opendap-project/t1/product/README.md

# T1

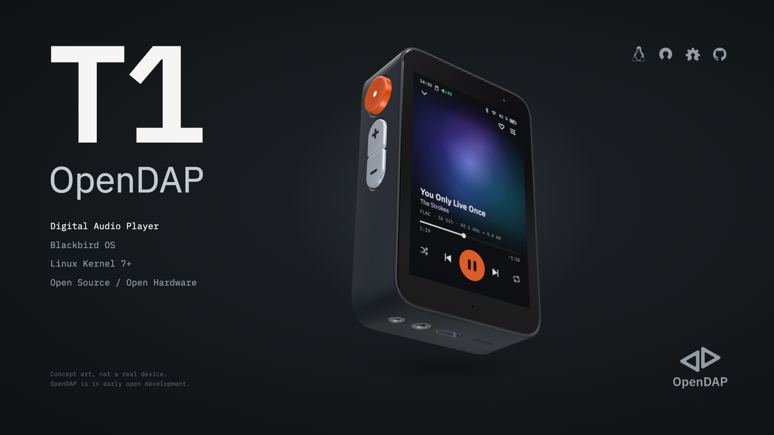
[picture p1: product/docs/concept-art/concept.png]
OpenDAP T1 concept art: the T1 in graphite with its orange Action button and silver keys, playing "You Only Live Once" by The Strokes on Blackbird OS. Concept art, not a real device.


Product integration of the OpenDAP T1: product requirements, the complete assembly and system simulations, built from the exports of every component.

## Layout

- `components.yaml` — the component versions that make up a T1 configuration
- `assembly/`
- `renders/`
- `sim/`
- `docs/`

## License

This repository follows the [REUSE](https://reuse.software) layout: license texts live in `LICENSES/` and `REUSE.toml` maps each path to its license.

- Default (docs, renders): **Creative Commons Attribution-ShareAlike 4.0** (`CC-BY-SA-4.0`)
- `assembly/`, `components.yaml`: **CERN Open Hardware Licence v2 – Strongly Reciprocal** (`CERN-OHL-S-2.0`)
- `sim/`: **GNU GPL v3.0 or later** (`GPL-3.0-or-later`)

Copyright © 2026 The OpenDAP Project.
