opendap-project/t1/faceplates/touch/README.md

# Faceplate Touch

Touch faceplate, the default faceplate: touch display, status LED, microphone.

## Layout

- `hardware/`
- `firmware/`
- `sim/`
- `case/` — this faceplate's mechanics
- `export/`
- `renders/`
- `docs/`

## License

This repository follows the [REUSE](https://reuse.software) layout: license texts live in `LICENSES/` and `REUSE.toml` maps each path to its license.

- Default: **Creative Commons Attribution-ShareAlike 4.0** (`CC-BY-SA-4.0`)
- `hardware/`: **CERN Open Hardware Licence v2 – Strongly Reciprocal** (`CERN-OHL-S-2.0`)
- `case/`: **CERN Open Hardware Licence v2 – Strongly Reciprocal** (`CERN-OHL-S-2.0`)
- `firmware/`: **MIT** (`MIT`)
- `sim/`: **GNU GPL v3.0 or later** (`GPL-3.0-or-later`)
- `export/`: **CERN Open Hardware Licence v2 – Weakly Reciprocal** (`CERN-OHL-W-2.0`)
- `renders/`: **Creative Commons Attribution-ShareAlike 4.0** (`CC-BY-SA-4.0`)
- `docs/`: **Creative Commons Attribution-ShareAlike 4.0** (`CC-BY-SA-4.0`)

Copyright © 2026 The OpenDAP Project.
