opendap-project/t1/board/docs/README.md

# Documentation

| Folder | Contents |
|---|---|
| [`requirements/`](requirements/) | What this project must achieve. Each requirement has an ID, a priority (**must** / **should**) and a status. |
| [`adr/`](adr/) | Architecture Decision Records: decisions already taken, with their context. A decision can be superseded by a later ADR. |
| [`specs/`](specs/) | Specifications, such as the [BOM](specs/bom-v1.md) the [power tree](specs/power-tree-v0.md) and the [PCB design constraints](specs/pcb-design-constraints.md). |

Only information confirmed by the maintainers is recorded here. Earlier experiments are not a source.

**Requirement status:** *Confirmed* (agreed, build on it) · *Draft* (agreed intent, wording or detail still open).
**ADR status:** *Accepted* · *Proposed* (direction agreed, not final) · *Superseded*.
