opendap-project/t1/case/docs/concept-art/README.md

# Concept art

These images are screenshots of interactive 3D concept models from earlier experiments (artifacts dated 2026-10-22). They are kept here as visual inspiration only.

**They are not designs, specifications or decisions.** The captures give the general visual idea, but their parts and exploded views often have glitches and bad design decisions, because they were not based on real data or simulations. Dimensions, part choices, component placement and layouts shown in them may be wrong and must not be taken from them. This also applies to any text visible in the captures (title panels, labels, numbers): it comes from the old experiment and is not confirmed information.

The real design is built in this repository, with simulation and real structure.

## Images

- `case-three-quarter.png`: Three-quarter front view of the assembled enclosure with a screen mock-up, rounded dark body and ribbed side key.
- `case-exploded.png`: Exploded view of the enclosure: front screen part, side key strip with a flexible cable, hollow body frame with internal walls and the back cover.
