opendap-project/t1/product/docs/concept-art/README.md

# Concept art

## Current concept

- `concept.png`: the 1920 × 1080 cover used in the READMEs, captured from [`renders/web/concept.html`](../../renders/web/concept.html).
- `renders/web/concept.html`: the interactive source of the cover. It is a visual reference built by eye from the requirements and the design system, not a mechanical design: dimensions, radii and port positions are not set yet. It loads three.js from a CDN; the marks at top right come from Simple Icons (CC0) and remain their owners' trademarks.

## Earlier experiments

These images are screenshots of interactive 3D concept models from earlier experiments (artifacts dated 2026-10-22). They are kept here as visual inspiration only.

**They are not designs, specifications or decisions.** The captures give the general visual idea, but their parts and exploded views often have glitches and bad design decisions, because they were not based on real data or simulations. Dimensions, part choices, component placement and layouts shown in them may be wrong and must not be taken from them. This also applies to any text visible in the captures (title panels, labels, numbers): it comes from the old experiment and is not confirmed information.

The real design is built in this repository, with simulation and real structure.

### Images

- `t1-three-quarter.png`: Three-quarter front view of the assembled handheld: dark graphite rounded body, large screen showing a music player mock-up, ribbed side key.
- `t1-back.png`: Straight-on back view: plain dark back cover with an embossed logo; the orange key seen on the right of the image is on the device's left edge (the view is from the back), as in T1-059.
- `t1-exploded.png`: Exploded view: screen front, circuit board, body frame, a pale battery-like block and back cover separated along the depth axis.
