opendap-project/t1/faceplates/touch/docs/concept-art/README.md

# Concept art

These images are screenshots of interactive 3D concept models from earlier experiments (artifacts dated 2026-10-22). They are kept here as visual inspiration only.

**They are not designs, specifications or decisions.** The captures give the general visual idea, but their parts and exploded views often have glitches and bad design decisions, because they were not based on real data or simulations. Dimensions, part choices, component placement and layouts shown in them may be wrong and must not be taken from them. This also applies to any text visible in the captures (title panels, labels, numbers): it comes from the old experiment and is not confirmed information.

The real design is built in this repository, with simulation and real structure.

## Images

- `touch-faceplate-three-quarter.png`: Three-quarter view of a thin front panel with a black border, a screen showing a music player mock-up and a small dot near the top.
- `touch-faceplate-exploded.png`: Exploded view of the panel layers: black front frame, translucent sheets, the screen, a white backing sheet, a grey plate and an outline frame, with orange flexible strips.
