opendap-project/t1/board/docs/specs/placement-v1.md

# Placement v1 of the T1 main board

- **Status:** Draft v1.11 (2026-10-29: libs v0.3.6's courtyards cover each part's pin-1 mark, which takes the side that grows the courtyard least, and a part with one land (the battery spring contacts, the pogo pins) carries none; the placement search runs again on the grown courtyards; the 5.1 V converter U4401 is fixed at its v1.10 position, where its input capacitor C4402 stays within its 3 mm bound (the search had turned it and left C4402 at 5.0 mm); 996 parts, 722 front, 274 back; board need 102.0 %, factor 1.61). Was Draft v1.10 (2026-10-29: the SoC crystal Y1301 on libs v0.3.5's NDK NX3225GA land, with silk outline and pin-1 mark, in place of KiCad's stock 3225 land; every fabrication reference centred in its part's courtyard and sized to fit it (`pcb/fabref.py`), so none overlaps another, and the build stops if one does; the two-terminal RTC crystal Y1101 carries a CRAFT-13 exemption (`plan.CRAFT_EXEMPT`); 996 parts, 718 front, 278 back; board need 100.2 %, factor 1.64). Was Draft v1.9 (2026-10-28: every part with a body carries a 3D model (libs v0.3.3 envelopes for the project lands and for the KiCad stock lands without a KiCad 10 model, by MPN on the XxL4020 land; `pcb/plan.py` `model_for`), so the STEP export misses none; the pre-PCB items of [BOM v1.22](bom-v1.md#changes-in-v122): the Vishay WSL lands on the 18 metal-strip shunts and links, the XFL3012 land for L5401 (no placeholder left), the Action button on the PTS815 land with the left-edge buttons 0.1 mm down; 996 parts, 720 front, 276 back; board need 100.2 %, factor 1.64). Was Draft v1.8 (2026-10-28: test pads on either side, decision 9 revised for flying-probe test, [ADR 0027](../adr/0027-flying-probe-test-for-prototypes-and-first-runs.md); the faceplate DSI ESD and the single FP_GPIO1 TPD1E10B06 of [BOM v1.21](bom-v1.md#changes-in-v121) placed in the faceplate area; 996 parts, 725 front, 271 back; board need 99.2 %, factor 1.66). Was Draft v1.7 (2026-10-28: the audio shield-can frame dropped for board area, decision 16, [BOM v1.20](bom-v1.md#changes-in-v120); board need 99.7 % to 98.9 %, factor 1.64 to 1.66; references unchanged; v1.6 the same day: the three shield-can frames of [BOM v1.19](bom-v1.md#changes-in-v119) on the back, decision 15; the frames' sheet takes page 59, so the references of the sheets after it carry the next page, for example the microSD socket J6101 is now J6201 and the side buttons SW6801–SW6804 are SW6901–SW6904; v1.5 the same day: vdd_cpu on the TPS62870Z4 of [ADR 0026](../adr/0026-vdd-cpu-buck-ti-tps62870z4.md), BOM v1.18 item 8: two input capacitors and three compensation parts more, one output capacitor moved to the SoC; v1.4 the same day: the NFC reader withdrawn from the board in every model, maintainer decision 2026-10-27 for board area ([feature blocks](feature-blocks.md) #42, BOM v1.18 item 7), the reserve of §6 item 1 applied; the sheets after it moved up one page, so their references carry the page before, for example the microSD socket J6201 is now J6101; v1.3 2026-10-27: every converter's and IC's capacitors within a bound of the pins they serve, checked by the tool, §4 decision 14, with the capacitor changes of [BOM v1.18](bom-v1.md#changes-in-v118); v1.2 the same day: the swaps of [BOM v1.17](bom-v1.md#changes-in-v117) whose gates closed without hardware; v1.1 the same day: the 62.5 × 95.0 mm body of [ADR 0025](../adr/0025-height-zones-in-the-wider-body.md), §4 decision 13; compaction of §4 decision 12 applied the same day). The board setup and the placement stage of the T1 main board: every part of the schematic placed, nothing routed. It applies [floorplan v1](floorplan-v1.md) with the changes of §4, each recorded as a decision.
- **Board:** [`hardware/t1-main-board/t1-main-board.kicad_pcb`](../../hardware/t1-main-board/t1-main-board.kicad_pcb), written by the placement tool [`hardware/t1-main-board/pcb/`](../../hardware/t1-main-board/pcb/) (`build.py`) from the schematic; the tool's report is [`pcb/placement-result.json`](../../hardware/t1-main-board/pcb/placement-result.json). The same inputs give a byte-identical board.
- **Inputs:** the schematic (hardware/t1-main-board, 996 parts, 1,055 nets), `hardware/t1-main-board/shields.toml`, [floorplan v1](floorplan-v1.md), [stackup v3](stackup-v3.md) and `hardware/stackup/stackup-v3.toml`, the [PCB design constraints](pcb-design-constraints.md) v0.20, [ADR 0025](../adr/0025-height-zones-in-the-wider-body.md), [ADR 0018](../adr/0018-antennas-and-certification-route.md), [ADR 0020](../adr/0020-battery-connected-through-contacts.md), the composed design rules (`t1-main-board.kicad_dru`), the [BGA escape study](../../hardware/studies/bga-escape/README.md). Footprints: libs `kicad/` as pinned in `hardware/lib/opendap` and KiCad 10.0.7's stock libraries.

## 1. Board setup

| Item | Value | Source |
|---|---|---|
| Outline | 59.1 × 91.6 mm, square corners, origin at the board centre (KiCad (100, 100) mm); `pcb/geometry.py` derives it from the body (62.5 × 95.0 mm), the walls (1.2 mm) and the clearance (0.5 mm per side) | PCB-M-01, M-02 (clearance **UNVERIFIED**), PCB-M-04, ADR 0025; corner radii wait for the case (CRAFT-35) |
| Mounting holes | H1–H4, 2.2 mm non-plated at (±26.05, 42.3) and (±26.8, −27.0) mm, the same distance from the edges as in the 55.3 × 90.1 mm outline | PCB-M-08, floorplan v1 §1 (positions **UNVERIFIED** until the case) |
| Stackup | Six layers, 1.046 mm: mask 20 µm / L1 35 µm / 2116 120 µm / L2 25 µm / 3313 90 µm / L3 18 µm / core 430 µm / L4 18 µm / 3313 90 µm / L5 25 µm / 2116 120 µm / L6 35 µm / mask 20 µm, ENIG; Dk as the TOML | stackup v3, `stackup-v3.toml` |
| Net classes | The project's classes and patterns, generated from `hardware/rules/netclasses.toml` | netclasses.toml |
| Design rules | `t1-main-board.kicad_dru`, the composition of the PCBWay HDI, OpenDAP craft and T1 product rules | `t1-main-board.dru.toml` |
| Rule areas | `ZONE_CORE`, `ZONE_AUDIO`, `ZONE_POWER`, `ZONE_IO`, `ZONE_RADIO`, `ZONE_FACEPLATE` per copper layer, five `ZONE_CORRIDOR`, `BATTERY_POCKET`, `BATTERY_CONNECTOR`, `BATTERY_CONTACT_EMPTY`, `BATTERY_ESD`, `AUDIO_ANALOG`, `BGA_ESCAPE` | floorplan v1 §2, §4; PCB-L-01, L-02, L-04, L-08; PCB-A-07; hardware/rules/README.md |
| Height areas | Drawn on User.1 (front: display footprint, faceplate connection area) and User.2 (back: pocket, bands, speaker shelf) | PCB-Z-01 to Z-04, Z-09, ADR 0025 |
| Fiducials | FID1–FID3 front, FID4–FID6 back (global, not symmetric), FID7–FID8 back at the RK3566 (local); 1 mm dot, 2 mm mask, 3.2 mm kept free | PCB-M-09, PCB-D-02, D-03 |
| Identity | `${TITLE}` and revision with the issue date on the back silk, in an area kept free of parts | CRAFT-20 |

## 2. What is placed

All 996 parts: 725 on the front, 271 on the back (the two shield frames among them; v1.8), plus the eight fiducials and four holes. The schematic parity check finds no difference. Every part stands on a drawn land (v1.9: L5401 is the Coilcraft XFL3012 of BOM v1.22, its land from Document 747-1). The C&K PTS815 land of SW6901–SW6904 is drawn from its data sheet (v1.6; the Action button SW6904 on it from v1.9).

| Part | Where (device frame, mm) | Side | Basis |
|---|---|---|---|
| RK3566 U1301 | (0, 10) | back | floorplan v1, BGA escape study, ADR 0016 item 3 |
| LPDDR4X U2101 | (16.9, 11) | back | floorplan v1 (16.75); 2.05 mm courtyard gap to the SoC (PCB-D-01) |
| eMMC U3801 | (−17.75, 12) | back | floorplan v1 |
| SoC, LPDDR4X and eMMC decoupling | front, each capacitor at a ball of its rail under the package | front | ADR 0016 item 3, PCB-P-10; the escape study's one ground stack per capacitor next to a rail via |
| RK809-5 U1101 | (−4.8, 25.0), its five inductors around it | back | §4 decisions 5, 15 |
| vdd_cpu buck U1201, inductor L1201 | inductor (11.95, 23.9) under the pocket, above the LPDDR4X and 4 mm right of the SoC's courtyard; converter beside it at (16.15, 23.9): the TPS62870Z4 is 1.05 mm, over the front's 1.0 mm (PCB-Z-03), so it stands on the back over the pocket like the SoC and the PMIC (a PCB-L-01 warning, ADR 0026) | back / back | §4 decision 12 (was the top band, decision 3); ADR 0026 |
| RP2354A U3501 | (−16.0, 24.5) | front | §4 decision 6 |
| CS43198 U2501, U2601 | (−20, −18), (−11.5, −18), mirrored about x = −15.75 | back | floorplan v1 |
| NZ2520 oscillators Y2401, Y2402 | (−17.3, −11), (−14.2, −11), mirrored about x = −15.75 | back | floorplan v1 (moved to clear each other) |
| 3.5 mm jack J3401, 4.4 mm jack J4001, USB-C J4601 | bottom edge at x −22.3, −11.55, 0 | back | PCB-M-05, floorplan v1 |
| microSD J6201 | top edge, x 13.5 | back | floorplan v1 (13.0); §4 decision 3 |
| U.FL J5201 (ANT0), J5202 (ANT1) | (−14.0, 41.5), (−8.3, 41.5), top band | back | ADR 0018 item 4, PCB-R-02 |
| Type 2EL U5001 | (−17, 32.5) | back | floorplan v1 |
| FH35C J5301 | (2.5, −32.9), faceplate connection area | front | floorplan v1 §5 |
| DF40C-50DS J4701 | (13.1, −31.0), bottom band | back | floorplan v1 §5 |
| Battery contacts J701–J706 | row at y −23.5, x −2.0 to 19.0, 3.5 mm pitch, third position empty | back | ADR 0020 item 2, PCB-L-04 |
| Battery-contact ESD D702, D703 | at the mid-cell and NTC contacts, inside `BATTERY_ESD` | back | PCB-L-08 |
| Side buttons | Action SW6904, Vol+ SW6902, Vol− SW6903 on the left edge at y 36.72, 30.6 and 24.5 (v1.9: all on the 6.0 mm PTS815 land, courtyards end to end, Action 1.43 mm from the top-left hole edge, PCB-H-01; Vol− 0.1 mm down from v1.6 with no PCB-D-01 change); Main SW6901 on the right edge at y 29.5; 1.9 mm from the edge, courtyards 0.15 mm outside the pocket footprint | back | controls spec §1.4 (positions **UNVERIFIED**), PCB-Z-08 |
| Speaker pads TP5503, TP5504 | under the speaker shelf, (10.5, −39.5) and (16.5, −39.5) | back | BOM v1 line 33 (pad spacing **UNVERIFIED**), PCB-Z-09 |
| Cover-detect pads TP5801, TP5802 | 1.25 mm from the right edge, y −14.0 and −17.5 | back | ADR 0020 item 7, PCB-L-10 |
| Shield frames A5901 (SoC and LPDDR4X), A5902 (radio module) | lands outside x −10.0 to 24.15, y 0.55 to 20.3; x −23.6 to −10.3, y 27.2 to 38.3 | back | §4 decisions 15, 16, `shields.toml` |

Every other part is placed by the tool: tall parts in the bands, then parts with through holes (their thermal vias need the other side free), then the converters' inductors, then the parts over 1.0 mm (back only), then the rest, each at the nearest free spot to the pads it connects to (pads of its own block first; a converter next to its inductor's switch-node pad), and test pads on the front.

## 3. Area budget and occupancy

### 3.1 The floorplan's method with the real footprints

Floorplan v1 §2.1 estimated the over-budget bands with a placement and routing factor of 1.7 (1.2 for edge parts) on courtyard estimates. The same method on the real courtyards of the schematic's parts, on the floorplan's zones (drawn from the 59.1 × 91.6 mm outline) and block assignment; the speaker stands on its case shelf (PCB-Z-09), so it takes no area and its shelf footprint counts as low back area, not band:

| Zone | Courtyard (mm²) | Need ×1.7 (mm²) | Band use | Back use | Front use | 55.3 × 90.1 mm outline (band / back / front) |
|---|---|---|---|---|---|---|
| CORE | 2,690 | 4,572 | **129 %** of 497 mm² | 100 % | 73 % | 203 % / 100 % / 94 % |
| AUDIO | 1,735 | 2,760 | 99 % of 458 mm² | 100 % | **231 %** | 123 % / 100 % / 254 % |
| POWER | 1,256 | 2,136 | **211 %** of 220 mm² | **116 %** | **149 %** | 233 % / 165 % / 164 % |
| IO | 365 | 571 | 80 % | 100 % | 23 % | 82 % / 100 % / 29 % |
| RADIO | 275 | 467 | 0 % | 96 % | 0 % | 0 % / 100 % / 11 % |
| FACEPLATE | 135 | 229 | — | — | **121 %** of 190 mm² (v1.8: the DSI ESD; placed courtyard 58 %) | — / — / 121 % |
| **Board** | **6,639** | **11,047** | | | **102.0 % of 10,827 mm²** (v1.11: courtyards that cover the pin-1 marks, libs v0.3.6, +2 %; 100.2 % at v1.10; v1.9: the WSL and XFL3012 lands and the Action PTS815, +114 mm² of need; 99.2 % at v1.8, 98.9 % at v1.7) | 111 % of 9,965 mm² |

The wider body (ADR 0025) and the 0201 swaps of [BOM v1.16](bom-v1.md#changes-in-v116) take the board from 111 % to 98.8 % of both sides; the swaps of [BOM v1.17](bom-v1.md#changes-in-v117) (seven 10 µF in 0603, two 1 µF in 0201, six load switches in WCSP) to 97.8 %; the capacitors [BOM v1.18](bom-v1.md#changes-in-v118) adds so that every position meets its data sheet (the amplifier-rail LDOs take 18 capacitors of 22 µF where 6 of 10 µF missed their minimum) to 99.1 %; withdrawing the NFC reader (§6 item 1, 35 parts) to 96.9 %; the TPS62870Z4 of ADR 0026 to 97.0 %; the three shield frames (decision 15; their land and keep-out rings once, without the factor, counted in the core as the method has no zone for them) to 99.5 %; the drawn PTS815 land (6.0 × 3.7 mm against the 4.8 × 3.8 mm placeholder) to 99.7 %; dropping the audio frame (decision 16) to **98.9 %**; the courtyards alone cover 60.2 % (61.0 % at v1.6, 58.4 % at v1.5, 58.3 % at v1.4, 59.6 % at v1.3, 58.8 % at v1.2, 59.4 % at v1.1, 67.3 % before ADR 0025). The study's target of 95 % with routing room is not reached (3.9 points short; 2.0 before the frames): the X2SON LDOs and most of the 1 µF and 10 µF positions failed their gates (BOM v1.17), and what remains gated needs hardware (the audio output stage in 0402 after V2-A08, 0.8 mm power test pads after a probe check), or the reserve of §6 item 1.

### 3.2 The placed board

Courtyard area over zone area, per side, without a factor (zones with the changes of §4; the back's band is the back outside the pocket and the speaker shelf; a shield frame counts its land and keep-out ring, which the core and radio rows carry):

| Zone | Front | Back | Band (back) |
|---|---|---|---|
| CORE | 1,050 of 2,009 mm² (52 %) | 1,591 of 2,280 mm² (70 %) | 237 of 512 mm² (46 %) |
| AUDIO | 811 of 1,363 mm² (59 %) | 880 of 1,126 mm² (78 %) | 411 of 524 mm² (78 %) |
| POWER | 539 of 1,087 mm² (50 %) | 786 of 1,311 mm² (60 %) | 169 of 368 mm² (46 %) |
| IO | 173 of 312 mm² (55 %) | 206 of 265 mm² (78 %) | 167 of 195 mm² (86 %) |
| RADIO | 117 of 453 mm² (26 %) | 146 of 453 mm² (32 %) | 105 of 208 mm² (51 %) |
| FACEPLATE | 97 of 190 mm² (51 %) | — | — |

Every part found a place with its courtyard inside its zone, its height inside its height area (the two pocket reliefs of §5 aside) and no courtyard overlap. The placement and routing factor left is **1.66** over the board (10,827 / 6,518 mm² of placed courtyard, the frames' rings included; 1.64 at v1.6, 1.71 at v1.5, 1.72 at v1.4, 1.68 at v1.3, 1.70 at v1.2, 1.68 at v1.1, 1.49 before ADR 0025), about 1.5–1.6 in the core's and the audio zone's front; the floorplan assumed 1.7 (1.5–1.9). The tool reports these figures in `placement-result.json` (`routing_room`). Whether the board routes at this density is the next stage's question; a shortfall goes back to the maintainers as a stackup question (PCB-S-22) or as the reserve of §6 item 1.

## 4. Decisions

Each changes floorplan v1 where the real footprints did not fit it; the tool's `plan.py` carries the same rows.

1. **Accepted (2026-10-27): the audio zone grows to y 2.4 on every layer and to y 14 on the front (x < −6.2).** Basis: its parts need 1,665 mm² of courtyard against 1,557 mm² of floorplan zone on both sides (§3.1); the core zone has room (§3.2); above y 2.4 the eMMC and its rework clearance (PCB-D-01) keep the back and inner layers; a zone may cover only some layers where two zones share a spot (floorplan v1 §2). The core–audio corridor moves to x −11 to −5, y −1 to 5, across the new boundary.
2. **Accepted (2026-10-27): the power zone grows to y 0 (x > 6.2), its left edge moves to x 4.0 between the battery-contact window and y 0, it takes the front of the HAT strip right of the faceplate area, and the back of x −2 to 4, y −18.8 to −8.** Basis: the power zone's parts over 1.0 mm stand on the back only (twelve 0805 capacitors of the charger, five INA236, the ship FET, diodes), and its back outside the contact window is full of them; the I/O zone uses 30 % of its front (§3.1); the I/O pairs pass the moved back area on L4 and L1. The core–power corridor moves to x 8 to 14, y −3 to 3.
3. **Accepted (2026-10-27): parts over 1.5 mm stand in the bands at fixed places.** The power band above the USB-C (taken from the I/O zone's back) holds the battery fuse under the P+ contacts; the right band the VSYS_LV and pre-rail inductors (XGL4020, 2.1 mm) and, since v1.3, the pre-rail's three 1206 output capacitors around its inductor's output pad (decision 14). Until v1.2 the band above the USB-C also held the 5.1 V output 1210 (two 0805 since BOM v1.18 item 5, placed with their converter) and one pre-rail 1206. Decision 12 took the vdd_cpu, vcc3v3_sys, radio AVDD18, charger and 5.1 V inductors out of the bands; the core top band (x −5.5 to 5.6, taken from the radio zone left of the microSD) stays with the core. Basis: PCB-Z-01, Z-02; the converters stand opposite their inductors on the front. Cost (until decision 12): the vdd_cpu converter sat about 24 mm from the SoC's package edge.
4. **Withdrawn (2026-10-27, decision 13): no part over 1.0 mm stands on the front's bottom strip.** In the 55.3 × 90.1 mm outline the VSYS_LV converter's 22 µF 0805 C904 (1.25 mm) found no back room and stood there on PCB-Z-04's 6.8 mm (**UNVERIFIED**); in the wider power zone the tool places it on the back next to C903, 3.6 mm from its converter.
5. **Accepted (2026-10-27): the RK809-5 stands above the SoC, at (−4.8, 24.6) on the back** (v1.3; was (−6.0, 25.7), where its top row of pins stood 0.2 mm from the radio zone and the last of its 27 capacitors found no room within its bound, decision 14). Basis: below the SoC the grown audio and power zones leave about 10 × 8 mm, and the PMIC with its five 1.2 mm inductors (back only) needs about 150 mm²; above, it sits next to the vdd_cpu buck, 2 mm from the SoC's and the eMMC's courtyards (PCB-D-01). Floorplan v1 had it below the SoC.
6. **Accepted (2026-10-27): the RP2354A stands at (−16.0, 24.5) on the front**, clear of the eMMC. Basis: its exposed pad's thermal vias go through the board, so the other side under them must be free of pads (PCB-V-01, shorts); the audio zone took its floorplan place.
7. **Accepted (2026-10-27): `blk.audio-supply` (TPS62840 buck, its inductor and switches) belongs to the power zone.** Basis: switch nodes stay in the power zone except the PMIC's and the vdd_cpu buck's (floorplan v1 §4 item 6, PCB-A-06); floorplan v1 §2 listed the block under `blk.audio`.
8. **Accepted (2026-10-27): heat sources other than the SoC and the PMIC stand on the front** where their height allows it. Basis: PCB-L-01 (no heat source on the back over the pocket); the SoC and the PMIC are there by ADR 0016 (floorplan v1 §6 item 3).
9. **Accepted (2026-10-27; revised 2026-10-28): flat test pads stand in the zones of their nets, on either side.** Basis: [ADR 0027](../adr/0027-flying-probe-test-for-prototypes-and-first-runs.md) (flying probe for prototypes and first runs, reaching both sides; until 2026-10-28 the front only, for ADR 0016's single-sided fixture); PCB-S-17 (a test pad's track stays in its net's zone). The nearest free spot wins, the front on a tie (`plan.TEST_PAD_SIDES`): 18 of 156 pads take the back, and the front cells they leave go to passives, so the front courtyard (≈ 2,800 mm²) and the board need (99.2 %) do not change. Contact pads of parts mounted in the case (speaker, LRA, NFC antennas, cover detect) stand on the back.
10. **Accepted (2026-10-27): the faceplate connection area's front belongs to the faceplate zone alone.** Basis: ADR 0016 item 1 (FH35C and its ESD only); floorplan v1's I/O rectangle overlapped it.
11. **Accepted (2026-10-27): DRC reports unconnected items as warnings at this stage** (project setting, generated). Basis: nothing is routed; the routing stage sets them back to errors, so the stage's own DRC errors stay visible.
12. **Accepted (2026-10-27): lower and smaller parts where the design's stresses allow them** ([compaction study](../../hardware/studies/compaction/README.md), [BOM v1.15](bom-v1.md#changes-in-v115)). Basis: the study's matrices: same inductance, design peak ≤ 70 % and maximum current limit ≤ 100 % of Isat at 30 % drop (BRD-049 as power tree v0 §4.10 applies it), heights PCB-Z-01 and Z-03, ratings at least twice the rail, PCB-D-06; sourcing check (T1-029), 2026-10-27: open for XGL4015-102MEC and conditional for XGL4015-471MEC (BOM v1.15), with the 2.1 mm parts on the same land as the fallback. The charger and 5.1 V inductors (XGL4015-102MEC) and the vcc3v3_sys and radio AVDD18 inductors (XGL4015-471MEC) are 1.5 mm and stand under the pocket; the vdd_cpu inductor is 1.2 mm (XGL4012-221MEC, Document 1718), so it moves next to the SoC (block target (6.0, 22.5); it lands 2.4 mm from its converter, as before) with its converter on the front opposite, as every other converter of this placement (decision 3; PCB-P-07 asks for one side, a review item); 58 decoupling capacitors of 100 nF on rails of 3.3 V or less in the core, I/O and radio zones are 0201; the 51 test pads on signal nets are 0.8 mm. The TPS62136 and LMR33630C inductors stay 2.1 mm in the band (their XGL4015 is at 103 % at the converter's limit), and no thinner 0805 or 1206 capacitor passes (obsolete, not for new designs or not listed).

13. **Accepted (2026-10-27): the board takes the 62.5 × 95.0 mm body** ([ADR 0025](../adr/0025-height-zones-in-the-wider-body.md), [t1 ADR 0006](../../../product/docs/adr/0006-body-at-the-maximum-width.md)). `pcb/geometry.py` derives the outline from the body, the 1.2 mm walls and the 0.5 mm clearance (59.1 × 91.6 mm), keeps the pocket, the display and every fixed part at their device-frame positions (the bands become 17.25 and 7.25 mm from the board edges), keeps the holes' distance to the edges, and turns the speaker's band shadow into a case shelf over parts up to 1.5 mm (PCB-Z-09). Parts placed against an edge follow it (jacks, USB-C, microSD, side buttons, cover-detect pads). The 0201 swaps of BOM v1.16 apply. Basis: the area result of ADR 0025 (111 % → 98.8 % by §3.1's method; factor left 1.49 → 1.68).
14. **Accepted (2026-10-27): every converter's input and output capacitors and every IC's decoupling stand within a bound of the pins they serve, and the build fails otherwise** (`pcb/proximity.py`). Which capacitor serves which pins comes from the netlist's pin functions and types and from the generator: a converter (a part with a pin on a switch node) has input capacitors (between a supply-input net of it and its ground; an inverting converter's ground is its negative rail) and output capacitors (between the far net of its inductor and its ground, served at the inductor's output pad); any other capacitor to ground on a supply pin or regulator output of an IC of its block decouples it; a capacitor the generator marks in its `Decoupling` field (the decoupling banks, such as the SoC's) serves its rail's supply pins on the board. Distance: the capacitor's pad on the served net to the nearest served pad, centre to centre, either side. Bounds: input 3.0 mm (the hot loop, PCB-P-07), output 5.0 mm, decoupling 4.0 mm, 10 µF and more 6.0 mm (PCB-P-10). Basis: the data sheets ask for these capacitors as close as possible and show them adjacent in their layout examples without a number (SLVSDV2 §12.1–12.2, SLVSES3A §10.1–10.2, SNVSAN3F §10.1–10.2, SBVS338H §7.4); PCB-P-07 and PCB-P-10; at v1.2 C901 stood 29 mm from the TPS62136 it serves and 136 of the 237 capacitors then checked were beyond these bounds. The placer places each IC's or converter's capacitors right after it (input, output, decoupling, bulk), keeps free room around it for them when the first try leaves one beyond its bound (without moving a converter more than 1 mm further from its inductor), orders parts by the area of the part and its capacitors, and then reorders, swaps and moves capacitors still beyond their bound. Plan targets (`PART_TARGET`) place first what the search alone could not hold: the two LT3094 with their capacitors, the VSYS_LV output capacitor C904, the pre-rail's three output capacitors around L2802 and the vdd_gpu output capacitor C1104. Result: 248 capacitors checked, none beyond its bound (worst: input 2.77 mm, output 4.55 mm, decoupling 3.54 mm, bulk 4.60 mm); `placement-result.json` lists every row (`capacitor_proximity`).
15. **Accepted (2026-10-28): three shield-can frames on the back, under the battery pocket** ([BOM v1.19](bom-v1.md#changes-in-v119) line 90; `blk.shields`). `hardware/t1-main-board/shields.toml` gives each frame the area its parts may use inside; `pcb/shields.py` derives the land (0.4 mm), the keep-outs (0.5 mm outside, PCB-T-06; 0.3 mm inside) and the courtyard ring, the generator draws the land as a closed ground ring (`T1_Main_Board:Shield_Frame_*`) and the placer reserves the ring before any part and lets inside only parts up to 1.3 mm (1.5 mm with the 0.1 mm lid and 0.1 mm clearance, PCB-Z-01). SoC and LPDDR4X (A5901, PCB-T-06): inside x −9.3 to 23.45, y 1.25 to 19.6, the two packages alone; the eMMC and the RK809 stay outside, and the RK809 moves 0.4 mm up to (−4.8, 25.0) to clear the ring. Radio module (A5902, PCB-T-06, PCB-EMC-03): inside x −22.9 to −11.0, y 27.9 to 37.6, the Type 2EL (1.3 mm) and its series and matching positions; the U.FL receptacles and the top wall stay outside (PCB-R-13). DACs and headphone stage (A5903, PCB-EMC-03): inside x −23.5 to −7.7, y −21.6 to −3.6, the two CS43198, both crystals and the three OPA1622 on the back; the strip to its left and the band below take the four 1.45 mm SOT-23-5 regulators and oscillators (plan targets). The audio zone's back loses the ring's area, so the ambient microphone's block moves to the core zone (it is not on the playback path) and the six OPA1622 take plan targets before the passives, at their v1.5 positions or, for U3201 and U3202, just inside the frame. Fiducials FID4, FID7 and FID8 move clear of the rings (the two local ones stay at opposite corners of the RK3566), and the board identity text moves right of the radio frame. Basis: PCB-T-06, PCB-EMC-03, PCB-Z-01, PCB-Z-03 (no can under the display, so nothing on the front is shielded), PCB-R-13, PCB-D-03, T1-038 (amended 2026-10-25); the frames are not fitted in either variant (feature blocks, `blk.shields`). Result: every part placed, every capacitor within its bound; the rings take 2.5 % of the board's area by §3.1's method (97.0 % → 99.5 %).
16. **Accepted (2026-10-28): the audio shield-can frame dropped; the SoC and radio frames stay** (maintainer decision for board area; [BOM v1.20](bom-v1.md#changes-in-v120) line 90). Most of the headphone stage stands on the front, where PCB-Z-03 allows no can, so the back frame A5903 covered the DACs, the clocks and three of the six OPA1622 only. Of the constraint rows that ask for frames, PCB-T-06 asks for the SoC and DDR and the radio, so A5901 and A5902 stay; A5901 already encloses only the RK3566 and the LPDDR4X with 0.5 mm (decision 15), so it is not shrunk; PCB-EMC-03 withdraws its headphone-stage frame with this decision (constraints v0.19); no signal-integrity row asks for a can. The v1.6 positions decision 15 gave the audio parts (the 1.45 mm regulators and oscillators beside the DACs, U3201 and U3202, the ambient microphone in the core zone) stay: they hold without the frame. Basis: PCB-T-06, PCB-EMC-03, PCB-Z-03; decision 15. Result: every part placed, every capacitor within its bound; board need 99.7 % to 98.9 %, placed courtyard 61.0 % to 60.2 %, factor 1.64 to 1.66; front 716, back 277 parts (the placer used the freed back area); references unchanged (A5901, A5902).

## 5. Checks

**DRC** with the composed rules (KiCad 10.0.7, `pcb/build.py --drc`): **0 errors**, 499 unconnected items (expected: not routed), schematic parity 0. Warnings (603 at v1.11, 1 of them a silk overlap: KiCad's stock WSON-6 land of U2102 draws its pin-1 mark outside its courtyard, where C2116's silk meets it; at v1.10, 10 silk overlaps, 9 of them libs pin-1 triangles drawn outside the courtyard (Y1301 twice, U901, U501, U2901, U3503, U4401, U4601, U5306), gone with libs v0.3.6; 603 at v1.9; 605 at v1.8, with the LQH3NP placeholder's library issue): 590 silk items of the library footprints against the craft rules (CRAFT-05, CRAFT-07, Q2) and 7 silk overlaps, 3 PCB-L-01 (the SoC, the PMIC and, from v1.5, the vdd_cpu converter over the pocket, floorplan v1 §6 item 3, ADR 0026), 3 PCB-D-01 (the SoC frame's ring within 2 mm of the RK3566, LPDDR4X and eMMC courtyards, decision 15: the lid comes off for rework, the frame stays; §6 item 9), 1 PCB-D-05 (a side button's silk at the edge, Q2). ERC 0 errors. Craft check: the schematic meets Q1; the board reaches no level, as before this decision, because a placement-stage board fails three items at Q0 and Q1: the unconnected items and PCB-L-01 (the SoC and the PMIC over the pocket by ADR 0016 item 3, a warning) at Q0, and PCB-D-01 (decision 15) at Q1. CRAFT-13 passes from v1.10: U901's library footprint carries its pin-1 mark, and the check had measured to pad centres, so the mark past the end of its long pin-1 pad read as pin 11's (tools' craft check now measures to land edges, as the craft standard states); Y1301 had KiCad's stock land without outline or mark. PCB-I-09 leaves a footprint's own pads out since 2026-10-27, as PCB-V-01 does (it fired six times between the DAC's MCLK pin and its neighbours and between the dividers' pins).

**Capacitor proximity** (`pcb/proximity.py`, decision 14): 244 capacitors (30 converter inputs, 21 outputs, 157 decoupling, 36 bulk; the same at v1.6; 243 at v1.4, 248 before the NFC reader was withdrawn), none beyond its bound; the build exits non-zero when one is.

**Placement checks** (`pcb/checks.py`): no courtyard overlap, no part outside its zone, no part in a hole ring or within 0.3 mm of the edge (J*, SW* exempt), no through hole under another part, no height finding. Two parts stand over PCB-Z-01 inside the pocket reliefs the case provides (ADR 0025 item 4); the tool reports them in `placement-result.json` (`pocket_reliefs`), not as findings:

| Part | Height | In the pocket footprint | Relief |
|---|---|---|---|
| J4001 (4.4 mm jack) | 6.5 mm | x −16.64 to −6.46, y −28.55 to −23.75 (4.79 mm deep) | PCB-Z-06; no catalog jack fits |
| J6201 (microSD, DM3AT push-push) | 1.68 mm | x 5.62 to 21.38, y 27.53 to 38.55 (11.02 mm deep) | PCB-Z-07 |

The side buttons (SW6901–SW6904) no longer reach the pocket footprint (0.05 mm outside it); their strip (PCB-Z-08) stays as the case's tolerance margin. C904 left the front strip (decision 4).

**Checks of v1.7** (2026-10-28, decision 16): DRC 0 errors, 605 warnings and 499 unconnected items as v1.6; ERC 0 errors (nine warnings, as v1.6); craft Q1 met; `generator/overlaps.py` 0 collisions; pcb tests pass (34, with the PCB-T-06 frame set); variant data on 33 footprints (A5903 gone); capacitor proximity 244, none beyond its bound. Back copper, courtyard and fabrication plot of the audio zone at 300 dpi against v1.6: the ring gone, the parts it enclosed and their neighbours spread into its area, no courtyard overlap, everything inside the edge.

**Variant data and the PTS815 land (v1.6, 2026-10-28):** `pcb/variants.py` writes the schematic's `production` data onto 34 footprints and the board's variant list; `odapkit variant check`: full and production pass, reproducible (warnings: `blk.shields` not fitted in the full variant, by design; `blk.audio` has no part of its own; the seven `isolated_pin_label` the unfitted RX-clock options leave). Back plot at 300 dpi of the left edge: SW6902 and SW6903 on their four-pad PTS815 lands, SW6904 above, no courtyard overlap, all inside the edge. DRC 0 errors, ERC 0 errors (one `footprint_link_issues` left: L5401), craft Q1 met, `generator/overlaps.py` 0 collisions, pcb tests pass (33), STEP exported (27 parts without a model, as before).

**Visual review of v1.6** (2026-10-28): back copper, courtyard and fabrication plots at 300 dpi of each frame: every land a closed ring, every part inside within the inner keep-out, no courtyard crossing a ring; the four 1.45 mm parts outside the audio frame; the 1200 dpi view of the RXS0016A land of v1.5 unchanged. ERC 0 errors (warnings as v1.5); craft check: the schematic meets Q1 (Q2 reached); `generator/overlaps.py` 0 collisions; the shields sheet and the root's bottom row read on their plots; pcb tests pass (31, with `tests/test_shields.py`). STEP export: 4.7 MB, the same 27 parts without a model (the frames carry none yet).

**Visual review of v1.5** (2026-10-28): courtyard and fabrication plots at 600 dpi around the vdd_cpu converter: U1201 and L1201 side by side on the back, the two input capacitors and the output capacitor on the front opposite the converter, within their bounds; no courtyard overlap. ERC 0 errors; craft check: the schematic meets Q1 (Q2 reached, Q3 debt CRAFT-114, -127 as before); `generator/overlaps.py` 0 collisions; pcb tests pass. STEP export: 4.7 MB, the same 27 parts without a model (the RXS0016A resolves from libs).

**Visual review of v1.4** (2026-10-28): front and back courtyard and fabrication plots, the whole board at 300 dpi and the top of the back (microSD J6201 in its pocket relief, the NFC tag contacts TP6403 and TP6404, the vdd_cpu inductor L1201; references as on the current board) at 600 dpi, where the reader stood: no courtyard overlap or part outside its zone; the reference texts of TP6403 and TP6404 overlapped on the fabrication layer only (fixed in v1.10: fabrication references placed clear of each other). ERC 0 errors (12 warnings, as listed in the project README); craft check: the schematic meets Q1 (Q2 reached); `generator/overlaps.py` 0 collisions; pcb tests pass (26) and the KiCad transform check passes. STEP export: 4.7 MB, the same 27 parts without a model.

**Visual review of v1.3** (2026-10-27): fabrication and courtyard plots at 600 dpi of the right power band (L901, L2802 and their seven band and pocket capacitors), the RK809 on the back and its capacitors on the front, and the four amplifier-rail LDOs with their eighteen 22 µF capacitors: no courtyard overlap, every capacitor beside the pin or pad it serves. ERC 0 errors; craft check: the schematic meets Q1 (Q2 reached); the board's craft items are those of v1.2 (unrouted items and PCB-L-01 at Q0, U901's pin-1 mark at Q1); CRAFT-34 (Q2) reports the DAC pair's references of `t1-main-board.craft.toml` (21xx/22xx), which no longer match the DAC sheets (25xx/26xx), a configuration item of §6 item 7. STEP export: 5.1 MB, the same 27 parts without a model in KiCad 10's library.

**Visual review** (2026-10-27, v1.1): front and back exported with `kicad-cli pcb export pdf` (courtyards, fabrication, User.1, User.2, edge) and inspected in 450 dpi crops of the changed regions: the bottom band with the speaker shelf, the jacks and the USB-C; the top band with the microSD and the U.FL feeds; both side strips with the buttons; the right edge with the cover-detect pads and the band inductors. No courtyard crosses the outline or another courtyard; the shelf holds only parts up to 1.5 mm (C903, C904, C618, C2815, D5401, Q701 and the speaker pads).

**STEP export** (`kicad-cli pcb export step --subst-models`, with `KICAD10_3DMODEL_DIR` set to KiCad 10.0.7's model library): written; 27 parts have no STEP model in that library (15 × Texas DPY0002A, 7 × Coilcraft XxL4020, 4 × SOT-523, 1 × NANO2 fuse), the same footprints as before this decision; every swapped 0201 resolves.

**3D envelope:** the case publishes no export yet (`case/export/` is empty), so no STEP check against ADR 0016 was made; part heights come from the footprints' 3D models (`pcb/heights.py`) and are checked against PCB-Z-01 to Z-04 above.

## 6. Open items

1. **Routing density and the reserve.** The real parts and the shield frames need **100.2 %** of the board with the floorplan's factor 1.7 (§3.1; v1.9: the datasheet lands of BOM v1.22 add 114 mm²; 99.2 % at v1.8, 98.9 % at v1.7, 99.7 % at v1.6 with three frames, 97.0 % at v1.5, 96.9 % at v1.4, 99.1 % at v1.3, 97.8 % at v1.2, 98.8 % before BOM v1.17, 111 % before decision 13); the placement leaves a factor of 1.64 (1.66 at v1.8, 1.64 at v1.6, 1.71 at v1.5); every part is placed, but the need is over the board by the floorplan's method, so the gated swaps below and the reserve are the room routing will draw on. BOM v1.17 closed the gates that needed no hardware: the TPS22916C load switches, seven 10 µF in 0603 and two 1 µF in 0201 are applied; the X2SON LDOs, 15 of the 10 µF and 16 of the 1 µF positions failed and keep their parts. Still gated, in the order they free area (area study, by the factor): the audio output stage's 0603 parts in 0402 of the same series (3.9 points; ADR 0025 item 6, t1 V2-A08); 0.8 mm test pads on power and ground (1.5 points; a probe check against PCB-D-06's 1.0 mm); the 1 nF positions in 0201 (no part sourced). **Reserve** (ADR 0025 item 7): the NFC reader is removed for every model (maintainer decision 2026-10-27; 2.2 points: 99.1 % to 96.9 %); the TPM (BRD-059, about 1 point) stays, and its removal remains a maintainers' decision.
2. **Zone net classes:** closed (2026-10-27). Every net but GND carries the `ZONE_<NAME>` class of each zone whose blocks it touches (the zones of `pcb/plan.py`; the faceplate connector's sheet also the faceplate zone), a rail used in more than one zone `ZONE_SHARED`; the generator writes them as net-class patterns (`zone_patterns` in `generator/generate.py`). Of 1,080 nets: 911 in one zone, 104 in two, 36 in three, 28 shared rails, GND none.
3. **Switch-node class:** closed (2026-10-27). The generator names every switch node `*_SW` (`VSYS_LV_SW`, `VCC3V3_SYS_SW`, `VDD_CPU_SW`, `RP_VREG_SW`, was `RP_VREG_LX`), and the faceplate display switch's output is `FP_VCI_OUT` (was `FP_VCI_SW`), so `SW_NODE` holds the 18 switch nodes and nothing else.
4. **Lands not drawn:** none (v1.9: L5401 on the Coilcraft XFL3012 land, BOM v1.22 item 4; PTS815 drawn since v1.6); the WE-LHMI 4020 is no longer fitted (decision 12).
5. **Case inputs:** mounting holes, corner radii, the speaker shelf's clearance and the speaker's contacts, antenna and NFC tag contact positions; the walls and the pocket reliefs are decided (ADR 0025; [t1 case and main board interface](../../../product/docs/specs/case-board-interface.md)).
6. **Legend:** reference designators are on the fabrication layers only; the silk legend (CRAFT-10, CRAFT-12) is placed at a later stage.
7. **Mirrored channels** (CRAFT-34, Q2): only the DACs and oscillators are mirrored; the output stages are not yet.
8. **Assembly variants:** the base design's DNP state is on the board; KiCad 10's design variants come with the next update from the schematic.
9. **Shield frames (decisions 15, 16):** the lid, clearance, land and inner keep-out wait for a maker's drawing; the frames have envelope models (libs v0.3.3, from `shields.toml`: wall on the land, 1.5 mm with the lid); the SoC frame's ring stands within PCB-D-01's 2 mm of the three BGAs (three warnings): rework takes the lid off and works inside the frame, whose nozzle room is **UNVERIFIED**. What the constraints ask and a back-pocket can cannot hold: the radio buck's 1.5 mm inductor L5101 and the 3.3 V buck stand outside the radio frame (PCB-EMC-03), and the front's audio parts (most of the headphone stage) stand under the display, where PCB-Z-03 allows no can, which is why the audio frame was dropped (decision 16).
