opendap-project/t1/board/docs/specs/pcb-design-constraints.md

# Main board PCB design constraints

- **Status:** Draft v0.20 (2026-10-28: obsolete-item fixes; see Changes in v0.20 below). Was Draft v0.19 (2026-10-28: PCB-EMC-03 without the headphone-stage frame). Was Draft v0.18 (2026-10-27: PCB-P-07 and P-10 checked by the placement tool). Was Draft v0.17 (2026-10-27: [ADR 0025](../adr/0025-height-zones-in-the-wider-body.md), the body at the T1-031 maximum; see Changes in v0.17 below). Was Draft v0.16 (2026-10-27). Was Draft v0.15 (2026-10-25: [stackup v3](stackup-v3.md) applied, approved by the maintainers with its nine trades: six layers, HDI 2+2+2, 1.046 mm; PCB-S-03 states the maintainers' layer-count rule; new rows PCB-S-20 to S-25, PCB-P-22, P-23; PCB-A-20 rewritten; see Changes in v0.15 below). Was Draft v0.14 (2026-10-25: [stackup v2](stackup-v2.md) and [floorplan v1](floorplan-v1.md) applied: eight layers, zoned layer roles, PCB-S-01 to S-04, S-11, S-12, S-14, S-15 and the impedance widths on L6; new zone rows PCB-S-16 to S-19 and PCB-A-20; see Changes in v0.14 below). Was Draft v0.13 (2026-10-25: [RFC 0015](https://github.com/opendap-project/rfcs/blob/main/text/0015-hat-connector-pogo-field-and-usb-c-port-hat.md): PCB-P-04 at the 2.52 A maximum trip of the shared 5.1 V limiter, eFuse #D; PCB-Z-05 names the DF40C-50DS). Was Draft v0.12 (2026-10-25: [RFC 0014](https://github.com/opendap-project/rfcs/blob/main/text/0014-hat-interface-v2-usb-only.md), HATs are USB only, hats `standard/` [interface v2](https://github.com/opendap-project/hats/blob/main/standard/docs/specs/interface-v2.md): the HAT extension, the HAT 3.3 V rail and the PCIe and CSI-2 rows withdrawn; HAT `VBUS` in both directions at the interface fault ceiling; HAT `CC` and ground return added: see Changes in v0.12 below). Was Draft v0.11 (2026-10-24: [stackup v1](stackup-v1.md) applied, its §7: board thickness, build and layer count (PCB-S-01 to S-03), the stack meets S-04 and S-12, dielectrics (S-05), new PCB-S-14 (impedance classes on L1, L3, L8, L10 only) and S-15 (delay matching across layers), the impedance-class exception to PCB-G-01, the width and gap of every impedance class (PCB-I-01 to I-09, I-12), PCB-I-07 reworded as a microstrip over a cut-out, the RF stack values and the `RF_CUTOUT` rule area (PCB-R-03); DRC rules for widths, pair gaps, layers and the RF cut-out). Was Draft v0.10 (2026-10-24: hats `standard/` [interface v1.1](https://github.com/opendap-project/hats/blob/main/standard/docs/specs/interface-v1.md) and its [ADR 0005](https://github.com/opendap-project/hats/blob/main/standard/docs/adr/0005-interface-v1-1-shared-extension-and-contact-reduction.md): the shared extension class `HAT_EXT_100D` (PCB-I-12), the extension switch placement (PCB-I-13), PCIe and CSI-2 rows ending at the switch, one DF40 connector; HAT power rows at the tolerance-included trips of [BOM v1.11](bom-v1.md#changes-in-v111) with a new `PWR_HAT5V` class (PCB-P-04, P-05, P-20); DRC rules for P-20 and the extension via count). Was Draft v0.9 (2026-10-24: battery interface rows PCB-L-04 to L-10 from [ADR 0020](../adr/0020-battery-connected-through-contacts.md), with DRC rules for L-04, L-05 and L-08; wording of PCB-M-07, Z-01, P-01, P-17 and L-02 for the battery contacts). Was Draft v0.8 (2026-10-24: metal-case antenna rows PCB-R-08 to R-13, BRD-061), Draft v0.7 (2026-10-24: radio rows from ADR 0018) and Draft v0.6 (2026-10-24; v0.2 applies ADR 0016, v0.3 Rockchip's layout rules, v0.4 Murata's 2EL notes and the interface standards, v0.5 the compliance constraints (T1-071 to T1-086) and RFC 0010 levels, v0.6 the DFM rule families, further layout rules and the craft net-class names). Nothing here is laid out or measured yet.
- **Structure:** sections by category; each row has an ID, a quality level ([RFC 0010](https://github.com/opendap-project/rfcs/blob/main/text/0010-quality-levels.md)), limits, the design value, its source and how it is enforced.
- **Purpose:** every limit the main-board layout must respect, derived from the product requirements, the parts and the fab, in one place. Each constraint has an ID, a minimum, a target and a maximum where they apply, its source, and the mechanism that enforces it.
- **Changes in v0.6:** DFM families H, B, D, V, W and L added as constraints; industry-wisdom gaps added under new IDs; PCB-I-09 reworded (no guard traces) with the MCLK branch limit; impedance-controlled net classes renamed `<name>_<ohms>SE` / `<name>_<ohms>D`; project rules composed in `hardware/t1-main-board/`.
- **Changes in v0.20** (2026-10-28): new PCB-D-11, test pads on either side (ADR 0027, flying probe); new PCB-G-11, mechanical hole to inner copper at the fab's six-layer value (8 mil; the composed fab rules carried the eight-layer 9 mil); every drill, via and hole rule checked against the fab's six-layer rows. PCB-P-07 lists the converters whose switch nodes are on the board (the TPS62870Z4 for vdd_cpu, no RK860; the TPS65131 by its boost half; the TPS62827, TPS62826, TPS61160 and the RP2354A core regulator added).
- **Changes in v0.19** (2026-10-28, [placement v1](placement-v1.md) decision 16): PCB-EMC-03 withdraws the shield-can frame around the headphone stage (maintainer decision for board area): most of the stage stands on the front, where PCB-Z-03 allows no can. PCB-T-06's frames around the SoC and DDR and around the radio stay.
- **Changes in v0.18** (2026-10-27, [placement v1](placement-v1.md) decision 14): PCB-P-07 and PCB-P-10 gain a tool check: every converter's input (3.0 mm) and output (5.0 mm) capacitors and every IC's decoupling (4.0 mm; 6.0 mm from 10 µF) within a bound of the pins they serve, centre to centre; the placement build fails otherwise.
- **Changes in v0.17** (2026-10-27, [ADR 0025](../adr/0025-height-zones-in-the-wider-body.md), [t1 ADR 0006](../../../product/docs/adr/0006-body-at-the-maximum-width.md)): PCB-M-01 body 62.5 × 95.0 × 25.0 mm; PCB-M-02 walls 1.2 mm (was a 1.6 mm assumption), outline 59.1 × 91.6 mm; PCB-M-08 hole positions follow the edges; PCB-Z-02 bands 17.75 and 7.75 mm from the inner wall; PCB-Z-06 to Z-08 restated for the new outline and decided as case interface (the DM3AT push-push socket is kept); new PCB-Z-09, the speaker on a case shelf; PCB-R-07's top-wall area 60.1 mm long. The case side is mirrored in the [t1 case and main board interface](../../../product/docs/specs/case-board-interface.md).
- **Changes in v0.15** (2026-10-25, [stackup v3](stackup-v3.md), approved by the maintainers with the trades of its §0.1): the board is six layers, HDI 2+2+2, 1.046 mm (PCB-S-01 to S-03, S-05); PCB-S-03 records the maintainers' rule, the minimum layer count that meets every must constraint (Q0); one full-layer ground (L5), zone-local grounds on L2 and L3 (PCB-S-04, S-19); PCB-S-12 pairs the core and system rails' plane L2 with the L3 ground across 90 µm on the front side; impedance classes route on L1, L4 and L6 by zone (PCB-S-14, S-18), with the outer widths of stackup v3 (SE50 188 µm, D90 126 µm, D100 135.5 µm) and the inner widths on L4 (102.5, 97, 89 µm) (PCB-I-01 to I-09, PCB-G-01 exception); RF line on L6 over the radio zone's L4 ground, L5 cut out (PCB-I-07, R-03); PCB-I-10 pad voids per stackup v3 §4.1; PCB-P-01 met with two inner pour layers; new rows for the trades: PCB-S-20 (core and system rails share L2, core-rail pours on L1), S-21 (analog rail joins), S-22 (no spare core layer), S-23 (heat spreading, Q2), S-24 (LPDDR4X 3 × W on L4), S-25 (ground layers per zone), PCB-P-22 (I/O zone `VBUS` as outer pours), P-23 (power zone pour layers); PCB-A-20 rewritten (audio rails as tracks, no audio power layer). DRC: layer names for six layers, PCB-S-14 by zone on L4, S-18 on L2/L3/L5, new S-24, S-25 (three rules), P-22, A-20 rewritten, PCB-I-09 at 0.31 mm. Net classes: widths and layers of stackup v3, `spacing_inner_um` on the LPDDR4X classes.
- **Changes in v0.14** (2026-10-25, [stackup v2](stackup-v2.md), [floorplan v1](floorplan-v1.md)): the board is eight layers, HDI 2+4+2, 1.002 mm (PCB-S-01 to S-03); one full-layer ground (L7) and zone-local grounds, each zone with its own layer roles (PCB-S-04, new PCB-S-16 to S-19); PCB-S-12 pairs the core-rail plane with ground across a laser-class prepreg of at most 90 µm (was the 65 µm of stackup v1); impedance classes route on L1, L6 and L8 by zone (PCB-S-14, DRC by zone), with the inner widths of stackup v2 on L6 (PCB-I-01 to I-09: SE50 90.5 µm, D90 95.5 µm, D100 85.5 µm); the RF line on L8 references the radio zone's L6 ground with L7 cut out (PCB-I-07, R-03); PCB-I-10 pad voids per stackup v2 §4.1; new PCB-A-20 (audio power layer L4). DRC: zone rules PCB-S-17, S-18, zone-aware S-14, A-20; layer names for eight layers; PCB-L-04 leaves rule areas out; the impedance wildcard leaves `BAT_SENSE` out. Net classes: `PWR_AUDIO` and the zone classes added.
- **Changes in v0.13** (2026-10-25, [RFC 0015](https://github.com/opendap-project/rfcs/blob/main/text/0015-hat-connector-pogo-field-and-usb-c-port-hat.md), BOM v1.14): PCB-P-04 covers the TPS62903 output through eFuse #D to #A and #C, at #D's 2.520 A maximum trip: 0.65 → 1.1 mm outer, 3.2 → 5.5 mm inner (was the 1.68 A trip of v0.10, below the 1.981 A of v1.13); PCB-Z-05 takes the DF40C-50DS receptacle height (1.45 ± 0.15 mm).
- **Changes in v0.12** (2026-10-25, [RFC 0014](https://github.com/opendap-project/rfcs/blob/main/text/0014-hat-interface-v2-usb-only.md)): PCB-I-03 (PCIe), PCB-I-12 and PCB-I-13 (HAT extension) and PCB-P-05 (`HAT_3V3`) withdrawn, their IDs kept and not reused; summary item 7 and open item 11 withdrawn; PCB-I-04 is DSI only; PCB-I-10, PCB-W-03 and PCB-R-06 without the PCIe and extension classes; PCB-P-20 is HAT `VBUS` in both directions under USB PD at the interface fault ceiling, 4.5 A (was 3.0 A), so 2.4 / 12.1 mm (was 1.4 / 6.9 mm); new PCB-P-21 (HAT ground return) and PCB-I-14 (HAT `CC`); `HAT_3V3` and `HAT3V3_EN` removed from PCB-EMC-02, PCB-P-11 and PCB-P-18; PCB-P-07 and P-12 list one TPS62903 (the HAT 3.3 V buck is removed); rows that named the DF40C-100 or the pogo field name "the HAT connector", whose part follows the connector decision. DRC and net classes: `PWR_HAT3V3`, `PCIE_85D`, `PCIE_REFCLK_100D` and `HAT_EXT_100D` and their rules removed.
- **Enforced by:** `DRC` = the T1 product rules ([`hardware/rules/`](../../hardware/rules/)), composed after the PCBWay HDI fab rule set and the OpenDAP craft rule set into [`hardware/t1-main-board/t1-main-board.kicad_dru`](../../hardware/t1-main-board/); a rule whose value is still **UNVERIFIED** is a DRC warning, the others are errors; `NC` = net class in [`hardware/rules/netclasses.toml`](../../hardware/rules/netclasses.toml); `CHK` = a script check on the layout; `SIM` = a simulation in `sim/`; `REV` = a review item with its checklist line, because no tool can check it.
- **Levels:** `[Qn]` after an ID is the RFC 0010 quality level at which the constraint becomes mandatory; an ID without it is Q1 until it is next reviewed.
- **Values:** a value with no source is not used. **UNVERIFIED** marks values taken from a sibling part, an assumption, or a source not yet retrieved; each one names what closes it. Arithmetic is shown as such. Rows of families H, B, D, V, W and L cite the source keys of [`hardware/rules/README.md`](../../hardware/rules/README.md#sources-of-the-rule-values); rows from industry practice cite their gap (`G-nn`) and practice (`IW-…`) identifiers. Source keys [P1]–[P20] are the prototype fab's published capability pages, as keyed in libs' `kicad/` `pcbway-*` rule sets.

## 0. Summary

1. **Front side under the display: parts up to 1.0 mm; the body grows to 25 mm** ([ADR 0016](../adr/0016-front-side-height-under-the-display.md), restated in [ADR 0025](../adr/0025-height-zones-in-the-wider-body.md), where the body also grows to 62.5 × 95.0 mm and the board outline to 59.1 × 91.6 mm). The thickness stack gave 0.3 mm between the display and the board, while about 2,100–3,700 mm² of parts must sit under the display. The extra 1.0 mm comes from body thickness (T1-031 maximum), not from the battery, whose energy is the limit of T1-039. No thickness margin is left within 25 mm.
2. **High-speed values come from Rockchip's documents** (Rockchip HDG 1.1 and HSPCB 1.0: RK3566 Hardware Design Guide V1.1.0 and the RK3568 High Speed PCB Design Guide V1.0.0, which covers the same interface blocks). LPDDR4X is 50 Ω single-ended and 100 Ω differential. Where Rockchip is looser than a standard or than the T1's need, the T1 keeps the tighter value and says why.
3. **The main board is an HDI build, without via-in-pad as a requirement.** The RK3566 has 343 core balls at 0.65 mm and a two-row ring of 222 balls at 0.4 mm. Laser microvias as dog-bones in the 0.825–0.875 mm channel between the ring and the core escape every inner-ring ball (arithmetic on the package drawing, Rockchip HDG 1.1 and HSPCB 1.0); through vias do not fit there. Rockchip itself uses 4–6 layers; the T1's six ([stackup v3](stackup-v3.md)) are the minimum that meets every must constraint (PCB-S-03), and the escape study closes the escape, the decoupling and the core planes on them. It is a single board: no stacked boards through a perimeter interposer, because the interposer is a custom part (T1-038), prototype assembly does not cover it, and rework becomes impractical.
4. **Copper for power is sized for the protection rating, not the typical draw** (BRD-049): the battery path carries the 5 A fuse rating continuously with ≤ 10 °C rise.
5. **Audio rules come from the CS43198 and OPA1622 datasheets** and from the decided topology (ADR 0010, 0012, 0015): split nothing, partition everything.
6. **The battery connects through six spring contacts in a window of the pocket floor** ([ADR 0020](../adr/0020-battery-connected-through-contacts.md); v0.9): two contacts per power pole, an empty position between P+ and the signals, only battery nets and GND in the contact area, and the ESD diodes at the contacts (PCB-L-04 to L-10). DRC checks the partition, the empty position and the ESD placement; heights, tolerances and pour symmetry are CHK and REV items.
7. **Withdrawn ([RFC 0014](https://github.com/opendap-project/rfcs/blob/main/text/0014-hat-interface-v2-usb-only.md), v0.12).** HATs are USB only (hats `standard/` [interface v2](https://github.com/opendap-project/hats/blob/main/standard/docs/specs/interface-v2.md)): the HAT extension, its switches and its PCIe and CSI-2 rows are gone. The HAT port is USB 3 (`USB3_90D`), its USB 2.0 pair (`USB2_90D`), `CC` (PCB-I-14) and `VBUS` with its ground return at the interface's 4.5 A fault ceiling (PCB-P-20, P-21).
8. **The board is six layers, HDI 2+2+2, 1.046 mm nominal, zoned** ([stackup v3](stackup-v3.md), [floorplan v1](floorplan-v1.md); v0.15; was eight layers in stackup v2 and ten in stackup v1). Six zones share the layers, each with its own roles; one full-layer ground (L5) and zone-local grounds on L2 and L3 stitched to it, one ground net (PCB-A-01). Impedance classes route on L1, L4 and L6 where the zone's references are ground (PCB-S-14), and each class has a width per layer (PCB-I). The maintainers accepted nine trades with the stack (stackup v3 §0.1), each a row here (PCB-S-20 to S-25, PCB-P-22, P-23, PCB-A-20). The stack rests on the fab's published data and stated assumptions until the fab's DFM review, so its width rules are warnings until then.

## 1. Outline and mechanics (inputs from the product)

The case owns its walls, bosses and keep-outs; these values are the board's inputs until the case and the t1 interface files publish them.

| ID | Constraint | Min | Target | Max | Source | Enforced by |
|---|---|---|---|---|---|---|
| PCB-M-01 | Body the board lives in | — | 62.5 × 95.0 × 25.0 mm | 62.5 × 95 × 25 mm (T1-031) | [t1 ADR 0006](../../../product/docs/adr/0006-body-at-the-maximum-width.md), [ADR 0025](../adr/0025-height-zones-in-the-wider-body.md), T1-031 | REV |
| PCB-M-02 | Board outline inside the cavity | — | cavity minus 0.5 mm per side: 59.1 × 91.6 mm, centred | cavity = body − 2 × wall: 60.1 × 92.6 mm with 1.2 mm walls (arithmetic) | Walls 1.2 mm per side: case interface, [ADR 0025](../adr/0025-height-zones-in-the-wider-body.md) (t1 case and main board interface CB-02); clearance 0.5 mm per side **UNVERIFIED** (ISO 2768-m ±0.3 mm on the case plus the fab outline ±0.1 mm advanced [P2]) | DRC (board edge), REV |
| PCB-M-03 | Board outline tolerance | — | ±0.1 mm | ±0.2 mm | The fab advanced / standard [P1, P2] | fab notes |
| PCB-M-04 | Coordinate system | — | origin at the device centre, x across, y along, +z towards the faceplate | — | T1-021 (Draft) | KiCad grid origin, export |
| PCB-M-05 | Edge connectors on the bottom edge, left to right | — | 3.5 mm jack, 4.4 mm jack, USB-C centred, speaker on the right | — | T1-016 | REV |
| PCB-M-06 | Side buttons | — | Action, Vol+, Vol− on the left edge; Main on the right | — | T1-014, T1-015 | REV |
| PCB-M-07 | Battery contacts in a window of the pocket floor at the pocket's bottom end (v0.9; was: Micro-Fit 3.0 connector in a notch outside the pocket) | — | Six KYOCERA AVX 70-9258-001-120-006, face compression (PCB-L-04 to L-06) | — | [ADR 0020](../adr/0020-battery-connected-through-contacts.md), BOM line 47 | REV |
| PCB-M-08 | Mounting holes | 4 | 4 (two top, two bottom bosses): 2.2 mm at (±26.05, 42.3) and (±26.8, −27.0) mm, at the same distance from the edges as in the 55.3 × 90.1 mm outline | — | T1 body layout (Ø 4 bosses), **UNVERIFIED** until the case (CB-09) | DRC (PCB-H-01 to H-06), REV |
| PCB-M-09 | Fiducials | 3 global per populated side | 3 + 2 local at the RK3566 | — | The fab's assembly practice, **UNVERIFIED** (ask in DFM review) | DRC (PCB-D-02 to D-04), CHK (count per side), REV |

### 1.1 Mounting holes (PCB-H)

The screw is not chosen (M2 or M1.6 class). The rings are sized for the larger case, an M2 screw with an ISO 7089 washer (outer Ø 5.0 mm) in a 2.2 mm hole: (5.0 − 2.2) / 2 = 1.4 mm from the hole edge (arithmetic; washer [F1]). Every H rule is a DRC warning until the case fixes the screw (CHK-H-01).

| ID | Constraint | Min | Target | Source | Enforced by |
|---|---|---|---|---|---|
| PCB-H-01 [Q1] | No part under the screw head or washer: courtyards from the hole edge | 1.4 mm | 1.4 mm | ISO 7089 [F1], arithmetic; screw **UNVERIFIED** | DRC |
| PCB-H-02 [Q1] | No copper of another net under the head, outer layers | 1.4 mm | 1.4 mm | [F1]; Rockchip HSPCB p. 12 (no traces near mounting holes); screw **UNVERIFIED** | DRC |
| PCB-H-03 [Q2] | A plated mounting hole is on GND | — | — | Proposal (chassis and ESD path); plated or not is undecided (CHK-H-02) | DRC |
| PCB-H-04 [Q1] | Mounting hole to board edge | 1.5 mm | 1.5–2 mm | ALLPCB [AP] (secondary), **UNVERIFIED**: no primary source | DRC |
| PCB-H-05 [Q1] | MLCC (`C*`) courtyard to the hole edge | 3 mm | 3 mm | Murata "as far away from the screw holes as possible" [MU]; number **UNVERIFIED** | DRC, REV (CHK-H-03, orientation) |
| PCB-H-06 [Q2] | BGA balls to the hole edge | 5 mm | 5 mm | **UNVERIFIED** (IPC-7095 not retrieved) | DRC |

### 1.2 Board edges and panel (PCB-B)

The board is routed and held in the fab's panel by tabs with rails [P20]; rule areas `BREAK_TAB` mark the tabs.

| ID | Constraint | Min | Target | Source | Enforced by |
|---|---|---|---|---|---|
| PCB-B-01 [Q1] | Courtyard to board edge, except edge parts `J*` and `SW*` | 0.3 mm | 0.3 mm | PCB-G-05 applied to the body, **UNVERIFIED** | DRC, REV (CHK-B-03, overhangs) |
| PCB-B-02 [Q1] | Copper to the edge at a break tab | 0.4 mm | 0.4 mm | JLCPCB copper to a V-cut [JL]; **UNVERIFIED** for tabs (the fab publishes none) | DRC |
| PCB-B-03 [Q1] | MLCC courtyard to a broken edge | 5.08 mm | 5.08 mm | KYOCERA AVX quoted by DigiKey [DK] (secondary) | DRC, REV (CHK-B-01, CHK-B-02) |

## 2. Height zones (z)

Heights are above the board surface. "Front" is +z (towards the display), "back" is −z (towards the battery).

| ID | Zone | Max part height | Source | Enforced by |
|---|---|---|---|---|
| PCB-Z-01 | Back, under the battery pocket footprint (RK3566, LPDDR4X, eMMC here) | 1.5 mm, shield can and thermal pad included; exception: the battery contacts in the pocket-floor window (free height 3.3 mm, PCB-L-05) | T1 thickness stack; ADR 0016 | CHK (3D height per zone) |
| PCB-Z-02 | Back, bottom band (jacks, USB-C, speaker shelf) 17.75 mm and top band (microSD, antenna feed) 7.75 mm from the inner wall | 14.2 mm (arithmetic: battery layer 12.3 + 1.5 + 0.4) | T1 thickness stack; ADR 0025 (fixed stack 12.7 mm at 25 mm) | CHK |
| PCB-Z-03 | Front, under the display module | 1.0 mm (FH35C 0.9 ± 0.1 mm included); no shield cans; display-to-board gap 1.3 mm | ADR 0016 | CHK |
| PCB-Z-04 | Front, outside the display footprint | 6.8 mm where the faceplate frame leaves room, **UNVERIFIED** until the faceplate mechanics exist | ADR 0016 | CHK |
| PCB-Z-05 | Tallest known parts and their zone | G-Switch 4.4 mm jack 6.5 mm (bottom band), USB4105 3.31 mm (bottom band), DM3AT microSD 1.68 mm (top band), XAL4020 inductor 2.1 mm (bands only), the HAT flat-cable receptacle DF40C-50DS 1.45 ± 0.15 mm (RFC 0015), FH35C 0.9 mm | the parts' datasheets (libs generator data) | CHK |
| PCB-Z-06 | Case interface (decided, ADR 0025): pocket relief at the 4.4 mm jack J4001 | The jack's courtyard reaches 4.79 mm into the pocket footprint: x −16.64 to −6.45 mm, y −28.55 to −23.75 mm (device frame, placement v1), part height 6.5 mm; the pocket floor and the pack keep out of that volume. No catalog 4.4 mm jack fits PCB-Z-01 (its plug bore alone exceeds 1.5 mm) | Placement v1 §5; ADR 0025; t1 CB-06 | CHK (case STEP against the board export), input to the case |
| PCB-Z-07 | Case interface (decided, ADR 0025): pocket relief at the microSD socket J6201 (DM3AT-SF-PEJM5, push-push, kept) | x 5.62 to 21.38 mm, y 27.53 to 38.55 mm (11.02 mm into the pocket), part height 1.68 mm, 0.18 mm over PCB-Z-01; card insertion path along +y to the top edge | Placement v1 §5; ADR 0025; BOM v1 line 11; t1 CB-07 | CHK, input to the case |
| PCB-Z-08 | Case interface (decided, ADR 0025): side strips at the side buttons SW6901–SW6904 | Left edge x −29.59 to −25.70 mm over y 21.50 to 39.72 mm (placement v1.9: four PTS815 lands, 6.0 mm long with their courtyards, the Action one included, BOM v1.22 line 76; above y 38.55 the strip runs in the top band), right edge x 25.70 to 29.59 mm over y 26.50 to 32.50 mm; the courtyards end 0.15 mm outside the pocket footprint, so the strip carries the case tolerance (ISO 2768-m ±0.3 mm); part height 2.7 mm (PTS815, 2.5 ± 0.2 mm, C&K data sheet p. B-44); the actuators face the side walls | Placement v1 §5; ADR 0025; controls spec §1.4 (positions **UNVERIFIED**); t1 CB-08 | CHK, input to the case |
| PCB-Z-09 | Case interface (decided, ADR 0025): the speaker on a case shelf above the bottom band | Shelf footprint x 6.0 to 21.0 mm, y −45.0 to −34.0 mm (the speaker's 15 × 11 mm outline at its floorplan position, **UNVERIFIED**); the speaker takes no board area; back parts under the shelf ≤ 1.5 mm until the case sets the shelf clearance (**UNVERIFIED**); spring-contact pads TP5503, TP5504 on the board | ADR 0025; BOM v1 line 33; t1 CB-05 | CHK (3D height), input to the case |

## 3. Stackup and build

No general power-plane pull-back (20-H) rule: Hubing's measurements show it increases power-bus radiation (IW-SR-05); each plane is decided in the stackup review.

| ID | Constraint | Min | Target | Max | Source | Enforced by |
|---|---|---|---|---|---|---|
| PCB-S-01 | Board thickness | 1.0 mm | 1.046 mm nominal (stackup v3; v0.15, was 1.002 mm), ±0.10 mm, ≤ 1.2 mm | 1.2 mm (z stack) | T1 thickness stack (1.2 mm); the fab HDI example 8 layers 1.0 ± 0.1 mm [P3]; [stackup v3](stackup-v3.md) §1 | fab notes, export |
| PCB-S-02 | Build | 1+N+1 | 2+N+2 (2+2+2: one 0.43 mm core, two sequential laminations), stacked copper-filled microvias L1–L2–L3 and L6–L5–L4 (first level 0.10 mm laser in 120 µm, aspect 1.2, **UNVERIFIED**), through vias, no buried vias; no via-in-pad needed by the escape (BGA escape study) | any-layer only if the escape study needs it | Rockchip HDG 1.1 and HSPCB 1.0: microvias needed for the 0.4 mm ring, not necessarily in the pad; [stackup v3](stackup-v3.md) §1 | stackup, DRC (via types) |
| PCB-S-03 [Q0] | Layer count: the minimum that meets every must constraint. Maintainers' rule (2026-10-25): fewer layers is better; the layers that are needed in the end are fine. A layer is added only when a must constraint fails without it, and the failing constraint is named | — | 6 (stackup v3; v0.15, was 8 in stackup v2 and 10 in stackup v1) | the minimum that meets every must constraint | Maintainers' rule and approval of stackup v3, 2026-10-25; six layers meet every zone's needs, the thickness window, the RF ground depth (PCB-R-03), the core-rail pairing (PCB-S-12) and the SoC escape, decoupling and plane check ([stackup v3](stackup-v3.md) §0); Rockchip's templates use 4–6 (Rockchip HDG 1.1 and HSPCB 1.0) | stackup, REV |
| PCB-S-04 | Reference planes | — | Every high-speed and every analog-audio routing layer adjacent to ground in its zone. Satisfied by stackup v3: L1 over L2 outside the core zone, L4 between L3 and L5 outside the power and radio zones, L6 over L5 everywhere | — | Standard practice; CS43198 §8 (DS1156F2 p. 121); [stackup v3](stackup-v3.md) §3, §4.1 | stackup v3, DRC (PCB-S-14 by zone, S-25), REV |
| PCB-S-05 | Dielectric | 50 µm (impedance) | per stackup v3: 90 and 120 µm prepregs, 430 µm core | — | [P2, P12]; [stackup v3](stackup-v3.md) §2 | stackup (`odapkit stackup check`; the fab's DFM review confirms) |
| PCB-S-06 | Material | Tg 170 FR-4 | Tg 170, high-speed class 1–5 G if the USB 3 loss budget needs it | — | The fab materials [P2, P16]; loss budget at layout. The Dk stackup v3 uses is the fab's published table value (S1000-2M datasheet not retrieved, **UNVERIFIED**) | stackup |
| PCB-S-07 | Finish | — | ENIG (or ENEPIG) | — | Fine-pitch BGA and QFN flatness; the fab [P1] | fab notes |
| PCB-S-08 | Acceptance class | IPC Class 2 | Class 2 for prototypes | Class 3 on request | [P1, P16] | fab notes |
| PCB-S-10 [Q1] | Ground stitching via at every signal via that changes reference between ground planes, symmetric for pairs | — | ≤ 0.76 mm centre to centre; ≤ 0.64 mm for `DDR_*` | 5.08 mm | G-01; IW-SR-03: Rockchip HSPCB pp. 8, 23; TI SPRACP4A §2.4 | CHK |
| PCB-S-11 [Q1] | Layer change that swaps the reference between ground and a power plane gets a stitching capacitor; classes PCB-I-01 to I-06 and I-09 never reference a power plane. With stackup v3 no impedance class routes next to a power area (PCB-S-14 by zone); the stitching capacitor applies to low-speed routes on L1 over the core zone's L2 rail plane | — | 100 nF per 3–4 signal vias | — | G-02; IW-SR-04: Rockchip HSPCB p. 26; TI SPRACP4A §2.4; [stackup v3](stackup-v3.md) §4.1 | CHK, REV |
| PCB-S-12 [Q1] | Every signal layer adjacent to ground in its zone (PCB-S-04 extended); SoC core and LPDDR4X supply plane paired with an adjacent ground across a laser-class prepreg, on the side nearer the front decoupling (ADR 0016) | — | ≤ 90 µm (1080 or 3313; v0.14, was 65 µm). Satisfied by stackup v3: the core and system rails' plane L2 with the L3 ground across 90 µm of 3313, on the front side next to the decoupling, 43.8 pF/cm² (arithmetic) (v0.15; was L4/L5 in stackup v2) | 90 µm | G-03; IW-SR-01 (Hartley, Ott), IW-SR-06 (Archambeault), IW-PI-01; [stackup v3](stackup-v3.md) §4.3; PDN impedance **UNVERIFIED** until the layout's PDN simulation | stackup v3, REV (DRV-302), SIM |
| PCB-S-13 [Q2] | Ground planes stitched by a via grid, with an edge fence | — | edge pitch ≤ 2.5 mm **UNVERIFIED** (arithmetic: λ/10 at 6 GHz in FR-4, εr ≈ 4); interior grid **UNVERIFIED** | — | G-04; IW-SR-07 (Ott, Ritchey; chapters **UNVERIFIED**) | CHK |
| PCB-S-14 [Q1] | Impedance-controlled classes (`*_<ohms>D`, `*_<ohms>SE`) route only on L1, L4 and L6, and only where the layer's references are ground in its zone: not on L1 in the core zone, not on L4 in the power and radio zones; `MCLK_50SE` on L4 only (PCB-I-09), `RF_50SE` on L1/L6 only (PCB-I-07). KiCad layers: L1 `F.Cu`, L4 `In3.Cu`, L6 `B.Cu` | — | as stated | — | [stackup v3](stackup-v3.md) §3, §4.1 (v0.15) | DRC (layer and zone conditions) |
| PCB-S-15 [Q1] | A matched group that changes layers is matched in delay, not in length | — | 7.07–7.08 ps/mm inner (L4), 5.84–6.18 ps/mm outer (L1, L6) | — | [stackup v3](stackup-v3.md) §4.2, §5 (v0.15) | CHK |
| PCB-S-16 [Q1] | Zones: every block of the feature-blocks catalog in exactly one zone of the floorplan; zones and corridors drawn as rule areas `ZONE_<NAME>` and `ZONE_CORRIDOR`; every net carries its zone class (`ZONE_<NAME>` or `ZONE_SHARED`) besides its signal class | — | six zones and five corridors ([floorplan v1](floorplan-v1.md) §2, §4) | — | Maintainers' direction 2026-10-25 (zoned layer sharing); [floorplan v1](floorplan-v1.md) | REV, schematic (net classes) |
| PCB-S-17 [Q1] | A track of another zone's net is allowed in a zone only wholly inside a corridor; `GND` and `ZONE_SHARED` nets everywhere | — | — | — | [floorplan v1](floorplan-v1.md) §4 | DRC (six rules) |
| PCB-S-18 [Q1] | Under a corridor the references of the routing layers (L2, L3, L5) carry only ground, so a crossing changes no reference | — | — | — | [floorplan v1](floorplan-v1.md) §4; [stackup v3](stackup-v3.md) §4.1 | DRC |
| PCB-S-19 [Q2] | Every zone-local ground (L2, L3, and L4 under an L6 RF line, where they are ground) stitched to the full-layer L5 ground on the PCB-S-13 grid and along every edge of its area; no slot along a zone boundary (PCB-A-01) | — | edge pitch ≤ 2.5 mm, as PCB-S-13 (**UNVERIFIED**) | — | [stackup v3](stackup-v3.md) §4.2; G-04 | CHK |
| PCB-S-20 [Q1] | Core zone: the SoC core and LPDDR4X rails and the system rails share one plane layer, L2, paired with the L3 ground (PCB-S-12); the core rails also pour on L1 between the decoupling capacitors, from their regulators to the package edge, so every core rail has at least its IPC-2221 inner width (ΔT 10 °C) of copper at the package edge (trade 1) | — | escape study: vdd_cpu 15.28 mm (6.91 needed), vdd_gpu 15.08 (5.38), vdd_logic 5.52 (5.38), vdd_npu 15.85 (2.66), vcc_ddr 21.83 (2.66) | — | Maintainers' approval of stackup v3, 2026-10-25; [stackup v3](stackup-v3.md) §4.3; [BGA escape study](../../hardware/studies/bga-escape/README.md); PDN impedance **UNVERIFIED** (PCB-S-12) | REV, SIM (PDN) |
| PCB-S-21 [Q1] | The interleaved analog rails vcca_1v8 and vdda_0v9 (and any rail left in pieces on L2) are joined by short tracks on L4, on L2 through the other rails' pours (never through a core rail's feed), or on L1; each join is drawn as one track, with no neck where two joins meet (PCB-W-01); rails that do not reach the package edge on L2 (vcc0v6_ddr, vccio6_1v8, vccio_sd, vdda_0v9) are fed by a track (trade 2) | — | — | — | Maintainers' approval of stackup v3, 2026-10-25; [stackup v3](stackup-v3.md) §4.3; [BGA escape study](../../hardware/studies/bga-escape/README.md) | DRC (PCB-W-01, unconnected items), REV |
| PCB-S-22 [Q1] | The core zone routes on L4 and L6, with low-speed nets on L1 between the decoupling; there is no spare routing layer and no fallback layer. A routing shortfall found at placement goes back to the maintainers as a stackup question, under PCB-S-03 (trade 8) | — | — | — | Maintainers' approval of stackup v3, 2026-10-25; [stackup v3](stackup-v3.md) §4.7 | REV (placement) |
| PCB-S-23 [Q2] | Heat spreading under the SoC with six copper layers (fewer planes than stackups v1 and v2) checked against the SoC's and the board's thermal limits (trade 9) | — | — | — | Maintainers' approval of stackup v3, 2026-10-25; spreading **UNVERIFIED** | SIM (thermal), V4-03 |
| PCB-S-24 [Q1] | LPDDR4X (`DDR_50SE`, `DDR_100D`) on L4 keeps 3 × W from every other net, the two halves of a DQS or CK pair excepted: L4 lies 430 µm under L3 and 90 µm over L5, so its edge coupling is higher (trade 7) | 307.5 µm (3 × 102.5 µm, arithmetic) | 307.5 µm | — | [stackup v3](stackup-v3.md) §4.4: near-end Kb of two SE50 traces on L4 at 2 × W 3.81 %, at 3 × W 1.85 % (`odapkit stackup coupling`); stack **UNVERIFIED** until the DFM review | DRC (warning until the DFM review), NC (`spacing_inner_um`) |
| PCB-S-25 [Q1] | The ground layers of each zone carry only ground (tracks and fills; vias pass): L5 under every zone; L2 in every zone but the core; L3 in every zone but the power zone | — | — | — | [stackup v3](stackup-v3.md) §3 | DRC (three rules) |

## 4. Geometry beyond the fab rules

The fab rule set (`pcbway-hdi`) carries the fab's limits. These are the T1's own, tighter values.

| ID | Constraint | Min | Target | Source | Enforced by |
|---|---|---|---|---|---|
| PCB-G-01 | Track and space, general | 0.1 / 0.1 mm | 0.1 / 0.1 mm or more | Margin over the fab HDI 0.065 mm [P3] and normal outer 4/5 mil [P1]; finer only in the BGA escape. **Exception** (v0.11): impedance classes use their stackup widths (PCB-I), never below 0.075 mm (stackup v3: 89.0 µm and wider on L4; the fab HDI 3/3 mil standard order option, libs `kicad/` [fab rule sets](https://github.com/opendap-project/libs/tree/main/kicad/design-rules)); the general 0.1 mm stays for every other net | DRC |
| PCB-G-02 | Track and space inside the RK3566 courtyard | 0.065 / 0.065 mm | 0.075 / 0.075 mm | The fab HDI [P3] | DRC (area rule) |
| PCB-G-03 | Laser microvia | 0.10 mm drill | 0.10 mm drill, 0.25 mm land | The fab 4 mil laser [P3]; land from the 0.25 mm BGA pad | DRC |
| PCB-G-04 | Mechanical via (outside the BGA) | 0.20 mm drill, 0.45 mm pad | 0.25 / 0.50 mm | The fab advanced normal 0.20 mm [P1, P3] | DRC |
| PCB-G-05 | Copper to board edge | 0.30 mm | 0.50 mm | The fab 0.20 mm milled [P1]; margin for the ±0.1 mm outline | DRC |
| PCB-G-06 | Courtyard clearance | 0 (no overlap) | 0.1 mm | IPC-7351 courtyard practice | DRC |
| PCB-G-07 | Thermal relief on plane connections of hand-reworkable parts | — | Relief on connectors and test pads; solid on power parts and exposed pads | Assembly and thermal pads (CS43198 §8.4, OPA1622 pad to V−) | DRC (zone rules) |
| PCB-G-08 | Silkscreen | 0.15 mm line, 0.8 mm text | 0.15 / 0.8 mm | The fab [P1] | DRC |
| PCB-G-09 [Q1] | Balanced copper on both pads of every 0201 and 0402 part; where a decoupling capacitor needs a solid connection for inductance, both pads get it the same way | — | — | G-31; IW-DF-02 (IPC-7351B, EMS guides, secondary), IW-PI-01 | REV (DRV-318) |
| PCB-G-10 [Q1] | Via treatment: a via in a pad is filled and capped (IPC-4761 type VII); exposed-pad thermal vias filled, plugged or tented per the fab's process | — | — | G-32; IW-DF-03, IW-TH-03; the fab [P11, P16] | fab notes, DRC (PCB-D-10), REV (DRV-319) |
| PCB-G-11 [Q1] | Mechanical hole to inner-layer copper | 8 mil (0.203 mm) | 9 mil | The fab's six-layer row, "minimum isolation ring (inner layer)": ≥ 8 mil normal, 6.5 mil medium, 6 mil high [P1, re-read 2026-10-28]. The fab rule set carries its 8-layer row (9 mil); stackup v3 has six layers, so the product rule takes the six-layer value. The other drill and via figures do not depend on the layer count: mechanical drill 0.20 mm and its 1.6 mm aspect limit [P1], via hole to hole 11 mil [P1], outer via ring 5 mil at 35 µm [P1], laser drill 4 mil standard [P3] (the 0.10 mm hole is the laser hole of the fab's published 8- and 10-layer HDI examples [P3]), minimum thickness 0.9 mm for six layers [P1] against 1.046 mm | DRC |

### 4.1 Voltage spacing (PCB-V)

IPC-2221B Table 6-1 [IPC]: bare-board conductors (B1 0.05 mm internal, B2 0.1 mm external, B4 0.05 mm coated, 0–30 V) are met by PCB-G-01 and PCB-G-02; uncoated component terminations (A6) are not. Every net is in the 0–15 V row in steady state (battery and VSYS ≤ 8.8 V, USB-C PD up to 12 V); VBUS reaches the 16–30 V row in a surge (TVS2200 clamp 28.4 V). Creepage: none set until the compliance work establishes whether IEC 62368-1 asks for it in ES1 circuits (CHK-V-01).

| ID | Constraint | Min | Target | Source | Enforced by |
|---|---|---|---|---|---|
| PCB-V-01 [Q1] | Pad on an outer layer to copper of another net, pads of one footprint excepted, outside `BGA_ESCAPE` | 0.13 mm | 0.13 mm | IPC-2221B Table 6-1, A6, 0–15 V [IPC] (quoted by Altair, secondary) | DRC |
| PCB-V-02 [Q1] | VBUS pad to copper of another net | 0.25 mm | 0.25 mm | A6, 16–30 V [IPC]; voltages from the BOM (TVS2200) | DRC |

### 4.2 Routing hygiene (PCB-W)

Acute angles, 45° routing and short segments are craft rules (CRAFT-40, -41, -47 in libs `kicad/` `opendap-craft`), not repeated here.

| ID | Constraint | Min | Target | Source | Enforced by |
|---|---|---|---|---|---|
| PCB-W-01 [Q1] | No copper neck or sliver narrower than the narrowest track | 0.1 mm; 0.065 mm in `BGA_ESCAPE` | — | PCB-G-01; the fab HDI [P3] | DRC |
| PCB-W-02 [Q2] | Teardrops enabled on every via | — | — | Margin for the 0.075 mm microvia ring [P2, P3]; as a requirement **UNVERIFIED** | DRC |
| PCB-W-03 [Q2] | Vias per line: USB 3 ≤ 2, MIPI ≤ 4, USB 2 ≤ 6 (v0.12: the PCIe and HAT extension counts withdrawn, RFC 0014) | — | as listed | Rockchip HSPCB Tables 1, 2, 5, 10 (Rockchip HDG 1.1 and HSPCB 1.0; RK3568 edition) | DRC |

## 5. Signal classes

Impedance-controlled classes are named `<name>_<ohms>SE` (single-ended) or `<name>_<ohms>D` (differential), the form the craft rules exempt from their general width rules. Impedance tolerance on the board is the fab's ±10 % [P1]. A class whose standard allows less has to say so; those windows are **UNVERIFIED** until the standards' texts are cited in the docs.

| ID | Net class | Signals | Impedance | Length and skew | Source | Enforced by |
|---|---|---|---|---|---|---|
| PCB-I-01 | `USB2_90D` | Main USB-C D± (OTG0), HAT `D±` (USB3 HOST1 USB 2.0 pair; interface v2) | 90 Ω ±10 % differential. Stackup v3 (W / gap): L1/L6 126.0 / 100 µm, L4 97.0 / 150 µm | Intra-pair skew ≤ 0.15 mm (T1; Rockchip allows 0.51 mm); ≤ 152 mm; ≤ 4 vias; 2.2 Ω series at the SoC | HSPCB p. 13; HDG p. 59 (Rockchip HDG 1.1 and HSPCB 1.0) | NC, DRC (width, pair gap minimum, layers), CHK |
| PCB-I-02 | `USB3_90D` | HAT `SSTX±`, `SSRX±` (USB3 HOST1; interface v2) | 90 Ω ±10 % differential. Stackup v3 (W / gap): L1/L6 126.0 / 100 µm, L4 97.0 / 150 µm | Intra-pair ≤ 0.30 mm; ≤ 152 mm; ≤ 2 vias; spacing ≥ 4 × W; 100 nF 0201 AC caps on SSTX | HSPCB p. 13; HDG p. 59 | NC, DRC (width, pair gap minimum, layers), CHK |
| PCB-I-03 | — | Withdrawn ([RFC 0014](https://github.com/opendap-project/rfcs/blob/main/text/0014-hat-interface-v2-usb-only.md)): PCIe has no consumer on the T1; the PCIe PHY balls are unused | — | — | — | — |
| PCB-I-04 | `MIPI_100D` | Faceplate DSI (v0.12: the HAT CSI-2 lanes withdrawn, RFC 0014; the CSI-2 RX PHY is unused) | 100 Ω ±10 % differential. Stackup v3 (W / gap): L1/L6 135.5 / 175 µm, L4 89.0 / 250 µm | Intra-pair ≤ 0.1 mm (T1; Rockchip 0.30 mm); data to clock ≤ 0.91 mm; ≤ 152 mm; ≤ 4 vias; spacing ≥ 3 × W | HSPCB pp. 18–19 | NC, DRC (width, pair gap minimum, layers), CHK |
| PCB-I-05 | `DDR_50SE`, `DDR_100D` | LPDDR4X: DQ, DM, CA single-ended; DQS, CK differential | 50 Ω ±10 % single-ended, 100 Ω ±10 % differential. Stackup v3: single-ended L1/L6 188.0 µm, L4 102.5 µm; pairs (W / gap) L1/L6 135.5 / 175 µm, L4 89.0 / 250 µm | DQ/DM to DQS within a byte ≤ 15.2 mm; CA to CK ≤ 12.7 mm; DQS and CK pair halves ≤ 0.30 mm; DQS to CK ≤ 30.5 mm; spacing on L1/L6 ≥ 2 × W (≥ 3 × W around DQS and CK), on L4 ≥ 3 × W everywhere (PCB-S-24, v0.15); no DQ or CA swapping; a layout that departs from Rockchip's template is simulated | HSPCB pp. 44–45, Table 34; [stackup v3](stackup-v3.md) §4.4 | NC, DRC (width, pair gap minimum, layers, L4 spacing), CHK, SIM |
| PCB-I-06 | `EMMC_SD_50SE` | eMMC (HS200), microSD (SDR104, BRD-051), SDIO to the radio | 50 Ω ±10 % single-ended. Stackup v3: L1/L6 188.0 µm, L4 102.5 µm | Data and CMD to CLK ≤ 2 mm (T1; Rockchip 3.05 mm); ≤ 102 mm; ≤ 4 vias; 22 Ω series on CLK; SD ESD < 1 pF | HSPCB pp. 19–20; HDG pp. 26, 52, 54 | NC, DRC (width, layers), CHK |
| PCB-I-07 | `RF_50SE` | Module RF pins to U.FL | 50 Ω microstrip over the L3 ground (L1 line, L2 cut out 1.6 mm) or the radio zone's L4 ground (L6 line, L5 cut out), same-layer ground ≥ 0.6 mm ([stackup v3](stackup-v3.md) §4.5; v0.11, was "coplanar with ground", which conflicted with PCB-R-03). Width 391 µm on L1/L6 | Shortest; π network at the pin | U.FL-R-SMT-1 50 Ω; Murata layout guide **UNVERIFIED** | NC, DRC (width, layers, same-layer ground, `RF_CUTOUT`), REV |
| PCB-I-08 | `I2S_50SE` | SoC → CS43198 ASP (SCLK, LRCK, SDIN) | 50 Ω single-ended, series-terminated at the source. Stackup v3: L1/L6 188.0 µm, L4 102.5 µm | Matched within the bus ≤ 5 mm **UNVERIFIED**; slave SCLK ≤ 24.58 MHz | CS43198 Table 3-18; test pads BRD-040 | NC, DRC (width, layers), CHK |
| PCB-I-09 [Q1] | `MCLK_50SE` | 22.5792 / 24.576 MHz oscillators → attenuator → CS43198 XTI (two DACs) | 50 Ω stripline: an inner layer between two ground planes (L4 only, PCB-S-14), no change of reference; stackup v3 width 102.5 µm. No guard traces: a guard trace only if via-stitched along its length, and never counted as the protection | Oscillator to the split and the split to each XTI ≤ 20 mm per branch (the simulated limit case; a 30 mm branch gives 44.8 % duty, outside 45–55 %); ≥ 3 × trace width from any other signal; away from FILT± | ADR 0010; CS43198 §8 (keep clocks away from FILT±); G-06, IW-SR-05 (Hubing, LearnEMC); [`sim/mclk-attenuator`](../../sim/mclk-attenuator/README.md) results 2026-10-24 (typical oscillator drive; NDK drive **UNVERIFIED**) | NC, DRC (spacing, width, layers), CHK (branch length), SIM, REV (DRV-308) |
| PCB-I-10 [Q1] | `USB2_90D`, `USB3_90D`, `MIPI_100D` | SMD pads on those classes (AC capacitors, ESD parts, connector pads) | Reference plane voided under the pad, 100 % of the pad (stackup v3 §4.1: under an L1 pad the void is L2 only, so the pad references L3, 235 µm below; under an L6 pad the void is L5 only and L4 under the pad is a ground fill with no route, so the pad references L4, 235 µm above); equal via count on both members of a pair and across matched lanes | — | G-05; IW-HS-02, IW-HS-04: TI SPRACP4A §2.12–2.13; Rockchip HSPCB pp. 8–11 | DRC (keep-out on pads), CHK |
| PCB-I-11 [Q1] | Connector pin maps | Every connector carrying fast pairs (the HAT connector at both ends of the HAT link, FH35C) | Each pair has adjacent ground contacts (G-S-S-G or better); input to the HAT and faceplate interfaces | — | G-07; IW-HS-01 (Johnson, chapter **UNVERIFIED**); module rule M3 | interface files, REV (DRV-320) |
| PCB-I-12 [Q1] | — | Withdrawn ([RFC 0014](https://github.com/opendap-project/rfcs/blob/main/text/0014-hat-interface-v2-usb-only.md)): the HAT extension (`HAT_EXT_100D`) is removed | — | — | — | — |
| PCB-I-13 [Q1] | — | Withdrawn ([RFC 0014](https://github.com/opendap-project/rfcs/blob/main/text/0014-hat-interface-v2-usb-only.md)): the extension switches (TMUXHS4412) are removed | — | — | — | — |
| PCB-I-14 [Q1] | — (no impedance class) | HAT `CC`: from the HAT Type-C port controller (BOM line 41) through its ESD part (BOM line 69) to the HAT connector | Not controlled: a slow control line (attach, Type-C current, USB PD messages) | A guarded line: ground on both sides along its route, as the contact field places it (`CC` between two grounds, interface v2 §9.1), and spaced from the USB 3 pairs; its ESD part next to the HAT connector and rated for the highest `VBUS` on the port (interface v2 §5.3; RFC 0014, BOM line 69). Distances **UNVERIFIED** (no source retrieved; set at layout) | Hat-standard [interface v2](https://github.com/opendap-project/hats/blob/main/standard/docs/specs/interface-v2.md) §§5.3, 6.2, 9.1; [RFC 0014](https://github.com/opendap-project/rfcs/blob/main/text/0014-hat-interface-v2-usb-only.md) | REV, CHK |

## 6. Power and current

Widths are the IPC-2221 external/internal formula at ΔT = 10 °C (conservative, arithmetic: I = k·ΔT^0.44·A^0.725), as provisional minimums for the net classes; sign-off uses IPC-2152 at layout. Currents are the protection rating or the worst continuous case, whichever is higher (BRD-049).

Outer layers are taken at 35 µm finished (18 µm base plus plating, **UNVERIFIED** until the fab stackup) and inner layers at 18 µm, the HDI base copper [P3].

| ID | Path | Design current | Min width, outer (35 µm) | Min width, inner (18 µm) | Source | Enforced by |
|---|---|---|---|---|---|---|
| PCB-P-01 | Battery: battery contacts → fuse → BQ25798 BAT; P− contacts → sense resistor → GND | 5.0 A (fuse) | 2.8 mm or a pour | 14.0 mm, so a pour on two or more layers: stackup v3 gives the power zone two, L3 and L4 (PCB-P-23; v0.15) | BOM lines 43, 47, 104; ADR 0014, ADR 0020 | DRC (`PWR_BAT`), CHK (copper area per net) |
| PCB-P-02 | VSYS (6.0–8.8 V) trunk | 3.2 A worst continuous | 1.5 mm or a pour | 7.6 mm or a pour | Power tree §4.7, BOM §7 item 17 | DRC (`PWR_VSYS`), CHK |
| PCB-P-03 | VBUS → TPS2121 → BQ25798 | 3.0 A (TPS2121 ILM max) | 1.4 mm | 6.9 mm or a pour; none in the I/O zone (PCB-P-22) | Power tree line VBUS_CHG | DRC (`PWR_VBUS`) |
| PCB-P-04 | 5.1 V source: TPS62903 output to eFuse #D, #D to the eFuse #A and #C inputs, eFuse #C output (USB-C source) | 2.52 A (eFuse #D maximum trip with the RILM tolerance, BOM v1.14; v0.13, was 1.68 A) | 1.1 mm | 5.5 mm, or a pour | Power tree §4.6 and Changes in v0.8; IPC-2221 formula of this section at 2.52 A, ΔT = 10 °C: outer 1.08 mm (35 µm), inner 5.44 mm (18 µm) | DRC (`PWR_5V1`) |
| PCB-P-05 | Withdrawn ([RFC 0014](https://github.com/opendap-project/rfcs/blob/main/text/0014-hat-interface-v2-usb-only.md)): `HAT_3V3` and eFuse #B are removed; the HAT interface has no 3.3 V rail | — | — | — | — | — |
| PCB-P-20 [Q0] | HAT `VBUS` (board net `HAT_5V`) in both directions under USB PD: eFuse #A output (source path), the TPS2121 IN2 branch (sink path, from a source or dual-role HAT) and the HAT connector's `VBUS` contacts | 4.5 A (hats `standard/` interface v2 fault ceiling on `VBUS`; 3.0 A continuous). The T1's own trips stay inside it: eFuse #A maximum trip 1.981 A at RILM 1.87 kΩ (RFC 0014, BOM line 44); TPS2121 IN2 2.95 A maximum (BOM line 45) | 2.4 mm or a pour; in the I/O zone an outer pour on L1 (and L6 where free), no inner layer (PCB-P-22, v0.15) | 12.1 mm, so a pour on two or more layers, outside the I/O zone | IPC-2221 formula of this section at 4.5 A, ΔT = 10 °C, arithmetic: A = (I / (k·10^0.44))^(1/0.725); outer k = 0.048: A = 129.7 mil², ÷ 1.378 mil (35 µm) = 94.2 mil = 2.39 mm → 2.4 mm; inner k = 0.024: A = 337.5 mil², ÷ 0.709 mil (18 µm) = 476.3 mil = 12.10 mm → 12.1 mm. Hat-standard [interface v2](https://github.com/opendap-project/hats/blob/main/standard/docs/specs/interface-v2.md) §5.1, §5.3; [RFC 0014](https://github.com/opendap-project/rfcs/blob/main/text/0014-hat-interface-v2-usb-only.md); v0.12 (was 3.0 A, interface v1.1, 1.4 / 6.9 mm) | DRC (`PWR_HAT5V`) |
| PCB-P-21 [Q0] | HAT ground return: the HAT connector's `GND` contacts to the ground planes | 4.5 A (interface v2 `GND` power return, fault ceiling; 3.0 A continuous) | 2.4 mm or a pour (as PCB-P-20) | 12.1 mm or a pour (as PCB-P-20) | Hat-standard [interface v2](https://github.com/opendap-project/hats/blob/main/standard/docs/specs/interface-v2.md) §5.1; arithmetic as PCB-P-20 | REV, CHK (copper area and vias per contact; `GND` has no net class) |
| PCB-P-06 | Amplifier rails ±7 V / ±6 V | 0.3 A per rail (275 mA design case) | 0.3 mm (the current needs 0.06 mm; the width keeps the rail impedance low); tracks, not pours, under `AUDIO_ANALOG` (PCB-A-20, v0.15) | 0.3 mm | Power tree §4.10.1, ADR 0015 | DRC (`PWR_AMP`) |
| PCB-P-07 | Switching loops (BQ25798, TPS62136, TPS62827, TPS62903, TPS62870Z4, LMR33630C, TPS65131 boost half, RK809, TPS62840, TPS62826, TPS61160, RP2354A core regulator; v0.20: the list follows the board's switch nodes) | — | Input capacitor, switch node and inductor on one side, loop area per each datasheet layout example | — | Each part's datasheet layout section | REV; CHK: each converter's input and output capacitors and each IC's decoupling within a bound of the pins they serve, the placement build fails otherwise (`pcb/proximity.py`, placement v1 decision 14) |
| PCB-P-08 | Switch-node copper | — | Smallest area that carries the current; no other net under it on the adjacent layer except ground | — | Standard practice, datasheets | REV |
| PCB-P-09 | Vias per amp of plane change | — | ≥ 1 via (0.25 mm) per 0.5 A **UNVERIFIED**; for laser microvias per the fab's copper fill | — | Rule of thumb, to replace with an IPC-2152 via calculation | CHK |
| PCB-P-22 [Q0] | I/O zone: no inner layer carries power (L2, L3, L5 ground, L4 the fast layer), so HAT `VBUS` (`PWR_HAT5V`), USB-C `VBUS` (`PWR_VBUS`) and the 5.1 V source (`PWR_5V1`) run as outer pours there (trade 3) | as PCB-P-20, P-03, P-04 | ≥ 2.4 mm (`HAT_5V`), ≥ 1.4 mm (USB-C `VBUS`), ≥ 1.1 mm (5.1 V), on L1 (the I/O front is 20 % used in floorplan v1) and on L6 where the battery-contact window leaves room | — (no inner copper of these nets in the I/O zone; vias pass) | Maintainers' approval of stackup v3, 2026-10-25; [stackup v3](stackup-v3.md) §4.3; widths as PCB-P-20, P-03, P-04 | DRC (inner layers in `ZONE_IO`), CHK (copper area per net) |
| PCB-P-23 [Q0] | Power zone: the battery path and VSYS pour on the two inner pour layers L3 and L4, with L1 and L6 copper where the width asks for it; L2 and L5 stay ground under the switch nodes (PCB-P-08) (trade 4) | 5.0 A, 3.2 A (PCB-P-01, P-02) | as PCB-P-01, P-02 | pours on L3 and L4 (PCB-P-01's two or more inner layers) | Maintainers' approval of stackup v3, 2026-10-25; [stackup v3](stackup-v3.md) §4.3 | CHK (copper area per net), DRC (PCB-S-25 keeps L2 and L5 ground) |
| PCB-P-10 | Decoupling | — | Smallest capacitor closest to its pin with the shortest via path; for the RK3566 and LPDDR4X, Rockchip's placement under the package on the opposite side (with ADR 0016 the SoC is on the back, so its decoupling goes on the front, under the ball field, within PCB-Z-03); values per supply from the HDG | — | CS43198 §8; HDG (Rockchip HDG 1.1 and HSPCB 1.0) | REV; CHK: each converter's input and output capacitors and each IC's decoupling within a bound of the pins they serve, the placement build fails otherwise (`pcb/proximity.py`, placement v1 decision 14) |

Rules without a width:

| ID | Constraint | Source | Enforced by |
|---|---|---|---|
| PCB-P-12 [Q1] | A board frequency plan: every converter's frequency range and light-load mode (BQ25798, TPS62136, TPS62903 (v0.12: one, the HAT 3.3 V buck removed, RFC 0014), LMR33630C, TPS65131, RK809-5, RK860-0, TPS62840, TPS61160 (v0.10, BOM v1.11; was TPS61169)), the beats between any two, and the harmonics in 2.4 and 5 GHz; no beat in the audio band during playback | G-14; IW-SW-03; BOM line 116 | REV (DRV-112) |
| PCB-P-13 [Q1] | Light-load mode of every converter feeding audio. TPS65131: power-save disabled during playback if its pin allows (pin behaviour **UNVERIFIED**, SLVS493E). LMR33630C: no forced PWM, so its idle bursts are measured at the amplifier output (ADR 0015); if one falls in the audio band above the T1-048 warning, a minimum load on AUDIO_N7V0 (footprint reserved, DNP, value **UNVERIFIED**) or another part follows | G-15; IW-SW-04, IW-SW-05 | REV (DRV-113), V2 bench |
| PCB-P-14 [Q1] | The LMR33630C follows SNVA856B's inverting buck-boost layout, not the buck layout of its datasheet: the input capacitors from VIN to the −7 V IC ground form the hot loop and sit closest | G-16; IW-SW-01; TI SNVA856B (BOM line 116) | REV (DRV-207) |
| PCB-P-15 [Q0] | Insertion transients checked against the absolute maximum of every part on BAT, VSYS, VBUS and the HAT `VBUS` (`HAT_5V`, both directions), with ceramic input capacitors ringing up to twice the source voltage: battery 2 × 8.8 V = 17.6 V worst case (arithmetic), unless damped | G-17; IW-PI-04: LT AN-88 (**UNVERIFIED**, text not retrieved) | SIM, REV (DRV-109) |
| PCB-P-16 [Q0] | The 5 A board fuse's voltage rating and breaking capacity cover the 2S pack's short-circuit current, and the pack PCM's short-circuit trip acts first; pack current from the pack makers | G-18; IW-BA-04 (fuse makers' guides, **UNVERIFIED**); ADR 0014 | REV (DRV-110) |
| PCB-P-17 [Q0] | The six battery contacts (P+ ×2, P− ×2, mid-cell tap, NTC; ADR 0020) are safe in any mating order, a tilted pack included: series resistance or clamping on the mid-tap and NTC lines per the BQ28Z610-R1 and BQ25798 TS datasheets (**UNVERIFIED** until read) | G-19; IW-BA-03 | schematic, REV (DRV-108) |
| PCB-P-18 [Q0] | Every rail enable, amplifier enable, external-source enable and boot strap has a resistor default that keeps it off (or safe) while its driver is unpowered or in reset: `HPA_RAIL_EN`, `HPA_LDO_EN`, OPA1622 EN, `HAT5V_EN`, `USB_SRC_ON`, FP_3V3, the oscillator ST pins (extends PCB-A-13) | G-20; IW-SC-02; BOM line 35 | schematic, REV (DRV-104) |
| PCB-P-19 [Q0] | No back-powering: a table of every net crossing between separately powered domains (faceplate, HAT, DAC VL, coprocessor, radio) with the sequencing or isolation that keeps it inside the receiver's absolute maximum | G-21; IW-SC-03 | schematic, REV (DRV-105) |

### 6.1 Battery interface and heat placement (PCB-L)

Family L keeps the method's meaning, placement for safety around the battery and heat; from v0.9 it also holds the battery contact interface of [ADR 0020](../adr/0020-battery-connected-through-contacts.md) (rows L-04 to L-10). Contact order along the row, at 3.5 mm pitch: P+, P+, empty position, mid-cell tap, NTC, P−, P−.

| ID | Constraint | Source | Enforced by |
|---|---|---|---|
| PCB-L-01 [Q0] | No heat source (footprint field `Thermal` = `hot`) over the battery pocket: rule area `BATTERY_POCKET` = pocket footprint + 3 mm margin (**UNVERIFIED**, no cell-maker distance retrieved) | BRD-049; DFM §7 | DRC, REV (CHK-L-01) |
| PCB-L-02 [Q0] | Only battery nets (`PWR_BAT`: P+, P−; `BAT_SENSE`: mid-cell tap, NTC) and GND tracks and vias in the battery contact area (unfused copper), rule area `BATTERY_CONNECTOR` (geometry: PCB-L-05) | BRD-049; DFM §7 (partition rule, no external source); ADR 0020 | DRC |
| PCB-L-03 [Q2] | A device-level sustained power budget: the dissipation the body can shed at a surface-temperature target, against which the per-part thermal data and V4-03 are checked. ≈ 0.19 W/K (est.; arithmetic: h ≈ 10 W/m²·K × 0.0189 m² body surface), so 3 W → ≈ 16 K mean rise; surface target from the IEC 62368-1 touch-temperature table (**UNVERIFIED** value) | G-33; IW-TH-01: Incropera (coefficient range **UNVERIFIED**) | REV, V4-03 |
| PCB-L-04 [Q0] | Battery contact row in the pocket-floor window at the pocket's bottom end: seven positions at 3.5 mm pitch, order P+, P+, empty, mid-cell tap, NTC, P−, P−; six KYOCERA AVX 70-9258-001-120-006 on 7.00 × 2.70 mm pads; the empty position carries no copper (rule area `BATTERY_CONTACT_EMPTY`) | ADR 0020 item 2; drawing 70-9258-001-1X0-00XS Rev F sheet 2 | DRC (no copper at the empty position), CHK (pad size, pitch, order), REV |
| PCB-L-05 [Q0] | Rule area `BATTERY_CONNECTOR` is the contact window plus 1 mm; inside it only pads, tracks and vias of the battery nets and GND (pads with no net allowed); zone exception to PCB-Z-01 for the contacts (free height 3.3 mm) | PCB-L-02; ADR 0020 item 2; drawing sheet 2 | DRC (pads here, tracks and vias with PCB-L-02), CHK (3D height) |
| PCB-L-06 [Q0] | Board top to pack pad 2.1 mm nominal (1.5 mm component zone + 0.4 mm floor + 0.2 mm pad recess), inside the contact's 1.6–2.8 mm working range over the tolerance stack (± 0.3 mm assumed, **UNVERIFIED** until the case tolerance stack; input to the case: floor standoff, floor thickness, pack recess); ≥ 1.0 mm from any contact and its travel to the metal floor's window edge, which carries an insulating liner (**UNVERIFIED** distance, estimate) | ADR 0020 item 3; ADR 0016; drawing sheet 2 | REV (3D), case |
| PCB-L-07 [Q1] | Each pole's two contacts joined in a symmetric pour: equal copper length from each contact to the fuse (P+) or to the sense resistor (P−), so the sharing factor stays near the assumed 1.25 or below; ≥ 4 vias per contact pad to the pour (count **UNVERIFIED**, to replace by the IPC-2152 via calculation of PCB-P-09) | Equal-path pour for current sharing; PCB-P-01; ADR 0020 item 3 | CHK (via count per pad, length symmetry), REV |
| PCB-L-08 [Q1] | One TPD1E10B06 on each of the mid-cell tap and NTC lines, within 3 mm of the contact (**UNVERIFIED**, as PCB-E-01), ground at the pad (PCB-E-04); a TVS position on P+ at the contacts (standoff ≥ 9 V, clamp < 20 V), DNP until CB-07 and CB-10. Footprint field `ESD` = `battery` on the two diodes; rule area `BATTERY_ESD` = the contact pads grown by 3 mm | ADR 0020 item 6; BOM line 142 | DRC (warning: diode outside `BATTERY_ESD`), schematic, REV |
| PCB-L-09 [Q0] | BATP: 100 Ω in series at the pin and 47 nF to GND (SLUSDV2C pin table, Figure 8-2 note 2); test points on the pack side of the fuse and on BAT for the insertion measurement (CB-07) | ADR 0020 item 6; SLUSDV2C; PCB-P-15; BOM line 115 | schematic, REV |
| PCB-L-10 [Q2] | Cover detect (should): one input with a pull-up and a TPD1E10B06, a contact pad at the board edge for the case's actuator; the GPIO is chosen in the pinout | ADR 0020 item 7; BOM line 143 | schematic, REV |

## 7. Audio partition and grounding

| ID | Constraint | Source | Enforced by |
|---|---|---|---|
| PCB-A-01 | One ground. No split planes; the analog section is partitioned by placement, and return currents of digital and switching circuits never cross it | CS43198: GNDA, GNDCP and GNDD meet in a common ground area under the chip (DS1156F2 Table 1-1, p. 7) | REV |
| PCB-A-02 | DAC exposed pad to ground through a via array to inner ground planes | CS43198 §8.4, p. 121 | REV |
| PCB-A-03 | REFA and REFB routed independently to each headphone connector's ground pin | CS43198 §8, p. 121 | NC (separate nets), REV |
| PCB-A-04 | FILT+ capacitor short to VA, FILT− to −VA; VCP_FILT± capacitors short to GNDCP | CS43198 §8, p. 121 | REV |
| PCB-A-05 | VA and VCP from independent clean supplies; VL and VD may share the logic supply | CS43198 §8, p. 121 | schematic, REV |
| PCB-A-06 | Distance from any switch node or inductor to the DAC analog pins, FILT±, the OPA1622 inputs and the headphone traces | ≥ 5 mm target, **UNVERIFIED** until the power and audio test board | DRC (courtyard area rule) |
| PCB-A-07 | No digital or switching trace on any layer under the analog section's area (DAC analog side, amplifiers, output network, jack traces) | Partition rule; ADR 0012 output stage | DRC (keep-out area) |
| PCB-A-08 | OPA1622 thermal pad to V−, per TI example layout DRC0010J | OPA1622 sheet (SBOS727B pp. 34–35) | REV |
| PCB-A-09 | Paralleled OPA1622 halves: symmetric layout of the two halves and their output resistors per leg | ADR 0012 (current sharing measured 53/47 % in `sim/output-stage`) | REV, SIM |
| PCB-A-10 | Left/right and leg symmetry of the headphone paths: equal length and topology | T1-050 (identical left/right), ADR 0012 | CHK |
| PCB-A-11 | Jack detect lines kept away from the audio paths and ESD-protected at the jack | BRD-052 | REV |
| PCB-A-12 | I2S/DSD test pads on the DAC side, stub ≤ 1 mm, passive (no series parts) | BRD-040, BRD-041 | REV |
| PCB-A-14 [Q1] | Each OPA1622's rail decoupling capacitors return to the output stage's power ground point, not to the difference-amplifier reference resistors' ground (BOM line 37) and not to the CS43198 REF nets | G-08; IW-GA-04 (Self); ADR 0015 (rail current a rectified sine, 433 mA peak) | REV (DRV-208) |
| PCB-A-15 [Q1] | Amplifier rail traces and headphone load-current paths do not run parallel to, or under, the difference-amplifier input and feedback traces; separation **UNVERIFIED** (set at the M-AUD layout, checked by V2 THD+N at full output) | G-09; IW-GA-05 (Self, induction distortion) | REV (DRV-208) |
| PCB-A-16 [Q1] | One reference point per single-ended output through the whole chain: the single-ended difference amplifiers' reference resistors return to the same 3.5 mm jack ground sense as REFA/REFB (PCB-A-03), or the schematic states why not | G-10; IW-GA-06; BOM lines 19, 37 | schematic, REV (DRV-114) |
| PCB-A-17 [Q2] | Copper resistance of any return shared by both channels between the reference point and the 3.5 mm sleeve pin ≤ 5 mΩ, **UNVERIFIED** target (arithmetic: 5 mΩ / 16 Ω → −70 dB crosstalk from the board alone), to align with a T1-048 crosstalk threshold | G-11; IW-GA-06 (Self, chapter **UNVERIFIED**) | CHK (copper resistance), REV (DRV-313) |
| PCB-A-18 [Q2] | The ground current between USB-C and the headphone jacks (USB DAC mode to a computer, T1-054) runs in a defined path along the bottom edge, outside the DAC and amplifier reference region; the USB-C shield termination is decided in the schematic | G-12; IW-GA-07 (Putzeys, Ott); V4-06 | REV (DRV-214) |
| PCB-A-19 [Q2] | RF filter footprints at each headphone output near the jack: a series element (ferrite or 0 Ω) and a shunt capacitor to the jack ground, DNP by default; the OPA1622 with its 1 Ω ballast checked stable with the shunt fitted. Values **UNVERIFIED** (simulation for stability, V4-01 with the radio transmitting) | G-13; IW-GA-08: TI SBOA128; IW-ES-04 | REV (DRV-116), SIM |
| PCB-A-20 [Q1] | Under `AUDIO_ANALOG` there is no audio power layer: the audio rails (`PWR_AMP`, `PWR_AUDIO`) run as tracks (PCB-P-06) on L1, L4 or L6; L2, L3 and L5 stay ground (PCB-S-25); L4 carries only the zone's analog, reference, MCLK and DAC serial-port nets and the audio rails; no inner layer carries a pour of any net but ground (v0.15, trade 5; was: L4 the audio power layer, stackup v2). The partition (PCB-A-01, A-07) is unchanged | [stackup v3](stackup-v3.md) §4.6; partition rule as PCB-A-07; maintainers' approval of stackup v3, 2026-10-25 | DRC (inner pours), PCB-A-07 (tracks) |

## 8. RF, protection, test and assembly

| ID | Constraint | Source | Enforced by |
|---|---|---|---|
| PCB-R-01 | Radio module land, ground and keep-out per Murata's Type 2EL hardware application note E2B-09-1413 Rev. 9.0 and footprint drawing; the datasheet (supply ranges, sequencing, keep-out under the module) is still **UNVERIFIED** (Murata's link refused) | BRD-025; LBES5PL2EL-923 sheet | DRC (keep-out from the footprint), REV |
| PCB-R-02 | Both antenna paths as Murata's copy: ANT0 (pin 15) and ANT1 (pin 23), each with a U.FL in the top band near the top wall and 0603 matching positions, the 10 pF link from pin 18 to pin 23 (shared configuration, fitted) and the dedicated-configuration positions (DNP), so either configuration needs no respin | E2B-09-1413 §3.5.1; [ADR 0018](../adr/0018-antennas-and-certification-route.md) items 2, 4 | REV |
| PCB-R-03 [Q1] | RF trace: a copy of Murata's U.FL layout. 50 Ω microstrip over a solid ground 230–240 µm below it (inner-plane cut-outs in the HDI stack, never over a change of dielectric or ground), width within ±0.25 mm of Murata's, 7–25 mm long; ≥ 0.8 mm copper keep-out under the U.FL. Stackup v3: 235 µm (L1→L3, L6→L4), width 391 µm (Murata's rule W = 1.8 × H gives 423 µm, within ±0.25 mm); rule area `RF_CUTOUT` marks the L2 (L5) void and the L3 (L4) pour | E2B-09-1413 §3.5.1 p. 15; CER-0248 §2.1.6.2 pp. 31–33 | DRC (rule area `RF_CUTOUT`: no copper in the L2/L5 cut-out, only GND on the L3/L4 pour; keep-out area), REV |
| PCB-R-04 [Q2] | Antenna: Molex 146153-0050 (on Murata's FCC, ISED and Japan lists), shared by Wi-Fi and Bluetooth; prototypes may use any available antenna that fits (RFC 0011 §4); each certified variant carries the TX-power table and the SAR report of its grant (T1-075, T1-077) | [ADR 0018](../adr/0018-antennas-and-certification-route.md); CER-0248 Tables 20, 36, 56 | REV |
| PCB-R-05 [Q2] | Antenna feeds and radiators at the board edges or in the top band, away from the body-facing surface and from HAT metal; the distance is fixed by the SAR pre-assessment | T1 compliance requirements (T1-071 to T1-086) | REV |
| PCB-R-06 [Q2] | Antennas, U.FL feeds and RF traces kept away from the USB 3 routes, the HAT connector and the HAT flat cable; the cable's fast pairs have ground on both sides of the flex. Distance **UNVERIFIED** (from the M-RF and M-HAT modules, V3-05, V3-07 with the radio on) | G-22; IW-RF-02: Intel USB 3 white paper | DRC (keep-out), REV (DRV-216) |
| PCB-R-07 [Q2] | Input to the case: the antenna on the inside of the top wall (≈ 60.1 × 14.2 mm area with 1.2 mm walls), its radiating element ≥ 5 mm from any metal (battery, metal pocket floor, microSD shell, screw inserts, display frame, HAT metal), the zone uncoated; 5 mm is **UNVERIFIED** until the prototype's measurement | [ADR 0018](../adr/0018-antennas-and-certification-route.md) items 4, 5; G-23 | case interface, V5-01 |
| PCB-R-08 [Q1] | Every radiator, antenna feed and tuning part lives in the main body (board and case core), never in the faceplate; the faceplate interface carries no RF. Antenna zones in order of preference: the core's top wall and upper side walls, the board's top edge; the back cover only as a flagged last resort (HAT cases replace it and HAT metal detunes it) | BRD-061; ADR 0018 (anodised-aluminium note) | REV |
| PCB-R-09 [Q1] | Case-antenna feed option on ANT0: after Murata's copied line (PCB-R-03, unchanged), one series position on a pad shared by the U.FL direction and the case-antenna branch, so the unfitted direction is an open at the pad, not a trace stub; whether Murata accepts the shared junction for the Class I documentation is **UNVERIFIED** | BRD-061, BRD-053; ADR 0018 (anodised-aluminium note) | REV |
| PCB-R-10 [Q1] | Case-antenna branch: 50 Ω line from the junction to an ENIG spring-contact feed pad at the board's top edge near the top wall, with a series DC-block position, a pi matching network of three 0603 positions, a shunt-inductor position to ground at the pad (ESD DC path and tuning) and a low-capacitance ESD diode position (≤ 0.2 pF at 2.5–6 GHz, IEC 61000-4-2 ±8 kV contact or better; for example Infineon ESD904-B1-W0201, 0.1 pF); values set on the metal-core prototype (**UNVERIFIED**) | BRD-061, BRD-007, PCB-E-01; ADR 0018 (anodised-aluminium note) | REV, CHK (ESD position at the pad) |
| PCB-R-11 [Q1] | Case-ground contact pads (ENIG, spring contacts) at both top corners and on the left and right board edges in the top band, plus the four mounting bosses on GND (PCB-H-03); each pad to the ground plane through its own vias at the pad (≥ 2, count **UNVERIFIED**), its ESD current returned locally and never through the audio reference region (PCB-E-04, PCB-E-05) | BRD-061, BRD-007; ADR 0018 (anodised-aluminium note) item 4 | REV (DRV-316) |
| PCB-R-12 [Q1] | Antenna-path assembly variants (BRD-053): every position of PCB-R-09 to R-11 carries its variant: *polymer* (U.FL and 146153 fitted, branch DNP), *metal with end cap* (as polymer, matching retuned), *metal frame* (branch fitted, U.FL DNP); the variant data names the fitted path so Blackbird OS loads its calibration and the variant's SAR-capped TX-power table | BRD-053, BRD-061; [ADR 0018](../adr/0018-antennas-and-certification-route.md) item 6; ADR 0018 (anodised-aluminium note) | CHK (BOM variant fields) |
| PCB-R-13 [Q2] | No metal part (microSD shell, shield frame, screw insert) between the feed and ground contact pads and the top wall, and the ≥ 5 mm provisional keep-out of PCB-R-07 applied to a case antenna's radiating part; 5 mm is **UNVERIFIED** until the metal-core prototype is measured | BRD-061; [ADR 0018](../adr/0018-antennas-and-certification-route.md) item 5; ADR 0018 (anodised-aluminium note) item 5 | REV, V5-01 |
| PCB-EMC-01 [Q1] | Common-mode filter positions (0 Ω fitted by default) on the USB-C USB 2 pair, the faceplate DSI and the HAT high-speed entry, placed per each class's signal-integrity rules | T1 compliance requirements (T1-071 to T1-086); BRD-053 | REV |
| PCB-EMC-02 [Q1] | Ferrite positions on the HAT `VBUS` (`HAT_5V`) and the faceplate supplies at their connectors | T1 compliance requirements (T1-071 to T1-086) | REV |
| PCB-EMC-03 [Q1] | Shield-can frame footprints (DNP first) around the switching converters near the radio, besides PCB-T-06; the headphone-stage frame was withdrawn on 2026-10-28 (maintainer decision for board area, placement v1 decision 16: most of the stage is on the front, where PCB-Z-03 allows no can) | T1 compliance requirements (T1-071 to T1-086) | REV |
| PCB-E-01 | ESD protection at every external connector (USB-C, jacks, the HAT connector, faceplate FH35C, microSD), placed between the connector and everything else, ≤ 3 mm from the connector pins **UNVERIFIED** | BRD-007; BOM ESD lines | CHK (distance), REV |
| PCB-E-02 | USB-C VBUS: TVS2200 at the connector, TPS2121 next | Power tree (VBUS surge note) | REV |
| PCB-E-03 | HAT `VBUS` behind a limiter in each direction: eFuse #A out, TPS2121 IN2 in (interface v2 §5.3; RFC 0014) | BRD-026 | schematic |
| PCB-E-04 [Q1] | Each connector shell and each ESD diode (TVS) ground pad reaches the ground plane through its own vias directly at the pad, at least two (count **UNVERIFIED** for the TVS); no stub on the protected line; no ESD return shares a path with an audio ground return. Merges gap G-25 | T1 compliance requirements (T1-071 to T1-086); G-25, IW-ES-01: TI SLVA680A | REV (DRV-316) |
| PCB-E-05 [Q2] | An ESD return region at the bottom edge: each TVS at USB-C and the jacks grounds into a locally stitched ground at the connector; no analog reference sense (REFA/REFB, gain-network references) and no clock in that region. Size **UNVERIFIED** (set at placement, checked by V4-05) | G-24; IW-ES-02 (Ott); IEC 61000-4-2 (about 30 A first peak at 8 kV contact, **UNVERIFIED** text) | DRC (keep-out area), REV (DRV-213) |
| PCB-P-11 [Q3] | The HAT `VBUS` source (`HAT_5V`) and the USB-C source output each have a second, independent limiter (fuse or PTC) so the available power after 3 s stays ≤ 15 W with the eFuse shorted (IEC 62368-1 PS1) | T1 compliance requirements (T1-071 to T1-086) | schematic, V4-12 |
| PCB-A-13 [Q1] | Amplifier enables and the DAC reset default to off at power-up and reset (hardware pull), so no output is driven before the OS sets a level (T1-049, T1-072) | T1 compliance requirements (T1-071 to T1-086) | schematic, REV |
| PCB-S-09 [Q3] | Laminate and solder mask flammability V-0, with recognition evidence from the fab | IEC 62368-1 clause 6; T1 compliance requirements (T1-071 to T1-086) | fab notes |
| PCB-T-07 [Q2] | Every BOM line carries its RoHS and REACH status and a supplier declaration reference (T1-082) | T1 compliance requirements (T1-071 to T1-086) | CHK (BOM fields) |
| PCB-T-01 | UART test pads for BootROM / TPL / SPL | BRD-047 | REV |
| PCB-T-02 | A test pad on every regulated rail and on VSYS, VSYS_LV, VBAT | Bring-up | CHK (one pad per power net) |
| PCB-T-03 | SWD pads for the RP2354A | BRD-015 | REV |
| PCB-T-04 | Assembly variants: every optional part has its variant field, DNP parts keep their footprint | BRD-053, ADR 0013 | CHK (BOM fields) |
| PCB-T-05 | Every part has Manufacturer and MPN fields | `fab-package` check | CHK |
| PCB-T-06 | Shielding-can frames (DNP first) around the SoC/DDR and the radio, with a 0.5 mm frame keep-out **UNVERIFIED** | BOM line 90, §7.7 | DRC (keep-out), REV |
| PCB-T-08 [Q1] | A rail isolation link at every converter and LDO output (0201 or 0402 0 Ω, or a solder jumper), fitted on prototypes, so each rail can be brought up alone; one per regulated rail in the power tree | G-26; IW-BU-01 (Ganssle) | CHK (one link per rail), REV (DRV-119) |
| PCB-T-09 [Q1] | Test points on SoC reset, PMIC power-on, sleep and interrupt, the MaskROM window (`WINDOW_N`), boot-mode nets, the coprocessor's RUN and BOOTSEL (QSPI_SS); one spare SoC GPIO and one spare RP2354A GPIO on pads | G-27; IW-BU-02, IW-BU-04 (Ganssle) | CHK, REV (DRV-119) |
| PCB-T-10 [Q1] | Scope ground points next to each converter cluster, the audio section and the clocks, sized for a probe ground spring (pad size **UNVERIFIED**) | G-28; IW-BU-03, IW-PI-05 (AN-47) | REV (DRV-220) |
| PCB-T-11 [Q1] | Board revision in copper on an inner or outer layer, besides the EEPROM (BOM line 17) | G-29; IW-PD-05 | REV (DRV-403) |
| PCB-T-12 [Q1] | Rework keep-out around the RK3566, LPDDR4X and eMMC (distance in PCB-D-01); the decoupling under them on the opposite side (ADR 0016) recorded as an accepted rework cost | G-30; IW-DF-06: IPC-7095 (**UNVERIFIED** value) | DRC (PCB-D-01), REV (DRV-218) |

### 8.1 Assembly (PCB-D)

Objects are found by naming conventions (fiducials `FID*`, test points `TP*`, field `Rework` = `BGA`), listed in the [rules README](../../hardware/rules/README.md); CHK-D-08 checks they are followed.

| ID | Constraint | Min | Target | Max | Source | Enforced by |
|---|---|---|---|---|---|---|
| PCB-D-01 [Q1] | Rework clearance around a BGA (`Rework` = `BGA`), courtyard to courtyard | 2 mm | 2 mm | — | **UNVERIFIED** (IPC-7095 and nozzle data not retrieved) | DRC, CHK (CHK-D-04, tall parts) |
| PCB-D-02 [Q1] | Fiducial size, round | 1.0 mm | 1.0 mm | 3.0 mm | LCSC fiducial guide [LC] (secondary) | DRC |
| PCB-D-03 [Q1] | Fiducial clear area: nothing within 1.0 mm of the dot | 1.0 mm | 1.0 mm (3 mm window) | — | [LC] | DRC |
| PCB-D-04 [Q2] | Fiducial to board edge | 3.85 mm | 3.85 mm | — | [LC]; not binding on panelised builds | DRC |
| PCB-D-05 [Q2] | Silkscreen to board edge | 0.3 mm | 0.3 mm | — | **UNVERIFIED** (no fab publishes one); the craft standard's 0.5 mm (CRAFT-08, Q2) is a CHK item | DRC |
| PCB-D-06 [Q2] | Test pad size, by net | 0.8 mm on signal nets, 1.0 mm on power and ground nets | 1.0–1.27 mm signal, 1.5–2.0 mm power | — | [JD] (secondary; absolute minimums 0.8 mm on signal nets and 1.0 mm on power or ground nets, read 2026-10-27) | DRC (0.8 mm), CHK (1.0 mm on power and ground) |
| PCB-D-07 [Q2] | Test pad spacing (2.54 mm pitch, 1.0 mm pads, edge to edge, arithmetic) | 1.54 mm | 1.54 mm | — | [JD] | DRC |
| PCB-D-08 [Q2] | Test pad to other parts' pads | 1.0 mm | 1.0 mm | — | [JD]; to bodies: CHK-D-05 | DRC |
| PCB-D-09 [Q2] | Test pad to board edge | 3.8 mm | 3.8 mm | — | [JD] | DRC |
| PCB-D-10 [Q1] | Open via hole to an SMD pad; a filled and capped via (IPC-4761 type VII) may sit in the pad | 0.2 mm | 0.2 mm | — | The fab [P11, P16] (process); distance **UNVERIFIED** | DRC |
| PCB-D-11 [Q1] | Test-pad side | Either side, within the zone of the pad's net | — | — | [ADR 0027](../adr/0027-flying-probe-test-for-prototypes-and-first-runs.md): flying probe for prototypes and first runs reaches both sides (2026-10-28; the front only until then, for a single-sided fixture) | Placement tool (`plan.TEST_PAD_SIDES`), REV |

## 9. Open items

1. **Front-side height (PCB-Z-03):** decided by [ADR 0016](../adr/0016-front-side-height-under-the-display.md). Still open from its study: package heights of the RK3566, LPDDR4X and eMMC; the back bands at 104–123 % of their area with today's tall parts (4020 inductors, haptic motor, microSD socket); the microSD socket fits neither the top band nor the zone under the battery. Both go to placement.
2. **Rockchip documents** retrieved (part 1). Still missing: the RK3566 edition of the high-speed guide, RK3566 DDR templates, package pin lengths, a land pattern (Rockchip publishes none: the footprint is drawn from the package drawing and checked by a second reading) and IBIS models. LPDDR4X needs 1.10 V (VDD2) besides 0.60 V (VDDQ) at the SoC: check against the power tree.
3. **Murata Type 2EL:** application note, footprint and certification note retrieved (the USB, PCIe and MIPI D-PHY specifications); the datasheet is still missing. Findings for the power tree and the product: the module needs a 1.8 V power rail (AVDD18, 323–390 mA typical in Bluetooth/802.15.4 transmit, peaks above 1 A on the carrier datasheet) besides 3.3 V; the US and Canada modular approvals cover mobile use at ≥ 20 cm only, so the handheld T1 needs SAR and a permissive change through Murata; the Molex 146187 antenna is on Japan's list only (with a ≥ 50 mm cable).
4. **Standards** (the USB, PCIe and MIPI D-PHY specifications): USB 2.0 and USB 3.2 texts retrieved (USB 2.0 allows ±15 %, the board keeps the fab's ±10 %; USB 3 AC caps 75–265 nF); PCIe and MIPI from vendor guides only (member-only specs); the eMMC 5.1 text and SD SDR104 timing are still missing.
5. **Case inputs**: walls (1.2 mm, decided), bosses, clearances, the speaker shelf's clearance and the pocket reliefs (PCB-M-02, PCB-M-08, PCB-Z-06 to Z-09) through the [t1 case and main board interface](../../../product/docs/specs/case-board-interface.md).
6. **The fab**: HDI stackup, microvia land, shielding frames, fiducial practice.
7. **DFM values** ([`hardware/rules/README.md`](../../hardware/rules/README.md#review-and-script-items-chk)): the screw, washer and hole (PCB-H-01 to H-06), copper and parts at break tabs and edges (PCB-B-01, B-02), BGA rework clearance (PCB-D-01, T-12), the open-via distance (PCB-D-10), silk to edge (PCB-D-05), the battery pocket margin (PCB-L-01). Its CHK and REV items carry what DRC cannot check (thermal spokes and uncoupled length wait for libs' `kicad/` `check_drc.py` to read KiCad's unnamed messages).
8. **Industry-wisdom values:** stitching fence pitch (PCB-S-13), rail-to-input separation (PCB-A-15), shared-return resistance (PCB-A-17), headphone RF filter values (PCB-A-19), TPS65131 power-save pin and the AUDIO_N7V0 minimum load (PCB-P-13), mating-order clamping (PCB-P-17), antenna distances (PCB-R-06, R-07, R-13) and the case-antenna matching values (PCB-R-10), the ESD region (PCB-E-05) and TVS via count (PCB-E-04), probe pad size (PCB-T-10), the touch-temperature target (PCB-L-03).
9. **MCLK** (PCB-I-09): the 20 mm branch limit holds with a typical CMOS oscillator drive; with the weakest drive NDK's catalogue allows, no passive values pass ([`sim/mclk-attenuator`](../../sim/mclk-attenuator/README.md)). The NSC5083D output drive and symmetry from NDK, or a measurement on the first boards, close it.
10. **Battery contacts (v0.9, ADR 0020):** KYOCERA AVX product specification 201-01-252 (contact force, resistance, current-rating basis) before the board freezes; the case tolerance stack that holds 2.1 ± 0.3 mm (PCB-L-06) and the liner distance; the via count per contact pad (PCB-L-07); the ESD distance (PCB-L-08, with PCB-E-01); whether the P+ TVS is fitted (CB-07, CB-10); the cover-detect GPIO (PCB-L-10, pinout).
11. **Withdrawn ([RFC 0014](https://github.com/opendap-project/rfcs/blob/main/text/0014-hat-interface-v2-usb-only.md), v0.12):** the HAT extension and its switch are removed. The HAT link's signal integrity (USB 3 Gen 1 and USB 2.0 through the HAT connector and the cable) is the hats `standard/` coupon's open question.
12. **Stackup v3 (v0.15), its debt by level** ([stackup v3](stackup-v3.md) §7; replaces the stackup v2 item of v0.14): the fab confirms the stack, the 0.43 mm core as dielectric thickness, Dk at frequency, the 25 µm on L2/L5, the 0.10 mm laser in 120 µm of 2116 (aspect 1.2) on the first level, the thickness tolerance at 1.046 mm and the removal of non-functional pads (Q0); the core-rail PDN impedance with the 90 µm pairing, the shared L2 plane and the L1 feeds (Q1, PCB-S-12, S-20: PDN simulation at layout; screened 2026-10-28: the placed decoupling holds every core rail under target from about 0.5 MHz to 11.8–21.4 MHz, the package above it, and the 0.2–0.5 MHz excursions of vdd_cpu at 4.8 A, vdd_gpu, vdd_npu and vcc_ddr fall in the converters' control range, [stackup v3](stackup-v3.md) §7); coupons for every impedance class, measured (Q1); the USB 3 loss budget at these widths (Q1; it decides PCB-S-06); the core zone's routing capacity on L4 and L6 at the v3 widths and the 3 × W LPDDR4X spacing (Q1, placement, PCB-S-22); zone-local stitching and fence pitch (Q2, PCB-S-13, S-19); heat spreading under the SoC (Q2, PCB-S-23); the U.FL keep-out depth and trace width from Murata's layout file (Q1, PCB-R-03). Until the DFM review every width, gap and spacing rule is a DRC warning. In DRC: the maximum pair gap and KiCad's `diff_pair_gap` wait for libs' `kicad/` `check_drc.py` to read KiCad's unnamed messages (the minimum is checked as a clearance). PCB-S-14 allows no `MCLK_50SE` track on L1/L6, so the oscillator and XTI pads reach L4 through stacked microvias (L6–L5–L4).
13. **Floorplan v1 (v0.14)** ([floorplan v1](floorplan-v1.md) §6): band capacity in the core and power zones, the 4.4 mm jack's pocket relief, PCB-L-01 against ADR 0016 (hot parts under the pocket), the faceplate connection area, the mounting holes, the zone net classes in the schematic, the DF40C-50DS footprint.
