opendap-project/t1/board/docs/specs/power-tree-v0.md

# Power tree v0

- **Version:** v0.12 (2026-10-28), with BOM v1.22: the display INA236 at 0x49 (§4.12) and the backlight inductor XFL3012-223MEC ([BOM v1.22](bom-v1.md#changes-in-v122) items 1, 4). v0.11 (2026-10-28), with BOM v1.21: [Changes in v0.11](#changes-in-v011). v0.10 (2026-10-28) is the state of BOM v1.18. v0.9 (2026-10-27) is the state of BOM v1.17. v0.8 is the state of BOM v1.14. v0.7 is the state of BOM v1.13, v0.6 is the state of BOM v1.12, v0.5 is the state of BOM v1.11, v0.4 of BOM v1.10, v0.3 of BOM v1.9, v0.2 the state of BOM v1.8, v0.1 of BOM v1.7.
- **Status:** Draft. Desk design only: nothing here has been built or measured. Simulated (updated 2026-10-24): the amplifier rails ([output-stage simulation](../../sim/output-stage/README.md)), the VSYS bucks and the MaskROM entry ([VSYS buck and MaskROM simulations](../../sim/README.md)); netlists in `sim/`. Every part is *Proposed* unless [BOM v1](bom-v1.md) says *Decided*. Updated 2026-10-22 by the BOM v1 cross-validation (battery, HAT/USB 5 V source, TPS2121 isolation, faceplate rails, IO voltages, vdd_cpu part), then by BOM v1.1 (RK809-5 feeds and ratings, TPS61089 boost, 3.1 V MCLK supply, RP2354A supplies, battery derating, TPS2121 OV1, HP-amp soft-start), then by BOM v1.2 (power margin check of every rail, converter, connector and cable, BRD-049, §4.10; vcc3v3_sys on a 3 A TPS62826; battery path sized for the full output budget, BRD-050 and proposed ADR 0011; battery fuse; 50-contact HAT power connector; RGB status LED driver; TPS61089 and TPS2121 current limits), then by BOM v1.3 ([ADR 0012](../adr/0012-headphone-output-stage.md): six OPA1622 with paralleled halves, ±6 V amplifier rails on LT3045/LT3094 from ±7 V TPS65131 pre-rails, gain 1.62 with the CS43198 at `+1dB_EN` = 0, §4.1, §4.2, §4.10.1; interim-pack output ceiling, §4.11; vcc3v3_sys inductor, §4.10), then by BOM v1.4 (HAT pogo power contacts fixed by the hats `standard/` HAT interface v1, §4.10; no power part changes), then updated by BOM v1.5 / [ADR 0014](../adr/0014-two-cell-battery.md) (two-cell battery: BQ25798 charger, VSYS 6.0–8.8 V, TPS62136 pre-regulator to a 3.8 V VSYS_LV rail feeding the former 1S tree, TPS62903 bucks for HAT_5V/USB-C and HAT_3V3, BQ28Z610-R1 gauge, 5 A fuse, Micro-Fit 3.0 connector; full output budget ≈ 2.4 A at VSYS 6.6 V, battery path sized for the ≈ 3.2 A worst case; interim ceiling removed; finding 14, §2, §3, §4.6, §4.7, §4.9–§4.11). Then updated by BOM v1.6 / [ADR 0015](../adr/0015-amplifier-rails-from-vsys.md) (−7 V pre-rail from an LMR33630C inverting buck-boost on VSYS, TPS65131 boost only, paired LT3045/LT3094; ship FET; MaskROM supervisor; TPS62136 inductor correction; §2, §3, §4.7, §4.10, §4.10.1, §5, §6).
- **Date:** 2026-10-22 (v0.2 to v0.5: 2026-10-24; v0.6 to v0.8: 2026-10-25)
- **Companion:** [BOM v1](bom-v1.md) (parts, datasheet links and hashes).
- **Inputs:** [BOM v0](bom-v0.md), ADR 0012, [board requirements](../requirements/README.md) (BRD-001 to BRD-050), board ADRs 0001–0015 (from v0.4 also [ADR 0020](../adr/0020-battery-connected-through-contacts.md); from v0.6 [ADR 0021](../adr/0021-vdd-cpu-buck-ti-tps62869.md) and [ADR 0022](../adr/0022-lpddr4x-micron-mt53e1g32d2fw-with-cxmt-second-source.md)), [output-stage simulation](../../sim/output-stage/README.md) and [VSYS buck and MaskROM simulations](../../sim/README.md) (v1.6), ADR 0014 (v1.5), touch-faceplate ADR 0001 (Focus E35GH), T1 and HAT Case Standard requirements, blackbird-os ADRs 0006–0008. Pin multiplexing v0 gave the balls until v0.2; from v0.3 [pinout v1](pinout-v1.md) does (§3.1). GPIO names below are net names.
- **Method:** datasheets were downloaded and read (revision and sha256 in the BOM's Datasheets table); the RK809 rail mapping follows the Radxa ROCK 3C v1.4 schematic (PMIC marked RK809-5) and the mainline device trees of RK3566 + RK809 boards (Orange Pi 3B, ROCK 3C, ODROID-M1S), with Anbernic RG353 (RK817) and the Radxa ZERO 3W schematic v1.12 for the rest. Calculations are shown inline.
- **Conventions:** **UNVERIFIED** = no primary source found in this session. "Est." = engineering estimate, to be replaced by measurement (T1-026).

## Changes in v0.11

1. **HAT contact rows on interface v2 (§4.10):** the DF40C-100 and interface v1 pogo rows give way to the DF40C-50 (`VBUS` ×15, `GND` ×15) and the interface v2 pogo field (`VBUS` ×4, return ×4), with the margins of hats `standard/` interface v2 §5.1. The HAT input stays at the TPS2121's 2.95 A, so the board keeps the DF40C-50: at that trip a DF40 rail still needs 15 contacts under BRD-049's 70 % rule (maintainer decision 2026-10-28; the 40-position part would need the HAT sink capped near 2 A in hardware, which would cut charging from a source HAT from about 15 W to about 10 W).
2. **Always-on group (§4.13):** the PN7160 VDD(PAD) term leaves the vcca1v8_pmu budget and the tree diagram with the reader (v0.10); the allowance it shared with the NFC tag is kept.

## Changes in v0.10

1. **NFC_VBAT withdrawn (maintainer decision 2026-10-27, reason: board area; BOM v1.18 item 7, [feature blocks](feature-blocks.md) #42):** the NFC reader (PN7160) leaves the board in every model, with its rail: the TPS22916C on VSYS_LV, measurement link #18 and the `NFC_PWR_EN` gate (expander P05, now a spare). Five TPS22916C remain (DAC_VP, DAC_DIG_1V8, RP_3V3, RP_IOVDD_1V8, vcc3v3_wl). VSYS_LV loses its 0.29 A maximum NFC load, so the coincident-peak risk of §8 item 16 keeps only the system and radio peaks; vcca1v8_pmu loses the PN7160 VDD(PAD) (≤ 2 mA, est.). The NFC tag stays on vcca1v8_pmu. The rows below that name the reader, NFC_VBAT or link #18 are kept as the record of v0.2 to v0.9 and marked withdrawn.
2. **vdd_cpu: TPS62870Z4WRXSR with XEL4012-920NEC ([ADR 0026](../adr/0026-vdd-cpu-buck-ti-tps62870z4.md), BOM v1.18 item 8):** ±1 % over TJ −40–125 °C, differential remote sense, 3 MHz, 0.875 V start-up, I2C0 0x42; range capped at 1.10 V in the device tree (BRD-049) until the bring-up check of ADR 0026 item 7. Output 45.7 µF effective at 1.1 V; a 4.8 A release (80 % of 6 A) peaks at 1.149 V. Limiter trip 16.6 A worst case = 69 % of the inductor's 24 A. Quiescent 1.75 mA typical while enabled (4 µA before): ≈ 6.7 mW from VSYS_LV in playback and in suspend (vdd_cpu stays on; the TPS62870 keeps its registers with EN low, so a later revision can gate it). The rows below follow.

## Changes in v0.9

1. **Load switches (BOM v1.17 item 3, line 50):** the six TPS22919 (DAC_VP, DAC_DIG_1V8, RP_3V3, RP_IOVDD_1V8, NFC_VBAT, vcc3v3_wl) become the TPS22916C (WCSP-4), the BOM's named second source. Rating 2 A (was 1.5 A); RON 70 mΩ typical at 3.6 V, 100 mΩ at 1.8 V (SLVSDO5F §6.5); turn-on 1700 µs at 3.6 V and 3000 µs at 1.8 V, rise 900 µs and 1400 µs (§6.6; the TPS22919 took 1750 µs and 1500 µs, SLVSEN5B §6.6); quick output discharge 150 Ω, fixed (the TPS22919's QOD pin tied to VOUT gave 24 Ω): fall time about 2.2 × 150 Ω × CL, 3150 µs at 10 µF (§6.6). Reverse-current blocking is always on; the TPS22919's output current limit is not in this part. Sequencing kept: CS43198 VP first on and last off (VP and the digital supply both discharge through 150 Ω; the driver orders them); RP2354A VREG_VIN and VREG_AVDD still ramp together on RP_3V3; the Type 2EL supply rise (900 µs at 3.6 V) is inside the carrier's 40 µs to 100 ms window. Driver delays (`startup-delay-us`, off time before a power cycle) follow these figures.

## Changes in v0.8

With [BOM v1.14](bom-v1.md#changes-in-v114) and [RFC 0015](https://github.com/opendap-project/rfcs/blob/main/text/0015-hat-connector-pogo-field-and-usb-c-port-hat.md): the HAT connector is the pogo field (hats `standard/` ADR 0001 confirmed; Mill-Max 0965 primary). Nothing here is built or measured.

1. **Shared 5.1 V limiter, eFuse #D (§2, §4.6; closes §8 item 29).** A third TPS259470A sits between the TPS62903 5.1 V buck and the inputs of eFuses #A (HAT `VBUS`) and #C (USB-C source), **RILM 1.47 kΩ 1 %**:

   | Corner | RILM | Equation 7 (SLVSFC9C) | ±10 % | Trip |
   |---|---|---|---|---|
   | Minimum | 1.4847 kΩ (+1 %) | 2.246 A | −10 % | **2.021 A** |
   | Typical | 1.470 kΩ | 2.268 A | — | **2.268 A** |
   | Maximum | 1.4553 kΩ (−1 %) | 2.291 A | +10 % | **2.520 A** |

   | Fault case (BRD-049) | Limited by | Buck current | Of the 3 A rating | Of the 4.0 A minimum high-side limit |
   |---|---|---|---|---|
   | Normal, full budget | software (1.6 A design) | 1.6 A | 53 % | 40 % |
   | One port shorted or overloaded, the other idle | its eFuse, #A or #C (≤ 1.981 A, below #D's 2.021 A minimum) | ≤ 1.981 A | 66 % | 50 % |
   | One port overloaded, the other loaded | #D, or the overloaded port's eFuse | ≤ 2.520 A | 84 % | 63 % |
   | Both ports at their maximum trip (software fault) | #D | ≤ 2.520 A | **84 %** (was 3.96 A, 132 %) | 63 % |
   | #D failed short, one port at its maximum | #A or #C | ≤ 1.981 A | 66 % | 50 % |
   | #D failed short and both ports at their maximum (two independent faults) | the buck's high-side limit | ≤ 3.96 A | 132 % | 99 % |

   Every single-fault case stays at or below 84 % of the buck's rating. Inductor peak in the worst single fault: 2.520 + 0.535 = 3.06 A, 35 % of the XGL4020-102MEC's 8.8 A Isat. #D: switch 2.520 A = 46 % of 5.5 A; conduction 28.3 mΩ × 1.6² = 72 mW at the design load, 180 mW at its maximum trip. The added drop at 1.5 A is 42 mV (RON 28.3 mΩ), so a port sees 5.1 − 2 × 0.042 = 5.02 V nominal at 1.5 A, inside vSafe5V (4.75–5.5 V). EN from the buck's output (UVLO divider); fault on expander P16 (`EFUSE_5V_FLT_N`); IMON to a test pad. The fast trips of #D (2 × ILIM) and of #A and #C coordinate on the bench (V2-P04).
2. **5 V only from a HAT (§4.7; closes §8 item 30).** The HAT `VBUS` input path is rated for 5 V: TVS0500 5 V stand-off and 7.5 V minimum breakdown (SLVSED2C §7.4, §7.6), FUSB302B `CC` 6.0 V absolute maximum (FUSB302B/D Rev. 5 p. 14), TPD4E05U06 5.5 V stand-off (SLVSBO7O). The HAT port controller's sink capabilities list vSafe5V only. **TPS2121 OV2 divider R1 464 kΩ / R2 100 kΩ (1 %):** VTRIP = VREF × (1 + R1/R2) = 1.06 × 5.64 = 5.98 V typ, **5.60–6.31 V** over VREF 1.01–1.1 V and the resistor tolerance (the OV1 method): above the 5.5 V vSafe5V maximum, 84 % of the TVS's minimum breakdown at its maximum. The `HAT_SRC_ON` force on OV2 stays (hardware OR, as on OV1). A `CC`-to-`VBUS` short at vSafe5V reaches at most 5.5 V, 92 % of the `CC` absolute maximum.
3. **HAT connector (§4.10):** the pogo field on the device-side piece through one DF40C-50 per cable end (BOM lines 66, 67, 102; HAT flat cable spec v1). `VBUS` on 4 pogo contacts (0.75 A each at 3.0 A, 38 %; 75 % at the 4.5 A ceiling with one open) and 15 DF40 contacts (0.20 A, 67 %; 100 % at 4.5 A); at the T1's own trips 44 % out and 66 % in on the DF40. The `VBUS` TVS sits on the device-side piece at the field.

## Changes in v0.7

With [BOM v1.13](bom-v1.md#changes-in-v113): HATs are USB only and HAT power follows USB Power Delivery (hats `standard/` [interface v2](https://github.com/opendap-project/hats/blob/main/standard/docs/specs/interface-v2.md) and [ADR 0006](https://github.com/opendap-project/hats/blob/main/standard/docs/adr/0006-hats-are-usb-only.md); [RFC 0014](https://github.com/opendap-project/rfcs/blob/main/text/0014-hat-interface-v2-usb-only.md)). The HAT port carries one power net, `VBUS` (the board net keeps the name `HAT_5V`): 3.0 A continuous, 4.5 A fault ceiling (interface v2). The physical HAT connector is still open, so the contact and flat-cable rows of §4.10 stay as they were and follow that decision. Nothing here is built or measured.

1. **HAT_3V3 removed (§2, §3, §4.6, §5, §6.4, §6.5):** the TPS62903 3.3 V buck (BOM line 38), its inductor (line 7) and eFuse #B go. Nothing on the board used HAT_3V3 besides the HAT branch (PCA9306 VREF2 and the AXC B side, both removed). The full output budget loses its 3.67 W HAT_3V3 term (§4.7): 8.77 + 3.26 = **12.0 W → 1.82 A at VSYS 6.6 V**, ≈ 16.9 W → 2.56 A with full-scale headphones (was 15.7 W / 2.38 A and 20.6 W / 3.1 A). The battery chain keeps its 3.2 A design point (ADR 0014); every element gains margin.
2. **HAT `VBUS` source (§4.6):** eFuse #A from the 5.1 V buck, enabled by `HAT5V_EN` (expander P02), which the port controller's TCPM source path drives as the `vbus-supply` regulator of the HAT `usb-c-connector`. The offer is 5 V at 1.5 A, shared with the USB-C source as before (one 5.1 V converter, 1.6 A design).
3. **eFuse trip setting (§4.6, BRD-049).** At RILM 2.21 kΩ 1 % the minimum trip was 3,334 / 2,232 Ω = 1.494 A − 10 % = **1.344 A** (SLVSFC9C Equation 7, ±10 % above 1 A), below the 1.5 A both 5 V ports offer: a compliant sink drawing its full 1.5 A could trip the eFuse. **RILM → 1.87 kΩ 1 % on #A and #C:**

   | Corner | RILM | Equation 7 | ±10 % | Trip |
   |---|---|---|---|---|
   | Minimum | 1.8887 kΩ (+1 %) | 1.765 A | −10 % | **1.589 A** |
   | Typical | 1.870 kΩ | 1.783 A | — | **1.783 A** |
   | Maximum | 1.8513 kΩ (−1 %) | 1.801 A | +10 % | **1.981 A** |

   | Check | Rating or limit (source) | Value | Use | Result |
   |---|---|---|---|---|
   | 1.5 A offer against the minimum trip, #A and #C | 1.589 A | 1.5 A | 94 % | OK (was 112 % of 1.344 A) |
   | #A maximum trip against the HAT `VBUS` fault ceiling | 4.5 A (interface v2) | 1.981 A | 44 % | OK |
   | #A maximum trip against the HAT `VBUS` continuous rating | 3.0 A (interface v2) | 1.981 A | 66 % | OK |
   | #C maximum trip against the USB-C receptacle | 5.00 A for the VBUS pins together (GCT USB4105 drawing) | 1.981 A | 40 % | OK |
   | eFuse switch | 5.5 A (SLVSFC9C, title) | 1.981 A | 36 % | OK |
   | 5.1 V buck with both eFuses at their maximum trip (a software fault: the budget is 1.6 A) | 3 A rating; high-side limit 4.0 / 4.6 / 5.5 A (SLVSES3A §6.5) | 3.96 A | 132 % of the rating, 99 % of the minimum limit | Bounded by the eFuses below the buck's minimum limit; a sustained double fault runs the buck above its rating (was 3.36 A, 112 %), a thermal check for the board model (§8 item 29) |
   | 5.1 V buck inductor XGL4020-102MEC | Isat 8.8 A (30 % drop) | 3.96 A + ΔIL / 2 = 4.5 A | 51 % | OK |

   Datasheet cross-check: the 1.65 kΩ row gives 1.800 / 2.028 / 2.200 A (SLVSFC9C §6.5), consistent with Equation 7 and ±10 %. Conduction loss at the typical trip: 28.3 mΩ × 1.783² = 90 mW.
4. **HAT `VBUS` sink (§4.6, §4.7):** a source or dual-role HAT (a powerbank) feeds the T1 through TPS2121 IN2, as before; ILM 1.94 / 2.45 / 2.95 A (RILM 45.3 kΩ 0.1 %, v0.5): the maximum is 66 % of the 4.5 A fault ceiling and 98 % of the 3.0 A continuous rating. The HAT port's PD sink offer stays 5 V until the maintainers decide which PD voltages the T1 accepts from a HAT (§8 item 30): above 5 V the OV2 threshold, the `VBUS` TVS and the `CC` protection follow, as on the main USB-C.
5. **Dual-role power through the existing mux.** IN1 (main USB-C) keeps priority over IN2 (HAT). The T1 never sources and sinks the HAT port at once: `HAT_SRC_ON` (= `HAT5V_EN`) forces OV2 high while eFuse #A is on, in hardware, as in v0.5. A power-role swap goes through TCPM: it first drops one direction (eFuse #A off, or the sink contract released so the HAT turns its `VBUS` off), then enables the other; the interlock holds at every step. With a USB-C adapter present and a powerbank HAT attached, the T1 may charge the HAT (source role, IN2 off) or leave it idle; it never feeds the adapter's power back through IN2. eFuse #A blocks reverse current while it is off (SLVSFC9C: true reverse current blocking), so a source HAT's `VBUS` never reaches the 5.1 V buck.
6. **Dead battery.** With the T1 unpowered, the HAT port controller presents its sink pull-down on `CC` (FUSB302B/D Rev. 5 p. 1, "dead battery support"; VUFPDB ≤ 2.18 V, p. 15), so a source HAT can turn on `VBUS`, which reaches the charger through TPS2121 IN2 (enabled by default, §5).
7. **`VBUS` discharge on detach.** SLVSFC9C describes no output discharge for the TPS25947, so the HAT `VBUS` gets a discharge path: an N-FET (the line 35 DMG1012T-7) with a series resistor to GND, gate on expander P01 `HAT_VBUS_DISCH` (freed by `HAT3V3_EN`) with a pull-down, driven by Blackbird OS through TCPM after the source turns off. The resistor value, sized for the USB PD discharge time with the port's capacitance, is **UNVERIFIED** until the schematic.
8. **Measurement:** eFuse #A IMON stays on SARADC_VIN2; SARADC_VIN3 (was #B) takes eFuse #C IMON (closes pinout v1 C10). The INA236 HAT channel at the 5.1 V buck input still sees #A and #C together.
9. **Camera PHY rails (§5):** RK809 LDO1 (`vdda0v9_image`) and LDO9 (`vcca1v8_image`) have no consumer: the CSI-2 receiver is unused (pinout v1 O2 decides the unused-PHY handling). They stay off. The PCIe PHY has no HAT consumer either; the USB 3 PHY (combphy1, HOST1) feeds the HAT port.

## Changes in v0.6

With [BOM v1.12](bom-v1.md#changes-in-v112): [ADR 0021](../adr/0021-vdd-cpu-buck-ti-tps62869.md) (vdd_cpu buck TI TPS62869 instead of the RK860-0) and [ADR 0022](../adr/0022-lpddr4x-micron-mt53e1g32d2fw-with-cxmt-second-source.md) (LPDDR4X Micron MT53E1G32D2FW-046 IT:C, CXMT second source), both Accepted. The HAT flat-cable and faceplate-flex changes of BOM v1.12 move no rail. Nothing here is built or measured; no requirement priority or status changes.

1. **vdd_cpu (§2, §3):** TPS6286910C on VSYS_LV, 0.85–1.15 V in 5 mV steps by I2C DVS at **0x42** (I2C0), 0.9 V at boot without software, 6 A rating against the 3 A design estimate. EN from vcc3v3_pmu through 51 kΩ + 100 nF.
2. **Margins (§4.10, BRD-049):** converter 50 % of 6 A; VIN 69 % of the 5.5 V recommended maximum (63 % of 6 V); inductor peak 3.76 A = 54 % of the 7 A minimum high-side limit (ΔIL 1.52 A at 1.15 V out, 3.8 V in, 0.22 µH, 2.4 MHz); XGL4012-221MEC saturation 86 % (20 % drop) and 59 % (30 % drop) at the 8.5 A maximum limiter trip, heating 28 % of Irms; output 0.833–1.173 V (± 2 %) inside the RK3566's 0.81 V minimum and 1.2 V absolute maximum (27 mV of headroom at the 1150 mV ceiling). The "Open: datasheet from Rockchip" row is closed.
3. **Measurement link 1 (§4.12):** the H5 link on vdd_cpu sits inside the VOS sense loop, so its 15 mV drop is regulated out; it returns only with the 0 Ω local-sense fallback (0.818 V at the 850 mV point, still ≥ 0.81 V).
4. **Sequencing (§6.1):** vdd_cpu follows vcc3v3_pmu through the EN RC, as HDG 1.1 p. 34 orders; that it is up before RESETn is a first-boards check.
5. **Suspend (§6.5):** vdd_cpu stays on (EN low resets the converter's registers; the driver has no suspend operations); the cost is to measure.
6. **LPDDR4X windows (§4.8):** from the Micron data sheet, VDD1 1.70–1.95 V, VDD2 1.06–1.17 V, VDDQ 0.57–0.65 V. vcc_ddr (1.083–1.143 V) keeps 23 mV and 27 mV to the VDD2 limits, vcc0v6_ddr (0.591–0.609 V) 21 mV and 41 mV to the VDDQ limits, vcc1v8_ddr (1.79 V nominal at 100 mA) 90 mV and 160 mV to the VDD1 limits. No rail changes; the currents stay placeholders until the IDD tables are transcribed (§8 item 28).
7. **Risks 10 and 12 (§9):** the vdd_cpu converter rating is published; the RK3566 vdd_cpu peak current stays **UNVERIFIED**.

## Changes in v0.5

With [BOM v1.11](bom-v1.md#changes-in-v111): hats `standard/` [HAT interface v1.1](https://github.com/opendap-project/hats/blob/main/standard/docs/specs/interface-v1.md) and its [ADR 0005](https://github.com/opendap-project/hats/blob/main/standard/docs/adr/0005-interface-v1-1-shared-extension-and-contact-reduction.md), and the board changes of the t1 [faceplate interface v1](../../../product/docs/specs/faceplate-interface.md) §10 (t1 ADRs 0004, 0005). Nothing here is built or measured; no requirement priority or status changes.

1. **HAT fault ceilings (§4.6):** the interface ceilings become `HAT_5V` 3.0 A, `HAT_3V3` 1.5 A, `GND` 4.5 A (were 3.6 / 1.8 / 5.4 A). The T1's limiters, tolerance and resistor included: eFuse #A (`HAT_5V` out) **1.68 A** (56 %), TPS2121 (`HAT_5V` in, class F) **2.95 A** (98 %) after RILM 44.2 → **45.3 kΩ 0.1 %** (at 44.2 kΩ 1 % it reached 3.02 A), eFuse #B (`HAT_3V3`) **1.16 A** (77 %), `GND` 2.95 + 1.16 = 4.11 A (91 %).
2. **Charger input (§4.7):** with the TPS2121 minimum at 1.94 A, the BQ25798 IINDPM becomes **1.9 A** at VBUS ≤ 5.5 V (≈ 1.86 A at most, est.), so the mux never current-limits in normal charging; 9 V PD stays at 1.67 A. 5 V charging input drops from 10 W to 9.5 W.
3. **HAT power connector (§4.6, §4.10):** the DF40C-50 power pair is removed; power runs on the single DF40C-100 (`HAT_5V` × 10, `HAT_3V3` × 5, `GND` × 15): 67 % continuous, 100 % at the interface ceilings, at most 98 % at the T1's own trips. Flat-cable power conductors are sized for the ceilings (BOM line 102).
4. **HAT extension switch (§2, §3, §5):** two TMUXHS4412 on vcc3v3_sys, 320 µA typical each while an L3 HAT is active (≈ 2.1 mW for both, 3.3 V × 0.64 mA), 0.1 µA in standby; standby (PD high) is the reset and suspend state through a pull-up, so nothing changes in the suspend budget.
5. **Faceplate rails (§2, §3, §5; t1 ADR 0005):** FP_3V3 from a **TPS22950** at 0.22–0.38 A (≤ 0.4 A ceiling); FP_1V8, MIC_1V8 and FP_VCI each from a **TPS22945** at 100–200 mA (≤ 0.2 A ceiling; limit at 1.8 V and 2.8 V **UNVERIFIED**). FP_VCI's switch sits between RK809 LDO4 and the connector, ON from `FP_IO_EN`, because the RK809 datasheet states no LDO4 trip value and the RK809-5's OTP start-up state of LDO4 is unknown. The TPS22945 has no output discharge and no reverse blocking (SLVS832D §9.1.3): 10 kΩ discharge resistors, and each switch opens before its source rail goes down (FP_VCI before LDO4; FP_1V8 and MIC_1V8 before vcc_1v8 in suspend).
6. **Backlight (§4.5):** **TPS61160** (open-LED threshold 25–27 V) instead of the TPS61169 (36–39 V), so BL_LEDA stays ≤ 27 V in every state against the FH35C's 30 V; RSET 3.32 Ω; inductor 22 µH.
7. **Naming:** "faceplate interface v0" is now "faceplate interface v1"; no rail or contact moves.

## Changes in v0.4

[ADR 0020](../adr/0020-battery-connected-through-contacts.md) (Accepted: battery connected through contacts), with [BOM v1.10](bom-v1.md#changes-in-v110). Nothing here is built or measured; no rail, regulator or requirement status changes.

1. **Battery connection (finding 20; §2, §4.7, §4.10):** the 4-pin Micro-Fit 3.0 and the pack lead are replaced by six KYOCERA AVX 70-9258-001-120-006 spring contacts in a window of the pocket floor, pressing on recessed hard-gold pads of the pack's terminal board. Order at 3.5 mm pitch: P+, P+, empty position, mid-cell tap, NTC, P−, P−.
2. **BRD-049 margins re-checked through the contacts (§4.7.1):** worst continuous 3.2 A puts 2.0 A on the hotter contact, **33 %** of its 6 A; the 5 A protective limit 3.1 A, **52 %**; the full budget (2.4 A) 1.5 A, 25 %. Heat at an end-of-life resistance of 20 mΩ per contact (**UNVERIFIED**): 0.08 W on the hotter contact and ≈ 0.26 W in the four power contacts at 3.2 A; 0.19 W and ≈ 0.63 W at 5 A, for the PCM's trip time only.
3. **Path resistance (§4.7):** ≈ 65 mΩ with the contacts at end of life (est., was ≈ 38–48 mΩ): ≈ 0.21 V and ≈ 0.66 W at 3.2 A. The cell pair must hold ≈ 6.8 V under load for VSYS = 6.6 V (was ≈ 6.7 V).
4. **Insertion (§4.7.1):** BATP gets 47 nF to GND behind its 100 Ω (SLUSDV2C Figure 8-2 note 2; BOM line 115); with no adapter the ship FET is off at insertion and is the soft start; with an adapter present the pulse into the BAT node (≈ 63 A peak for ≈ 2 µs, est.) is 0.07 % of the fuse's melting I²t.
5. **Cover detect (should, BOM line 143):** one GPIO input with a pull-up; no rail or regulator change. The pull-up value is set at schematic capture against the suspend budget (100 kΩ at 1.8 V draws 18 µA while a closed cover grounds the input, arithmetic). Captured (2026-10-26): GPIO0_A6 is on PMUIO1 at 3.3 V, so 100 kΩ to vcc3v3_pmu draws 33 µA with the cover closed (arithmetic), and keeps VIH (2.0 V, RK3566 DS 1.1 Table 3-3) with up to 13 µA of input leakage.

## Changes in v0.3

[ADR 0019](../adr/0019-master-clock-divided-from-twice-the-frequency.md), the power-tree items of [pinout v1](pinout-v1.md) §9.2 (B1–B5, B16) and three decisions taken on 2026-10-24, with [BOM v1.9](bom-v1.md#changes-in-v19). Nothing here is built or measured.

1. **New rail MCLK_1V8** (ADR 0019, finding 18): a third TPS7A2018 from AUDIO_2V2, EN = DAC_DIG_1V8, ≈ 8.9 mA for two SN74AUC1G74 dividers; MCLK_3V1 now feeds the 45.1584 / 49.152 MHz oscillators only, without the attenuator (§2, §3, §4.4, §4.9, §4.10, §4.12, §5, §6.2, §6.3).
2. **vcc3v3_sys on a TPS62827** (finding 19): the re-sum gives ≈ 2.45 A (est.) = 82 % of the TPS62826's 3 A, past 80 %; the pin-compatible 4 A part runs at 61 % (§2, §3, §4.10).
3. **Radio in suspend for item tracking** (decision 2026-10-24; BRD-030, T1-069): vcc3v3_wl moves from RK809 SWOUT1 to a TPS22919 from vcc3v3_sys, ON = expander P06 `WL_PWR_EN`; vcc1v8_wl follows it. Default off in suspend, on only while the listener enables tracking; then vcc_1v8 also stays on in suspend. Suspend draw **UNVERIFIED** until measured on M-RF (§2, §3, §4.10, §5, §6.5).
4. **Faceplate supply in suspend** (decision 2026-10-24; T1-060; pinout B5): FP_3V3 and FP_1V8 off by default; `FP_IO_EN` on expander P00 can keep FP_3V3 on (§3, §5, §6.5).
5. **802.15.4** (decision 2026-10-24; T1-077): the four SPI2 M0 balls stay unassigned spares reserved for a variant; no power change.
6. **Pinout v1:** `vccio6_1v8` row (B1); IO-domain table §3.1 (B2); `HAT3V3_EN` on expander P01 (B3); USB PHY 3.3 V supplies (B16, **UNVERIFIED**); HAT ID translator and AXC B side on HAT_3V3 (B14); every "to reconcile with pinout v1" note of v0.2 holds (pinout v1 §9.1) except `HAT3V3_EN`.
7. **Measurement:** link 36 at the MCLK_1V8 LDO input (§4.12).

## Changes in v0.2

[ADR 0017](../adr/0017-fuel-gauge-wiring-sense-resistor-and-configuration.md) (Accepted), with [BOM v1.8](bom-v1.md#changes-in-v18). nothing here is built or measured. IO-domain voltages assumed here are marked "to reconcile with pinout v1".

1. **New rail vcc1v8_wl** (Type 2EL AVDD18, finding 16): a TPS62826 from VSYS_LV, EN on vcc3v3_wl, 390 mA typical, 1.05 A peak (§2, §3, §4.10).
2. **New rail vcc1v8_ddr** (LPDDR4X VDD1 and the TPS7A1006 BIAS) on vcca1v8_pmu, which stays on in suspend (finding 15, §4.8); vcc_1v8 no longer feeds anything the memory needs in self-refresh.
3. **VDD2 checked:** vcc_ddr 1.113 V nominal (BUCK3, 47 kΩ / 120 kΩ), ≈ 1.08–1.14 V worst case (§4.8).
4. **New rail NFC_VBAT** (PN7160 VBAT and VDD(UP)) from VSYS_LV through a TPS22919, 290 mA maximum (finding 17).
5. **Always-on 1.8 V group on vcca1v8_pmu** (G1, G5, G6, G15, G16, G19): IMU, TPM, NFC tag, PN7160 VDD(PAD), board EEPROM, expander VCCI, I2C2 pull-ups; budget ≈ 160 mA (est., §4.13).
6. **Interlocks** (G2, G3, G14): the CS43198 control bus closes only while DAC_DIG_1V8 is up; MCLK_3V1 EN = `AUDIO_LN_EN` AND DAC_DIG_1V8; `PCIE_PERST#` = SoC PERST# AND HAT power-good (§5, §6.4).
7. **Measurement** (G10–G12): 35 block measurement links and five INA236 positions (§4.12).
8. **Margins re-checked** (§4.10): VSYS_LV 53 % continuous, the TPS62136 switch at 81 % of its minimum limit only when three estimated peaks coincide; vcc3v3_sys peak ≈ 2.35 A = 78 % (est.).
9. **Fuel gauge ([ADR 0017](../adr/0017-fuel-gauge-wiring-sense-resistor-and-configuration.md)):** PACK on the switched side of the ship FET, sense resistor 3 mΩ, storage through gauge SHUTDOWN and the charger's shutdown mode: board drain ≈ 1 µA typical, 4.7 µA maximum (§2, §3, §4.7, §4.10, §6.1).

## 1. Findings that change earlier drafts

1. **The CS43198 does not accept a 45.1584 or 49.152 MHz master clock.** Its datasheet (DS1156F2, §4.6 and Table 3-13) allows an external MCLK only at the nominal internal frequencies **22.5792 MHz and 24.576 MHz** (or PLL references 9.6–26 MHz). BRD-023 (Draft) and BOM v0 lines 9–10 name 45.1584/49.152 MHz. Proposal: **22.5792 MHz and 24.576 MHz NDK NZ2520SDA**, which keeps the intent of BRD-023 (two families, DAC as clock master, no resampling). A divide-by-two flip-flop would also work but adds a part and jitter in the clock path, against BRD-042. **v0.3: superseded by finding 18** ([ADR 0019](../adr/0019-master-clock-divided-from-twice-the-frequency.md)): the divider is adopted because only it guarantees the DAC's 45–55 % duty.
2. **The CS43198 also needs a battery-class supply, VP = 3.0–5.25 V** (charge-pump supply for its output stage), plus four 1.8 V rails (VA, VCP, VD, VL). VP must come up first and go down last (DS1156F2 §5.2).
3. **The MCLK input is in the 1.8 V VL domain.** No available audio-grade 1.8 V oscillator exists at 22.5792 MHz (the 1.8 V NSC5083A has no authorized source), so the 3.3 V NSC5083D runs on its own MCLK_3V3 LDO and reaches XTI through a passive attenuator (ADR 0010). v0.3: the attenuator is removed; XTI is driven by 1.8 V dividers (finding 18).
4. **The LM27762 cannot make ±5 V from a 1S battery.** Its positive output is an LDO from VIN, so at VSYS = 3.5 V the positive rail is at most about 3.45 V (calculation in §4.2). The proposed generator is a **TPS65131** dual boost/inverter followed by **TPS7A4901 / TPS7A3001** LDOs (v1.3: **LT3045 / LT3094**, ADR 0012).
5. **The TPS7A94 is unsuitable for a battery device here:** 15 mA typical ground current at 5.1 V out (SBVS336C, Electrical Characteristics), that is about 80 mW wasted.
6. **The RK809-5 must be used with the reference rail mapping.** Its regulators come up at OTP default voltages before Linux runs. The mapping below copies the Radxa ROCK 3C v1.4 schematic (RK809-5) and the mainline device trees of the ROCK 3C, Orange Pi 3B and ODROID-M1S, which agree: every VCC pin of the reference boards is on a free-running vcc3v3_sys (the ROCK 3C leaves the EXT_EN option on its 3.3 V buck unfitted). The T1 keeps VCC5–VCC9 on vcc3v3_sys, now always-on, and feeds VCC1–VCC4 (BUCK1–4) from VSYS as in the datasheet application circuit (Fig. 1-1). Supply-pin mapping (RK809 datasheet §2.5): VCC1–VCC4 → BUCK1–4, VCC5 → LDO1–3, VCC6 → LDO4–6, VCC7 → LDO7–9, VCC9 → BUCK5 and SWOUT1, VCC8 → SWOUT2. The RK809-5 OTP defaults are not public (**UNVERIFIED**). v1.5: VCC1–VCC4 move from VSYS to VSYS_LV (3.8 V, finding 14).
7. **LPDDR4X needs a separate 0.6 V VDDQ rail.** The Radxa ZERO 3W schematic table gives VDDQ 1.10 V and VDDQL 0.60 V for LPDDR4X, with a 0 Ω option (R122) that ties VCC0V6_DDR to VCC_DDR only for plain LPDDR4.
8. **The battery path is limited to 1.6 A continuous with the interim pack** (v1.1 derating). The pack is the Adafruit 328 (ADR 0007): its sheet allows ≤ 2C discharge, but JST rates the PH contact 2 A with AWG #24 wire only, and the pack leads are 26 AWG. VSYS on battery is budgeted at 1.6 A (≈ 5.6 W at 3.5 V), and from v1.2 a 2.5 A board fuse bounds it (§4.7). The board itself is sized for the full output budget, 4.8 A from the battery (BRD-050, proposed ADR 0011); no available pack that carries it has been found yet. **v1.5: superseded by finding 14** (2S, ADR 0014): the Adafruit 328 is no longer a T1 pack.
9. **The BQ25895 cannot supply OTG while it charges.** The draft fed HAT_5V and the USB-C source from the OTG boost, so a class A/B HAT lost 5 V whenever USB-C power was plugged in. HAT_5V and USB-C VBUS out now come from a **TPS61089 boost from VSYS** (5.1 V) behind eFuses #A and #C (v1.1: the TPS61088 has no ti.com product page or datasheet any more). v1.5: the BQ25798 has the same OTG limitation; with a 2S VSYS the 5.1 V source becomes a **TPS62903 buck** (finding 14).
10. **The T1's own 5 V must not re-enter the charger.** When the T1 sources USB-C VBUS, that VBUS is also TPS2121 IN1; when it sources HAT_5V, that net is IN2. Both OV inputs are forced high by hardware OR of the source enables (`USB_SRC_ON`, `HAT_SRC_ON`), not by software order.
11. **IO voltages follow the pin plan:** I2C0/1/2 on PMUIO2 at 1.8 V (the CS43198 control port shares the bank and is 1.8 V-only); the faceplate bank VCCIO5 at 3.3 V.
12. **MCLK at 3.1 V** (ADR 0010, supply part amended in BOM v1.1): MCLK_3V1 from VSYS through a TPS7A2031. On battery VSYS follows VBAT below VSYSMIN, so a 3.3 V LDO had 0.2 V or less of headroom; 3.1 V stays inside the NSC5083D 2.97–3.63 V supply range with ≥ 0.3 V headroom down to 3.4 V. The oscillator current below is the NZ2520SDA figure. v1.5: the TPS7A2031 input is VSYS_LV, a fixed 3.8 V (finding 14): 0.7 V headroom at all battery states.
13. **Debian already enables the INA236 current monitor** through the IIO `ina2xx-adc` driver (`CONFIG_INA2XX_ADC=m`, compatible `ti,ina236`), while the hwmon INA2xx/INA238 drivers are off. The instrumentation uses INA236.
14. **v1.5, [ADR 0014](../adr/0014-two-cell-battery.md): the T1 runs on a two-cell series pack.** ADR 0014 sets the tree: a **TI BQ25798** buck-boost charger makes VSYS = 6.0–8.8 V; a **TPS62136** pre-regulator makes **VSYS_LV = 3.8 V** and feeds every part the 1S tree fed from VSYS, unchanged (all are rated ≤ 5.5 V, the TPS62840 6.5 V); two **TPS62903** bucks make HAT_5V / USB-C source (5.1 V) and HAT_3V3 from VSYS; a **BQ28Z610-R1** gauges the pack, which carries its own protection and balancing; a **5 A** fuse and a **Molex Micro-Fit 3.0** 4-pin connector (P+, P−, mid-cell tap, NTC) carry the battery path. The full output budget draws ≈ 2.4 A at VSYS 6.6 V instead of 4.8 A at 3.3 V, ≈ 3.2 A with full-scale headphones on top; the battery path is sized for 3.2 A (§4.7). The pack is quoted (a T1-038 exception); bring-up runs on a bench supply.

15. **v0.2: the LPDDR4X VDD1 and the VDDQ LDO bias were on a rail that is off in suspend.** The rail table put VDD1 (1.8 V) and the TPS7A1006 BIAS on vcc_1v8 (BUCK5), which the reference device trees turn off in suspend (`regulator-off-in-suspend` in `rk3566-rock-3c.dts`), while §6.5 keeps vcc_ddr and vcc0v6_ddr up for self-refresh. Every RK3566 reference keeps the DRAM 1.8 V always on: ZERO 3W v1.12 ties VCC1V8_DDR to VCCA1V8_PMU through 0 Ω (R123), Quartz64-A v2.0 through 0.1 Ω (R3807), ROCK 3C v1.4 feeds it from a dedicated LDO enabled by VCC3V3_PMU. The T1 follows the ZERO 3W (§4.8).
16. **v0.2: the Type 2EL needs a 1.8 V power rail.** AVDD18 draws 323–390 mA typical in Bluetooth and 802.15.4 transmit (Murata E2B-09-1413 Tables 20–21) and both module rails can exceed 1 A at start-up calibration (EA M.2 PA4, a carrier). It gets its own buck (vcc1v8_wl) so radio bursts stay off vcc_1v8, which feeds the DAC digital switch.
17. **v0.2: the PN7160 cannot sit on the battery path.** Its VBAT is 2.8–5.5 V in reader mode with a 6 V absolute maximum (PN7160/PN7161 data sheet Rev. 3.4, Table 1 p. 6, Table 28 p. 41); the 2S path is 6.0–8.8 V. It moves to VSYS_LV through a load switch.
18. **v0.3, [ADR 0019](../adr/0019-master-clock-divided-from-twice-the-frequency.md): the master clock is divided from twice the frequency.** The NZ2520SDA symmetry (40–60 %) can violate the CS43198's 45–55 % at XTI, and two XTI pins at 10 pF overload a weak oscillator; no passive attenuator fixes either. NSC5083D-45.158M / -49.152M on MCLK_3V1 feed one SN74AUC1G74 per DAC (divide by two), on a new 1.8 V rail **MCLK_1V8** (TPS7A2018 from AUDIO_2V2, EN = DAC_DIG_1V8), so no clock reaches an unpowered XTI. Simulated XTI duty 45.08–54.35 %, oscillator net 13.7 pF ≤ 15 pF (`sim/mclk-divider`).
19. **v0.3: vcc3v3_sys passes 80 % of the TPS62826.** The v0.2 sum missed the haptic driver (DRV2605L VDD, ≈ 0.1 A est.); with it the estimated peak is ≈ 2.45 A = 82 % of 3 A. The pin-compatible TPS62827 (4 A, SLVSEF9I) takes the rail at 61 %, with ≥ 20 µF effective output capacitance and a 6.4 A maximum current limit that the line 106 inductor carries (§4.10).
20. **v0.4, [ADR 0020](../adr/0020-battery-connected-through-contacts.md): the battery connects through contacts.** Six spring contacts (two per power pole) replace the Micro-Fit 3.0 and the pack lead, so a listener replaces the pack without a cable or a solder joint. The contacts run at 33 % of their rating on the hotter contact at 3.2 A (Micro-Fit: 64 %) but add ≈ 25 mΩ to the battery path at end of life (**UNVERIFIED**); the gauge's coulomb counter is unaffected and its cell voltages read ≤ 40 mV low per cell at 3.2 A, zero at rest (§4.7.1).
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
