opendap-project/t1/product/docs/specs/case-board-interface.md

# Case and main board interface

- **Status:** Draft v0.1 (2026-10-27). What the case must provide for the main board in the body of [ADR 0006](../adr/0006-body-at-the-maximum-width.md). The values come from the board's placement ([board placement v1](../../../board/docs/specs/placement-v1.md), its tool's report `pcb/placement-result.json`) and the [PCB design constraints](../../../board/docs/specs/pcb-design-constraints.md) (rows PCB-M and PCB-Z); the board side is mirrored there. Nothing here is built or measured yet.
- **Requirements:** T1-014 to T1-016, T1-021, T1-031, T1-040; BRD-038, BRD-049.
- **Decisions:** [ADR 0006](../adr/0006-body-at-the-maximum-width.md) (body), [board ADR 0025](../../../board/docs/adr/0025-height-zones-in-the-wider-body.md) (height zones, walls, speaker shelf, reliefs), [board ADR 0016](../../../board/docs/adr/0016-front-side-height-under-the-display.md) (thickness stack, superseded by 0025 for the outline only), [board ADR 0020](../../../board/docs/adr/0020-battery-connected-through-contacts.md) (battery contacts).

Coordinates are in the T1 system (T1-021: origin at the device centre, x across the width, y along the length towards the top wall, +z towards the faceplate), in millimetres; general tolerances ISO 2768-m. The case's own design (shapes, materials, fixing) is case scope; this spec lists only what the board needs from it.

## 1. What the case must do
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
