opendap-project/t1/board/docs/specs/floorplan-v1.md

# Floorplan v1 of the T1 main board

- **Status:** Draft v1 (2026-10-25; §7 added 2026-10-27 from [placement v1](placement-v1.md); §1 outline, bands and holes for the 62.5 × 95.0 mm body of [ADR 0025](../adr/0025-height-zones-in-the-wider-body.md), 2026-10-27: the zones are drawn from the board edges, so they follow the outline; the area figures of §2.1 are the 55.3 × 90.1 mm study's). Basis: the maintainers' direction of 2026-10-25: the board is dense, with parts on both sides; functions are grouped into isolated zones that share the physical layers, each zone using the layers under it for its own needs, so the board needs as few layers and as few full-layer grounds as the zones allow. Nothing here is placed by a designer, routed or measured: it is the plan placement starts from.
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
