opendap-project/t1/board/docs/concept-art/sbc-exploded.png

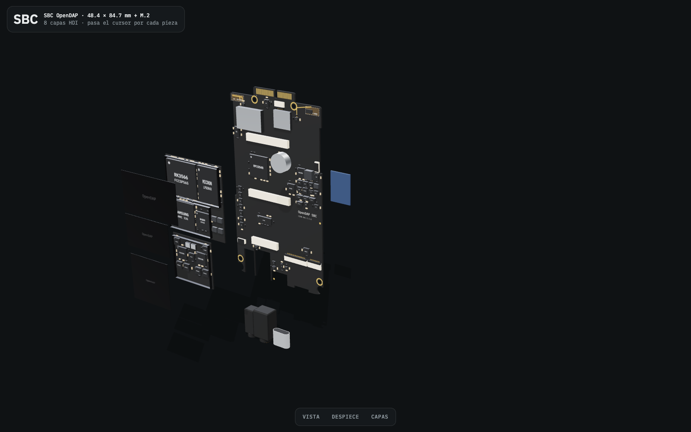
board/docs/concept-art/sbc-exploded.png
