opendap-project/t1/board/docs/concept-art/sbc-side-b.png

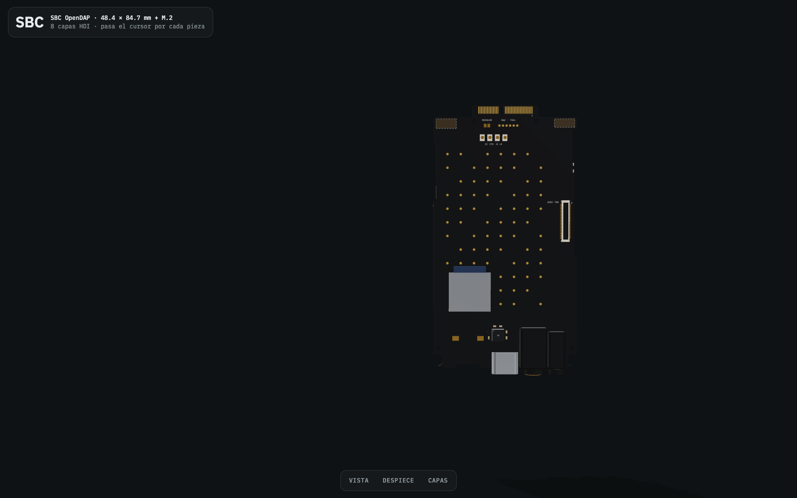
board/docs/concept-art/sbc-side-b.png
