opendap-project/t1/board/docs/concept-art/sbc-three-quarter.png

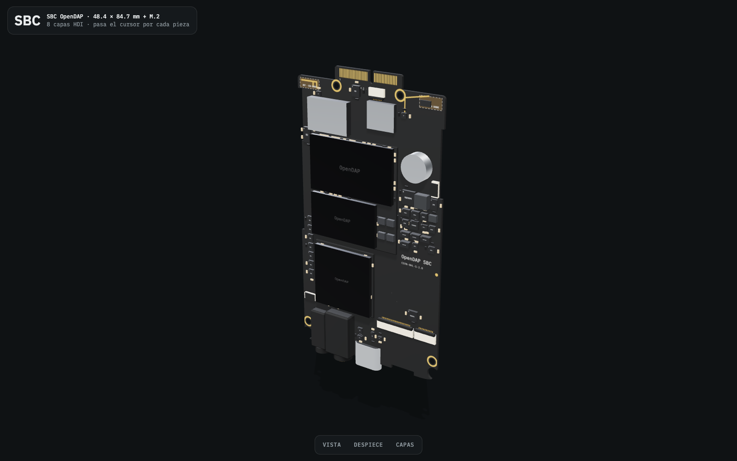
board/docs/concept-art/sbc-three-quarter.png
