opendap-project/t1/case/docs/concept-art/case-exploded.png

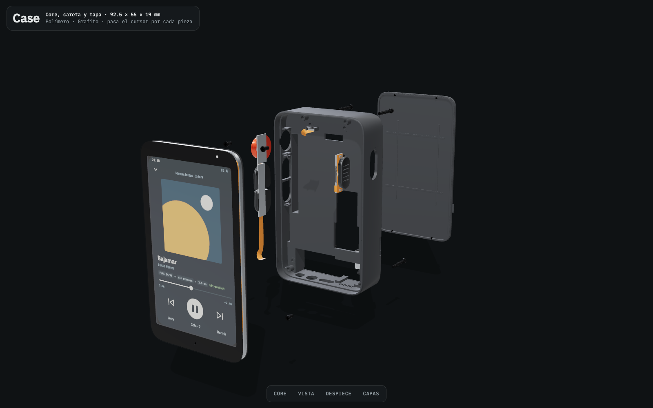
case/docs/concept-art/case-exploded.png
