opendap-project/t1/faceplates/touch/docs/concept-art/touch-faceplate-exploded.png

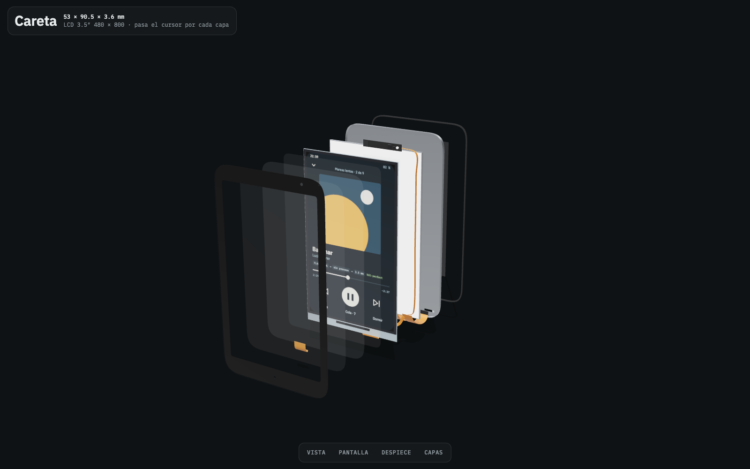
faceplates/touch/docs/concept-art/touch-faceplate-exploded.png
