opendap-project/t1/product/docs/concept-art/t1-exploded.png

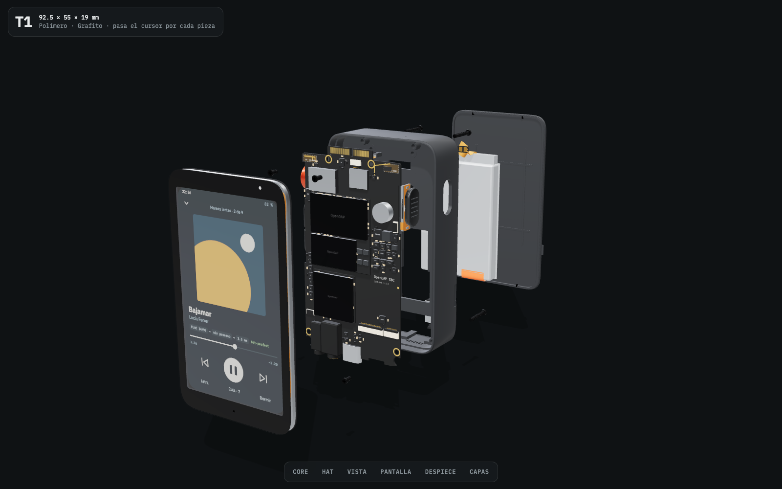
product/docs/concept-art/t1-exploded.png
