opendap-project/t1/product/assembly/README.md

# Assembly

The complete OpenDAP T1 in [FreeCAD](https://www.freecad.org) 1.1, built only from the `export/` folders of its components, each imported as a single body.
