opendap-project/t1/board/hardware/t1-main-board/t1-main-board.kicad_pcb

## KiCad design board/hardware/t1-main-board/t1-main-board.kicad_pcb (2026-10-29)

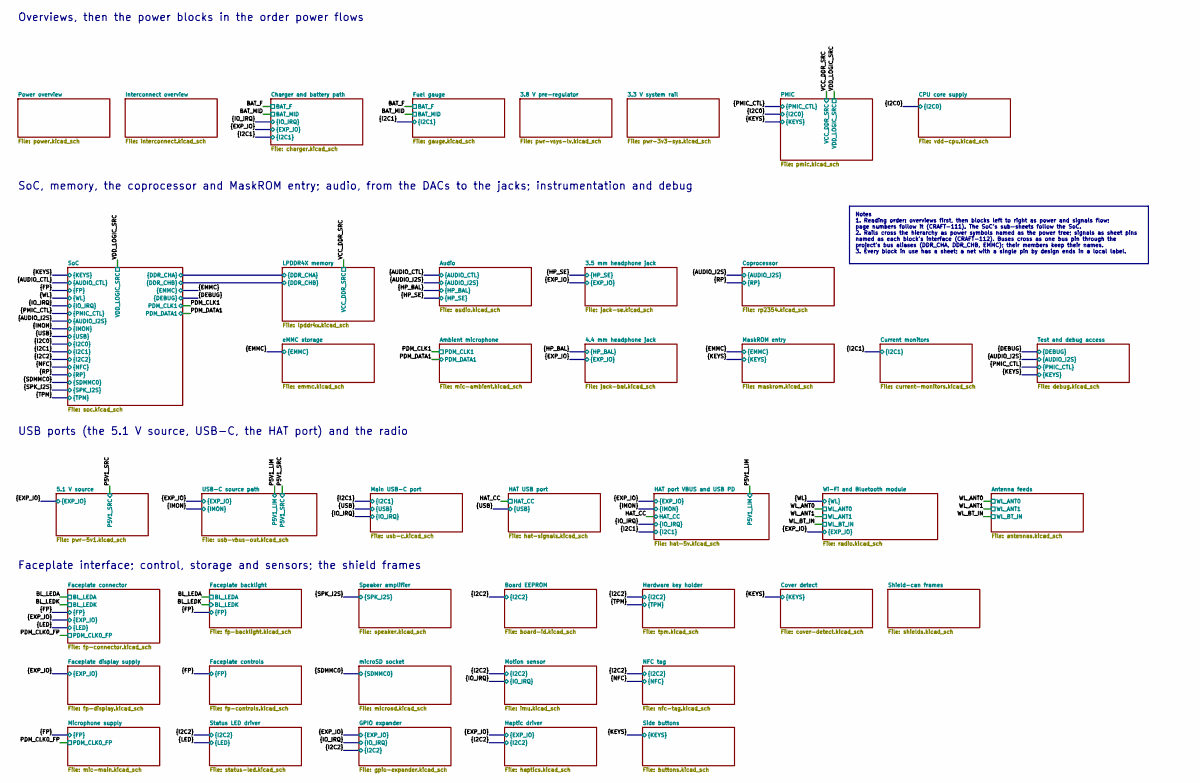
[picture p8: schematic t1-main-board.kicad_sch, Block diagram]

Notes on the sheet:
Overviews, then the power blocks in the order power flows
SoC, memory, the coprocessor and MaskROM entry; audio, from the DACs to the jacks; instrumentation and debug
USB ports (the 5.1 V source, USB-C, the HAT port) and the radio
Faceplate interface; control, storage and sensors; the shield frames
Notes 1. Reading order: overviews first, then blocks left to right as power and signals flow; page numbers follow it (CRAFT-111). The SoC's sub-sheets follow the SoC. 2. Rails cross the hierarchy as power symbols named as the power tree; signals as sheet pins named as each block's interface (CRAFT-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

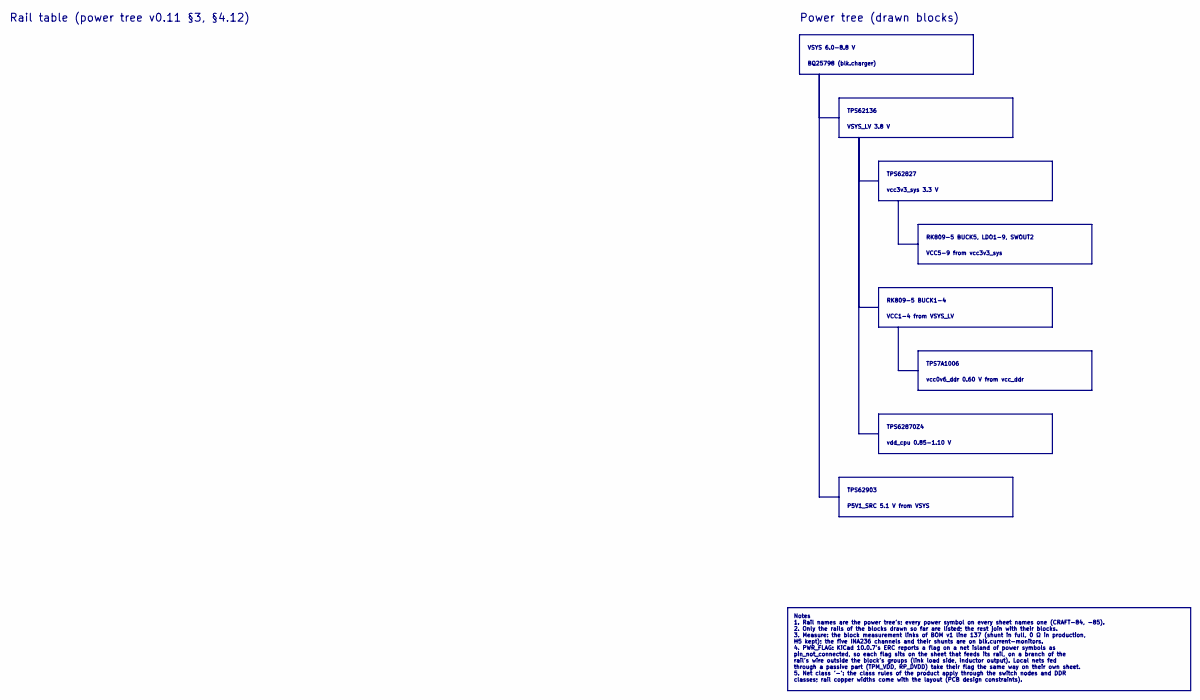
[picture p9: schematic power.kicad_sch, Power overview]

Notes on the sheet:
Rail table (power tree v0.11 §3, §4.12)
Power tree (drawn blocks)
VSYS 6.0-8.8 V
BQ25798 (blk.charger)
TPS62136
VSYS_LV 3.8 V
TPS62827
vcc3v3_sys 3.3 V
RK809-5 BUCK5, LDO1-9, SWOUT2
VCC5-9 from vcc3v3_sys
RK809-5 BUCK1-4
VCC1-4 from VSYS_LV
TPS7A1006
vcc0v6_ddr 0.60 V from vcc_ddr
TPS62870Z4
vdd_cpu 0.85-1.10 V
TPS62903
P5V1_SRC 5.1 V from VSYS
Notes 1. Rail names are the power tree's; every power symbol on every sheet names one (CRAFT-84, -85). 2. Only the rails of the blocks drawn so far are listed; the rest join with their blocks. 3. Measure: the block measurement links of BOM v1 line 137 (shunt in full, 0 Ω in production, H5 kept); th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

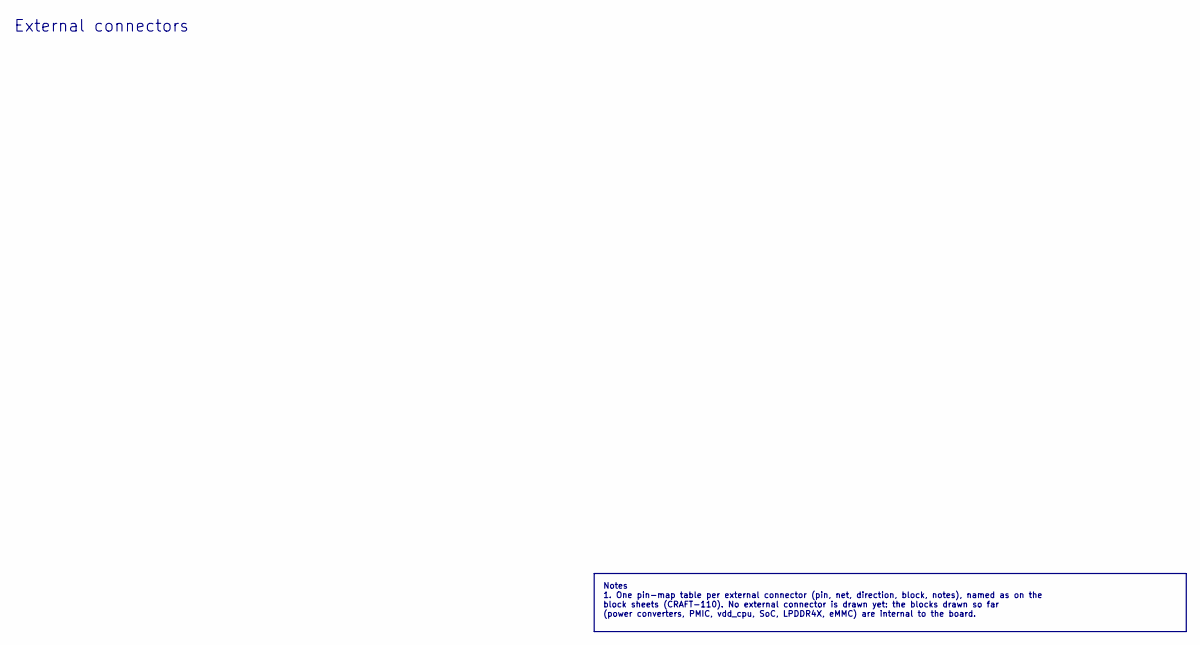
[picture p10: schematic interconnect.kicad_sch, Interconnect overview]

Notes on the sheet:
External connectors
Notes 1. One pin-map table per external connector (pin, net, direction, block, notes), named as on the block sheets (CRAFT-110). No external connector is drawn yet: the blocks drawn so far (power converters, PMIC, vdd_cpu, SoC, LPDDR4X, eMMC) are internal to the board.

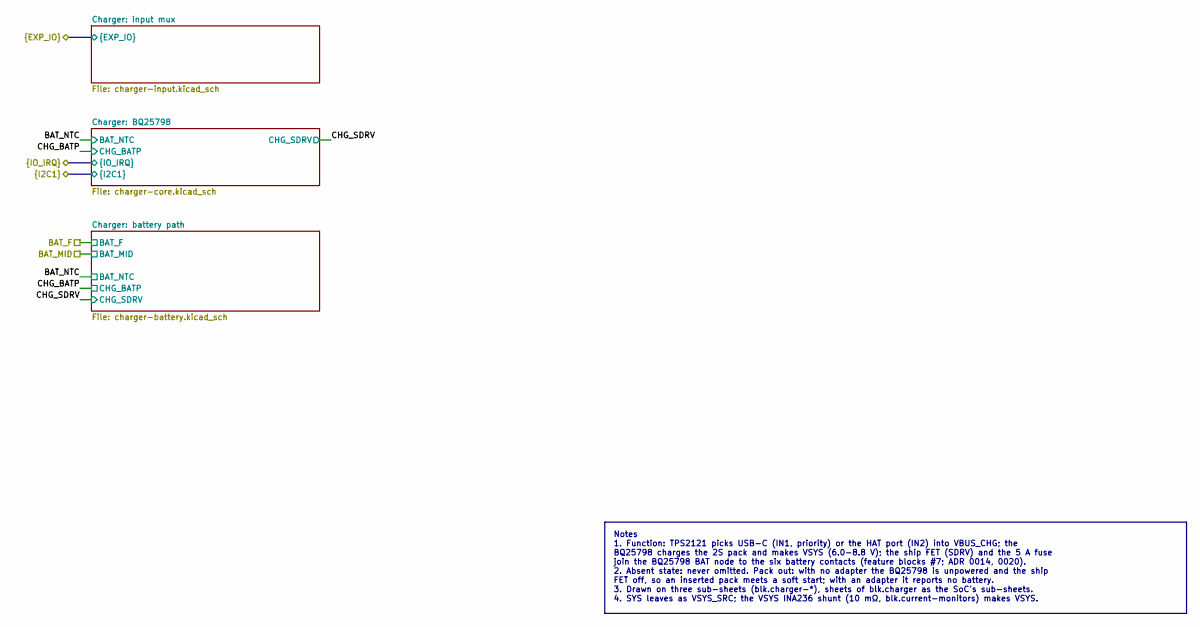
[picture p11: schematic charger.kicad_sch, Charger and battery path]

Notes on the sheet:
Notes 1. Function: TPS2121 picks USB-C (IN1, priority) or the HAT port (IN2) into VBUS_CHG; the BQ25798 charges the 2S pack and makes VSYS (6.0-8.8 V); the ship FET (SDRV) and the 5 A fuse join the BQ25798 BAT node to the six battery contacts (feature blocks #7; ADR 0014, 0020). 2. Absent state: ne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

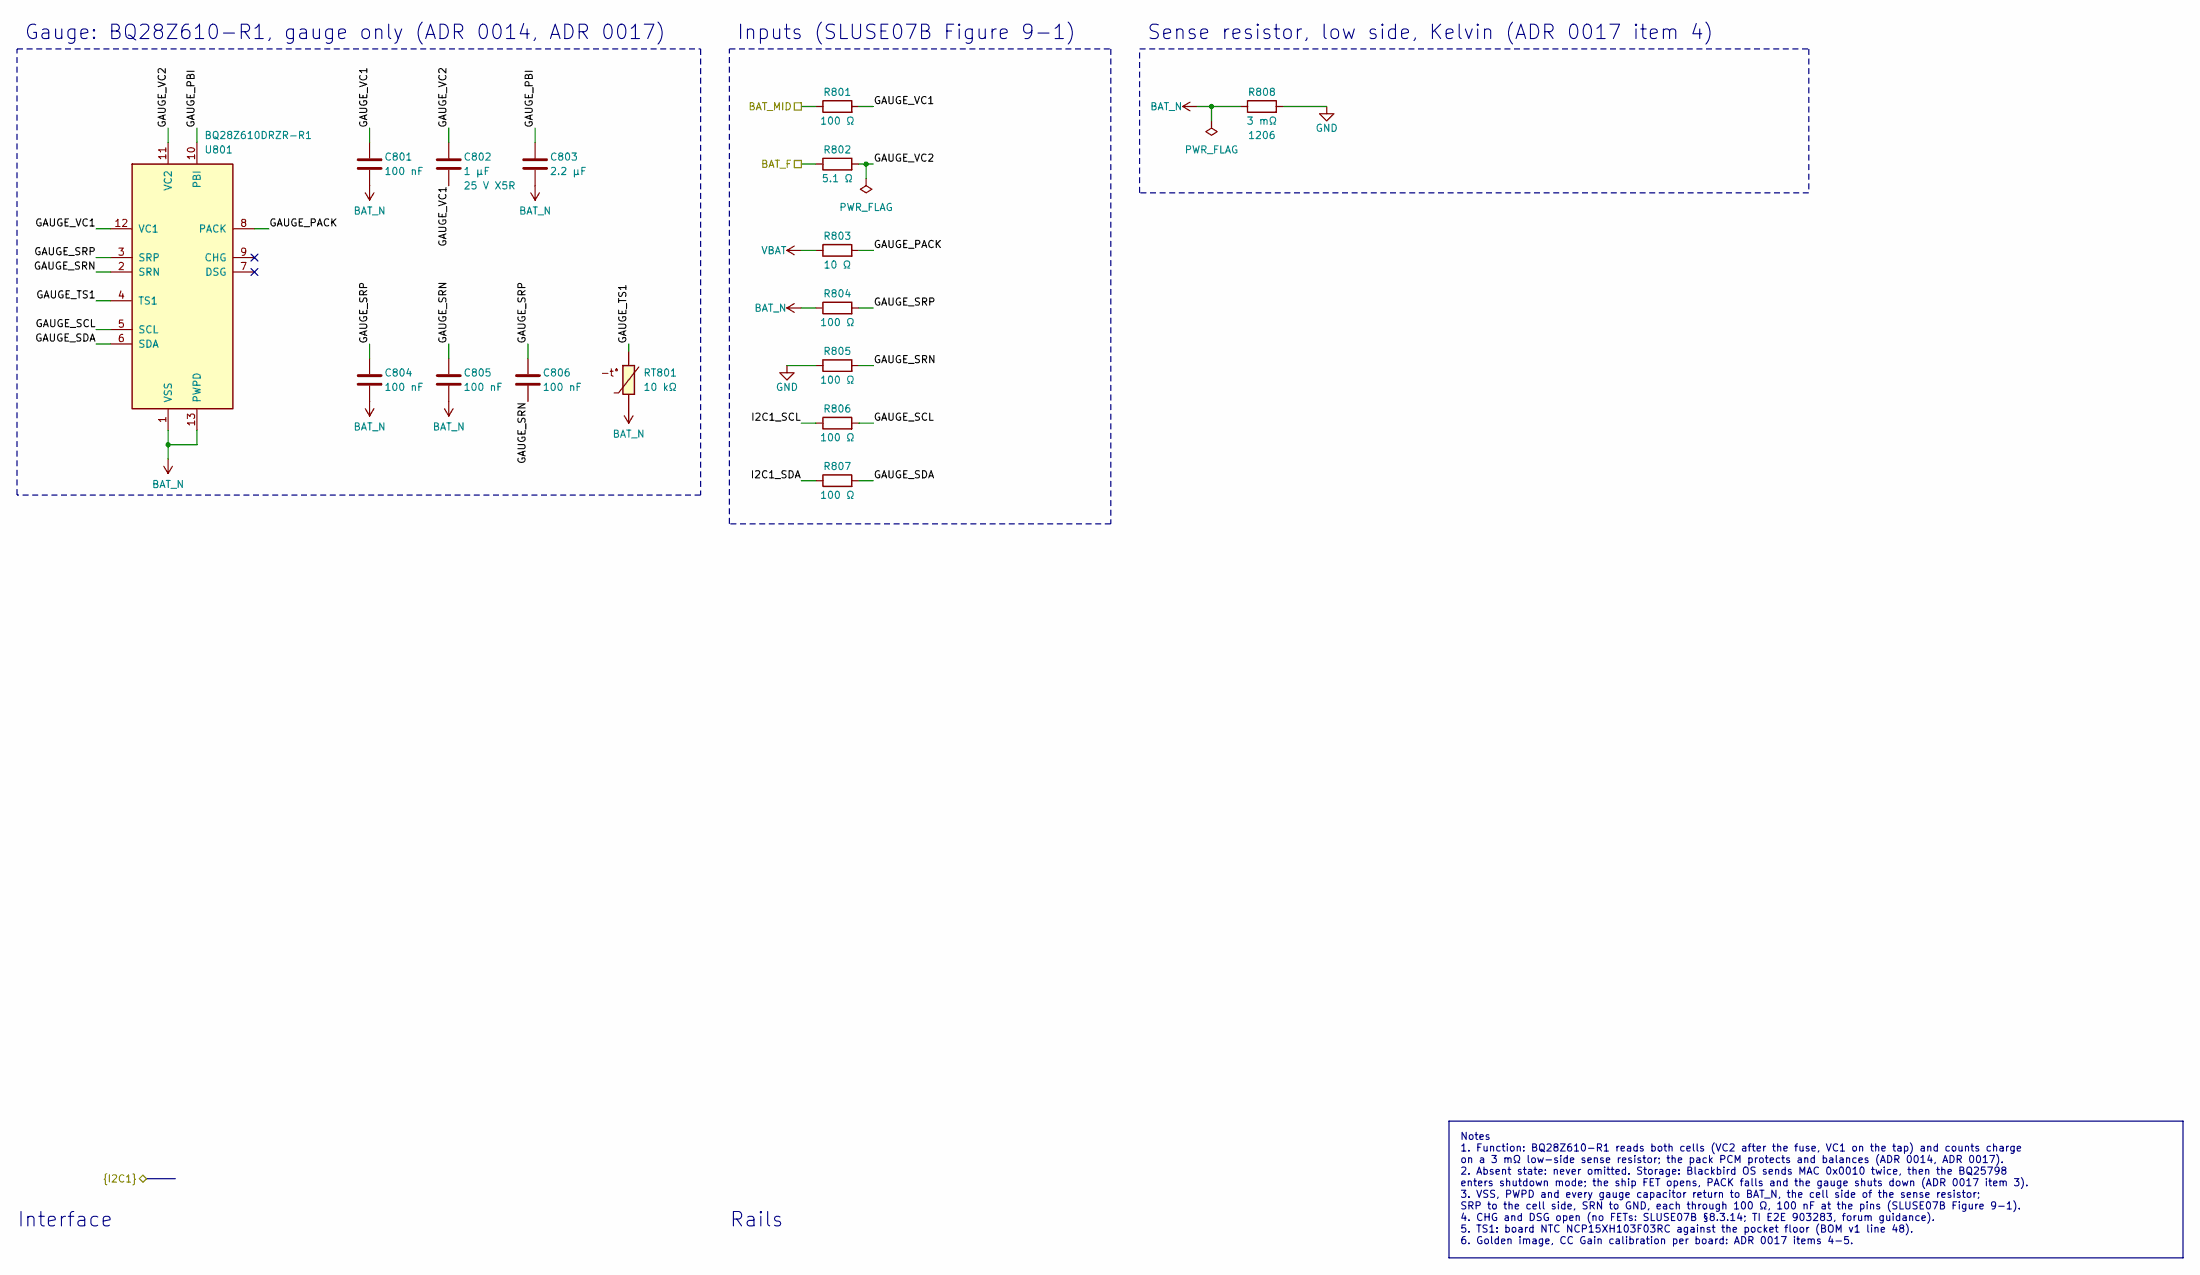
[picture p12: schematic gauge.kicad_sch, Fuel gauge]

Parts:
C801, C804, C805, C806: 100 nF; C_0402_1005Metric; MPN GRM155R71C104KA88D
C802: 1 µF; C_0402_1005Metric; MPN GRM155R61E105KA12D
C803: 2.2 µF; C_0402_1005Metric; MPN GRM155R61A225KE95D
R801, R804, R805, R806, R807: 100 Ω; R_0201_0603Metric; MPN RC0201FR-07100RL
R802: 5.1 Ω; R_0402_1005Metric; MPN RC0402FR-075R1L
R803: 10 Ω; R_0201_0603Metric; MPN RC0201FR-0710RL
R808: 3 mΩ; R_Vishay_WSL1206_2m-5m9; MPN WSL12063L000FEA
RT801: 10 kΩ; R_0402_1005Metric; MPN NCP15XH103F03RC
U801: BQ28Z610DRZR-R1; VSON-12-1EP_4x2.5mm_P0.4mm_EP2.45x1.95mm_ThermalVias; MPN BQ28Z610DRZR-R1

Connections:
/BAT_F: R802.1; also elsewhere on the board
/BAT_MID: R801.1; also elsewhere on the board
/Fuel gauge/GAUGE_PACK: R803.2, U801.8 (PACK)
/Fuel gauge/GAUGE_PBI: C803.1, U801.10 (PBI)
/Fuel gauge/GAUGE_SCL: R806.2, U801.5 (SCL)
/Fuel gauge/GAUGE_SDA: R807.2, U801.6 (SDA)
/Fuel gauge/GAUGE_SRN: C805.1, C806.2, R805.2, U801.2 (SRN)
/Fuel gauge/GAUGE_SRP: C804.1, C806.1, R804.2, U801.3 (SRP)
/Fuel gauge/GAUGE_TS1: RT801.1, U801.4 (TS1)
/Fuel gauge/GAUGE_VC1: C801.1, C802.2, R801.2, U801.12 (VC1)
/Fuel gauge/GAUGE_VC2: C802.1, R802.2, U801.11 (VC2)
/I2C1_SCL: R806.1; also elsewhere on the board
/I2C1_SDA: R807.1; also elsewhere on the board
BAT_N: C801.2, C803.2, C804.2, C805.2, R804.1, R808.1, RT801.2, U801.1 (VSS), U801.13 (PWPD); also elsewhere on the board
GND: R805.1, R808.2; also elsewhere on the board
VBAT: R803.1; also elsewhere on the board

Notes on the sheet:
Gauge: BQ28Z610-R1, gauge only (ADR 0014, ADR 0017)
Inputs (SLUSE07B Figure 9-1)
Sense resistor, low side, Kelvin (ADR 0017 item 4)
Notes 1. Function: BQ28Z610-R1 reads both cells (VC2 after the fuse, VC1 on the tap) and counts charge on a 3 mΩ low-side sense resistor; the pack PCM protects and balances (ADR 0014, ADR 0017). 2. Absent state: never omitted. Storage: Blackbird OS sends MAC 0x0010 twice, then the BQ25798 enters sh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
Interface
Rails

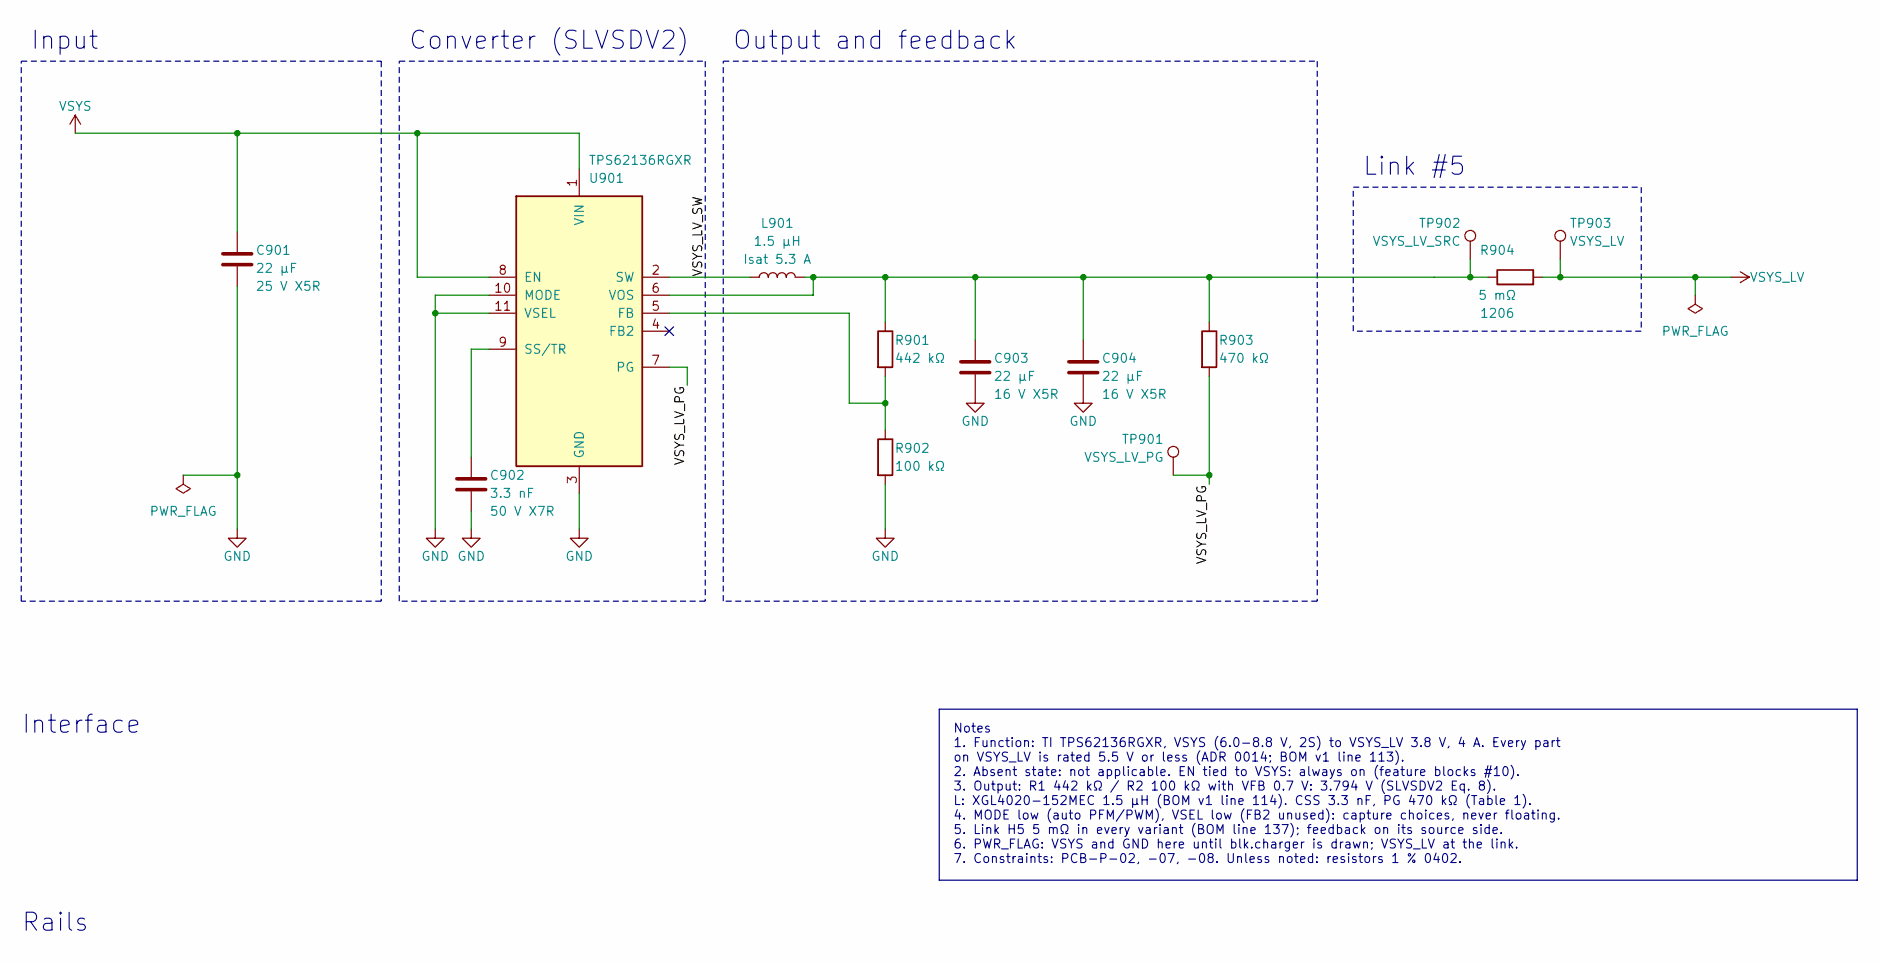
[picture p13: schematic pwr-vsys-lv.kicad_sch, 3.8 V pre-regulator]

Parts:
C901: 22 µF; C_0805_2012Metric; MPN GRM21BR61E226ME44L
C902: 3.3 nF; C_0402_1005Metric; MPN GRM155R71H332KA01D
C903, C904: 22 µF; C_0805_2012Metric; MPN GRM21BR61C226ME44L
L901: 1.5 µH; L_Coilcraft_XxL4020; MPN XGL4020-152MEC
R901: 442 kΩ; R_0201_0603Metric; MPN RC0201FR-07442KL
R902: 100 kΩ; R_0201_0603Metric; MPN RC0201FR-07100KL
R903: 470 kΩ; R_0201_0603Metric; MPN RC0201FR-07470KL
R904: 5 mΩ; R_Vishay_WSL1206_2m-5m9; MPN WSL12065L000FEA
TP901: VSYS_LV_PG; TestPoint_Pad_D0.8mm
TP902: VSYS_LV_SRC; TestPoint_Pad_D1.0mm
TP903: VSYS_LV; TestPoint_Pad_D1.0mm
U901: TPS62136RGXR; Texas_RGX0011A_VQFN-HR-11_2x3mm_P0.5mm; MPN TPS62136RGXR

Connections:
/3.8 V pre-regulator/VSYS_LV_PG: R903.2, TP901.1, U901.7 (PG)
/3.8 V pre-regulator/VSYS_LV_SW: L901.1, U901.2 (SW)
GND: C901.2, C902.2, C903.2, C904.2, R902.2, U901.3 (GND), U901.10 (MODE), U901.11 (VSEL); also elsewhere on the board
unnamed: R901.2, R902.1, U901.5 (FB)
unnamed: C902.1, U901.9 (SS/TR)
unnamed: C903.1, C904.1, L901.2, R901.1, R903.1, R904.1, TP902.1, U901.6 (VOS)
VSYS: C901.1, U901.1 (VIN), U901.8 (EN); also elsewhere on the board
VSYS_LV: R904.2, TP903.1; also elsewhere on the board

Notes on the sheet:
Input
Converter (SLVSDV2)
Output and feedback
Link #5
Notes 1. Function: TI TPS62136RGXR, VSYS (6.0-8.8 V, 2S) to VSYS_LV 3.8 V, 4 A. Every part on VSYS_LV is rated 5.5 V or less (ADR 0014; BOM v1 line 113). 2. Absent state: not applicable. EN tied to VSYS: always on (feature blocks #10). 3. Output: R1 442 kΩ / R2 100 kΩ with VFB 0.7 V: 3.794 V (SLVSD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
Rails
Interface

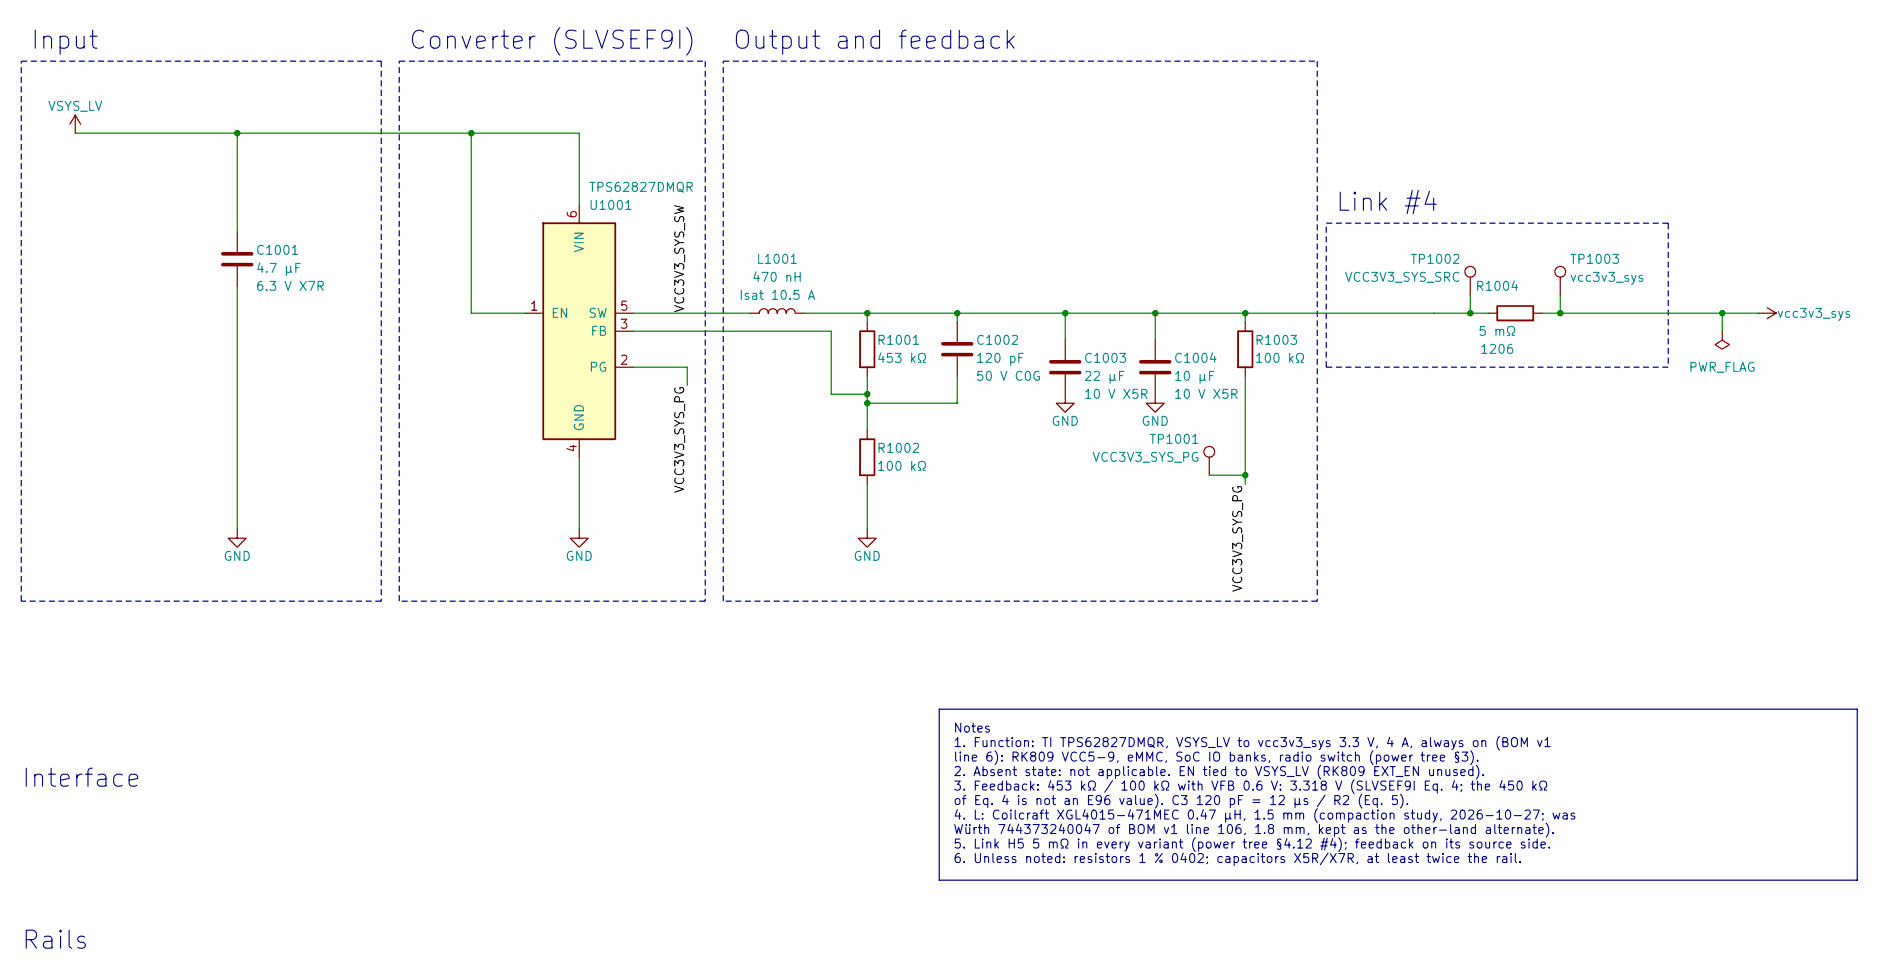
[picture p14: schematic pwr-3v3-sys.kicad_sch, 3.3 V system rail]

Parts:
C1001: 4.7 µF; C_0603_1608Metric; MPN GRM188R70J475KE19D
C1002: 120 pF; C_0402_1005Metric; MPN GRM1555C1H121JA01D
C1003: 22 µF; C_0603_1608Metric; MPN GRM188R61A226ME15D
C1004: 10 µF; C_0603_1608Metric; MPN GRM188R61A106KE69D
L1001: 470 nH; L_Coilcraft_XxL4020; MPN XGL4015-471MEC
R1001: 453 kΩ; R_0201_0603Metric; MPN RC0201FR-07453KL
R1002, R1003: 100 kΩ; R_0201_0603Metric; MPN RC0201FR-07100KL
R1004: 5 mΩ; R_Vishay_WSL1206_2m-5m9; MPN WSL12065L000FEA
TP1001: VCC3V3_SYS_PG; TestPoint_Pad_D0.8mm
TP1002: VCC3V3_SYS_SRC; TestPoint_Pad_D1.0mm
TP1003: vcc3v3_sys; TestPoint_Pad_D1.0mm
U1001: TPS62827DMQR; Texas_DMQ0006A_VSON-HR-6_1.5x1.5mm_P0.5mm; MPN TPS62827DMQR

Connections:
/3.3 V system rail/VCC3V3_SYS_PG: R1003.2, TP1001.1, U1001.2 (PG)
/3.3 V system rail/VCC3V3_SYS_SW: L1001.1, U1001.5 (SW)
GND: C1001.2, C1003.2, C1004.2, R1002.2, U1001.4 (GND); also elsewhere on the board
unnamed: C1002.1, C1003.1, C1004.1, L1001.2, R1001.1, R1003.1, R1004.1, TP1002.1
unnamed: C1002.2, R1001.2, R1002.1, U1001.3 (FB)
VSYS_LV: C1001.1, U1001.1 (EN), U1001.6 (VIN); also elsewhere on the board
vcc3v3_sys: R1004.2, TP1003.1; also elsewhere on the board

Notes on the sheet:
Input
Converter (SLVSEF9I)
Output and feedback
Link #4
Notes 1. Function: TI TPS62827DMQR, VSYS_LV to vcc3v3_sys 3.3 V, 4 A, always on (BOM v1 line 6): RK809 VCC5-9, eMMC, SoC IO banks, radio switch (power tree §3). 2. Absent state: not applicable. EN tied to VSYS_LV (RK809 EXT_EN unused). 3. Feedback: 453 kΩ / 100 kΩ with VFB 0.6 V: 3.318 V (SLVSEF9I 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
Rails
Interface

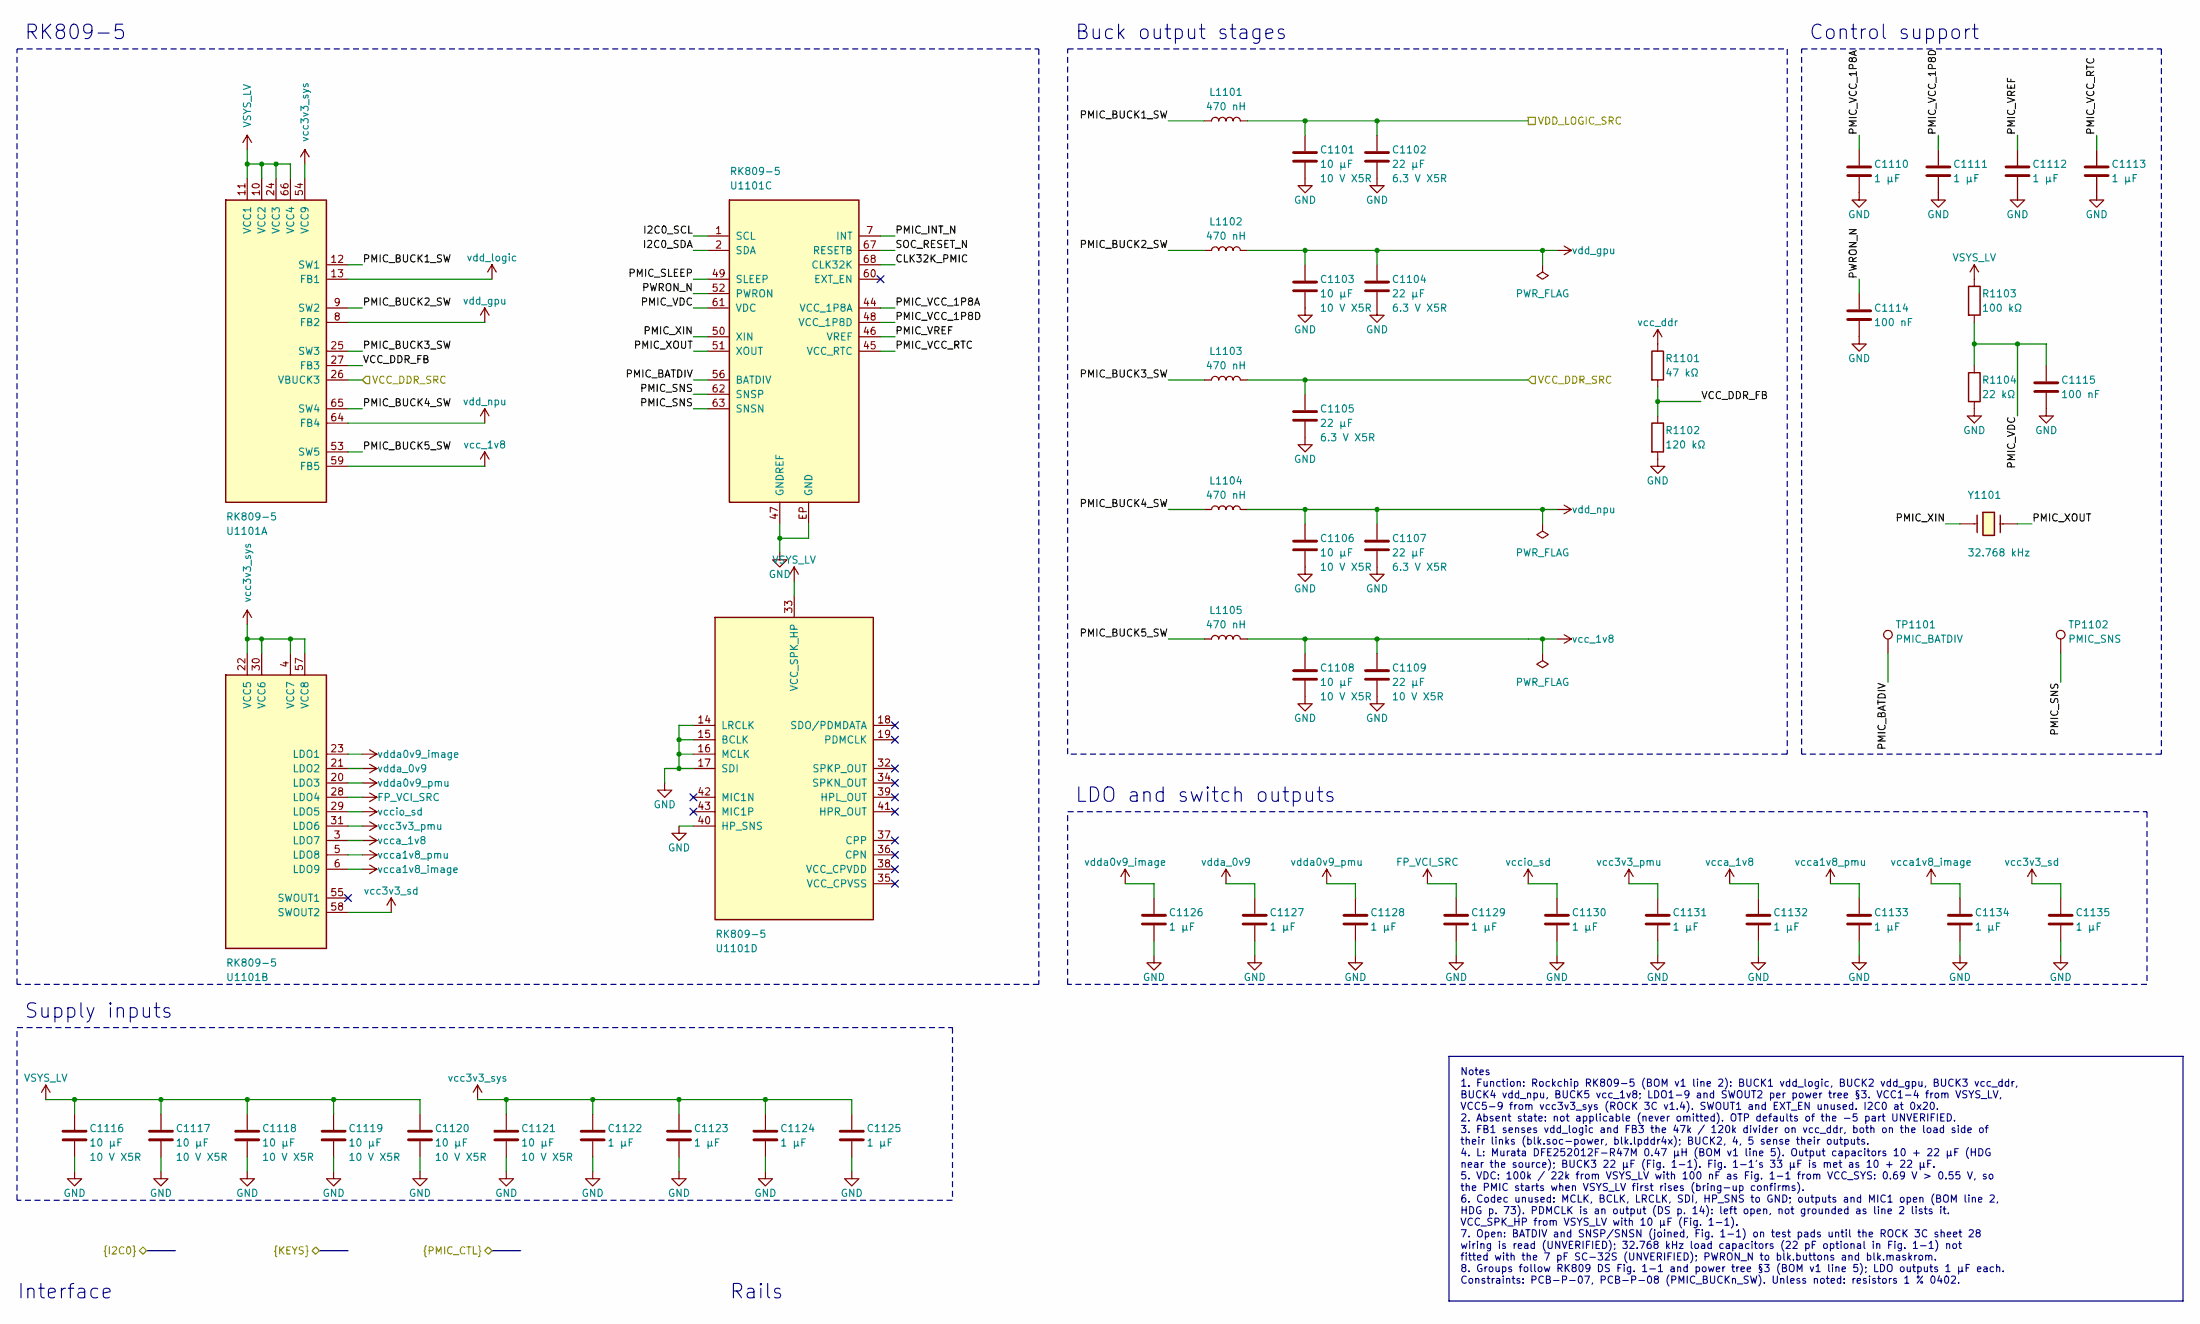
[picture p15: schematic pmic.kicad_sch]

Parts:
C1101, C1103, C1106, C1108, C1116, C1117, C1118, C1119, C1120, C1121: 10 µF; C_0603_1608Metric; MPN GRM188R61A106KE69D
C1102, C1104, C1105, C1107: 22 µF; C_0603_1608Metric; MPN GRM188R60J226MEA0D
C1109: 22 µF; C_0603_1608Metric; MPN GRM188R61A226ME15D
C1110, C1111, C1112, C1113, C1122, C1123, C1124, C1125, C1126, C1127, C1128, C1129, C1130, C1131, C1132, C1133, C1134, C1135: 1 µF; C_0402_1005Metric; MPN GRM155C71A105KE11D
C1114, C1115: 100 nF; C_0201_0603Metric; MPN GRM033R61A104KE15D
L1101, L1102, L1103, L1104, L1105: 470 nH; L_Murata_DFE252012F; MPN DFE252012F-R47M
R1101: 47 kΩ; R_0201_0603Metric; MPN RC0201FR-0747KL
R1102: 120 kΩ; R_0201_0603Metric; MPN RC0201FR-07120KL
R1103: 100 kΩ; R_0201_0603Metric; MPN RC0201FR-07100KL
R1104: 22 kΩ; R_0201_0603Metric; MPN RC0201FR-0722KL
TP1101: PMIC_BATDIV; TestPoint_Pad_D0.8mm
TP1102: PMIC_SNS; TestPoint_Pad_D0.8mm
U1101: RK809-5; QFN-68-1EP_7x7mm_P0.35mm_EP5.49x5.49mm_ThermalVias; MPN RK809-5
Y1101: 32.768 kHz; Crystal_SMD_3215-2Pin_3.2x1.5mm; MPN SC-32S 32.768kHz 20ppm 7pF

Connections:
/CLK32K_PMIC: U1101.68 (CLK32K); also elsewhere on the board
/I2C0_SCL: U1101.1 (SCL); also elsewhere on the board
/I2C0_SDA: U1101.2 (SDA); also elsewhere on the board
/PMIC/PMIC_BATDIV: TP1101.1, U1101.56 (BATDIV)
/PMIC/PMIC_BUCK1_SW: L1101.1, U1101.12 (SW1)
/PMIC/PMIC_BUCK2_SW: L1102.1, U1101.9 (SW2)
/PMIC/PMIC_BUCK3_SW: L1103.1, U1101.25 (SW3)
/PMIC/PMIC_BUCK4_SW: L1104.1, U1101.65 (SW4)
/PMIC/PMIC_BUCK5_SW: L1105.1, U1101.53 (SW5)
/PMIC/PMIC_SNS: TP1102.1, U1101.62 (SNSP), U1101.63 (SNSN)
/PMIC/PMIC_VCC_1P8A: C1110.1, U1101.44 (VCC_1P8A)
/PMIC/PMIC_VCC_1P8D: C1111.1, U1101.48 (VCC_1P8D)
/PMIC/PMIC_VCC_RTC: C1113.1, U1101.45 (VCC_RTC)
/PMIC/PMIC_VDC: C1115.1, R1103.2, R1104.1, U1101.61 (VDC)
/PMIC/PMIC_VREF: C1112.1, U1101.46 (VREF)
/PMIC/PMIC_XIN: U1101.50 (XIN), Y1101.1
/PMIC/PMIC_XOUT: U1101.51 (XOUT), Y1101.2
/PMIC/VCC_DDR_FB: R1101.2, R1102.1, U1101.27 (FB3)
/PMIC_INT_N: U1101.7 (INT); also elsewhere on the board
/PMIC_SLEEP: U1101.49 (SLEEP); also elsewhere on the board
/PWRON_N: C1114.1, U1101.52 (PWRON); also elsewhere on the board
/SOC_RESET_N: U1101.67 (RESETB); also elsewhere on the board
/VCC_DDR_SRC: C1105.1, L1103.2, U1101.26 (VBUCK3); also elsewhere on the board
/VDD_LOGIC_SRC: C1101.1, C1102.1, L1101.2; also elsewhere on the board
FP_VCI_SRC: C1129.1, U1101.28 (LDO4); also elsewhere on the board
GND: C1101.2, C1102.2, C1103.2, C1104.2, C1105.2, C1106.2, C1107.2, C1108.2, C1109.2, C1110.2, C1111.2, C1112.2, C1113.2, C1114.2, C1115.2, C1116.2, C1117.2, C1118.2, C1119.2, C1120.2, C1121.2, C1122.2, C1123.2, C1124.2, C1125.2, C1126.2, C1127.2, C1128.2, C1129.2, C1130.2, C1131.2, C1132.2, C1133.2, C1134.2, C1135.2, R1102.2, R1104.2, U1101.14 (LRCLK), U1101.15 (BCLK), U1101.16 (MCLK), U1101.17 (SDI), U1101.40 (HP_SNS), U1101.47 (GNDREF), U1101.EP (GND); also elsewhere on the board
VSYS_LV: C1116.1, C1117.1, C1118.1, C1119.1, C1120.1, R1103.1, U1101.10 (VCC2), U1101.11 (VCC1), U1101.24 (VCC3), U1101.33 (VCC_SPK_HP), U1101.66 (VCC4); also elsewhere on the board
vcc3v3_pmu: C1131.1, U1101.31 (LDO6); also elsewhere on the board
vcc3v3_sd: C1135.1, U1101.58 (SWOUT2); also elsewhere on the board
vcc3v3_sys: C1121.1, C1122.1, C1123.1, C1124.1, C1125.1, U1101.4 (VCC7), U1101.22 (VCC5), U1101.30 (VCC6), U1101.54 (VCC9), U1101.57 (VCC8); also elsewhere on the board
vcc_1v8: C1108.1, C1109.1, L1105.2, U1101.59 (FB5); also elsewhere on the board
vcc_ddr: R1101.1; also elsewhere on the board
vcca1v8_image: C1134.1, U1101.6 (LDO9); also elsewhere on the board
vcca1v8_pmu: C1133.1, U1101.5 (LDO8); also elsewhere on the board
vcca_1v8: C1132.1, U1101.3 (LDO7); also elsewhere on the board
vccio_sd: C1130.1, U1101.29 (LDO5); also elsewhere on the board
vdd_gpu: C1103.1, C1104.1, L1102.2, U1101.8 (FB2); also elsewhere on the board
vdd_logic: U1101.13 (FB1); also elsewhere on the board
vdd_npu: C1106.1, C1107.1, L1104.2, U1101.64 (FB4); also elsewhere on the board
vdda0v9_image: C1126.1, U1101.23 (LDO1); also elsewhere on the board
vdda0v9_pmu: C1128.1, U1101.20 (LDO3); also elsewhere on the board
vdda_0v9: C1127.1, U1101.21 (LDO2); also elsewhere on the board

Notes on the sheet:
RK809-5
Buck output stages
Control support
Supply inputs
LDO and switch outputs
Notes 1. Function: Rockchip RK809-5 (BOM v1 line 2): BUCK1 vdd_logic, BUCK2 vdd_gpu, BUCK3 vcc_ddr, BUCK4 vdd_npu, BUCK5 vcc_1v8; LDO1-9 and SWOUT2 per power tree §3. VCC1-4 from VSYS_LV, VCC5-9 from vcc3v3_sys (ROCK 3C v1.4). SWOUT1 and EXT_EN unused. I2C0 at 0x20. 2. Absent state: not applicable 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
Interface
Rails
