opendap-project/t1/board/hardware/t1-main-board/t1-main-board.kicad_pcb

## KiCad design board/hardware/t1-main-board/t1-main-board.kicad_pcb (continued)

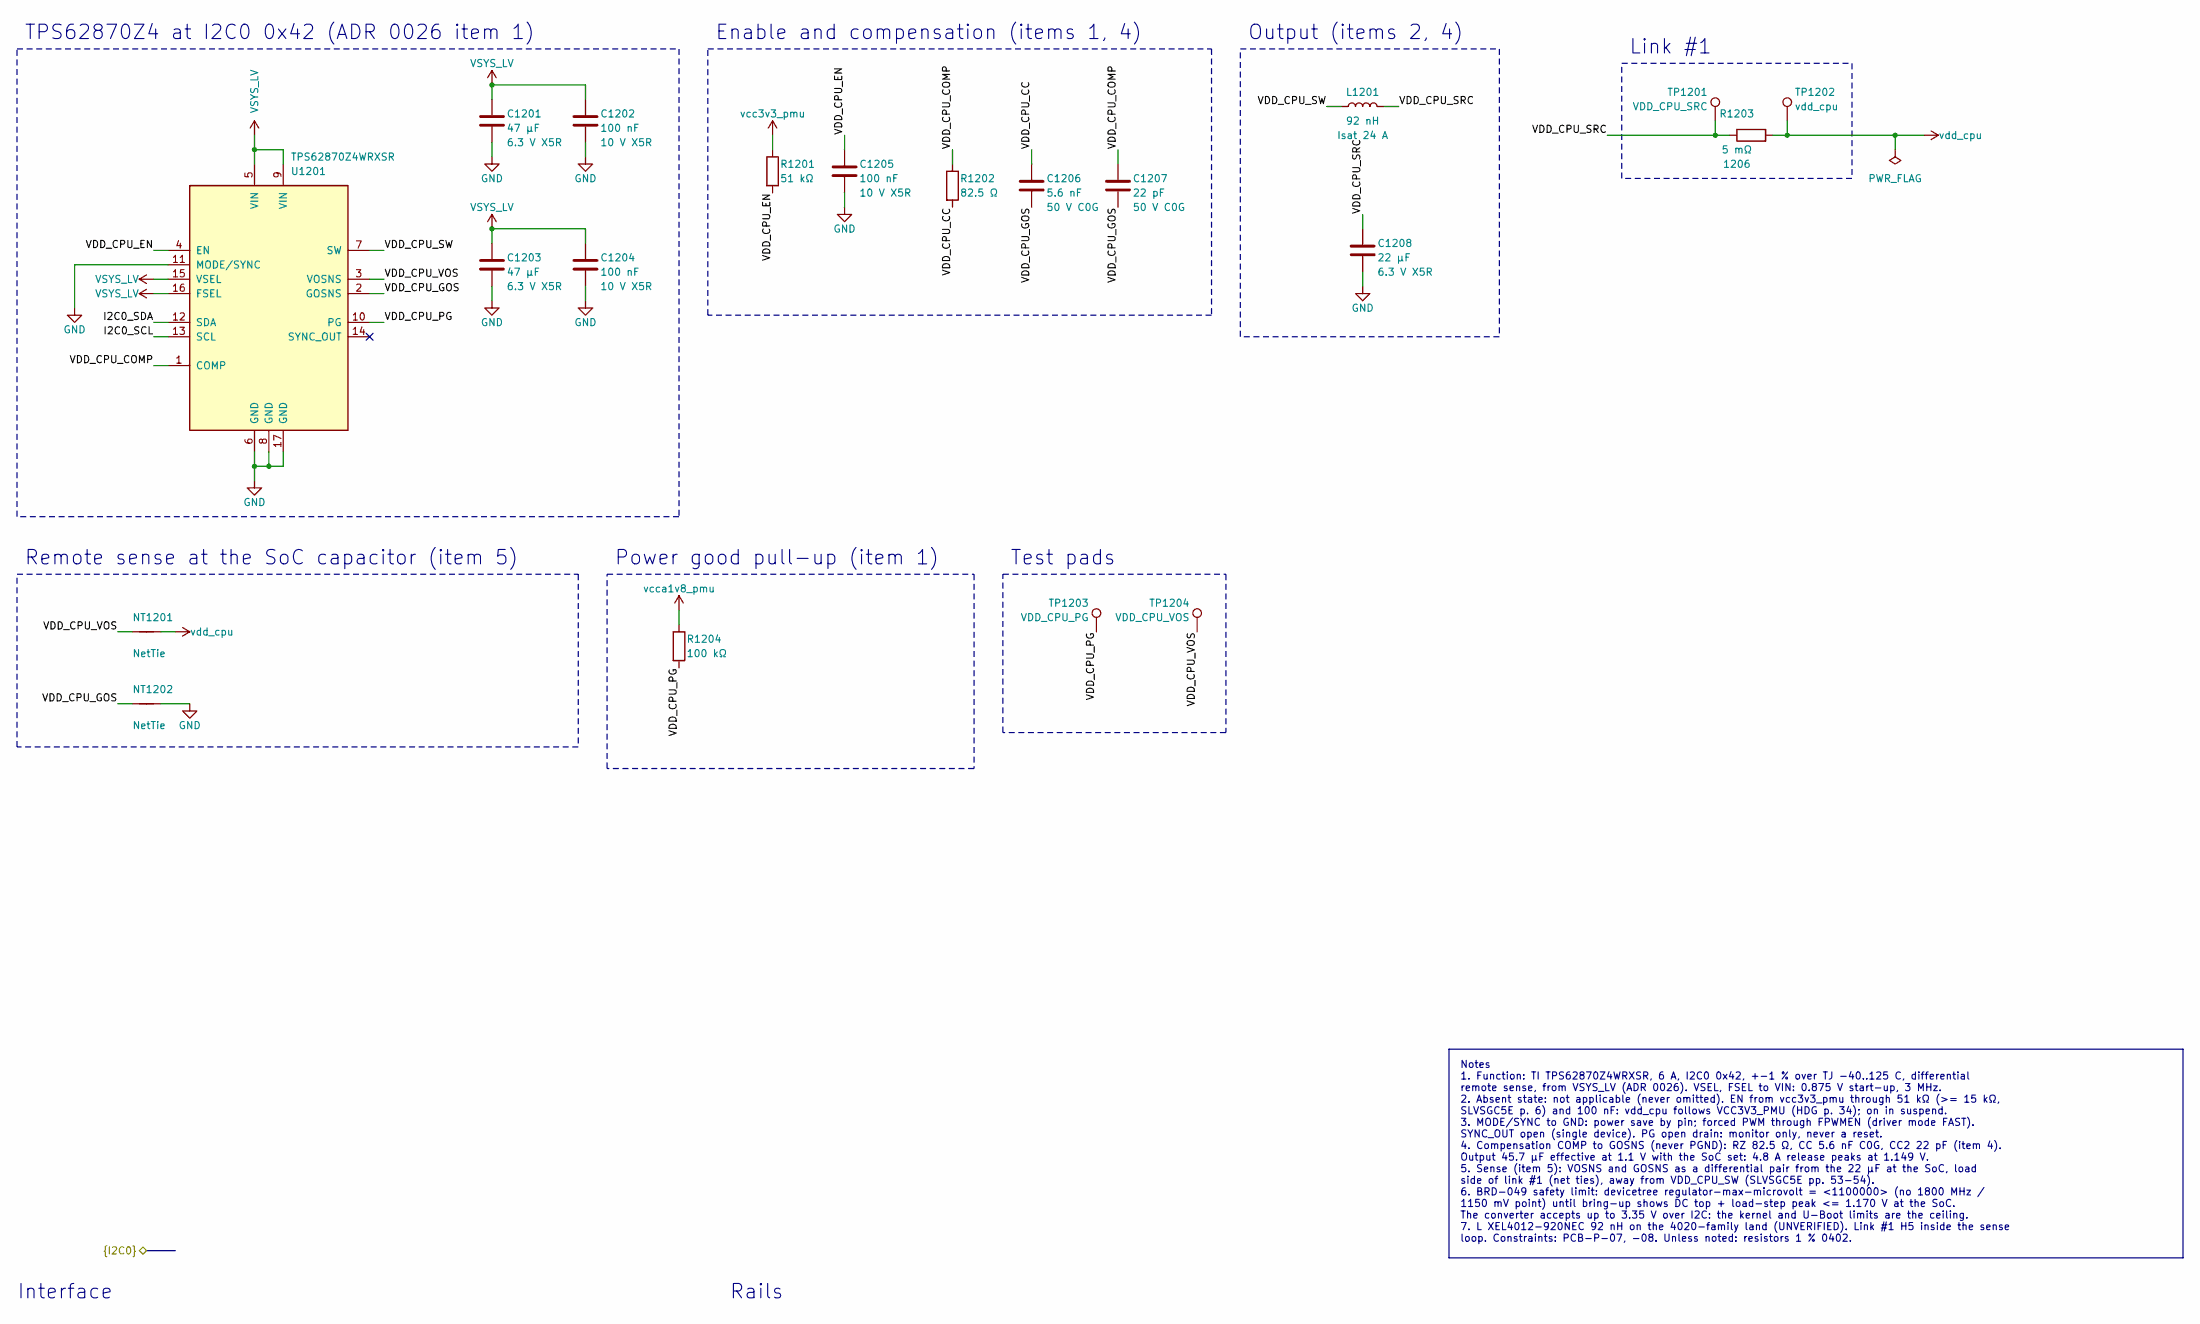
[picture p16: schematic vdd-cpu.kicad_sch, CPU core supply]

Parts:
C1201, C1203: 47 µF; C_0603_1608Metric; MPN GRM188R60J476ME15D
C1202, C1204, C1205: 100 nF; C_0201_0603Metric; MPN GRM033R61A104KE15D
C1206: 5.6 nF; C_0402_1005Metric; MPN GRM1555C1H562JE01D
C1207: 22 pF; C_0402_1005Metric; MPN GRM1555C1H220JA01D
C1208: 22 µF; C_0603_1608Metric; MPN GRM188R60J226MEA0D
L1201: 92 nH; L_Coilcraft_XxL4020; MPN XEL4012-920NEC
NT1201, NT1202: NetTie; NetTie-2_SMD_Pad0.5mm
R1201: 51 kΩ; R_0201_0603Metric; MPN RC0201FR-0751KL
R1202: 82.5 Ω; R_0201_0603Metric; MPN RC0201FR-0782R5L
R1203: 5 mΩ; R_Vishay_WSL1206_2m-5m9; MPN WSL12065L000FEA
R1204: 100 kΩ; R_0201_0603Metric; MPN RC0201FR-07100KL
TP1201: VDD_CPU_SRC; TestPoint_Pad_D1.0mm
TP1202: vdd_cpu; TestPoint_Pad_D1.0mm
TP1203: VDD_CPU_PG; TestPoint_Pad_D0.8mm
TP1204: VDD_CPU_VOS; TestPoint_Pad_D0.8mm
U1201: TPS62870Z4WRXSR; Texas_RXS0016A_VQFN-FCRLF-16_2.55x3.55mm_P0.5mm; MPN TPS62870Z4WRXSR

Connections:
/CPU core supply/VDD_CPU_CC: C1206.1, R1202.2
/CPU core supply/VDD_CPU_COMP: C1207.1, R1202.1, U1201.1 (COMP)
/CPU core supply/VDD_CPU_EN: C1205.1, R1201.2, U1201.4 (EN)
/CPU core supply/VDD_CPU_GOS: C1206.2, C1207.2, NT1202.1, U1201.2 (GOSNS)
/CPU core supply/VDD_CPU_PG: R1204.2, TP1203.1, U1201.10 (PG)
/CPU core supply/VDD_CPU_SRC: C1208.1, L1201.2, R1203.1, TP1201.1
/CPU core supply/VDD_CPU_SW: L1201.1, U1201.7 (SW)
/CPU core supply/VDD_CPU_VOS: NT1201.1, TP1204.1, U1201.3 (VOSNS)
/I2C0_SCL: U1201.13 (SCL); also elsewhere on the board
/I2C0_SDA: U1201.12 (SDA); also elsewhere on the board
GND: C1201.2, C1202.2, C1203.2, C1204.2, C1205.2, C1208.2, NT1202.2, U1201.6 (GND), U1201.8 (GND), U1201.11 (MODE/SYNC), U1201.17 (GND); also elsewhere on the board
VSYS_LV: C1201.1, C1202.1, C1203.1, C1204.1, U1201.5 (VIN), U1201.9 (VIN), U1201.15 (VSEL), U1201.16 (FSEL); also elsewhere on the board
vcc3v3_pmu: R1201.1; also elsewhere on the board
vcca1v8_pmu: R1204.1; also elsewhere on the board
vdd_cpu: NT1201.2, R1203.2, TP1202.1; also elsewhere on the board

Notes on the sheet:
TPS62870Z4 at I2C0 0x42 (ADR 0026 item 1)
Enable and compensation (items 1, 4)
Output (items 2, 4)
Link #1
Remote sense at the SoC capacitor (item 5)
Power good pull-up (item 1)
Test pads
Notes 1. Function: TI TPS62870Z4WRXSR, 6 A, I2C0 0x42, +-1 % over TJ -40..125 C, differential remote sense, from VSYS_LV (ADR 0026). VSEL, FSEL to VIN: 0.875 V start-up, 3 MHz. 2. Absent state: not applicable (never omitted). EN from vcc3v3_pmu through 51 kΩ (>= 15 kΩ, SLVSGC5E p. 6) and 100 nF: vd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
Interface
Rails

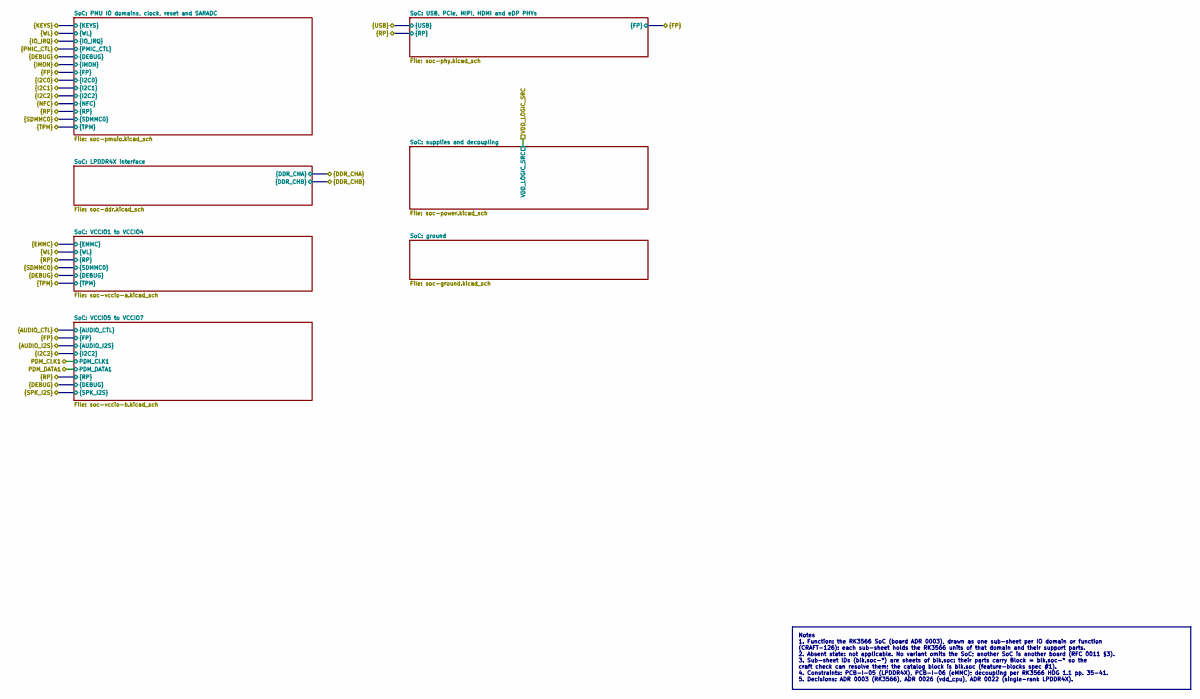
[picture p17: schematic soc.kicad_sch]

Notes on the sheet:
Notes 1. Function: the RK3566 SoC (board ADR 0003), drawn as one sub-sheet per IO domain or function (CRAFT-126): each sub-sheet holds the RK3566 units of that domain and their support parts. 2. Absent state: not applicable. No variant omits the SoC; another SoC is another board (RFC 0011 §3). 3. S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

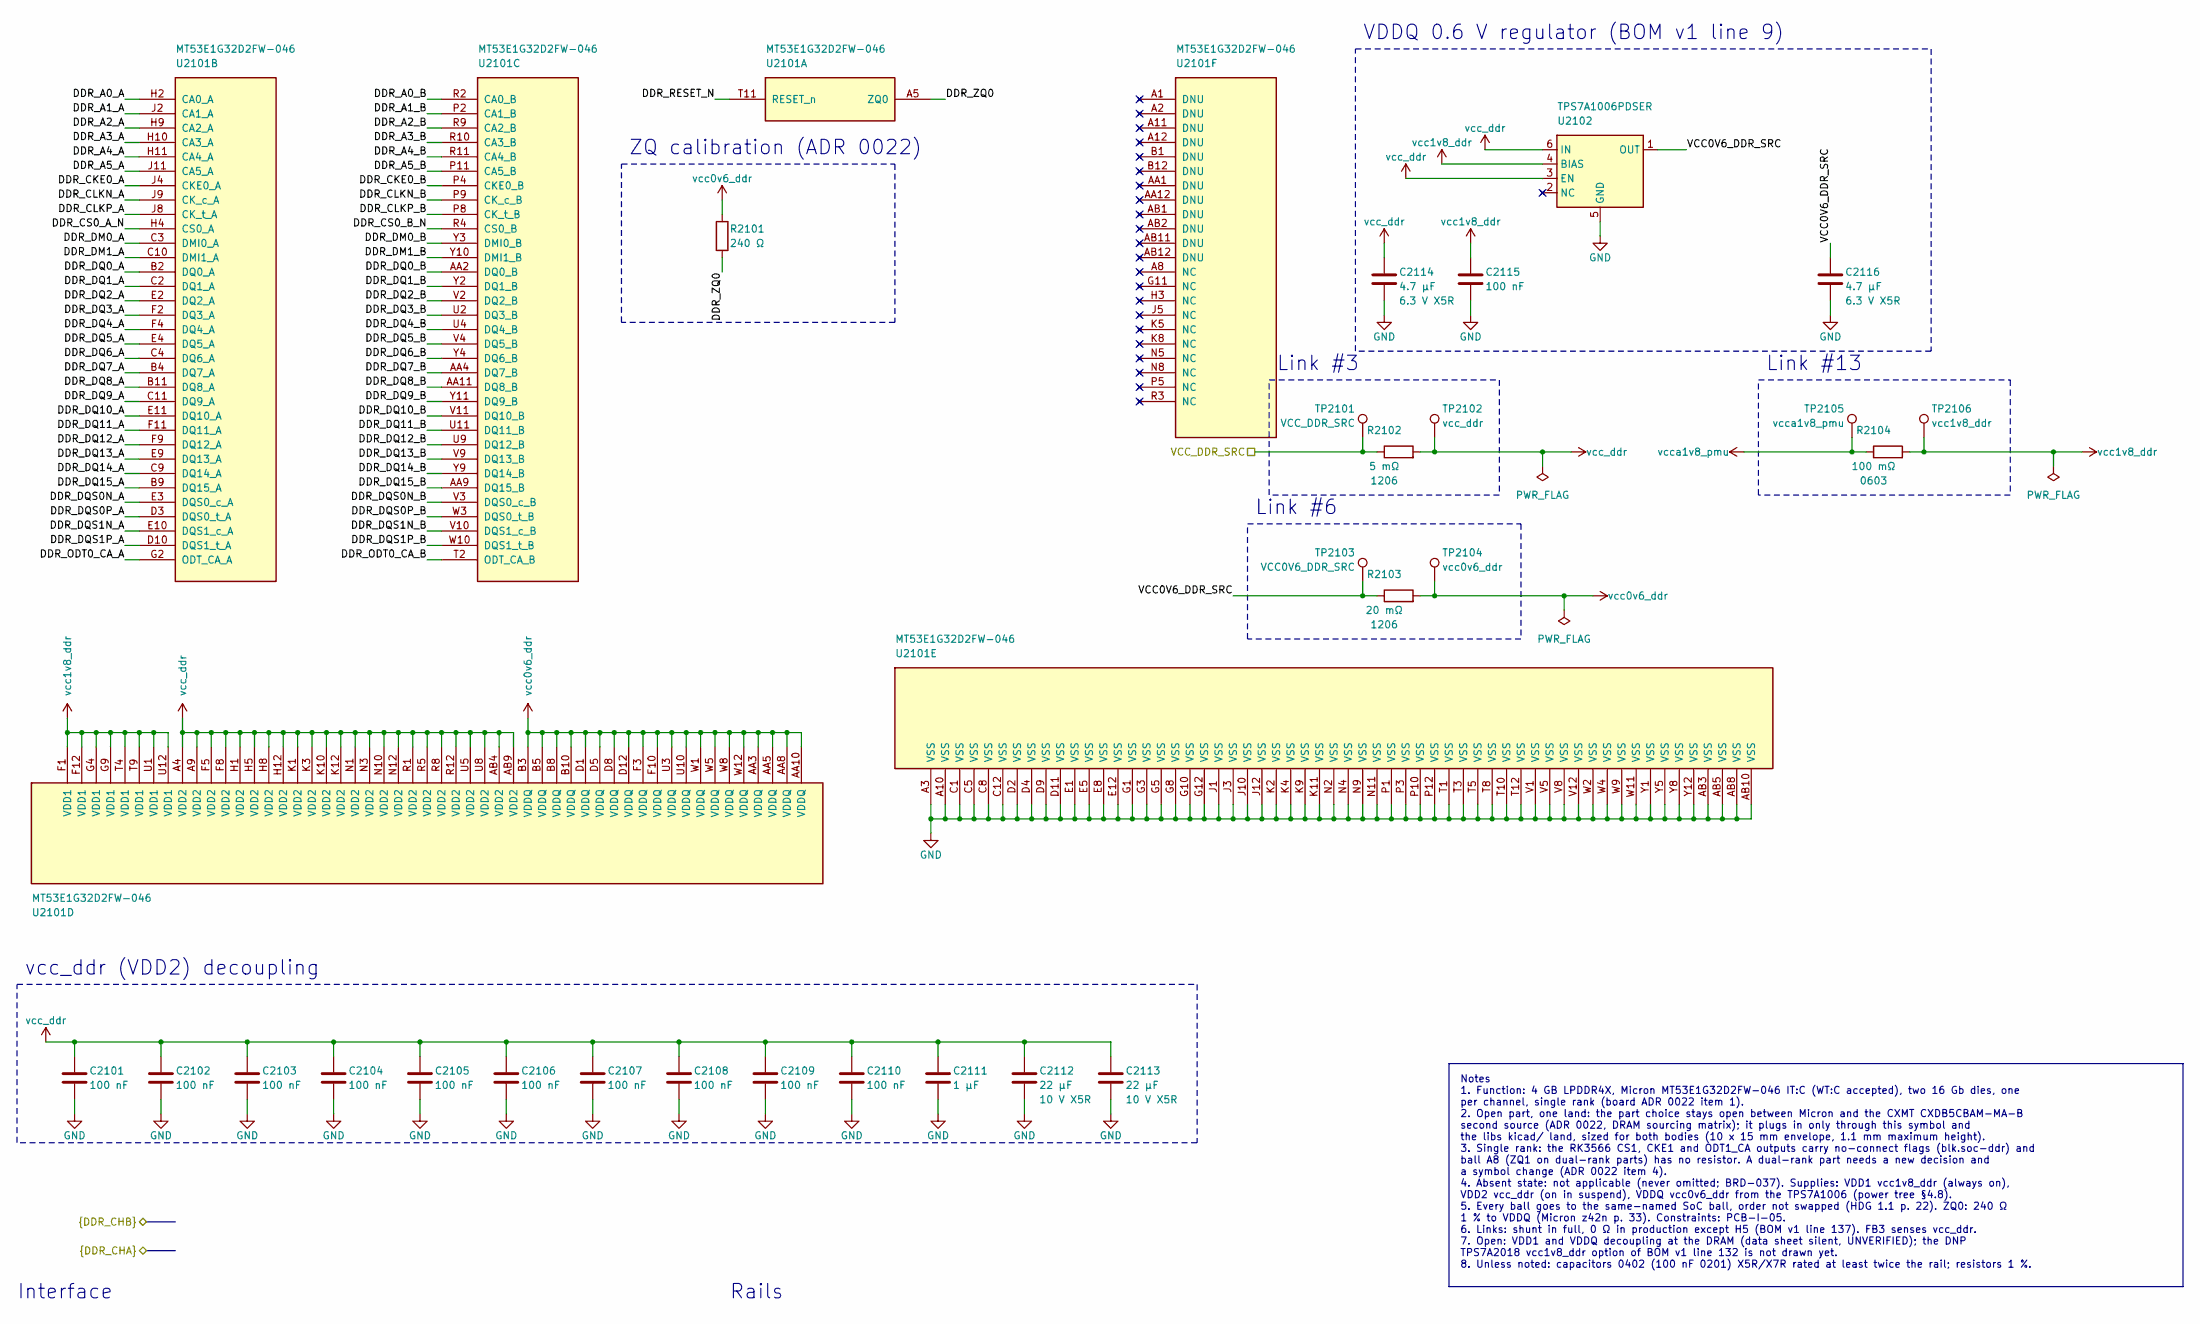
[picture p18: schematic lpddr4x.kicad_sch, LPDDR4X memory]

Parts:
C2101, C2102, C2103, C2104, C2105, C2106, C2107, C2108, C2109, C2110, C2115: 100 nF; C_0201_0603Metric; MPN GRM033R61A104KE15D
C2111: 1 µF; C_0402_1005Metric; MPN GRM155C71A105KE11D
C2112, C2113: 22 µF; C_0603_1608Metric; MPN GRM188R61A226ME15D
C2114, C2116: 4.7 µF; C_0402_1005Metric; MPN GRM155R60J475ME47D
R2101: 240 Ω; R_0201_0603Metric; MPN RC0201FR-07240RL
R2102: 5 mΩ; R_Vishay_WSL1206_2m-5m9; MPN WSL12065L000FEA
R2103: 20 mΩ; R_Vishay_WSL1206_6m-200m; MPN WSL1206R0200FEA
R2104: 100 mΩ; R_0603_1608Metric; MPN RL0603FR-070R1L
TP2101: VCC_DDR_SRC; TestPoint_Pad_D1.0mm
TP2102: vcc_ddr; TestPoint_Pad_D1.0mm
TP2103: VCC0V6_DDR_SRC; TestPoint_Pad_D1.0mm
TP2104: vcc0v6_ddr; TestPoint_Pad_D1.0mm
TP2105: vcca1v8_pmu; TestPoint_Pad_D1.0mm
TP2106: vcc1v8_ddr; TestPoint_Pad_D1.0mm
U2101: MT53E1G32D2FW-046; LPDDR4_FBGA-200_10.0x15.0mm_Layout12x22_P0.8x0.65mm_Pad0.3m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; MPN MT53E1G32D2FW-046 IT:C
U2102: TPS7A1006PDSER; WSON-6_1.5x1.5mm_P0.5mm; MPN TPS7A1006PDSER

Connections:
/LPDDR4X memory/DDR_A0_A: U2101.H2 (CA0_A); also elsewhere on the board
/LPDDR4X memory/DDR_A0_B: U2101.R2 (CA0_B); also elsewhere on the board
/LPDDR4X memory/DDR_A1_A: U2101.J2 (CA1_A); also elsewhere on the board
/LPDDR4X memory/DDR_A1_B: U2101.P2 (CA1_B); also elsewhere on the board
/LPDDR4X memory/DDR_A2_A: U2101.H9 (CA2_A); also elsewhere on the board
/LPDDR4X memory/DDR_A2_B: U2101.R9 (CA2_B); also elsewhere on the board
/LPDDR4X memory/DDR_A3_A: U2101.H10 (CA3_A); also elsewhere on the board
/LPDDR4X memory/DDR_A3_B: U2101.R10 (CA3_B); also elsewhere on the board
/LPDDR4X memory/DDR_A4_A: U2101.H11 (CA4_A); also elsewhere on the board
/LPDDR4X memory/DDR_A4_B: U2101.R11 (CA4_B); also elsewhere on the board
/LPDDR4X memory/DDR_A5_A: U2101.J11 (CA5_A); also elsewhere on the board
/LPDDR4X memory/DDR_A5_B: U2101.P11 (CA5_B); also elsewhere on the board
/LPDDR4X memory/DDR_CKE0_A: U2101.J4 (CKE0_A); also elsewhere on the board
/LPDDR4X memory/DDR_CKE0_B: U2101.P4 (CKE0_B); also elsewhere on the board
/LPDDR4X memory/DDR_CLKN_A: U2101.J9 (CK_c_A); also elsewhere on the board
/LPDDR4X memory/DDR_CLKN_B: U2101.P9 (CK_c_B); also elsewhere on the board
/LPDDR4X memory/DDR_CLKP_A: U2101.J8 (CK_t_A); also elsewhere on the board
/LPDDR4X memory/DDR_CLKP_B: U2101.P8 (CK_t_B); also elsewhere on the board
/LPDDR4X memory/DDR_CS0_A_N: U2101.H4 (CS0_A); also elsewhere on the board
/LPDDR4X memory/DDR_CS0_B_N: U2101.R4 (CS0_B); also elsewhere on the board
/LPDDR4X memory/DDR_DM0_A: U2101.C3 (DMI0_A); also elsewhere on the board
/LPDDR4X memory/DDR_DM0_B: U2101.Y3 (DMI0_B); also elsewhere on the board
/LPDDR4X memory/DDR_DM1_A: U2101.C10 (DMI1_A); also elsewhere on the board
/LPDDR4X memory/DDR_DM1_B: U2101.Y10 (DMI1_B); also elsewhere on the board
/LPDDR4X memory/DDR_DQ0_A: U2101.B2 (DQ0_A); also elsewhere on the board
/LPDDR4X memory/DDR_DQ0_B: U2101.AA2 (DQ0_B); also elsewhere on the board
/LPDDR4X memory/DDR_DQ1_A: U2101.C2 (DQ1_A); also elsewhere on the board
/LPDDR4X memory/DDR_DQ1_B: U2101.Y2 (DQ1_B); also elsewhere on the board
/LPDDR4X memory/DDR_DQ2_A: U2101.E2 (DQ2_A); also elsewhere on the board
/LPDDR4X memory/DDR_DQ2_B: U2101.V2 (DQ2_B); also elsewhere on the board
/LPDDR4X memory/DDR_DQ3_A: U2101.F2 (DQ3_A); also elsewhere on the board
/LPDDR4X memory/DDR_DQ3_B: U2101.U2 (DQ3_B); also elsewhere on the board
/LPDDR4X memory/DDR_DQ4_A: U2101.F4 (DQ4_A); also elsewhere on the board
/LPDDR4X memory/DDR_DQ4_B: U2101.U4 (DQ4_B); also elsewhere on the board
/LPDDR4X memory/DDR_DQ5_A: U2101.E4 (DQ5_A); also elsewhere on the board
/LPDDR4X memory/DDR_DQ5_B: U2101.V4 (DQ5_B); also elsewhere on the board
/LPDDR4X memory/DDR_DQ6_A: U2101.C4 (DQ6_A); also elsewhere on the board
/LPDDR4X memory/DDR_DQ6_B: U2101.Y4 (DQ6_B); also elsewhere on the board
/LPDDR4X memory/DDR_DQ7_A: U2101.B4 (DQ7_A); also elsewhere on the board
/LPDDR4X memory/DDR_DQ7_B: U2101.AA4 (DQ7_B); also elsewhere on the board
/LPDDR4X memory/DDR_DQ8_A: U2101.B11 (DQ8_A); also elsewhere on the board
/LPDDR4X memory/DDR_DQ8_B: U2101.AA11 (DQ8_B); also elsewhere on the board
/LPDDR4X memory/DDR_DQ9_A: U2101.C11 (DQ9_A); also elsewhere on the board
/LPDDR4X memory/DDR_DQ9_B: U2101.Y11 (DQ9_B); also elsewhere on the board
/LPDDR4X memory/DDR_DQ10_A: U2101.E11 (DQ10_A); also elsewhere on the board
/LPDDR4X memory/DDR_DQ10_B: U2101.V11 (DQ10_B); also elsewhere on the board
/LPDDR4X memory/DDR_DQ11_A: U2101.F11 (DQ11_A); also elsewhere on the board
/LPDDR4X memory/DDR_DQ11_B: U2101.U11 (DQ11_B); also elsewhere on the board
/LPDDR4X memory/DDR_DQ12_A: U2101.F9 (DQ12_A); also elsewhere on the board
/LPDDR4X memory/DDR_DQ12_B: U2101.U9 (DQ12_B); also elsewhere on the board
/LPDDR4X memory/DDR_DQ13_A: U2101.E9 (DQ13_A); also elsewhere on the board
/LPDDR4X memory/DDR_DQ13_B: U2101.V9 (DQ13_B); also elsewhere on the board
/LPDDR4X memory/DDR_DQ14_A: U2101.C9 (DQ14_A); also elsewhere on the board
/LPDDR4X memory/DDR_DQ14_B: U2101.Y9 (DQ14_B); also elsewhere on the board
/LPDDR4X memory/DDR_DQ15_A: U2101.B9 (DQ15_A); also elsewhere on the board
/LPDDR4X memory/DDR_DQ15_B: U2101.AA9 (DQ15_B); also elsewhere on the board
/LPDDR4X memory/DDR_DQS0N_A: U2101.E3 (DQS0_c_A); also elsewhere on the board
/LPDDR4X memory/DDR_DQS0N_B: U2101.V3 (DQS0_c_B); also elsewhere on the board
/LPDDR4X memory/DDR_DQS0P_A: U2101.D3 (DQS0_t_A); also elsewhere on the board
/LPDDR4X memory/DDR_DQS0P_B: U2101.W3 (DQS0_t_B); also elsewhere on the board
/LPDDR4X memory/DDR_DQS1N_A: U2101.E10 (DQS1_c_A); also elsewhere on the board
/LPDDR4X memory/DDR_DQS1N_B: U2101.V10 (DQS1_c_B); also elsewhere on the board
/LPDDR4X memory/DDR_DQS1P_A: U2101.D10 (DQS1_t_A); also elsewhere on the board
/LPDDR4X memory/DDR_DQS1P_B: U2101.W10 (DQS1_t_B); also elsewhere on the board
/LPDDR4X memory/DDR_ODT0_CA_A: U2101.G2 (ODT_CA_A); also elsewhere on the board
/LPDDR4X memory/DDR_ODT0_CA_B: U2101.T2 (ODT_CA_B); also elsewhere on the board
/LPDDR4X memory/DDR_RESET_N: U2101.T11 (RESET_n); also elsewhere on the board
/LPDDR4X memory/DDR_ZQ0: R2101.2, U2101.A5 (ZQ0)
/LPDDR4X memory/VCC0V6_DDR_SRC: C2116.1, R2103.1, TP2103.1, U2102.1 (OUT)
/VCC_DDR_SRC: R2102.1, TP2101.1; also elsewhere on the board
GND: C2101.2, C2102.2, C2103.2, C2104.2, C2105.2, C2106.2, C2107.2, C2108.2, C2109.2, C2110.2, C2111.2, C2112.2, C2113.2, C2114.2, C2115.2, C2116.2, U2101.A3 (VSS), U2101.A10 (VSS), U2101.AB3 (VSS), U2101.AB5 (VSS), U2101.AB8 (VSS), U2101.AB10 (VSS), U2101.C1 (VSS), U2101.C5 (VSS), U2101.C8 (VSS), U2101.C12 (VSS), U2101.D2 (VSS), U2101.D4 (VSS), U2101.D9 (VSS), U2101.D11 (VSS), U2101.E1 (VSS), U2101.E5 (VSS), U2101.E8 (VSS), U2101.E12 (VSS), U2101.G1 (VSS), U2101.G3 (VSS), U2101.G5 (VSS), U2101.G8 (VSS), U2101.G10 (VSS), U2101.G12 (VSS), U2101.J1 (VSS), U2101.J3 (VSS), U2101.J10 (VSS), U2101.J12 (VSS), U2101.K2 (VSS), U2101.K4 (VSS), U2101.K9 (VSS), U2101.K11 (VSS), U2101.N2 (VSS), U2101.N4 (VSS), U2101.N9 (VSS), U2101.N11 (VSS), U2101.P1 (VSS), U2101.P3 (VSS), U2101.P10 (VSS), U2101.P12 (VSS), U2101.T1 (VSS), U2101.T3 (VSS), U2101.T5 (VSS), U2101.T8 (VSS), U2101.T10 (VSS), U2101.T12 (VSS), U2101.V1 (VSS), U2101.V5 (VSS), U2101.V8 (VSS), U2101.V12 (VSS), U2101.W2 (VSS), U2101.W4 (VSS), U2101.W9 (VSS), U2101.W11 (VSS), U2101.Y1 (VSS), U2101.Y5 (VSS), U2101.Y8 (VSS), U2101.Y12 (VSS), U2102.5 (GND); also elsewhere on the board
vcc0v6_ddr: R2101.1, R2103.2, TP2104.1, U2101.AA3 (VDDQ), U2101.AA5 (VDDQ), U2101.AA8 (VDDQ), U2101.AA10 (VDDQ), U2101.B3 (VDDQ), U2101.B5 (VDDQ), U2101.B8 (VDDQ), U2101.B10 (VDDQ), U2101.D1 (VDDQ), U2101.D5 (VDDQ), U2101.D8 (VDDQ), U2101.D12 (VDDQ), U2101.F3 (VDDQ), U2101.F10 (VDDQ), U2101.U3 (VDDQ), U2101.U10 (VDDQ), U2101.W1 (VDDQ), U2101.W5 (VDDQ), U2101.W8 (VDDQ), U2101.W12 (VDDQ); also elsewhere on the board
vcc1v8_ddr: C2115.1, R2104.2, TP2106.1, U2101.F1 (VDD1), U2101.F12 (VDD1), U2101.G4 (VDD1), U2101.G9 (VDD1), U2101.T4 (VDD1), U2101.T9 (VDD1), U2101.U1 (VDD1), U2101.U12 (VDD1), U2102.4 (BIAS)
vcc_ddr: C2101.1, C2102.1, C2103.1, C2104.1, C2105.1, C2106.1, C2107.1, C2108.1, C2109.1, C2110.1, C2111.1, C2112.1, C2113.1, C2114.1, R2102.2, TP2102.1, U2101.A4 (VDD2), U2101.A9 (VDD2), U2101.AB4 (VDD2), U2101.AB9 (VDD2), U2101.F5 (VDD2), U2101.F8 (VDD2), U2101.H1 (VDD2), U2101.H5 (VDD2), U2101.H8 (VDD2), U2101.H12 (VDD2), U2101.K1 (VDD2), U2101.K3 (VDD2), U2101.K10 (VDD2), U2101.K12 (VDD2), U2101.N1 (VDD2), U2101.N3 (VDD2), U2101.N10 (VDD2), U2101.N12 (VDD2), U2101.R1 (VDD2), U2101.R5 (VDD2), U2101.R8 (VDD2), U2101.R12 (VDD2), U2101.U5 (VDD2), U2101.U8 (VDD2), U2102.3 (EN), U2102.6 (IN); also elsewhere on the board
vcca1v8_pmu: R2104.1, TP2105.1; also elsewhere on the board

Notes on the sheet:
ZQ calibration (ADR 0022)
vcc_ddr (VDD2) decoupling
VDDQ 0.6 V regulator (BOM v1 line 9)
Link #3
Link #6
Link #13
Notes 1. Function: 4 GB LPDDR4X, Micron MT53E1G32D2FW-046 IT:C (WT:C accepted), two 16 Gb dies, one per channel, single rank (board ADR 0022 item 1). 2. Open part, one land: the part choice stays open between Micron and the CXMT CXDB5CBAM-MA-B second source (ADR 0022, DRAM sourcing matrix); it plug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
Interface
Rails

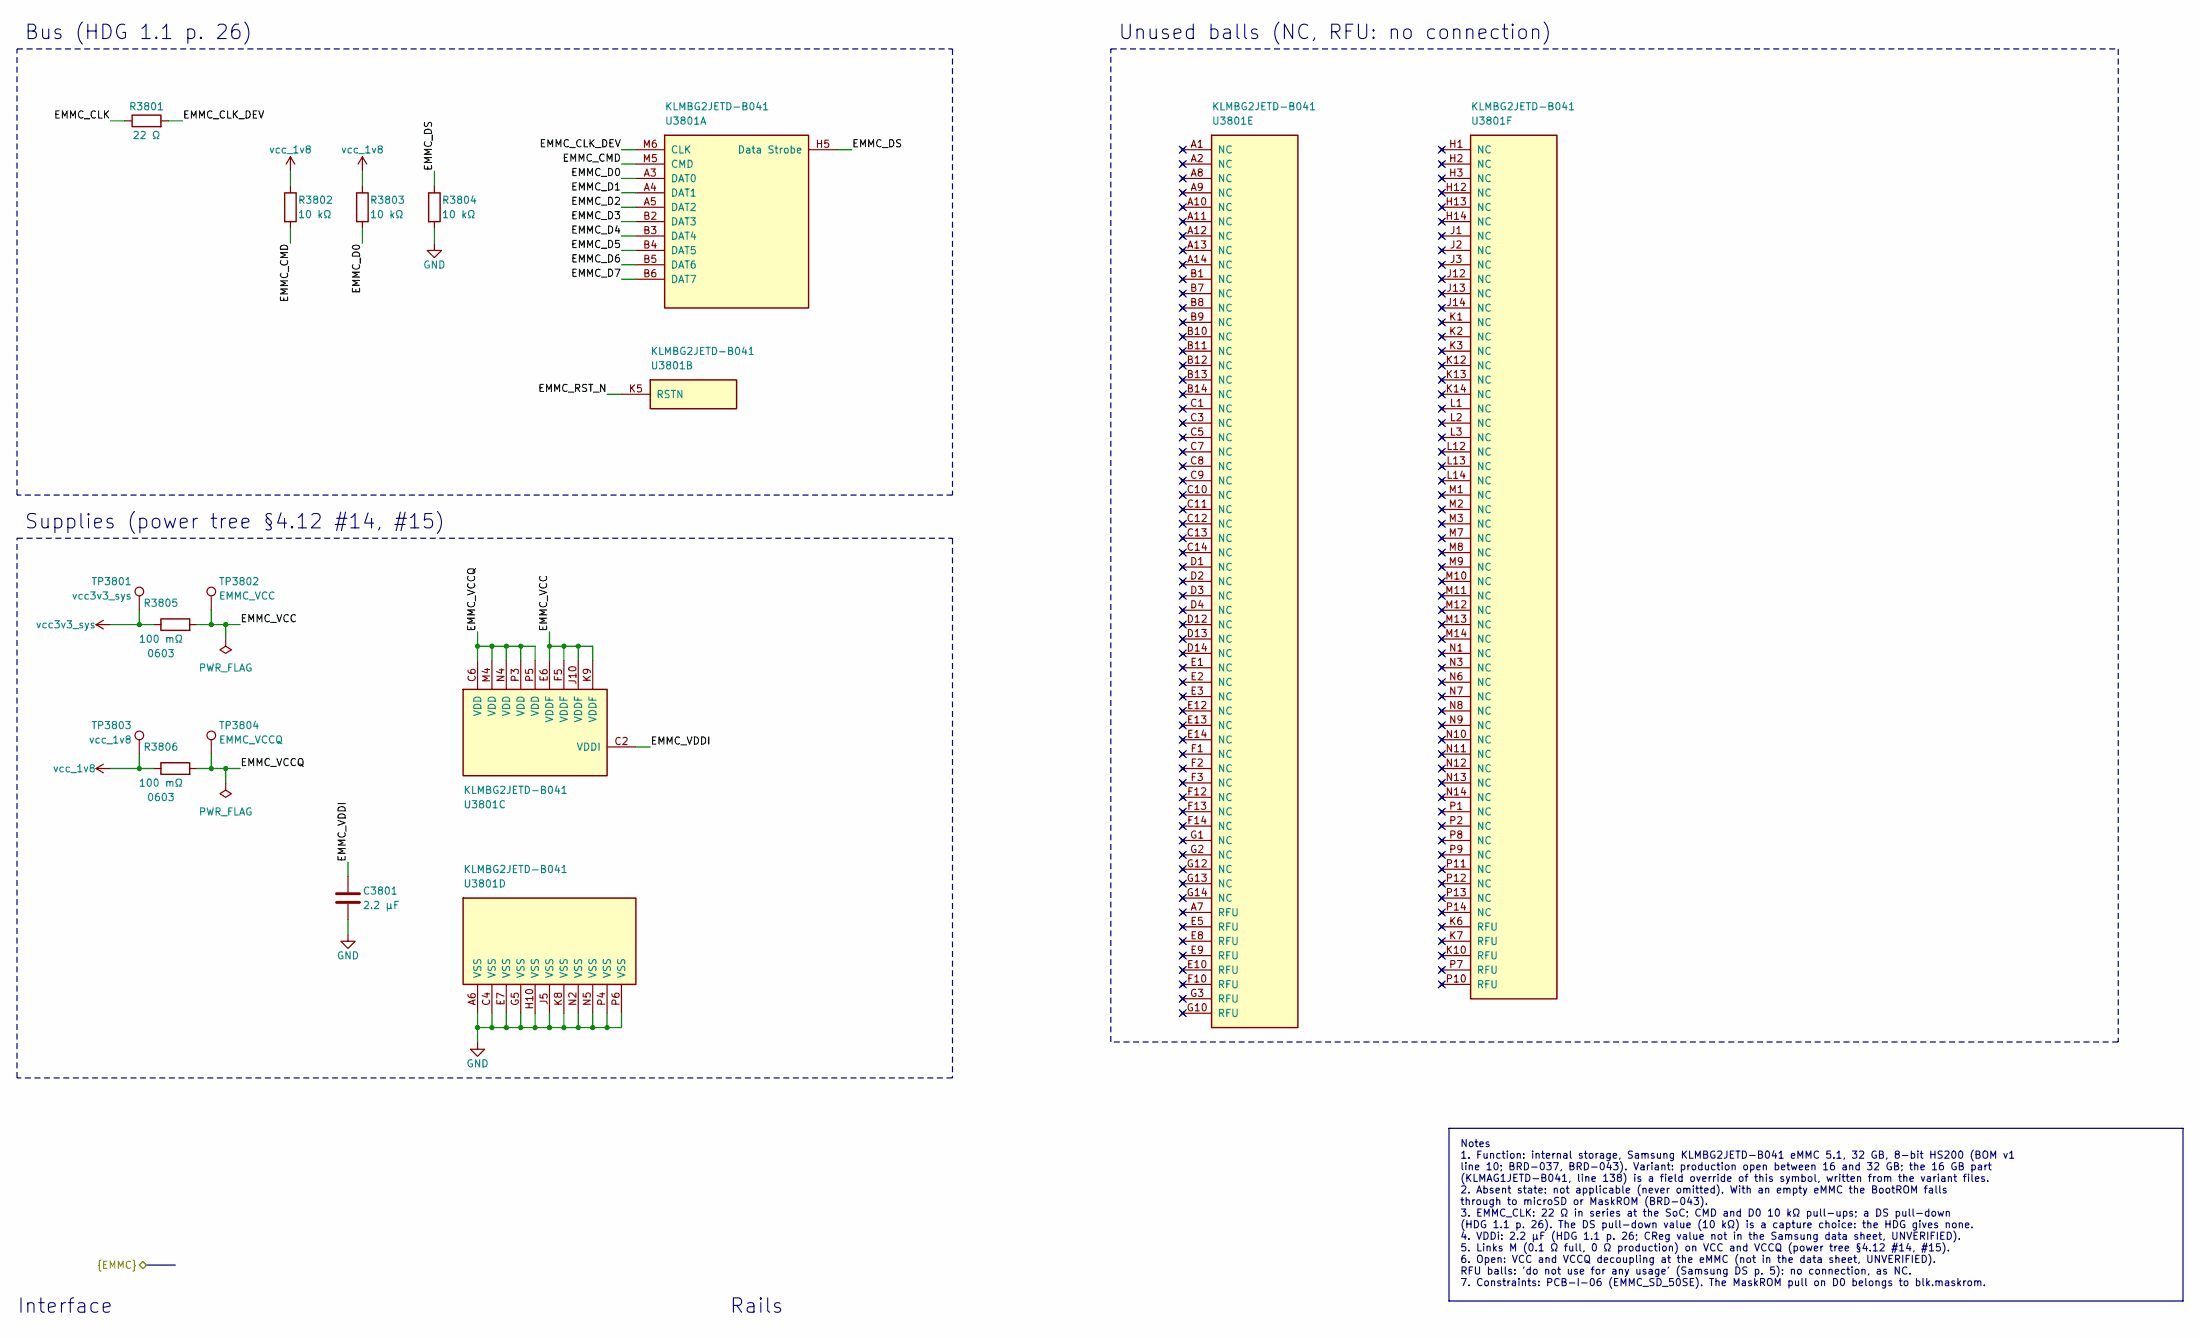
[picture p19: schematic emmc.kicad_sch, eMMC storage]

Parts:
C3801: 2.2 µF; C_0402_1005Metric; MPN GRM155R61A225KE95D
R3801: 22 Ω; R_0201_0603Metric; MPN RC0201FR-0722RL
R3802, R3803, R3804: 10 kΩ; R_0201_0603Metric; MPN RC0201FR-0710KL
R3805, R3806: 100 mΩ; R_0603_1608Metric; MPN RL0603FR-070R1L
TP3801: vcc3v3_sys; TestPoint_Pad_D1.0mm
TP3802: EMMC_VCC; TestPoint_Pad_D1.0mm
TP3803: vcc_1v8; TestPoint_Pad_D1.0mm
TP3804: EMMC_VCCQ; TestPoint_Pad_D1.0mm
U3801: KLMBG2JETD-B041; Samsung_FBGA-153_11.5x13.0mm_Layout14x14_P0.5mm_Ball0.3mm_P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; MPN KLMBG2JETD-B041

Connections:
/EMMC_CLK: R3801.1; also elsewhere on the board
/EMMC_CMD: R3802.2, U3801.M5 (CMD); also elsewhere on the board
/EMMC_D0: R3803.2, U3801.A3 (DAT0); also elsewhere on the board
/EMMC_D1: U3801.A4 (DAT1); also elsewhere on the board
/EMMC_D2: U3801.A5 (DAT2); also elsewhere on the board
/EMMC_D3: U3801.B2 (DAT3); also elsewhere on the board
/EMMC_D4: U3801.B3 (DAT4); also elsewhere on the board
/EMMC_D5: U3801.B4 (DAT5); also elsewhere on the board
/EMMC_D6: U3801.B5 (DAT6); also elsewhere on the board
/EMMC_D7: U3801.B6 (DAT7); also elsewhere on the board
/EMMC_DS: R3804.1, U3801.H5 (Data Strobe); also elsewhere on the board
/EMMC_RST_N: U3801.K5 (RSTN); also elsewhere on the board
/eMMC storage/EMMC_CLK_DEV: R3801.2, U3801.M6 (CLK)
/eMMC storage/EMMC_VCC: R3805.2, TP3802.1, U3801.E6 (VDDF), U3801.F5 (VDDF), U3801.J10 (VDDF), U3801.K9 (VDDF)
/eMMC storage/EMMC_VCCQ: R3806.2, TP3804.1, U3801.C6 (VDD), U3801.M4 (VDD), U3801.N4 (VDD), U3801.P3 (VDD), U3801.P5 (VDD)
/eMMC storage/EMMC_VDDI: C3801.1, U3801.C2 (VDDI)
GND: C3801.2, R3804.2, U3801.A6 (VSS), U3801.C4 (VSS), U3801.E7 (VSS), U3801.G5 (VSS), U3801.H10 (VSS), U3801.J5 (VSS), U3801.K8 (VSS), U3801.N2 (VSS), U3801.N5 (VSS), U3801.P4 (VSS), U3801.P6 (VSS); also elsewhere on the board
vcc3v3_sys: R3805.1, TP3801.1; also elsewhere on the board
vcc_1v8: R3802.1, R3803.1, R3806.1, TP3803.1; also elsewhere on the board

Notes on the sheet:
Bus (HDG 1.1 p. 26)
Supplies (power tree §4.12 #14, #15)
Unused balls (NC, RFU: no connection)
Notes 1. Function: internal storage, Samsung KLMBG2JETD-B041 eMMC 5.1, 32 GB, 8-bit HS200 (BOM v1 line 10; BRD-037, BRD-043). Variant: production open between 16 and 32 GB; the 16 GB part (KLMAG1JETD-B041, line 138) is a field override of this symbol, written from the variant files. 2. Absent state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
Interface
Rails

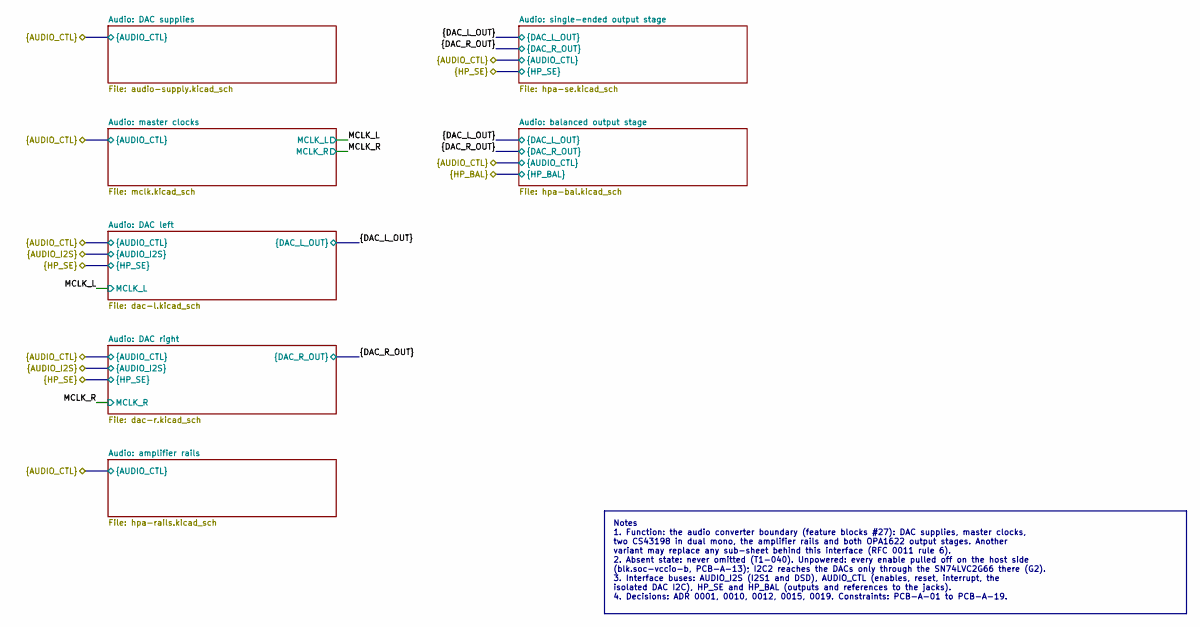
[picture p20: schematic audio.kicad_sch]

Notes on the sheet:
Notes 1. Function: the audio converter boundary (feature blocks #27): DAC supplies, master clocks, two CS43198 in dual mono, the amplifier rails and both OPA1622 output stages. Another variant may replace any sub-sheet behind this interface (RFC 0011 rule 6). 2. Absent state: never omitted (T1-040)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

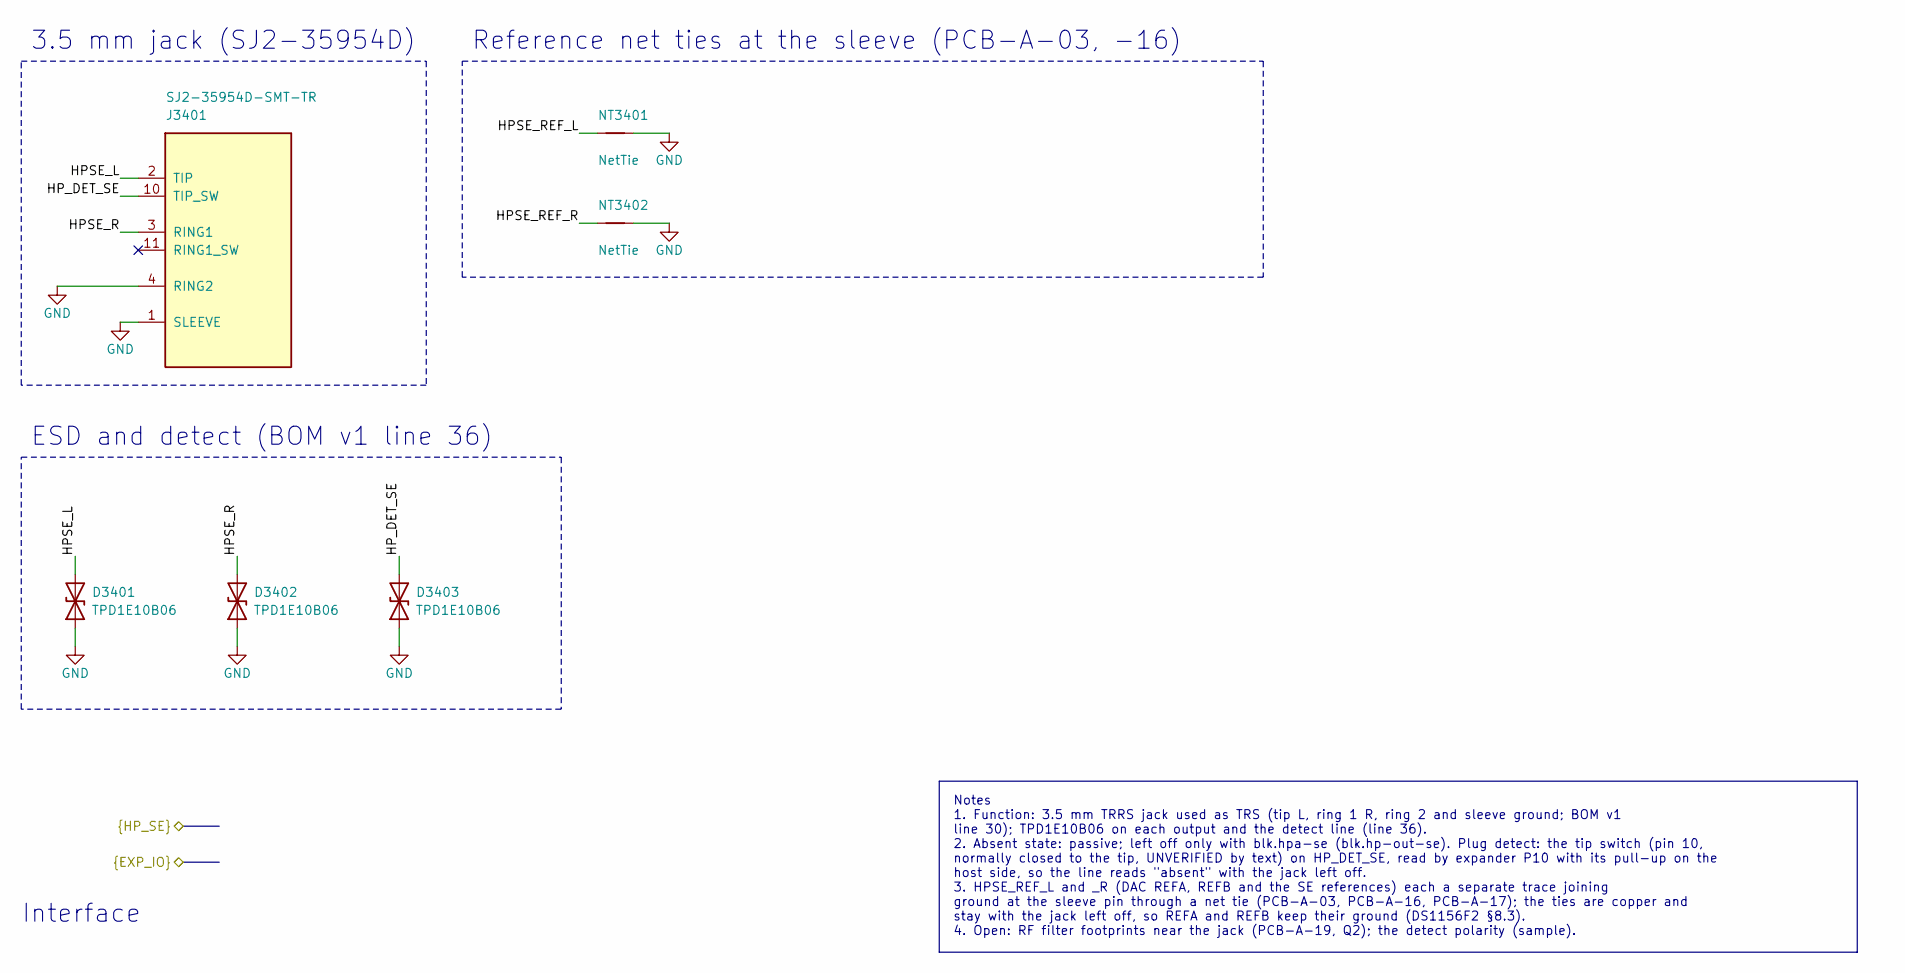
[picture p21: schematic jack-se.kicad_sch, 3.5 mm headphone jack]

Parts:
D3401, D3402, D3403: TPD1E10B06; Texas_DPY0002A_0.6x1mm_P0.65mm; MPN TPD1E10B06DPYR
J3401: SJ2-35954D-SMT-TR; Same_Sky_SJ2-35954D-SMT-TR_Jack_3.5mm_TRRS_Horizontal; MPN SJ2-35954D-SMT-TR
NT3401, NT3402: NetTie; NetTie-2_SMD_Pad0.5mm

Connections:
/HPSE_L: D3401.2 (A2), J3401.2 (TIP); also elsewhere on the board
/HPSE_R: D3402.2 (A2), J3401.3 (RING1); also elsewhere on the board
/HPSE_REF_L: NT3401.1; also elsewhere on the board
/HPSE_REF_R: NT3402.1; also elsewhere on the board
/HP_DET_SE: D3403.2 (A2), J3401.10 (TIP_SW); also elsewhere on the board
GND: D3401.1 (A1), D3402.1 (A1), D3403.1 (A1), J3401.1 (SLEEVE), J3401.4 (RING2), NT3401.2, NT3402.2; also elsewhere on the board

Notes on the sheet:
3.5 mm jack (SJ2-35954D)
Reference net ties at the sleeve (PCB-A-03, -16)
ESD and detect (BOM v1 line 36)
Notes 1. Function: 3.5 mm TRRS jack used as TRS (tip L, ring 1 R, ring 2 and sleeve ground; BOM v1 line 30); TPD1E10B06 on each output and the detect line (line 36). 2. Absent state: passive; left off only with blk.hpa-se (blk.hp-out-se). Plug detect: the tip switch (pin 10, normally closed to the 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
Interface
