opendap-project/t1/board/hardware/t1-main-board/t1-main-board.kicad_pcb

## KiCad design board/hardware/t1-main-board/t1-main-board.kicad_pcb (continued)

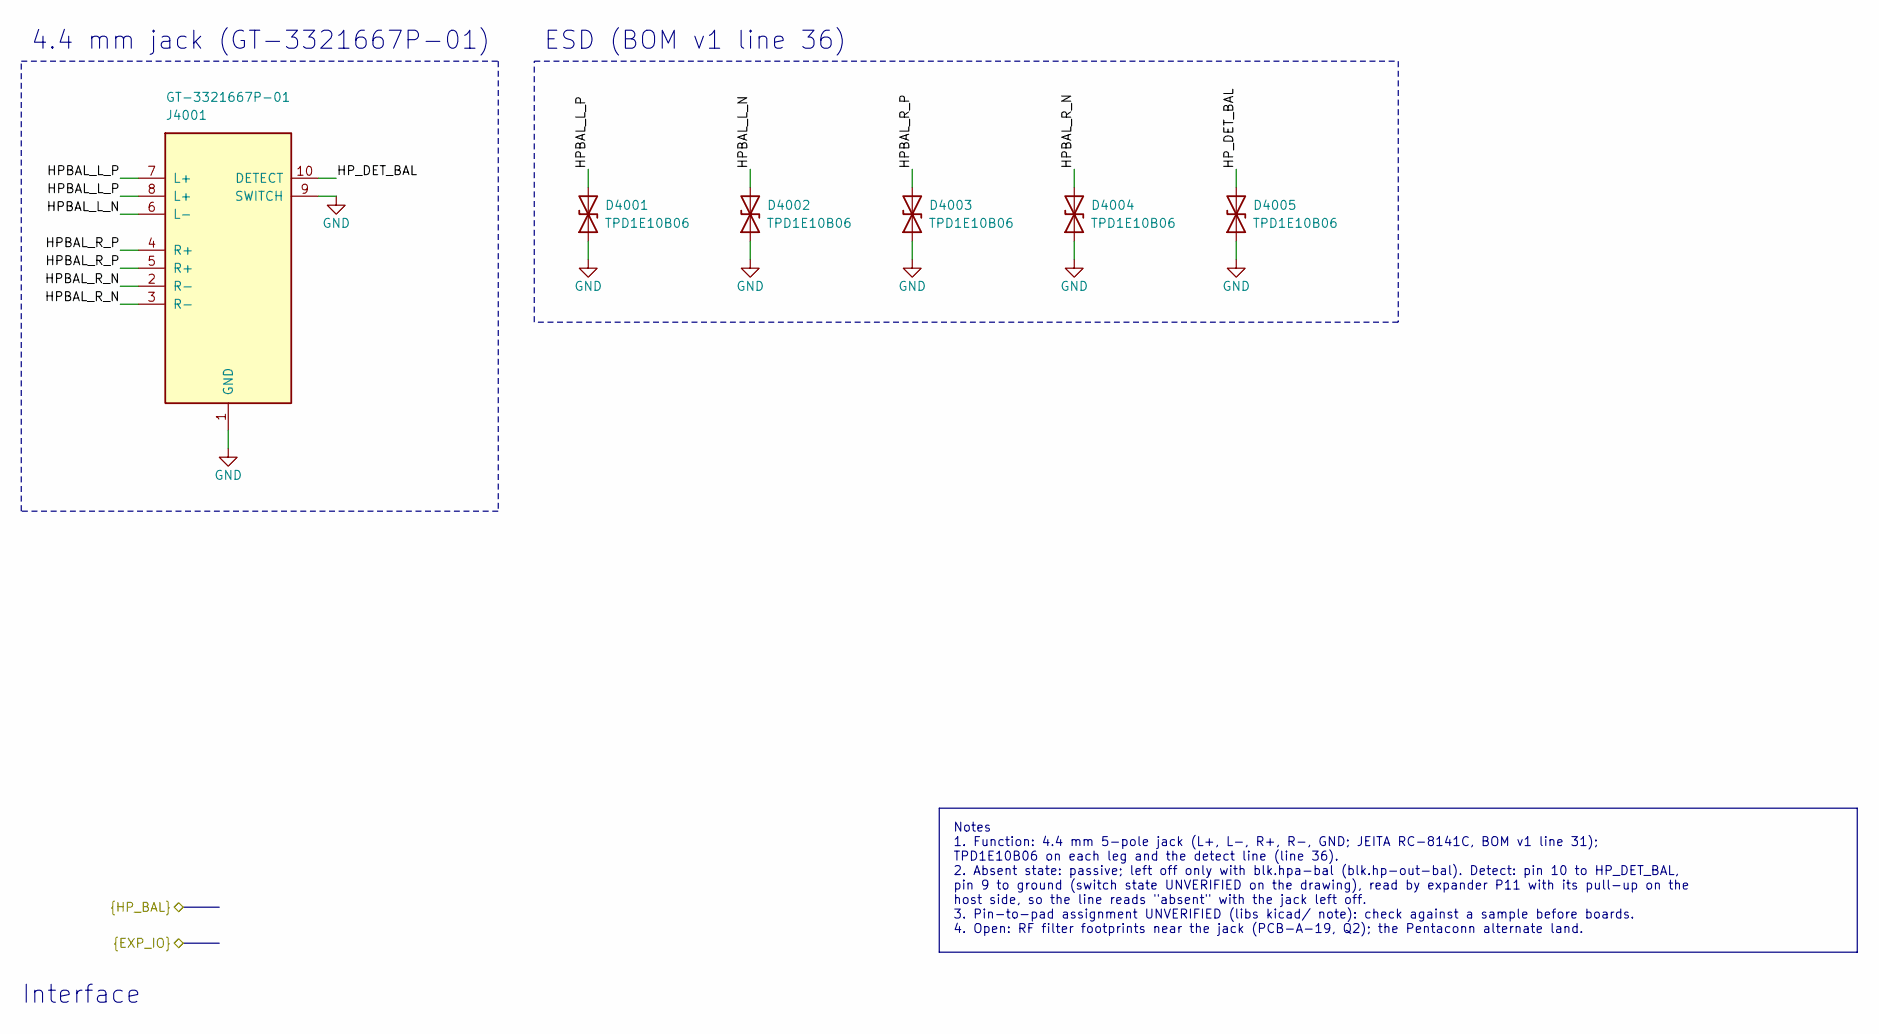
[picture p22: schematic jack-bal.kicad_sch, 4.4 mm headphone jack]

Parts:
D4001, D4002, D4003, D4004, D4005: TPD1E10B06; Texas_DPY0002A_0.6x1mm_P0.65mm; MPN TPD1E10B06DPYR
J4001: GT-3321667P-01; G_Switch_GT-3321667P-01_Jack_4.4mm_5Pole_Horizontal; MPN GT-3321667P-01

Connections:
/HPBAL_L_N: D4002.2 (A2), J4001.6 (L-); also elsewhere on the board
/HPBAL_L_P: D4001.2 (A2), J4001.7 (L+), J4001.8 (L+); also elsewhere on the board
/HPBAL_R_N: D4004.2 (A2), J4001.2 (R-), J4001.3 (R-); also elsewhere on the board
/HPBAL_R_P: D4003.2 (A2), J4001.4 (R+), J4001.5 (R+); also elsewhere on the board
/HP_DET_BAL: D4005.2 (A2), J4001.10 (DETECT); also elsewhere on the board
GND: D4001.1 (A1), D4002.1 (A1), D4003.1 (A1), D4004.1 (A1), D4005.1 (A1), J4001.1 (GND), J4001.9 (SWITCH); also elsewhere on the board

Notes on the sheet:
4.4 mm jack (GT-3321667P-01)
ESD (BOM v1 line 36)
Notes 1. Function: 4.4 mm 5-pole jack (L+, L-, R+, R-, GND; JEITA RC-8141C, BOM v1 line 31); TPD1E10B06 on each leg and the detect line (line 36). 2. Absent state: passive; left off only with blk.hpa-bal (blk.hp-out-bal). Detect: pin 10 to HP_DET_BAL, pin 9 to ground (switch state UNVERIFIED on the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
Interface

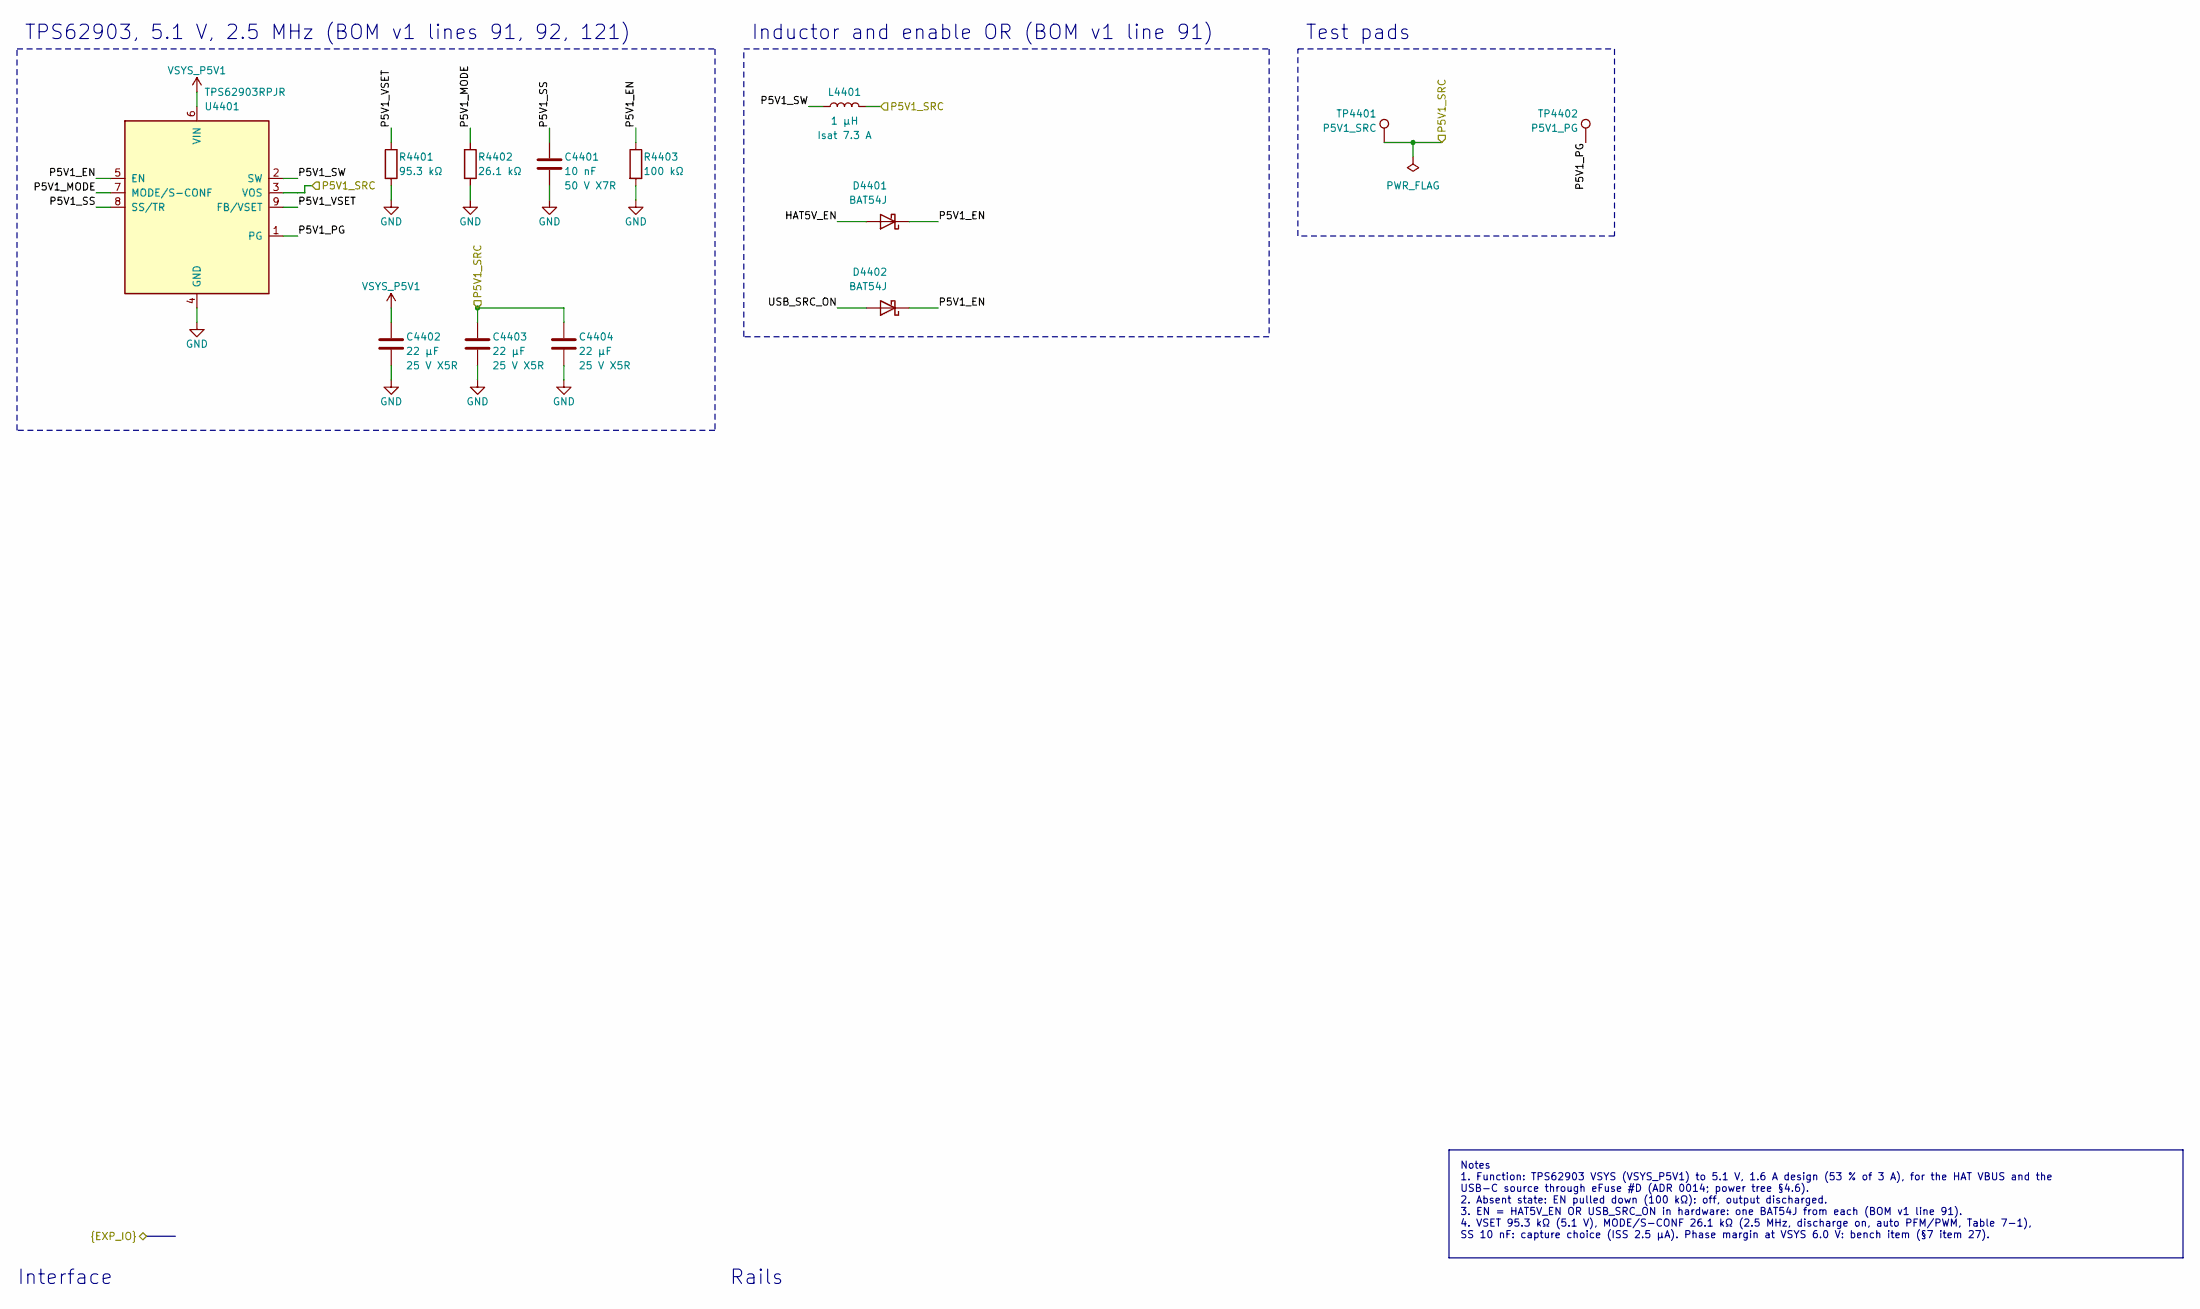
[picture p23: schematic pwr-5v1.kicad_sch, 5.1 V source]

Parts:
C4401: 10 nF; C_0402_1005Metric; MPN GRM155R71H103KA88D
C4402, C4403, C4404: 22 µF; C_0805_2012Metric; MPN GRM21BR61E226ME44L
D4401, D4402: BAT54J; D_SOD-323F; MPN BAT54J,115
L4401: 1 µH; L_Coilcraft_XxL4020; MPN XGL4015-102MEC
R4401: 95.3 kΩ; R_0201_0603Metric; MPN RC0201FR-0795K3L
R4402: 26.1 kΩ; R_0201_0603Metric; MPN RC0201FR-0726K1L
R4403: 100 kΩ; R_0201_0603Metric; MPN RC0201FR-07100KL
TP4401: P5V1_SRC; TestPoint_Pad_D1.0mm
TP4402: P5V1_PG; TestPoint_Pad_D0.8mm
U4401: TPS62903RPJR; Texas_RPJ0009A_VQFN-HR-9_1.5x2mm_P0.5mm; MPN TPS62903RPJR

Connections:
/5.1 V source/P5V1_EN: D4401.1 (K), D4402.1 (K), R4403.1, U4401.5 (EN)
/5.1 V source/P5V1_MODE: R4402.1, U4401.7 (MODE/S-CONF)
/5.1 V source/P5V1_PG: TP4402.1, U4401.1 (PG)
/5.1 V source/P5V1_SS: C4401.1, U4401.8 (SS/TR)
/5.1 V source/P5V1_SW: L4401.1, U4401.2 (SW)
/5.1 V source/P5V1_VSET: R4401.1, U4401.9 (FB/VSET)
/HAT5V_EN: D4401.2 (A); also elsewhere on the board
/P5V1_SRC: C4403.1, C4404.1, L4401.2, TP4401.1, U4401.3 (VOS); also elsewhere on the board
/USB_SRC_ON: D4402.2 (A); also elsewhere on the board
GND: C4401.2, C4402.2, C4403.2, C4404.2, R4401.2, R4402.2, R4403.2, U4401.4 (GND); also elsewhere on the board
VSYS_P5V1: C4402.1, U4401.6 (VIN); also elsewhere on the board

Notes on the sheet:
TPS62903, 5.1 V, 2.5 MHz (BOM v1 lines 91, 92, 121)
Inductor and enable OR (BOM v1 line 91)
Test pads
Notes 1. Function: TPS62903 VSYS (VSYS_P5V1) to 5.1 V, 1.6 A design (53 % of 3 A), for the HAT VBUS and the USB-C source through eFuse #D (ADR 0014; power tree §4.6). 2. Absent state: EN pulled down (100 kΩ): off, output discharged. 3. EN = HAT5V_EN OR USB_SRC_ON in hardware: one BAT54J from each (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
Interface
Rails

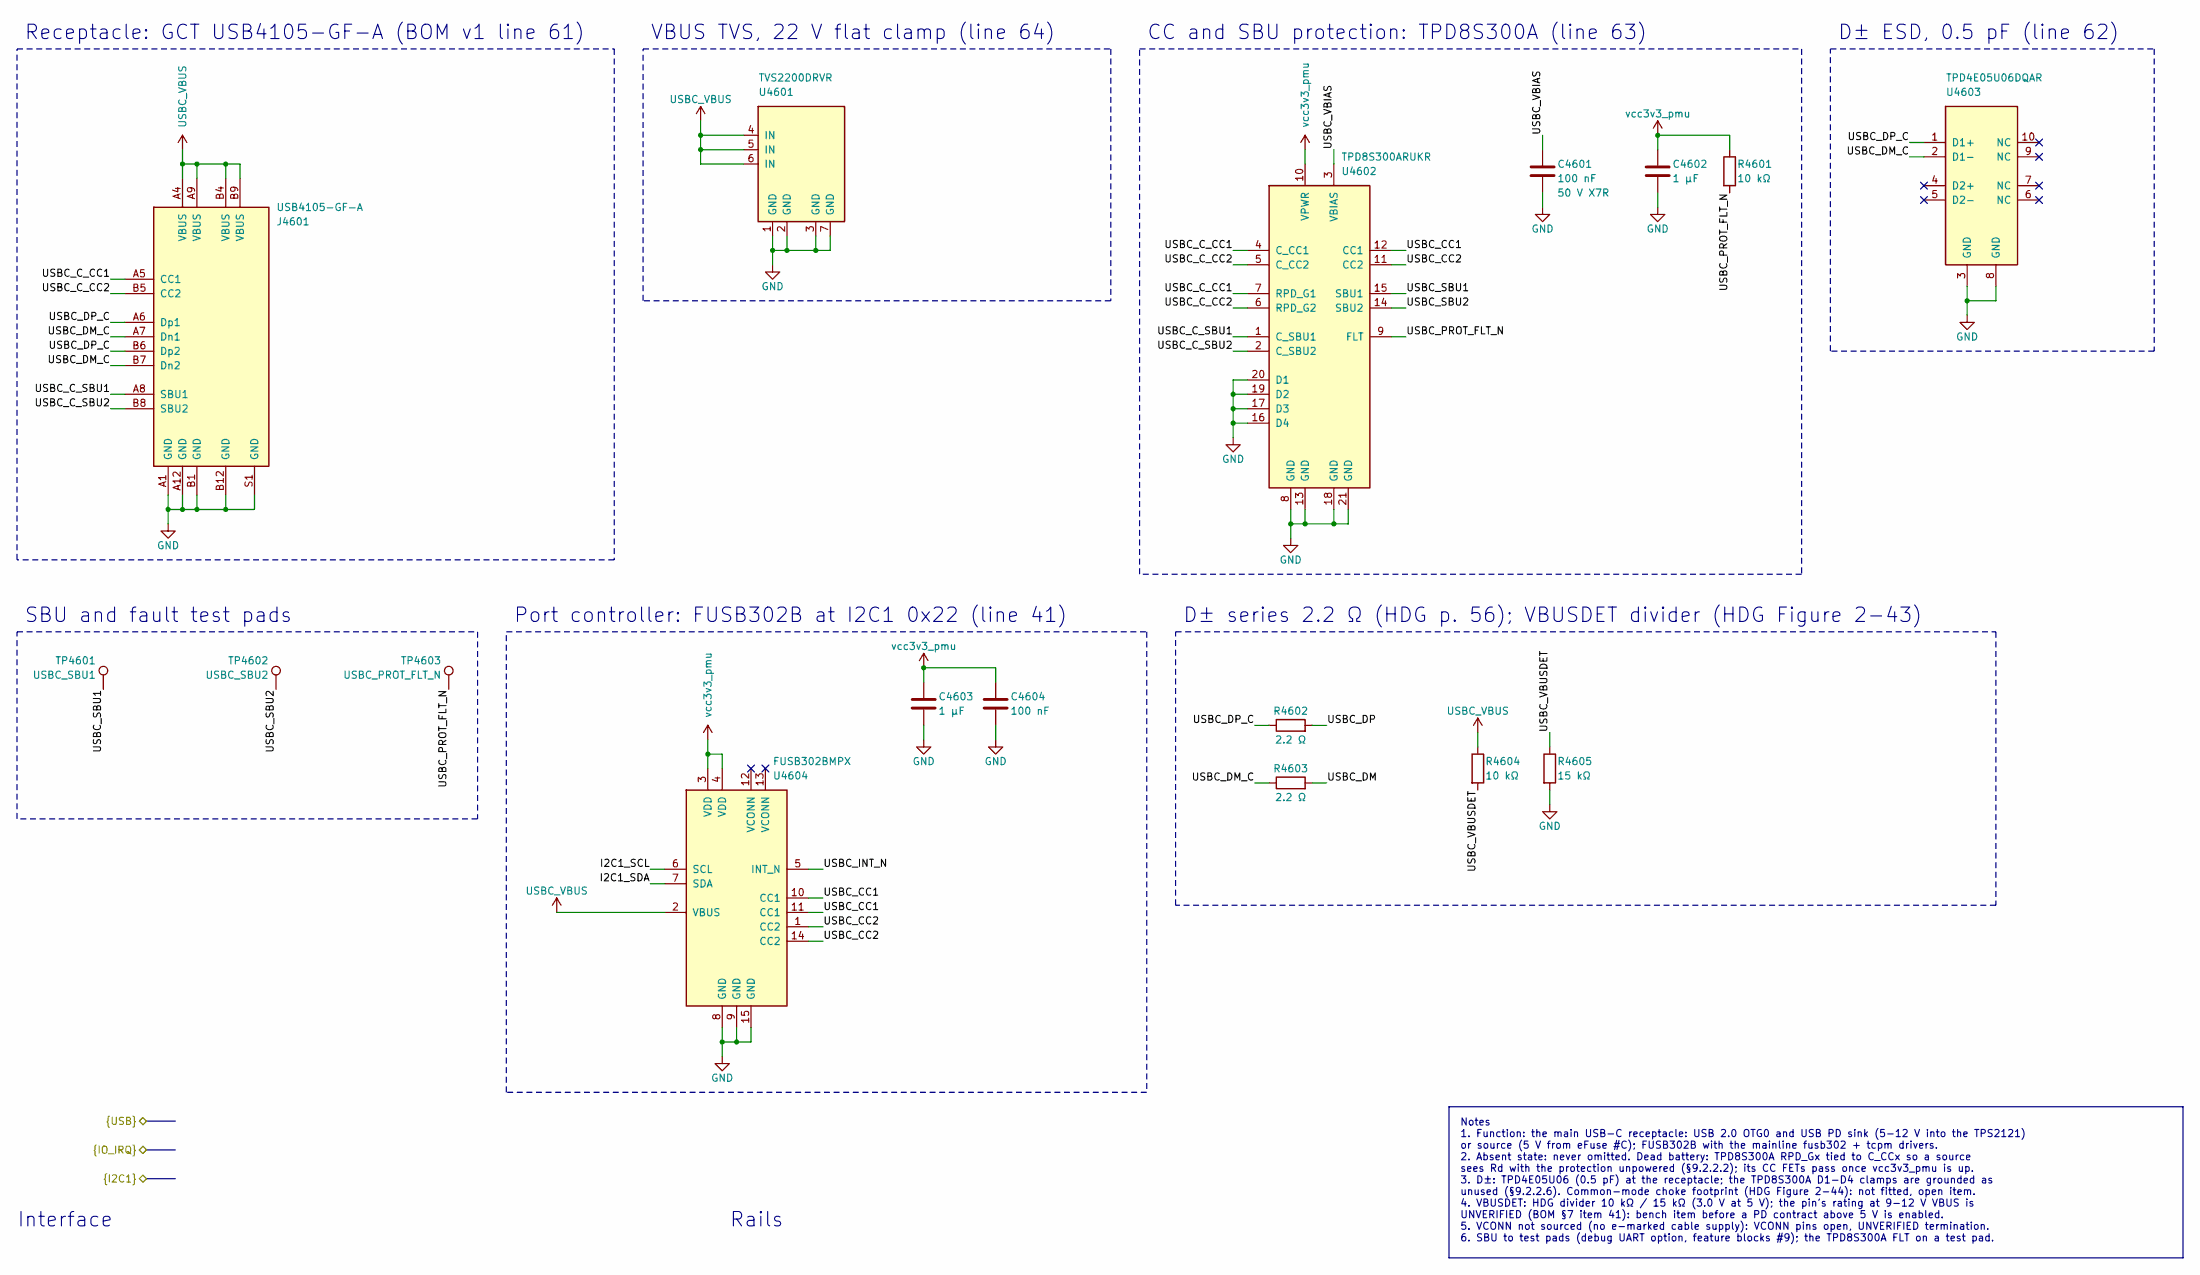
[picture p24: schematic usb-c.kicad_sch, Main USB-C port]

Parts:
C4601: 100 nF; C_0603_1608Metric; MPN GRM188R71H104KA93D
C4602, C4603: 1 µF; C_0402_1005Metric; MPN GRM155C71A105KE11D
C4604: 100 nF; C_0201_0603Metric; MPN GRM033R61A104KE15D
J4601: USB4105-GF-A; GCT_USB4105-GF-A_USB-C_Receptacle_USB2.0_Horizontal; MPN USB4105-GF-A
R4601, R4604: 10 kΩ; R_0402_1005Metric; MPN RC0402FR-0710KL
R4602, R4603: 2.2 Ω; R_0402_1005Metric; MPN RC0402FR-072R2L
R4605: 15 kΩ; R_0402_1005Metric; MPN RC0402FR-0715KL
TP4601: USBC_SBU1; TestPoint_Pad_D0.8mm
TP4602: USBC_SBU2; TestPoint_Pad_D0.8mm
TP4603: USBC_PROT_FLT_N; TestPoint_Pad_D0.8mm
U4601: TVS2200DRVR; Texas_DRV0006A_WSON-6-1EP_2x2mm_P0.65mm_EP1x1.6mm; MPN TVS2200DRVR
U4602: TPD8S300ARUKR; Texas_RUK0020B_WQFN-20-1EP_3x3mm_P0.4mm_EP1.7x1.7mm; MPN TPD8S300ARUKR
U4603: TPD4E05U06DQAR; Texas_DQA0010A_USON-10_1x2.5mm_P0.5mm; MPN TPD4E05U06DQAR
U4604: FUSB302BMPX; onsemi_510BR_WQFN-14-1EP_2.5x2.5mm_P0.5mm_EP1.45x1.45mm; MPN FUSB302BMPX

Connections:
/I2C1_SCL: U4604.6 (SCL); also elsewhere on the board
/I2C1_SDA: U4604.7 (SDA); also elsewhere on the board
/Main USB-C port/USBC_CC1: U4602.12 (CC1), U4604.10 (CC1), U4604.11 (CC1)
/Main USB-C port/USBC_CC2: U4602.11 (CC2), U4604.1 (CC2), U4604.14 (CC2)
/Main USB-C port/USBC_C_CC1: J4601.A5 (CC1), U4602.4 (C_CC1), U4602.7 (RPD_G1)
/Main USB-C port/USBC_C_CC2: J4601.B5 (CC2), U4602.5 (C_CC2), U4602.6 (RPD_G2)
/Main USB-C port/USBC_C_SBU1: J4601.A8 (SBU1), U4602.1 (C_SBU1)
/Main USB-C port/USBC_C_SBU2: J4601.B8 (SBU2), U4602.2 (C_SBU2)
/Main USB-C port/USBC_DM_C: J4601.A7 (Dn1), J4601.B7 (Dn2), R4603.1, U4603.2 (D1-)
/Main USB-C port/USBC_DP_C: J4601.A6 (Dp1), J4601.B6 (Dp2), R4602.1, U4603.1 (D1+)
/Main USB-C port/USBC_PROT_FLT_N: R4601.2, TP4603.1, U4602.9 (FLT)
/Main USB-C port/USBC_SBU1: TP4601.1, U4602.15 (SBU1)
/Main USB-C port/USBC_SBU2: TP4602.1, U4602.14 (SBU2)
/Main USB-C port/USBC_VBIAS: C4601.1, U4602.3 (VBIAS)
/USBC_DM: R4603.2; also elsewhere on the board
/USBC_DP: R4602.2; also elsewhere on the board
/USBC_INT_N: U4604.5 (INT_N); also elsewhere on the board
/USBC_VBUSDET: R4604.2, R4605.1; also elsewhere on the board
GND: C4601.2, C4602.2, C4603.2, C4604.2, J4601.A1 (GND), J4601.A12 (GND), J4601.B1 (GND), J4601.B12 (GND), J4601.S1 (GND), R4605.2, U4601.1 (GND), U4601.2 (GND), U4601.3 (GND), U4601.7 (GND), U4602.8 (GND), U4602.13 (GND), U4602.16 (D4), U4602.17 (D3), U4602.18 (GND), U4602.19 (D2), U4602.20 (D1), U4602.21 (GND), U4603.3 (GND), U4603.8 (GND), U4604.8 (GND), U4604.9 (GND), U4604.15 (GND); also elsewhere on the board
USBC_VBUS: J4601.A4 (VBUS), J4601.A9 (VBUS), J4601.B4 (VBUS), J4601.B9 (VBUS), R4604.1, U4601.4 (IN), U4601.5 (IN), U4601.6 (IN), U4604.2 (VBUS); also elsewhere on the board
vcc3v3_pmu: C4602.1, C4603.1, C4604.1, R4601.1, U4602.10 (VPWR), U4604.3 (VDD), U4604.4 (VDD); also elsewhere on the board

Notes on the sheet:
Receptacle: GCT USB4105-GF-A (BOM v1 line 61)
VBUS TVS, 22 V flat clamp (line 64)
CC and SBU protection: TPD8S300A (line 63)
D± ESD, 0.5 pF (line 62)
SBU and fault test pads
Port controller: FUSB302B at I2C1 0x22 (line 41)
D± series 2.2 Ω (HDG p. 56); VBUSDET divider (HDG Figure 2-43)
Notes 1. Function: the main USB-C receptacle: USB 2.0 OTG0 and USB PD sink (5-12 V into the TPS2121) or source (5 V from eFuse #C); FUSB302B with the mainline fusb302 + tcpm drivers. 2. Absent state: never omitted. Dead battery: TPD8S300A RPD_Gx tied to C_CCx so a source sees Rd with the protection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
Interface
Rails

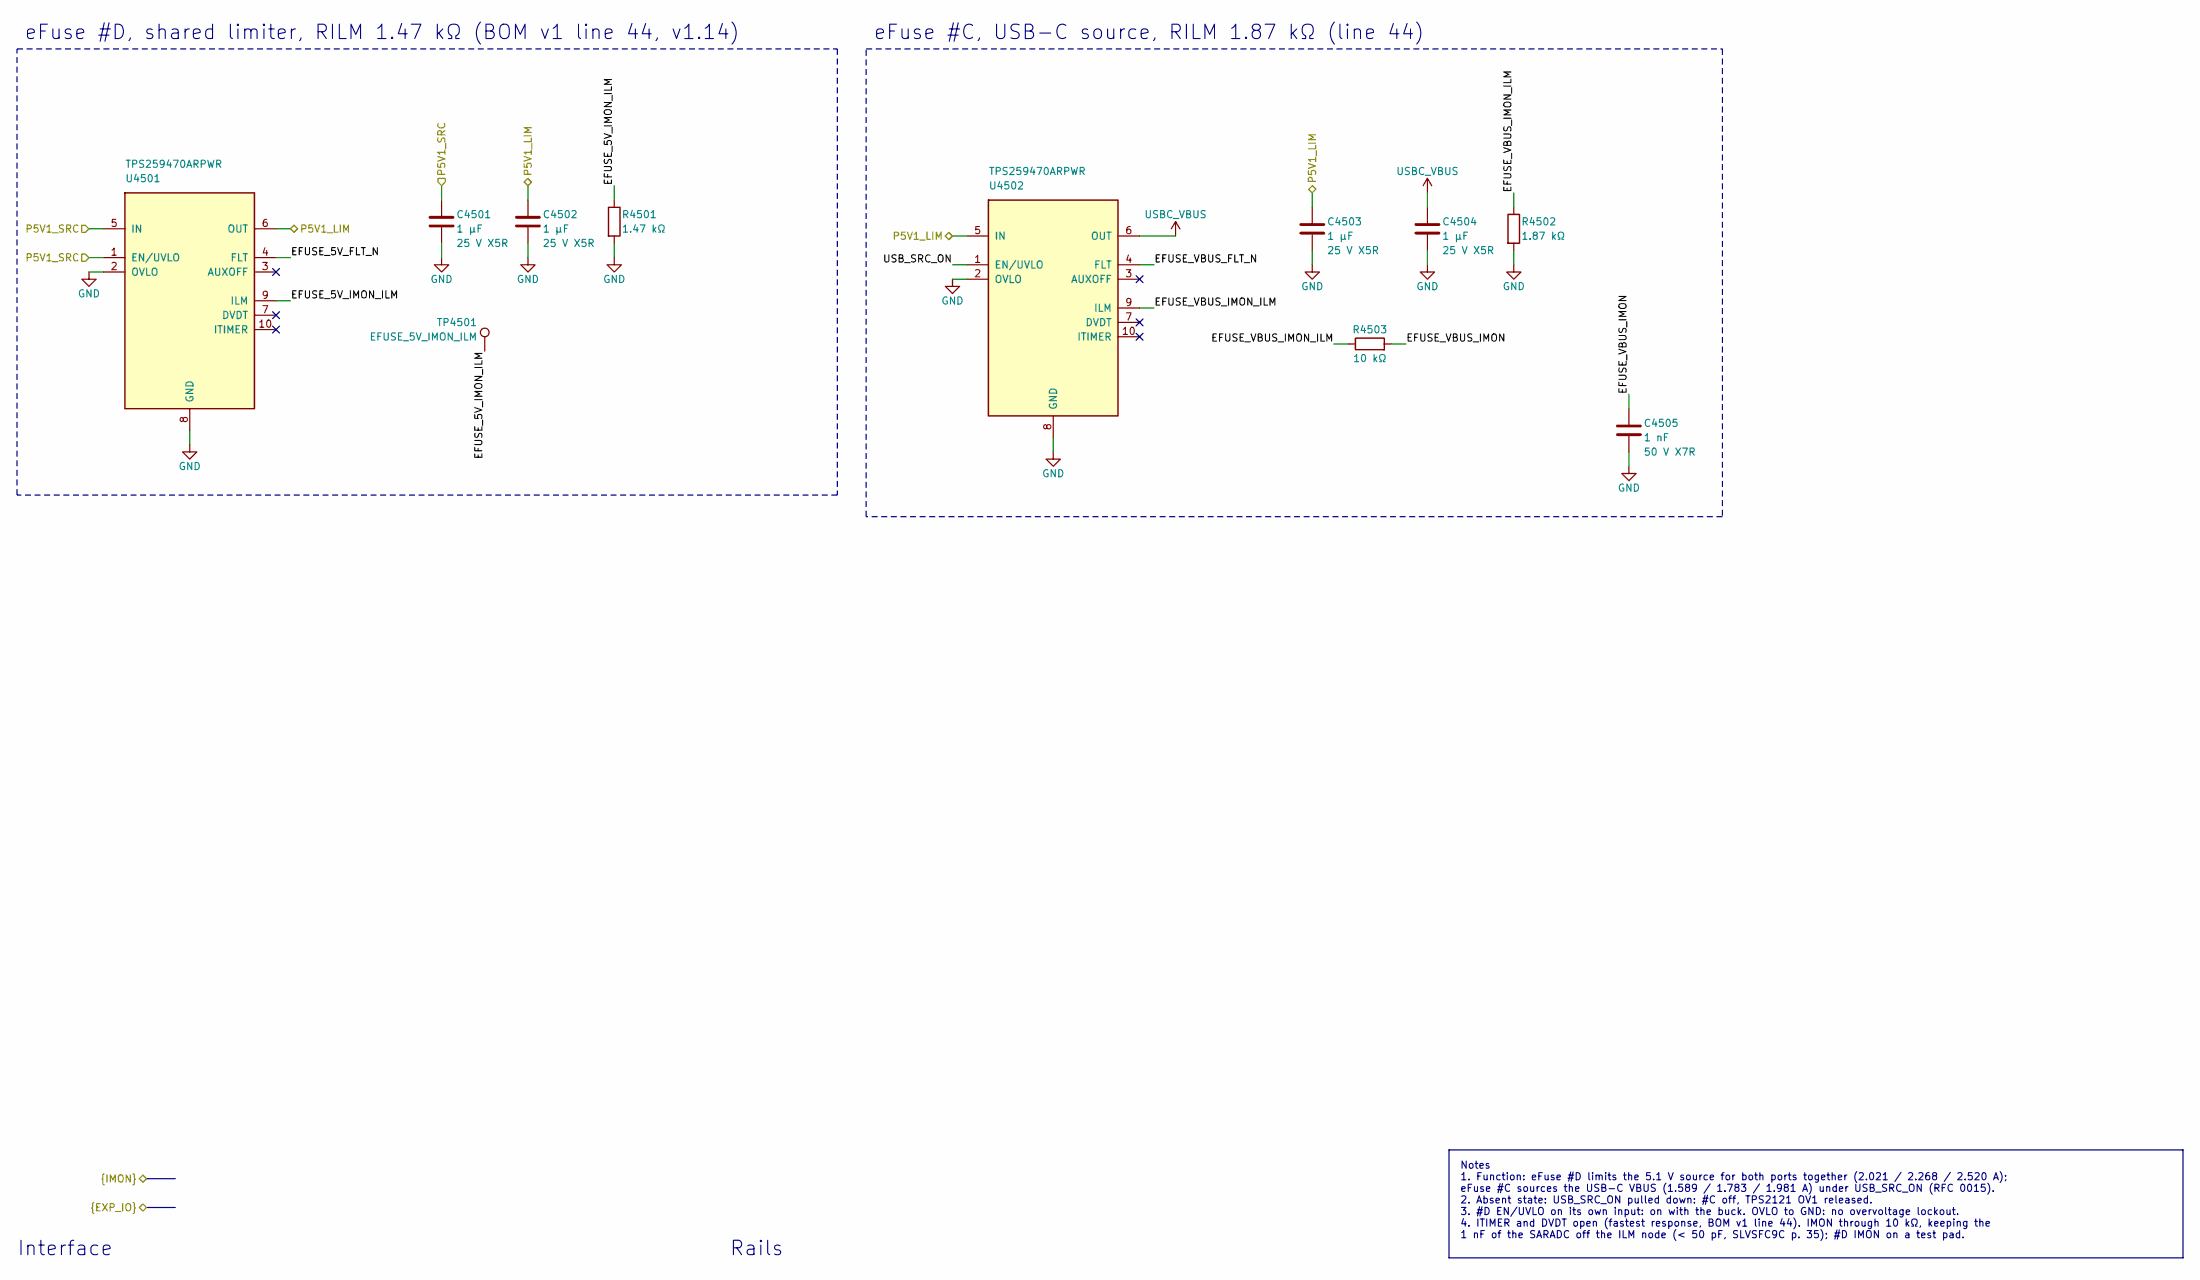
[picture p25: schematic usb-vbus-out.kicad_sch, USB-C source path]

Parts:
C4501, C4502, C4503, C4504: 1 µF; C_0402_1005Metric; MPN GRM155R61E105KA12D
C4505: 1 nF; C_0402_1005Metric; MPN GRM155R71H102KA01D
R4501: 1.47 kΩ; R_0402_1005Metric; MPN RC0402FR-071K47L
R4502: 1.87 kΩ; R_0402_1005Metric; MPN RC0402FR-071K87L
R4503: 10 kΩ; R_0402_1005Metric; MPN RC0402FR-0710KL
TP4501: EFUSE_5V_IMON_ILM; TestPoint_Pad_D0.8mm
U4501, U4502: TPS259470ARPWR; Texas_RPW0010A_VQFN-HR-10_2x2mm_P0.45mm; MPN TPS259470ARPWR

Connections:
/EFUSE_5V_FLT_N: U4501.4 (FLT); also elsewhere on the board
/EFUSE_VBUS_FLT_N: U4502.4 (FLT); also elsewhere on the board
/EFUSE_VBUS_IMON: C4505.1, R4503.2; also elsewhere on the board
/P5V1_LIM: C4502.1, C4503.1, U4501.6 (OUT), U4502.5 (IN); also elsewhere on the board
/P5V1_SRC: C4501.1, U4501.1 (EN/UVLO), U4501.5 (IN); also elsewhere on the board
/USB-C source path/EFUSE_5V_IMON_ILM: R4501.1, TP4501.1, U4501.9 (ILM)
/USB-C source path/EFUSE_VBUS_IMON_ILM: R4502.1, R4503.1, U4502.9 (ILM)
/USB_SRC_ON: U4502.1 (EN/UVLO); also elsewhere on the board
GND: C4501.2, C4502.2, C4503.2, C4504.2, C4505.2, R4501.2, R4502.2, U4501.2 (OVLO), U4501.8 (GND), U4502.2 (OVLO), U4502.8 (GND); also elsewhere on the board
USBC_VBUS: C4504.1, U4502.6 (OUT); also elsewhere on the board

Notes on the sheet:
eFuse #D, shared limiter, RILM 1.47 kΩ (BOM v1 line 44, v1.14)
eFuse #C, USB-C source, RILM 1.87 kΩ (line 44)
Notes 1. Function: eFuse #D limits the 5.1 V source for both ports together (2.021 / 2.268 / 2.520 A); eFuse #C sources the USB-C VBUS (1.589 / 1.783 / 1.981 A) under USB_SRC_ON (RFC 0015). 2. Absent state: USB_SRC_ON pulled down: #C off, TPS2121 OV1 released. 3. #D EN/UVLO on its own input: on wit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
Interface
Rails

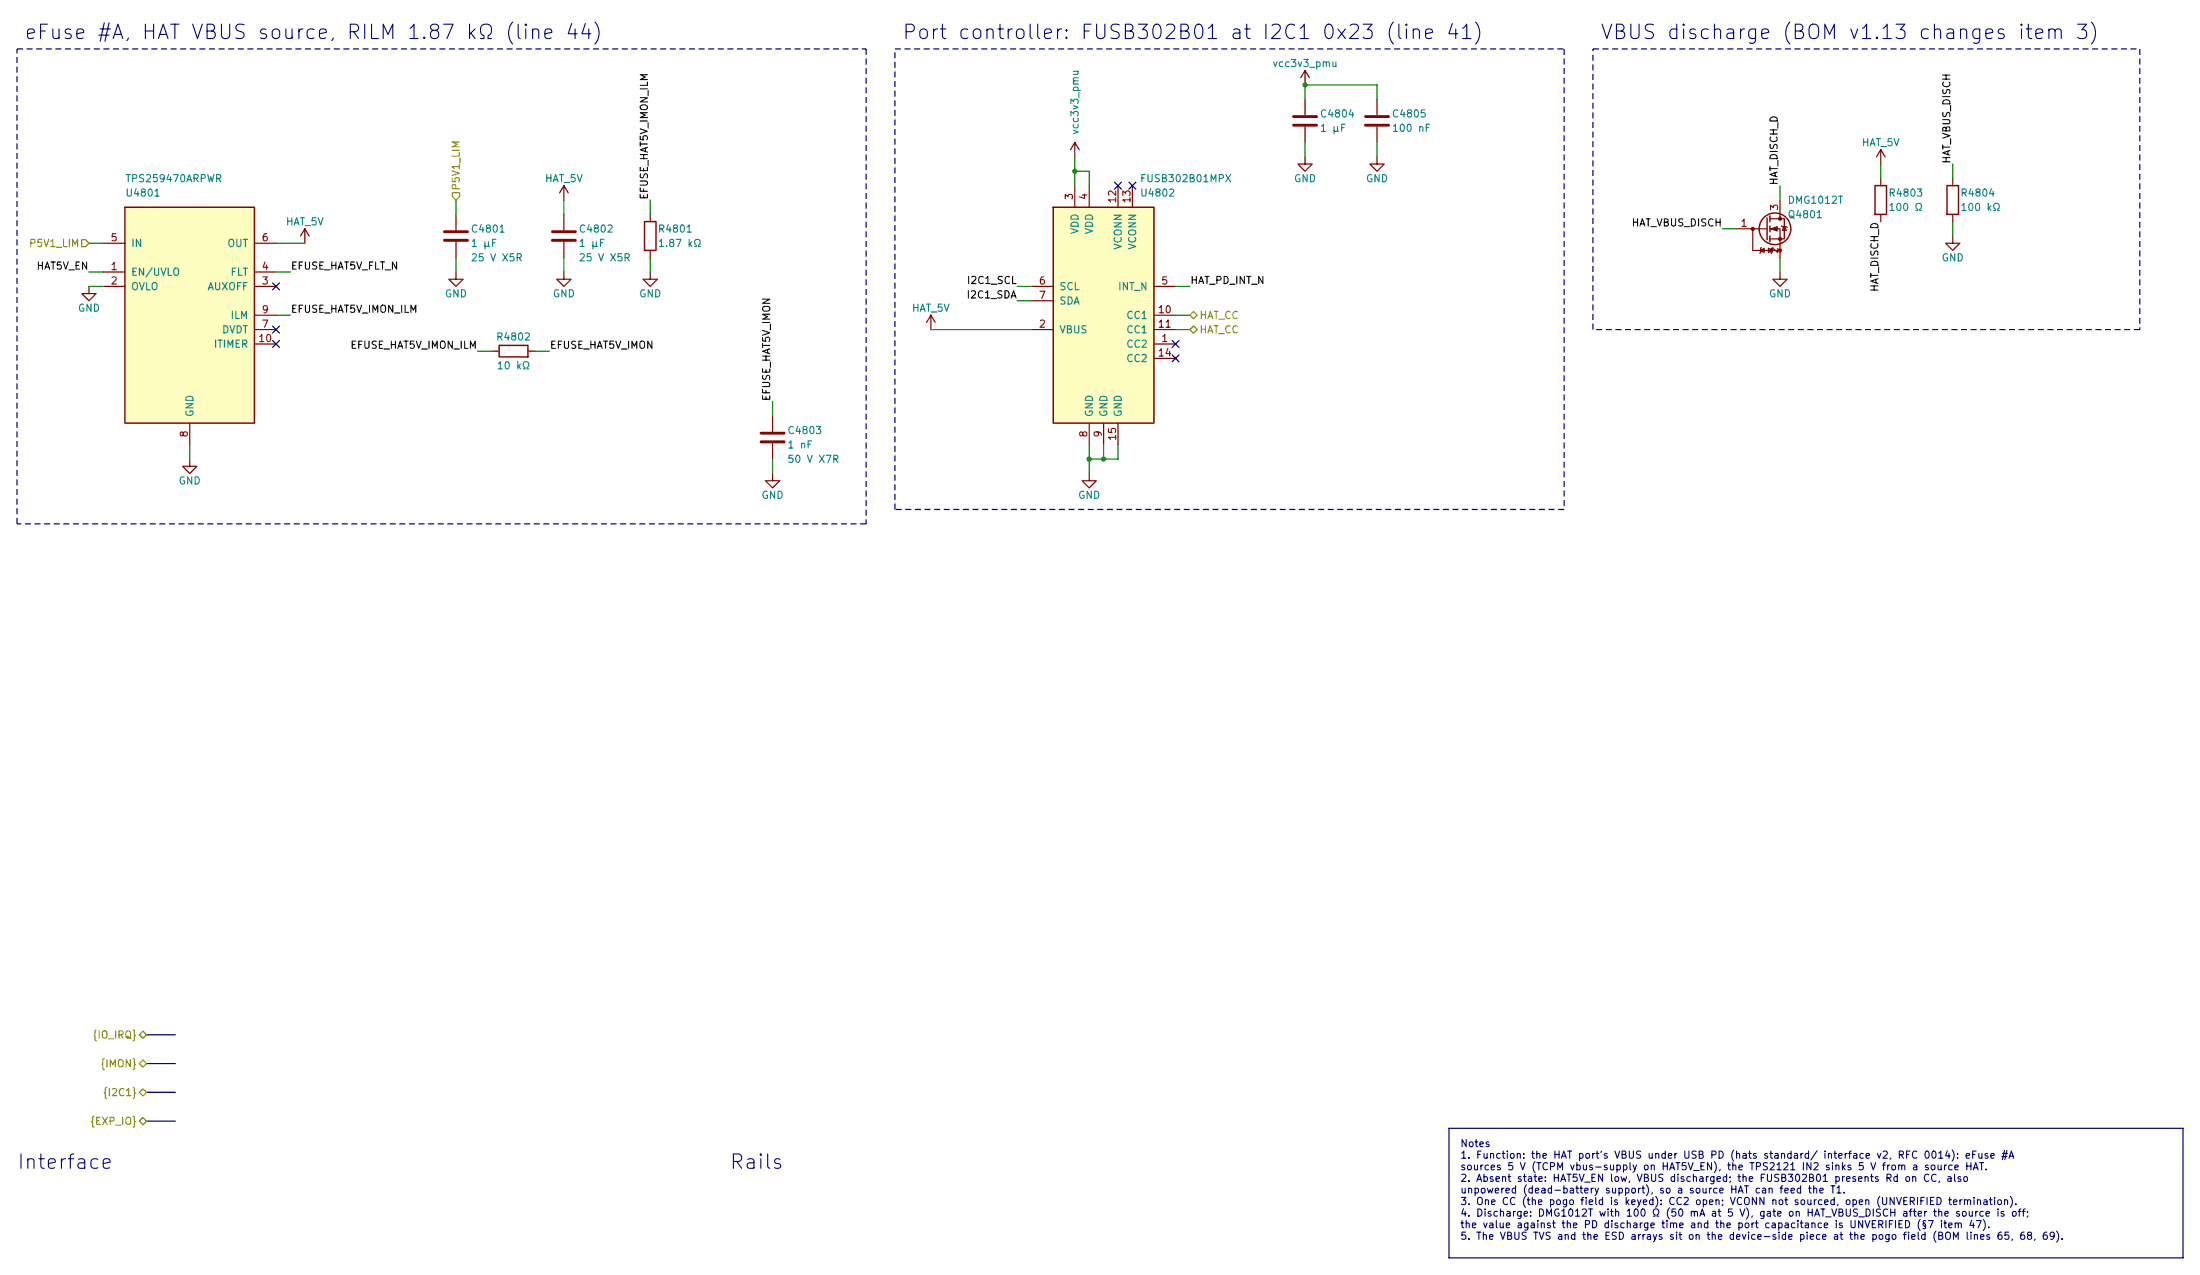
[picture p26: schematic hat-5v.kicad_sch, HAT port VBUS and USB PD]

Parts:
C4801, C4802: 1 µF; C_0402_1005Metric; MPN GRM155R61E105KA12D
C4803: 1 nF; C_0402_1005Metric; MPN GRM155R71H102KA01D
C4804: 1 µF; C_0402_1005Metric; MPN GRM155C71A105KE11D
C4805: 100 nF; C_0402_1005Metric; MPN GRM155R71C104KA88D
Q4801: DMG1012T; SOT-523; MPN DMG1012T-7
R4801: 1.87 kΩ; R_0402_1005Metric; MPN RC0402FR-071K87L
R4802: 10 kΩ; R_0402_1005Metric; MPN RC0402FR-0710KL
R4803: 100 Ω; R_0805_2012Metric; MPN RC0805FR-07100RL
R4804: 100 kΩ; R_0402_1005Metric; MPN RC0402FR-07100KL
U4801: TPS259470ARPWR; Texas_RPW0010A_VQFN-HR-10_2x2mm_P0.45mm; MPN TPS259470ARPWR
U4802: FUSB302B01MPX; onsemi_510BR_WQFN-14-1EP_2.5x2.5mm_P0.5mm_EP1.45x1.45mm; MPN FUSB302B01MPX

Connections:
/EFUSE_HAT5V_FLT_N: U4801.4 (FLT); also elsewhere on the board
/EFUSE_HAT5V_IMON: C4803.1, R4802.2; also elsewhere on the board
/HAT5V_EN: U4801.1 (EN/UVLO); also elsewhere on the board
/HAT port VBUS and USB PD/EFUSE_HAT5V_IMON_ILM: R4801.1, R4802.1, U4801.9 (ILM)
/HAT port VBUS and USB PD/HAT_DISCH_D: Q4801.3 (D), R4803.2
/HAT_CC: U4802.10 (CC1), U4802.11 (CC1); also elsewhere on the board
/HAT_PD_INT_N: U4802.5 (INT_N); also elsewhere on the board
/HAT_VBUS_DISCH: Q4801.1 (G), R4804.1; also elsewhere on the board
/I2C1_SCL: U4802.6 (SCL); also elsewhere on the board
/I2C1_SDA: U4802.7 (SDA); also elsewhere on the board
/P5V1_LIM: C4801.1, U4801.5 (IN); also elsewhere on the board
GND: C4801.2, C4802.2, C4803.2, C4804.2, C4805.2, Q4801.2 (S), R4801.2, R4804.2, U4801.2 (OVLO), U4801.8 (GND), U4802.8 (GND), U4802.9 (GND), U4802.15 (GND); also elsewhere on the board
HAT_5V: C4802.1, R4803.1, U4801.6 (OUT), U4802.2 (VBUS); also elsewhere on the board
vcc3v3_pmu: C4804.1, C4805.1, U4802.3 (VDD), U4802.4 (VDD); also elsewhere on the board

Notes on the sheet:
eFuse #A, HAT VBUS source, RILM 1.87 kΩ (line 44)
Port controller: FUSB302B01 at I2C1 0x23 (line 41)
VBUS discharge (BOM v1.13 changes item 3)
Notes 1. Function: the HAT port's VBUS under USB PD (hats standard/ interface v2, RFC 0014): eFuse #A sources 5 V (TCPM vbus-supply on HAT5V_EN), the TPS2121 IN2 sinks 5 V from a source HAT. 2. Absent state: HAT5V_EN low, VBUS discharged; the FUSB302B01 presents Rd on CC, also unpowered (dead-batte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
Interface
Rails

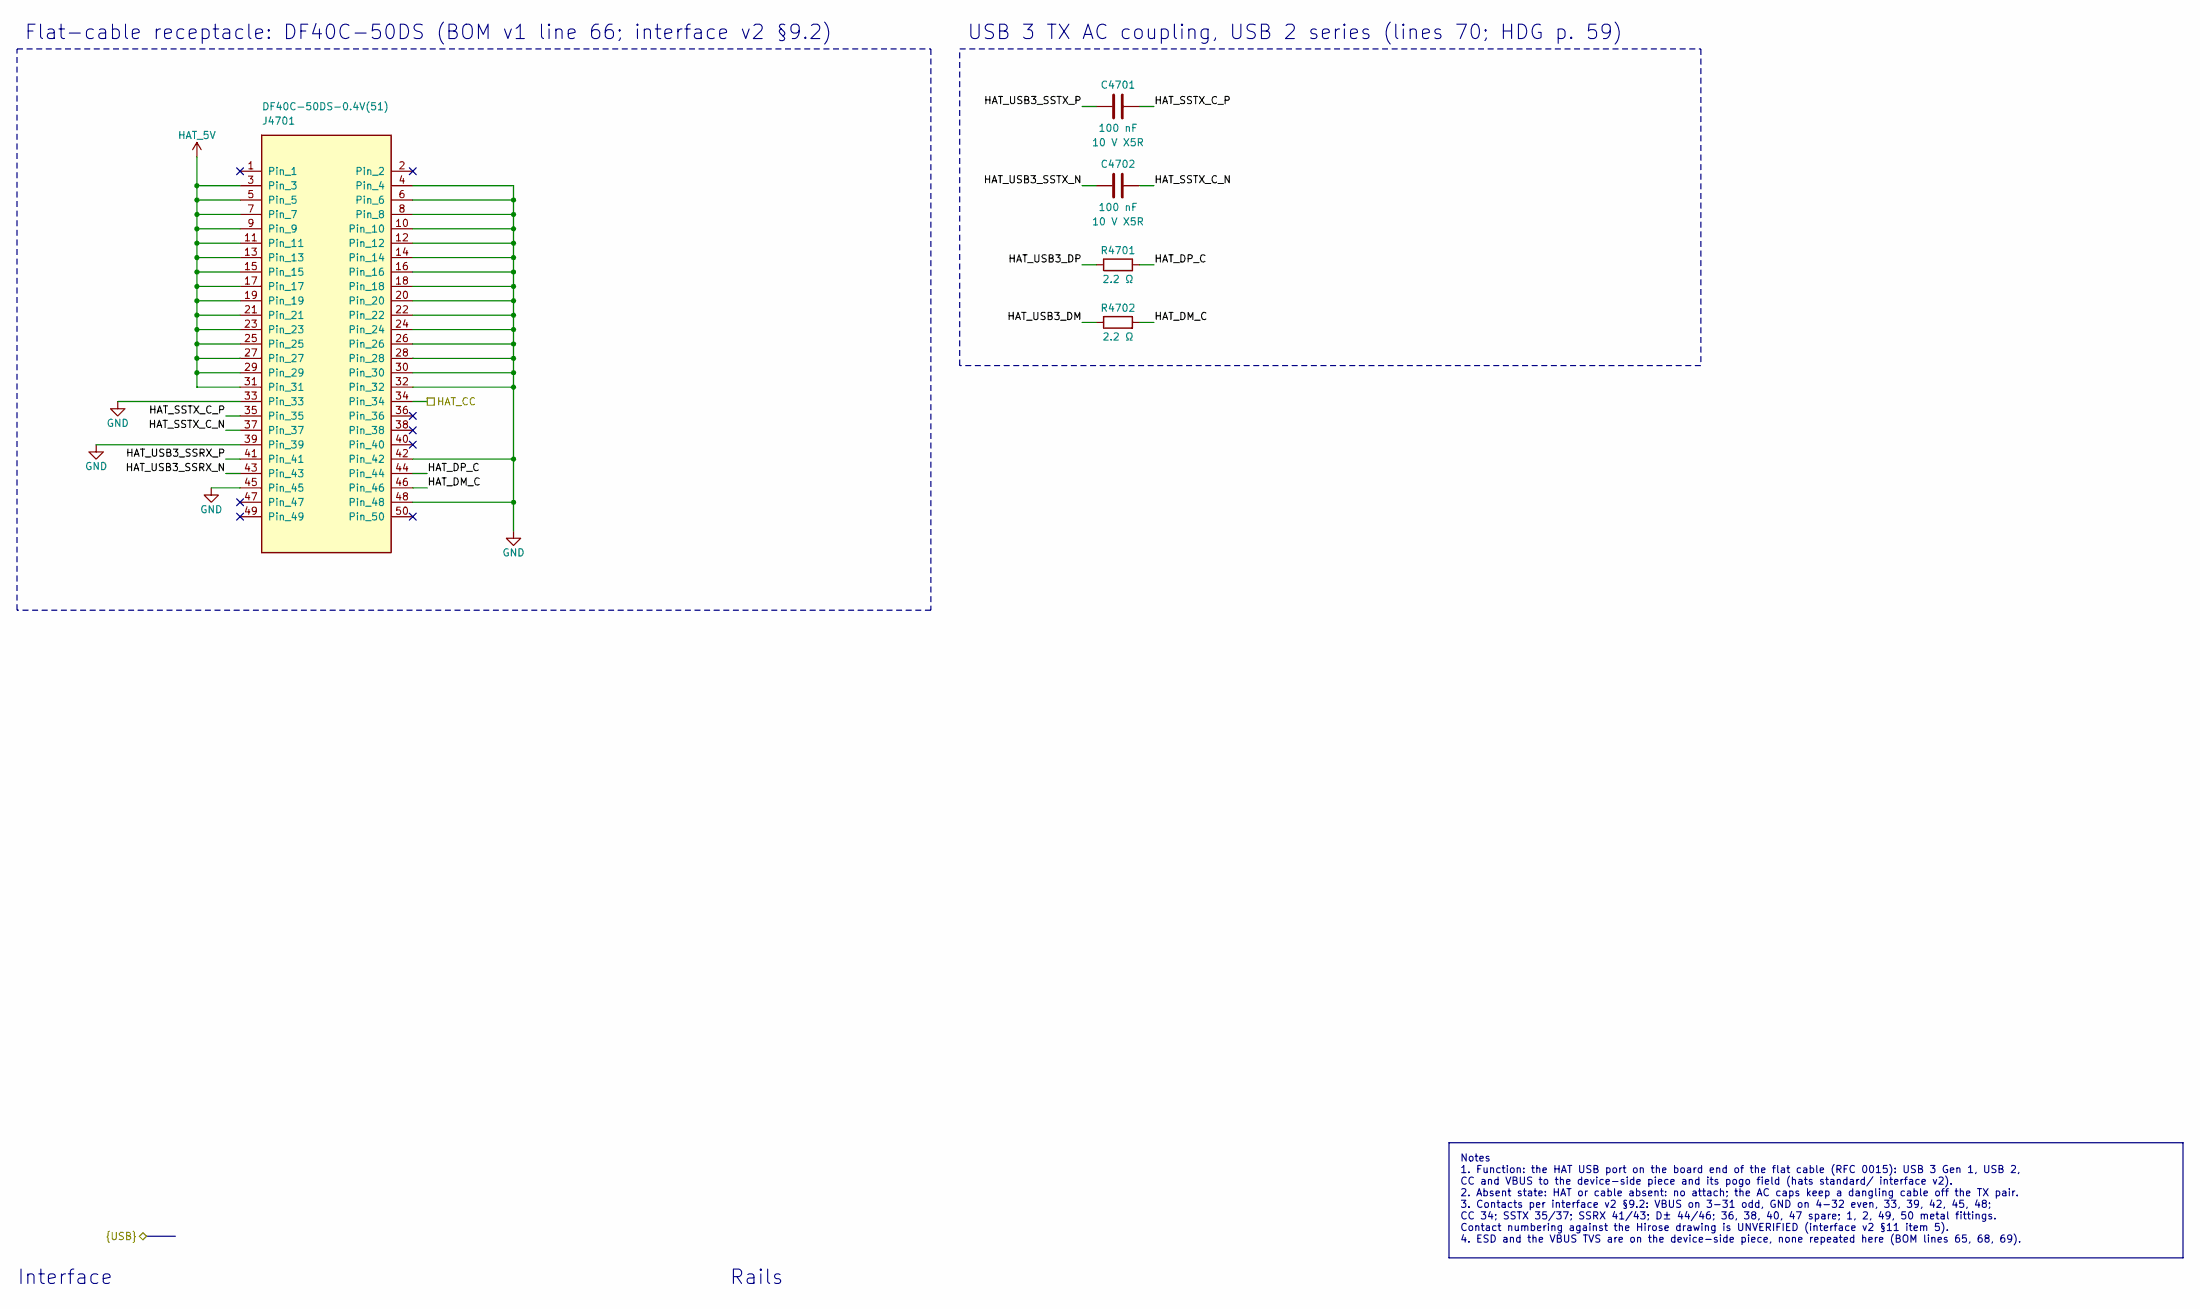
[picture p27: schematic hat-signals.kicad_sch, HAT USB port]

Parts:
C4701, C4702: 100 nF; C_0201_0603Metric; MPN GRM033R61A104KE15D
J4701: DF40C-50DS-0.4V(51); Hirose_DF40C-50DS-0.4V_2x25_P0.4mm_Vertical; MPN DF40C-50DS-0.4V(51)
R4701, R4702: 2.2 Ω; R_0402_1005Metric; MPN RC0402FR-072R2L

Connections:
/HAT USB port/HAT_DM_C: J4701.46, R4702.2
/HAT USB port/HAT_DP_C: J4701.44, R4701.2
/HAT USB port/HAT_SSTX_C_N: C4702.2, J4701.37
/HAT USB port/HAT_SSTX_C_P: C4701.2, J4701.35
/HAT_CC: J4701.34; also elsewhere on the board
/HAT_USB3_DM: R4702.1; also elsewhere on the board
/HAT_USB3_DP: R4701.1; also elsewhere on the board
/HAT_USB3_SSRX_N: J4701.43; also elsewhere on the board
/HAT_USB3_SSRX_P: J4701.41; also elsewhere on the board
/HAT_USB3_SSTX_N: C4702.1; also elsewhere on the board
/HAT_USB3_SSTX_P: C4701.1; also elsewhere on the board
GND: J4701.4, J4701.6, J4701.8, J4701.10, J4701.12, J4701.14, J4701.16, J4701.18, J4701.20, J4701.22, J4701.24, J4701.26, J4701.28, J4701.30, J4701.32, J4701.33, J4701.39, J4701.42, J4701.45, J4701.48; also elsewhere on the board
HAT_5V: J4701.3, J4701.5, J4701.7, J4701.9, J4701.11, J4701.13, J4701.15, J4701.17, J4701.19, J4701.21, J4701.23, J4701.25, J4701.27, J4701.29, J4701.31; also elsewhere on the board

Notes on the sheet:
Flat-cable receptacle: DF40C-50DS (BOM v1 line 66; interface v2 §9.2)
USB 3 TX AC coupling, USB 2 series (lines 70; HDG p. 59)
Notes 1. Function: the HAT USB port on the board end of the flat cable (RFC 0015): USB 3 Gen 1, USB 2, CC and VBUS to the device-side piece and its pogo field (hats standard/ interface v2). 2. Absent state: HAT or cable absent: no attach; the AC caps keep a dangling cable off the TX pair. 3. Contac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
Interface
Rails
