opendap-project/t1/board/hardware/t1-main-board/t1-main-board.kicad_pcb

## KiCad design board/hardware/t1-main-board/t1-main-board.kicad_pcb (continued)

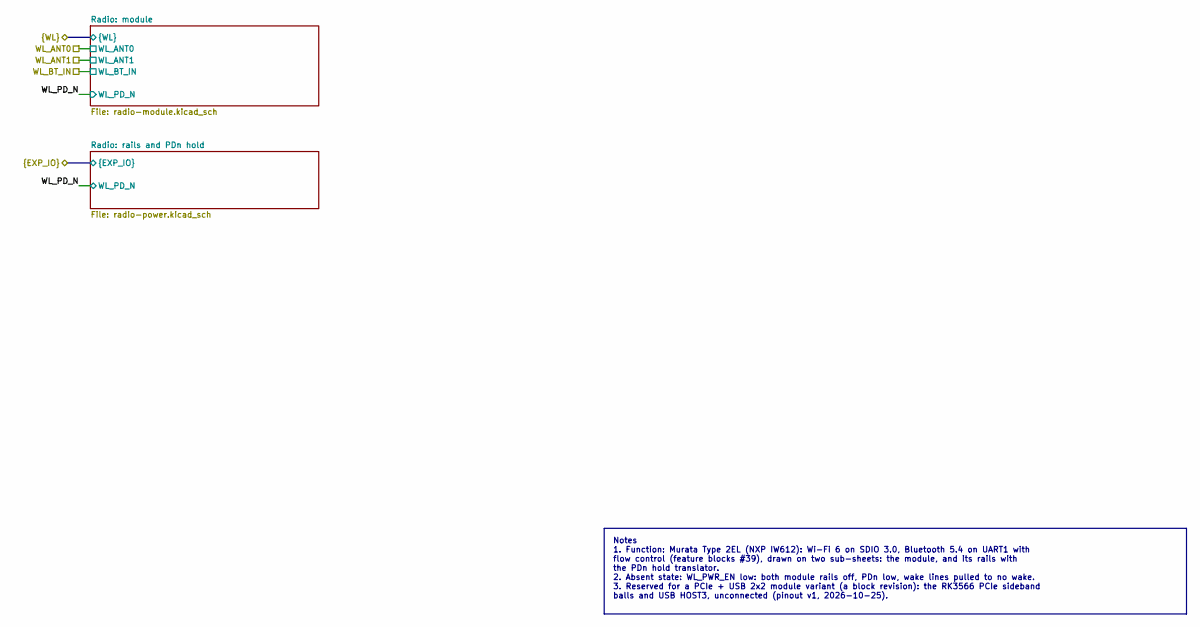
[picture p28: schematic radio.kicad_sch, Wi-Fi and Bluetooth module]

Notes on the sheet:
Notes 1. Function: Murata Type 2EL (NXP IW612): Wi-Fi 6 on SDIO 3.0, Bluetooth 5.4 on UART1 with flow control (feature blocks #39), drawn on two sub-sheets: the module, and its rails with the PDn hold translator. 2. Absent state: WL_PWR_EN low: both module rails off, PDn low, wake lines pulled to n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

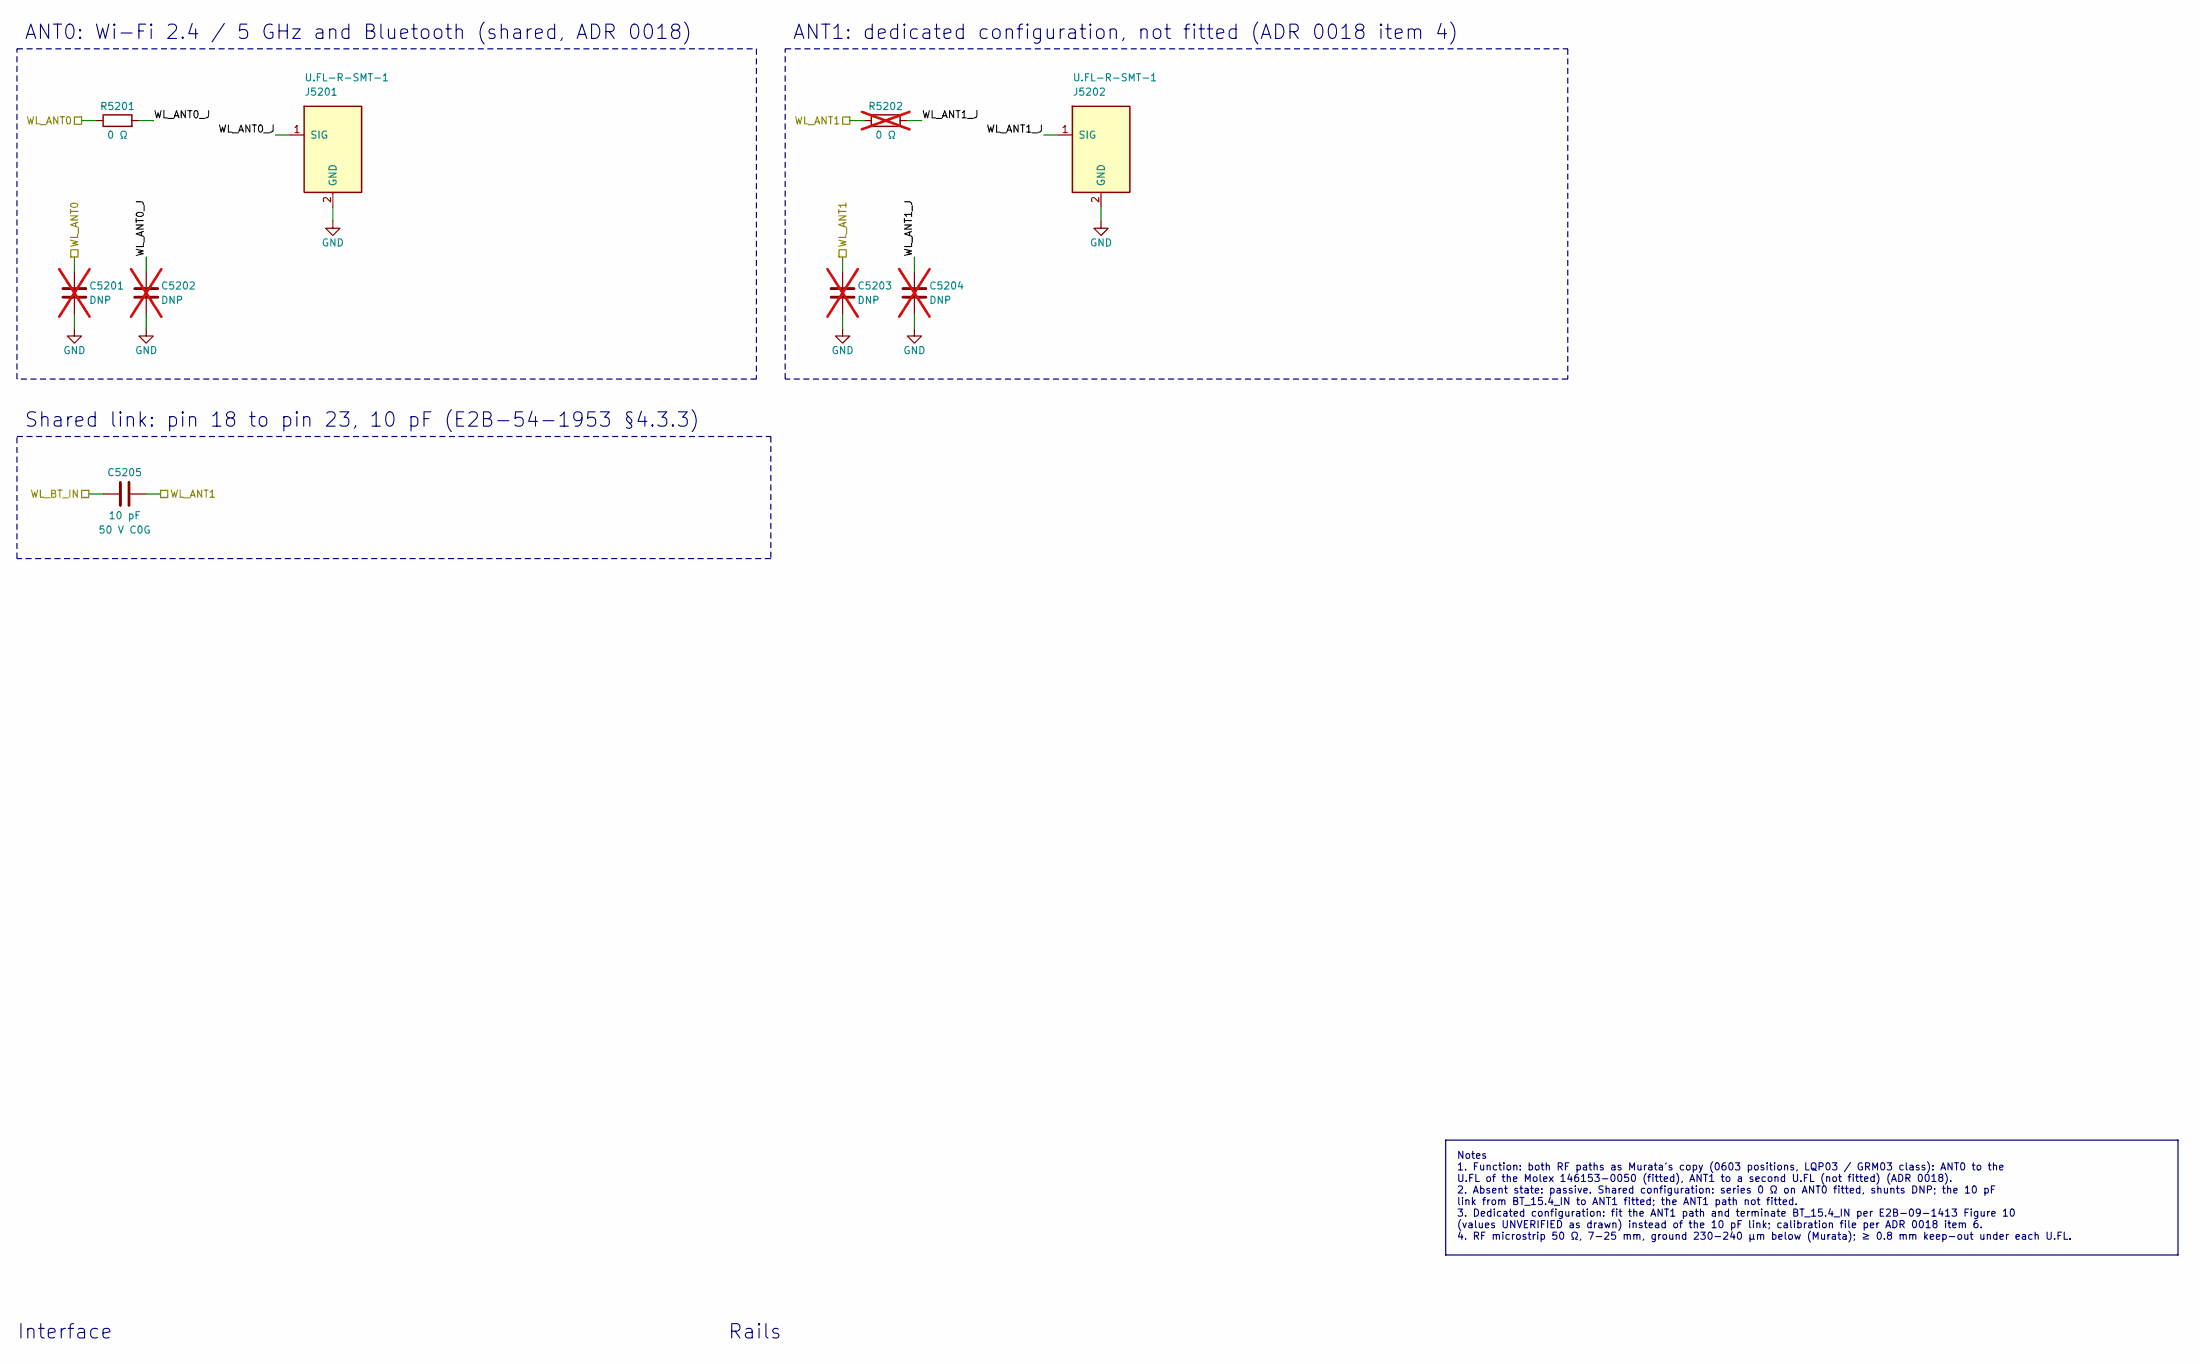
[picture p29: schematic antennas.kicad_sch, Antenna feeds]

Parts:
C5201, C5202, C5203, C5204: DNP; C_0201_0603Metric; not fitted
C5205: 10 pF; C_0201_0603Metric; MPN GRM0335C1H100JA01D
J5201, J5202: U.FL-R-SMT-1; Hirose_U.FL-R-SMT-1_Vertical; MPN U.FL-R-SMT-1
R5201: 0 Ω; R_0201_0603Metric; MPN RC0201JR-070RL
R5202: 0 Ω; R_0201_0603Metric; MPN RC0201JR-070RL; not fitted

Connections:
/Antenna feeds/WL_ANT0_J: C5202.1, J5201.1 (SIG), R5201.2
/Antenna feeds/WL_ANT1_J: C5204.1, J5202.1 (SIG), R5202.2
/WL_ANT0: C5201.1, R5201.1; also elsewhere on the board
/WL_ANT1: C5203.1, C5205.2, R5202.1; also elsewhere on the board
/WL_BT_IN: C5205.1; also elsewhere on the board
GND: C5201.2, C5202.2, C5203.2, C5204.2, J5201.2 (GND), J5202.2 (GND); also elsewhere on the board

Notes on the sheet:
ANT0: Wi-Fi 2.4 / 5 GHz and Bluetooth (shared, ADR 0018)
ANT1: dedicated configuration, not fitted (ADR 0018 item 4)
Shared link: pin 18 to pin 23, 10 pF (E2B-54-1953 §4.3.3)
Notes 1. Function: both RF paths as Murata's copy (0603 positions, LQP03 / GRM03 class): ANT0 to the U.FL of the Molex 146153-0050 (fitted), ANT1 to a second U.FL (not fitted) (ADR 0018). 2. Absent state: passive. Shared configuration: series 0 Ω on ANT0 fitted, shunts DNP; the 10 pF link from BT_1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
Interface
Rails

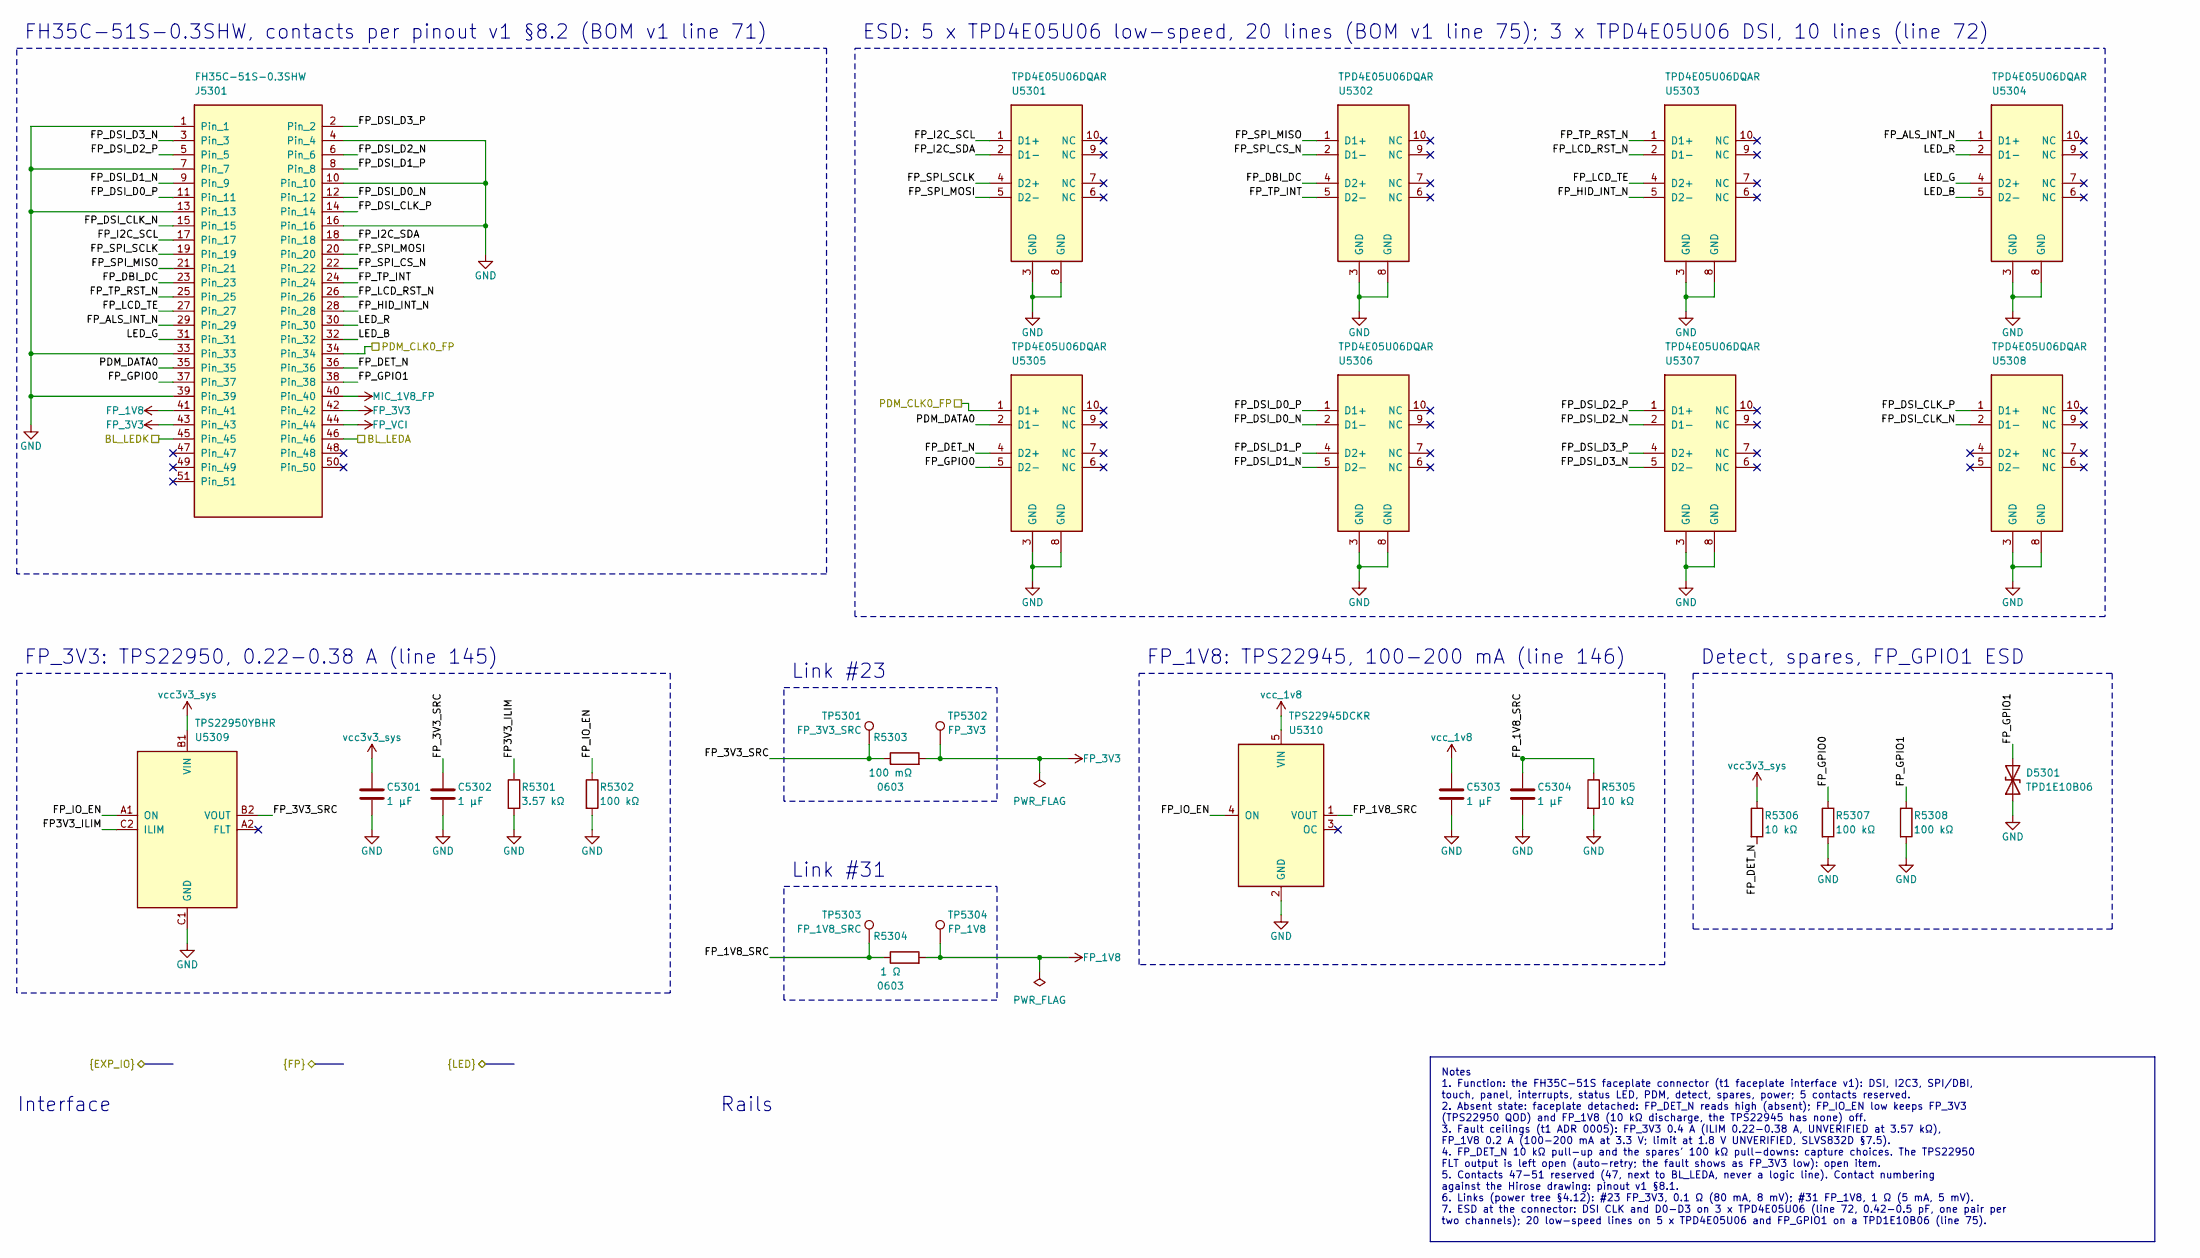
[picture p30: schematic fp-connector.kicad_sch, Faceplate connector]

Parts:
C5301, C5302, C5303: 1 µF; C_0402_1005Metric; MPN GRM155C71A105KE11D
C5304: 1 µF; C_0201_0603Metric; MPN GRM033R60J105MEA2D
D5301: TPD1E10B06; Texas_DPY0002A_0.6x1mm_P0.65mm; MPN TPD1E10B06DPYR
J5301: FH35C-51S-0.3SHW; Hirose_FH35C-51S-0.3SHW_1x51-1MP_P0.3mm_Horizontal; MPN FH35C-51S-0.3SHW
R5301: 3.57 kΩ; R_0201_0603Metric; MPN RC0201FR-073K57L
R5302, R5307, R5308: 100 kΩ; R_0201_0603Metric; MPN RC0201FR-07100KL
R5303: 100 mΩ; R_0603_1608Metric; MPN RL0603FR-070R1L
R5304: 1 Ω; R_0603_1608Metric; MPN RC0603FR-071RL
R5305, R5306: 10 kΩ; R_0201_0603Metric; MPN RC0201FR-0710KL
TP5301: FP_3V3_SRC; TestPoint_Pad_D1.0mm
TP5302: FP_3V3; TestPoint_Pad_D1.0mm
TP5303: FP_1V8_SRC; TestPoint_Pad_D1.0mm
TP5304: FP_1V8; TestPoint_Pad_D1.0mm
U5301, U5302, U5303, U5304, U5305, U5306, U5307, U5308: TPD4E05U06DQAR; Texas_DQA0010A_USON-10_1x2.5mm_P0.5mm; MPN TPD4E05U06DQAR
U5309: TPS22950YBHR; Texas_YBH0006_DSBGA-6_0.706x1.106mm_Layout2x3_P0.4mm; MPN TPS22950YBHR
U5310: TPS22945DCKR; Texas_DCK0005A_SC-70-5_1.25x2mm_P0.65mm; MPN TPS22945DCKR

Connections:
/BL_LEDA: J5301.46; also elsewhere on the board
/BL_LEDK: J5301.45; also elsewhere on the board
/FP_ALS_INT_N: J5301.29, U5304.1 (D1+); also elsewhere on the board
/FP_DBI_DC: J5301.23, U5302.4 (D2+); also elsewhere on the board
/FP_DET_N: J5301.36, R5306.2, U5305.4 (D2+); also elsewhere on the board
/FP_DSI_CLK_N: J5301.15, U5308.2 (D1-); also elsewhere on the board
/FP_DSI_CLK_P: J5301.14, U5308.1 (D1+); also elsewhere on the board
/FP_DSI_D0_N: J5301.12, U5306.2 (D1-); also elsewhere on the board
/FP_DSI_D0_P: J5301.11, U5306.1 (D1+); also elsewhere on the board
/FP_DSI_D1_N: J5301.9, U5306.5 (D2-); also elsewhere on the board
/FP_DSI_D1_P: J5301.8, U5306.4 (D2+); also elsewhere on the board
/FP_DSI_D2_N: J5301.6, U5307.2 (D1-); also elsewhere on the board
/FP_DSI_D2_P: J5301.5, U5307.1 (D1+); also elsewhere on the board
/FP_DSI_D3_N: J5301.3, U5307.5 (D2-); also elsewhere on the board
/FP_DSI_D3_P: J5301.2, U5307.4 (D2+); also elsewhere on the board
/FP_GPIO0: J5301.37, R5307.1, U5305.5 (D2-); also elsewhere on the board
/FP_GPIO1: D5301.2 (A2), J5301.38, R5308.1; also elsewhere on the board
/FP_HID_INT_N: J5301.28, U5303.5 (D2-); also elsewhere on the board
/FP_I2C_SCL: J5301.17, U5301.1 (D1+); also elsewhere on the board
/FP_I2C_SDA: J5301.18, U5301.2 (D1-); also elsewhere on the board
/FP_IO_EN: R5302.1, U5309.A1 (ON), U5310.4 (ON); also elsewhere on the board
/FP_LCD_RST_N: J5301.26, U5303.2 (D1-); also elsewhere on the board
/FP_LCD_TE: J5301.27, U5303.4 (D2+); also elsewhere on the board
/FP_SPI_CS_N: J5301.22, U5302.2 (D1-); also elsewhere on the board
/FP_SPI_MISO: J5301.21, U5302.1 (D1+); also elsewhere on the board
/FP_SPI_MOSI: J5301.20, U5301.5 (D2-); also elsewhere on the board
/FP_SPI_SCLK: J5301.19, U5301.4 (D2+); also elsewhere on the board
/FP_TP_INT: J5301.24, U5302.5 (D2-); also elsewhere on the board
/FP_TP_RST_N: J5301.25, U5303.1 (D1+); also elsewhere on the board
/Faceplate connector/FP3V3_ILIM: R5301.1, U5309.C2 (ILIM)
/Faceplate connector/FP_1V8_SRC: C5304.1, R5304.1, R5305.1, TP5303.1, U5310.1 (VOUT)
/Faceplate connector/FP_3V3_SRC: C5302.1, R5303.1, TP5301.1, U5309.B2 (VOUT)
/LED_B: J5301.32, U5304.5 (D2-); also elsewhere on the board
/LED_G: J5301.31, U5304.4 (D2+); also elsewhere on the board
/LED_R: J5301.30, U5304.2 (D1-); also elsewhere on the board
/PDM_CLK0_FP: J5301.34, U5305.1 (D1+); also elsewhere on the board
/PDM_DATA0: J5301.35, U5305.2 (D1-); also elsewhere on the board
FP_1V8: J5301.41, R5304.2, TP5304.1
FP_3V3: J5301.42, J5301.43, R5303.2, TP5302.1; also elsewhere on the board
FP_VCI: J5301.44; also elsewhere on the board
GND: C5301.2, C5302.2, C5303.2, C5304.2, D5301.1 (A1), J5301.1, J5301.4, J5301.7, J5301.10, J5301.13, J5301.16, J5301.33, J5301.39, R5301.2, R5302.2, R5305.2, R5307.2, R5308.2, U5301.3 (GND), U5301.8 (GND), U5302.3 (GND), U5302.8 (GND), U5303.3 (GND), U5303.8 (GND), U5304.3 (GND), U5304.8 (GND), U5305.3 (GND), U5305.8 (GND), U5306.3 (GND), U5306.8 (GND), U5307.3 (GND), U5307.8 (GND), U5308.3 (GND), U5308.8 (GND), U5309.C1 (GND), U5310.2 (GND); also elsewhere on the board
MIC_1V8_FP: J5301.40; also elsewhere on the board
vcc3v3_sys: C5301.1, R5306.1, U5309.B1 (VIN); also elsewhere on the board
vcc_1v8: C5303.1, U5310.5 (VIN); also elsewhere on the board

Notes on the sheet:
FH35C-51S-0.3SHW, contacts per pinout v1 §8.2 (BOM v1 line 71)
ESD: 5 x TPD4E05U06 low-speed, 20 lines (BOM v1 line 75); 3 x TPD4E05U06 DSI, 10 lines (line 72)
FP_3V3: TPS22950, 0.22-0.38 A (line 145)
Link #23
Link #31
FP_1V8: TPS22945, 100-200 mA (line 146)
Detect, spares, FP_GPIO1 ESD
Notes 1. Function: the FH35C-51S faceplate connector (t1 faceplate interface v1): DSI, I2C3, SPI/DBI, touch, panel, interrupts, status LED, PDM, detect, spares, power; 5 contacts reserved. 2. Absent state: faceplate detached: FP_DET_N reads high (absent); FP_IO_EN low keeps FP_3V3 (TPS22950 QOD) an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
Interface
Rails

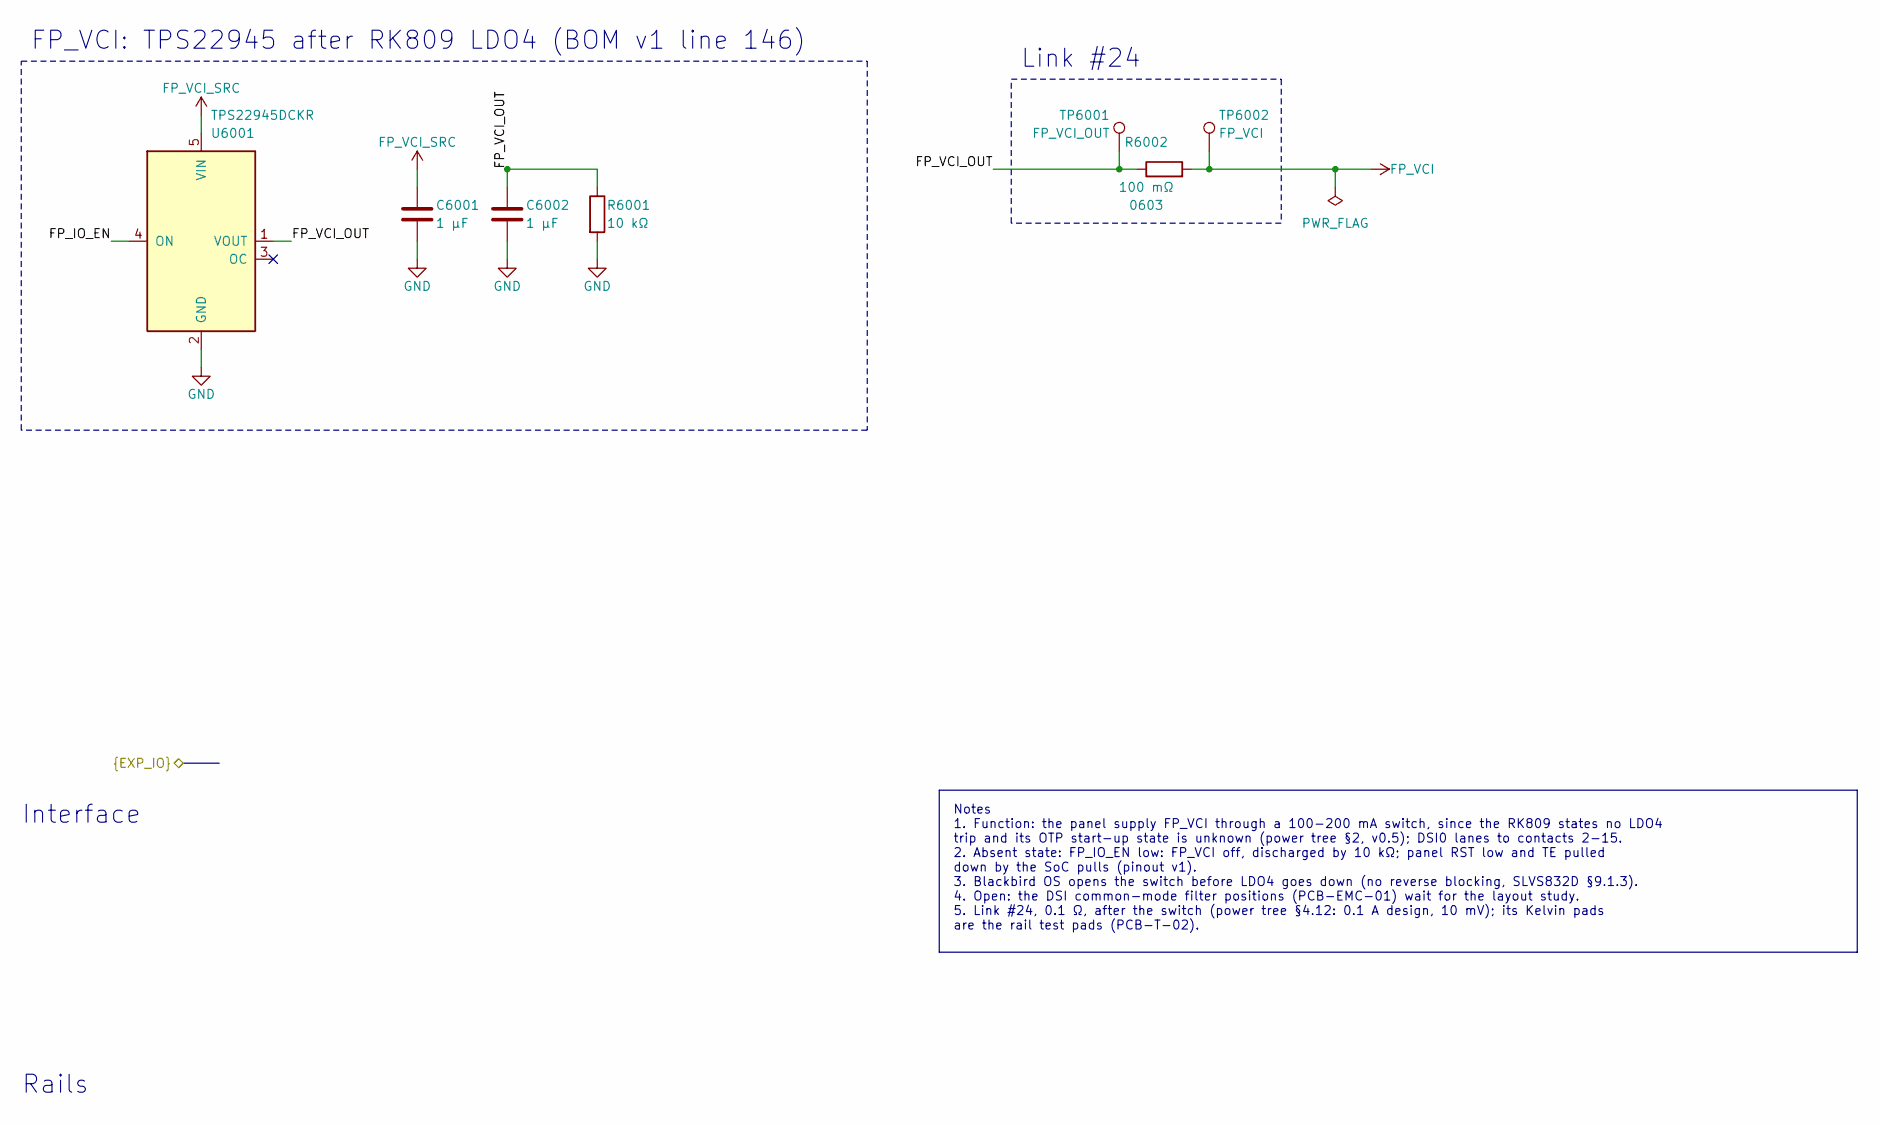
[picture p31: schematic fp-display.kicad_sch, Faceplate display supply]

Parts:
C6001, C6002: 1 µF; C_0402_1005Metric; MPN GRM155C71A105KE11D
R6001: 10 kΩ; R_0201_0603Metric; MPN RC0201FR-0710KL
R6002: 100 mΩ; R_0603_1608Metric; MPN RL0603FR-070R1L
TP6001: FP_VCI_OUT; TestPoint_Pad_D1.0mm
TP6002: FP_VCI; TestPoint_Pad_D1.0mm
U6001: TPS22945DCKR; Texas_DCK0005A_SC-70-5_1.25x2mm_P0.65mm; MPN TPS22945DCKR

Connections:
/FP_IO_EN: U6001.4 (ON); also elsewhere on the board
/Faceplate display supply/FP_VCI_OUT: C6002.1, R6001.1, R6002.1, TP6001.1, U6001.1 (VOUT)
FP_VCI: R6002.2, TP6002.1; also elsewhere on the board
FP_VCI_SRC: C6001.1, U6001.5 (VIN); also elsewhere on the board
GND: C6001.2, C6002.2, R6001.2, U6001.2 (GND); also elsewhere on the board

Notes on the sheet:
FP_VCI: TPS22945 after RK809 LDO4 (BOM v1 line 146)
Link #24
Notes 1. Function: the panel supply FP_VCI through a 100-200 mA switch, since the RK809 states no LDO4 trip and its OTP start-up state is unknown (power tree §2, v0.5); DSI0 lanes to contacts 2-15. 2. Absent state: FP_IO_EN low: FP_VCI off, discharged by 10 kΩ; panel RST low and TE pulled down by t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
Rails
Interface

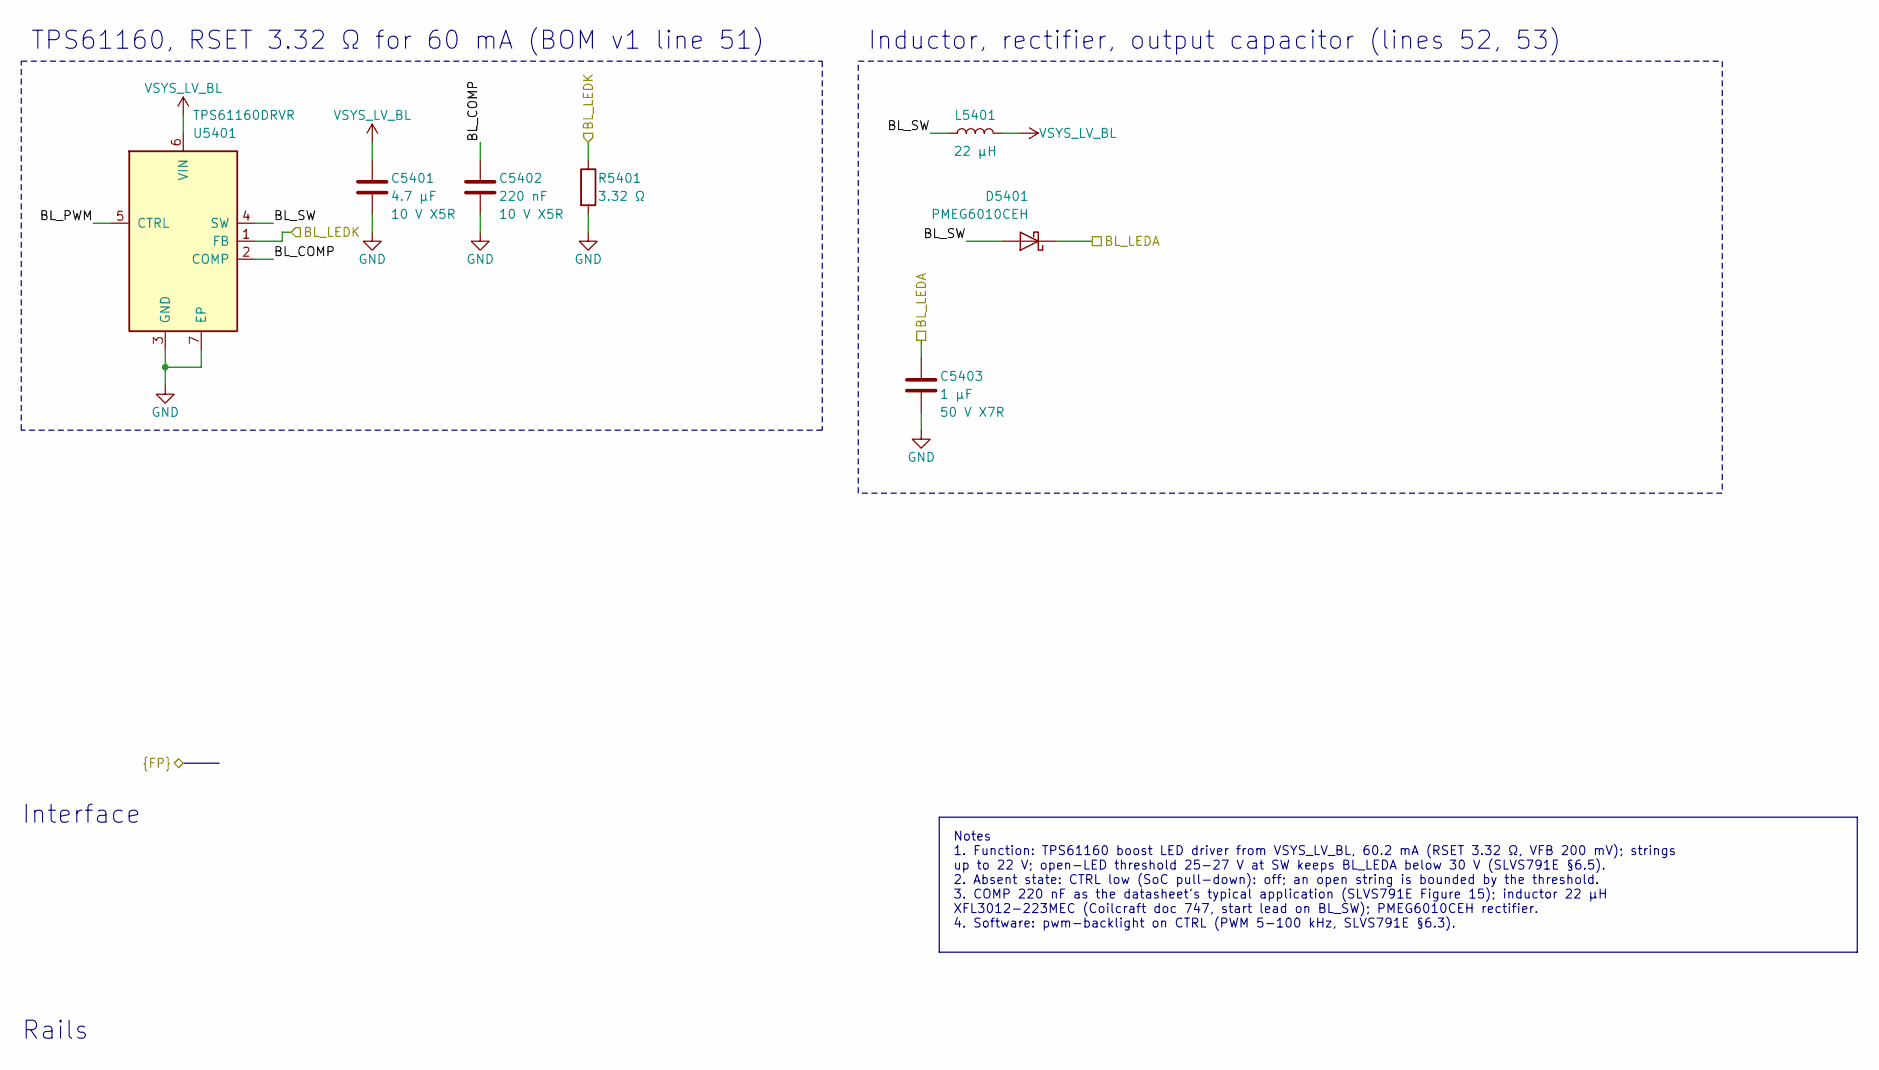
[picture p32: schematic fp-backlight.kicad_sch, Faceplate backlight]

Parts:
C5401: 4.7 µF; C_0603_1608Metric; MPN GRM188R61A475KE15D
C5402: 220 nF; C_0402_1005Metric; MPN GRM155R61A224KE19D
C5403: 1 µF; C_0603_1608Metric; MPN GRM188R71H105KA12D
D5401: PMEG6010CEH; D_SOD-123F; MPN PMEG6010CEH,115
L5401: 22 µH; L_Coilcraft_XFL3012; MPN XFL3012-223MEC
R5401: 3.32 Ω; R_0603_1608Metric; MPN RC0603FR-073R32L
U5401: TPS61160DRVR; Texas_DRV0006A_WSON-6-1EP_2x2mm_P0.65mm_EP1x1.6mm; MPN TPS61160DRVR

Connections:
/BL_LEDA: C5403.1, D5401.1 (K); also elsewhere on the board
/BL_LEDK: R5401.1, U5401.1 (FB); also elsewhere on the board
/BL_PWM: U5401.5 (CTRL); also elsewhere on the board
/Faceplate backlight/BL_COMP: C5402.1, U5401.2 (COMP)
/Faceplate backlight/BL_SW: D5401.2 (A), L5401.1, U5401.4 (SW)
GND: C5401.2, C5402.2, C5403.2, R5401.2, U5401.3 (GND), U5401.7 (EP); also elsewhere on the board
VSYS_LV_BL: C5401.1, L5401.2, U5401.6 (VIN); also elsewhere on the board

Notes on the sheet:
TPS61160, RSET 3.32 Ω for 60 mA (BOM v1 line 51)
Inductor, rectifier, output capacitor (lines 52, 53)
Notes 1. Function: TPS61160 boost LED driver from VSYS_LV_BL, 60.2 mA (RSET 3.32 Ω, VFB 200 mV); strings up to 22 V; open-LED threshold 25-27 V at SW keeps BL_LEDA below 30 V (SLVS791E §6.5). 2. Absent state: CTRL low (SoC pull-down): off; an open string is bounded by the threshold. 3. COMP 220 nF 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
Rails
Interface

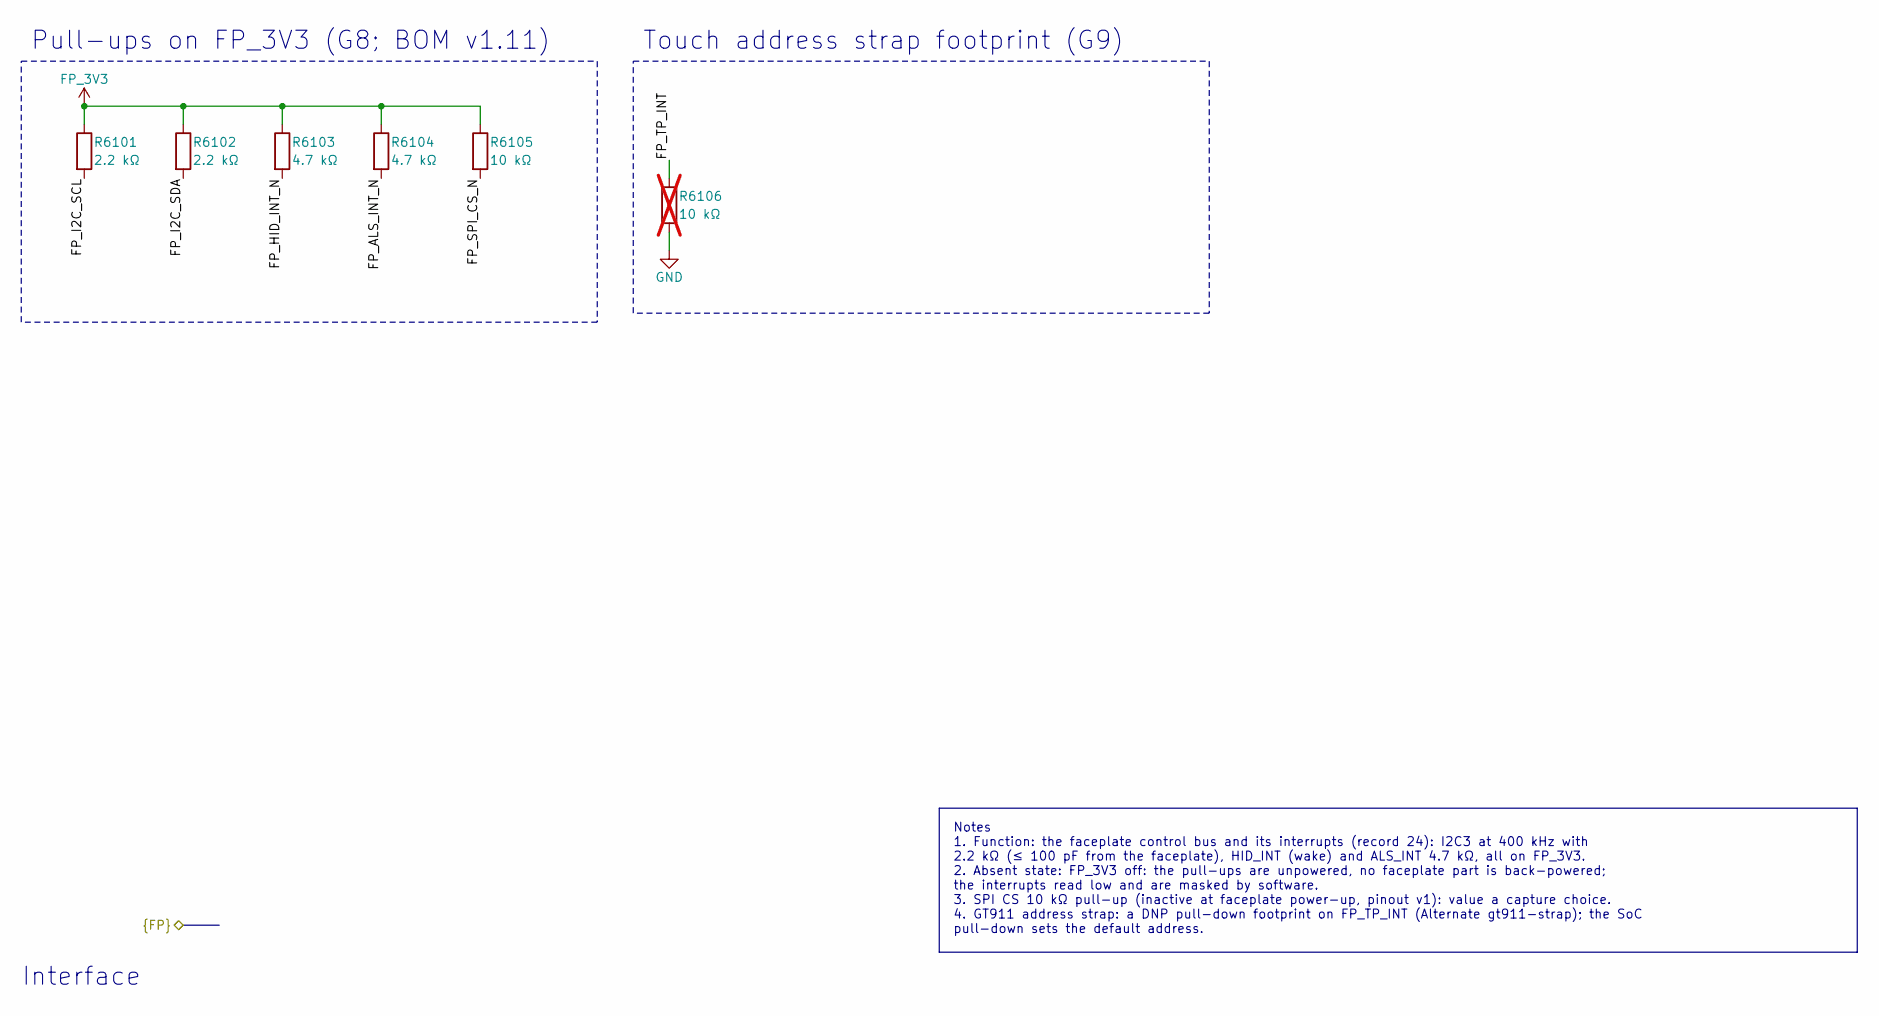
[picture p33: schematic fp-controls.kicad_sch, Faceplate controls]

Parts:
R6101, R6102: 2.2 kΩ; R_0201_0603Metric; MPN RC0201FR-072K2L
R6103, R6104: 4.7 kΩ; R_0201_0603Metric; MPN RC0201FR-074K7L
R6105: 10 kΩ; R_0201_0603Metric; MPN RC0201FR-0710KL
R6106: 10 kΩ; R_0201_0603Metric; MPN RC0201FR-0710KL; not fitted

Connections:
/FP_ALS_INT_N: R6104.2; also elsewhere on the board
/FP_HID_INT_N: R6103.2; also elsewhere on the board
/FP_I2C_SCL: R6101.2; also elsewhere on the board
/FP_I2C_SDA: R6102.2; also elsewhere on the board
/FP_SPI_CS_N: R6105.2; also elsewhere on the board
/FP_TP_INT: R6106.1; also elsewhere on the board
FP_3V3: R6101.1, R6102.1, R6103.1, R6104.1, R6105.1; also elsewhere on the board
GND: R6106.2; also elsewhere on the board

Notes on the sheet:
Pull-ups on FP_3V3 (G8; BOM v1.11)
Touch address strap footprint (G9)
Notes 1. Function: the faceplate control bus and its interrupts (record 24): I2C3 at 400 kHz with 2.2 kΩ (≤ 100 pF from the faceplate), HID_INT (wake) and ALS_INT 4.7 kΩ, all on FP_3V3. 2. Absent state: FP_3V3 off: the pull-ups are unpowered, no faceplate part is back-powered; the interrupts read l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
Interface

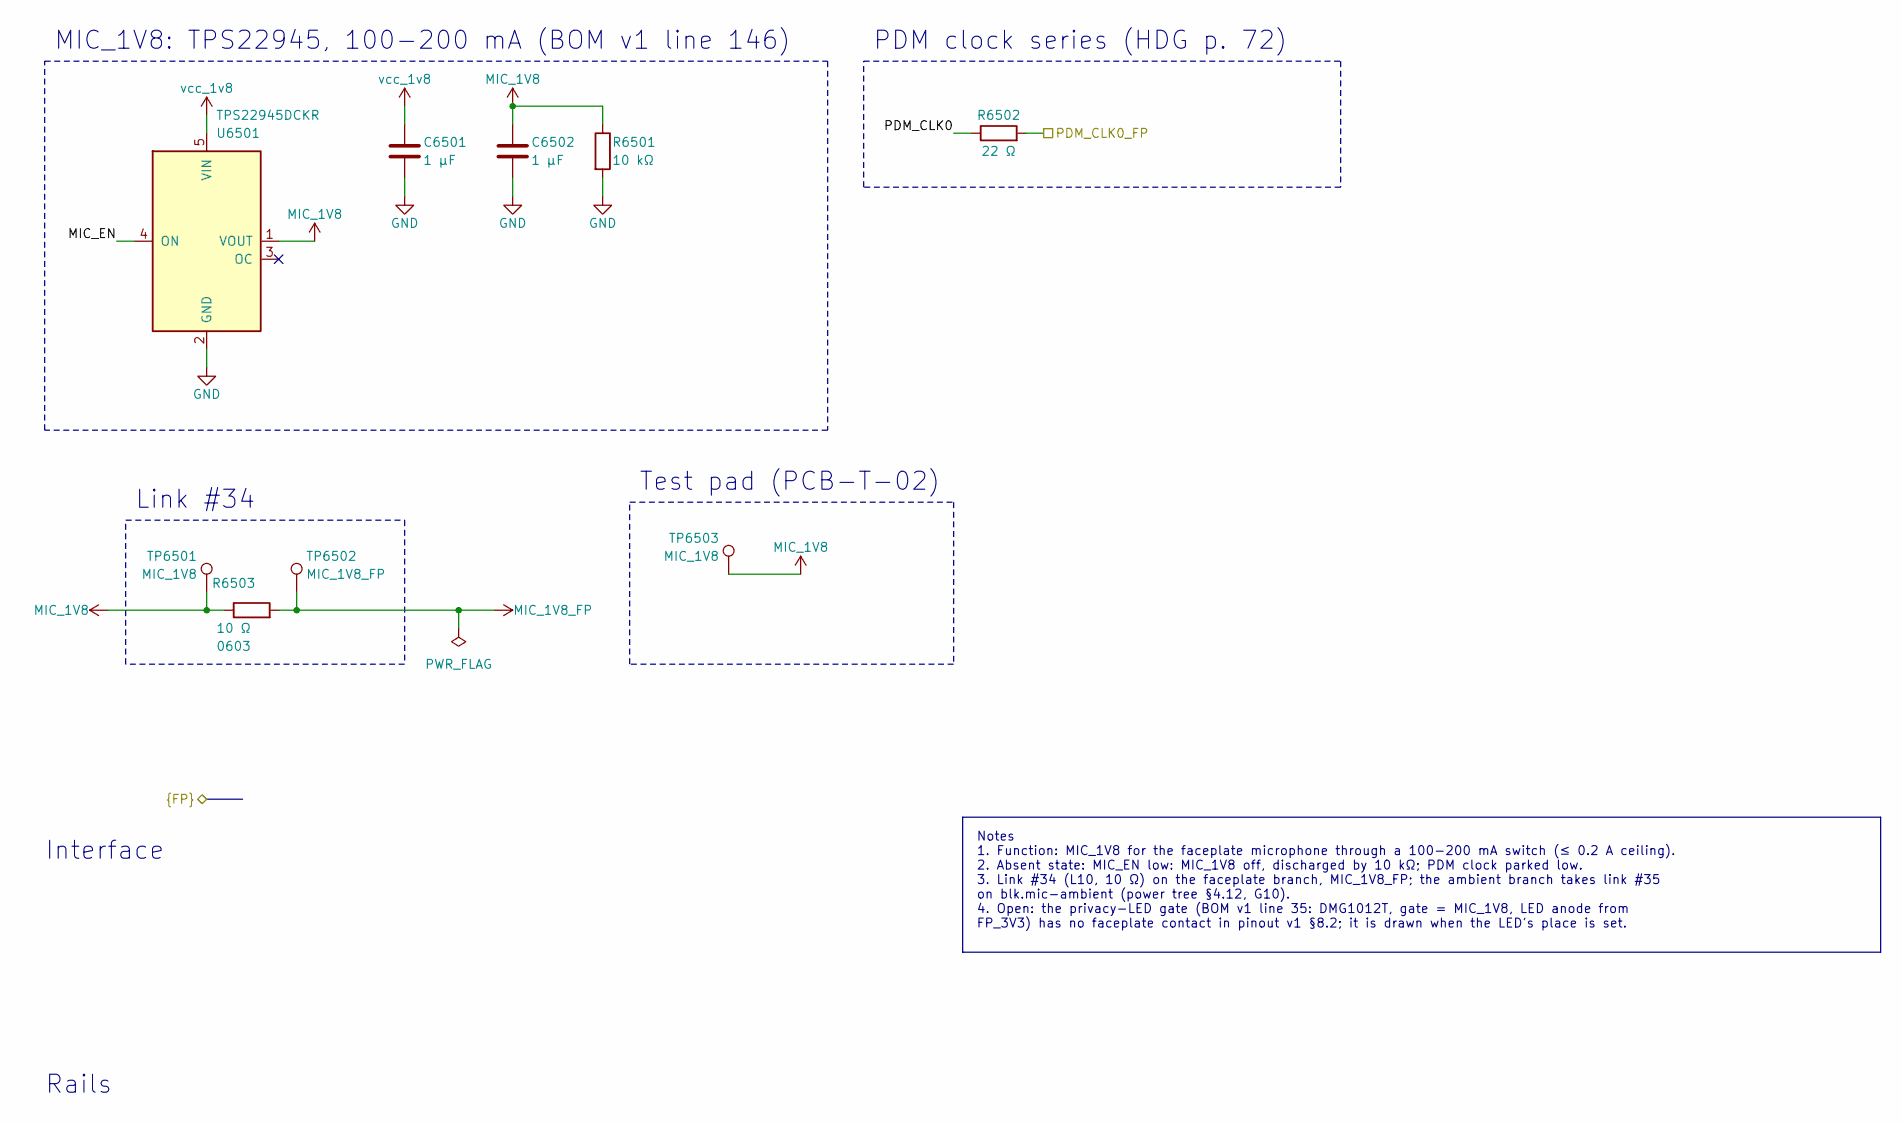
[picture p34: schematic mic-main.kicad_sch, Microphone supply]

Parts:
C6501: 1 µF; C_0402_1005Metric; MPN GRM155C71A105KE11D
C6502: 1 µF; C_0201_0603Metric; MPN GRM033R60J105MEA2D
R6501: 10 kΩ; R_0201_0603Metric; MPN RC0201FR-0710KL
R6502: 22 Ω; R_0201_0603Metric; MPN RC0201FR-0722RL
R6503: 10 Ω; R_0603_1608Metric; MPN RC0603FR-0710RL
TP6501, TP6503: MIC_1V8; TestPoint_Pad_D1.0mm
TP6502: MIC_1V8_FP; TestPoint_Pad_D1.0mm
U6501: TPS22945DCKR; Texas_DCK0005A_SC-70-5_1.25x2mm_P0.65mm; MPN TPS22945DCKR

Connections:
/MIC_EN: U6501.4 (ON); also elsewhere on the board
/PDM_CLK0: R6502.1; also elsewhere on the board
/PDM_CLK0_FP: R6502.2; also elsewhere on the board
GND: C6501.2, C6502.2, R6501.2, U6501.2 (GND); also elsewhere on the board
MIC_1V8: C6502.1, R6501.1, R6503.1, TP6501.1, TP6503.1, U6501.1 (VOUT); also elsewhere on the board
MIC_1V8_FP: R6503.2, TP6502.1; also elsewhere on the board
vcc_1v8: C6501.1, U6501.5 (VIN); also elsewhere on the board

Notes on the sheet:
MIC_1V8: TPS22945, 100-200 mA (BOM v1 line 146)
PDM clock series (HDG p. 72)
Link #34
Test pad (PCB-T-02)
Notes 1. Function: MIC_1V8 for the faceplate microphone through a 100-200 mA switch (≤ 0.2 A ceiling). 2. Absent state: MIC_EN low: MIC_1V8 off, discharged by 10 kΩ; PDM clock parked low. 3. Link #34 (L10, 10 Ω) on the faceplate branch, MIC_1V8_FP; the ambient branch takes link #35 on blk.mic-ambie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
Rails
Interface
