opendap-project/t1/board/hardware/t1-main-board/t1-main-board.kicad_pcb

## KiCad design board/hardware/t1-main-board/t1-main-board.kicad_pcb (continued)

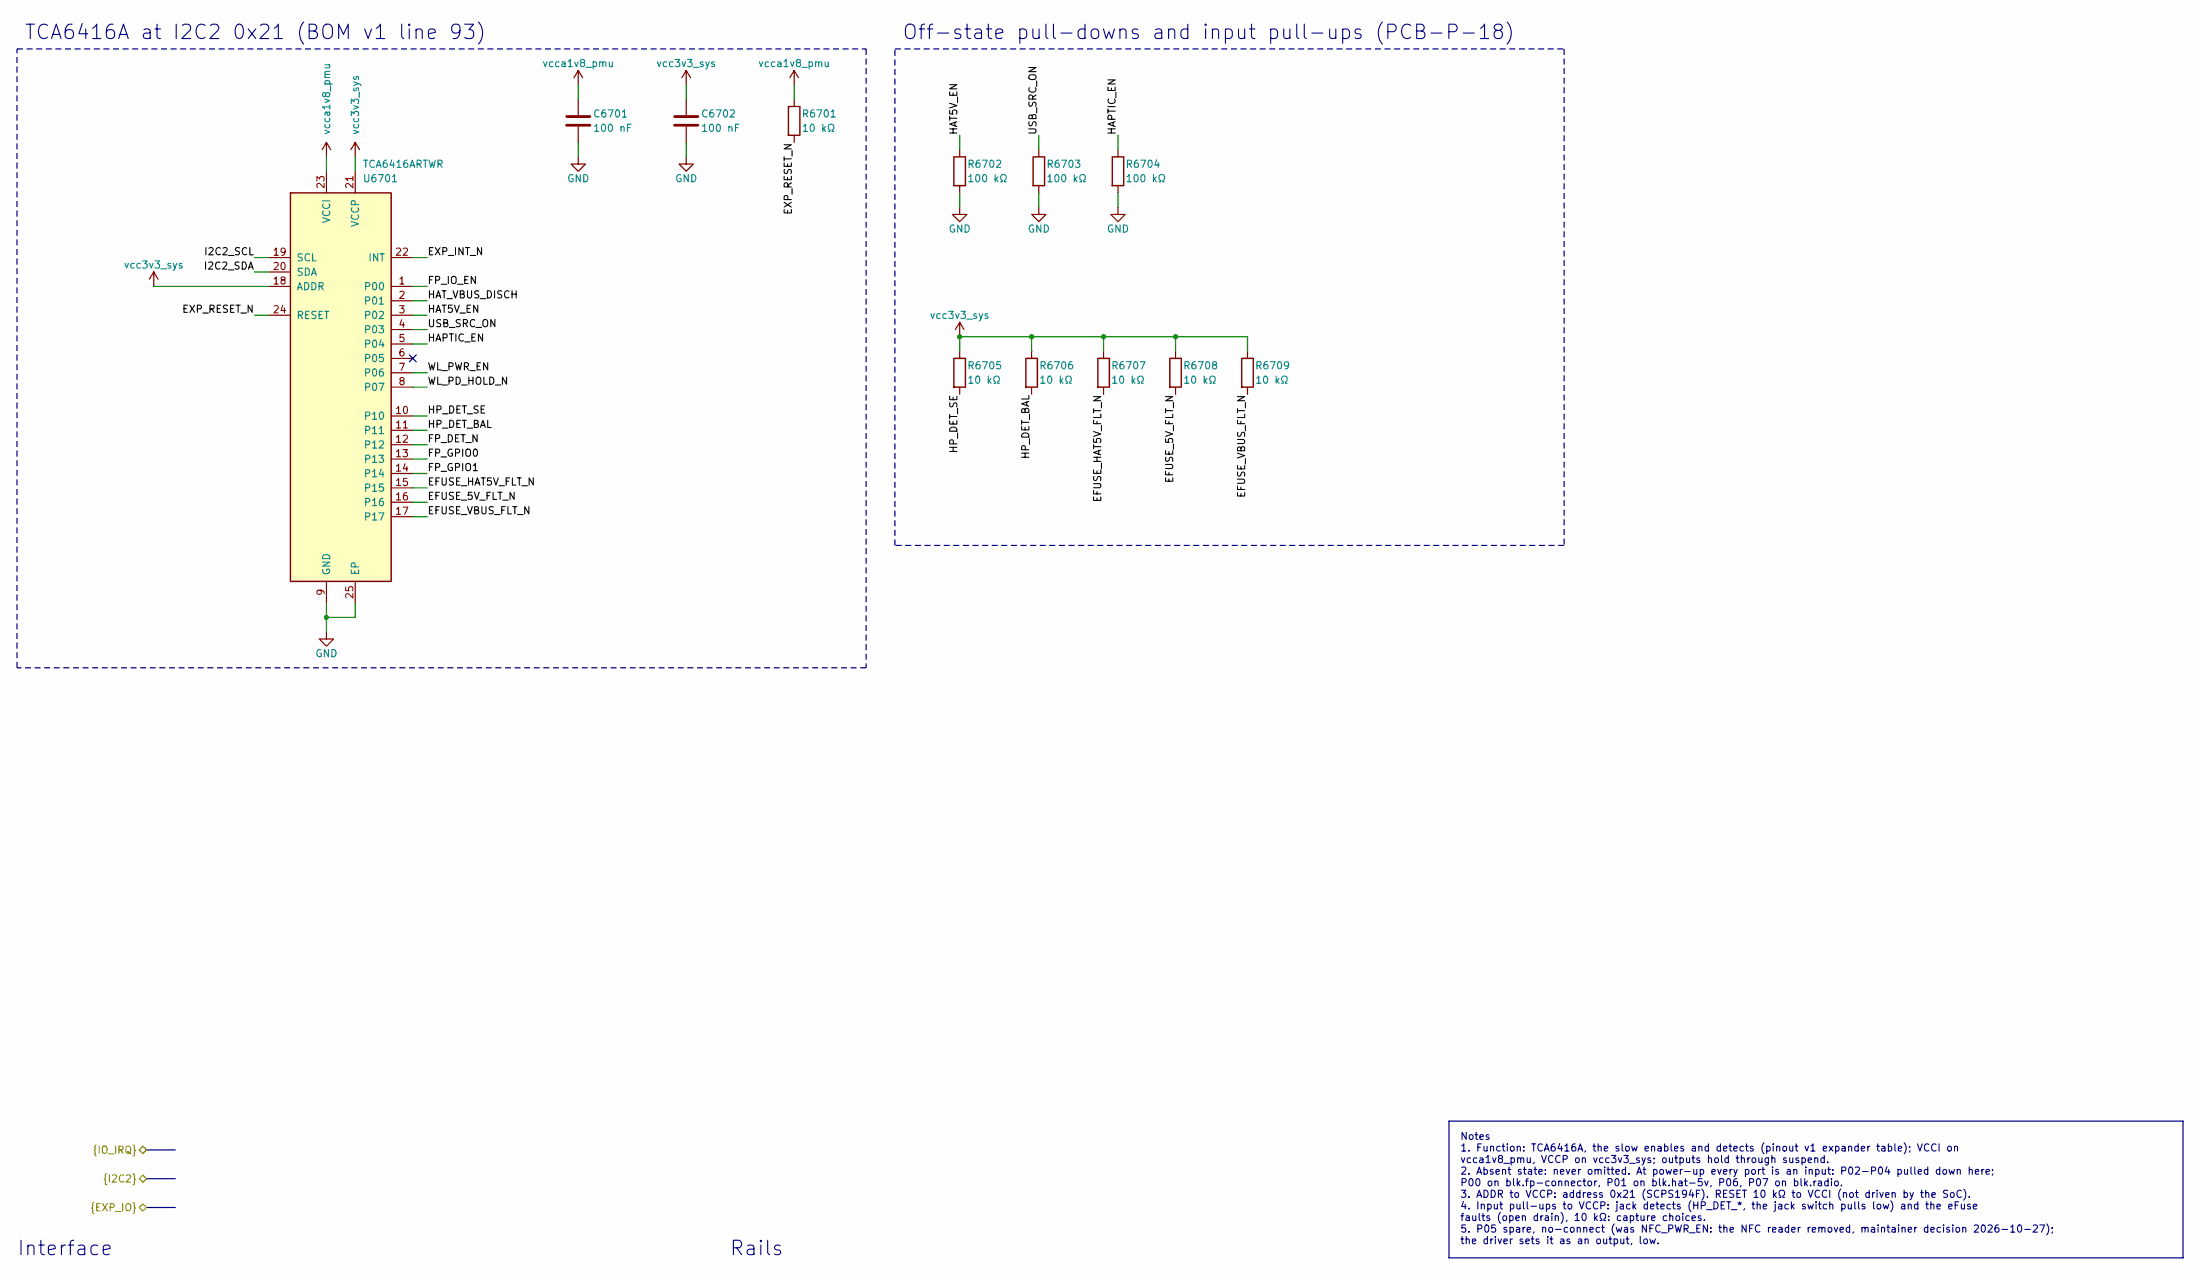
[picture p35: schematic gpio-expander.kicad_sch, GPIO expander]

Parts:
C6701, C6702: 100 nF; C_0201_0603Metric; MPN GRM033R61A104KE15D
R6701, R6705, R6706, R6707, R6708, R6709: 10 kΩ; R_0201_0603Metric; MPN RC0201FR-0710KL
R6702, R6703, R6704: 100 kΩ; R_0201_0603Metric; MPN RC0201FR-07100KL
U6701: TCA6416ARTWR; Texas_RTW0024B_WQFN-24-1EP_4x4mm_P0.5mm_EP2.45x2.45mm_Therm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; MPN TCA6416ARTWR

Connections:
/EFUSE_5V_FLT_N: R6708.2, U6701.16; also elsewhere on the board
/EFUSE_HAT5V_FLT_N: R6707.2, U6701.15; also elsewhere on the board
/EFUSE_VBUS_FLT_N: R6709.2, U6701.17; also elsewhere on the board
/EXP_INT_N: U6701.22 (INT); also elsewhere on the board
/FP_DET_N: U6701.12; also elsewhere on the board
/FP_GPIO0: U6701.13; also elsewhere on the board
/FP_GPIO1: U6701.14; also elsewhere on the board
/FP_IO_EN: U6701.1 (P00); also elsewhere on the board
/GPIO expander/EXP_RESET_N: R6701.2, U6701.24 (RESET)
/HAPTIC_EN: R6704.1, U6701.5 (P04); also elsewhere on the board
/HAT5V_EN: R6702.1, U6701.3 (P02); also elsewhere on the board
/HAT_VBUS_DISCH: U6701.2 (P01); also elsewhere on the board
/HP_DET_BAL: R6706.2, U6701.11; also elsewhere on the board
/HP_DET_SE: R6705.2, U6701.10; also elsewhere on the board
/I2C2_SCL: U6701.19 (SCL); also elsewhere on the board
/I2C2_SDA: U6701.20 (SDA); also elsewhere on the board
/USB_SRC_ON: R6703.1, U6701.4 (P03); also elsewhere on the board
/WL_PD_HOLD_N: U6701.8 (P07); also elsewhere on the board
/WL_PWR_EN: U6701.7 (P06); also elsewhere on the board
GND: C6701.2, C6702.2, R6702.2, R6703.2, R6704.2, U6701.9 (GND), U6701.25 (EP); also elsewhere on the board
vcc3v3_sys: C6702.1, R6705.1, R6706.1, R6707.1, R6708.1, R6709.1, U6701.18 (ADDR), U6701.21 (VCCP); also elsewhere on the board
vcca1v8_pmu: C6701.1, R6701.1, U6701.23 (VCCI); also elsewhere on the board

Notes on the sheet:
TCA6416A at I2C2 0x21 (BOM v1 line 93)
Off-state pull-downs and input pull-ups (PCB-P-18)
Notes 1. Function: TCA6416A, the slow enables and detects (pinout v1 expander table); VCCI on vcca1v8_pmu, VCCP on vcc3v3_sys; outputs hold through suspend. 2. Absent state: never omitted. At power-up every port is an input: P02-P04 pulled down here; P00 on blk.fp-connector, P01 on blk.hat-5v, P06,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
Interface
Rails

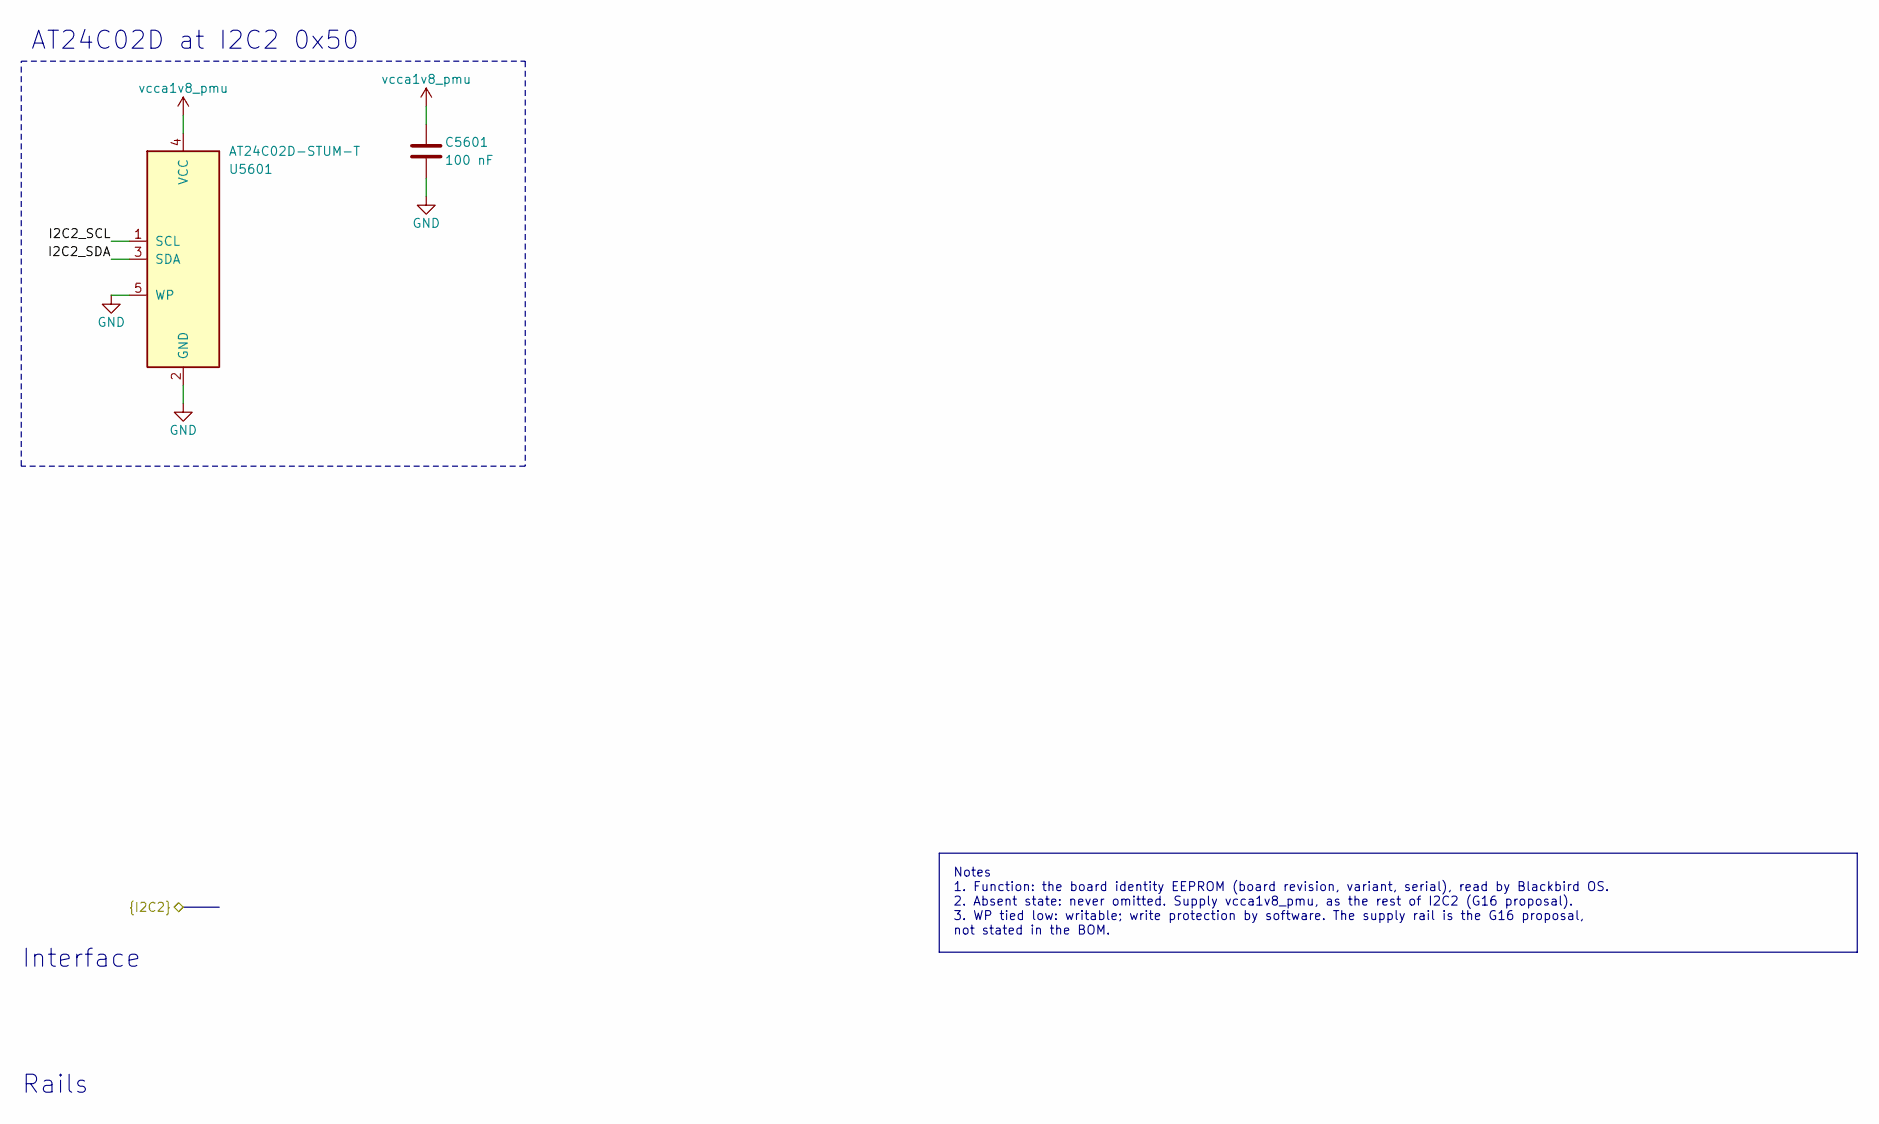
[picture p36: schematic board-id.kicad_sch, Board EEPROM]

Parts:
C5601: 100 nF; C_0201_0603Metric; MPN GRM033R61A104KE15D
U5601: AT24C02D-STUM-T; Microchip_5TS1_SOT-23-5_1.6x2.9mm_P0.95mm; MPN AT24C02D-STUM-T

Connections:
/I2C2_SCL: U5601.1 (SCL); also elsewhere on the board
/I2C2_SDA: U5601.3 (SDA); also elsewhere on the board
GND: C5601.2, U5601.2 (GND), U5601.5 (WP); also elsewhere on the board
vcca1v8_pmu: C5601.1, U5601.4 (VCC); also elsewhere on the board

Notes on the sheet:
AT24C02D at I2C2 0x50
Notes 1. Function: the board identity EEPROM (board revision, variant, serial), read by Blackbird OS. 2. Absent state: never omitted. Supply vcca1v8_pmu, as the rest of I2C2 (G16 proposal). 3. WP tied low: writable; write protection by software. The supply rail is the G16 proposal, not stated in th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
Rails
Interface

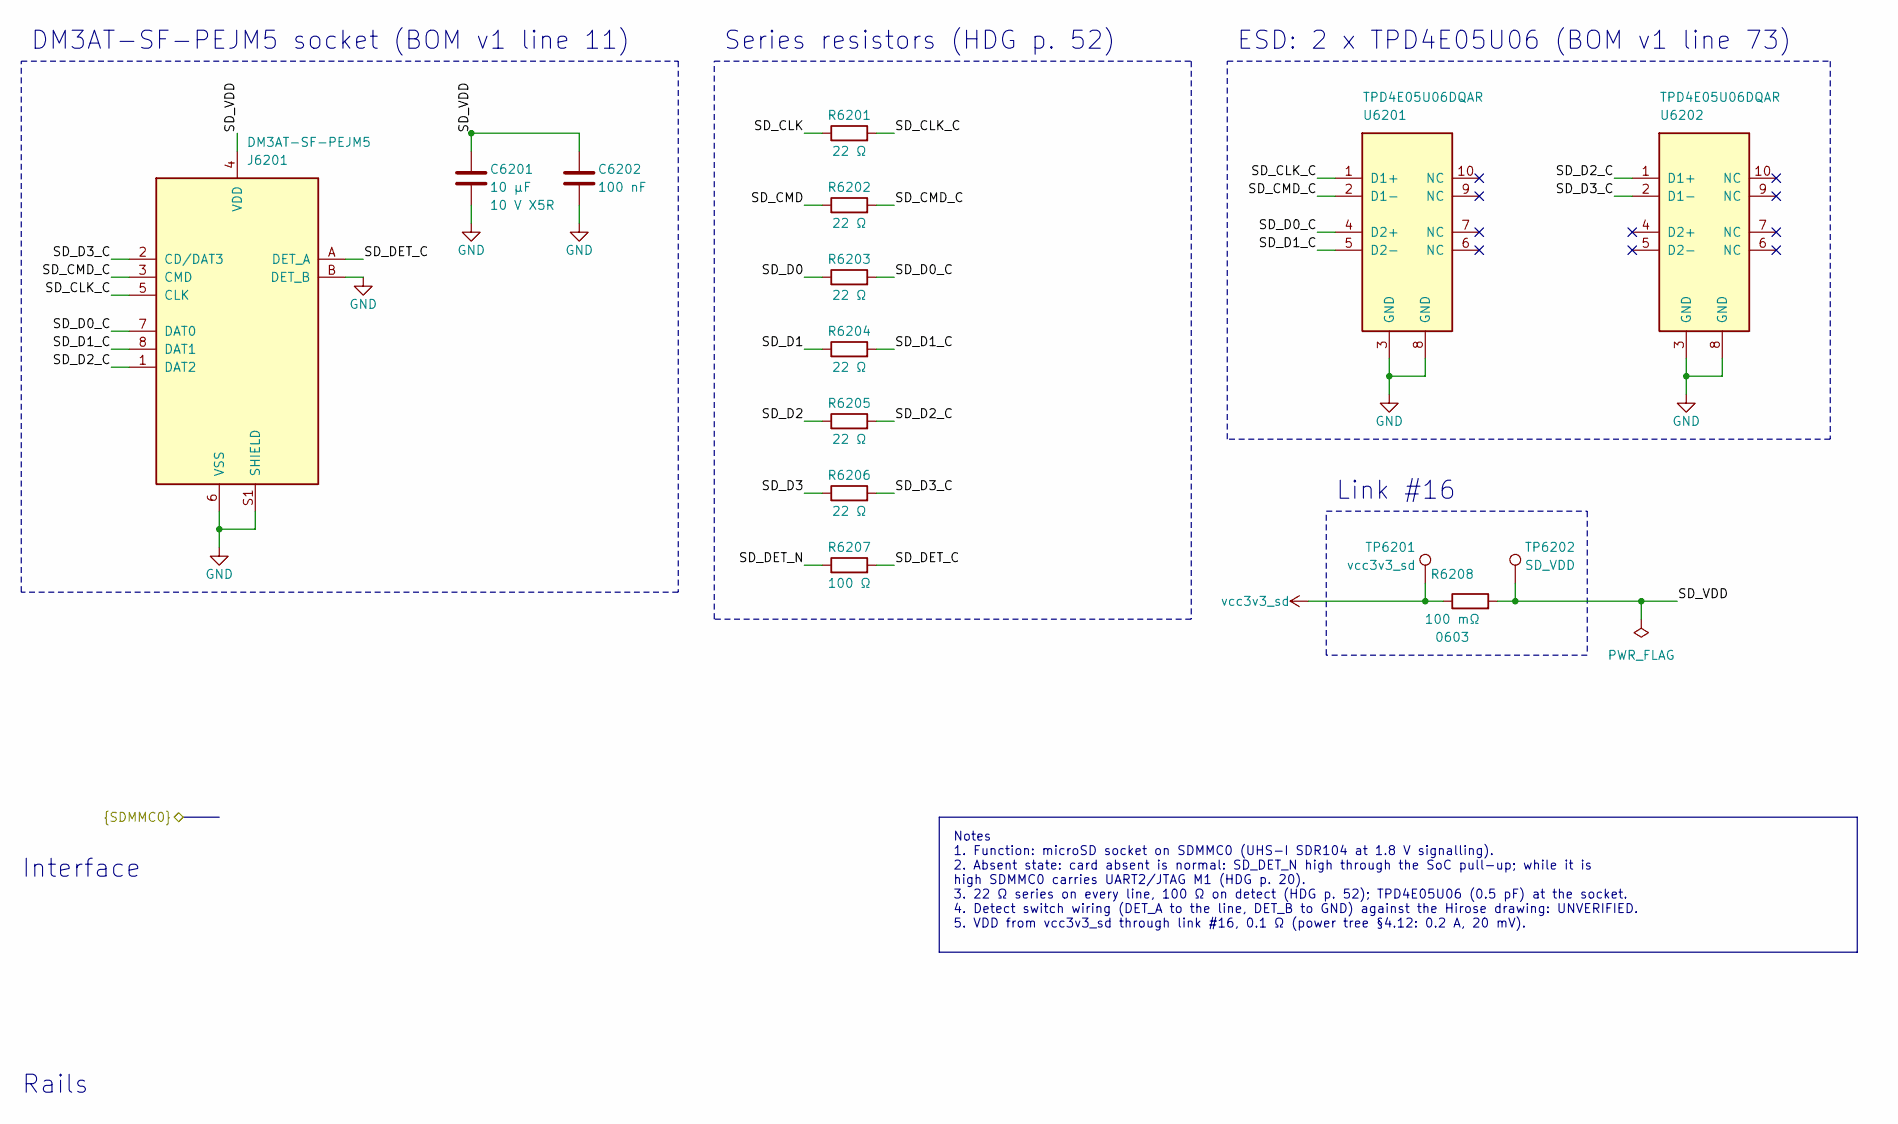
[picture p37: schematic microsd.kicad_sch, microSD socket]

Parts:
C6201: 10 µF; C_0603_1608Metric; MPN GRM188R61A106KE69D
C6202: 100 nF; C_0201_0603Metric; MPN GRM033R61A104KE15D
J6201: DM3AT-SF-PEJM5; Hirose_DM3AT-SF-PEJM5_microSD_PushPush_Top; MPN DM3AT-SF-PEJM5
R6201, R6202, R6203, R6204, R6205, R6206: 22 Ω; R_0201_0603Metric; MPN RC0201FR-0722RL
R6207: 100 Ω; R_0201_0603Metric; MPN RC0201FR-07100RL
R6208: 100 mΩ; R_0603_1608Metric; MPN RL0603FR-070R1L
TP6201: vcc3v3_sd; TestPoint_Pad_D1.0mm
TP6202: SD_VDD; TestPoint_Pad_D1.0mm
U6201, U6202: TPD4E05U06DQAR; Texas_DQA0010A_USON-10_1x2.5mm_P0.5mm; MPN TPD4E05U06DQAR

Connections:
/SD_CLK: R6201.1; also elsewhere on the board
/SD_CMD: R6202.1; also elsewhere on the board
/SD_D0: R6203.1; also elsewhere on the board
/SD_D1: R6204.1; also elsewhere on the board
/SD_D2: R6205.1; also elsewhere on the board
/SD_D3: R6206.1; also elsewhere on the board
/SD_DET_N: R6207.1; also elsewhere on the board
/microSD socket/SD_CLK_C: J6201.5 (CLK), R6201.2, U6201.1 (D1+)
/microSD socket/SD_CMD_C: J6201.3 (CMD), R6202.2, U6201.2 (D1-)
/microSD socket/SD_D0_C: J6201.7 (DAT0), R6203.2, U6201.4 (D2+)
/microSD socket/SD_D1_C: J6201.8 (DAT1), R6204.2, U6201.5 (D2-)
/microSD socket/SD_D2_C: J6201.1 (DAT2), R6205.2, U6202.1 (D1+)
/microSD socket/SD_D3_C: J6201.2 (CD/DAT3), R6206.2, U6202.2 (D1-)
/microSD socket/SD_DET_C: J6201.A (DET_A), R6207.2
/microSD socket/SD_VDD: C6201.1, C6202.1, J6201.4 (VDD), R6208.2, TP6202.1
GND: C6201.2, C6202.2, J6201.6 (VSS), J6201.B (DET_B), J6201.S1 (SHIELD), U6201.3 (GND), U6201.8 (GND), U6202.3 (GND), U6202.8 (GND); also elsewhere on the board
vcc3v3_sd: R6208.1, TP6201.1; also elsewhere on the board

Notes on the sheet:
DM3AT-SF-PEJM5 socket (BOM v1 line 11)
Series resistors (HDG p. 52)
ESD: 2 x TPD4E05U06 (BOM v1 line 73)
Link #16
Notes 1. Function: microSD socket on SDMMC0 (UHS-I SDR104 at 1.8 V signalling). 2. Absent state: card absent is normal: SD_DET_N high through the SoC pull-up; while it is high SDMMC0 carries UART2/JTAG M1 (HDG p. 20). 3. 22 Ω series on every line, 100 Ω on detect (HDG p. 52); TPD4E05U06 (0.5 pF) at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
Rails
Interface

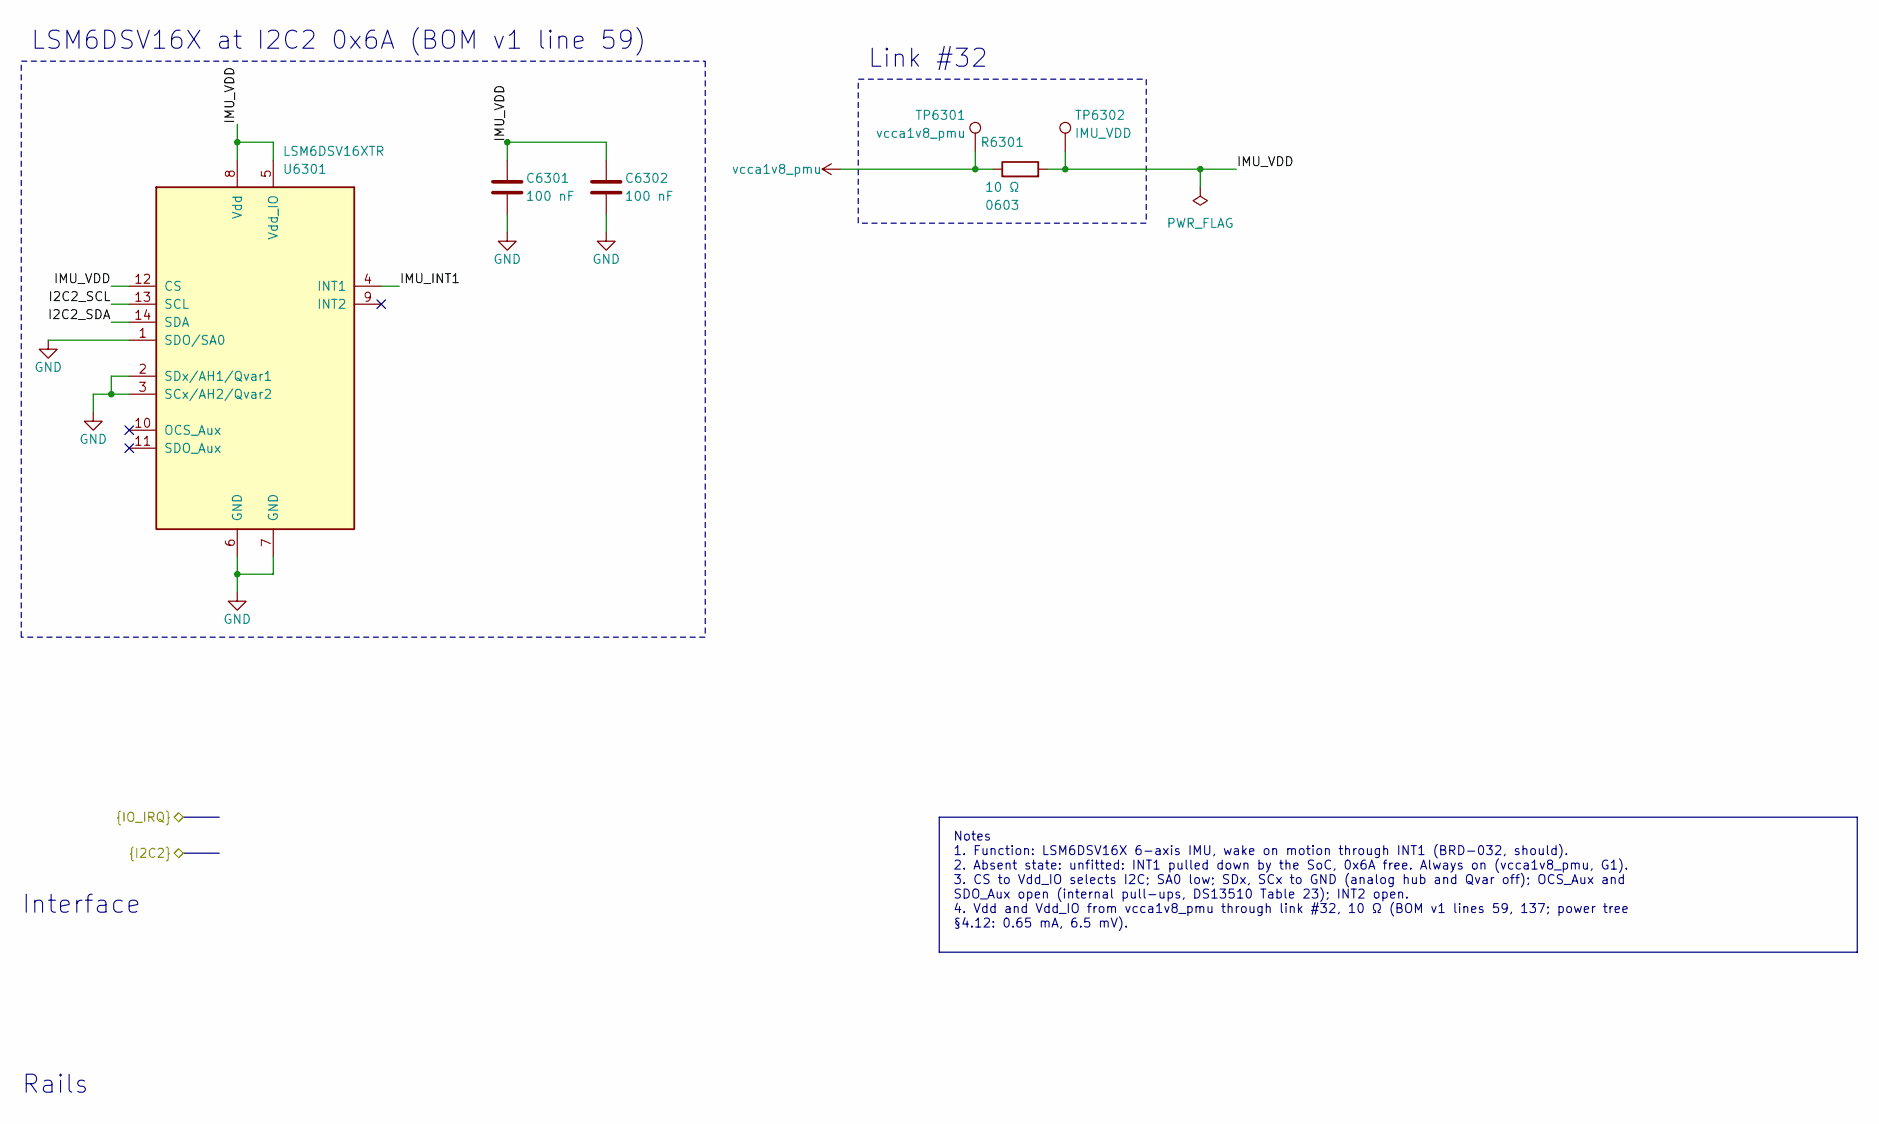
[picture p38: schematic imu.kicad_sch, Motion sensor]

Parts:
C6301, C6302: 100 nF; C_0201_0603Metric; MPN GRM033R61A104KE15D
R6301: 10 Ω; R_0603_1608Metric; MPN RC0603FR-0710RL
TP6301: vcca1v8_pmu; TestPoint_Pad_D1.0mm
TP6302: IMU_VDD; TestPoint_Pad_D1.0mm
U6301: LSM6DSV16XTR; ST_LGA-14L_2.5x3mm_P0.5mm; MPN LSM6DSV16XTR

Connections:
/I2C2_SCL: U6301.13 (SCL); also elsewhere on the board
/I2C2_SDA: U6301.14 (SDA); also elsewhere on the board
/IMU_INT1: U6301.4 (INT1); also elsewhere on the board
/Motion sensor/IMU_VDD: C6301.1, C6302.1, R6301.2, TP6302.1, U6301.5 (Vdd_IO), U6301.8 (Vdd), U6301.12 (CS)
GND: C6301.2, C6302.2, U6301.1 (SDO/SA0), U6301.2 (SDx/AH1/Qvar1), U6301.3 (SCx/AH2/Qvar2), U6301.6 (GND), U6301.7 (GND); also elsewhere on the board
vcca1v8_pmu: R6301.1, TP6301.1; also elsewhere on the board

Notes on the sheet:
LSM6DSV16X at I2C2 0x6A (BOM v1 line 59)
Link #32
Notes 1. Function: LSM6DSV16X 6-axis IMU, wake on motion through INT1 (BRD-032, should). 2. Absent state: unfitted: INT1 pulled down by the SoC, 0x6A free. Always on (vcca1v8_pmu, G1). 3. CS to Vdd_IO selects I2C; SA0 low; SDx, SCx to GND (analog hub and Qvar off); OCS_Aux and SDO_Aux open (interna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
Rails
Interface

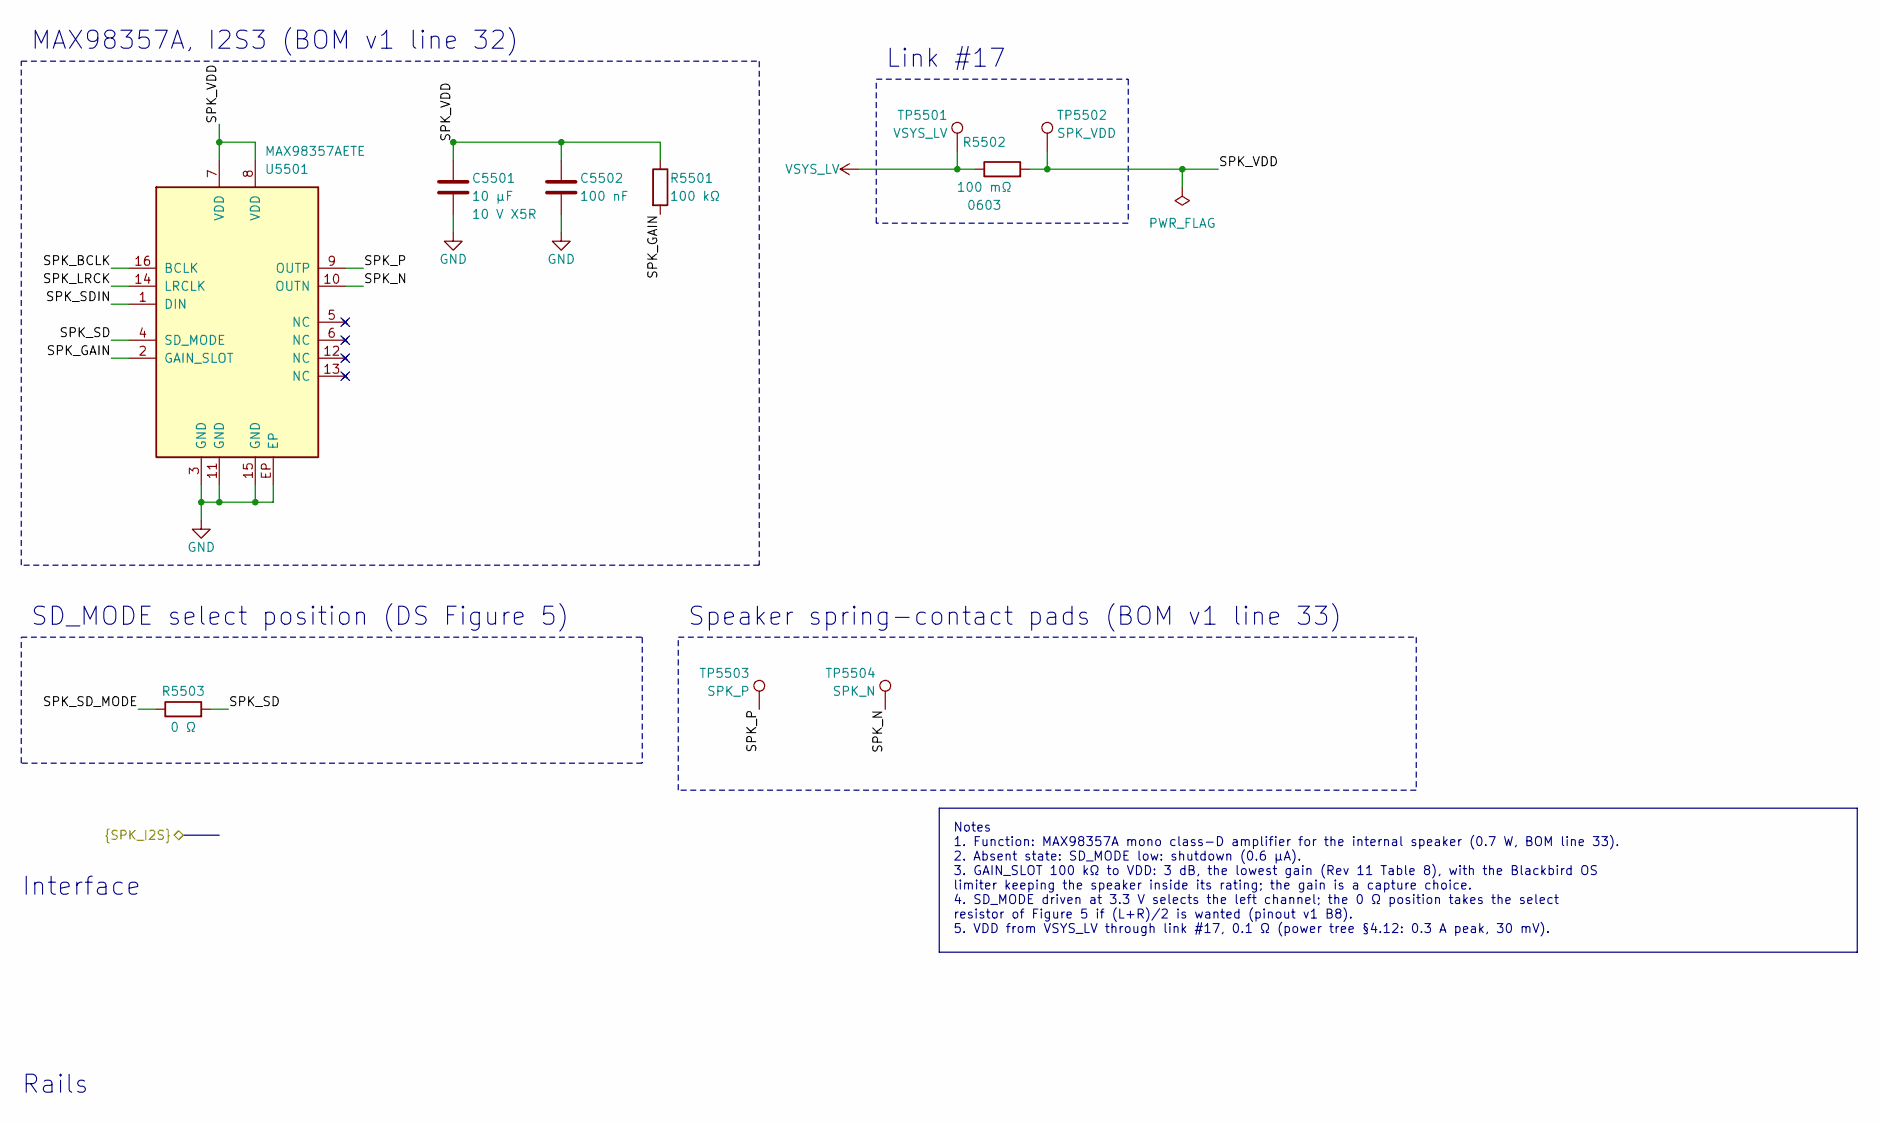
[picture p39: schematic speaker.kicad_sch, Speaker amplifier]

Parts:
C5501: 10 µF; C_0603_1608Metric; MPN GRM188R61A106KE69D
C5502: 100 nF; C_0402_1005Metric; MPN GRM155R71C104KA88D
R5501: 100 kΩ; R_0201_0603Metric; MPN RC0201FR-07100KL
R5502: 100 mΩ; R_0603_1608Metric; MPN RL0603FR-070R1L
R5503: 0 Ω; R_0402_1005Metric; MPN RC0402JR-070RL
TP5501: VSYS_LV; TestPoint_Pad_D1.0mm
TP5502: SPK_VDD; TestPoint_Pad_D1.0mm
TP5503: SPK_P; TestPoint_Pad_D1.0mm
TP5504: SPK_N; TestPoint_Pad_D1.0mm
U5501: MAX98357AETE; Maxim_T1633-4_TQFN-16-1EP_3x3mm_P0.5mm_EP1.1x1.1mm; MPN MAX98357AETE+T

Connections:
/SPK_BCLK: U5501.16 (BCLK); also elsewhere on the board
/SPK_LRCK: U5501.14 (LRCLK); also elsewhere on the board
/SPK_SDIN: U5501.1 (DIN); also elsewhere on the board
/SPK_SD_MODE: R5503.1; also elsewhere on the board
/Speaker amplifier/SPK_GAIN: R5501.2, U5501.2 (GAIN_SLOT)
/Speaker amplifier/SPK_N: TP5504.1, U5501.10 (OUTN)
/Speaker amplifier/SPK_P: TP5503.1, U5501.9 (OUTP)
/Speaker amplifier/SPK_SD: R5503.2, U5501.4 (SD_MODE)
/Speaker amplifier/SPK_VDD: C5501.1, C5502.1, R5501.1, R5502.2, TP5502.1, U5501.7 (VDD), U5501.8 (VDD)
GND: C5501.2, C5502.2, U5501.3 (GND), U5501.11 (GND), U5501.15 (GND), U5501.EP; also elsewhere on the board
VSYS_LV: R5502.1, TP5501.1; also elsewhere on the board

Notes on the sheet:
MAX98357A, I2S3 (BOM v1 line 32)
Link #17
SD_MODE select position (DS Figure 5)
Speaker spring-contact pads (BOM v1 line 33)
Notes 1. Function: MAX98357A mono class-D amplifier for the internal speaker (0.7 W, BOM line 33). 2. Absent state: SD_MODE low: shutdown (0.6 µA). 3. GAIN_SLOT 100 kΩ to VDD: 3 dB, the lowest gain (Rev 11 Table 8), with the Blackbird OS limiter keeping the speaker inside its rating; the gain is a 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
Rails
Interface

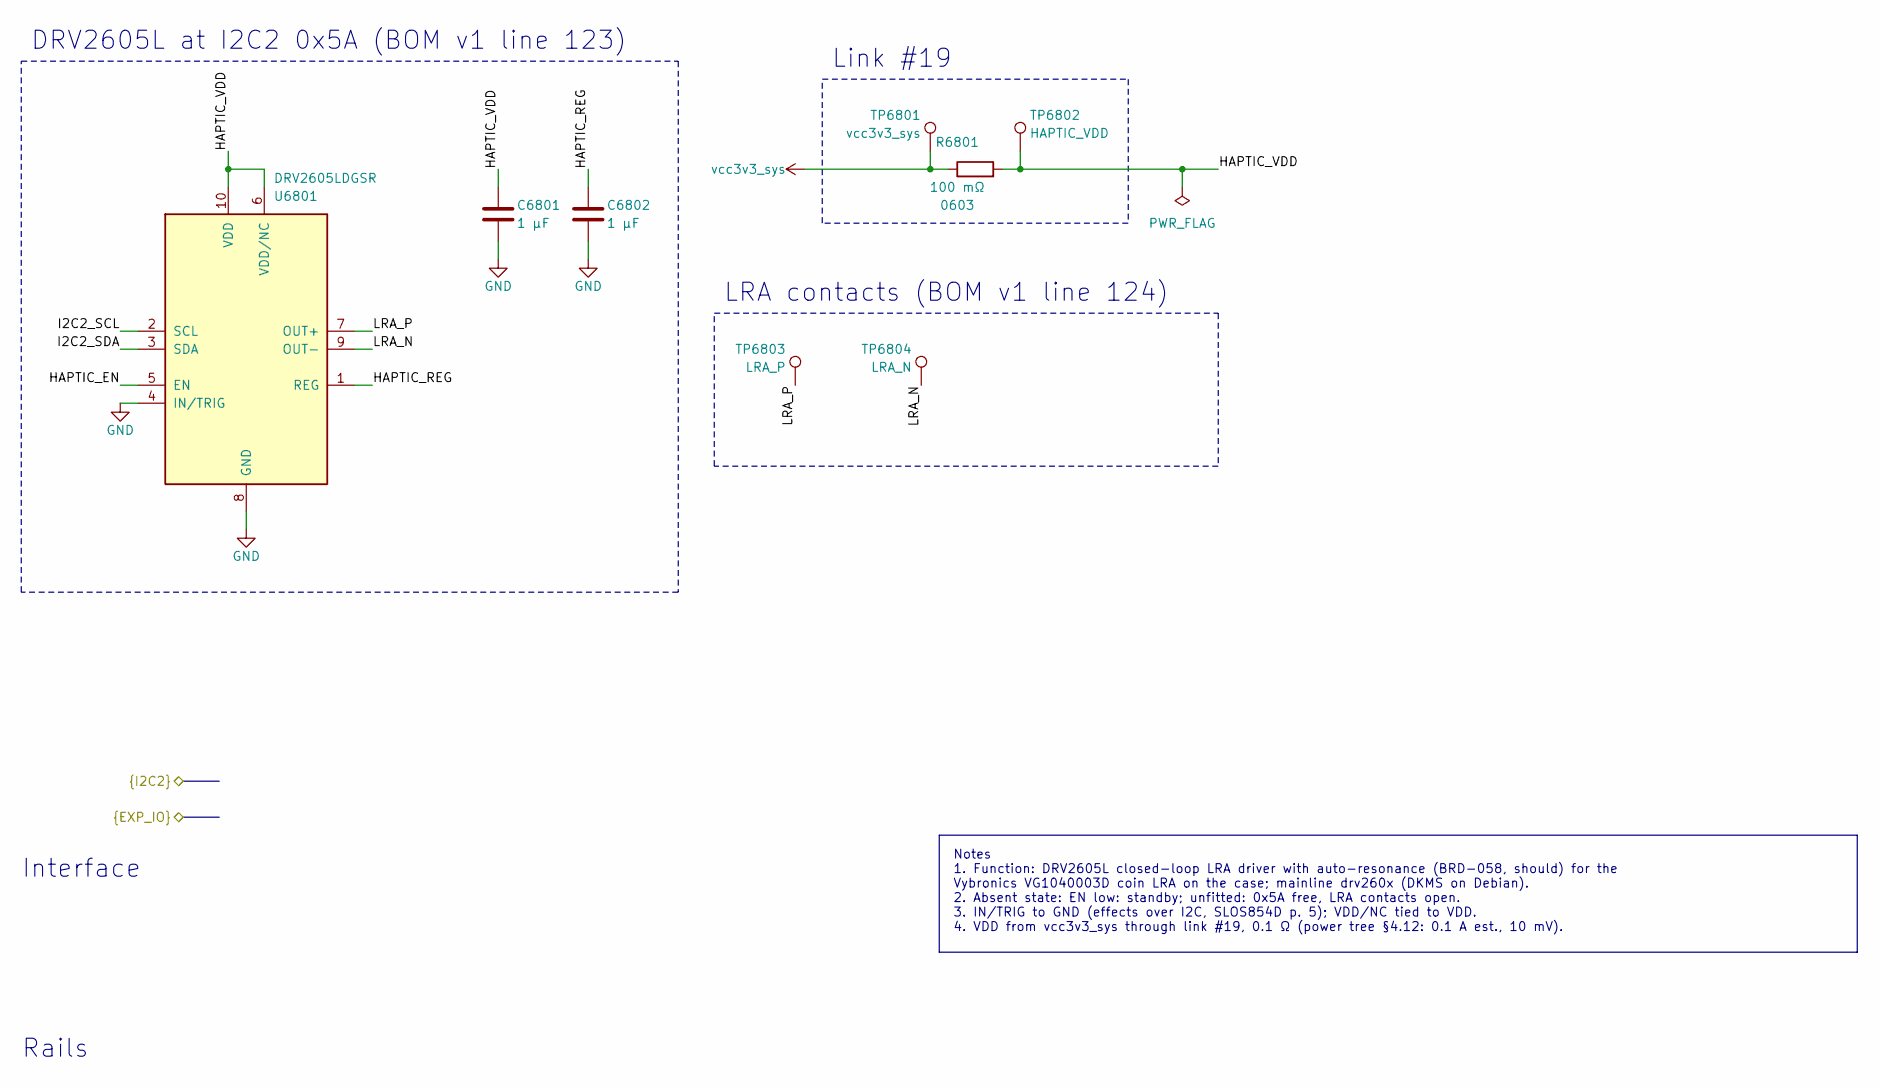
[picture p40: schematic haptics.kicad_sch, Haptic driver]

Parts:
C6801, C6802: 1 µF; C_0402_1005Metric; MPN GRM155C71A105KE11D
R6801: 100 mΩ; R_0603_1608Metric; MPN RL0603FR-070R1L
TP6801: vcc3v3_sys; TestPoint_Pad_D1.0mm
TP6802: HAPTIC_VDD; TestPoint_Pad_D1.0mm
TP6803: LRA_P; TestPoint_Pad_D1.0mm
TP6804: LRA_N; TestPoint_Pad_D1.0mm
U6801: DRV2605LDGSR; Texas_DGS0010A_VSSOP-10_3x3mm_P0.5mm; MPN DRV2605LDGSR

Connections:
/HAPTIC_EN: U6801.5 (EN); also elsewhere on the board
/Haptic driver/HAPTIC_REG: C6802.1, U6801.1 (REG)
/Haptic driver/HAPTIC_VDD: C6801.1, R6801.2, TP6802.1, U6801.6 (VDD/NC), U6801.10 (VDD)
/Haptic driver/LRA_N: TP6804.1, U6801.9 (OUT-)
/Haptic driver/LRA_P: TP6803.1, U6801.7 (OUT+)
/I2C2_SCL: U6801.2 (SCL); also elsewhere on the board
/I2C2_SDA: U6801.3 (SDA); also elsewhere on the board
GND: C6801.2, C6802.2, U6801.4 (IN/TRIG), U6801.8 (GND); also elsewhere on the board
vcc3v3_sys: R6801.1, TP6801.1; also elsewhere on the board

Notes on the sheet:
DRV2605L at I2C2 0x5A (BOM v1 line 123)
Link #19
LRA contacts (BOM v1 line 124)
Notes 1. Function: DRV2605L closed-loop LRA driver with auto-resonance (BRD-058, should) for the Vybronics VG1040003D coin LRA on the case; mainline drv260x (DKMS on Debian). 2. Absent state: EN low: standby; unfitted: 0x5A free, LRA contacts open. 3. IN/TRIG to GND (effects over I2C, SLOS854D p. 5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
Rails
Interface

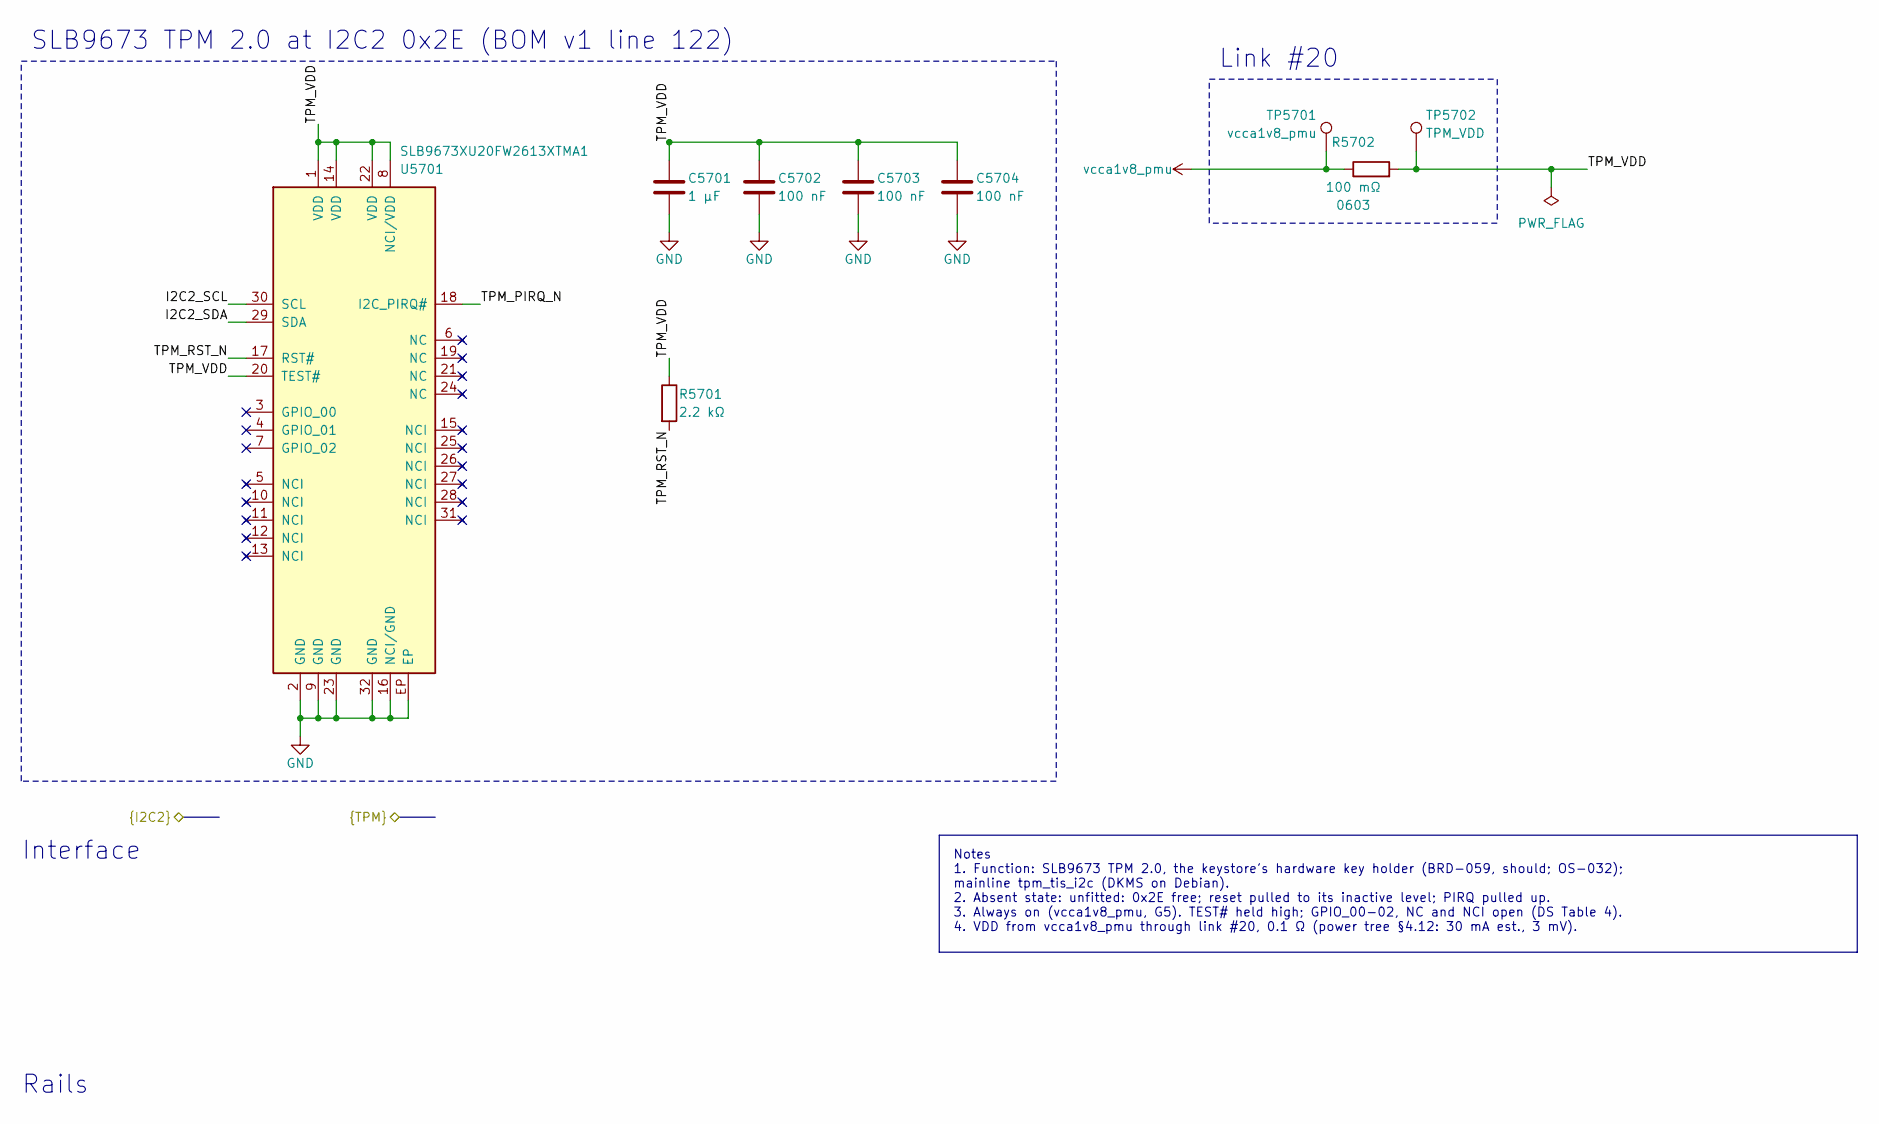
[picture p41: schematic tpm.kicad_sch, Hardware key holder]

Parts:
C5701: 1 µF; C_0402_1005Metric; MPN GRM155C71A105KE11D
C5702, C5703, C5704: 100 nF; C_0201_0603Metric; MPN GRM033R61A104KE15D
R5701: 2.2 kΩ; R_0201_0603Metric; MPN RC0201FR-072K2L
R5702: 100 mΩ; R_0603_1608Metric; MPN RL0603FR-070R1L
TP5701: vcca1v8_pmu; TestPoint_Pad_D1.0mm
TP5702: TPM_VDD; TestPoint_Pad_D1.0mm
U5701: SLB9673XU20FW2613XTMA1; Infineon_PG-UQFN-32-1_5x5mm_P0.5mm_EP3.6x3.6mm; MPN SLB9673XU20FW2613XTMA1

Connections:
/Hardware key holder/TPM_VDD: C5701.1, C5702.1, C5703.1, C5704.1, R5701.1, R5702.2, TP5702.1, U5701.1 (VDD), U5701.8 (NCI/VDD), U5701.14 (VDD), U5701.20 (TEST#), U5701.22 (VDD)
/I2C2_SCL: U5701.30 (SCL); also elsewhere on the board
/I2C2_SDA: U5701.29 (SDA); also elsewhere on the board
/TPM_PIRQ_N: U5701.18 (I2C_PIRQ#); also elsewhere on the board
/TPM_RST_N: R5701.2, U5701.17 (RST#); also elsewhere on the board
GND: C5701.2, C5702.2, C5703.2, C5704.2, U5701.2 (GND), U5701.9 (GND), U5701.16 (NCI/GND), U5701.23 (GND), U5701.32 (GND), U5701.EP; also elsewhere on the board
vcca1v8_pmu: R5702.1, TP5701.1; also elsewhere on the board

Notes on the sheet:
SLB9673 TPM 2.0 at I2C2 0x2E (BOM v1 line 122)
Link #20
Notes 1. Function: SLB9673 TPM 2.0, the keystore's hardware key holder (BRD-059, should; OS-032); mainline tpm_tis_i2c (DKMS on Debian). 2. Absent state: unfitted: 0x2E free; reset pulled to its inactive level; PIRQ pulled up. 3. Always on (vcca1v8_pmu, G5). TEST# held high; GPIO_00-02, NC and NCI 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
Rails
Interface
