opendap-project/t1/board/hardware/t1-main-board/t1-main-board.kicad_pcb

## KiCad design board/hardware/t1-main-board/t1-main-board.kicad_pcb (continued)

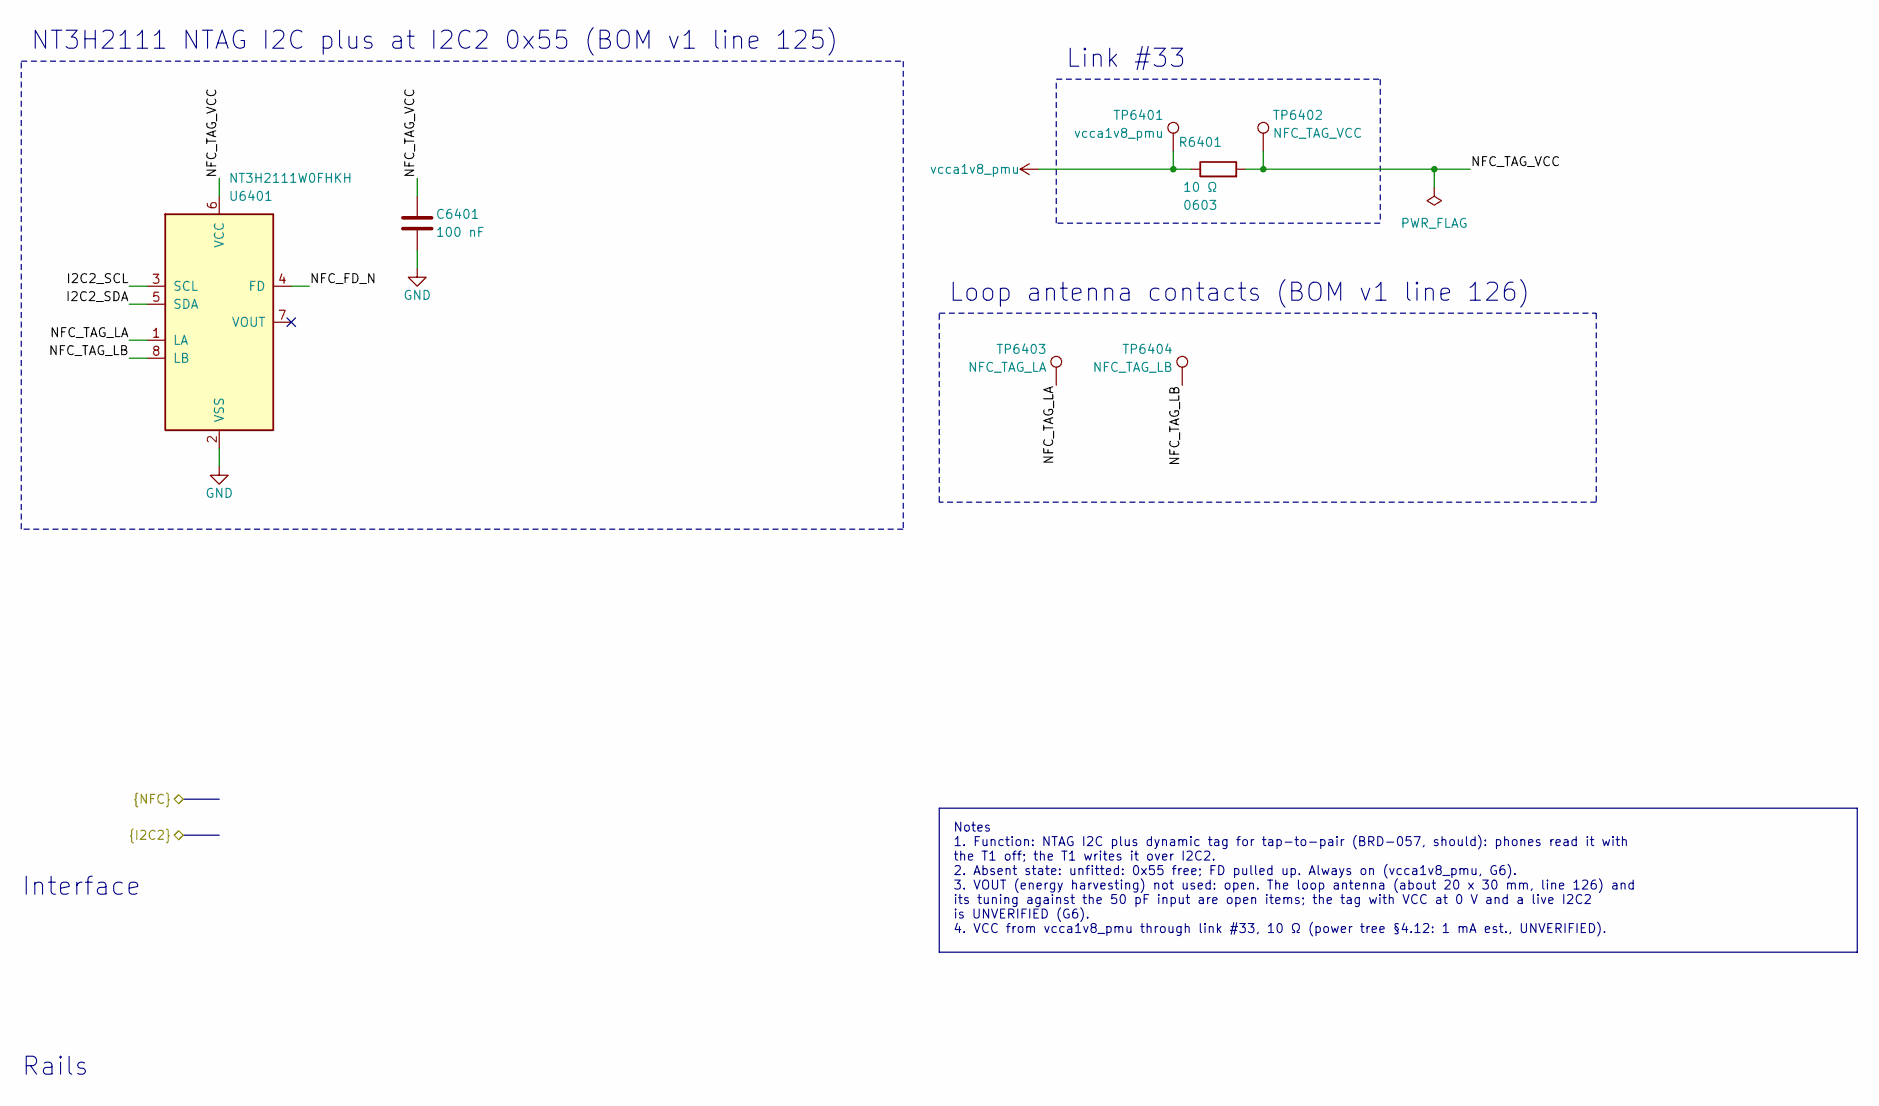
[picture p42: schematic nfc-tag.kicad_sch, NFC tag]

Parts:
C6401: 100 nF; C_0201_0603Metric; MPN GRM033R61A104KE15D
R6401: 10 Ω; R_0603_1608Metric; MPN RC0603FR-0710RL
TP6401: vcca1v8_pmu; TestPoint_Pad_D1.0mm
TP6402: NFC_TAG_VCC; TestPoint_Pad_D1.0mm
TP6403: NFC_TAG_LA; TestPoint_Pad_D1.0mm
TP6404: NFC_TAG_LB; TestPoint_Pad_D1.0mm
U6401: NT3H2111W0FHKH; NXP_SOT902-3_XQFN-8_1.6x1.6mm_P0.5mm; MPN NT3H2111W0FHKH

Connections:
/I2C2_SCL: U6401.3 (SCL); also elsewhere on the board
/I2C2_SDA: U6401.5 (SDA); also elsewhere on the board
/NFC tag/NFC_TAG_LA: TP6403.1, U6401.1 (LA)
/NFC tag/NFC_TAG_LB: TP6404.1, U6401.8 (LB)
/NFC tag/NFC_TAG_VCC: C6401.1, R6401.2, TP6402.1, U6401.6 (VCC)
/NFC_FD_N: U6401.4 (FD); also elsewhere on the board
GND: C6401.2, U6401.2 (VSS); also elsewhere on the board
vcca1v8_pmu: R6401.1, TP6401.1; also elsewhere on the board

Notes on the sheet:
NT3H2111 NTAG I2C plus at I2C2 0x55 (BOM v1 line 125)
Link #33
Loop antenna contacts (BOM v1 line 126)
Notes 1. Function: NTAG I2C plus dynamic tag for tap-to-pair (BRD-057, should): phones read it with the T1 off; the T1 writes it over I2C2. 2. Absent state: unfitted: 0x55 free; FD pulled up. Always on (vcca1v8_pmu, G6). 3. VOUT (energy harvesting) not used: open. The loop antenna (about 20 x 30 mm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
Rails
Interface

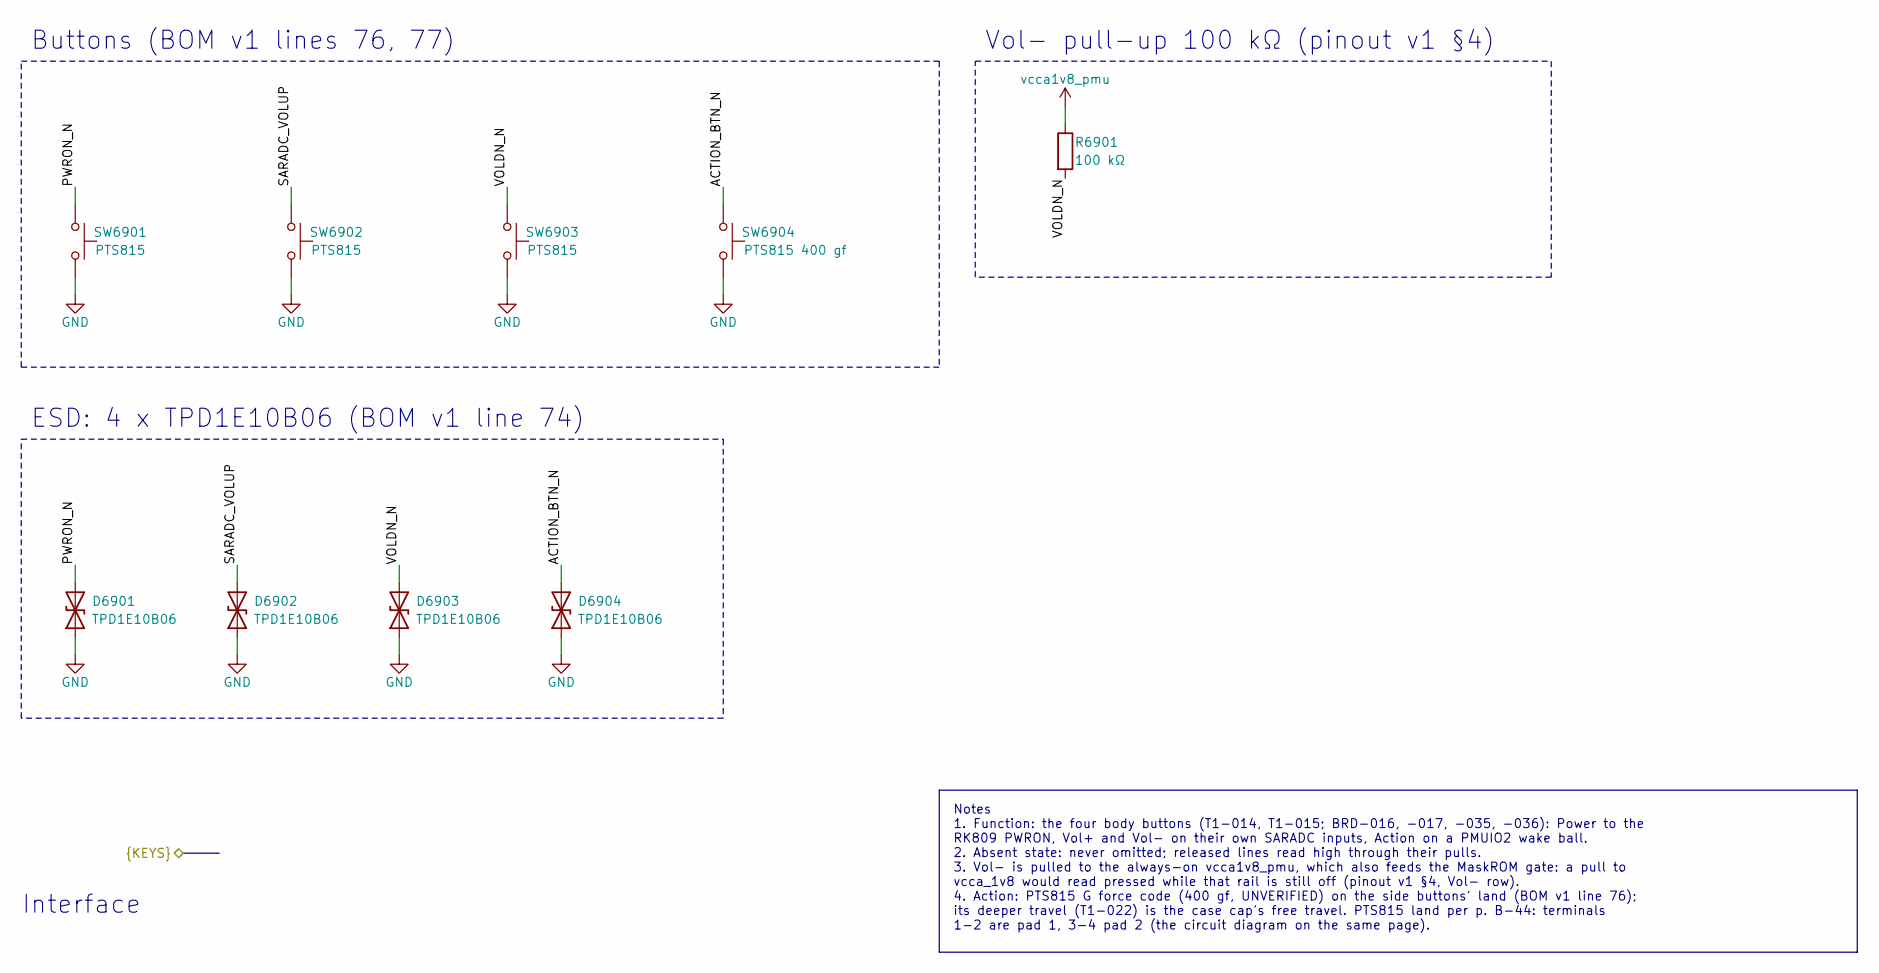
[picture p43: schematic buttons.kicad_sch, Side buttons]

Parts:
D6901, D6902, D6903, D6904: TPD1E10B06; Texas_DPY0002A_0.6x1mm_P0.65mm; MPN TPD1E10B06DPYR
R6901: 100 kΩ; R_0201_0603Metric; MPN RC0201FR-07100KL
SW6901, SW6902, SW6903: PTS815; SW_CK_PTS815; MPN PTS815SJM250SMTRLFS
SW6904: PTS815 400 gf; SW_CK_PTS815; MPN PTS815SJG250SMTRLFS

Connections:
/ACTION_BTN_N: D6904.2 (A2), SW6904.1; also elsewhere on the board
/PWRON_N: D6901.2 (A2), SW6901.1; also elsewhere on the board
/SARADC_VOLUP: D6902.2 (A2), SW6902.1; also elsewhere on the board
/VOLDN_N: D6903.2 (A2), R6901.2, SW6903.1; also elsewhere on the board
GND: D6901.1 (A1), D6902.1 (A1), D6903.1 (A1), D6904.1 (A1), SW6901.2, SW6902.2, SW6903.2, SW6904.2; also elsewhere on the board
vcca1v8_pmu: R6901.1; also elsewhere on the board

Notes on the sheet:
Buttons (BOM v1 lines 76, 77)
Vol- pull-up 100 kΩ (pinout v1 §4)
ESD: 4 x TPD1E10B06 (BOM v1 line 74)
Notes 1. Function: the four body buttons (T1-014, T1-015; BRD-016, -017, -035, -036): Power to the RK809 PWRON, Vol+ and Vol- on their own SARADC inputs, Action on a PMUIO2 wake ball. 2. Absent state: never omitted; released lines read high through their pulls. 3. Vol- is pulled to the always-on vc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
Interface

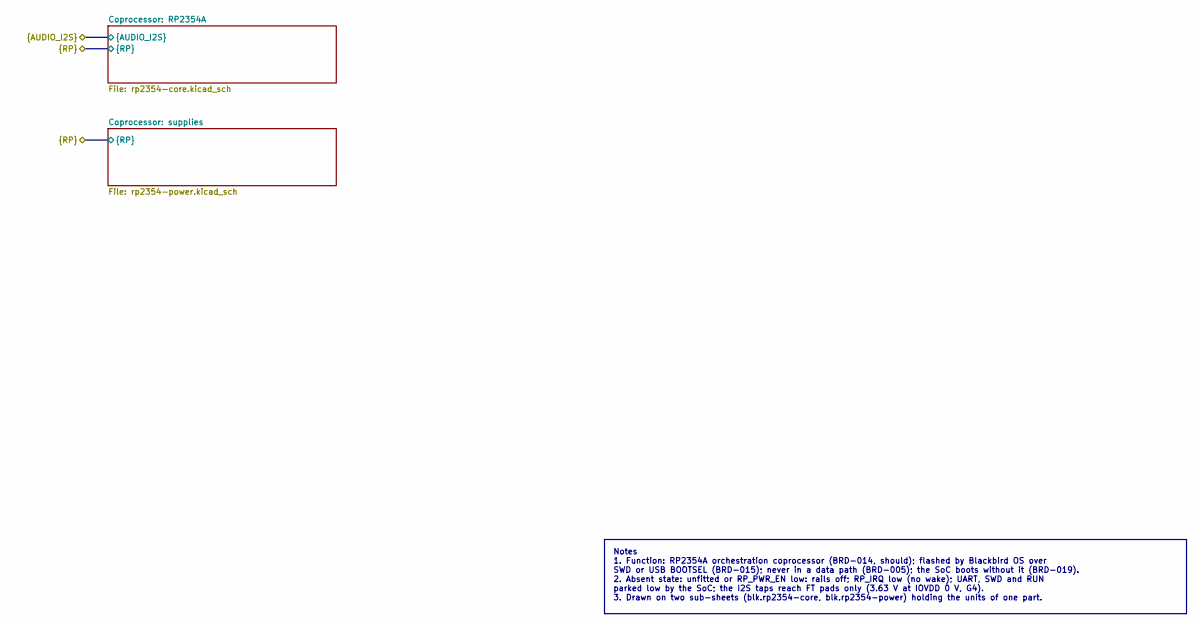
[picture p44: schematic rp2354.kicad_sch, Coprocessor]

Notes on the sheet:
Notes 1. Function: RP2354A orchestration coprocessor (BRD-014, should); flashed by Blackbird OS over SWD or USB BOOTSEL (BRD-015); never in a data path (BRD-005); the SoC boots without it (BRD-019). 2. Absent state: unfitted or RP_PWR_EN low: rails off; RP_IRQ low (no wake); UART, SWD and RUN parke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

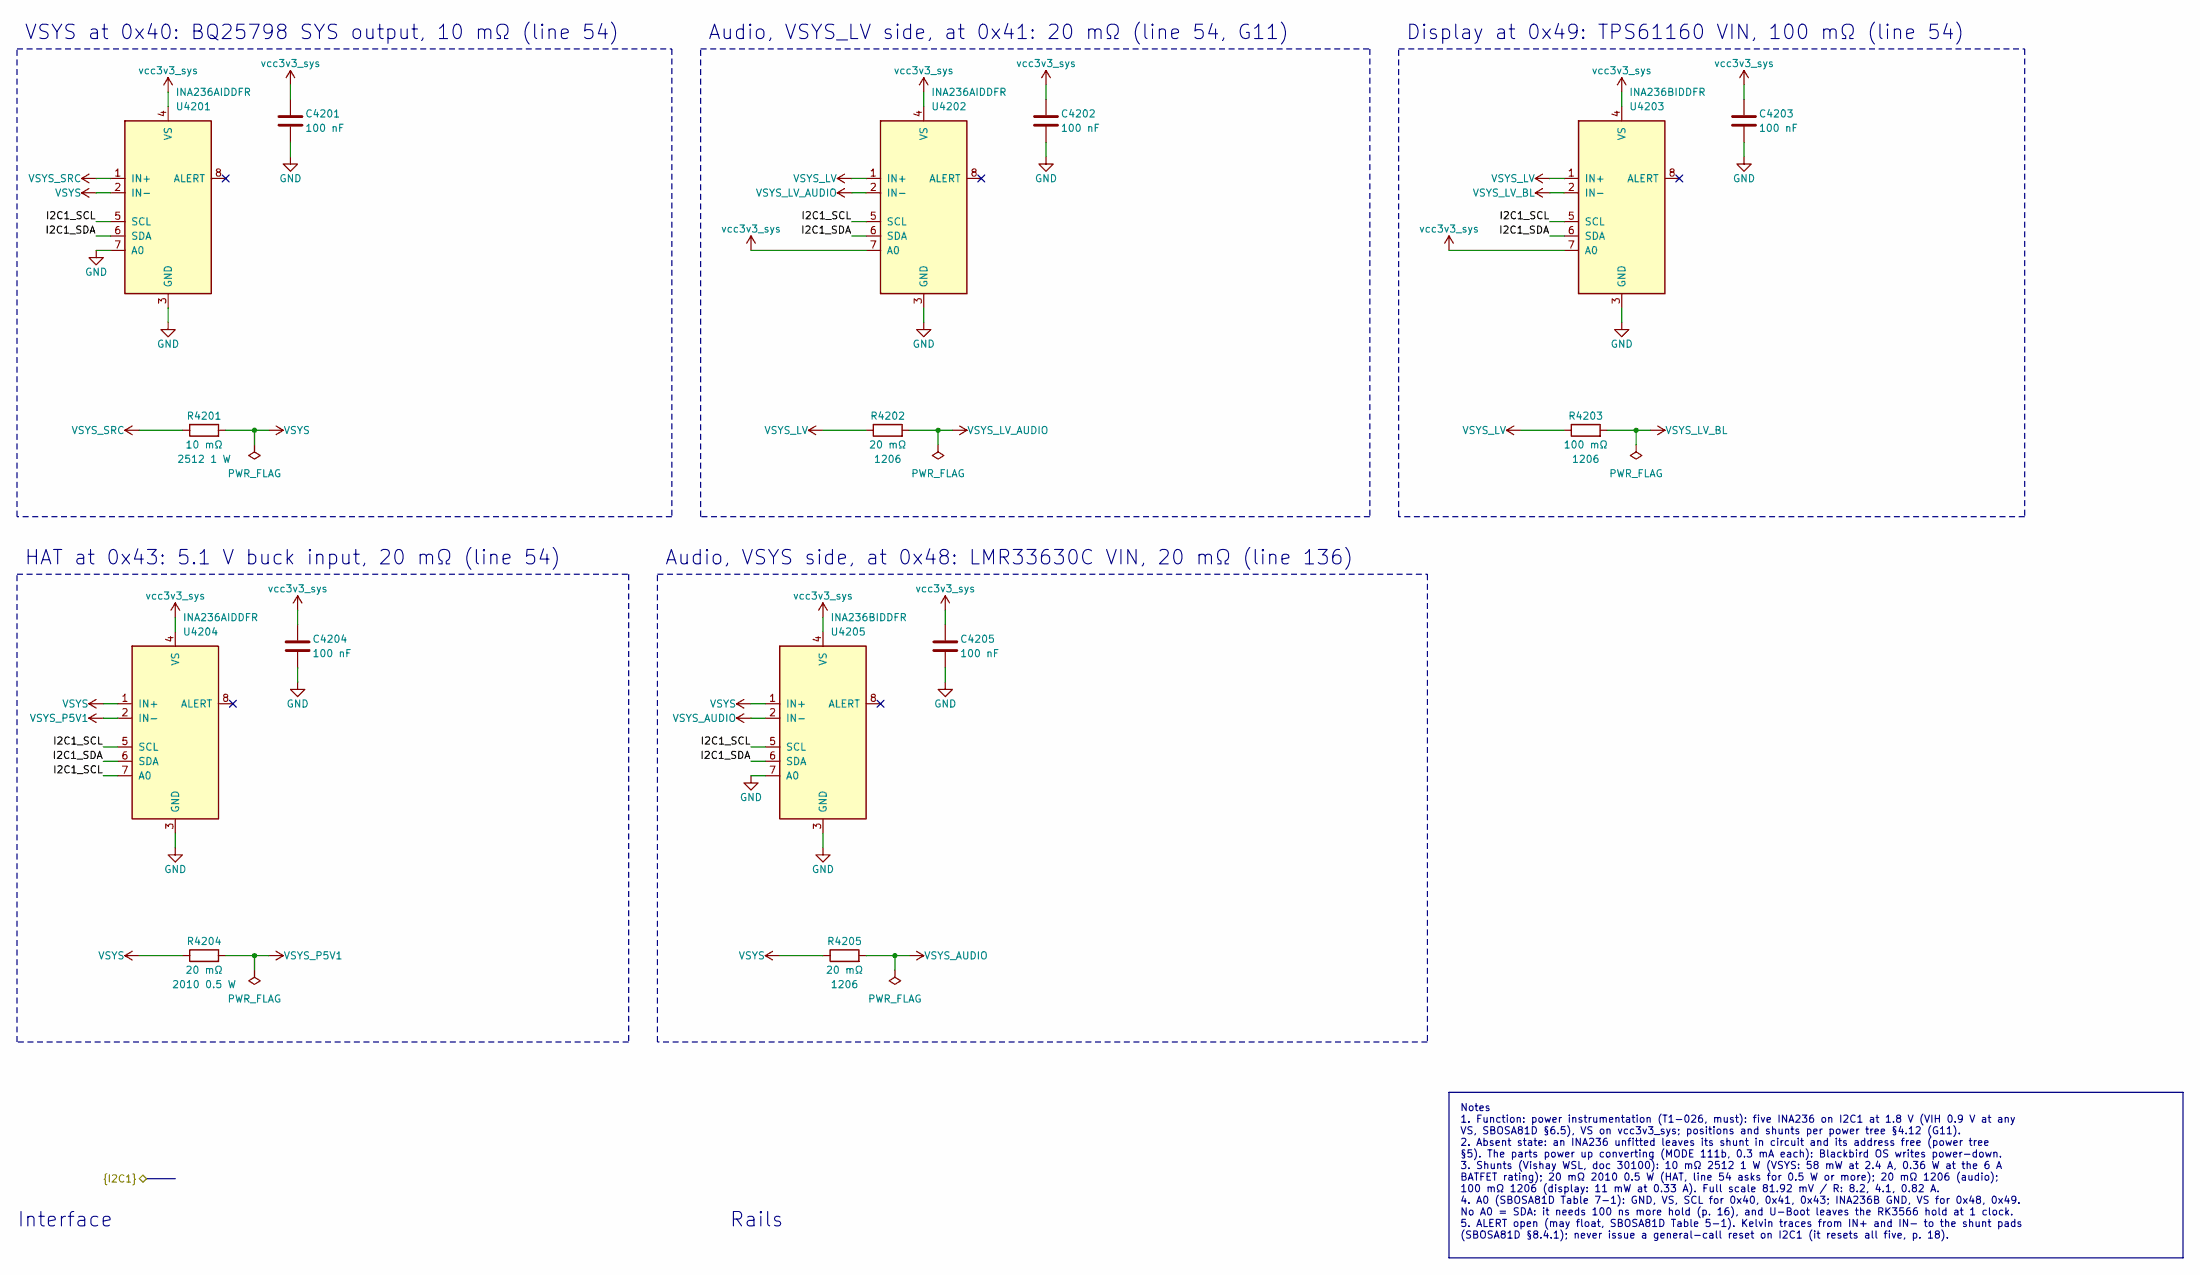
[picture p45: schematic current-monitors.kicad_sch, Current monitors]

Parts:
C4201, C4202, C4203, C4204, C4205: 100 nF; C_0402_1005Metric; MPN GRM155R71C104KA88D
R4201: 10 mΩ; R_Vishay_WSL2512_7m-500m; MPN WSL2512R0100FEA
R4202, R4205: 20 mΩ; R_Vishay_WSL1206_6m-200m; MPN WSL1206R0200FEA
R4203: 100 mΩ; R_Vishay_WSL1206_6m-200m; MPN WSL1206R1000FEA
R4204: 20 mΩ; R_Vishay_WSL2010_7m-500m; MPN WSL2010R0200FEA
U4201, U4202, U4204: INA236AIDDFR; Texas_DDF0008A_SOT-23-8_1.6x2.9mm_P0.65mm; MPN INA236AIDDFR
U4203, U4205: INA236BIDDFR; Texas_DDF0008A_SOT-23-8_1.6x2.9mm_P0.65mm; MPN INA236BIDDFR

Connections:
/I2C1_SCL: U4201.5 (SCL), U4202.5 (SCL), U4203.5 (SCL), U4204.5 (SCL), U4204.7 (A0), U4205.5 (SCL); also elsewhere on the board
/I2C1_SDA: U4201.6 (SDA), U4202.6 (SDA), U4203.6 (SDA), U4204.6 (SDA), U4205.6 (SDA); also elsewhere on the board
GND: C4201.2, C4202.2, C4203.2, C4204.2, C4205.2, U4201.3 (GND), U4201.7 (A0), U4202.3 (GND), U4203.3 (GND), U4204.3 (GND), U4205.3 (GND), U4205.7 (A0); also elsewhere on the board
VSYS: R4201.2, R4204.1, R4205.1, U4201.2 (IN-), U4204.1 (IN+), U4205.1 (IN+); also elsewhere on the board
VSYS_AUDIO: R4205.2, U4205.2 (IN-); also elsewhere on the board
VSYS_LV: R4202.1, R4203.1, U4202.1 (IN+), U4203.1 (IN+); also elsewhere on the board
VSYS_LV_AUDIO: R4202.2, U4202.2 (IN-); also elsewhere on the board
VSYS_LV_BL: R4203.2, U4203.2 (IN-); also elsewhere on the board
VSYS_P5V1: R4204.2, U4204.2 (IN-); also elsewhere on the board
VSYS_SRC: R4201.1, U4201.1 (IN+); also elsewhere on the board
vcc3v3_sys: C4201.1, C4202.1, C4203.1, C4204.1, C4205.1, U4201.4 (VS), U4202.4 (VS), U4202.7 (A0), U4203.4 (VS), U4203.7 (A0), U4204.4 (VS), U4205.4 (VS); also elsewhere on the board

Notes on the sheet:
VSYS at 0x40: BQ25798 SYS output, 10 mΩ (line 54)
Audio, VSYS_LV side, at 0x41: 20 mΩ (line 54, G11)
Display at 0x49: TPS61160 VIN, 100 mΩ (line 54)
HAT at 0x43: 5.1 V buck input, 20 mΩ (line 54)
Audio, VSYS side, at 0x48: LMR33630C VIN, 20 mΩ (line 136)
Notes 1. Function: power instrumentation (T1-026, must): five INA236 on I2C1 at 1.8 V (VIH 0.9 V at any VS, SBOSA81D §6.5), VS on vcc3v3_sys; positions and shunts per power tree §4.12 (G11). 2. Absent state: an INA236 unfitted leaves its shunt in circuit and its address free (power tree §5). The pa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
Interface
Rails

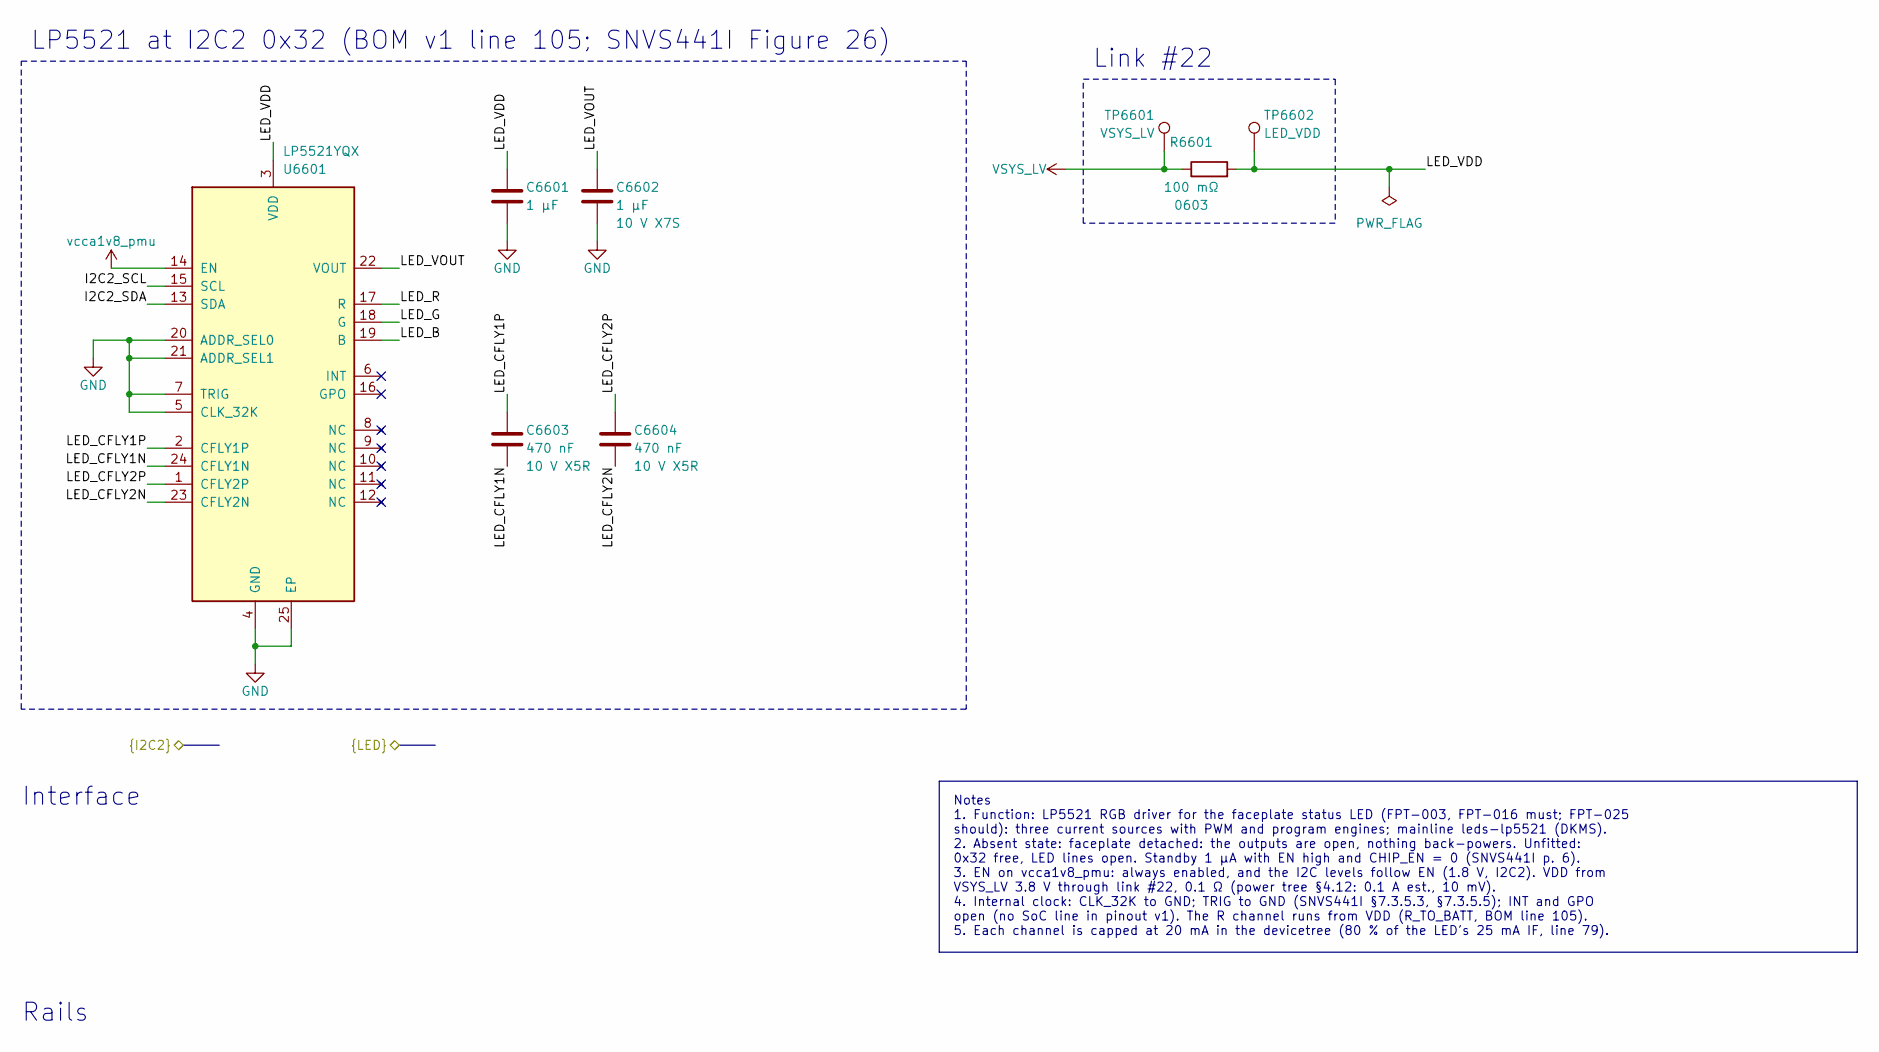
[picture p46: schematic status-led.kicad_sch, Status LED driver]

Parts:
C6601, C6602: 1 µF; C_0402_1005Metric; MPN GRM155C71A105KE11D
C6603, C6604: 470 nF; C_0402_1005Metric; MPN GRM155R61A474KE15D
R6601: 100 mΩ; R_0603_1608Metric; MPN RL0603FR-070R1L
TP6601: VSYS_LV; TestPoint_Pad_D1.0mm
TP6602: LED_VDD; TestPoint_Pad_D1.0mm
U6601: LP5521YQX; Texas_NJA0024A_WQFN-24-1EP_4x5mm_P0.5mm_EP2.4x3.4mm_Thermal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; MPN LP5521YQX/NOPB

Connections:
/I2C2_SCL: U6601.15 (SCL); also elsewhere on the board
/I2C2_SDA: U6601.13 (SDA); also elsewhere on the board
/LED_B: U6601.19 (B); also elsewhere on the board
/LED_G: U6601.18 (G); also elsewhere on the board
/LED_R: U6601.17 (R); also elsewhere on the board
/Status LED driver/LED_CFLY1N: C6603.2, U6601.24 (CFLY1N)
/Status LED driver/LED_CFLY1P: C6603.1, U6601.2 (CFLY1P)
/Status LED driver/LED_CFLY2N: C6604.2, U6601.23 (CFLY2N)
/Status LED driver/LED_CFLY2P: C6604.1, U6601.1 (CFLY2P)
/Status LED driver/LED_VDD: C6601.1, R6601.2, TP6602.1, U6601.3 (VDD)
/Status LED driver/LED_VOUT: C6602.1, U6601.22 (VOUT)
GND: C6601.2, C6602.2, U6601.4 (GND), U6601.5 (CLK_32K), U6601.7 (TRIG), U6601.20 (ADDR_SEL0), U6601.21 (ADDR_SEL1), U6601.25 (EP); also elsewhere on the board
VSYS_LV: R6601.1, TP6601.1; also elsewhere on the board
vcca1v8_pmu: U6601.14 (EN); also elsewhere on the board

Notes on the sheet:
LP5521 at I2C2 0x32 (BOM v1 line 105; SNVS441I Figure 26)
Link #22
Notes 1. Function: LP5521 RGB driver for the faceplate status LED (FPT-003, FPT-016 must; FPT-025 should): three current sources with PWM and program engines; mainline leds-lp5521 (DKMS). 2. Absent state: faceplate detached: the outputs are open, nothing back-powers. Unfitted: 0x32 free, LED lines 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
Rails
Interface

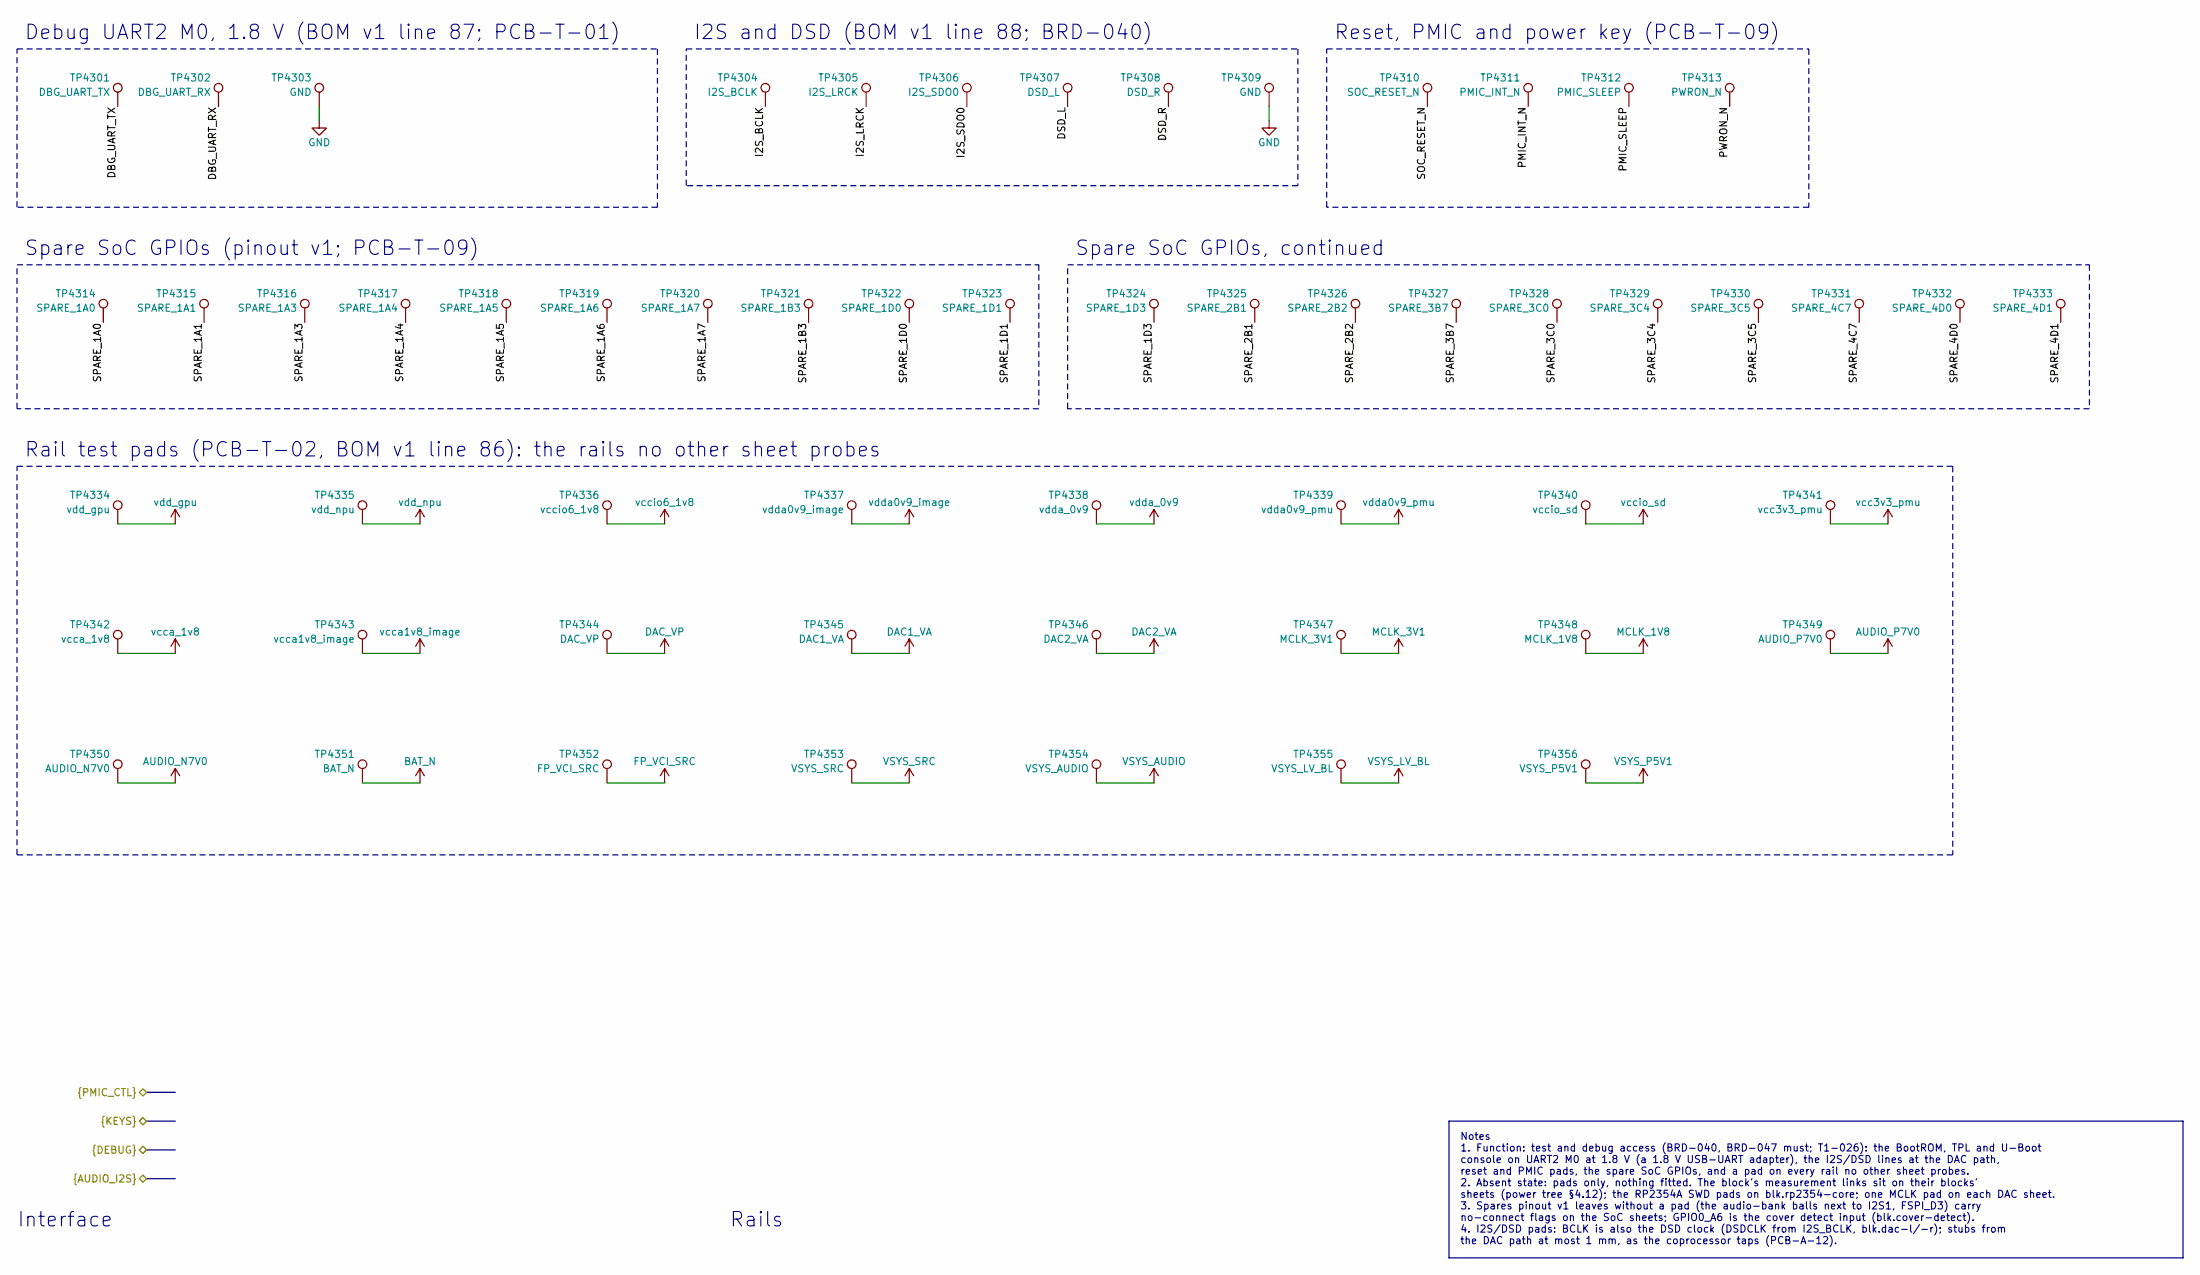
[picture p47: schematic debug.kicad_sch, Test and debug access]

Parts:
TP4301: DBG_UART_TX; TestPoint_Pad_D0.8mm
TP4302: DBG_UART_RX; TestPoint_Pad_D0.8mm
TP4303, TP4309: GND; TestPoint_Pad_D1.0mm
TP4304: I2S_BCLK; TestPoint_Pad_D0.8mm
TP4305: I2S_LRCK; TestPoint_Pad_D0.8mm
TP4306: I2S_SDO0; TestPoint_Pad_D0.8mm
TP4307: DSD_L; TestPoint_Pad_D0.8mm
TP4308: DSD_R; TestPoint_Pad_D0.8mm
TP4310: SOC_RESET_N; TestPoint_Pad_D0.8mm
TP4311: PMIC_INT_N; TestPoint_Pad_D0.8mm
TP4312: PMIC_SLEEP; TestPoint_Pad_D0.8mm
TP4313: PWRON_N; TestPoint_Pad_D0.8mm
TP4314: SPARE_1A0; TestPoint_Pad_D0.8mm
TP4315: SPARE_1A1; TestPoint_Pad_D0.8mm
TP4316: SPARE_1A3; TestPoint_Pad_D0.8mm
TP4317: SPARE_1A4; TestPoint_Pad_D0.8mm
TP4318: SPARE_1A5; TestPoint_Pad_D0.8mm
TP4319: SPARE_1A6; TestPoint_Pad_D0.8mm
TP4320: SPARE_1A7; TestPoint_Pad_D0.8mm
TP4321: SPARE_1B3; TestPoint_Pad_D0.8mm
TP4322: SPARE_1D0; TestPoint_Pad_D0.8mm
TP4323: SPARE_1D1; TestPoint_Pad_D0.8mm
TP4324: SPARE_1D3; TestPoint_Pad_D0.8mm
TP4325: SPARE_2B1; TestPoint_Pad_D0.8mm
TP4326: SPARE_2B2; TestPoint_Pad_D0.8mm
TP4327: SPARE_3B7; TestPoint_Pad_D0.8mm
TP4328: SPARE_3C0; TestPoint_Pad_D0.8mm
TP4329: SPARE_3C4; TestPoint_Pad_D0.8mm
TP4330: SPARE_3C5; TestPoint_Pad_D0.8mm
TP4331: SPARE_4C7; TestPoint_Pad_D0.8mm
TP4332: SPARE_4D0; TestPoint_Pad_D0.8mm
TP4333: SPARE_4D1; TestPoint_Pad_D0.8mm
TP4334: vdd_gpu; TestPoint_Pad_D1.0mm
TP4335: vdd_npu; TestPoint_Pad_D1.0mm
TP4336: vccio6_1v8; TestPoint_Pad_D1.0mm
TP4337: vdda0v9_image; TestPoint_Pad_D1.0mm
TP4338: vdda_0v9; TestPoint_Pad_D1.0mm
TP4339: vdda0v9_pmu; TestPoint_Pad_D1.0mm
TP4340: vccio_sd; TestPoint_Pad_D1.0mm
TP4341: vcc3v3_pmu; TestPoint_Pad_D1.0mm
TP4342: vcca_1v8; TestPoint_Pad_D1.0mm
TP4343: vcca1v8_image; TestPoint_Pad_D1.0mm
TP4344: DAC_VP; TestPoint_Pad_D1.0mm
TP4345: DAC1_VA; TestPoint_Pad_D1.0mm
TP4346: DAC2_VA; TestPoint_Pad_D1.0mm
TP4347: MCLK_3V1; TestPoint_Pad_D1.0mm
TP4348: MCLK_1V8; TestPoint_Pad_D1.0mm
TP4349: AUDIO_P7V0; TestPoint_Pad_D1.0mm
TP4350: AUDIO_N7V0; TestPoint_Pad_D1.0mm
TP4351: BAT_N; TestPoint_Pad_D1.0mm
TP4352: FP_VCI_SRC; TestPoint_Pad_D1.0mm
TP4353: VSYS_SRC; TestPoint_Pad_D1.0mm
TP4354: VSYS_AUDIO; TestPoint_Pad_D1.0mm
TP4355: VSYS_LV_BL; TestPoint_Pad_D1.0mm
TP4356: VSYS_P5V1; TestPoint_Pad_D1.0mm

Connections:
/DBG_UART_RX: TP4302.1; also elsewhere on the board
/DBG_UART_TX: TP4301.1; also elsewhere on the board
/DSD_L: TP4307.1; also elsewhere on the board
/DSD_R: TP4308.1; also elsewhere on the board
/I2S_BCLK: TP4304.1; also elsewhere on the board
/I2S_LRCK: TP4305.1; also elsewhere on the board
/I2S_SDO0: TP4306.1; also elsewhere on the board
/PMIC_INT_N: TP4311.1; also elsewhere on the board
/PMIC_SLEEP: TP4312.1; also elsewhere on the board
/PWRON_N: TP4313.1; also elsewhere on the board
/SOC_RESET_N: TP4310.1; also elsewhere on the board
/SPARE_1A0: TP4314.1; also elsewhere on the board
/SPARE_1A1: TP4315.1; also elsewhere on the board
/SPARE_1A3: TP4316.1; also elsewhere on the board
/SPARE_1A4: TP4317.1; also elsewhere on the board
/SPARE_1A5: TP4318.1; also elsewhere on the board
/SPARE_1A6: TP4319.1; also elsewhere on the board
/SPARE_1A7: TP4320.1; also elsewhere on the board
/SPARE_1B3: TP4321.1; also elsewhere on the board
/SPARE_1D0: TP4322.1; also elsewhere on the board
/SPARE_1D1: TP4323.1; also elsewhere on the board
/SPARE_1D3: TP4324.1; also elsewhere on the board
/SPARE_2B1: TP4325.1; also elsewhere on the board
/SPARE_2B2: TP4326.1; also elsewhere on the board
/SPARE_3B7: TP4327.1; also elsewhere on the board
/SPARE_3C0: TP4328.1; also elsewhere on the board
/SPARE_3C4: TP4329.1; also elsewhere on the board
/SPARE_3C5: TP4330.1; also elsewhere on the board
/SPARE_4C7: TP4331.1; also elsewhere on the board
/SPARE_4D0: TP4332.1; also elsewhere on the board
/SPARE_4D1: TP4333.1; also elsewhere on the board
AUDIO_N7V0: TP4350.1; also elsewhere on the board
AUDIO_P7V0: TP4349.1; also elsewhere on the board
BAT_N: TP4351.1; also elsewhere on the board
DAC1_VA: TP4345.1; also elsewhere on the board
DAC2_VA: TP4346.1; also elsewhere on the board
DAC_VP: TP4344.1; also elsewhere on the board
FP_VCI_SRC: TP4352.1; also elsewhere on the board
GND: TP4303.1, TP4309.1; also elsewhere on the board
MCLK_1V8: TP4348.1; also elsewhere on the board
MCLK_3V1: TP4347.1; also elsewhere on the board
VSYS_AUDIO: TP4354.1; also elsewhere on the board
VSYS_LV_BL: TP4355.1; also elsewhere on the board
VSYS_P5V1: TP4356.1; also elsewhere on the board
VSYS_SRC: TP4353.1; also elsewhere on the board
vcc3v3_pmu: TP4341.1; also elsewhere on the board
vcca1v8_image: TP4343.1; also elsewhere on the board
vcca_1v8: TP4342.1; also elsewhere on the board
vccio6_1v8: TP4336.1; also elsewhere on the board
vccio_sd: TP4340.1; also elsewhere on the board
vdd_gpu: TP4334.1; also elsewhere on the board
vdd_npu: TP4335.1; also elsewhere on the board
vdda0v9_image: TP4337.1; also elsewhere on the board
vdda0v9_pmu: TP4339.1; also elsewhere on the board
vdda_0v9: TP4338.1; also elsewhere on the board

Notes on the sheet:
Debug UART2 M0, 1.8 V (BOM v1 line 87; PCB-T-01)
I2S and DSD (BOM v1 line 88; BRD-040)
Reset, PMIC and power key (PCB-T-09)
Spare SoC GPIOs (pinout v1; PCB-T-09)
Spare SoC GPIOs, continued
Rail test pads (PCB-T-02, BOM v1 line 86): the rails no other sheet probes
Notes 1. Function: test and debug access (BRD-040, BRD-047 must; T1-026): the BootROM, TPL and U-Boot console on UART2 M0 at 1.8 V (a 1.8 V USB-UART adapter), the I2S/DSD lines at the DAC path, reset and PMIC pads, the spare SoC GPIOs, and a pad on every rail no other sheet probes. 2. Absent state: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
Interface
Rails

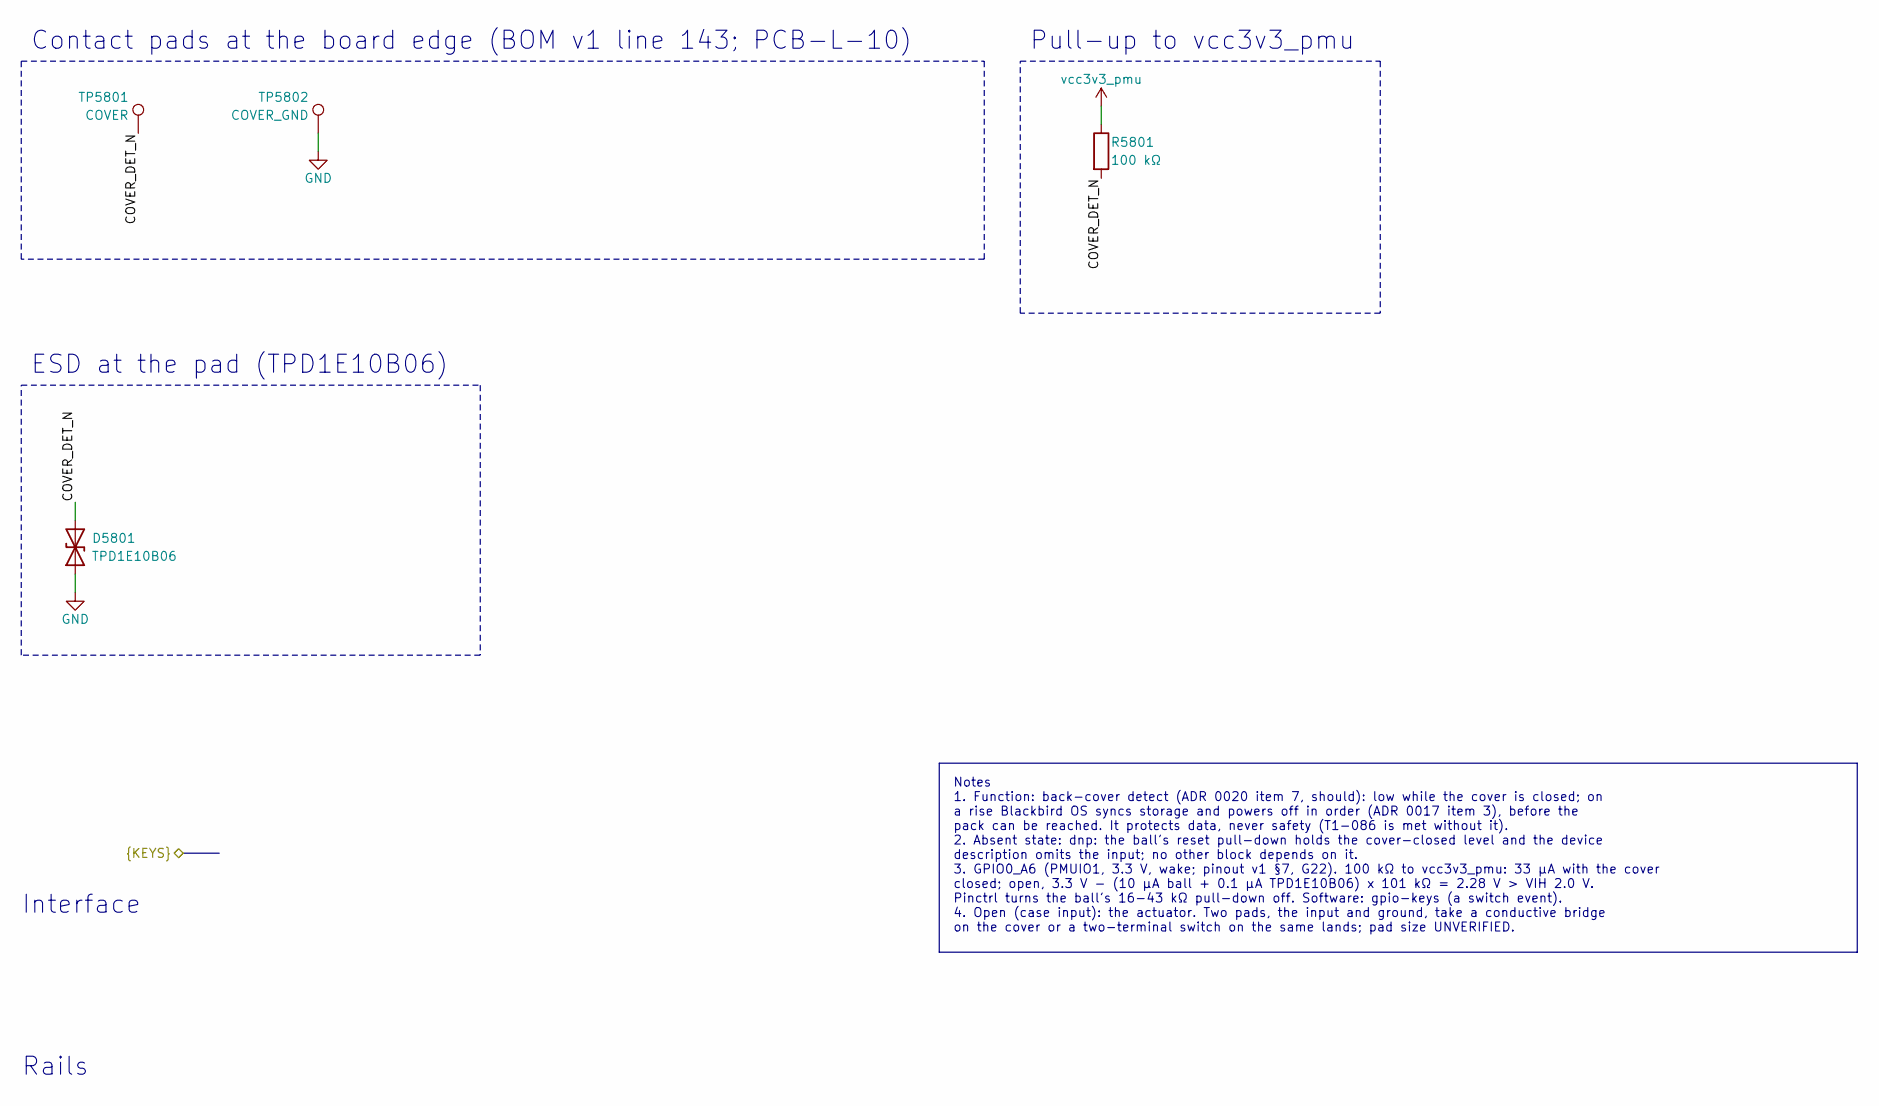
[picture p48: schematic cover-detect.kicad_sch, Cover detect]

Parts:
D5801: TPD1E10B06; Texas_DPY0002A_0.6x1mm_P0.65mm; MPN TPD1E10B06DPYR
R5801: 100 kΩ; R_0201_0603Metric; MPN RC0201FR-07100KL
TP5801: COVER; TestPoint_Pad_2.0x2.0mm
TP5802: COVER_GND; TestPoint_Pad_2.0x2.0mm

Connections:
/COVER_DET_N: D5801.2 (A2), R5801.2, TP5801.1; also elsewhere on the board
GND: D5801.1 (A1), TP5802.1; also elsewhere on the board
vcc3v3_pmu: R5801.1; also elsewhere on the board

Notes on the sheet:
Contact pads at the board edge (BOM v1 line 143; PCB-L-10)
Pull-up to vcc3v3_pmu
ESD at the pad (TPD1E10B06)
Notes 1. Function: back-cover detect (ADR 0020 item 7, should): low while the cover is closed; on a rise Blackbird OS syncs storage and powers off in order (ADR 0017 item 3), before the pack can be reached. It protects data, never safety (T1-086 is met without it). 2. Absent state: dnp: the ball's 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
Rails
Interface
