opendap-project/t1/board/hardware/t1-main-board/t1-main-board.kicad_pcb

## KiCad design board/hardware/t1-main-board/t1-main-board.kicad_pcb (continued)

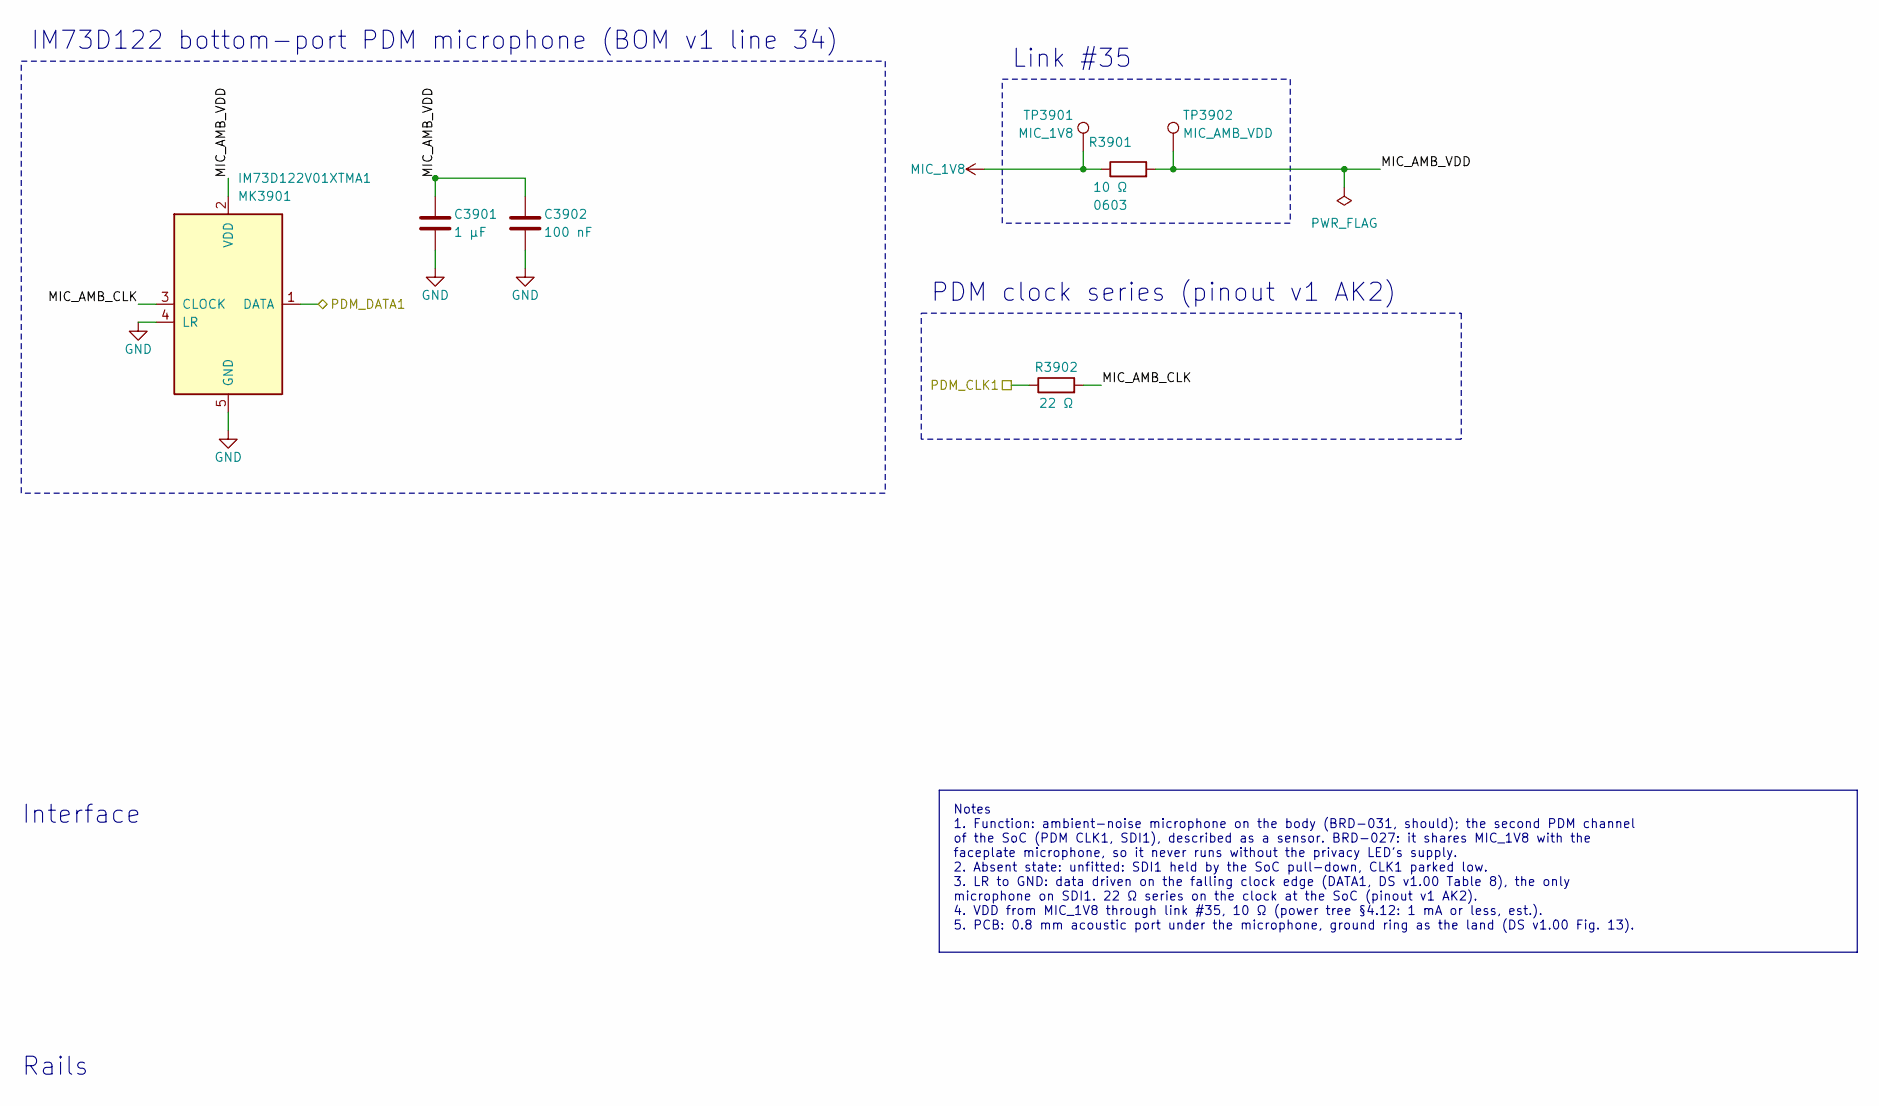
[picture p49: schematic mic-ambient.kicad_sch, Ambient microphone]

Parts:
C3901: 1 µF; C_0402_1005Metric; MPN GRM155C71A105KE11D
C3902: 100 nF; C_0402_1005Metric; MPN GRM155R71C104KA88D
MK3901: IM73D122V01XTMA1; Infineon_PG-LLGA-5-3_3x4mm_P0.7mm_BottomPort; MPN IM73D122V01XTMA1
R3901: 10 Ω; R_0603_1608Metric; MPN RC0603FR-0710RL
R3902: 22 Ω; R_0201_0603Metric; MPN RC0201FR-0722RL
TP3901: MIC_1V8; TestPoint_Pad_D1.0mm
TP3902: MIC_AMB_VDD; TestPoint_Pad_D1.0mm

Connections:
/Ambient microphone/MIC_AMB_CLK: MK3901.3 (CLOCK), R3902.2
/Ambient microphone/MIC_AMB_VDD: C3901.1, C3902.1, MK3901.2 (VDD), R3901.2, TP3902.1
/PDM_CLK1: R3902.1; also elsewhere on the board
/PDM_DATA1: MK3901.1 (DATA); also elsewhere on the board
GND: C3901.2, C3902.2, MK3901.4 (LR), MK3901.5 (GND); also elsewhere on the board
MIC_1V8: R3901.1, TP3901.1; also elsewhere on the board

Notes on the sheet:
IM73D122 bottom-port PDM microphone (BOM v1 line 34)
Link #35
PDM clock series (pinout v1 AK2)
Notes 1. Function: ambient-noise microphone on the body (BRD-031, should); the second PDM channel of the SoC (PDM CLK1, SDI1), described as a sensor. BRD-027: it shares MIC_1V8 with the faceplate microphone, so it never runs without the privacy LED's supply. 2. Absent state: unfitted: SDI1 held by 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
Rails
Interface

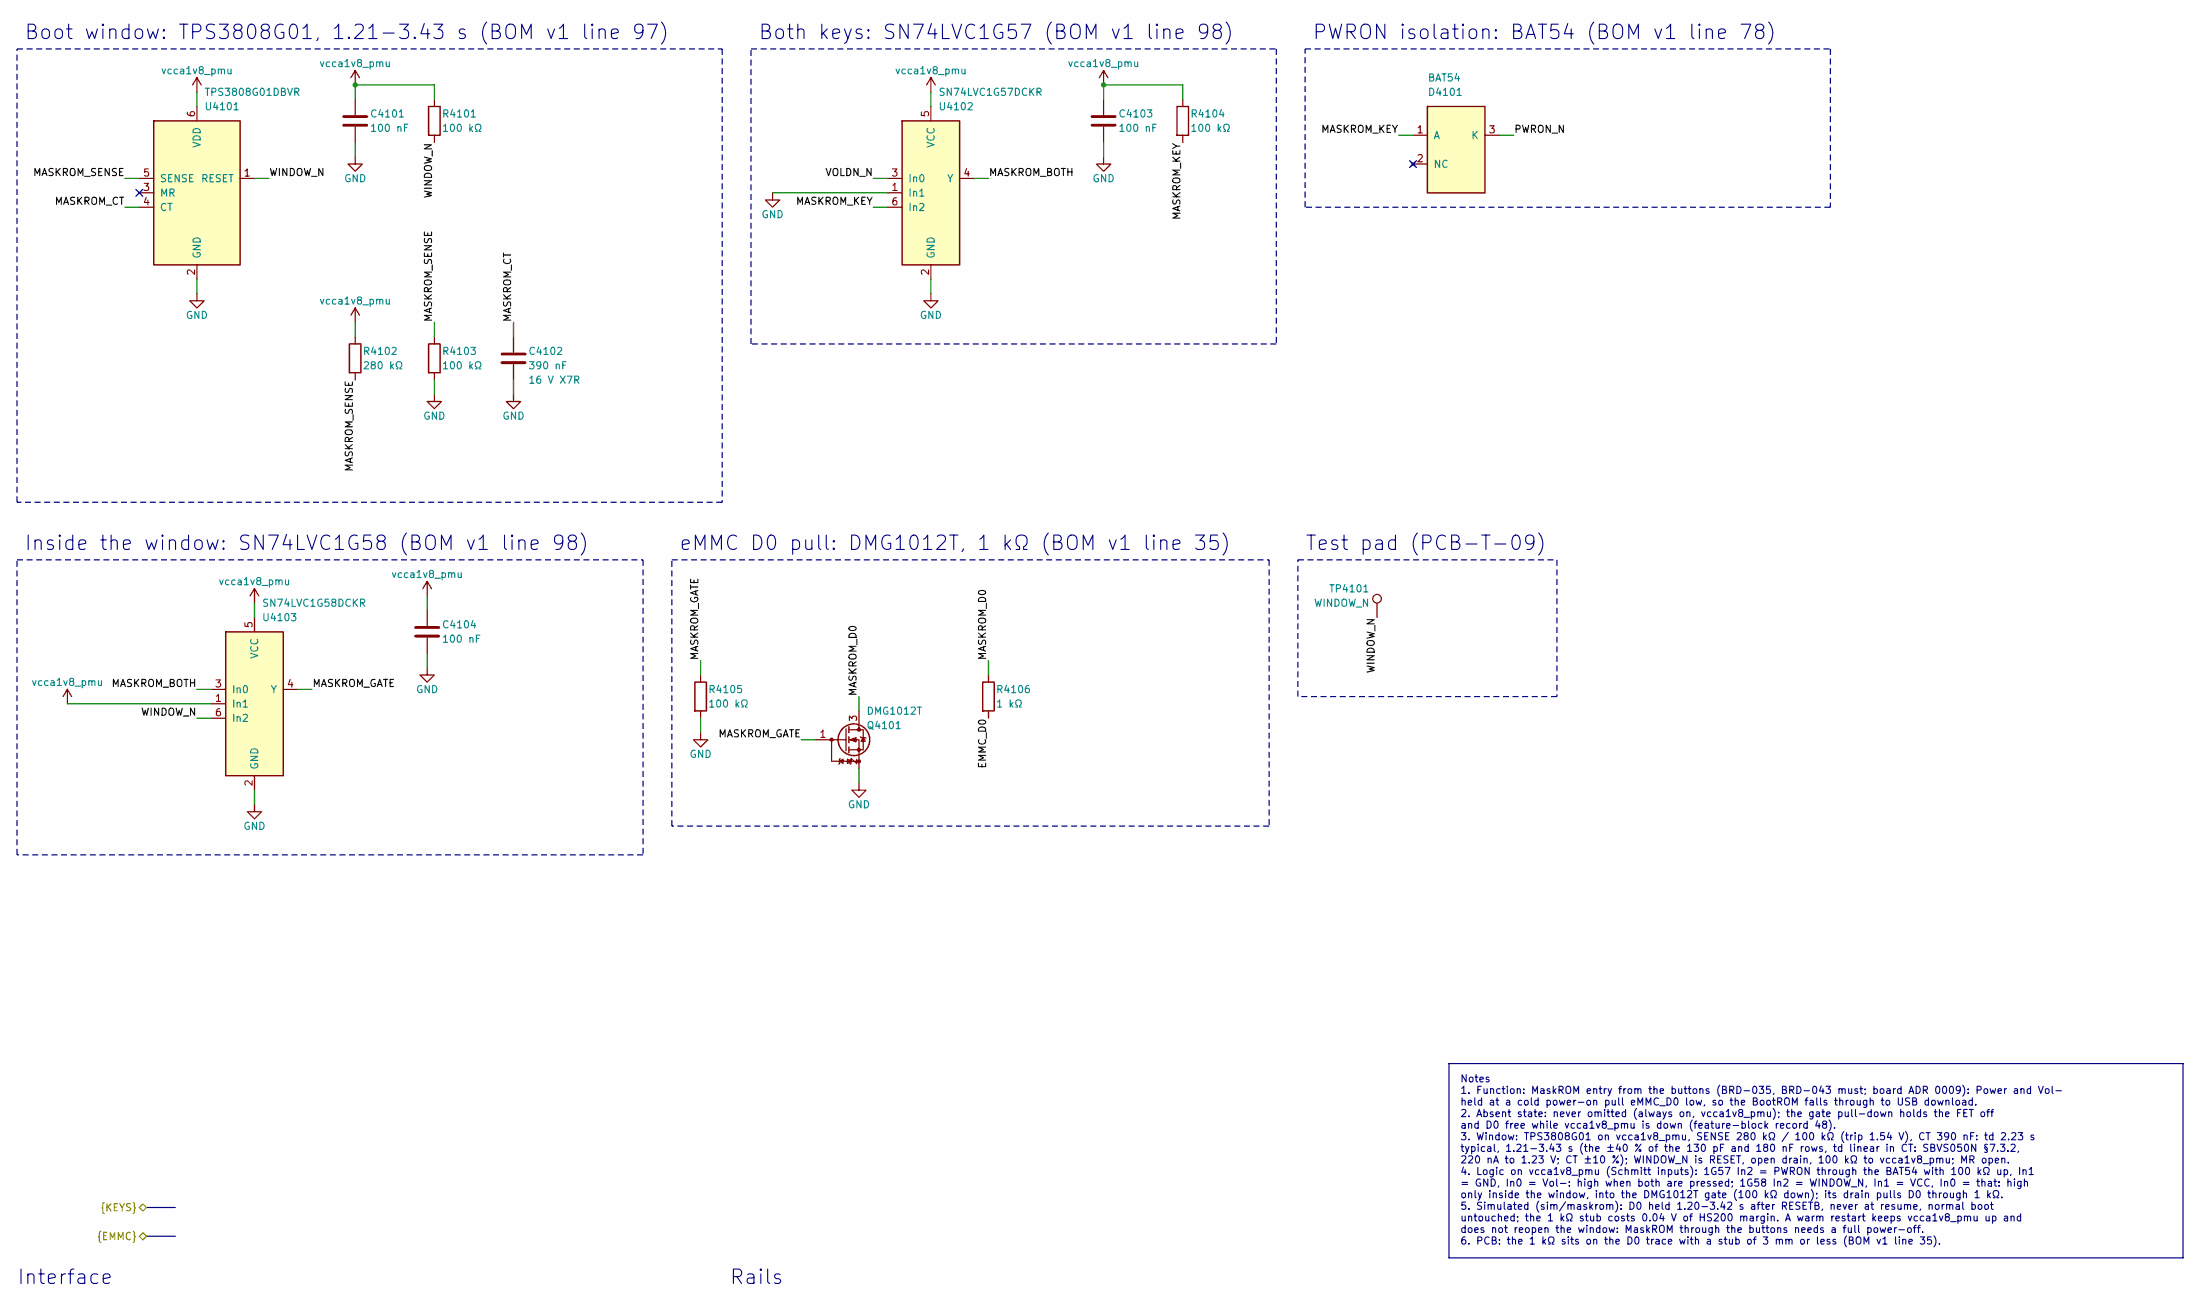
[picture p50: schematic maskrom.kicad_sch, MaskROM entry]

Parts:
C4101, C4103, C4104: 100 nF; C_0201_0603Metric; MPN GRM033R61A104KE15D
C4102: 390 nF; C_0603_1608Metric; MPN GRM188R71C394KA01D
D4101: BAT54; Nexperia_SOT23_TO-236AB_2.9x1.3mm_P1.9mm; MPN BAT54,215
Q4101: DMG1012T; SOT-523; MPN DMG1012T-7
R4101, R4103, R4104, R4105: 100 kΩ; R_0201_0603Metric; MPN RC0201FR-07100KL
R4102: 280 kΩ; R_0201_0603Metric; MPN RC0201FR-07280KL
R4106: 1 kΩ; R_0201_0603Metric; MPN RC0201FR-071KL
TP4101: WINDOW_N; TestPoint_Pad_D0.8mm
U4101: TPS3808G01DBVR; Texas_DBV0006A_SOT-23-6_1.6x2.9mm_P0.95mm; MPN TPS3808G01DBVR
U4102: SN74LVC1G57DCKR; Texas_DCK0006A_SC-70-6_1.25x2mm_P0.65mm; MPN SN74LVC1G57DCKR
U4103: SN74LVC1G58DCKR; Texas_DCK0006A_SC-70-6_1.25x2mm_P0.65mm; MPN SN74LVC1G58DCKR

Connections:
/EMMC_D0: R4106.2; also elsewhere on the board
/MaskROM entry/MASKROM_BOTH: U4102.4 (Y), U4103.3 (In0)
/MaskROM entry/MASKROM_CT: C4102.1, U4101.4 (CT)
/MaskROM entry/MASKROM_D0: Q4101.3 (D), R4106.1
/MaskROM entry/MASKROM_GATE: Q4101.1 (G), R4105.1, U4103.4 (Y)
/MaskROM entry/MASKROM_KEY: D4101.1 (A), R4104.2, U4102.6 (In2)
/MaskROM entry/MASKROM_SENSE: R4102.2, R4103.1, U4101.5 (SENSE)
/MaskROM entry/WINDOW_N: R4101.2, TP4101.1, U4101.1 (RESET), U4103.6 (In2)
/PWRON_N: D4101.3 (K); also elsewhere on the board
/VOLDN_N: U4102.3 (In0); also elsewhere on the board
GND: C4101.2, C4102.2, C4103.2, C4104.2, Q4101.2 (S), R4103.2, R4105.2, U4101.2 (GND), U4102.1 (In1), U4102.2 (GND), U4103.2 (GND); also elsewhere on the board
vcca1v8_pmu: C4101.1, C4103.1, C4104.1, R4101.1, R4102.1, R4104.1, U4101.6 (VDD), U4102.5 (VCC), U4103.1 (In1), U4103.5 (VCC); also elsewhere on the board

Notes on the sheet:
Boot window: TPS3808G01, 1.21-3.43 s (BOM v1 line 97)
Both keys: SN74LVC1G57 (BOM v1 line 98)
PWRON isolation: BAT54 (BOM v1 line 78)
Inside the window: SN74LVC1G58 (BOM v1 line 98)
eMMC D0 pull: DMG1012T, 1 kΩ (BOM v1 line 35)
Test pad (PCB-T-09)
Notes 1. Function: MaskROM entry from the buttons (BRD-035, BRD-043 must; board ADR 0009): Power and Vol- held at a cold power-on pull eMMC_D0 low, so the BootROM falls through to USB download. 2. Absent state: never omitted (always on, vcca1v8_pmu); the gate pull-down holds the FET off and D0 free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
Interface
Rails

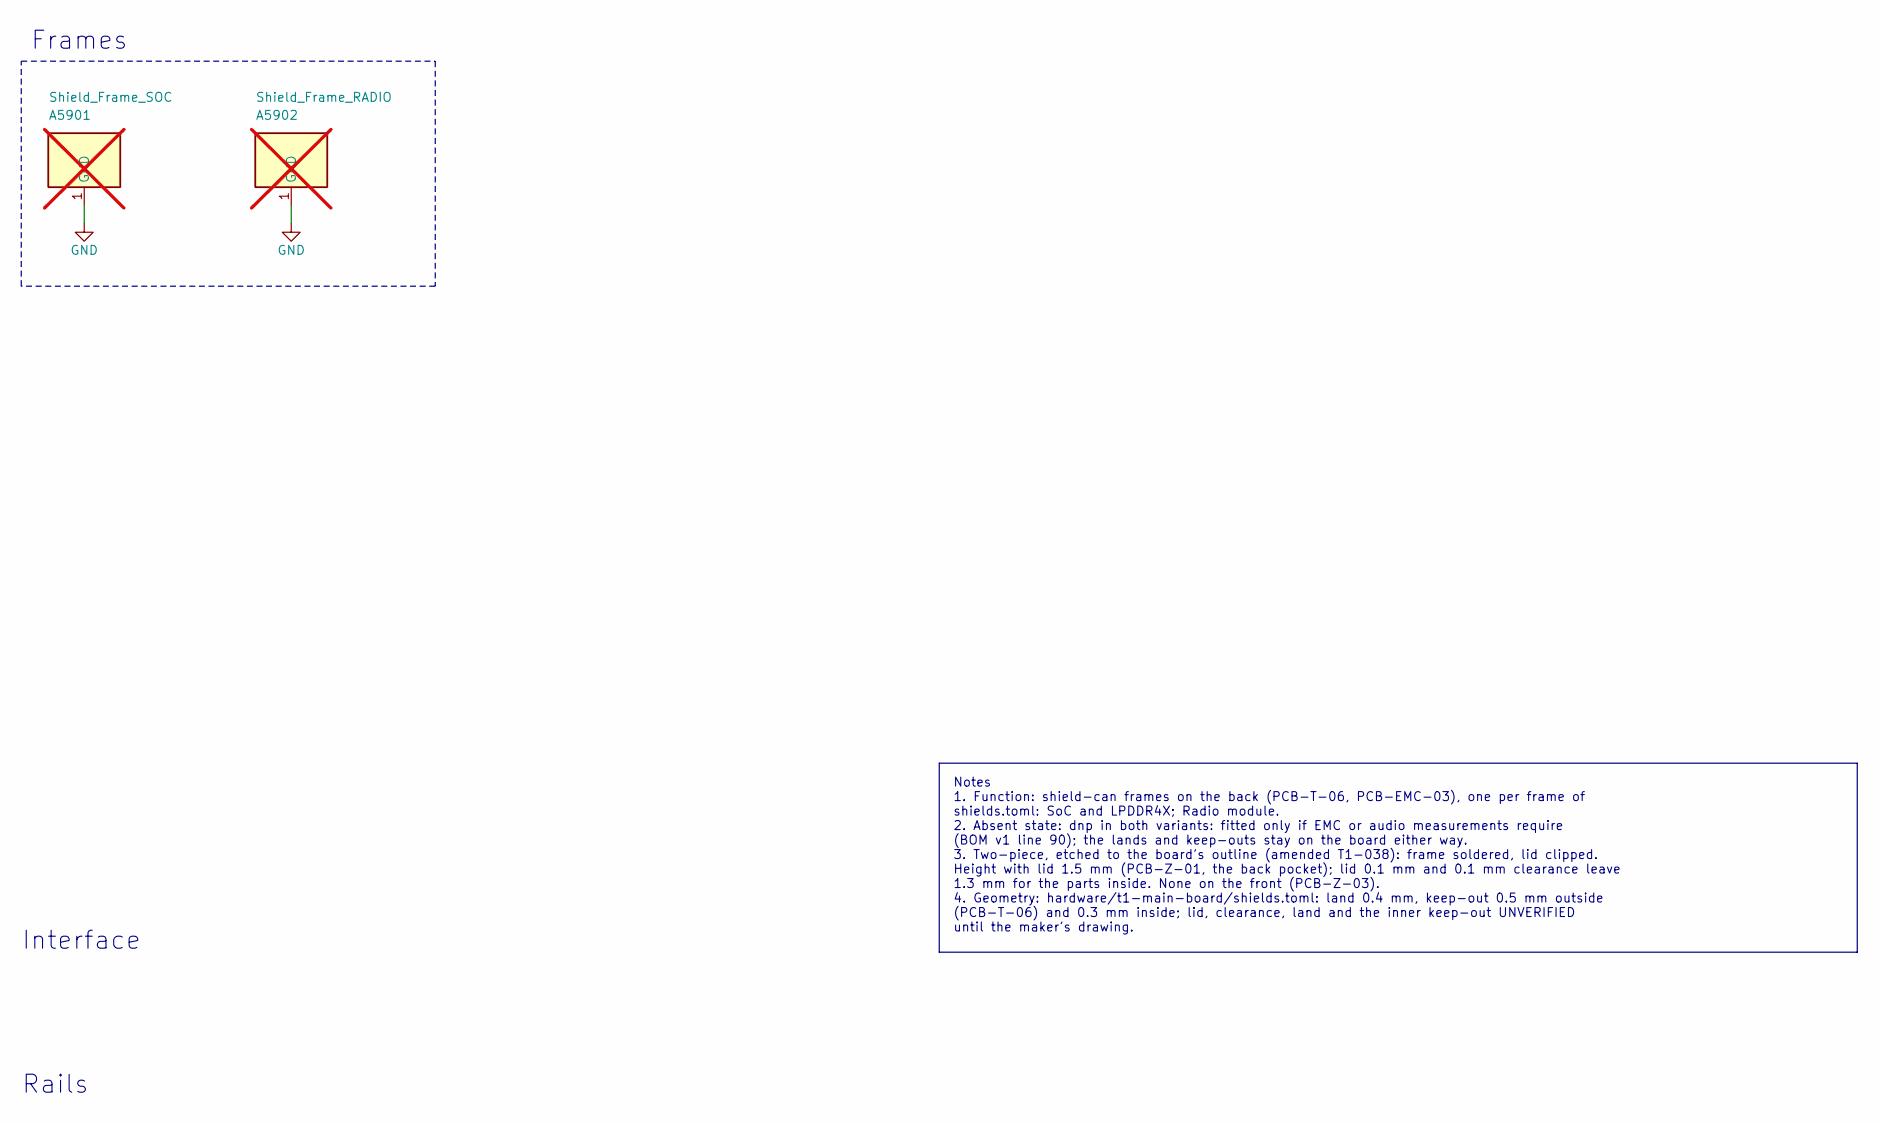
[picture p51: schematic shields.kicad_sch, Shield-can frames]

Parts:
A5901: Shield_Frame_SOC; Shield_Frame_SOC_34.15x19.75mm; MPN T1-SHIELD-SOC; not fitted
A5902: Shield_Frame_RADIO; Shield_Frame_RADIO_13.3x11.1mm; MPN T1-SHIELD-RADIO; not fitted

Connections:
GND: A5901.1, A5902.1; also elsewhere on the board

Notes on the sheet:
Frames
Notes 1. Function: shield-can frames on the back (PCB-T-06, PCB-EMC-03), one per frame of shields.toml: SoC and LPDDR4X; Radio module. 2. Absent state: dnp in both variants: fitted only if EMC or audio measurements require (BOM v1 line 90); the lands and keep-outs stay on the board either way. 3. T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
Rails
Interface

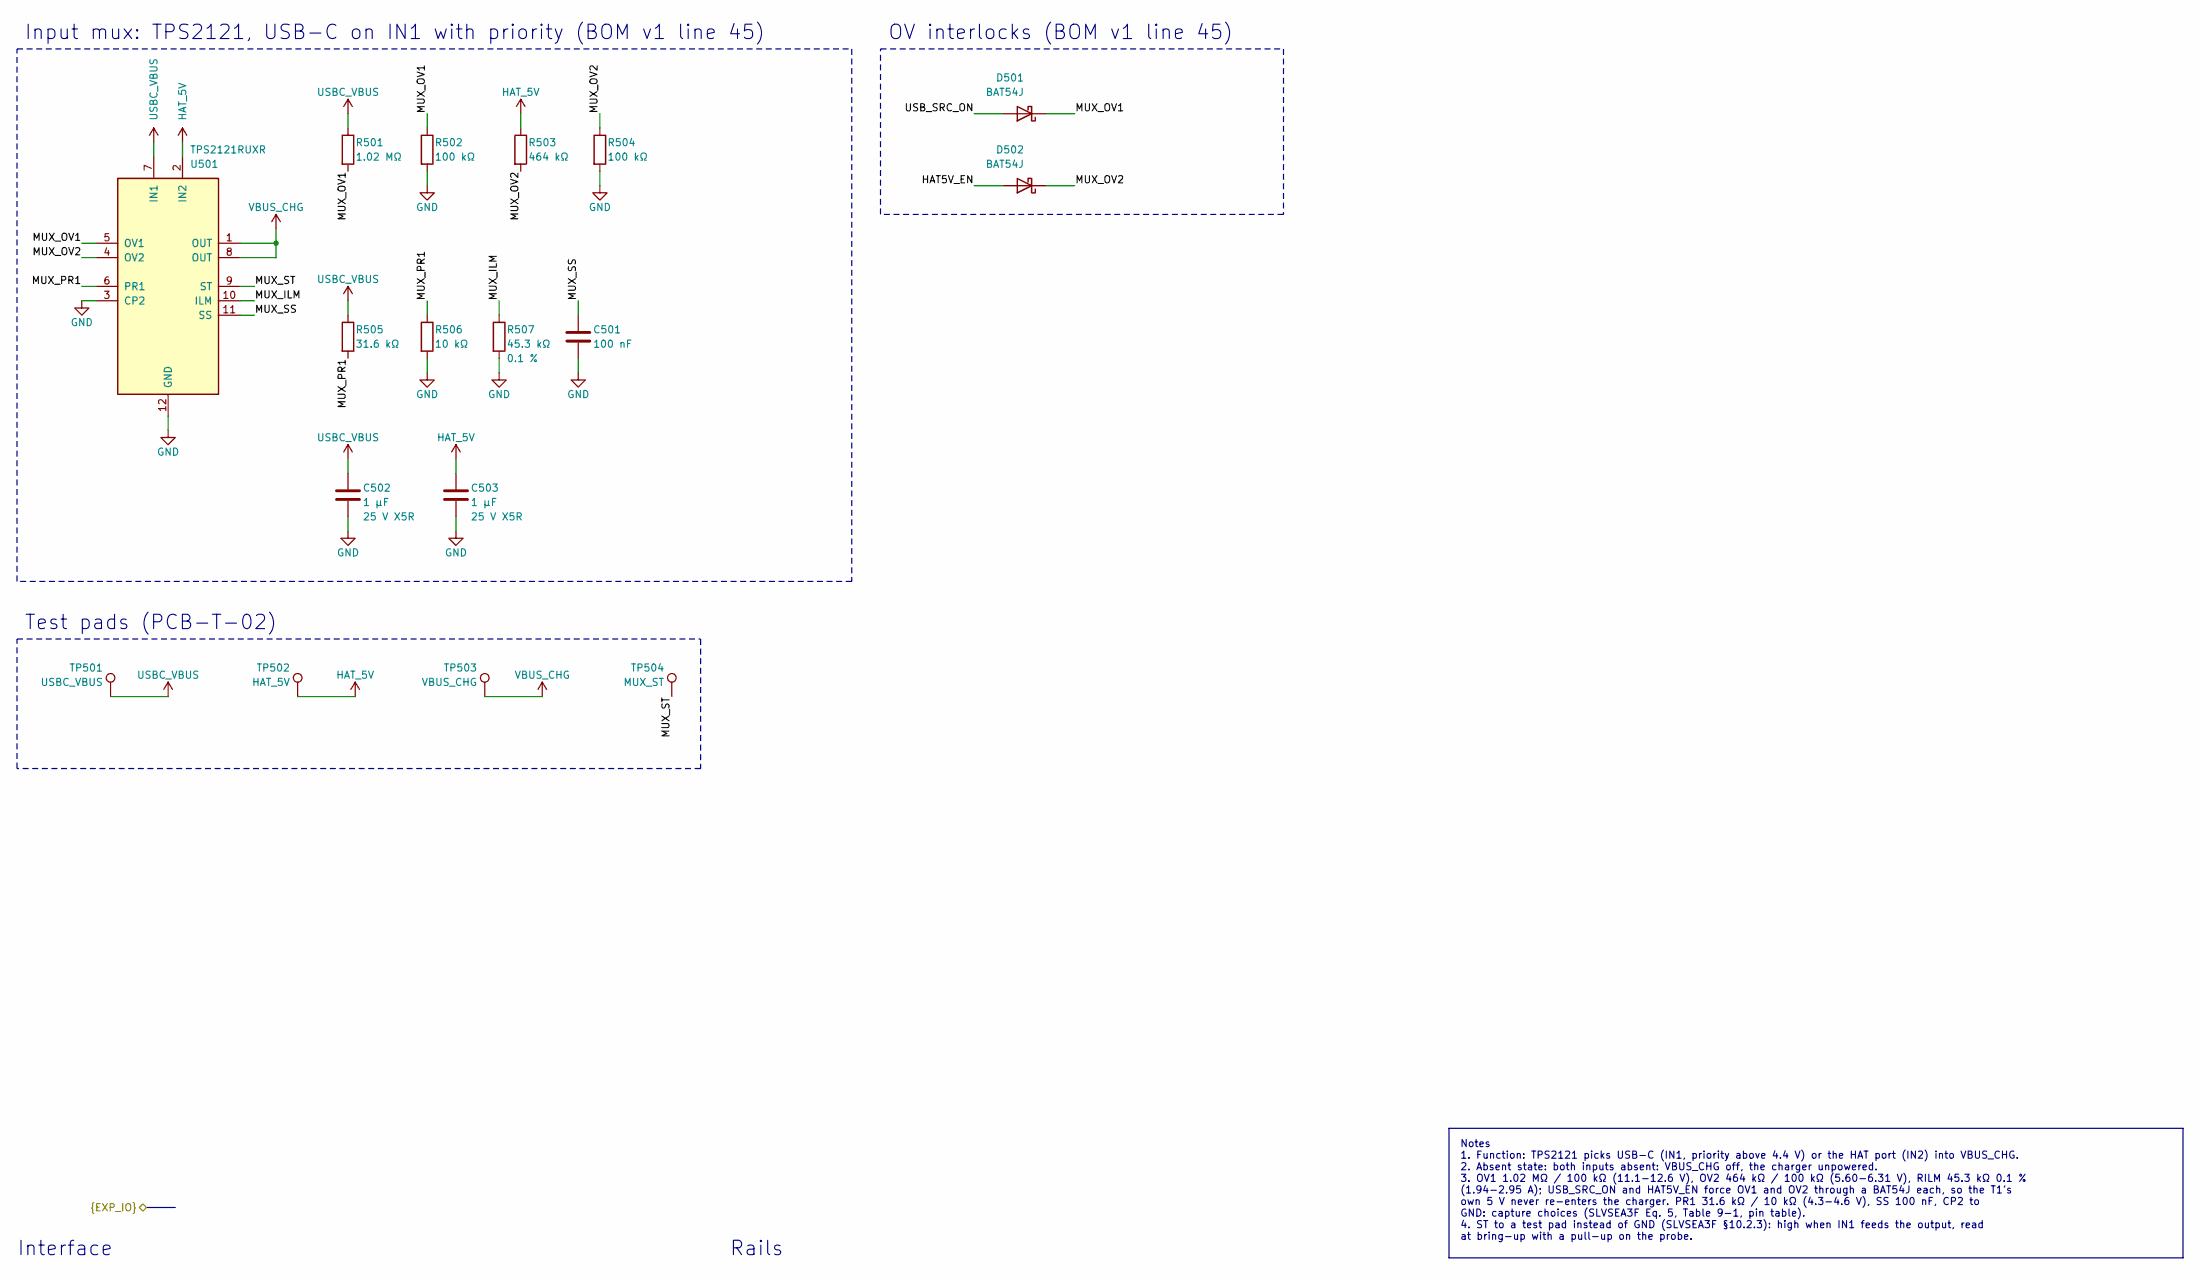
[picture p52: schematic charger-input.kicad_sch, Charger: input mux]

Parts:
C501: 100 nF; C_0402_1005Metric; MPN GRM155R71C104KA88D
C502, C503: 1 µF; C_0402_1005Metric; MPN GRM155R61E105KA12D
D501, D502: BAT54J; D_SOD-323F; MPN BAT54J,115
R501: 1.02 MΩ; R_0402_1005Metric; MPN RC0402FR-071M02L
R502, R504: 100 kΩ; R_0402_1005Metric; MPN RC0402FR-07100KL
R503: 464 kΩ; R_0402_1005Metric; MPN RC0402FR-07464KL
R505: 31.6 kΩ; R_0402_1005Metric; MPN RC0402FR-0731K6L
R506: 10 kΩ; R_0402_1005Metric; MPN RC0402FR-0710KL
R507: 45.3 kΩ; R_0402_1005Metric; MPN RT0402BRD0745K3L
TP501: USBC_VBUS; TestPoint_Pad_D1.0mm
TP502: HAT_5V; TestPoint_Pad_D1.0mm
TP503: VBUS_CHG; TestPoint_Pad_D1.0mm
TP504: MUX_ST; TestPoint_Pad_D0.8mm
U501: TPS2121RUXR; Texas_RUX0012A_VQFN-HR-12_2x2.5mm_P0.5mm; MPN TPS2121RUXR

Connections:
/Charger and battery path/Charger: input mux/MUX_ILM: R507.1, U501.10 (ILM)
/Charger and battery path/Charger: input mux/MUX_OV1: D501.1 (K), R501.2, R502.1, U501.5 (OV1)
/Charger and battery path/Charger: input mux/MUX_OV2: D502.1 (K), R503.2, R504.1, U501.4 (OV2)
/Charger and battery path/Charger: input mux/MUX_PR1: R505.2, R506.1, U501.6 (PR1)
/Charger and battery path/Charger: input mux/MUX_SS: C501.1, U501.11 (SS)
/Charger and battery path/Charger: input mux/MUX_ST: TP504.1, U501.9 (ST)
/HAT5V_EN: D502.2 (A); also elsewhere on the board
/USB_SRC_ON: D501.2 (A); also elsewhere on the board
GND: C501.2, C502.2, C503.2, R502.2, R504.2, R506.2, R507.2, U501.3 (CP2), U501.12 (GND); also elsewhere on the board
HAT_5V: C503.1, R503.1, TP502.1, U501.2 (IN2); also elsewhere on the board
USBC_VBUS: C502.1, R501.1, R505.1, TP501.1, U501.7 (IN1); also elsewhere on the board
VBUS_CHG: TP503.1, U501.1 (OUT), U501.8 (OUT); also elsewhere on the board

Notes on the sheet:
Input mux: TPS2121, USB-C on IN1 with priority (BOM v1 line 45)
OV interlocks (BOM v1 line 45)
Test pads (PCB-T-02)
Notes 1. Function: TPS2121 picks USB-C (IN1, priority above 4.4 V) or the HAT port (IN2) into VBUS_CHG. 2. Absent state: both inputs absent: VBUS_CHG off, the charger unpowered. 3. OV1 1.02 MΩ / 100 kΩ (11.1-12.6 V), OV2 464 kΩ / 100 kΩ (5.60-6.31 V), RILM 45.3 kΩ 0.1 % (1.94-2.95 A); USB_SRC_ON an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
Interface
Rails

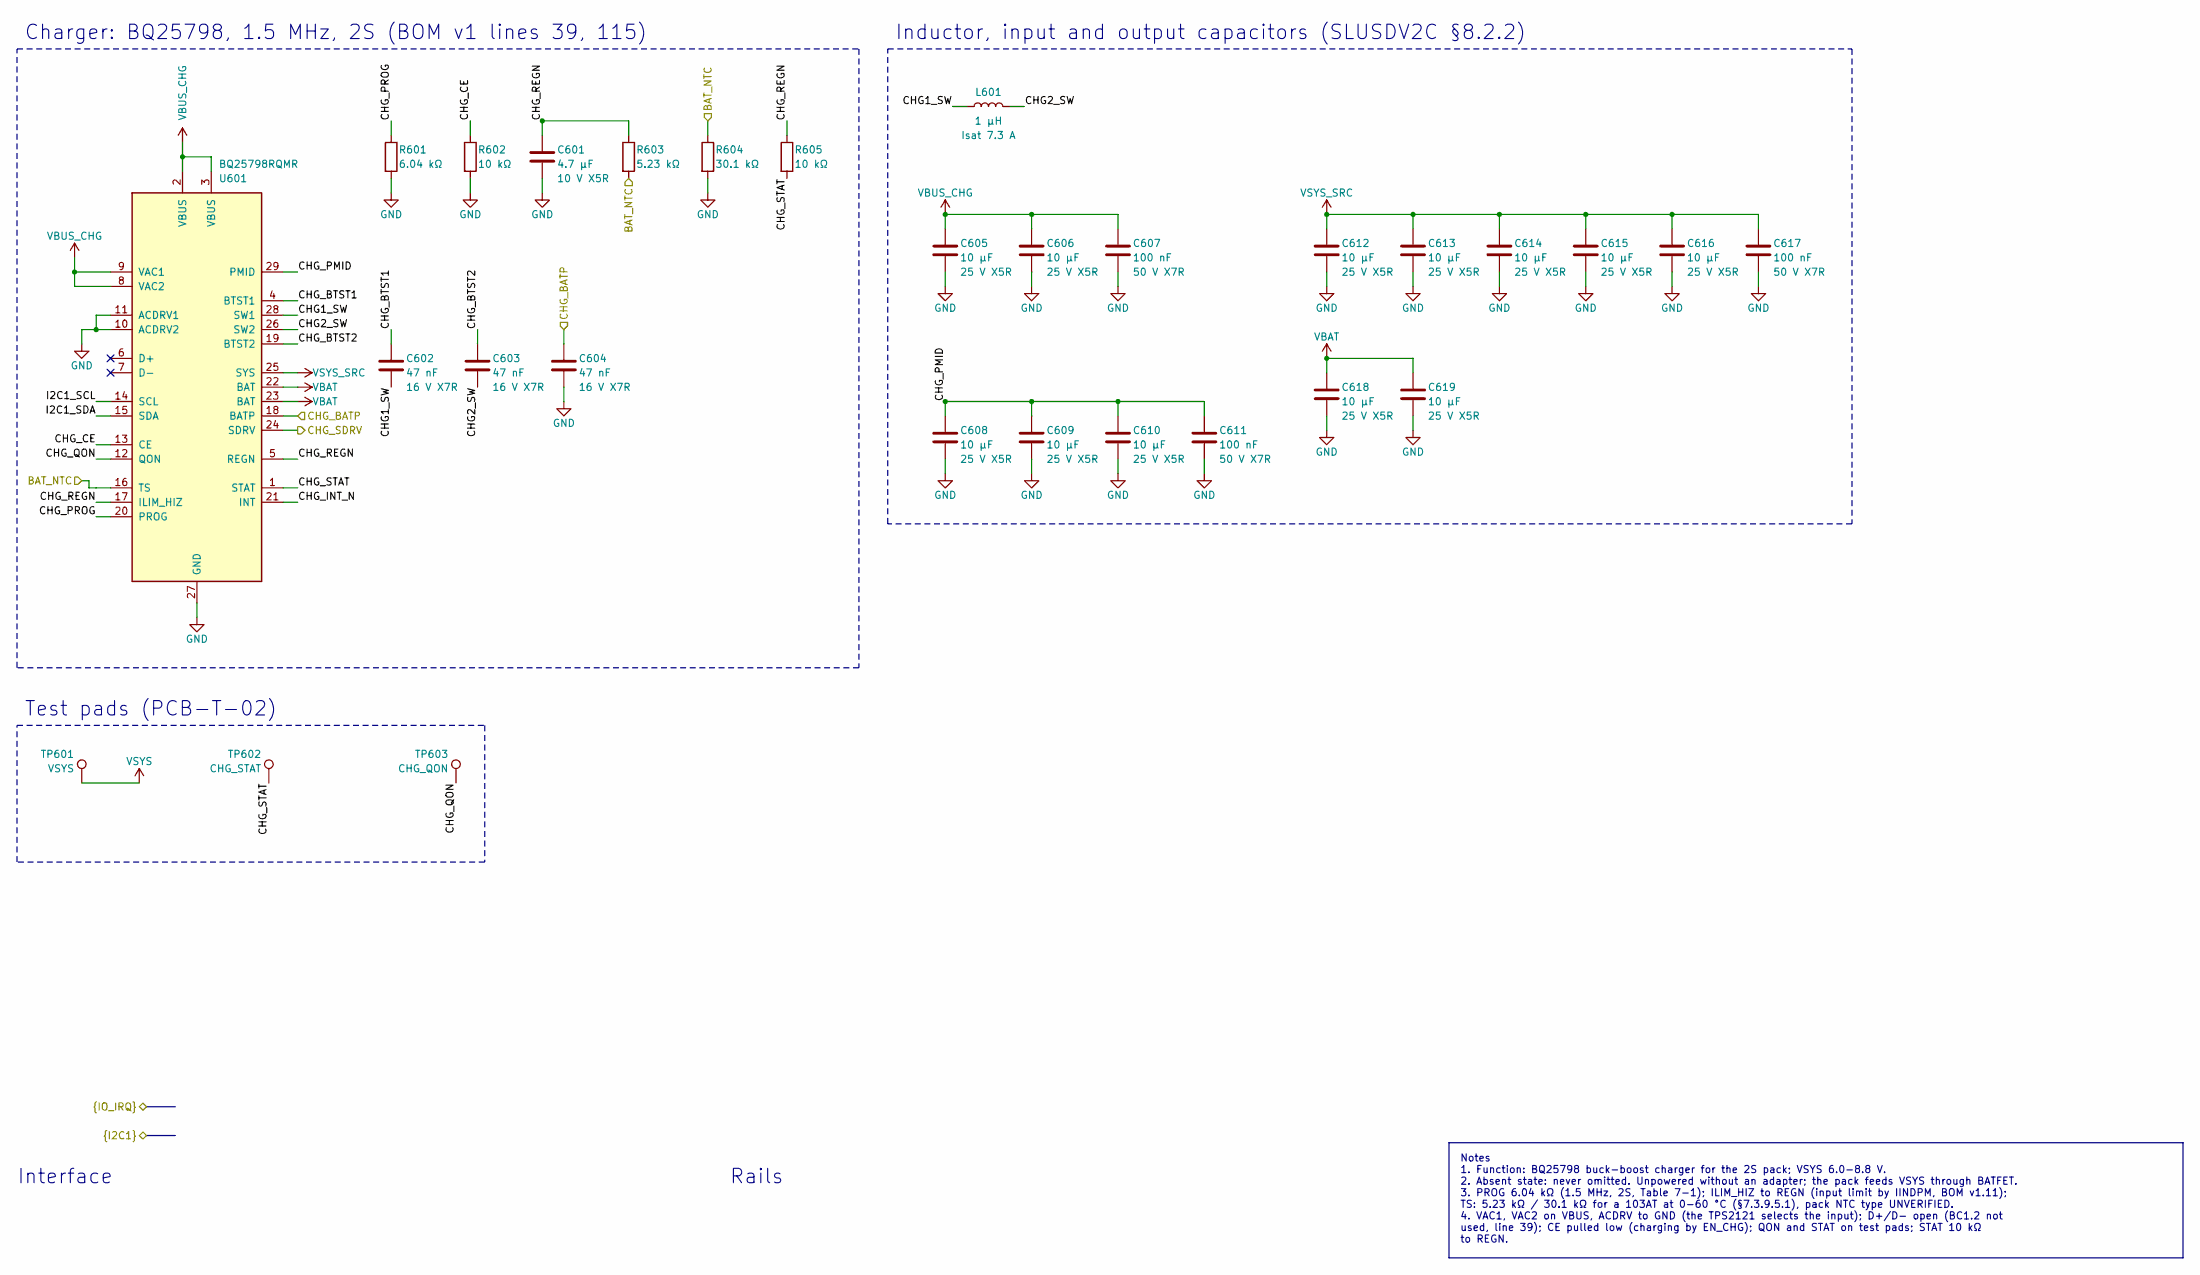
[picture p53: schematic charger-core.kicad_sch, Charger: BQ25798]

Parts:
C601: 4.7 µF; C_0603_1608Metric; MPN GRM188R61A475KE15D
C602, C603, C604: 47 nF; C_0402_1005Metric; MPN GRM155R71C473KA01D
C605, C606, C612, C613, C614, C615, C616: 10 µF; C_0603_1608Metric; MPN GRM188R61E106MA73D
C607, C611, C617: 100 nF; C_0402_1005Metric; MPN GRM155R71H104KE14D
C608, C609, C610, C618, C619: 10 µF; C_0805_2012Metric; MPN GRM21BR61E106KA73L
L601: 1 µH; L_Coilcraft_XxL4020; MPN XGL4015-102MEC
R601: 6.04 kΩ; R_0201_0603Metric; MPN RC0201FR-076K04L
R602, R605: 10 kΩ; R_0201_0603Metric; MPN RC0201FR-0710KL
R603: 5.23 kΩ; R_0201_0603Metric; MPN RC0201FR-075K23L
R604: 30.1 kΩ; R_0201_0603Metric; MPN RC0201FR-0730K1L
TP601: VSYS; TestPoint_Pad_D1.0mm
TP602: CHG_STAT; TestPoint_Pad_D0.8mm
TP603: CHG_QON; TestPoint_Pad_D0.8mm
U601: BQ25798RQMR; VQFN-HR-29_4x4mm_P0.4mm; MPN BQ25798RQMR

Connections:
/CHG_INT_N: U601.21 (INT); also elsewhere on the board
/Charger and battery path/BAT_NTC: R603.2, R604.1, U601.16 (TS); also elsewhere on the board
/Charger and battery path/CHG_BATP: C604.1, U601.18 (BATP); also elsewhere on the board
/Charger and battery path/CHG_SDRV: U601.24 (SDRV); also elsewhere on the board
/Charger and battery path/Charger: BQ25798/CHG1_SW: C602.2, L601.1, U601.28 (SW1)
/Charger and battery path/Charger: BQ25798/CHG2_SW: C603.2, L601.2, U601.26 (SW2)
/Charger and battery path/Charger: BQ25798/CHG_BTST1: C602.1, U601.4 (BTST1)
/Charger and battery path/Charger: BQ25798/CHG_BTST2: C603.1, U601.19 (BTST2)
/Charger and battery path/Charger: BQ25798/CHG_CE: R602.1, U601.13 (CE)
/Charger and battery path/Charger: BQ25798/CHG_PMID: C608.1, C609.1, C610.1, C611.1, U601.29 (PMID)
/Charger and battery path/Charger: BQ25798/CHG_PROG: R601.1, U601.20 (PROG)
/Charger and battery path/Charger: BQ25798/CHG_QON: TP603.1, U601.12 (QON)
/Charger and battery path/Charger: BQ25798/CHG_REGN: C601.1, R603.1, R605.1, U601.5 (REGN), U601.17 (ILIM_HIZ)
/Charger and battery path/Charger: BQ25798/CHG_STAT: R605.2, TP602.1, U601.1 (STAT)
/I2C1_SCL: U601.14 (SCL); also elsewhere on the board
/I2C1_SDA: U601.15 (SDA); also elsewhere on the board
GND: C601.2, C604.2, C605.2, C606.2, C607.2, C608.2, C609.2, C610.2, C611.2, C612.2, C613.2, C614.2, C615.2, C616.2, C617.2, C618.2, C619.2, R601.2, R602.2, R604.2, U601.10 (ACDRV2), U601.11 (ACDRV1), U601.27 (GND); also elsewhere on the board
VBAT: C618.1, C619.1, U601.22 (BAT), U601.23 (BAT); also elsewhere on the board
VBUS_CHG: C605.1, C606.1, C607.1, U601.2 (VBUS), U601.3 (VBUS), U601.8 (VAC2), U601.9 (VAC1); also elsewhere on the board
VSYS: TP601.1; also elsewhere on the board
VSYS_SRC: C612.1, C613.1, C614.1, C615.1, C616.1, C617.1, U601.25 (SYS); also elsewhere on the board

Notes on the sheet:
Charger: BQ25798, 1.5 MHz, 2S (BOM v1 lines 39, 115)
Inductor, input and output capacitors (SLUSDV2C §8.2.2)
Test pads (PCB-T-02)
Notes 1. Function: BQ25798 buck-boost charger for the 2S pack; VSYS 6.0-8.8 V. 2. Absent state: never omitted. Unpowered without an adapter; the pack feeds VSYS through BATFET. 3. PROG 6.04 kΩ (1.5 MHz, 2S, Table 7-1); ILIM_HIZ to REGN (input limit by IINDPM, BOM v1.11); TS: 5.23 kΩ / 30.1 kΩ for a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
Interface
Rails

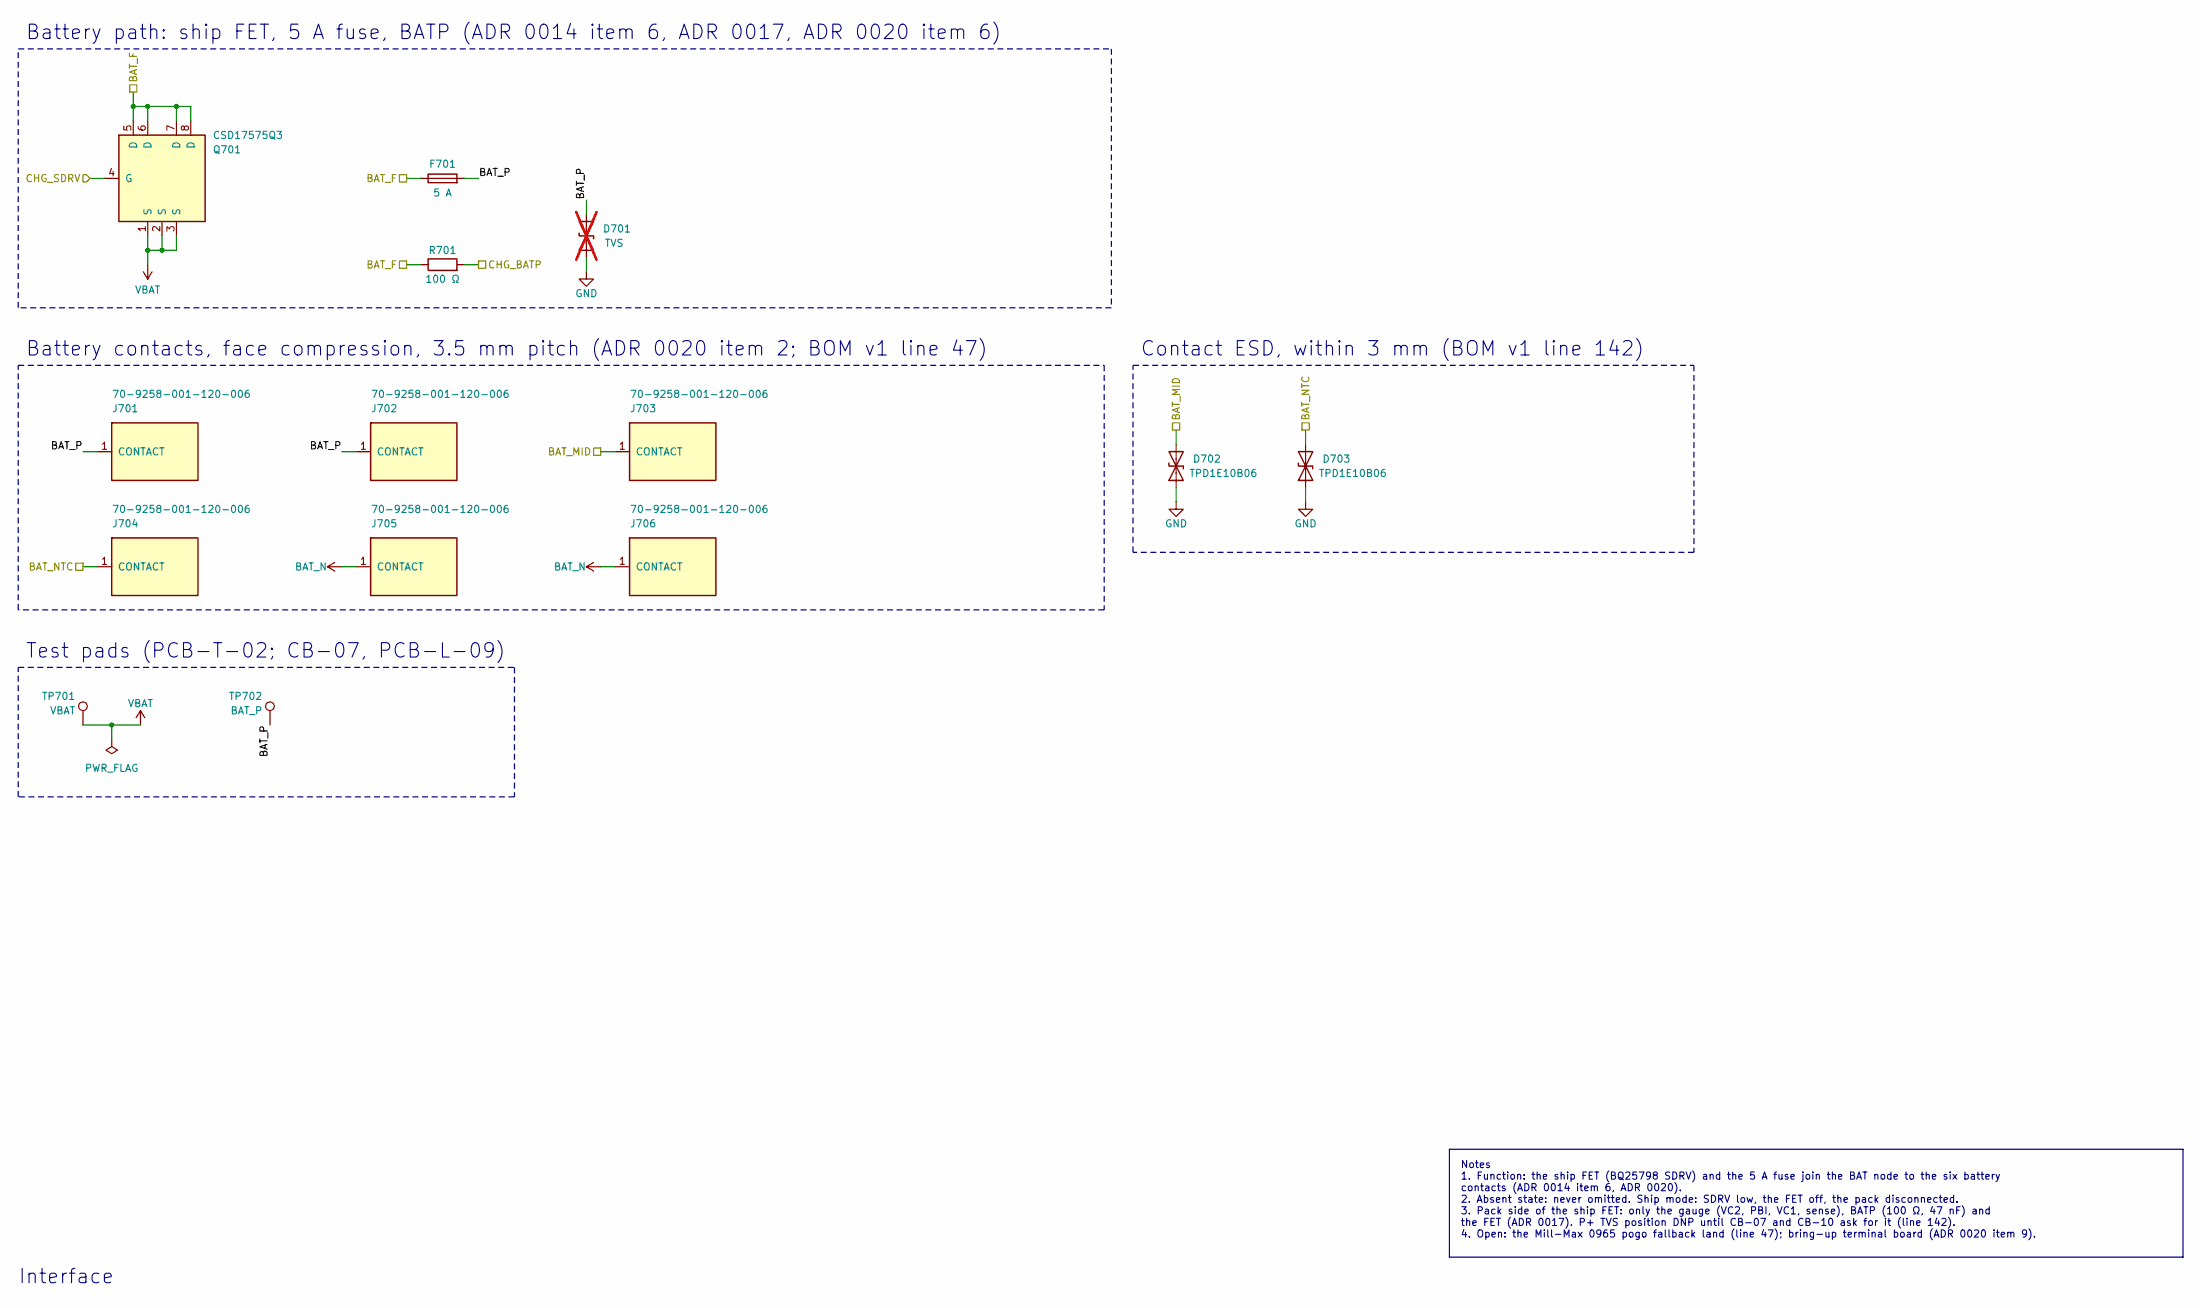
[picture p54: schematic charger-battery.kicad_sch, Charger: battery path]

Parts:
D701: TVS; D_SOD-123F; not fitted
D702, D703: TPD1E10B06; Texas_DPY0002A_0.6x1mm_P0.65mm; MPN TPD1E10B06DPYR
F701: 5 A; Fuse_Littelfuse-NANO2-451_453; MPN 0451005.MRL
J701, J702, J703, J704, J705, J706: 70-9258-001-120-006; KYOCERA_AVX_9258-100_70-9258-001-120-006_SpringFinger_Pad7.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; MPN 70-9258-001-120-006
Q701: CSD17575Q3; Texas_Q3_SON-8_3.3x3.3mm_P0.65mm; MPN CSD17575Q3
R701: 100 Ω; R_0201_0603Metric; MPN RC0201FR-07100RL
TP701: VBAT; TestPoint_Pad_D1.0mm
TP702: BAT_P; TestPoint_Pad_D1.0mm

Connections:
/BAT_F: F701.1, Q701.5 (D), Q701.6 (D), Q701.7 (D), Q701.8 (D), R701.1; also elsewhere on the board
/BAT_MID: D702.2 (A2), J703.1; also elsewhere on the board
/Charger and battery path/BAT_NTC: D703.2 (A2), J704.1; also elsewhere on the board
/Charger and battery path/CHG_BATP: R701.2; also elsewhere on the board
/Charger and battery path/CHG_SDRV: Q701.4 (G); also elsewhere on the board
/Charger and battery path/Charger: battery path/BAT_P: D701.2 (A2), F701.2, J701.1, J702.1, TP702.1
BAT_N: J705.1, J706.1; also elsewhere on the board
GND: D701.1 (A1), D702.1 (A1), D703.1 (A1); also elsewhere on the board
VBAT: Q701.1 (S), Q701.2 (S), Q701.3 (S), TP701.1; also elsewhere on the board

Notes on the sheet:
Battery path: ship FET, 5 A fuse, BATP (ADR 0014 item 6, ADR 0017, ADR 0020 item 6)
Battery contacts, face compression, 3.5 mm pitch (ADR 0020 item 2; BOM v1 line 47)
Contact ESD, within 3 mm (BOM v1 line 142)
Test pads (PCB-T-02; CB-07, PCB-L-09)
Notes 1. Function: the ship FET (BQ25798 SDRV) and the 5 A fuse join the BAT node to the six battery contacts (ADR 0014 item 6, ADR 0020). 2. Absent state: never omitted. Ship mode: SDRV low, the FET off, the pack disconnected. 3. Pack side of the ship FET: only the gauge (VC2, PBI, VC1, sense), BA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
Interface
