opendap-project/t1/board/hardware/t1-main-board/t1-main-board.kicad_pcb

## KiCad design board/hardware/t1-main-board/t1-main-board.kicad_pcb (continued)

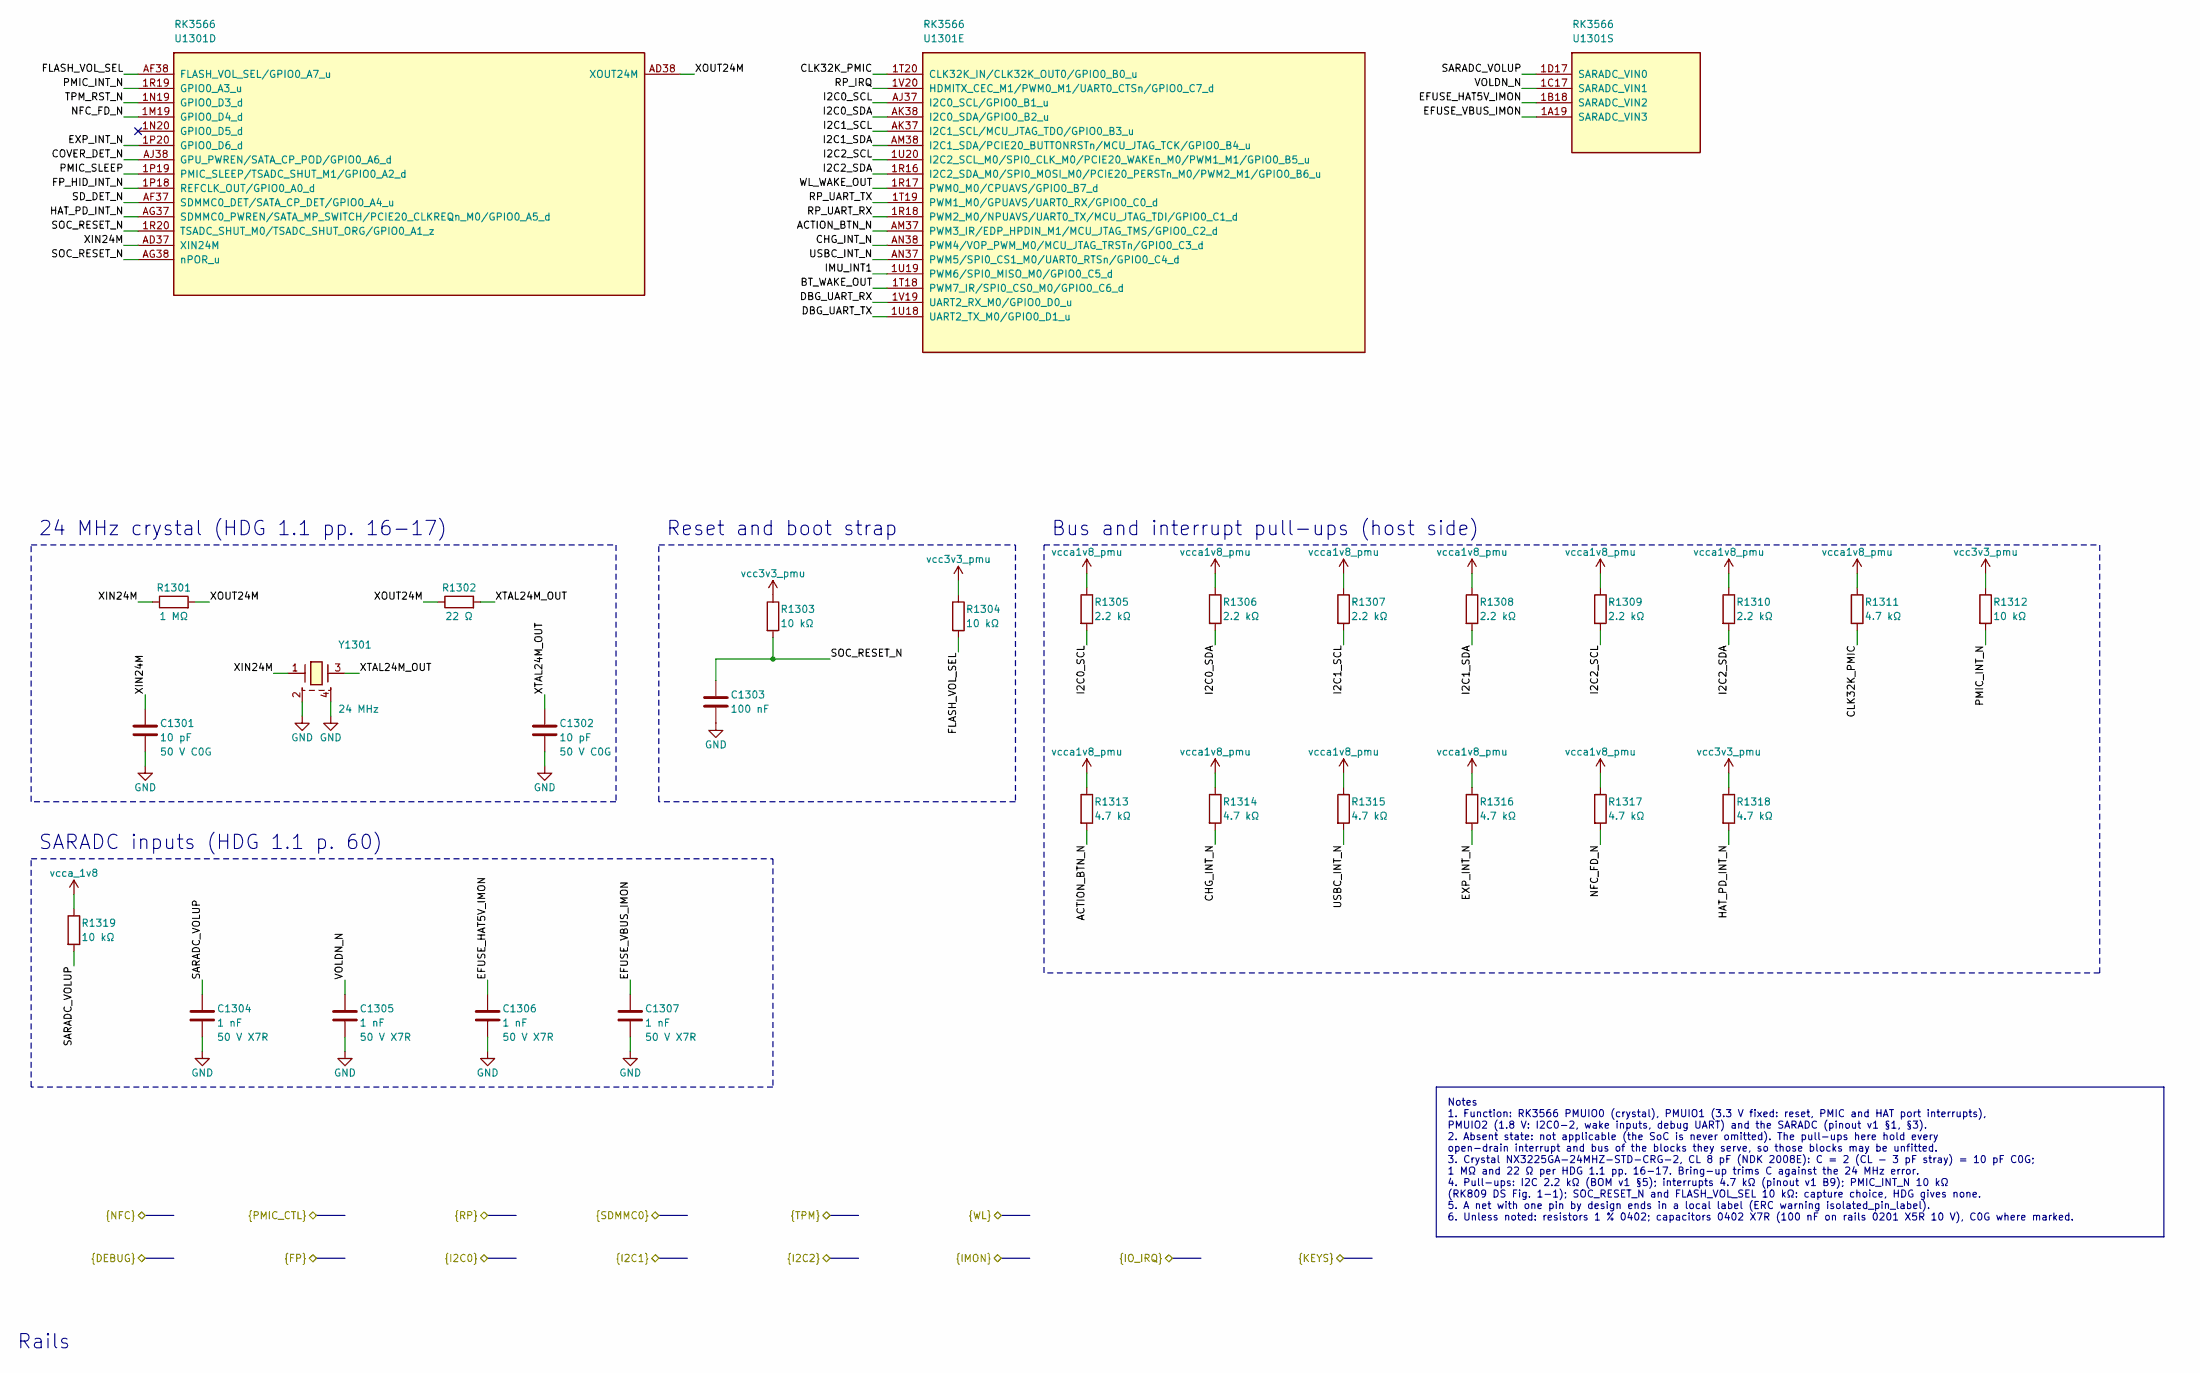
[picture p55: schematic soc-pmuio.kicad_sch, SoC: PMU IO domains, clock, reset and SARADC]

Parts:
C1301, C1302: 10 pF; C_0402_1005Metric; MPN GRM1555C1H100JA01D
C1303: 100 nF; C_0201_0603Metric; MPN GRM033R61A104KE15D
C1304, C1305, C1306, C1307: 1 nF; C_0402_1005Metric; MPN GRM155R71H102KA01D
R1301: 1 MΩ; R_0201_0603Metric; MPN RC0201FR-071ML
R1302: 22 Ω; R_0201_0603Metric; MPN RC0201FR-0722RL
R1303, R1304, R1312, R1319: 10 kΩ; R_0201_0603Metric; MPN RC0201FR-0710KL
R1305, R1306, R1307, R1308, R1309, R1310: 2.2 kΩ; R_0201_0603Metric; MPN RC0201FR-072K2L
R1311, R1313, R1314, R1315, R1316, R1317, R1318: 4.7 kΩ; R_0201_0603Metric; MPN RC0201FR-074K7L
U1301: RK3566; Rockchip_FCCSP-565L_15.5x14.4mm_P0.4mm_P0.65mm_Ball0.25mm_P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; MPN RK3566
Y1301: 24 MHz; Crystal_SMD_NDK_NX3225GA-4Pin_3.2x2.5mm; MPN NX3225GA-24MHZ-STD-CRG-2

Connections:
/ACTION_BTN_N: R1313.2, U1301.AM37 (PWM3_IR/EDP_HPDIN_M1/MCU_JTAG_TMS/GPIO0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); also elsewhere on the board
/BT_WAKE_OUT: U1301.1T18 (PWM7_IR/SPI0_CS0_M0/GPIO0_C6_d); also elsewhere on the board
/CHG_INT_N: R1314.2, U1301.AN38 (PWM4/VOP_PWM_M0/MCU_JTAG_TRSTn/GPIO0_C3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); also elsewhere on the board
/CLK32K_PMIC: R1311.2, U1301.1T20 (CLK32K_IN/CLK32K_OUT0/GPIO0_B0_u); also elsewhere on the board
/COVER_DET_N: U1301.AJ38 (GPU_PWREN/SATA_CP_POD/GPIO0_A6_d); also elsewhere on the board
/DBG_UART_RX: U1301.1V19 (UART2_RX_M0/GPIO0_D0_u); also elsewhere on the board
/DBG_UART_TX: U1301.1U18 (UART2_TX_M0/GPIO0_D1_u); also elsewhere on the board
/EFUSE_HAT5V_IMON: C1306.1, U1301.1B18 (SARADC_VIN2); also elsewhere on the board
/EFUSE_VBUS_IMON: C1307.1, U1301.1A19 (SARADC_VIN3); also elsewhere on the board
/EXP_INT_N: R1316.2, U1301.1P20 (GPIO0_D6_d); also elsewhere on the board
/FP_HID_INT_N: U1301.1P18 (REFCLK_OUT/GPIO0_A0_d); also elsewhere on the board
/HAT_PD_INT_N: R1318.2, U1301.AG37 (SDMMC0_PWREN/SATA_MP_SWITCH/PCIE20_CLKR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); also elsewhere on the board
/I2C0_SCL: R1305.2, U1301.AJ37 (I2C0_SCL/GPIO0_B1_u); also elsewhere on the board
/I2C0_SDA: R1306.2, U1301.AK38 (I2C0_SDA/GPIO0_B2_u); also elsewhere on the board
/I2C1_SCL: R1307.2, U1301.AK37 (I2C1_SCL/MCU_JTAG_TDO/GPIO0_B3_u); also elsewhere on the board
/I2C1_SDA: R1308.2, U1301.AM38 (I2C1_SDA/PCIE20_BUTTONRSTn/MCU_JTAG_TCK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); also elsewhere on the board
/I2C2_SCL: R1309.2, U1301.1U20 (I2C2_SCL_M0/SPI0_CLK_M0/PCIE20_WAKEn_M0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); also elsewhere on the board
/I2C2_SDA: R1310.2, U1301.1R16 (I2C2_SDA_M0/SPI0_MOSI_M0/PCIE20_PERSTn_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); also elsewhere on the board
/IMU_INT1: U1301.1U19 (PWM6/SPI0_MISO_M0/GPIO0_C5_d); also elsewhere on the board
/NFC_FD_N: R1317.2, U1301.1M19 (GPIO0_D4_d); also elsewhere on the board
/PMIC_INT_N: R1312.2, U1301.1R19 (GPIO0_A3_u); also elsewhere on the board
/PMIC_SLEEP: U1301.1P19 (PMIC_SLEEP/TSADC_SHUT_M1/GPIO0_A2_d); also elsewhere on the board
/RP_IRQ: U1301.1V20 (HDMITX_CEC_M1/PWM0_M1/UART0_CTSn/GPIO0_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); also elsewhere on the board
/RP_UART_RX: U1301.1R18 (PWM2_M0/NPUAVS/UART0_TX/MCU_JTAG_TDI/GP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); also elsewhere on the board
/RP_UART_TX: U1301.1T19 (PWM1_M0/GPUAVS/UART0_RX/GPIO0_C0_d); also elsewhere on the board
/SARADC_VOLUP: C1304.1, R1319.2, U1301.1D17 (SARADC_VIN0); also elsewhere on the board
/SD_DET_N: U1301.AF37 (SDMMC0_DET/SATA_CP_DET/GPIO0_A4_u); also elsewhere on the board
/SOC_RESET_N: C1303.1, R1303.2, U1301.1R20 (TSADC_SHUT_M0/TSADC_SHUT_ORG/GPIO0_A1_z), U1301.AG38 (nPOR_u); also elsewhere on the board
/SoC/SoC: PMU IO domains, clock, reset and SARADC/FLASH_VOL_SEL: R1304.2, U1301.AF38 (FLASH_VOL_SEL/GPIO0_A7_u)
/SoC/SoC: PMU IO domains, clock, reset and SARADC/XIN24M: C1301.1, R1301.1, U1301.AD37 (XIN24M), Y1301.1
/SoC/SoC: PMU IO domains, clock, reset and SARADC/XOUT24M: R1301.2, R1302.1, U1301.AD38 (XOUT24M)
/SoC/SoC: PMU IO domains, clock, reset and SARADC/XTAL24M_OUT: C1302.1, R1302.2, Y1301.3
/TPM_RST_N: U1301.1N19 (GPIO0_D3_d); also elsewhere on the board
/USBC_INT_N: R1315.2, U1301.AN37 (PWM5/SPI0_CS1_M0/UART0_RTSn/GPIO0_C4_d); also elsewhere on the board
/VOLDN_N: C1305.1, U1301.1C17 (SARADC_VIN1); also elsewhere on the board
/WL_WAKE_OUT: U1301.1R17 (PWM0_M0/CPUAVS/GPIO0_B7_d); also elsewhere on the board
GND: C1301.2, C1302.2, C1303.2, C1304.2, C1305.2, C1306.2, C1307.2, Y1301.2, Y1301.4; also elsewhere on the board
vcc3v3_pmu: R1303.1, R1304.1, R1312.1, R1318.1; also elsewhere on the board
vcca1v8_pmu: R1305.1, R1306.1, R1307.1, R1308.1, R1309.1, R1310.1, R1311.1, R1313.1, R1314.1, R1315.1, R1316.1, R1317.1; also elsewhere on the board
vcca_1v8: R1319.1; also elsewhere on the board

Notes on the sheet:
24 MHz crystal (HDG 1.1 pp. 16-17)
Reset and boot strap
Bus and interrupt pull-ups (host side)
SARADC inputs (HDG 1.1 p. 60)
Notes 1. Function: RK3566 PMUIO0 (crystal), PMUIO1 (3.3 V fixed: reset, PMIC and HAT port interrupts), PMUIO2 (1.8 V: I2C0-2, wake inputs, debug UART) and the SARADC (pinout v1 §1, §3). 2. Absent state: not applicable (the SoC is never omitted). The pull-ups here hold every open-drain interrupt and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
Rails

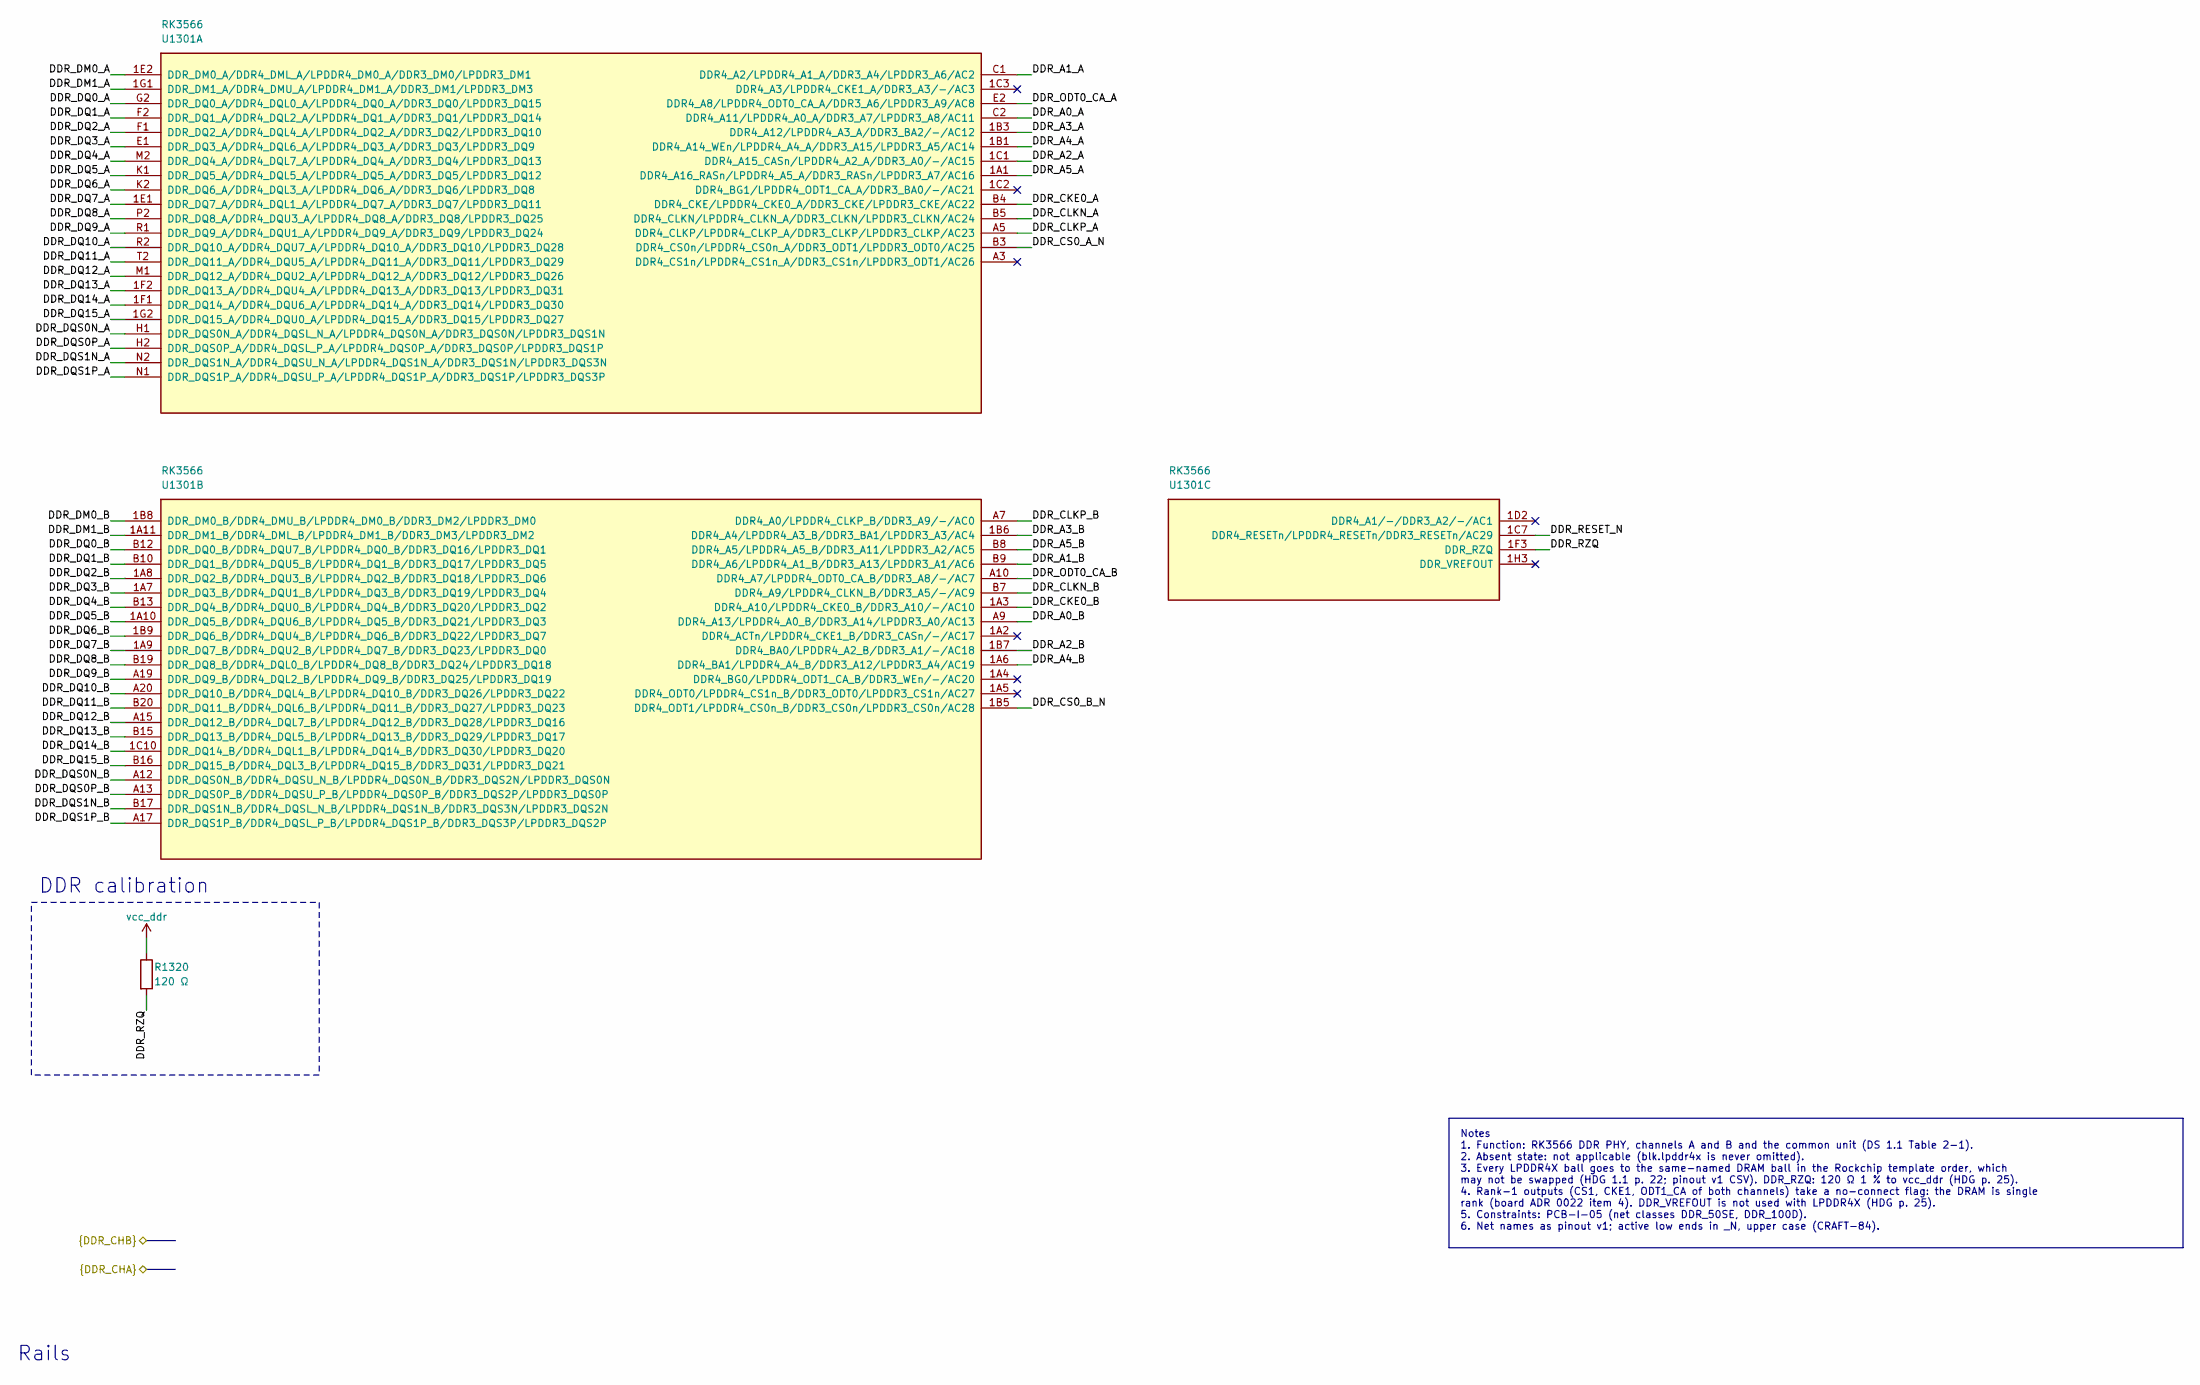
[picture p56: schematic soc-ddr.kicad_sch, SoC: LPDDR4X interface]

Parts:
R1320: 120 Ω; R_0201_0603Metric; MPN RC0201FR-07120RL
U1301: RK3566; Rockchip_FCCSP-565L_15.5x14.4mm_P0.4mm_P0.65mm_Ball0.25mm_P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; MPN RK3566

Connections:
/LPDDR4X memory/DDR_A0_A: U1301.C2 (DDR4_A11/LPDDR4_A0_A/DDR3_A7/LPDDR3_A8/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); also elsewhere on the board
/LPDDR4X memory/DDR_A0_B: U1301.A9 (DDR4_A13/LPDDR4_A0_B/DDR3_A14/LPDDR3_A0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); also elsewhere on the board
/LPDDR4X memory/DDR_A1_A: U1301.C1 (DDR4_A2/LPDDR4_A1_A/DDR3_A4/LPDDR3_A6/A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); also elsewhere on the board
/LPDDR4X memory/DDR_A1_B: U1301.B9 (DDR4_A6/LPDDR4_A1_B/DDR3_A13/LPDDR3_A1/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); also elsewhere on the board
/LPDDR4X memory/DDR_A2_A: U1301.1C1 (DDR4_A15_CASn/LPDDR4_A2_A/DDR3_A0/-/AC15); also elsewhere on the board
/LPDDR4X memory/DDR_A2_B: U1301.1B7 (DDR4_BA0/LPDDR4_A2_B/DDR3_A1/-/AC18); also elsewhere on the board
/LPDDR4X memory/DDR_A3_A: U1301.1B3 (DDR4_A12/LPDDR4_A3_A/DDR3_BA2/-/AC12); also elsewhere on the board
/LPDDR4X memory/DDR_A3_B: U1301.1B6 (DDR4_A4/LPDDR4_A3_B/DDR3_BA1/LPDDR3_A3/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); also elsewhere on the board
/LPDDR4X memory/DDR_A4_A: U1301.1B1 (DDR4_A14_WEn/LPDDR4_A4_A/DDR3_A15/LPDDR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); also elsewhere on the board
/LPDDR4X memory/DDR_A4_B: U1301.1A6 (DDR4_BA1/LPDDR4_A4_B/DDR3_A12/LPDDR3_A4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); also elsewhere on the board
/LPDDR4X memory/DDR_A5_A: U1301.1A1 (DDR4_A16_RASn/LPDDR4_A5_A/DDR3_RASn/LPD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); also elsewhere on the board
/LPDDR4X memory/DDR_A5_B: U1301.B8 (DDR4_A5/LPDDR4_A5_B/DDR3_A11/LPDDR3_A2/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); also elsewhere on the board
/LPDDR4X memory/DDR_CKE0_A: U1301.B4 (DDR4_CKE/LPDDR4_CKE0_A/DDR3_CKE/LPDDR3_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); also elsewhere on the board
/LPDDR4X memory/DDR_CKE0_B: U1301.1A3 (DDR4_A10/LPDDR4_CKE0_B/DDR3_A10/-/AC10); also elsewhere on the board
/LPDDR4X memory/DDR_CLKN_A: U1301.B5 (DDR4_CLKN/LPDDR4_CLKN_A/DDR3_CLKN/LPDDR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); also elsewhere on the board
/LPDDR4X memory/DDR_CLKN_B: U1301.B7 (DDR4_A9/LPDDR4_CLKN_B/DDR3_A5/-/AC9); also elsewhere on the board
/LPDDR4X memory/DDR_CLKP_A: U1301.A5 (DDR4_CLKP/LPDDR4_CLKP_A/DDR3_CLKP/LPDDR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); also elsewhere on the board
/LPDDR4X memory/DDR_CLKP_B: U1301.A7 (DDR4_A0/LPDDR4_CLKP_B/DDR3_A9/-/AC0); also elsewhere on the board
/LPDDR4X memory/DDR_CS0_A_N: U1301.B3 (DDR4_CS0n/LPDDR4_CS0n_A/DDR3_ODT1/LPDDR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); also elsewhere on the board
/LPDDR4X memory/DDR_CS0_B_N: U1301.1B5 (DDR4_ODT1/LPDDR4_CS0n_B/DDR3_CS0n/LPDDR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); also elsewhere on the board
/LPDDR4X memory/DDR_DM0_A: U1301.1E2 (DDR_DM0_A/DDR4_DML_A/LPDDR4_DM0_A/DDR3_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); also elsewhere on the board
/LPDDR4X memory/DDR_DM0_B: U1301.1B8 (DDR_DM0_B/DDR4_DMU_B/LPDDR4_DM0_B/DDR3_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); also elsewhere on the board
/LPDDR4X memory/DDR_DM1_A: U1301.1G1 (DDR_DM1_A/DDR4_DMU_A/LPDDR4_DM1_A/DDR3_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); also elsewhere on the board
/LPDDR4X memory/DDR_DM1_B: U1301.1A11 (DDR_DM1_B/DDR4_DML_B/LPDDR4_DM1_B/DDR3_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); also elsewhere on the board
/LPDDR4X memory/DDR_DQ0_A: U1301.G2 (DDR_DQ0_A/DDR4_DQL0_A/LPDDR4_DQ0_A/DDR3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); also elsewhere on the board
/LPDDR4X memory/DDR_DQ0_B: U1301.B12 (DDR_DQ0_B/DDR4_DQU7_B/LPDDR4_DQ0_B/DDR3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); also elsewhere on the board
/LPDDR4X memory/DDR_DQ1_A: U1301.F2 (DDR_DQ1_A/DDR4_DQL2_A/LPDDR4_DQ1_A/DDR3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); also elsewhere on the board
/LPDDR4X memory/DDR_DQ1_B: U1301.B10 (DDR_DQ1_B/DDR4_DQU5_B/LPDDR4_DQ1_B/DDR3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); also elsewhere on the board
/LPDDR4X memory/DDR_DQ2_A: U1301.F1 (DDR_DQ2_A/DDR4_DQL4_A/LPDDR4_DQ2_A/DDR3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); also elsewhere on the board
/LPDDR4X memory/DDR_DQ2_B: U1301.1A8 (DDR_DQ2_B/DDR4_DQU3_B/LPDDR4_DQ2_B/DDR3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); also elsewhere on the board
/LPDDR4X memory/DDR_DQ3_A: U1301.E1 (DDR_DQ3_A/DDR4_DQL6_A/LPDDR4_DQ3_A/DDR3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); also elsewhere on the board
/LPDDR4X memory/DDR_DQ3_B: U1301.1A7 (DDR_DQ3_B/DDR4_DQU1_B/LPDDR4_DQ3_B/DDR3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); also elsewhere on the board
/LPDDR4X memory/DDR_DQ4_A: U1301.M2 (DDR_DQ4_A/DDR4_DQL7_A/LPDDR4_DQ4_A/DDR3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); also elsewhere on the board
/LPDDR4X memory/DDR_DQ4_B: U1301.B13 (DDR_DQ4_B/DDR4_DQU0_B/LPDDR4_DQ4_B/DDR3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); also elsewhere on the board
/LPDDR4X memory/DDR_DQ5_A: U1301.K1 (DDR_DQ5_A/DDR4_DQL5_A/LPDDR4_DQ5_A/DDR3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); also elsewhere on the board
/LPDDR4X memory/DDR_DQ5_B: U1301.1A10 (DDR_DQ5_B/DDR4_DQU6_B/LPDDR4_DQ5_B/DDR3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); also elsewhere on the board
/LPDDR4X memory/DDR_DQ6_A: U1301.K2 (DDR_DQ6_A/DDR4_DQL3_A/LPDDR4_DQ6_A/DDR3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); also elsewhere on the board
/LPDDR4X memory/DDR_DQ6_B: U1301.1B9 (DDR_DQ6_B/DDR4_DQU4_B/LPDDR4_DQ6_B/DDR3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); also elsewhere on the board
/LPDDR4X memory/DDR_DQ7_A: U1301.1E1 (DDR_DQ7_A/DDR4_DQL1_A/LPDDR4_DQ7_A/DDR3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); also elsewhere on the board
/LPDDR4X memory/DDR_DQ7_B: U1301.1A9 (DDR_DQ7_B/DDR4_DQU2_B/LPDDR4_DQ7_B/DDR3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); also elsewhere on the board
/LPDDR4X memory/DDR_DQ8_A: U1301.P2 (DDR_DQ8_A/DDR4_DQU3_A/LPDDR4_DQ8_A/DDR3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); also elsewhere on the board
/LPDDR4X memory/DDR_DQ8_B: U1301.B19 (DDR_DQ8_B/DDR4_DQL0_B/LPDDR4_DQ8_B/DDR3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); also elsewhere on the board
/LPDDR4X memory/DDR_DQ9_A: U1301.R1 (DDR_DQ9_A/DDR4_DQU1_A/LPDDR4_DQ9_A/DDR3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); also elsewhere on the board
/LPDDR4X memory/DDR_DQ9_B: U1301.A19 (DDR_DQ9_B/DDR4_DQL2_B/LPDDR4_DQ9_B/DDR3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); also elsewhere on the board
/LPDDR4X memory/DDR_DQ10_A: U1301.R2 (DDR_DQ10_A/DDR4_DQU7_A/LPDDR4_DQ10_A/DD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); also elsewhere on the board
/LPDDR4X memory/DDR_DQ10_B: U1301.A20 (DDR_DQ10_B/DDR4_DQL4_B/LPDDR4_DQ10_B/DD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); also elsewhere on the board
/LPDDR4X memory/DDR_DQ11_A: U1301.T2 (DDR_DQ11_A/DDR4_DQU5_A/LPDDR4_DQ11_A/DD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); also elsewhere on the board
/LPDDR4X memory/DDR_DQ11_B: U1301.B20 (DDR_DQ11_B/DDR4_DQL6_B/LPDDR4_DQ11_B/DD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); also elsewhere on the board
/LPDDR4X memory/DDR_DQ12_A: U1301.M1 (DDR_DQ12_A/DDR4_DQU2_A/LPDDR4_DQ12_A/DD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); also elsewhere on the board
/LPDDR4X memory/DDR_DQ12_B: U1301.A15 (DDR_DQ12_B/DDR4_DQL7_B/LPDDR4_DQ12_B/DD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); also elsewhere on the board
/LPDDR4X memory/DDR_DQ13_A: U1301.1F2 (DDR_DQ13_A/DDR4_DQU4_A/LPDDR4_DQ13_A/DD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); also elsewhere on the board
/LPDDR4X memory/DDR_DQ13_B: U1301.B15 (DDR_DQ13_B/DDR4_DQL5_B/LPDDR4_DQ13_B/DD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); also elsewhere on the board
/LPDDR4X memory/DDR_DQ14_A: U1301.1F1 (DDR_DQ14_A/DDR4_DQU6_A/LPDDR4_DQ14_A/DD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); also elsewhere on the board
/LPDDR4X memory/DDR_DQ14_B: U1301.1C10 (DDR_DQ14_B/DDR4_DQL1_B/LPDDR4_DQ14_B/DD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); also elsewhere on the board
/LPDDR4X memory/DDR_DQ15_A: U1301.1G2 (DDR_DQ15_A/DDR4_DQU0_A/LPDDR4_DQ15_A/DD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); also elsewhere on the board
/LPDDR4X memory/DDR_DQ15_B: U1301.B16 (DDR_DQ15_B/DDR4_DQL3_B/LPDDR4_DQ15_B/DD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); also elsewhere on the board
/LPDDR4X memory/DDR_DQS0N_A: U1301.H1 (DDR_DQS0N_A/DDR4_DQSL_N_A/LPDDR4_DQS0N_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); also elsewhere on the board
/LPDDR4X memory/DDR_DQS0N_B: U1301.A12 (DDR_DQS0N_B/DDR4_DQSU_N_B/LPDDR4_DQS0N_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); also elsewhere on the board
/LPDDR4X memory/DDR_DQS0P_A: U1301.H2 (DDR_DQS0P_A/DDR4_DQSL_P_A/LPDDR4_DQS0P_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); also elsewhere on the board
/LPDDR4X memory/DDR_DQS0P_B: U1301.A13 (DDR_DQS0P_B/DDR4_DQSU_P_B/LPDDR4_DQS0P_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); also elsewhere on the board
/LPDDR4X memory/DDR_DQS1N_A: U1301.N2 (DDR_DQS1N_A/DDR4_DQSU_N_A/LPDDR4_DQS1N_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); also elsewhere on the board
/LPDDR4X memory/DDR_DQS1N_B: U1301.B17 (DDR_DQS1N_B/DDR4_DQSL_N_B/LPDDR4_DQS1N_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); also elsewhere on the board
/LPDDR4X memory/DDR_DQS1P_A: U1301.N1 (DDR_DQS1P_A/DDR4_DQSU_P_A/LPDDR4_DQS1P_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); also elsewhere on the board
/LPDDR4X memory/DDR_DQS1P_B: U1301.A17 (DDR_DQS1P_B/DDR4_DQSL_P_B/LPDDR4_DQS1P_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); also elsewhere on the board
/LPDDR4X memory/DDR_ODT0_CA_A: U1301.E2 (DDR4_A8/LPDDR4_ODT0_CA_A/DDR3_A6/LPDDR3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); also elsewhere on the board
/LPDDR4X memory/DDR_ODT0_CA_B: U1301.A10 (DDR4_A7/LPDDR4_ODT0_CA_B/DDR3_A8/-/AC7); also elsewhere on the board
/LPDDR4X memory/DDR_RESET_N: U1301.1C7 (DDR4_RESETn/LPDDR4_RESETn/DDR3_RESETn/A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); also elsewhere on the board
/SoC/SoC: LPDDR4X interface/DDR_RZQ: R1320.2, U1301.1F3 (DDR_RZQ)
vcc_ddr: R1320.1; also elsewhere on the board

Notes on the sheet:
DDR calibration
Notes 1. Function: RK3566 DDR PHY, channels A and B and the common unit (DS 1.1 Table 2-1). 2. Absent state: not applicable (blk.lpddr4x is never omitted). 3. Every LPDDR4X ball goes to the same-named DRAM ball in the Rockchip template order, which may not be swapped (HDG 1.1 p. 22; pinout v1 CSV).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
Rails

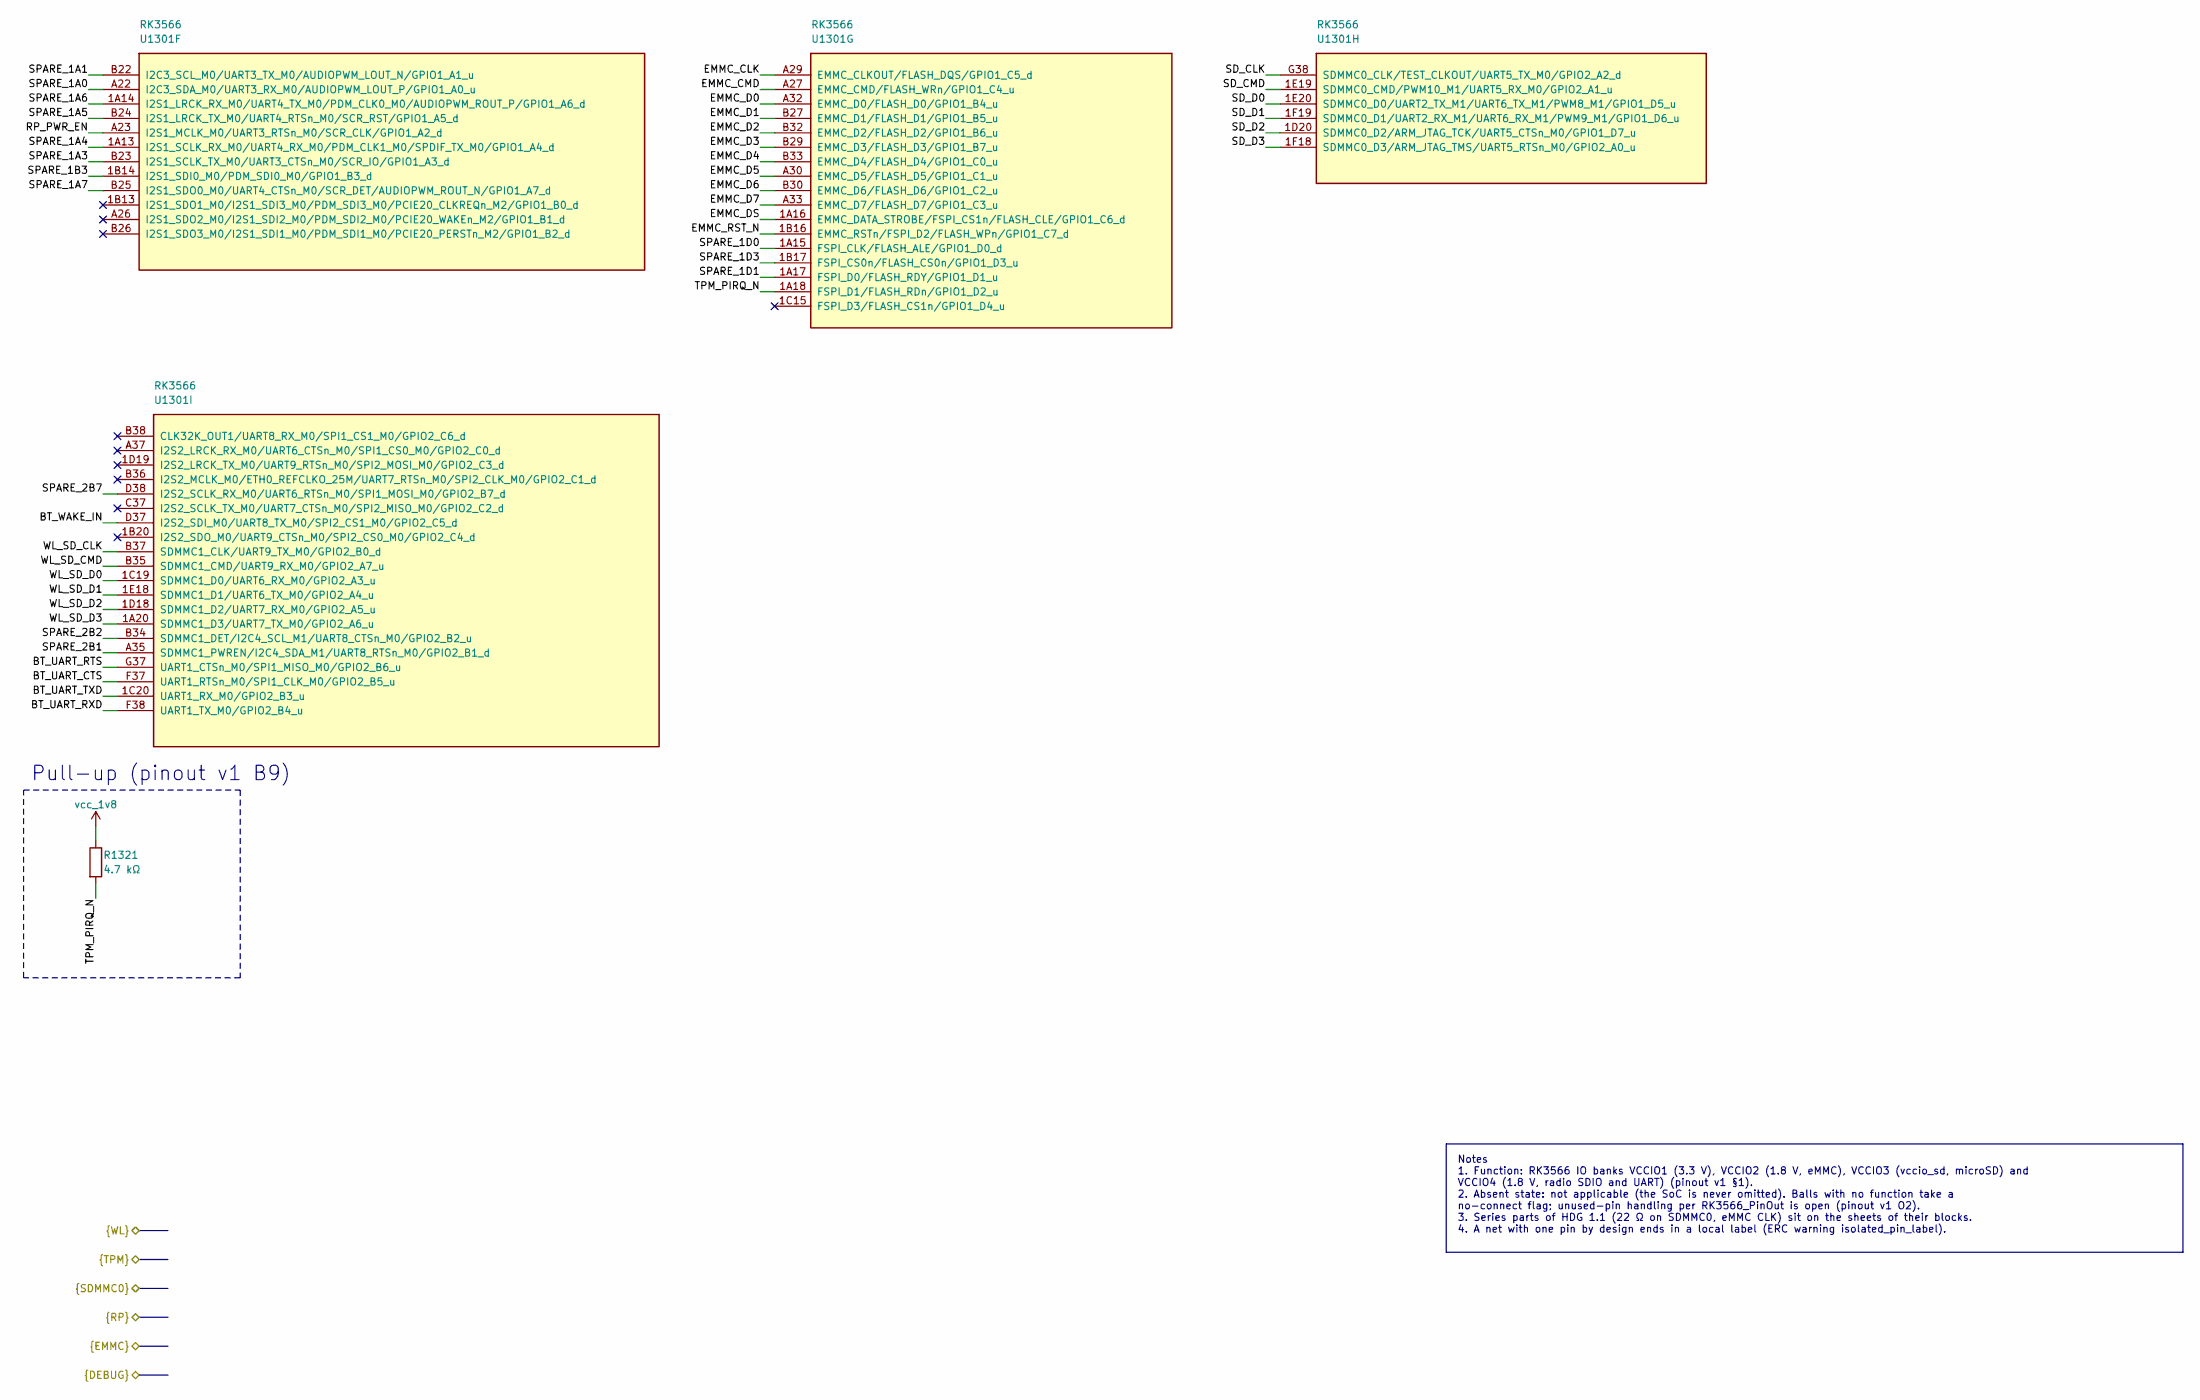
[picture p57: schematic soc-vccio-a.kicad_sch, SoC: VCCIO1 to VCCIO4]

Parts:
R1321: 4.7 kΩ; R_0201_0603Metric; MPN RC0201FR-074K7L
U1301: RK3566; Rockchip_FCCSP-565L_15.5x14.4mm_P0.4mm_P0.65mm_Ball0.25mm_P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; MPN RK3566

Connections:
/BT_UART_CTS: U1301.F37 (UART1_RTSn_M0/SPI1_CLK_M0/GPIO2_B5_u); also elsewhere on the board
/BT_UART_RTS: U1301.G37 (UART1_CTSn_M0/SPI1_MISO_M0/GPIO2_B6_u); also elsewhere on the board
/BT_UART_RXD: U1301.F38 (UART1_TX_M0/GPIO2_B4_u); also elsewhere on the board
/BT_UART_TXD: U1301.1C20 (UART1_RX_M0/GPIO2_B3_u); also elsewhere on the board
/BT_WAKE_IN: U1301.D37 (I2S2_SDI_M0/UART8_TX_M0/SPI2_CS1_M0/GPI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); also elsewhere on the board
/EMMC_CLK: U1301.A29 (EMMC_CLKOUT/FLASH_DQS/GPIO1_C5_d); also elsewhere on the board
/EMMC_CMD: U1301.A27 (EMMC_CMD/FLASH_WRn/GPIO1_C4_u); also elsewhere on the board
/EMMC_D0: U1301.A32 (EMMC_D0/FLASH_D0/GPIO1_B4_u); also elsewhere on the board
/EMMC_D1: U1301.B27 (EMMC_D1/FLASH_D1/GPIO1_B5_u); also elsewhere on the board
/EMMC_D2: U1301.B32 (EMMC_D2/FLASH_D2/GPIO1_B6_u); also elsewhere on the board
/EMMC_D3: U1301.B29 (EMMC_D3/FLASH_D3/GPIO1_B7_u); also elsewhere on the board
/EMMC_D4: U1301.B33 (EMMC_D4/FLASH_D4/GPIO1_C0_u); also elsewhere on the board
/EMMC_D5: U1301.A30 (EMMC_D5/FLASH_D5/GPIO1_C1_u); also elsewhere on the board
/EMMC_D6: U1301.B30 (EMMC_D6/FLASH_D6/GPIO1_C2_u); also elsewhere on the board
/EMMC_D7: U1301.A33 (EMMC_D7/FLASH_D7/GPIO1_C3_u); also elsewhere on the board
/EMMC_DS: U1301.1A16 (EMMC_DATA_STROBE/FSPI_CS1n/FLASH_CLE/GP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); also elsewhere on the board
/EMMC_RST_N: U1301.1B16 (EMMC_RSTn/FSPI_D2/FLASH_WPn/GPIO1_C7_d); also elsewhere on the board
/RP_PWR_EN: U1301.A23 (I2S1_MCLK_M0/UART3_RTSn_M0/SCR_CLK/GPIO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); also elsewhere on the board
/SD_CLK: U1301.G38 (SDMMC0_CLK/TEST_CLKOUT/UART5_TX_M0/GPIO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); also elsewhere on the board
/SD_CMD: U1301.1E19 (SDMMC0_CMD/PWM10_M1/UART5_RX_M0/GPIO2_A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); also elsewhere on the board
/SD_D0: U1301.1E20 (SDMMC0_D0/UART2_TX_M1/UART6_TX_M1/PWM8_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); also elsewhere on the board
/SD_D1: U1301.1F19 (SDMMC0_D1/UART2_RX_M1/UART6_RX_M1/PWM9_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); also elsewhere on the board
/SD_D2: U1301.1D20 (SDMMC0_D2/ARM_JTAG_TCK/UART5_CTSn_M0/GP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); also elsewhere on the board
/SD_D3: U1301.1F18 (SDMMC0_D3/ARM_JTAG_TMS/UART5_RTSn_M0/GP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); also elsewhere on the board
/SPARE_1A0: U1301.A22 (I2C3_SDA_M0/UART3_RX_M0/AUDIOPWM_LOUT_P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); also elsewhere on the board
/SPARE_1A1: U1301.B22 (I2C3_SCL_M0/UART3_TX_M0/AUDIOPWM_LOUT_N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); also elsewhere on the board
/SPARE_1A3: U1301.B23 (I2S1_SCLK_TX_M0/UART3_CTSn_M0/SCR_IO/GP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); also elsewhere on the board
/SPARE_1A4: U1301.1A13 (I2S1_SCLK_RX_M0/UART4_RX_M0/PDM_CLK1_M0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); also elsewhere on the board
/SPARE_1A5: U1301.B24 (I2S1_LRCK_TX_M0/UART4_RTSn_M0/SCR_RST/G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); also elsewhere on the board
/SPARE_1A6: U1301.1A14 (I2S1_LRCK_RX_M0/UART4_TX_M0/PDM_CLK0_M0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); also elsewhere on the board
/SPARE_1A7: U1301.B25 (I2S1_SDO0_M0/UART4_CTSn_M0/SCR_DET/AUDI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); also elsewhere on the board
/SPARE_1B3: U1301.1B14 (I2S1_SDI0_M0/PDM_SDI0_M0/GPIO1_B3_d); also elsewhere on the board
/SPARE_1D0: U1301.1A15 (FSPI_CLK/FLASH_ALE/GPIO1_D0_d); also elsewhere on the board
/SPARE_1D1: U1301.1A17 (FSPI_D0/FLASH_RDY/GPIO1_D1_u); also elsewhere on the board
/SPARE_1D3: U1301.1B17 (FSPI_CS0n/FLASH_CS0n/GPIO1_D3_u); also elsewhere on the board
/SPARE_2B1: U1301.A35 (SDMMC1_PWREN/I2C4_SDA_M1/UART8_RTSn_M0/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); also elsewhere on the board
/SPARE_2B2: U1301.B34 (SDMMC1_DET/I2C4_SCL_M1/UART8_CTSn_M0/GP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); also elsewhere on the board
/SoC/SoC: VCCIO1 to VCCIO4/SPARE_2B7: U1301.D38 (I2S2_SCLK_RX_M0/UART6_RTSn_M0/SPI1_MOSI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)
/TPM_PIRQ_N: R1321.2, U1301.1A18 (FSPI_D1/FLASH_RDn/GPIO1_D2_u); also elsewhere on the board
/WL_SD_CLK: U1301.B37 (SDMMC1_CLK/UART9_TX_M0/GPIO2_B0_d); also elsewhere on the board
/WL_SD_CMD: U1301.B35 (SDMMC1_CMD/UART9_RX_M0/GPIO2_A7_u); also elsewhere on the board
/WL_SD_D0: U1301.1C19 (SDMMC1_D0/UART6_RX_M0/GPIO2_A3_u); also elsewhere on the board
/WL_SD_D1: U1301.1E18 (SDMMC1_D1/UART6_TX_M0/GPIO2_A4_u); also elsewhere on the board
/WL_SD_D2: U1301.1D18 (SDMMC1_D2/UART7_RX_M0/GPIO2_A5_u); also elsewhere on the board
/WL_SD_D3: U1301.1A20 (SDMMC1_D3/UART7_TX_M0/GPIO2_A6_u); also elsewhere on the board
vcc_1v8: R1321.1; also elsewhere on the board

Notes on the sheet:
Pull-up (pinout v1 B9)
Notes 1. Function: RK3566 IO banks VCCIO1 (3.3 V), VCCIO2 (1.8 V, eMMC), VCCIO3 (vccio_sd, microSD) and VCCIO4 (1.8 V, radio SDIO and UART) (pinout v1 §1). 2. Absent state: not applicable (the SoC is never omitted). Balls with no function take a no-connect flag; unused-pin handling per RK3566_PinOu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
