opendap-project/t1/board/hardware/t1-main-board/t1-main-board.kicad_pcb

## KiCad design board/hardware/t1-main-board/t1-main-board.kicad_pcb (continued)

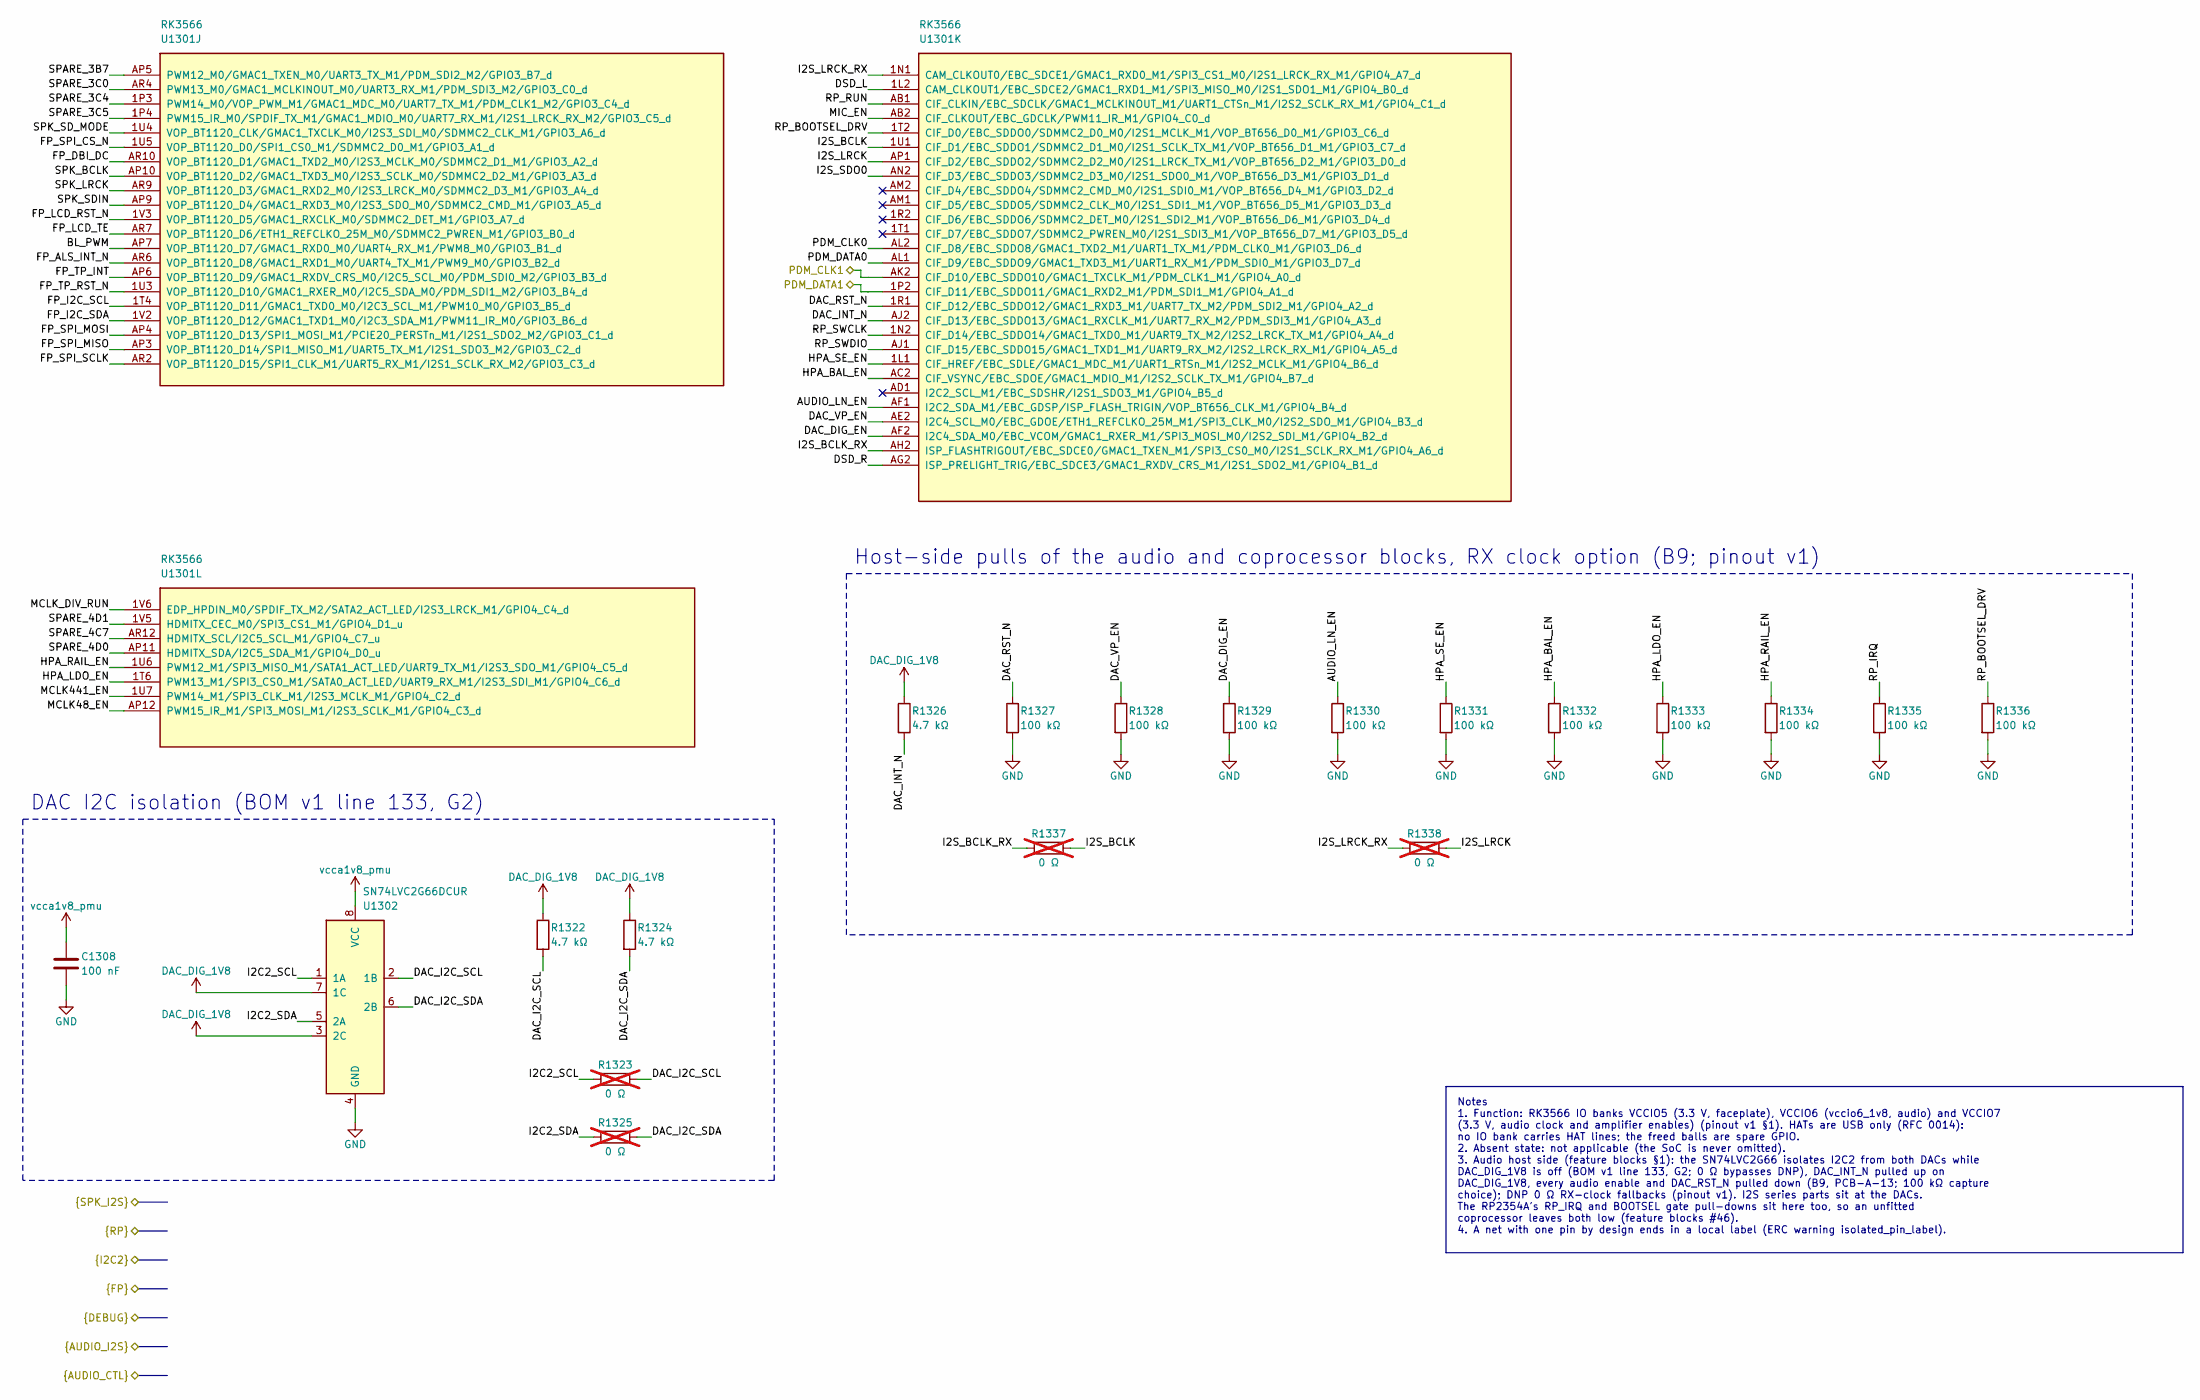
[picture p58: schematic soc-vccio-b.kicad_sch, SoC: VCCIO5 to VCCIO7]

Parts:
C1308: 100 nF; C_0201_0603Metric; MPN GRM033R61A104KE15D
R1322, R1324, R1326: 4.7 kΩ; R_0201_0603Metric; MPN RC0201FR-074K7L
R1323, R1325, R1337, R1338: 0 Ω; R_0402_1005Metric; MPN RC0402JR-070RL; not fitted
R1327, R1328, R1329, R1330, R1331, R1332, R1333, R1334, R1335, R1336: 100 kΩ; R_0201_0603Metric; MPN RC0201FR-07100KL
U1301: RK3566; Rockchip_FCCSP-565L_15.5x14.4mm_P0.4mm_P0.65mm_Ball0.25mm_P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; MPN RK3566
U1302: SN74LVC2G66DCUR; Texas_DCU0008A_VSSOP-8_2.3x2mm_P0.5mm; MPN SN74LVC2G66DCUR

Connections:
/AUDIO_LN_EN: R1330.1, U1301.AF1 (I2C2_SDA_M1/EBC_GDSP/ISP_FLASH_TRIGIN/V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); also elsewhere on the board
/BL_PWM: U1301.AP7 (VOP_BT1120_D7/GMAC1_RXD0_M0/UART4_RX_M1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); also elsewhere on the board
/DAC_DIG_EN: R1329.1, U1301.AF2 (I2C4_SDA_M0/EBC_VCOM/GMAC1_RXER_M1/SPI3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); also elsewhere on the board
/DAC_I2C_SCL: R1322.2, R1323.2, U1302.2 (1B); also elsewhere on the board
/DAC_I2C_SDA: R1324.2, R1325.2, U1302.6 (2B); also elsewhere on the board
/DAC_INT_N: R1326.2, U1301.AJ2 (CIF_D13/EBC_SDDO13/GMAC1_RXCLK_M1/UART7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); also elsewhere on the board
/DAC_RST_N: R1327.1, U1301.1R1 (CIF_D12/EBC_SDDO12/GMAC1_RXD3_M1/UART7_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); also elsewhere on the board
/DAC_VP_EN: R1328.1, U1301.AE2 (I2C4_SCL_M0/EBC_GDOE/ETH1_REFCLKO_25M_M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); also elsewhere on the board
/DSD_L: U1301.1L2 (CAM_CLKOUT1/EBC_SDCE2/GMAC1_RXD1_M1/SPI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); also elsewhere on the board
/DSD_R: U1301.AG2 (ISP_PRELIGHT_TRIG/EBC_SDCE3/GMAC1_RXDV_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); also elsewhere on the board
/FP_ALS_INT_N: U1301.AR6 (VOP_BT1120_D8/GMAC1_RXD1_M0/UART4_TX_M1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); also elsewhere on the board
/FP_DBI_DC: U1301.AR10 (VOP_BT1120_D1/GMAC1_TXD2_M0/I2S3_MCLK_M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); also elsewhere on the board
/FP_I2C_SCL: U1301.1T4 (VOP_BT1120_D11/GMAC1_TXD0_M0/I2C3_SCL_M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); also elsewhere on the board
/FP_I2C_SDA: U1301.1V2 (VOP_BT1120_D12/GMAC1_TXD1_M0/I2C3_SDA_M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); also elsewhere on the board
/FP_LCD_RST_N: U1301.1V3 (VOP_BT1120_D5/GMAC1_RXCLK_M0/SDMMC2_DET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); also elsewhere on the board
/FP_LCD_TE: U1301.AR7 (VOP_BT1120_D6/ETH1_REFCLKO_25M_M0/SDMMC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); also elsewhere on the board
/FP_SPI_CS_N: U1301.1U5 (VOP_BT1120_D0/SPI1_CS0_M1/SDMMC2_D0_M1/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); also elsewhere on the board
/FP_SPI_MISO: U1301.AP3 (VOP_BT1120_D14/SPI1_MISO_M1/UART5_TX_M1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); also elsewhere on the board
/FP_SPI_MOSI: U1301.AP4 (VOP_BT1120_D13/SPI1_MOSI_M1/PCIE20_PERS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); also elsewhere on the board
/FP_SPI_SCLK: U1301.AR2 (VOP_BT1120_D15/SPI1_CLK_M1/UART5_RX_M1/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); also elsewhere on the board
/FP_TP_INT: U1301.AP6 (VOP_BT1120_D9/GMAC1_RXDV_CRS_M0/I2C5_SC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); also elsewhere on the board
/FP_TP_RST_N: U1301.1U3 (VOP_BT1120_D10/GMAC1_RXER_M0/I2C5_SDA_M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); also elsewhere on the board
/HPA_BAL_EN: R1332.1, U1301.AC2 (CIF_VSYNC/EBC_SDOE/GMAC1_MDIO_M1/I2S2_S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); also elsewhere on the board
/HPA_LDO_EN: R1333.1, U1301.1T6 (PWM13_M1/SPI3_CS0_M1/SATA0_ACT_LED/UART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); also elsewhere on the board
/HPA_RAIL_EN: R1334.1, U1301.1U6 (PWM12_M1/SPI3_MISO_M1/SATA1_ACT_LED/UAR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); also elsewhere on the board
/HPA_SE_EN: R1331.1, U1301.1L1 (CIF_HREF/EBC_SDLE/GMAC1_MDC_M1/UART1_RT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); also elsewhere on the board
/I2C2_SCL: R1323.1, U1302.1 (1A); also elsewhere on the board
/I2C2_SDA: R1325.1, U1302.5 (2A); also elsewhere on the board
/I2S_BCLK: R1337.2, U1301.1U1 (CIF_D1/EBC_SDDO1/SDMMC2_D1_M0/I2S1_SCLK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); also elsewhere on the board
/I2S_LRCK: R1338.2, U1301.AP1 (CIF_D2/EBC_SDDO2/SDMMC2_D2_M0/I2S1_LRCK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); also elsewhere on the board
/I2S_SDO0: U1301.AN2 (CIF_D3/EBC_SDDO3/SDMMC2_D3_M0/I2S1_SDO0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); also elsewhere on the board
/MCLK48_EN: U1301.AP12 (PWM15_IR_M1/SPI3_MOSI_M1/I2S3_SCLK_M1/G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); also elsewhere on the board
/MCLK441_EN: U1301.1U7 (PWM14_M1/SPI3_CLK_M1/I2S3_MCLK_M1/GPIO4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); also elsewhere on the board
/MCLK_DIV_RUN: U1301.1V6 (EDP_HPDIN_M0/SPDIF_TX_M2/SATA2_ACT_LED/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); also elsewhere on the board
/MIC_EN: U1301.AB2 (CIF_CLKOUT/EBC_GDCLK/PWM11_IR_M1/GPIO4_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); also elsewhere on the board
/PDM_CLK0: U1301.AL2 (CIF_D8/EBC_SDDO8/GMAC1_TXD2_M1/UART1_TX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); also elsewhere on the board
/PDM_CLK1: U1301.AK2 (CIF_D10/EBC_SDDO10/GMAC1_TXCLK_M1/PDM_C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); also elsewhere on the board
/PDM_DATA0: U1301.AL1 (CIF_D9/EBC_SDDO9/GMAC1_TXD3_M1/UART1_RX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); also elsewhere on the board
/PDM_DATA1: U1301.1P2 (CIF_D11/EBC_SDDO11/GMAC1_RXD2_M1/PDM_SD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); also elsewhere on the board
/RP_BOOTSEL_DRV: R1336.1, U1301.1T2 (CIF_D0/EBC_SDDO0/SDMMC2_D0_M0/I2S1_MCLK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); also elsewhere on the board
/RP_IRQ: R1335.1; also elsewhere on the board
/RP_RUN: U1301.AB1 (CIF_CLKIN/EBC_SDCLK/GMAC1_MCLKINOUT_M1/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); also elsewhere on the board
/RP_SWCLK: U1301.1N2 (CIF_D14/EBC_SDDO14/GMAC1_TXD0_M1/UART9_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); also elsewhere on the board
/RP_SWDIO: U1301.AJ1 (CIF_D15/EBC_SDDO15/GMAC1_TXD1_M1/UART9_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); also elsewhere on the board
/SPARE_3B7: U1301.AP5 (PWM12_M0/GMAC1_TXEN_M0/UART3_TX_M1/PDM_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); also elsewhere on the board
/SPARE_3C0: U1301.AR4 (PWM13_M0/GMAC1_MCLKINOUT_M0/UART3_RX_M1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); also elsewhere on the board
/SPARE_3C4: U1301.1P3 (PWM14_M0/VOP_PWM_M1/GMAC1_MDC_M0/UART7_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); also elsewhere on the board
/SPARE_3C5: U1301.1P4 (PWM15_IR_M0/SPDIF_TX_M1/GMAC1_MDIO_M0/U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); also elsewhere on the board
/SPARE_4C7: U1301.AR12 (HDMITX_SCL/I2C5_SCL_M1/GPIO4_C7_u); also elsewhere on the board
/SPARE_4D0: U1301.AP11 (HDMITX_SDA/I2C5_SDA_M1/GPIO4_D0_u); also elsewhere on the board
/SPARE_4D1: U1301.1V5 (HDMITX_CEC_M0/SPI3_CS1_M1/GPIO4_D1_u); also elsewhere on the board
/SPK_BCLK: U1301.AP10 (VOP_BT1120_D2/GMAC1_TXD3_M0/I2S3_SCLK_M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); also elsewhere on the board
/SPK_LRCK: U1301.AR9 (VOP_BT1120_D3/GMAC1_RXD2_M0/I2S3_LRCK_M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); also elsewhere on the board
/SPK_SDIN: U1301.AP9 (VOP_BT1120_D4/GMAC1_RXD3_M0/I2S3_SDO_M0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); also elsewhere on the board
/SPK_SD_MODE: U1301.1U4 (VOP_BT1120_CLK/GMAC1_TXCLK_M0/I2S3_SDI_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); also elsewhere on the board
/SoC/SoC: VCCIO5 to VCCIO7/I2S_BCLK_RX: R1337.1, U1301.AH2 (ISP_FLASHTRIGOUT/EBC_SDCE0/GMAC1_TXEN_M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)
/SoC/SoC: VCCIO5 to VCCIO7/I2S_LRCK_RX: R1338.1, U1301.1N1 (CAM_CLKOUT0/EBC_SDCE1/GMAC1_RXD0_M1/SPI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)
DAC_DIG_1V8: R1322.1, R1324.1, R1326.1, U1302.3 (2C), U1302.7 (1C); also elsewhere on the board
GND: C1308.2, R1327.2, R1328.2, R1329.2, R1330.2, R1331.2, R1332.2, R1333.2, R1334.2, R1335.2, R1336.2, U1302.4 (GND); also elsewhere on the board
vcca1v8_pmu: C1308.1, U1302.8 (VCC); also elsewhere on the board

Notes on the sheet:
DAC I2C isolation (BOM v1 line 133, G2)
Host-side pulls of the audio and coprocessor blocks, RX clock option (B9; pinout v1)
Notes 1. Function: RK3566 IO banks VCCIO5 (3.3 V, faceplate), VCCIO6 (vccio6_1v8, audio) and VCCIO7 (3.3 V, audio clock and amplifier enables) (pinout v1 §1). HATs are USB only (RFC 0014): no IO bank carries HAT lines; the freed balls are spare GPIO. 2. Absent state: not applicable (the SoC is neve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

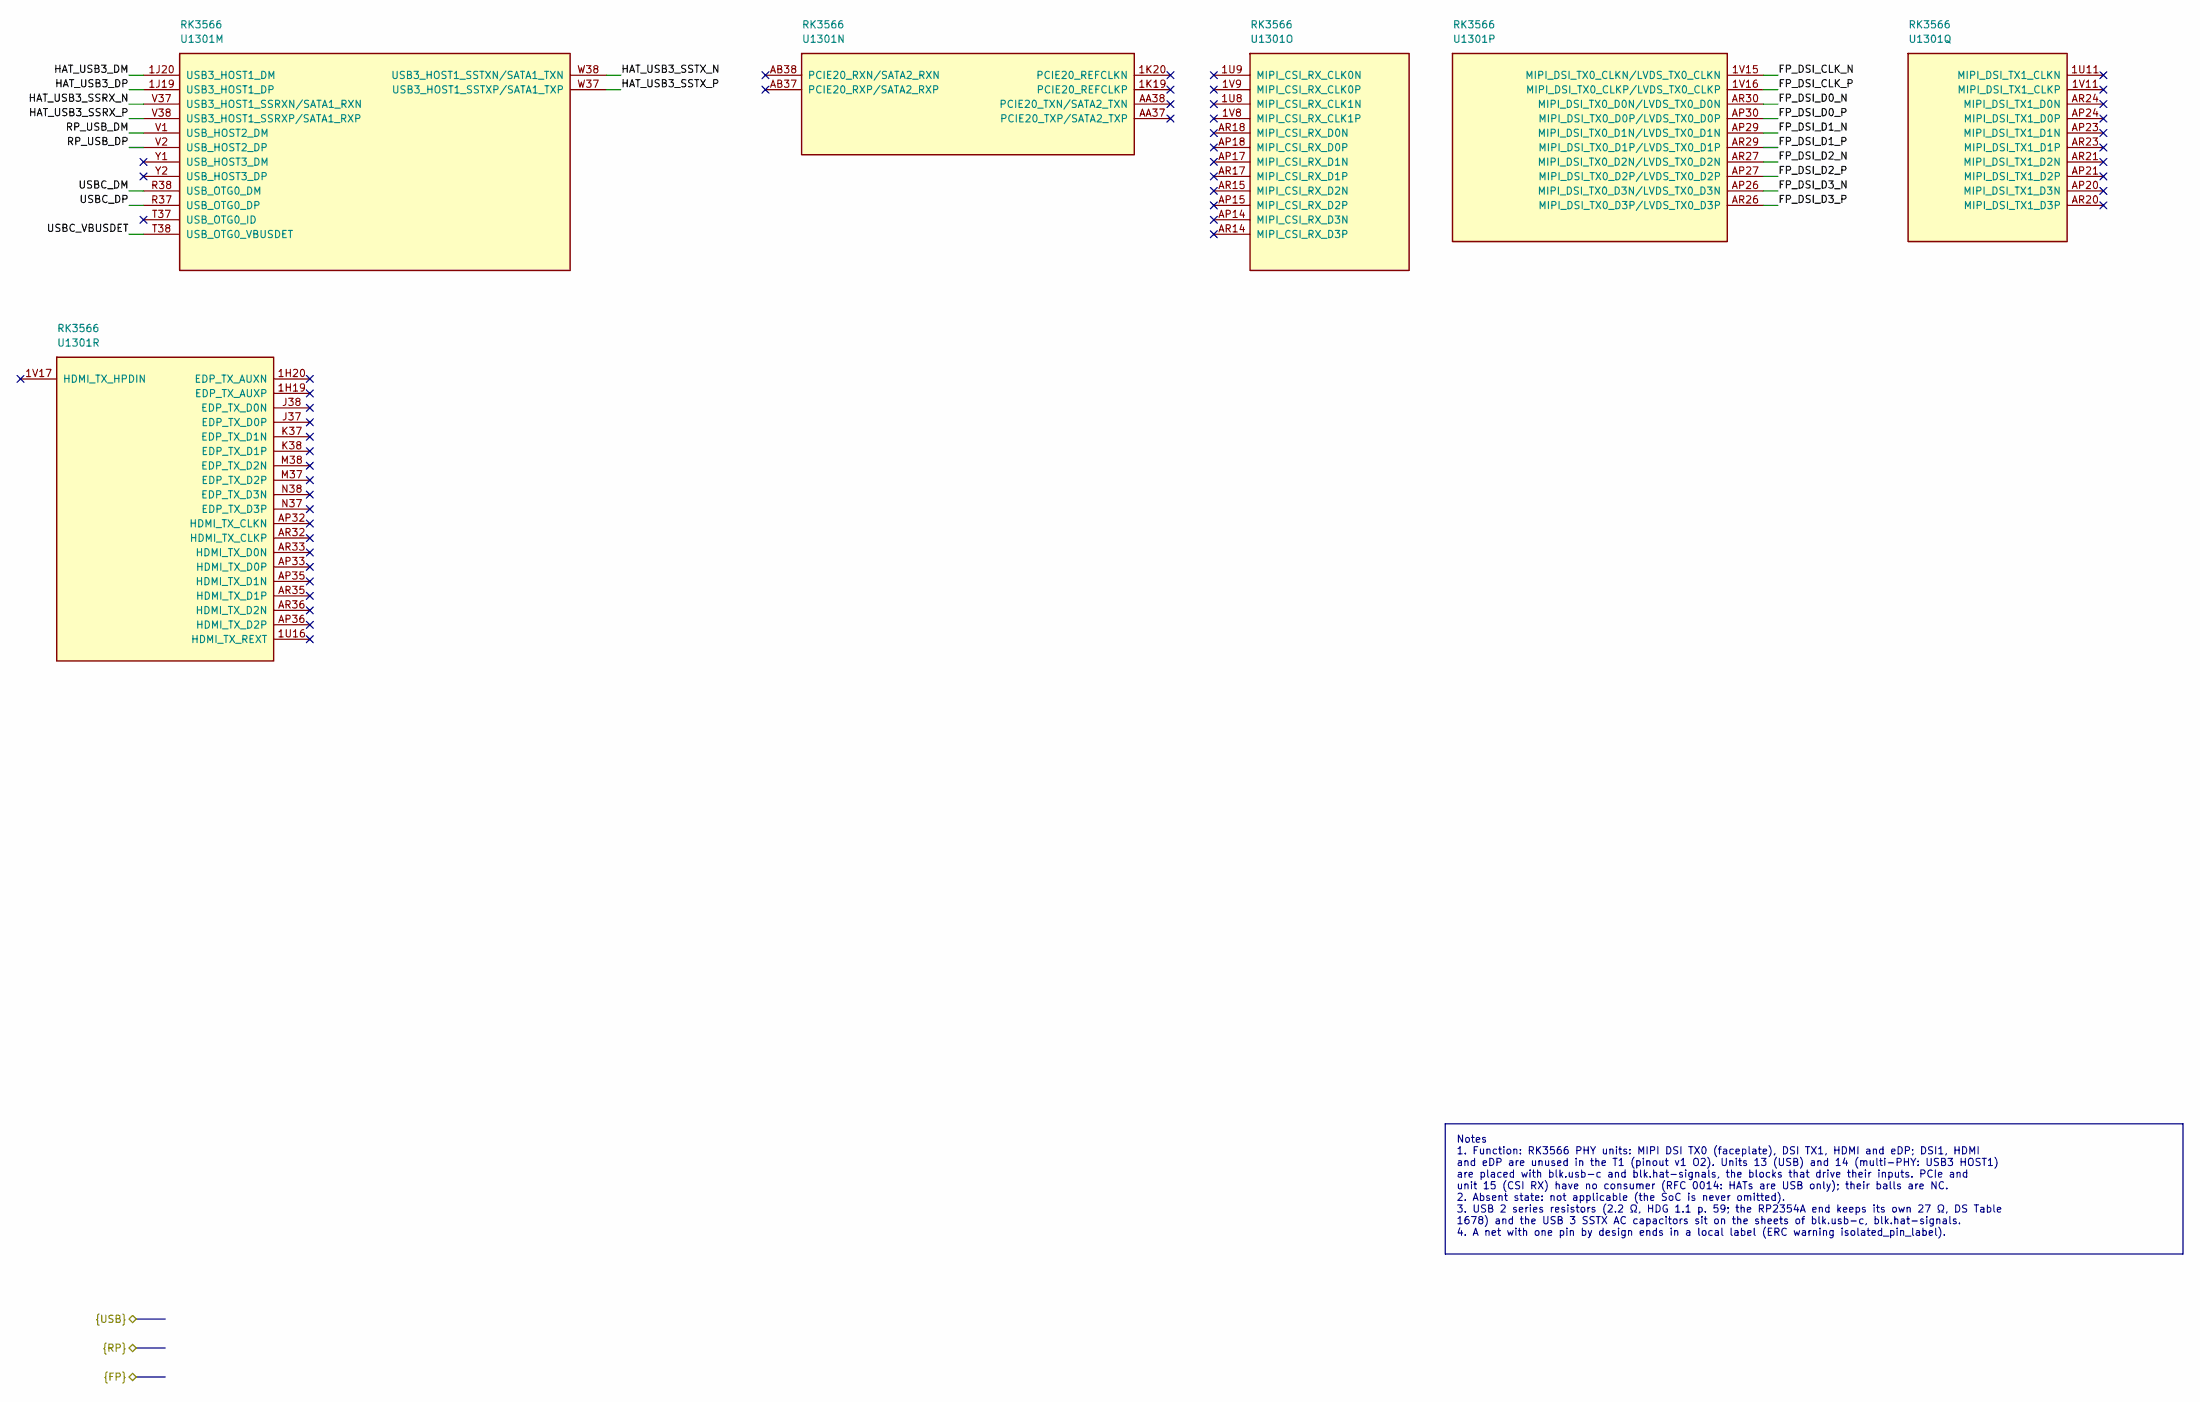
[picture p59: schematic soc-phy.kicad_sch, SoC: USB, PCIe, MIPI, HDMI and eDP PHYs]

Parts:
U1301: RK3566; Rockchip_FCCSP-565L_15.5x14.4mm_P0.4mm_P0.65mm_Ball0.25mm_P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; MPN RK3566

Connections:
/FP_DSI_CLK_N: U1301.1V15 (MIPI_DSI_TX0_CLKN/LVDS_TX0_CLKN); also elsewhere on the board
/FP_DSI_CLK_P: U1301.1V16 (MIPI_DSI_TX0_CLKP/LVDS_TX0_CLKP); also elsewhere on the board
/FP_DSI_D0_N: U1301.AR30 (MIPI_DSI_TX0_D0N/LVDS_TX0_D0N); also elsewhere on the board
/FP_DSI_D0_P: U1301.AP30 (MIPI_DSI_TX0_D0P/LVDS_TX0_D0P); also elsewhere on the board
/FP_DSI_D1_N: U1301.AP29 (MIPI_DSI_TX0_D1N/LVDS_TX0_D1N); also elsewhere on the board
/FP_DSI_D1_P: U1301.AR29 (MIPI_DSI_TX0_D1P/LVDS_TX0_D1P); also elsewhere on the board
/FP_DSI_D2_N: U1301.AR27 (MIPI_DSI_TX0_D2N/LVDS_TX0_D2N); also elsewhere on the board
/FP_DSI_D2_P: U1301.AP27 (MIPI_DSI_TX0_D2P/LVDS_TX0_D2P); also elsewhere on the board
/FP_DSI_D3_N: U1301.AP26 (MIPI_DSI_TX0_D3N/LVDS_TX0_D3N); also elsewhere on the board
/FP_DSI_D3_P: U1301.AR26 (MIPI_DSI_TX0_D3P/LVDS_TX0_D3P); also elsewhere on the board
/HAT_USB3_DM: U1301.1J20 (USB3_HOST1_DM); also elsewhere on the board
/HAT_USB3_DP: U1301.1J19 (USB3_HOST1_DP); also elsewhere on the board
/HAT_USB3_SSRX_N: U1301.V37 (USB3_HOST1_SSRXN/SATA1_RXN); also elsewhere on the board
/HAT_USB3_SSRX_P: U1301.V38 (USB3_HOST1_SSRXP/SATA1_RXP); also elsewhere on the board
/HAT_USB3_SSTX_N: U1301.W38 (USB3_HOST1_SSTXN/SATA1_TXN); also elsewhere on the board
/HAT_USB3_SSTX_P: U1301.W37 (USB3_HOST1_SSTXP/SATA1_TXP); also elsewhere on the board
/RP_USB_DM: U1301.V1 (USB_HOST2_DM); also elsewhere on the board
/RP_USB_DP: U1301.V2 (USB_HOST2_DP); also elsewhere on the board
/USBC_DM: U1301.R38 (USB_OTG0_DM); also elsewhere on the board
/USBC_DP: U1301.R37 (USB_OTG0_DP); also elsewhere on the board
/USBC_VBUSDET: U1301.T38 (USB_OTG0_VBUSDET); also elsewhere on the board

Notes on the sheet:
Notes 1. Function: RK3566 PHY units: MIPI DSI TX0 (faceplate), DSI TX1, HDMI and eDP; DSI1, HDMI and eDP are unused in the T1 (pinout v1 O2). Units 13 (USB) and 14 (multi-PHY: USB3 HOST1) are placed with blk.usb-c and blk.hat-signals, the blocks that drive their inputs. PCIe and unit 15 (CSI RX) ha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

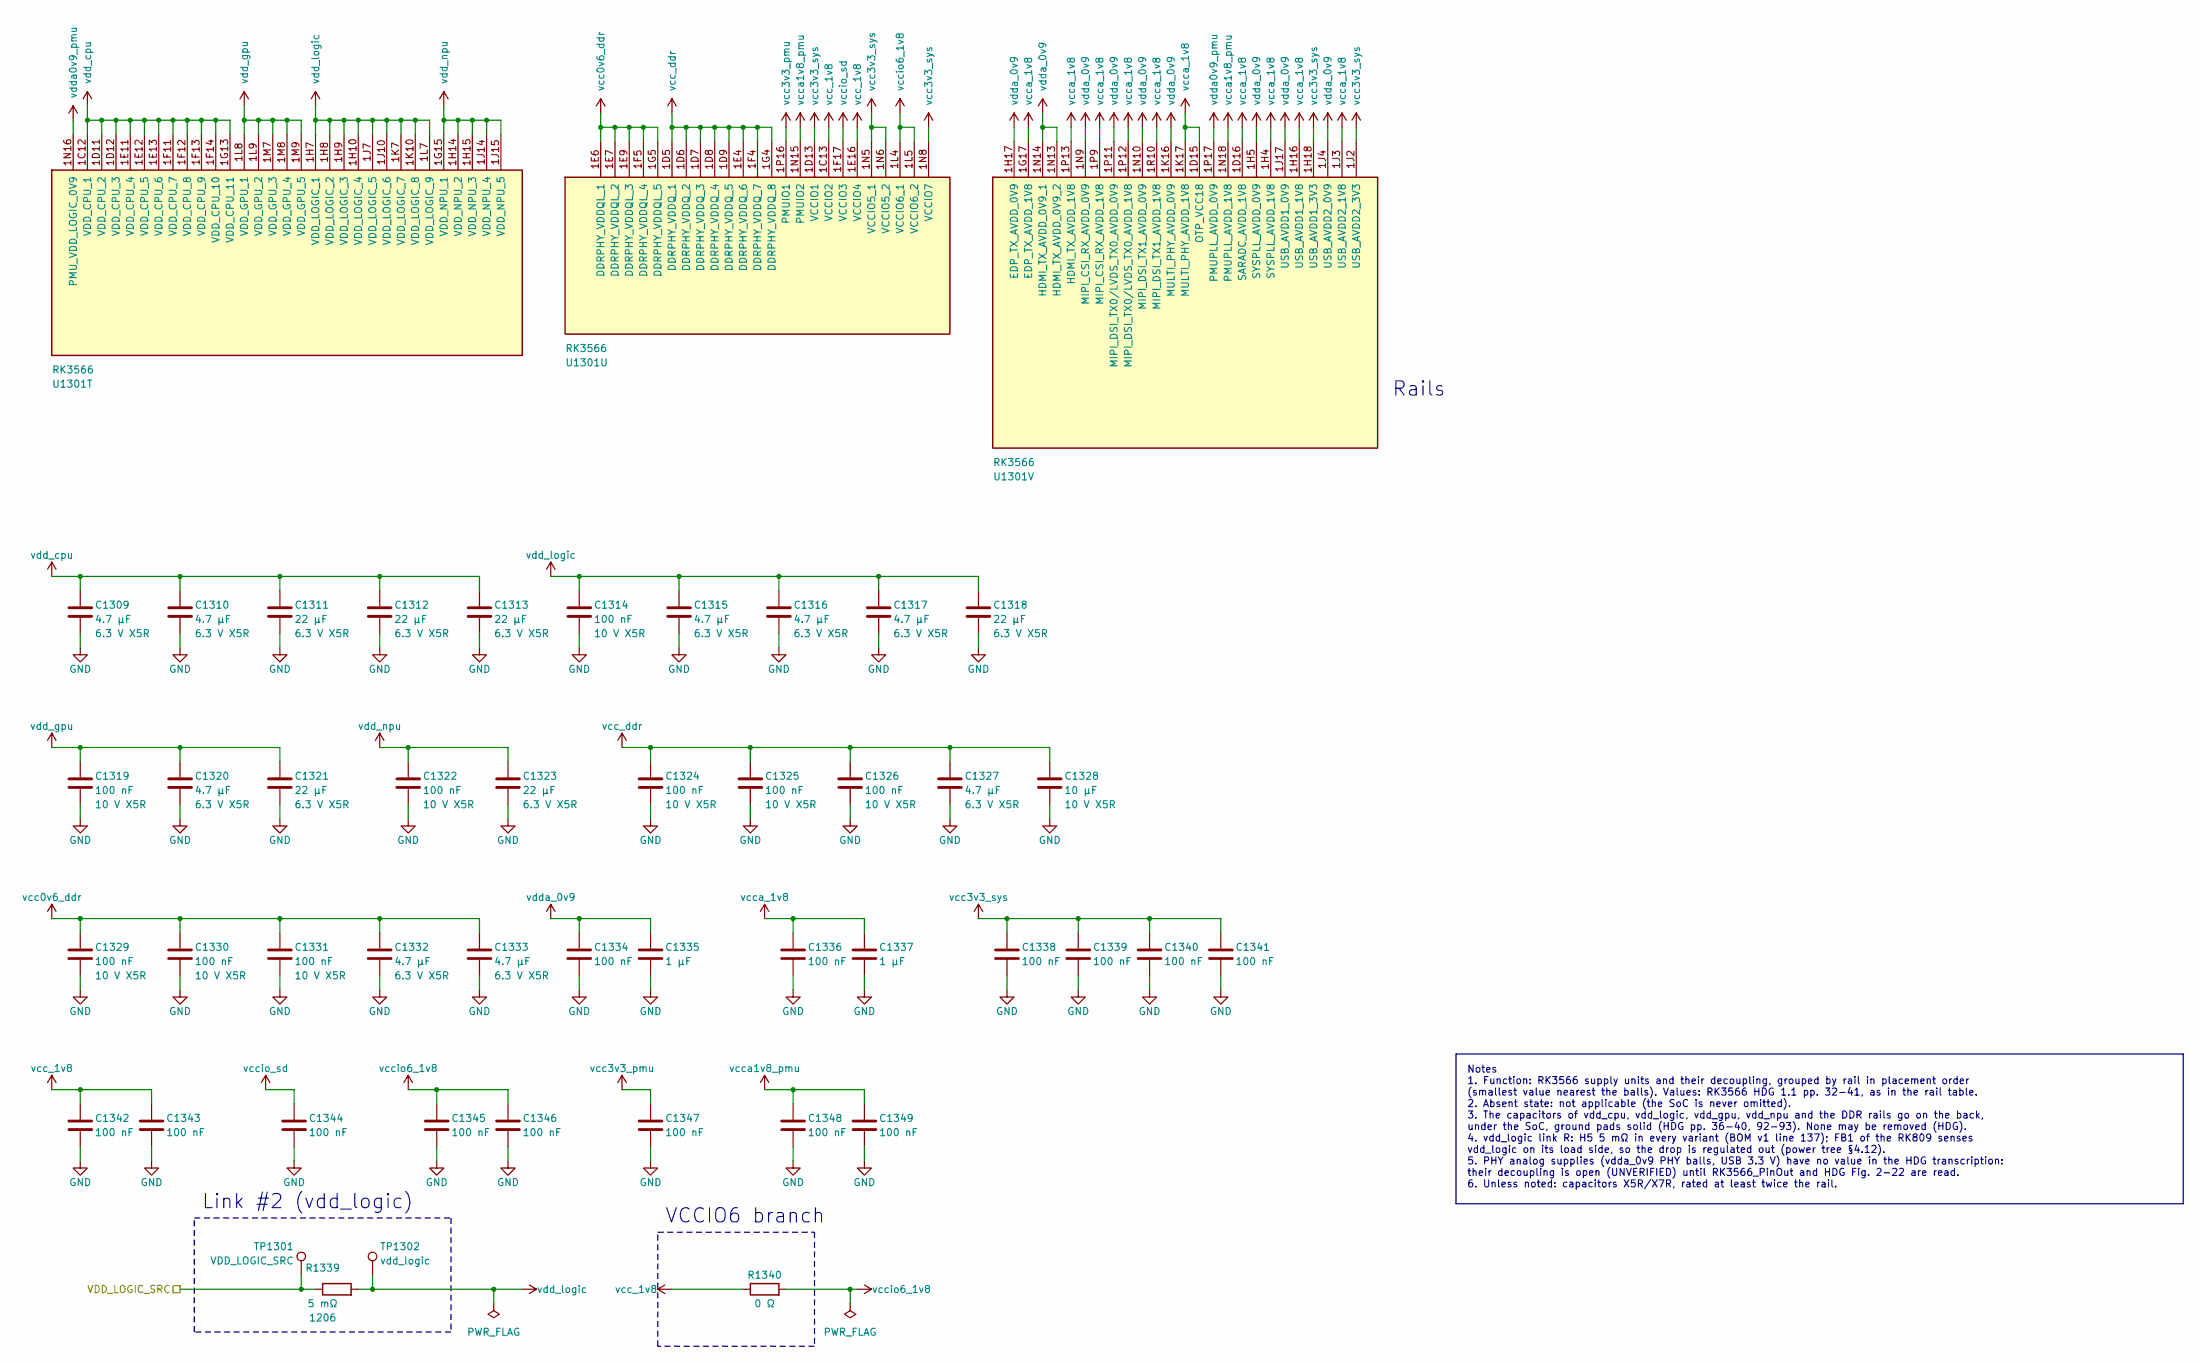
[picture p60: schematic soc-power.kicad_sch, SoC: supplies and decoupling]

Parts:
C1309, C1310, C1315, C1316, C1317, C1320, C1327, C1332, C1333: 4.7 µF; C_0402_1005Metric; MPN GRM155R60J475ME47D
C1311, C1312, C1313, C1318, C1321, C1323: 22 µF; C_0603_1608Metric; MPN GRM188R60J226MEA0D
C1314, C1319, C1322, C1324, C1325, C1326, C1329, C1330, C1331, C1334, C1336, C1338, C1339, C1340, C1341, C1342, C1343, C1344, C1345, C1346, C1347, C1348, C1349: 100 nF; C_0201_0603Metric; MPN GRM033R61A104KE15D
C1328: 10 µF; C_0603_1608Metric; MPN GRM188R61A106KE69D
C1335, C1337: 1 µF; C_0402_1005Metric; MPN GRM155C71A105KE11D
R1339: 5 mΩ; R_Vishay_WSL1206_2m-5m9; MPN WSL12065L000FEA
R1340: 0 Ω; R_0603_1608Metric; MPN RC0603JR-070RL
TP1301: VDD_LOGIC_SRC; TestPoint_Pad_D1.0mm
TP1302: vdd_logic; TestPoint_Pad_D1.0mm
U1301: RK3566; Rockchip_FCCSP-565L_15.5x14.4mm_P0.4mm_P0.65mm_Ball0.25mm_P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; MPN RK3566

Connections:
/VDD_LOGIC_SRC: R1339.1, TP1301.1; also elsewhere on the board
GND: C1309.2, C1310.2, C1311.2, C1312.2, C1313.2, C1314.2, C1315.2, C1316.2, C1317.2, C1318.2, C1319.2, C1320.2, C1321.2, C1322.2, C1323.2, C1324.2, C1325.2, C1326.2, C1327.2, C1328.2, C1329.2, C1330.2, C1331.2, C1332.2, C1333.2, C1334.2, C1335.2, C1336.2, C1337.2, C1338.2, C1339.2, C1340.2, C1341.2, C1342.2, C1343.2, C1344.2, C1345.2, C1346.2, C1347.2, C1348.2, C1349.2; also elsewhere on the board
vcc0v6_ddr: C1329.1, C1330.1, C1331.1, C1332.1, C1333.1, U1301.1E6 (DDRPHY_VDDQL_1), U1301.1E7 (DDRPHY_VDDQL_2), U1301.1E9 (DDRPHY_VDDQL_3), U1301.1F5 (DDRPHY_VDDQL_4), U1301.1G5 (DDRPHY_VDDQL_5); also elsewhere on the board
vcc3v3_pmu: C1347.1, U1301.1P16 (PMUIO1); also elsewhere on the board
vcc3v3_sys: C1338.1, C1339.1, C1340.1, C1341.1, U1301.1D13 (VCCIO1), U1301.1H18 (USB_AVDD1_3V3), U1301.1J2 (USB_AVDD2_3V3), U1301.1N5 (VCCIO5_1), U1301.1N6 (VCCIO5_2), U1301.1N8 (VCCIO7); also elsewhere on the board
vcc_1v8: C1342.1, C1343.1, R1340.1, U1301.1C13 (VCCIO2), U1301.1E16 (VCCIO4); also elsewhere on the board
vcc_ddr: C1324.1, C1325.1, C1326.1, C1327.1, C1328.1, U1301.1D5 (DDRPHY_VDDQ_1), U1301.1D6 (DDRPHY_VDDQ_2), U1301.1D7 (DDRPHY_VDDQ_3), U1301.1D8 (DDRPHY_VDDQ_4), U1301.1D9 (DDRPHY_VDDQ_5), U1301.1E4 (DDRPHY_VDDQ_6), U1301.1F4 (DDRPHY_VDDQ_7), U1301.1G4 (DDRPHY_VDDQ_8); also elsewhere on the board
vcca1v8_pmu: C1348.1, C1349.1, U1301.1N15 (PMUIO2), U1301.1N18 (PMUPLL_AVDD_1V8); also elsewhere on the board
vcca_1v8: C1336.1, C1337.1, U1301.1D15 (OTP_VCC18), U1301.1D16 (SARADC_AVDD_1V8), U1301.1G17 (EDP_TX_AVDD_1V8), U1301.1H4 (SYSPLL_AVDD_1V8), U1301.1H16 (USB_AVDD1_1V8), U1301.1J3 (USB_AVDD2_1V8), U1301.1K17 (MULTI_PHY_AVDD_1V8), U1301.1P9 (MIPI_CSI_RX_AVDD_1V8), U1301.1P12 (MIPI_DSI_TX0/LVDS_TX0_AVDD_1V8), U1301.1P13 (HDMI_TX_AVDD_1V8), U1301.1R10 (MIPI_DSI_TX1_AVDD_1V8); also elsewhere on the board
vccio6_1v8: C1345.1, C1346.1, R1340.2, U1301.1L4 (VCCIO6_1), U1301.1L5 (VCCIO6_2); also elsewhere on the board
vccio_sd: C1344.1, U1301.1F17 (VCCIO3); also elsewhere on the board
vdd_cpu: C1309.1, C1310.1, C1311.1, C1312.1, C1313.1, U1301.1C12 (VDD_CPU_1), U1301.1D11 (VDD_CPU_2), U1301.1D12 (VDD_CPU_3), U1301.1E11 (VDD_CPU_4), U1301.1E12 (VDD_CPU_5), U1301.1E13 (VDD_CPU_6), U1301.1F11 (VDD_CPU_7), U1301.1F12 (VDD_CPU_8), U1301.1F13 (VDD_CPU_9), U1301.1F14 (VDD_CPU_10), U1301.1G13 (VDD_CPU_11); also elsewhere on the board
vdd_gpu: C1319.1, C1320.1, C1321.1, U1301.1L8 (VDD_GPU_1), U1301.1L9 (VDD_GPU_2), U1301.1M7 (VDD_GPU_3), U1301.1M8 (VDD_GPU_4), U1301.1M9 (VDD_GPU_5); also elsewhere on the board
vdd_logic: C1314.1, C1315.1, C1316.1, C1317.1, C1318.1, R1339.2, TP1302.1, U1301.1H7 (VDD_LOGIC_1), U1301.1H8 (VDD_LOGIC_2), U1301.1H9 (VDD_LOGIC_3), U1301.1H10 (VDD_LOGIC_4), U1301.1J7 (VDD_LOGIC_5), U1301.1J10 (VDD_LOGIC_6), U1301.1K7 (VDD_LOGIC_7), U1301.1K10 (VDD_LOGIC_8), U1301.1L7 (VDD_LOGIC_9); also elsewhere on the board
vdd_npu: C1322.1, C1323.1, U1301.1G15 (VDD_NPU_1), U1301.1H14 (VDD_NPU_2), U1301.1H15 (VDD_NPU_3), U1301.1J14 (VDD_NPU_4), U1301.1J15 (VDD_NPU_5); also elsewhere on the board
vdda0v9_pmu: U1301.1N16 (PMU_VDD_LOGIC_0V9), U1301.1P17 (PMUPLL_AVDD_0V9); also elsewhere on the board
vdda_0v9: C1334.1, C1335.1, U1301.1H5 (SYSPLL_AVDD_0V9), U1301.1H17 (EDP_TX_AVDD_0V9), U1301.1J4 (USB_AVDD2_0V9), U1301.1J17 (USB_AVDD1_0V9), U1301.1K16 (MULTI_PHY_AVDD_0V9), U1301.1N9 (MIPI_CSI_RX_AVDD_0V9), U1301.1N10 (MIPI_DSI_TX1_AVDD_0V9), U1301.1N13 (HDMI_TX_AVDD_0V9_2), U1301.1N14 (HDMI_TX_AVDD_0V9_1), U1301.1P11 (MIPI_DSI_TX0/LVDS_TX0_AVDD_0V9); also elsewhere on the board

Notes on the sheet:
Link #2 (vdd_logic)
VCCIO6 branch
Notes 1. Function: RK3566 supply units and their decoupling, grouped by rail in placement order (smallest value nearest the balls). Values: RK3566 HDG 1.1 pp. 32-41, as in the rail table. 2. Absent state: not applicable (the SoC is never omitted). 3. The capacitors of vdd_cpu, vdd_logic, vdd_gpu, v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
Rails

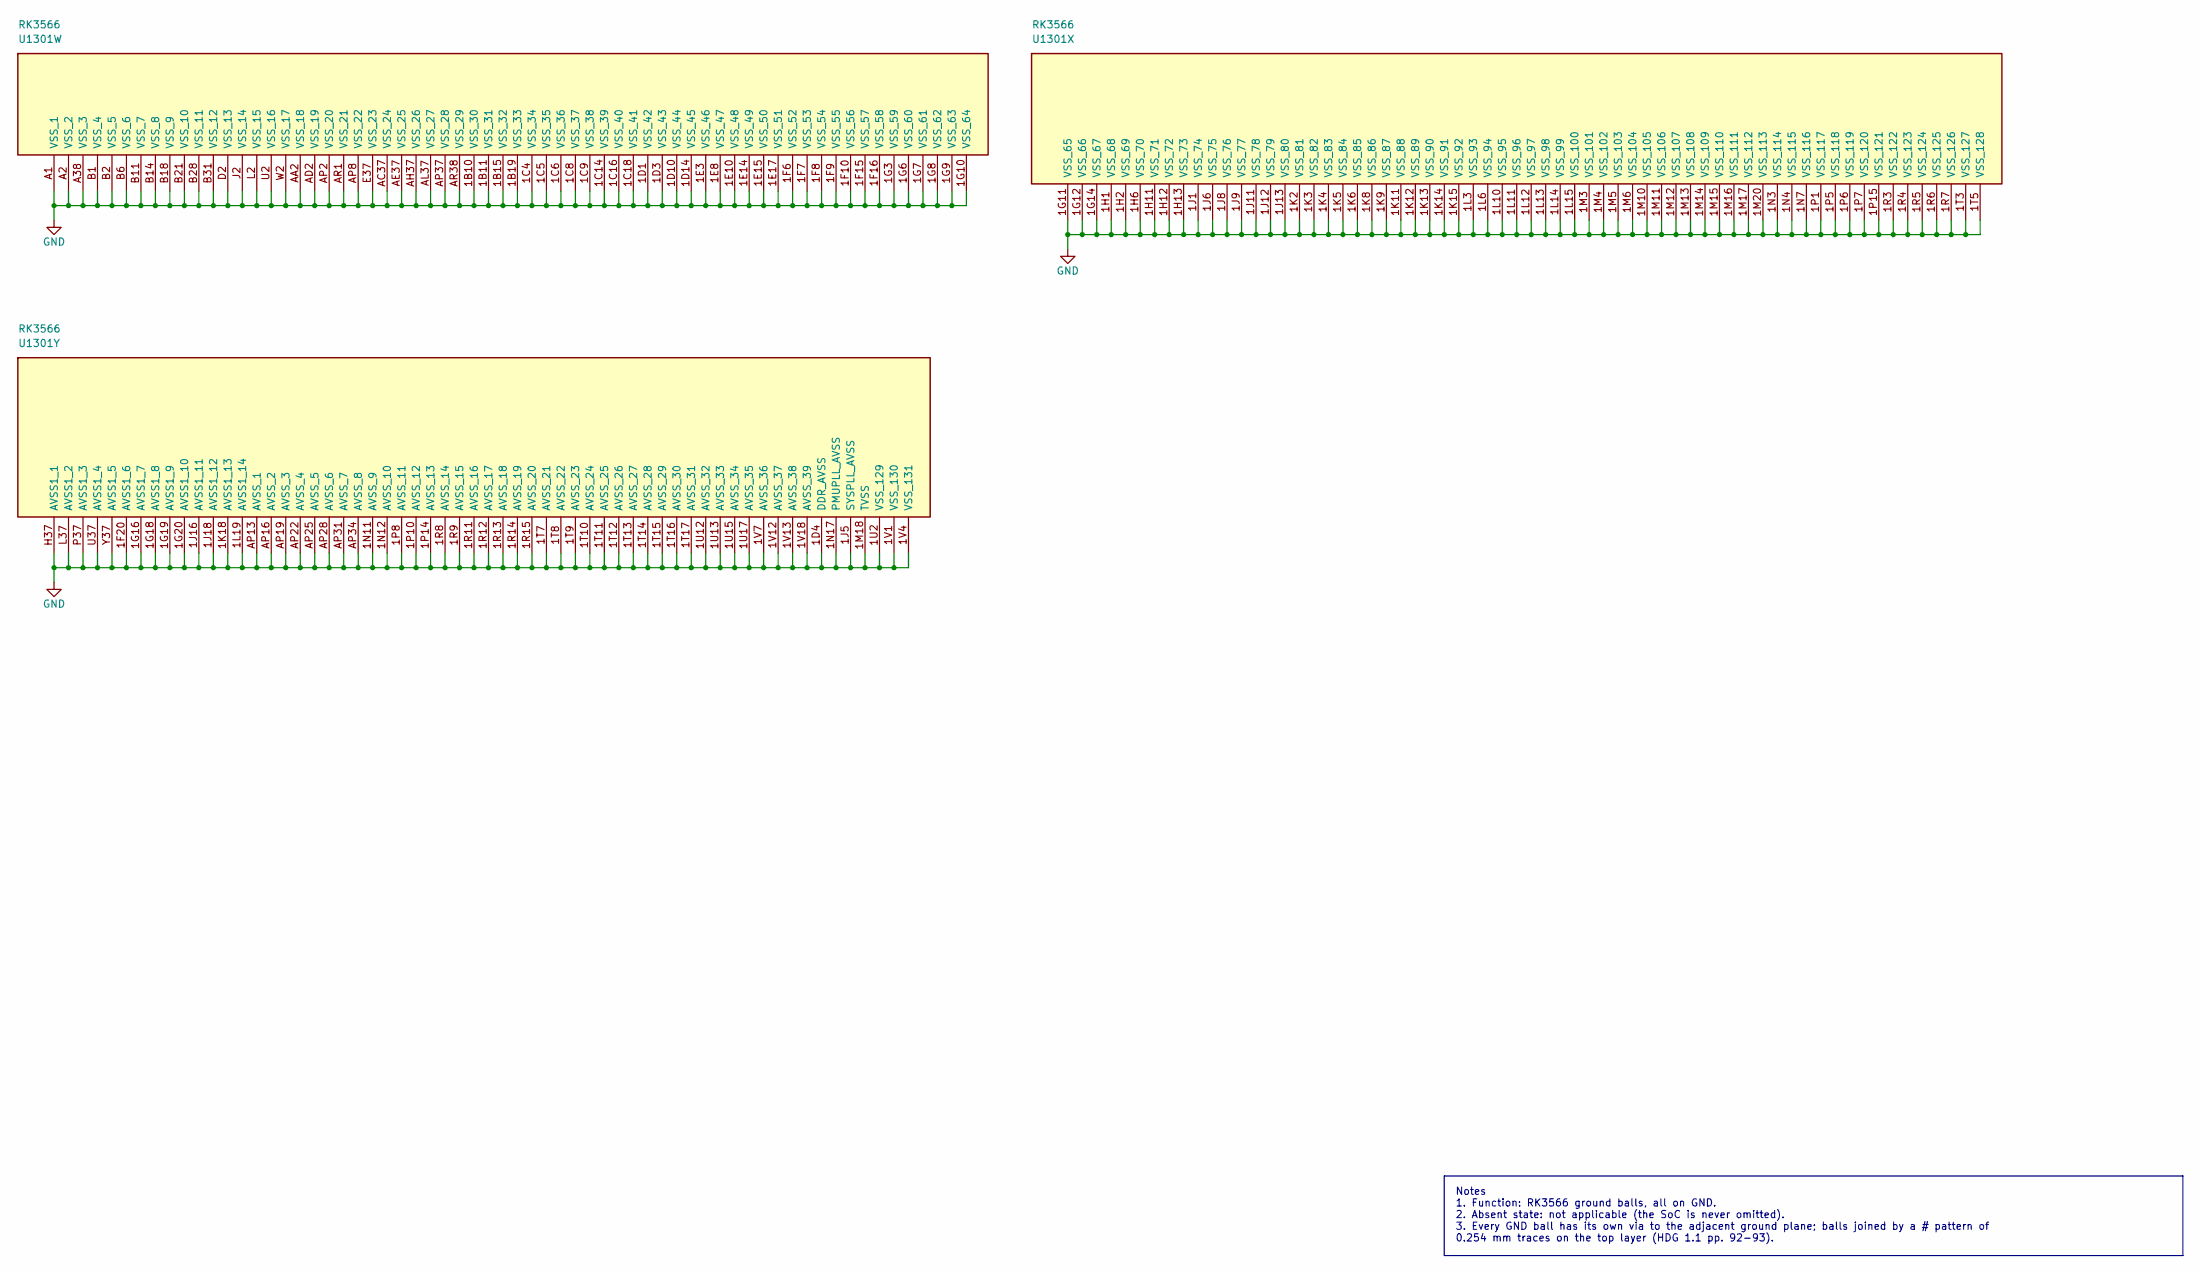
[picture p61: schematic soc-ground.kicad_sch, SoC: ground]

Parts:
U1301: RK3566; Rockchip_FCCSP-565L_15.5x14.4mm_P0.4mm_P0.65mm_Ball0.25mm_P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; MPN RK3566

Connections:
GND: U1301.1B10 (VSS_30), U1301.1B11 (VSS_31), U1301.1B15 (VSS_32), U1301.1B19 (VSS_33), U1301.1C4 (VSS_34), U1301.1C5 (VSS_35), U1301.1C6 (VSS_36), U1301.1C8 (VSS_37), U1301.1C9 (VSS_38), U1301.1C14 (VSS_39), U1301.1C16 (VSS_40), U1301.1C18 (VSS_41), U1301.1D1 (VSS_42), U1301.1D3 (VSS_43), U1301.1D4 (DDR_AVSS), U1301.1D10 (VSS_44), U1301.1D14 (VSS_45), U1301.1E3 (VSS_46), U1301.1E8 (VSS_47), U1301.1E10 (VSS_48), U1301.1E14 (VSS_49), U1301.1E15 (VSS_50), U1301.1E17 (VSS_51), U1301.1F6 (VSS_52), U1301.1F7 (VSS_53), U1301.1F8 (VSS_54), U1301.1F9 (VSS_55), U1301.1F10 (VSS_56), U1301.1F15 (VSS_57), U1301.1F16 (VSS_58), U1301.1F20 (AVSS1_6), U1301.1G3 (VSS_59), U1301.1G6 (VSS_60), U1301.1G7 (VSS_61), U1301.1G8 (VSS_62), U1301.1G9 (VSS_63), U1301.1G10 (VSS_64), U1301.1G11 (VSS_65), U1301.1G12 (VSS_66), U1301.1G14 (VSS_67), U1301.1G16 (AVSS1_7), U1301.1G18 (AVSS1_8), U1301.1G19 (AVSS1_9), U1301.1G20 (AVSS1_10), U1301.1H1 (VSS_68), U1301.1H2 (VSS_69), U1301.1H6 (VSS_70), U1301.1H11 (VSS_71), U1301.1H12 (VSS_72), U1301.1H13 (VSS_73), U1301.1J1 (VSS_74), U1301.1J5 (SYSPLL_AVSS), U1301.1J6 (VSS_75), U1301.1J8 (VSS_76), U1301.1J9 (VSS_77), U1301.1J11 (VSS_78), U1301.1J12 (VSS_79), U1301.1J13 (VSS_80), U1301.1J16 (AVSS1_11), U1301.1J18 (AVSS1_12), U1301.1K2 (VSS_81), U1301.1K3 (VSS_82), U1301.1K4 (VSS_83), U1301.1K5 (VSS_84), U1301.1K6 (VSS_85), U1301.1K8 (VSS_86), U1301.1K9 (VSS_87), U1301.1K11 (VSS_88), U1301.1K12 (VSS_89), U1301.1K13 (VSS_90), U1301.1K14 (VSS_91), U1301.1K15 (VSS_92), U1301.1K18 (AVSS1_13), U1301.1L3 (VSS_93), U1301.1L6 (VSS_94), U1301.1L10 (VSS_95), U1301.1L11 (VSS_96), U1301.1L12 (VSS_97), U1301.1L13 (VSS_98), U1301.1L14 (VSS_99), U1301.1L15 (VSS_100), U1301.1L19 (AVSS1_14), U1301.1M3 (VSS_101), U1301.1M4 (VSS_102), U1301.1M5 (VSS_103), U1301.1M6 (VSS_104), U1301.1M10 (VSS_105), U1301.1M11 (VSS_106), U1301.1M12 (VSS_107), U1301.1M13 (VSS_108), U1301.1M14 (VSS_109), U1301.1M15 (VSS_110), U1301.1M16 (VSS_111), U1301.1M17 (VSS_112), U1301.1M18 (TVSS), U1301.1M20 (VSS_113), U1301.1N3 (VSS_114), U1301.1N4 (VSS_115), U1301.1N7 (VSS_116), U1301.1N11 (AVSS_9), U1301.1N12 (AVSS_10), U1301.1N17 (PMUPLL_AVSS), U1301.1P1 (VSS_117), U1301.1P5 (VSS_118), U1301.1P6 (VSS_119), U1301.1P7 (VSS_120), U1301.1P8 (AVSS_11), U1301.1P10 (AVSS_12), U1301.1P14 (AVSS_13), U1301.1P15 (VSS_121), U1301.1R3 (VSS_122), U1301.1R4 (VSS_123), U1301.1R5 (VSS_124), U1301.1R6 (VSS_125), U1301.1R7 (VSS_126), U1301.1R8 (AVSS_14), U1301.1R9 (AVSS_15), U1301.1R11 (AVSS_16), U1301.1R12 (AVSS_17), U1301.1R13 (AVSS_18), U1301.1R14 (AVSS_19), U1301.1R15 (AVSS_20), U1301.1T3 (VSS_127), U1301.1T5 (VSS_128), U1301.1T7 (AVSS_21), U1301.1T8 (AVSS_22), U1301.1T9 (AVSS_23), U1301.1T10 (AVSS_24), U1301.1T11 (AVSS_25), U1301.1T12 (AVSS_26), U1301.1T13 (AVSS_27), U1301.1T14 (AVSS_28), U1301.1T15 (AVSS_29), U1301.1T16 (AVSS_30), U1301.1T17 (AVSS_31), U1301.1U2 (VSS_129), U1301.1U12 (AVSS_32), U1301.1U13 (AVSS_33), U1301.1U15 (AVSS_34), U1301.1U17 (AVSS_35), U1301.1V1 (VSS_130), U1301.1V4 (VSS_131), U1301.1V7 (AVSS_36), U1301.1V12 (AVSS_37), U1301.1V13 (AVSS_38), U1301.1V18 (AVSS_39), U1301.A1 (VSS_1), U1301.A2 (VSS_2), U1301.A38 (VSS_3), U1301.AA2 (VSS_18), U1301.AC37 (VSS_24), U1301.AD2 (VSS_19), U1301.AE37 (VSS_25), U1301.AH37 (VSS_26), U1301.AL37 (VSS_27), U1301.AP2 (VSS_20), U1301.AP8 (VSS_22), U1301.AP13 (AVSS_1), U1301.AP16 (AVSS_2), U1301.AP19 (AVSS_3), U1301.AP22 (AVSS_4), U1301.AP25 (AVSS_5), U1301.AP28 (AVSS_6), U1301.AP31 (AVSS_7), U1301.AP34 (AVSS_8), U1301.AP37 (VSS_28), U1301.AR1 (VSS_21), U1301.AR38 (VSS_29), U1301.B1 (VSS_4), U1301.B2 (VSS_5), U1301.B6 (VSS_6), U1301.B11 (VSS_7), U1301.B14 (VSS_8), U1301.B18 (VSS_9), U1301.B21 (VSS_10), U1301.B28 (VSS_11), U1301.B31 (VSS_12), U1301.D2 (VSS_13), U1301.E37 (VSS_23), U1301.H37 (AVSS1_1), U1301.J2 (VSS_14), U1301.L2 (VSS_15), U1301.L37 (AVSS1_2), U1301.P37 (AVSS1_3), U1301.U2 (VSS_16), U1301.U37 (AVSS1_4), U1301.W2 (VSS_17), U1301.Y37 (AVSS1_5); also elsewhere on the board

Notes on the sheet:
Notes 1. Function: RK3566 ground balls, all on GND. 2. Absent state: not applicable (the SoC is never omitted). 3. Every GND ball has its own via to the adjacent ground plane; balls joined by a # pattern of 0.254 mm traces on the top layer (HDG 1.1 pp. 92-93).
