opendap-project/t1/board/hardware/t1-main-board/t1-main-board.kicad_pcb

## KiCad design board/hardware/t1-main-board/t1-main-board.kicad_pcb (continued)

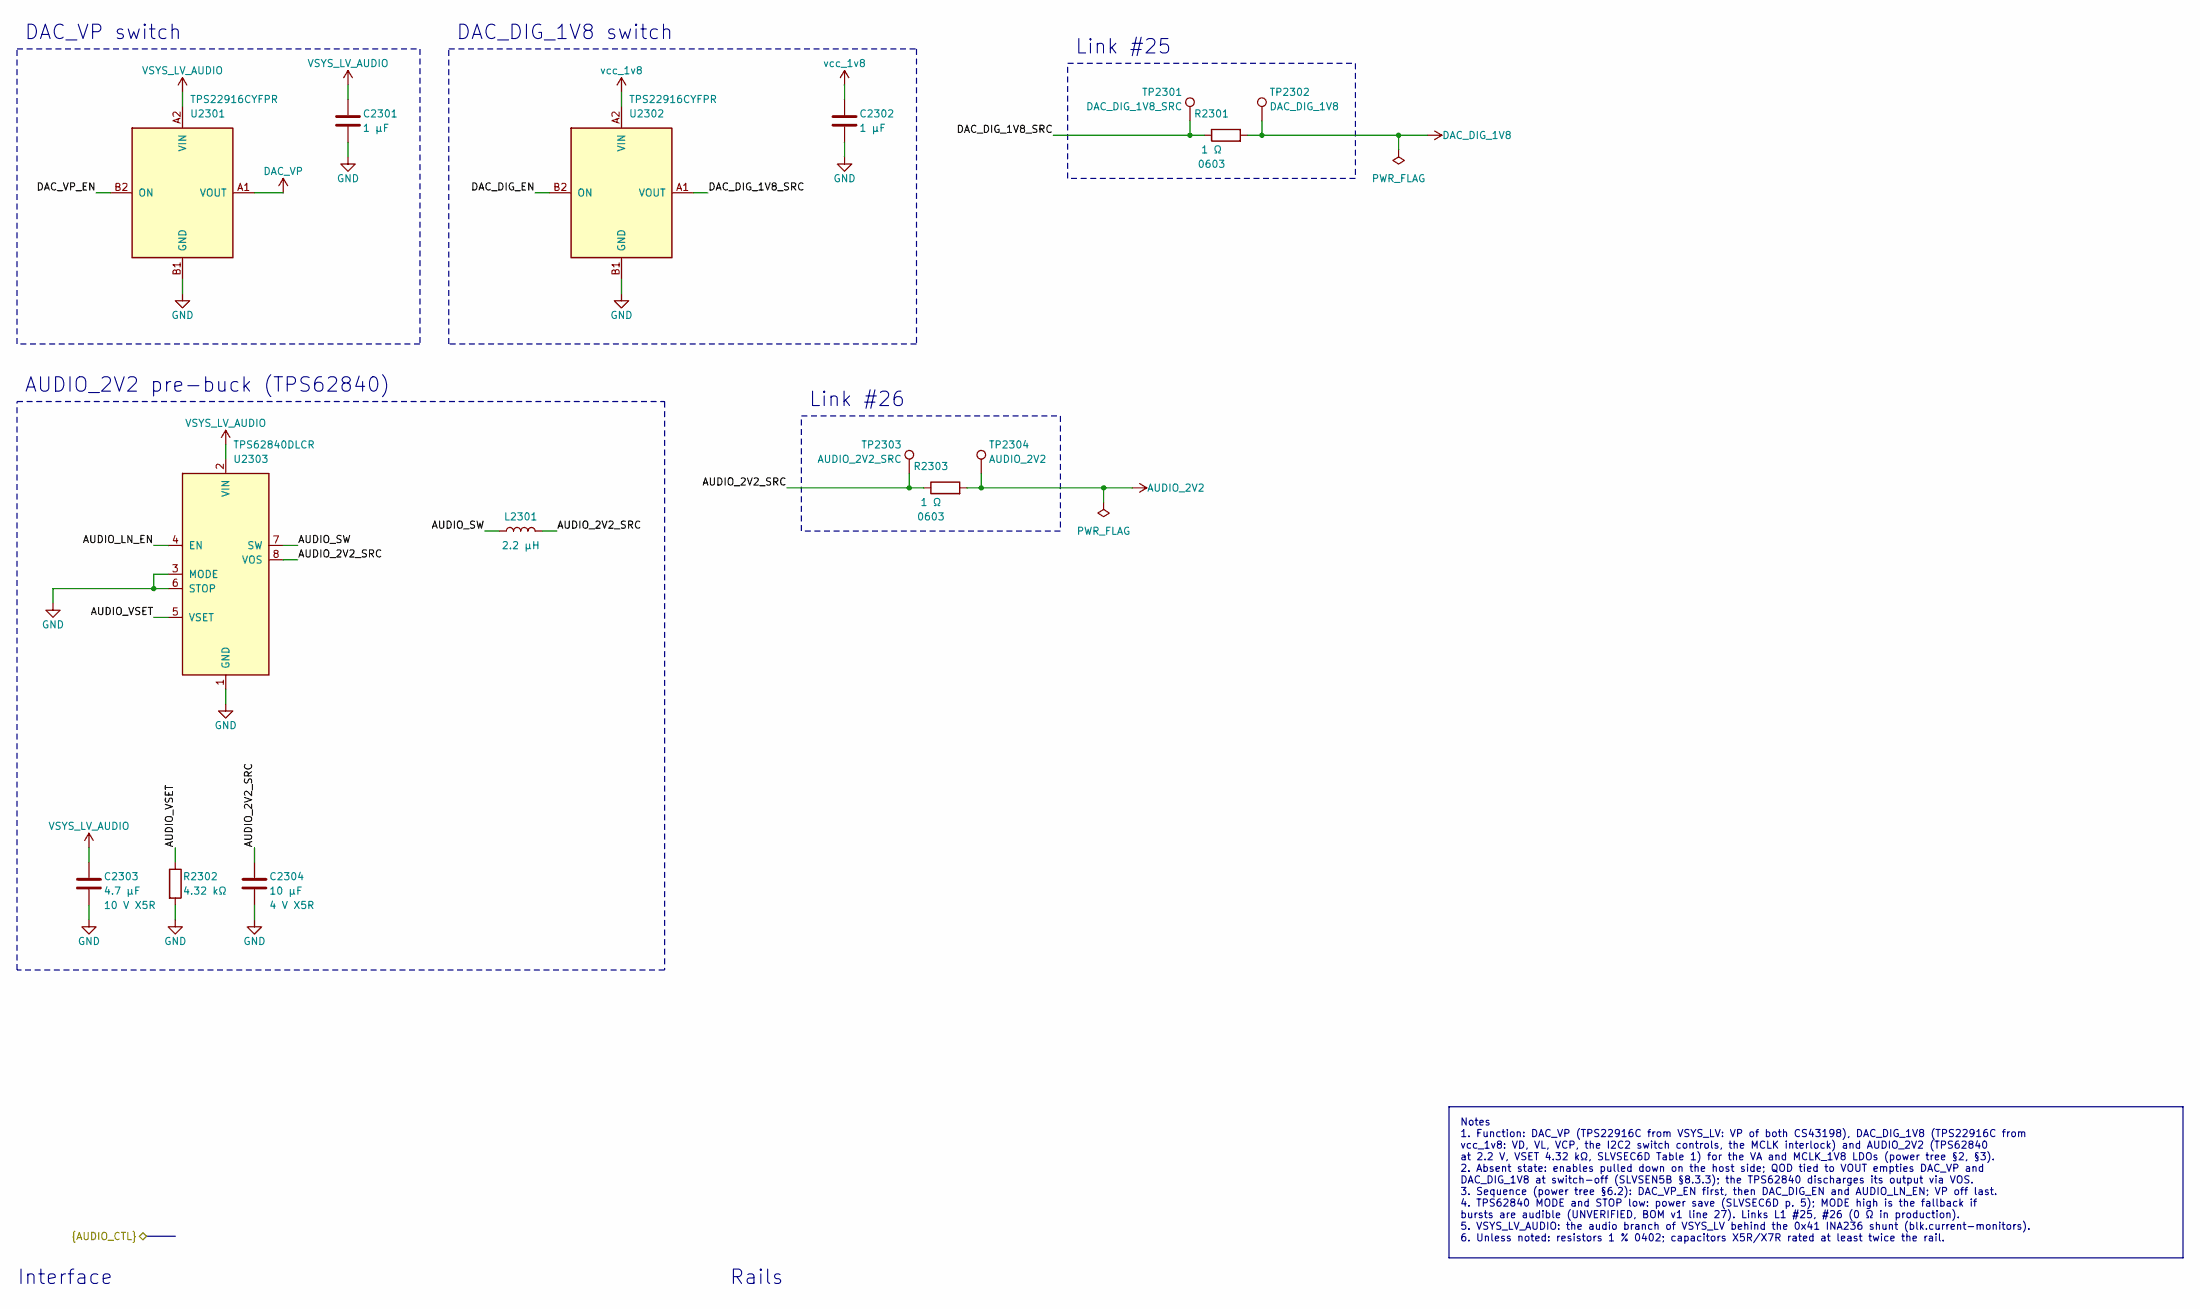
[picture p62: schematic audio-supply.kicad_sch, Audio: DAC supplies]

Parts:
C2301, C2302: 1 µF; C_0402_1005Metric; MPN GRM155C71A105KE11D
C2303: 4.7 µF; C_0402_1005Metric; MPN GRM155R61A475MEAAD
C2304: 10 µF; C_0402_1005Metric; MPN GRM155R60G106ME44D
L2301: 2.2 µH; L_Murata_DFE201610E; MPN DFE201610E-2R2M
R2301, R2303: 1 Ω; R_0603_1608Metric; MPN RC0603FR-071RL
R2302: 4.32 kΩ; R_0402_1005Metric; MPN RC0402FR-074K32L
TP2301: DAC_DIG_1V8_SRC; TestPoint_Pad_D1.0mm
TP2302: DAC_DIG_1V8; TestPoint_Pad_D1.0mm
TP2303: AUDIO_2V2_SRC; TestPoint_Pad_D1.0mm
TP2304: AUDIO_2V2; TestPoint_Pad_D1.0mm
U2301, U2302: TPS22916CYFPR; Texas_YFP0004_DSBGA-4_0.78x0.78mm_Layout2x2_P0.4mm; MPN TPS22916CYFPR
U2303: TPS62840DLCR; Texas_DLC0008B_VSON-HR-8_1.5x2mm_P0.5mm; MPN TPS62840DLCR

Connections:
/AUDIO_LN_EN: U2303.4 (EN); also elsewhere on the board
/Audio/Audio: DAC supplies/AUDIO_2V2_SRC: C2304.1, L2301.2, R2303.1, TP2303.1, U2303.8 (VOS)
/Audio/Audio: DAC supplies/AUDIO_SW: L2301.1, U2303.7 (SW)
/Audio/Audio: DAC supplies/AUDIO_VSET: R2302.1, U2303.5 (VSET)
/Audio/Audio: DAC supplies/DAC_DIG_1V8_SRC: R2301.1, TP2301.1, U2302.A1 (VOUT)
/DAC_DIG_EN: U2302.B2 (ON); also elsewhere on the board
/DAC_VP_EN: U2301.B2 (ON); also elsewhere on the board
AUDIO_2V2: R2303.2, TP2304.1; also elsewhere on the board
DAC_DIG_1V8: R2301.2, TP2302.1; also elsewhere on the board
DAC_VP: U2301.A1 (VOUT); also elsewhere on the board
GND: C2301.2, C2302.2, C2303.2, C2304.2, R2302.2, U2301.B1 (GND), U2302.B1 (GND), U2303.1 (GND), U2303.3 (MODE), U2303.6 (STOP); also elsewhere on the board
VSYS_LV_AUDIO: C2301.1, C2303.1, U2301.A2 (VIN), U2303.2 (VIN); also elsewhere on the board
vcc_1v8: C2302.1, U2302.A2 (VIN); also elsewhere on the board

Notes on the sheet:
DAC_VP switch
DAC_DIG_1V8 switch
Link #25
AUDIO_2V2 pre-buck (TPS62840)
Link #26
Notes 1. Function: DAC_VP (TPS22916C from VSYS_LV: VP of both CS43198), DAC_DIG_1V8 (TPS22916C from vcc_1v8: VD, VL, VCP, the I2C2 switch controls, the MCLK interlock) and AUDIO_2V2 (TPS62840 at 2.2 V, VSET 4.32 kΩ, SLVSEC6D Table 1) for the VA and MCLK_1V8 LDOs (power tree §2, §3). 2. Absent state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
Interface
Rails

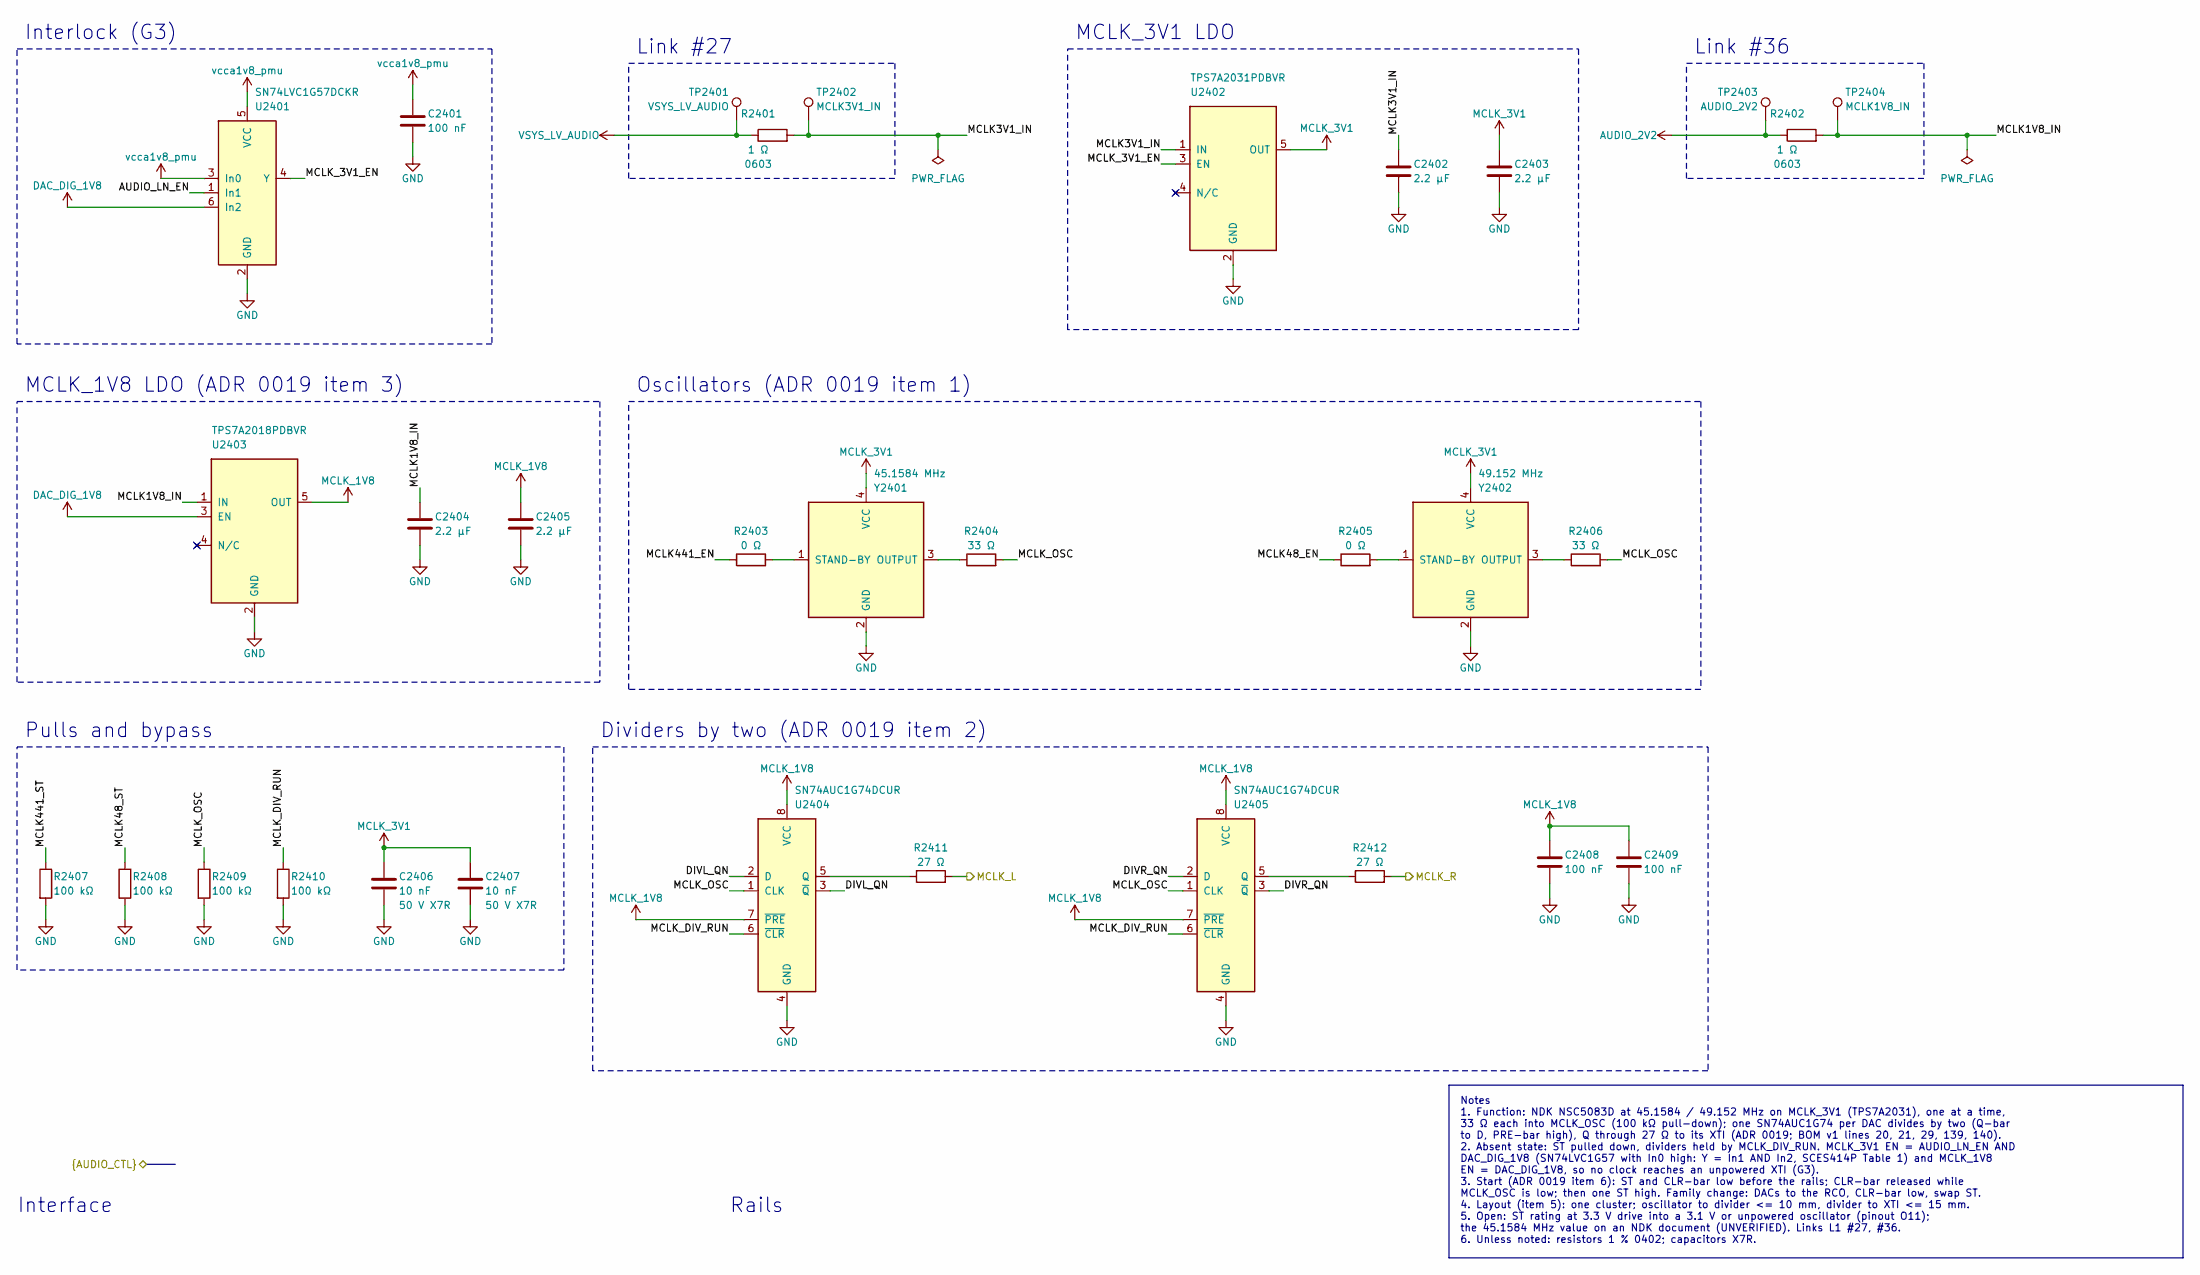
[picture p63: schematic mclk.kicad_sch, Audio: master clocks]

Parts:
C2401, C2408, C2409: 100 nF; C_0402_1005Metric; MPN GRM155R71C104KA88D
C2402, C2403, C2404, C2405: 2.2 µF; C_0402_1005Metric; MPN GRM155R61C225KE11D
C2406, C2407: 10 nF; C_0402_1005Metric; MPN GRM155R71H103KA88D
R2401, R2402: 1 Ω; R_0603_1608Metric; MPN RC0603FR-071RL
R2403, R2405: 0 Ω; R_0402_1005Metric; MPN RC0402JR-070RL
R2404, R2406: 33 Ω; R_0402_1005Metric; MPN RC0402FR-0733RL
R2407, R2408, R2409, R2410: 100 kΩ; R_0402_1005Metric; MPN RC0402FR-07100KL
R2411, R2412: 27 Ω; R_0402_1005Metric; MPN RC0402FR-0727RL
TP2401: VSYS_LV_AUDIO; TestPoint_Pad_D1.0mm
TP2402: MCLK3V1_IN; TestPoint_Pad_D1.0mm
TP2403: AUDIO_2V2; TestPoint_Pad_D1.0mm
TP2404: MCLK1V8_IN; TestPoint_Pad_D1.0mm
U2401: SN74LVC1G57DCKR; Texas_DCK0006A_SC-70-6_1.25x2mm_P0.65mm; MPN SN74LVC1G57DCKR
U2402: TPS7A2031PDBVR; Texas_DBV0005A_SOT-23-5_1.6x2.9mm_P0.95mm; MPN TPS7A2031PDBVR
U2403: TPS7A2018PDBVR; Texas_DBV0005A_SOT-23-5_1.6x2.9mm_P0.95mm; MPN TPS7A2018PDBVR
U2404, U2405: SN74AUC1G74DCUR; Texas_DCU0008A_VSSOP-8_2.3x2mm_P0.5mm; MPN SN74AUC1G74DCUR
Y2401: 45.1584 MHz; Oscillator_SMD_NDK_NZ2520SDA-4Pin_2.5x2.0mm; MPN NSC5083D-45.158M
Y2402: 49.152 MHz; Oscillator_SMD_NDK_NZ2520SDA-4Pin_2.5x2.0mm; MPN NSC5083D-49.152M

Connections:
/AUDIO_LN_EN: U2401.1 (In1); also elsewhere on the board
/Audio/Audio: master clocks/DIVL_QN: U2404.2 (D), U2404.3 (~Q)
/Audio/Audio: master clocks/DIVR_QN: U2405.2 (D), U2405.3 (~Q)
/Audio/Audio: master clocks/MCLK1V8_IN: C2404.1, R2402.2, TP2404.1, U2403.1 (IN)
/Audio/Audio: master clocks/MCLK3V1_IN: C2402.1, R2401.2, TP2402.1, U2402.1 (IN)
/Audio/Audio: master clocks/MCLK48_ST: R2408.1
/Audio/Audio: master clocks/MCLK441_ST: R2407.1
/Audio/Audio: master clocks/MCLK_3V1_EN: U2401.4 (Y), U2402.3 (EN)
/Audio/Audio: master clocks/MCLK_OSC: R2404.2, R2406.2, R2409.1, U2404.1 (CLK), U2405.1 (CLK)
/Audio/MCLK_L: R2411.2; also elsewhere on the board
/Audio/MCLK_R: R2412.2; also elsewhere on the board
/MCLK48_EN: R2405.1; also elsewhere on the board
/MCLK441_EN: R2403.1; also elsewhere on the board
/MCLK_DIV_RUN: R2410.1, U2404.6 (~CLR), U2405.6 (~CLR); also elsewhere on the board
AUDIO_2V2: R2402.1, TP2403.1; also elsewhere on the board
DAC_DIG_1V8: U2401.6 (In2), U2403.3 (EN); also elsewhere on the board
GND: C2401.2, C2402.2, C2403.2, C2404.2, C2405.2, C2406.2, C2407.2, C2408.2, C2409.2, R2407.2, R2408.2, R2409.2, R2410.2, U2401.2 (GND), U2402.2 (GND), U2403.2 (GND), U2404.4 (GND), U2405.4 (GND), Y2401.2 (GND), Y2402.2 (GND); also elsewhere on the board
MCLK_1V8: C2405.1, C2408.1, C2409.1, U2403.5 (OUT), U2404.7 (~PRE), U2404.8 (VCC), U2405.7 (~PRE), U2405.8 (VCC); also elsewhere on the board
MCLK_3V1: C2403.1, C2406.1, C2407.1, U2402.5 (OUT), Y2401.4 (VCC), Y2402.4 (VCC); also elsewhere on the board
unnamed: R2411.1, U2404.5 (Q)
unnamed: R2412.1, U2405.5 (Q)
unnamed: R2404.1, Y2401.3 (OUTPUT)
unnamed: R2403.2, Y2401.1 (STAND-BY)
unnamed: R2406.1, Y2402.3 (OUTPUT)
unnamed: R2405.2, Y2402.1 (STAND-BY)
VSYS_LV_AUDIO: R2401.1, TP2401.1; also elsewhere on the board
vcca1v8_pmu: C2401.1, U2401.3 (In0), U2401.5 (VCC); also elsewhere on the board

Notes on the sheet:
Interlock (G3)
Link #27
MCLK_3V1 LDO
Link #36
MCLK_1V8 LDO (ADR 0019 item 3)
Oscillators (ADR 0019 item 1)
Pulls and bypass
Dividers by two (ADR 0019 item 2)
Notes 1. Function: NDK NSC5083D at 45.1584 / 49.152 MHz on MCLK_3V1 (TPS7A2031), one at a time, 33 Ω each into MCLK_OSC (100 kΩ pull-down); one SN74AUC1G74 per DAC divides by two (Q-bar to D, PRE-bar high), Q through 27 Ω to its XTI (ADR 0019; BOM v1 lines 20, 21, 29, 139, 140). 2. Absent state: ST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
Interface
Rails

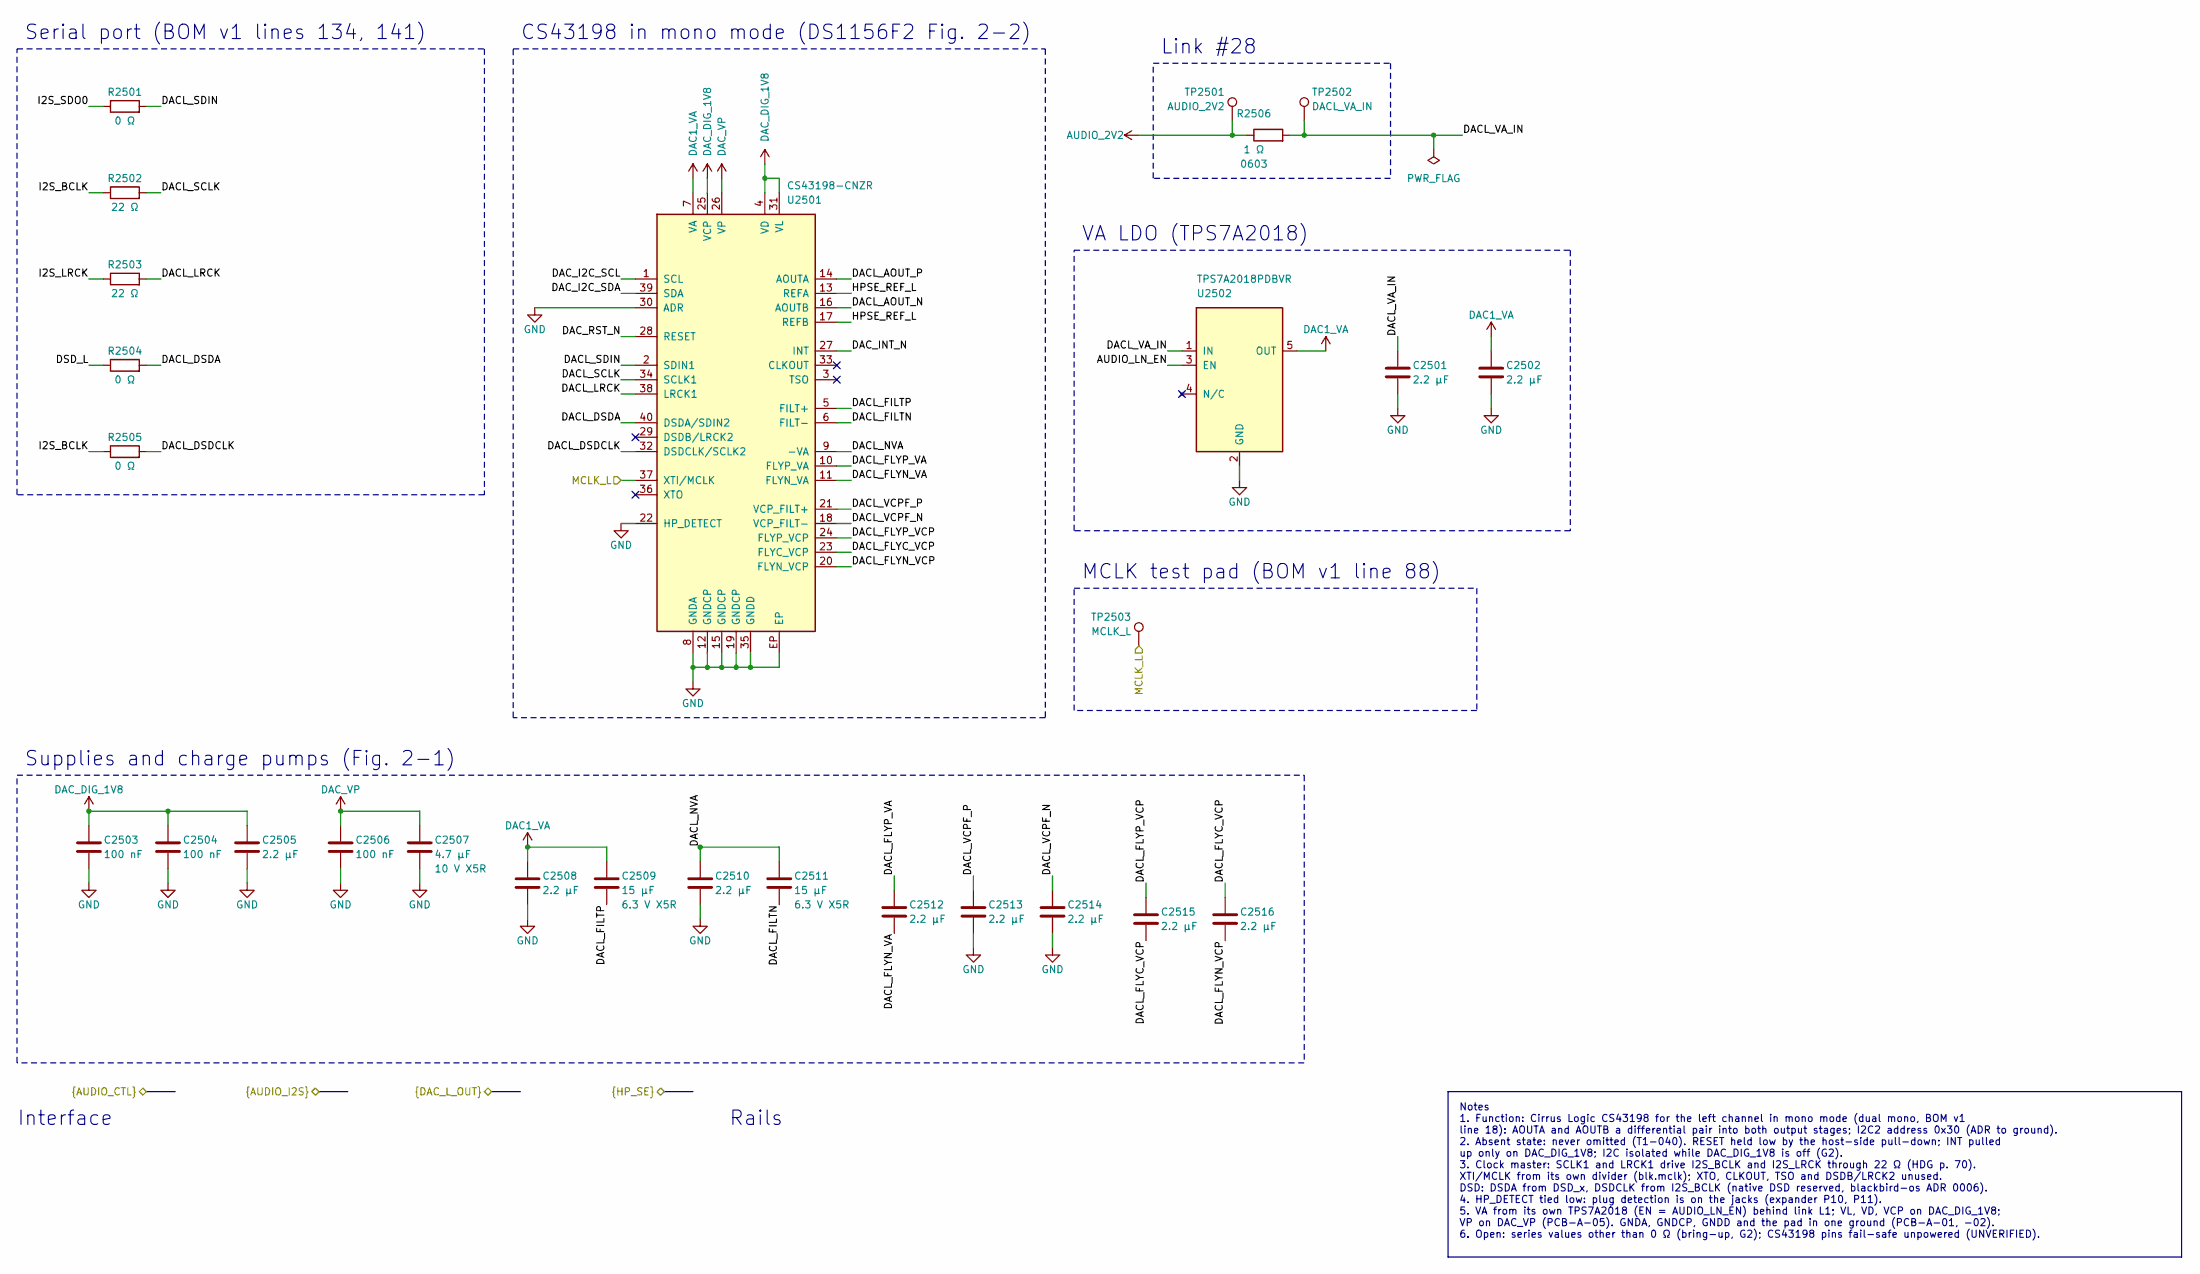
[picture p64: schematic dac-l.kicad_sch, Audio: DAC left]

Parts:
C2501, C2502: 2.2 µF; C_0402_1005Metric; MPN GRM155R61C225KE11D
C2503, C2504, C2506: 100 nF; C_0402_1005Metric; MPN GRM155R71C104KA88D
C2505, C2508, C2510, C2512, C2513, C2514, C2515, C2516: 2.2 µF; C_0402_1005Metric; MPN GRM155R61A225KE95D
C2507: 4.7 µF; C_0603_1608Metric; MPN GRM188R61A475KE15D
C2509, C2511: 15 µF; C_0603_1608Metric; MPN C1608X5R0J156M080AC
R2501, R2504, R2505: 0 Ω; R_0402_1005Metric; MPN RC0402JR-070RL
R2502, R2503: 22 Ω; R_0402_1005Metric; MPN RC0402FR-0722RL
R2506: 1 Ω; R_0603_1608Metric; MPN RC0603FR-071RL
TP2501: AUDIO_2V2; TestPoint_Pad_D1.0mm
TP2502: DACL_VA_IN; TestPoint_Pad_D1.0mm
TP2503: MCLK_L; TestPoint_Pad_D1.0mm
U2501: CS43198-CNZR; QFN-40-1EP_5x5mm_P0.4mm_EP3.5x3.5mm_ThermalVias; MPN CS43198-CNZR
U2502: TPS7A2018PDBVR; Texas_DBV0005A_SOT-23-5_1.6x2.9mm_P0.95mm; MPN TPS7A2018PDBVR

Connections:
/AUDIO_LN_EN: U2502.3 (EN); also elsewhere on the board
/Audio/Audio: DAC left/DACL_DSDA: R2504.2, U2501.40 (DSDA/SDIN2)
/Audio/Audio: DAC left/DACL_DSDCLK: R2505.2, U2501.32 (DSDCLK/SCLK2)
/Audio/Audio: DAC left/DACL_FILTN: C2511.2, U2501.6 (FILT-)
/Audio/Audio: DAC left/DACL_FILTP: C2509.2, U2501.5 (FILT+)
/Audio/Audio: DAC left/DACL_FLYC_VCP: C2515.2, C2516.1, U2501.23 (FLYC_VCP)
/Audio/Audio: DAC left/DACL_FLYN_VA: C2512.2, U2501.11 (FLYN_VA)
/Audio/Audio: DAC left/DACL_FLYN_VCP: C2516.2, U2501.20 (FLYN_VCP)
/Audio/Audio: DAC left/DACL_FLYP_VA: C2512.1, U2501.10 (FLYP_VA)
/Audio/Audio: DAC left/DACL_FLYP_VCP: C2515.1, U2501.24 (FLYP_VCP)
/Audio/Audio: DAC left/DACL_LRCK: R2503.2, U2501.38 (LRCK1)
/Audio/Audio: DAC left/DACL_NVA: C2510.1, C2511.1, U2501.9 (-VA)
/Audio/Audio: DAC left/DACL_SCLK: R2502.2, U2501.34 (SCLK1)
/Audio/Audio: DAC left/DACL_SDIN: R2501.2, U2501.2 (SDIN1)
/Audio/Audio: DAC left/DACL_VA_IN: C2501.1, R2506.2, TP2502.1, U2502.1 (IN)
/Audio/Audio: DAC left/DACL_VCPF_N: C2514.1, U2501.18 (VCP_FILT-)
/Audio/Audio: DAC left/DACL_VCPF_P: C2513.1, U2501.21 (VCP_FILT+)
/Audio/DACL_AOUT_N: U2501.16 (AOUTB); also elsewhere on the board
/Audio/DACL_AOUT_P: U2501.14 (AOUTA); also elsewhere on the board
/Audio/MCLK_L: TP2503.1, U2501.37 (XTI/MCLK); also elsewhere on the board
/DAC_I2C_SCL: U2501.1 (SCL); also elsewhere on the board
/DAC_I2C_SDA: U2501.39 (SDA); also elsewhere on the board
/DAC_INT_N: U2501.27 (INT); also elsewhere on the board
/DAC_RST_N: U2501.28 (RESET); also elsewhere on the board
/DSD_L: R2504.1; also elsewhere on the board
/HPSE_REF_L: U2501.13 (REFA), U2501.17 (REFB); also elsewhere on the board
/I2S_BCLK: R2502.1, R2505.1; also elsewhere on the board
/I2S_LRCK: R2503.1; also elsewhere on the board
/I2S_SDO0: R2501.1; also elsewhere on the board
AUDIO_2V2: R2506.1, TP2501.1; also elsewhere on the board
DAC1_VA: C2502.1, C2508.1, C2509.1, U2501.7 (VA), U2502.5 (OUT); also elsewhere on the board
DAC_DIG_1V8: C2503.1, C2504.1, C2505.1, U2501.4 (VD), U2501.25 (VCP), U2501.31 (VL); also elsewhere on the board
DAC_VP: C2506.1, C2507.1, U2501.26 (VP); also elsewhere on the board
GND: C2501.2, C2502.2, C2503.2, C2504.2, C2505.2, C2506.2, C2507.2, C2508.2, C2510.2, C2513.2, C2514.2, U2501.8 (GNDA), U2501.12 (GNDCP), U2501.15 (GNDCP), U2501.19 (GNDCP), U2501.22 (HP_DETECT), U2501.30 (ADR), U2501.35 (GNDD), U2501.EP, U2502.2 (GND); also elsewhere on the board

Notes on the sheet:
Serial port (BOM v1 lines 134, 141)
CS43198 in mono mode (DS1156F2 Fig. 2-2)
Link #28
VA LDO (TPS7A2018)
Supplies and charge pumps (Fig. 2-1)
MCLK test pad (BOM v1 line 88)
Notes 1. Function: Cirrus Logic CS43198 for the left channel in mono mode (dual mono, BOM v1 line 18): AOUTA and AOUTB a differential pair into both output stages; I2C2 address 0x30 (ADR to ground). 2. Absent state: never omitted (T1-040). RESET held low by the host-side pull-down; INT pulled up on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
Interface
Rails

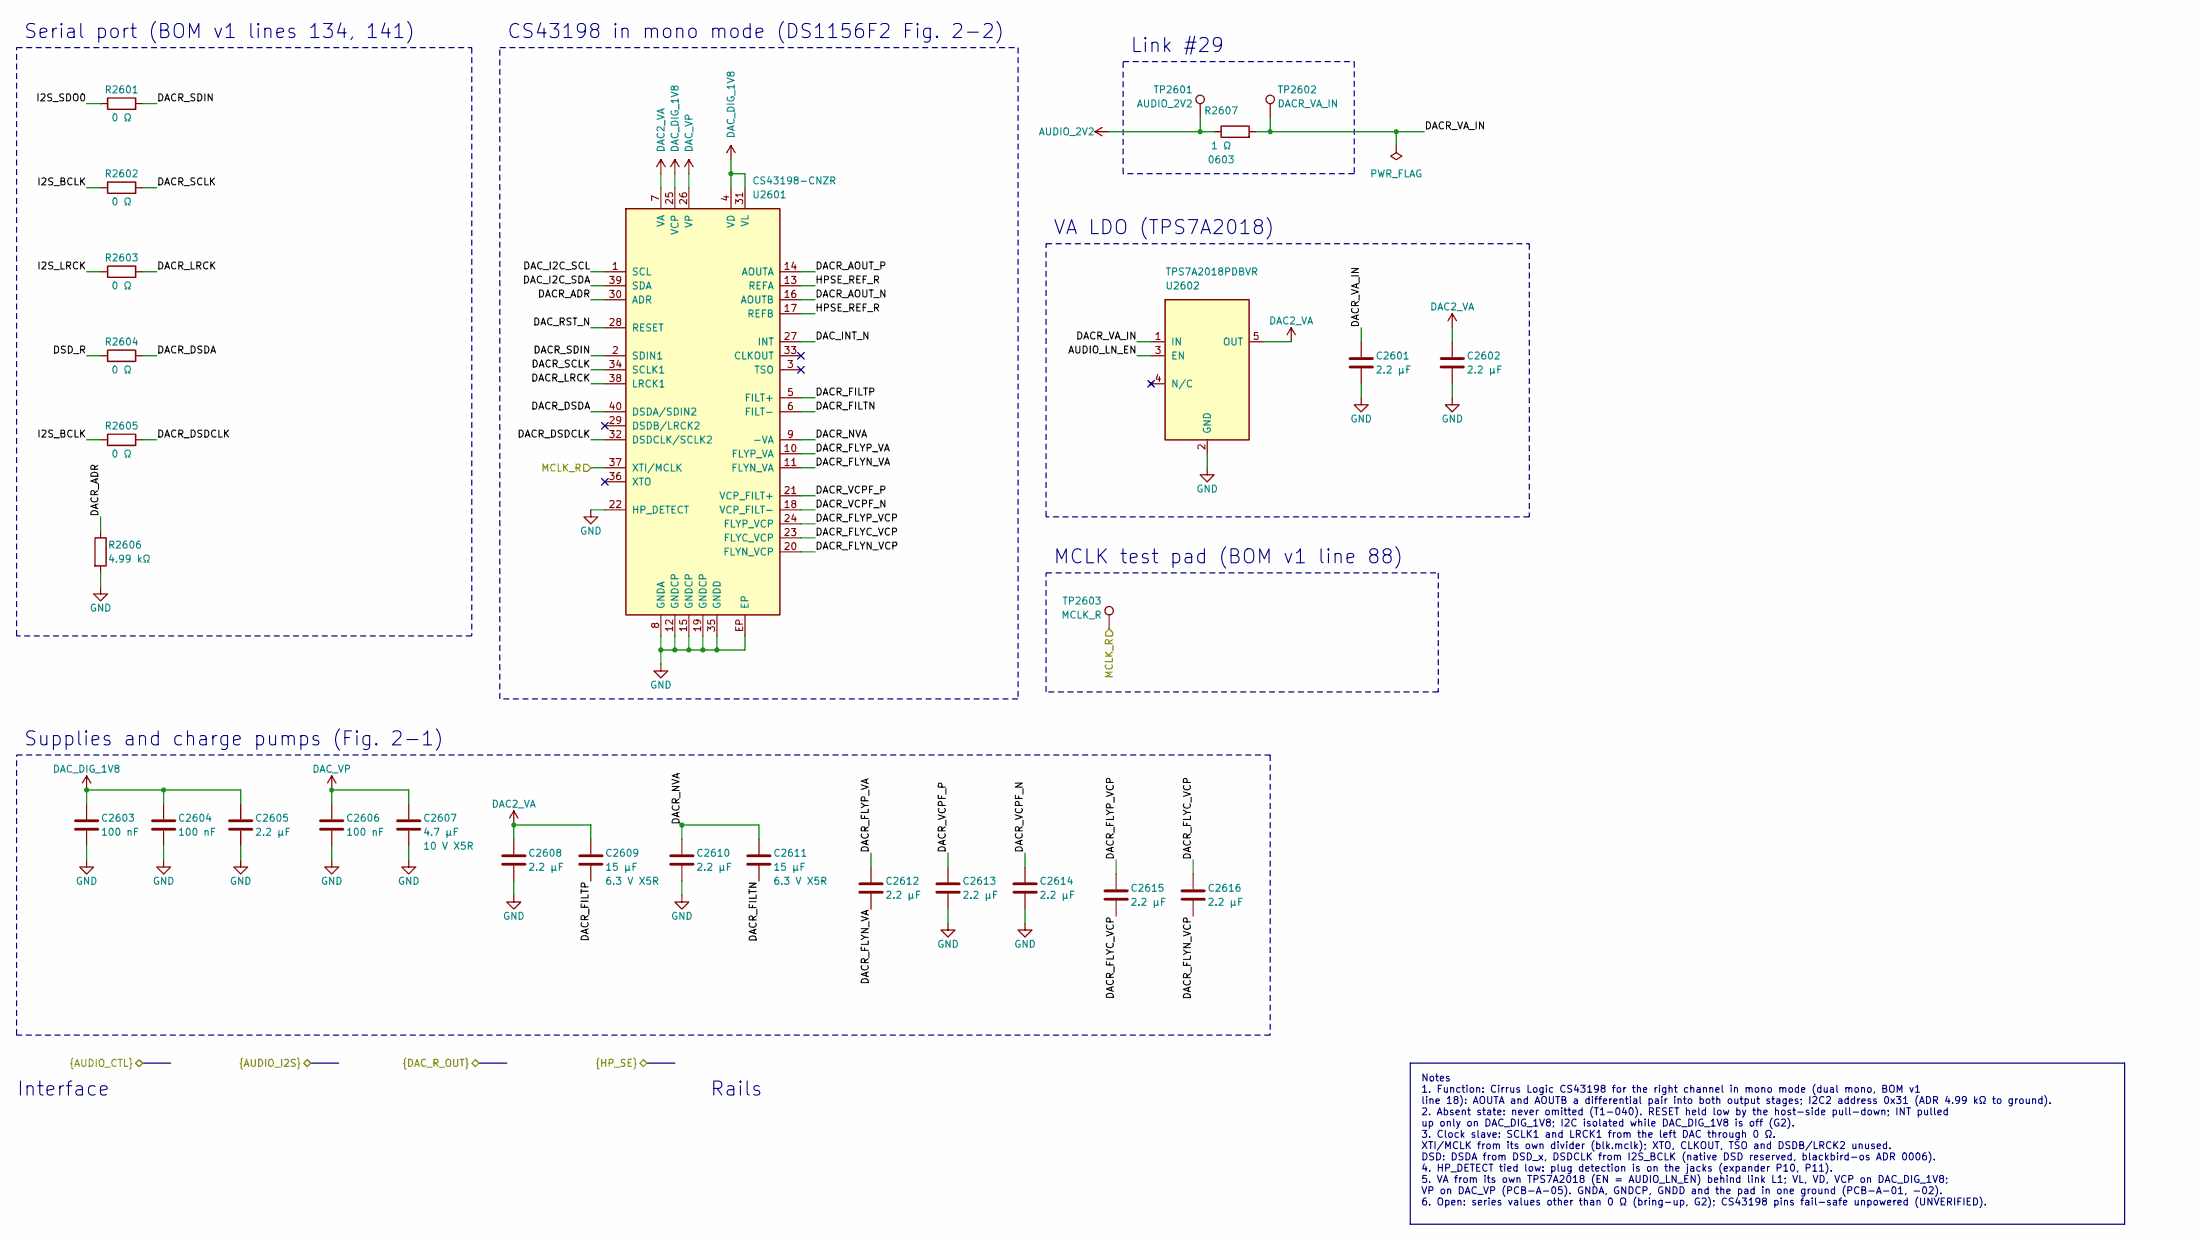
[picture p65: schematic dac-r.kicad_sch, Audio: DAC right]

Parts:
C2601, C2602: 2.2 µF; C_0402_1005Metric; MPN GRM155R61C225KE11D
C2603, C2604, C2606: 100 nF; C_0402_1005Metric; MPN GRM155R71C104KA88D
C2605, C2608, C2610, C2612, C2613, C2614, C2615, C2616: 2.2 µF; C_0402_1005Metric; MPN GRM155R61A225KE95D
C2607: 4.7 µF; C_0603_1608Metric; MPN GRM188R61A475KE15D
C2609, C2611: 15 µF; C_0603_1608Metric; MPN C1608X5R0J156M080AC
R2601, R2602, R2603, R2604, R2605: 0 Ω; R_0402_1005Metric; MPN RC0402JR-070RL
R2606: 4.99 kΩ; R_0402_1005Metric; MPN RC0402FR-074K99L
R2607: 1 Ω; R_0603_1608Metric; MPN RC0603FR-071RL
TP2601: AUDIO_2V2; TestPoint_Pad_D1.0mm
TP2602: DACR_VA_IN; TestPoint_Pad_D1.0mm
TP2603: MCLK_R; TestPoint_Pad_D1.0mm
U2601: CS43198-CNZR; QFN-40-1EP_5x5mm_P0.4mm_EP3.5x3.5mm_ThermalVias; MPN CS43198-CNZR
U2602: TPS7A2018PDBVR; Texas_DBV0005A_SOT-23-5_1.6x2.9mm_P0.95mm; MPN TPS7A2018PDBVR

Connections:
/AUDIO_LN_EN: U2602.3 (EN); also elsewhere on the board
/Audio/Audio: DAC right/DACR_ADR: R2606.1, U2601.30 (ADR)
/Audio/Audio: DAC right/DACR_DSDA: R2604.2, U2601.40 (DSDA/SDIN2)
/Audio/Audio: DAC right/DACR_DSDCLK: R2605.2, U2601.32 (DSDCLK/SCLK2)
/Audio/Audio: DAC right/DACR_FILTN: C2611.2, U2601.6 (FILT-)
/Audio/Audio: DAC right/DACR_FILTP: C2609.2, U2601.5 (FILT+)
/Audio/Audio: DAC right/DACR_FLYC_VCP: C2615.2, C2616.1, U2601.23 (FLYC_VCP)
/Audio/Audio: DAC right/DACR_FLYN_VA: C2612.2, U2601.11 (FLYN_VA)
/Audio/Audio: DAC right/DACR_FLYN_VCP: C2616.2, U2601.20 (FLYN_VCP)
/Audio/Audio: DAC right/DACR_FLYP_VA: C2612.1, U2601.10 (FLYP_VA)
/Audio/Audio: DAC right/DACR_FLYP_VCP: C2615.1, U2601.24 (FLYP_VCP)
/Audio/Audio: DAC right/DACR_LRCK: R2603.2, U2601.38 (LRCK1)
/Audio/Audio: DAC right/DACR_NVA: C2610.1, C2611.1, U2601.9 (-VA)
/Audio/Audio: DAC right/DACR_SCLK: R2602.2, U2601.34 (SCLK1)
/Audio/Audio: DAC right/DACR_SDIN: R2601.2, U2601.2 (SDIN1)
/Audio/Audio: DAC right/DACR_VA_IN: C2601.1, R2607.2, TP2602.1, U2602.1 (IN)
/Audio/Audio: DAC right/DACR_VCPF_N: C2614.1, U2601.18 (VCP_FILT-)
/Audio/Audio: DAC right/DACR_VCPF_P: C2613.1, U2601.21 (VCP_FILT+)
/Audio/DACR_AOUT_N: U2601.16 (AOUTB); also elsewhere on the board
/Audio/DACR_AOUT_P: U2601.14 (AOUTA); also elsewhere on the board
/Audio/MCLK_R: TP2603.1, U2601.37 (XTI/MCLK); also elsewhere on the board
/DAC_I2C_SCL: U2601.1 (SCL); also elsewhere on the board
/DAC_I2C_SDA: U2601.39 (SDA); also elsewhere on the board
/DAC_INT_N: U2601.27 (INT); also elsewhere on the board
/DAC_RST_N: U2601.28 (RESET); also elsewhere on the board
/DSD_R: R2604.1; also elsewhere on the board
/HPSE_REF_R: U2601.13 (REFA), U2601.17 (REFB); also elsewhere on the board
/I2S_BCLK: R2602.1, R2605.1; also elsewhere on the board
/I2S_LRCK: R2603.1; also elsewhere on the board
/I2S_SDO0: R2601.1; also elsewhere on the board
AUDIO_2V2: R2607.1, TP2601.1; also elsewhere on the board
DAC2_VA: C2602.1, C2608.1, C2609.1, U2601.7 (VA), U2602.5 (OUT); also elsewhere on the board
DAC_DIG_1V8: C2603.1, C2604.1, C2605.1, U2601.4 (VD), U2601.25 (VCP), U2601.31 (VL); also elsewhere on the board
DAC_VP: C2606.1, C2607.1, U2601.26 (VP); also elsewhere on the board
GND: C2601.2, C2602.2, C2603.2, C2604.2, C2605.2, C2606.2, C2607.2, C2608.2, C2610.2, C2613.2, C2614.2, R2606.2, U2601.8 (GNDA), U2601.12 (GNDCP), U2601.15 (GNDCP), U2601.19 (GNDCP), U2601.22 (HP_DETECT), U2601.35 (GNDD), U2601.EP, U2602.2 (GND); also elsewhere on the board

Notes on the sheet:
Serial port (BOM v1 lines 134, 141)
CS43198 in mono mode (DS1156F2 Fig. 2-2)
Link #29
VA LDO (TPS7A2018)
Supplies and charge pumps (Fig. 2-1)
MCLK test pad (BOM v1 line 88)
Notes 1. Function: Cirrus Logic CS43198 for the right channel in mono mode (dual mono, BOM v1 line 18): AOUTA and AOUTB a differential pair into both output stages; I2C2 address 0x31 (ADR 4.99 kΩ to ground). 2. Absent state: never omitted (T1-040). RESET held low by the host-side pull-down; INT pul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
Interface
Rails

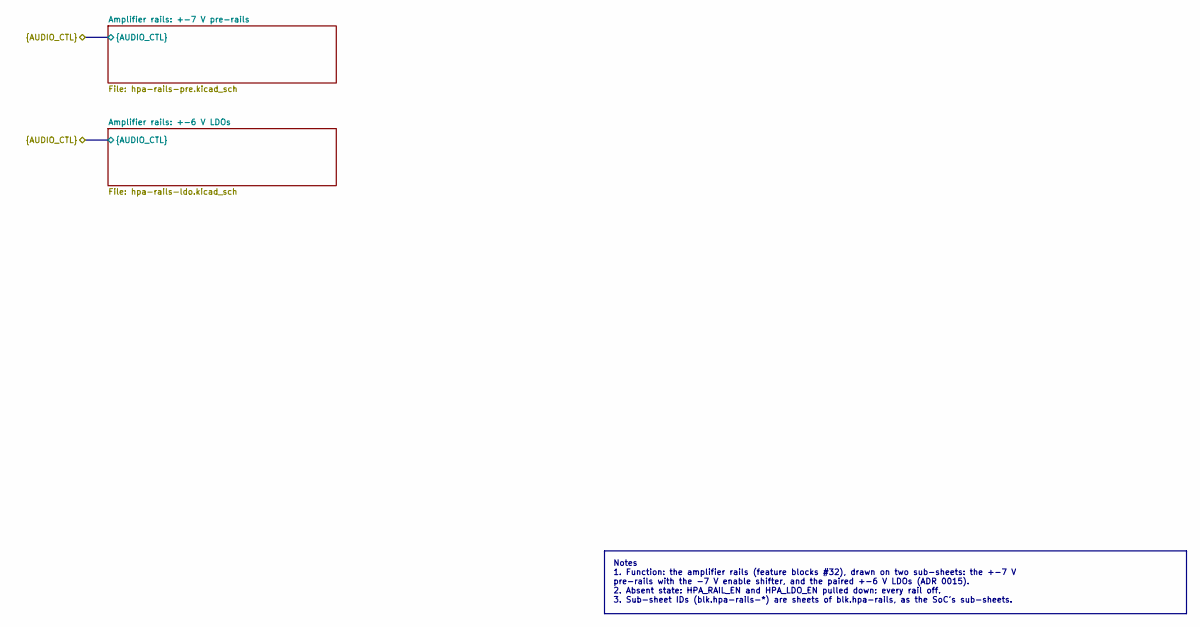
[picture p66: schematic hpa-rails.kicad_sch, Audio: amplifier rails]

Notes on the sheet:
Notes 1. Function: the amplifier rails (feature blocks #32), drawn on two sub-sheets: the +-7 V pre-rails with the -7 V enable shifter, and the paired +-6 V LDOs (ADR 0015). 2. Absent state: HPA_RAIL_EN and HPA_LDO_EN pulled down: every rail off. 3. Sub-sheet IDs (blk.hpa-rails-*) are sheets of blk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
