opendap-project/t1/board/hardware/t1-main-board/t1-main-board.kicad_pcb

## KiCad design board/hardware/t1-main-board/t1-main-board.kicad_pcb (continued)

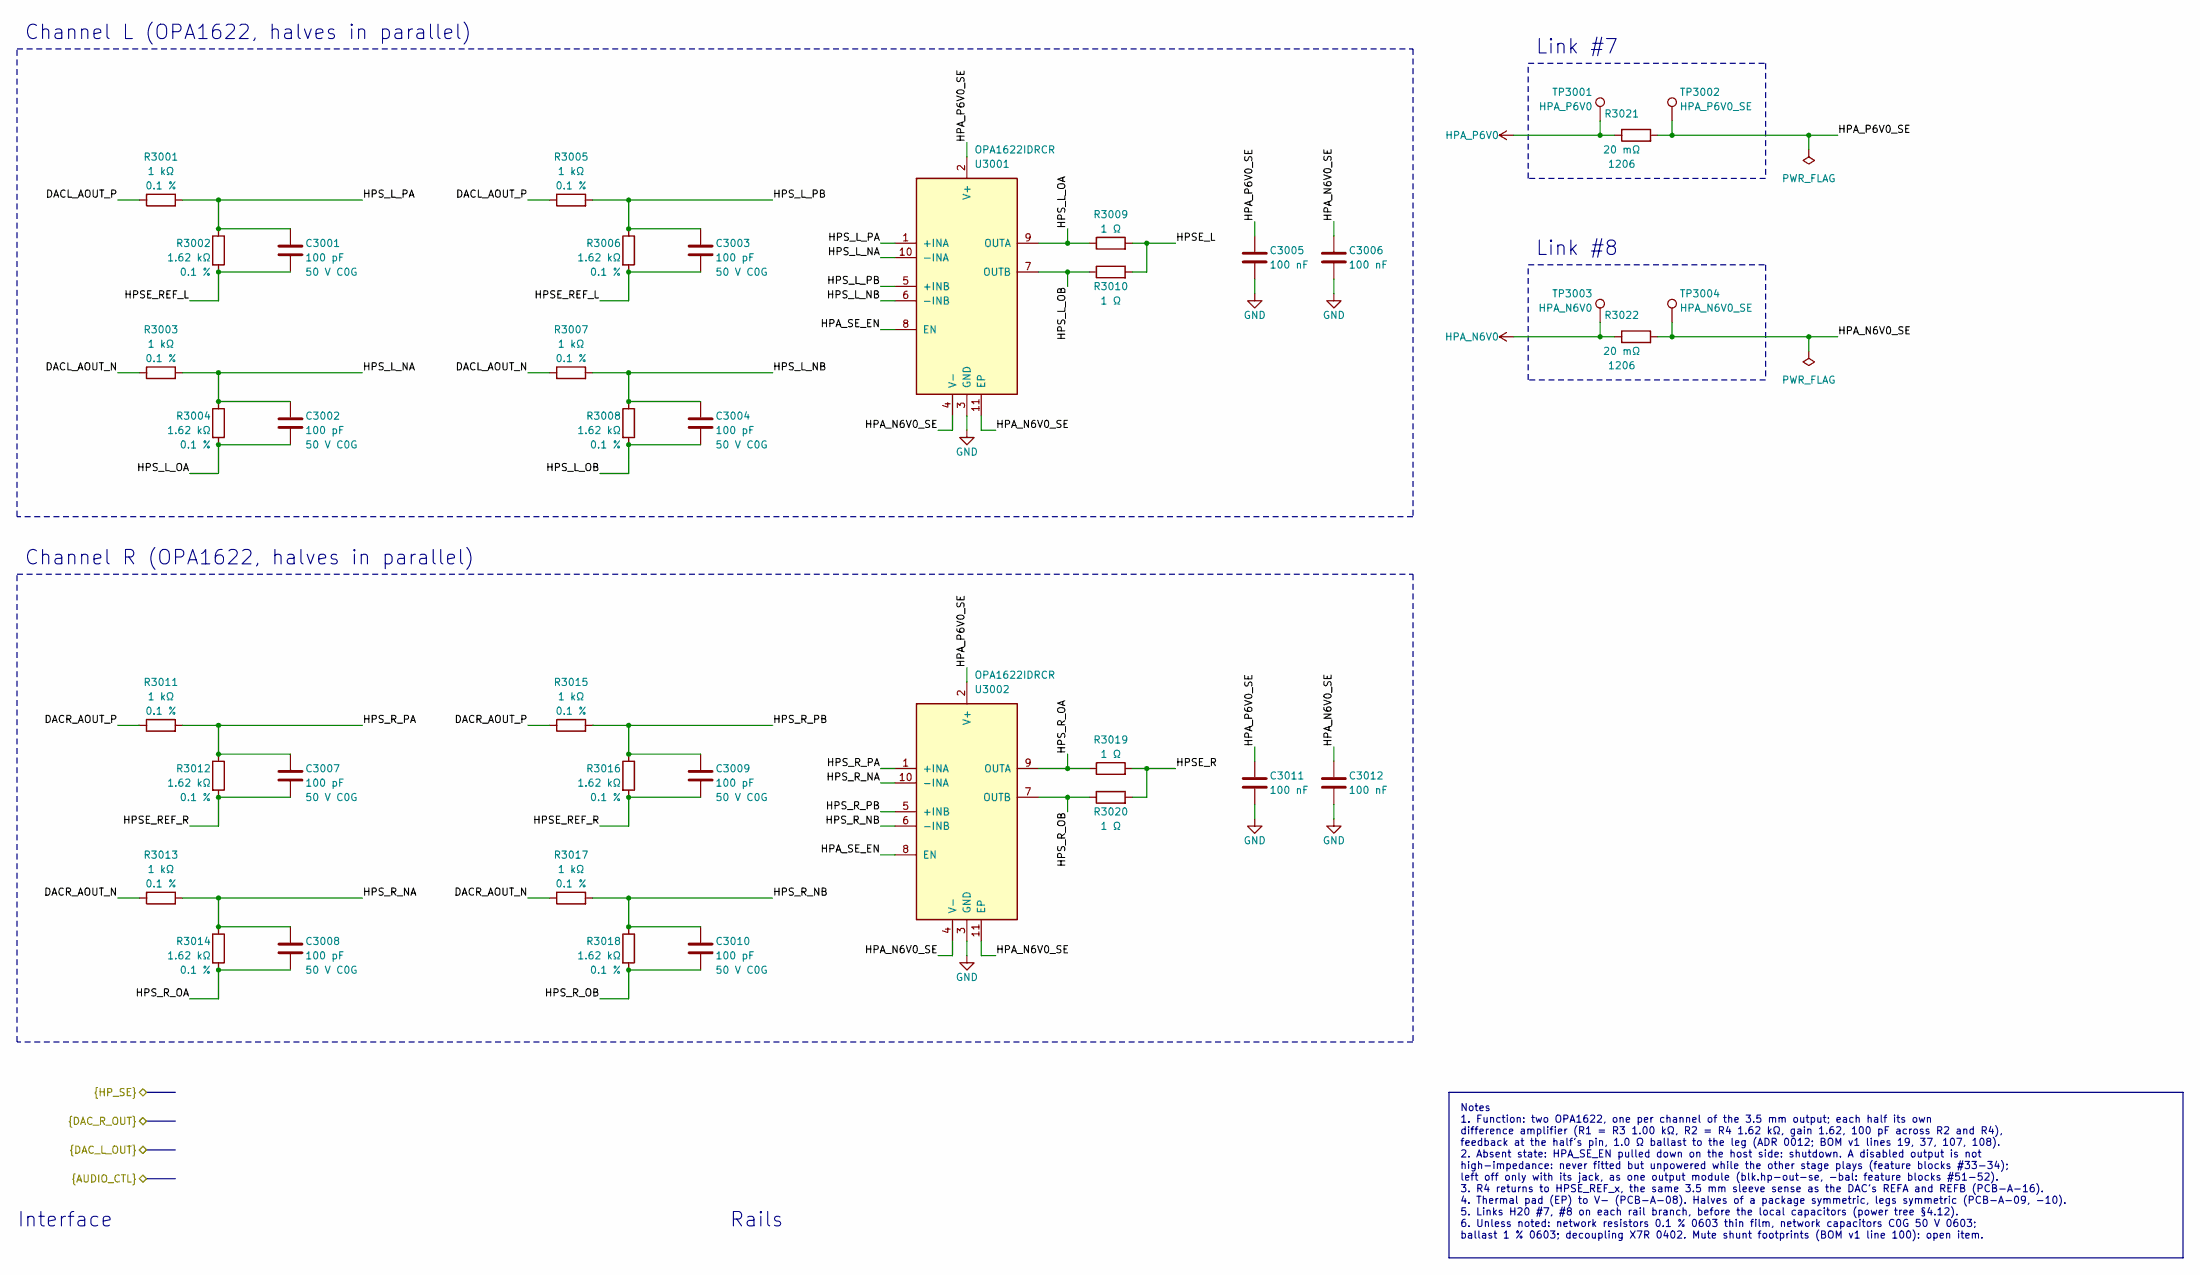
[picture p67: schematic hpa-se.kicad_sch, Audio: single-ended output stage]

Parts:
C3001, C3002, C3003, C3004, C3007, C3008, C3009, C3010: 100 pF; C_0603_1608Metric; MPN GRM1885C1H101JA01D
C3005, C3006, C3011, C3012: 100 nF; C_0402_1005Metric; MPN GRM155R71C104KA88D
R3001, R3003, R3005, R3007, R3011, R3013, R3015, R3017: 1 kΩ; R_0603_1608Metric; MPN RT0603BRD071KL
R3002, R3004, R3006, R3008, R3012, R3014, R3016, R3018: 1.62 kΩ; R_0603_1608Metric; MPN RT0603BRD071K62L
R3009, R3010, R3019, R3020: 1 Ω; R_0603_1608Metric; MPN RC0603FR-071RL
R3021, R3022: 20 mΩ; R_Vishay_WSL1206_6m-200m; MPN WSL1206R0200FEA
TP3001: HPA_P6V0; TestPoint_Pad_D1.0mm
TP3002: HPA_P6V0_SE; TestPoint_Pad_D1.0mm
TP3003: HPA_N6V0; TestPoint_Pad_D1.0mm
TP3004: HPA_N6V0_SE; TestPoint_Pad_D1.0mm
U3001, U3002: OPA1622IDRCR; VSON-10-1EP_3x3mm_P0.5mm_EP1.65x2.4mm_ThermalVias; MPN OPA1622IDRCR

Connections:
/Audio/Audio: single-ended output stage/HPA_N6V0_SE: C3006.1, C3012.1, R3022.2, TP3004.1, U3001.4 (V-), U3001.11 (EP), U3002.4 (V-), U3002.11 (EP)
/Audio/Audio: single-ended output stage/HPA_P6V0_SE: C3005.1, C3011.1, R3021.2, TP3002.1, U3001.2 (V+), U3002.2 (V+)
/Audio/Audio: single-ended output stage/HPS_L_NA: C3002.1, R3003.2, R3004.1, U3001.10 (-INA)
/Audio/Audio: single-ended output stage/HPS_L_NB: C3004.1, R3007.2, R3008.1, U3001.6 (-INB)
/Audio/Audio: single-ended output stage/HPS_L_OA: C3002.2, R3004.2, R3009.1, U3001.9 (OUTA)
/Audio/Audio: single-ended output stage/HPS_L_OB: C3004.2, R3008.2, R3010.1, U3001.7 (OUTB)
/Audio/Audio: single-ended output stage/HPS_L_PA: C3001.1, R3001.2, R3002.1, U3001.1 (+INA)
/Audio/Audio: single-ended output stage/HPS_L_PB: C3003.1, R3005.2, R3006.1, U3001.5 (+INB)
/Audio/Audio: single-ended output stage/HPS_R_NA: C3008.1, R3013.2, R3014.1, U3002.10 (-INA)
/Audio/Audio: single-ended output stage/HPS_R_NB: C3010.1, R3017.2, R3018.1, U3002.6 (-INB)
/Audio/Audio: single-ended output stage/HPS_R_OA: C3008.2, R3014.2, R3019.1, U3002.9 (OUTA)
/Audio/Audio: single-ended output stage/HPS_R_OB: C3010.2, R3018.2, R3020.1, U3002.7 (OUTB)
/Audio/Audio: single-ended output stage/HPS_R_PA: C3007.1, R3011.2, R3012.1, U3002.1 (+INA)
/Audio/Audio: single-ended output stage/HPS_R_PB: C3009.1, R3015.2, R3016.1, U3002.5 (+INB)
/Audio/DACL_AOUT_N: R3003.1, R3007.1; also elsewhere on the board
/Audio/DACL_AOUT_P: R3001.1, R3005.1; also elsewhere on the board
/Audio/DACR_AOUT_N: R3013.1, R3017.1; also elsewhere on the board
/Audio/DACR_AOUT_P: R3011.1, R3015.1; also elsewhere on the board
/HPA_SE_EN: U3001.8 (EN), U3002.8 (EN); also elsewhere on the board
/HPSE_L: R3009.2, R3010.2; also elsewhere on the board
/HPSE_R: R3019.2, R3020.2; also elsewhere on the board
/HPSE_REF_L: C3001.2, C3003.2, R3002.2, R3006.2; also elsewhere on the board
/HPSE_REF_R: C3007.2, C3009.2, R3012.2, R3016.2; also elsewhere on the board
GND: C3005.2, C3006.2, C3011.2, C3012.2, U3001.3 (GND), U3002.3 (GND); also elsewhere on the board
HPA_N6V0: R3022.1, TP3003.1; also elsewhere on the board
HPA_P6V0: R3021.1, TP3001.1; also elsewhere on the board

Notes on the sheet:
Channel L (OPA1622, halves in parallel)
Channel R (OPA1622, halves in parallel)
Link #7
Link #8
Notes 1. Function: two OPA1622, one per channel of the 3.5 mm output; each half its own difference amplifier (R1 = R3 1.00 kΩ, R2 = R4 1.62 kΩ, gain 1.62, 100 pF across R2 and R4), feedback at the half's pin, 1.0 Ω ballast to the leg (ADR 0012; BOM v1 lines 19, 37, 107, 108). 2. Absent state: HPA_S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
Interface
Rails

Schematic: hpa-bal.kicad_sch, Audio: balanced output stage

Parts:
R3101, R3102: 20 mΩ; R_Vishay_WSL1206_6m-200m; MPN WSL1206R0200FEA
TP3101: HPA_P6V0; TestPoint_Pad_D1.0mm
TP3102: HPA_P6V0_BAL; TestPoint_Pad_D1.0mm
TP3103: HPA_N6V0; TestPoint_Pad_D1.0mm
TP3104: HPA_N6V0_BAL; TestPoint_Pad_D1.0mm

Connections:
/Audio/Audio: balanced output stage/HPA_N6V0_BAL: R3102.2, TP3104.1; also elsewhere on the board
/Audio/Audio: balanced output stage/HPA_P6V0_BAL: R3101.2, TP3102.1; also elsewhere on the board
HPA_N6V0: R3102.1, TP3103.1; also elsewhere on the board
HPA_P6V0: R3101.1, TP3101.1; also elsewhere on the board

Notes on the sheet:
Link #9
Link #10
Notes 1. Function: four OPA1622, one per leg (L+, L-, R+, R-) of the 4.4 mm output, drawn on two sub-sheets (left and right channel); this sheet carries the H20 links #9 and #10 of their rails, before the local capacitors (power tree §4.12; ADR 0012). 2. Absent state: HPA_BAL_EN pulled down on the 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
Rails
Interface

Schematic: radio-module.kicad_sch, Radio: module

Parts:
C5001, C5002, C5003: 10 µF; C_0603_1608Metric; MPN GRM188R61A106KE69D
C5004: 100 nF; C_0201_0603Metric; MPN GRM033R61A104KE15D
R5001, R5002, R5003, R5004, R5005, R5006: 0 Ω; R_0402_1005Metric; MPN RC0402JR-070RL
U5001: LBES5PL2EL-923; Murata_Type2EL_LGA-107_8.8x7.7mm; MPN LBES5PL2EL-923

Connections:
/BT_UART_CTS: U5001.50 (UART_CTS); also elsewhere on the board
/BT_UART_RTS: U5001.52 (UART_RTS); also elsewhere on the board
/BT_UART_RXD: U5001.51 (UART_RX); also elsewhere on the board
/BT_UART_TXD: U5001.49 (UART_TX); also elsewhere on the board
/BT_WAKE_IN: U5001.75 (BT15.4_WAKE_IN); also elsewhere on the board
/BT_WAKE_OUT: U5001.76 (BT15.4_WAKE_OUT); also elsewhere on the board
/WL_ANT0: U5001.15 (ANT0); also elsewhere on the board
/WL_ANT1: U5001.23 (ANT1); also elsewhere on the board
/WL_BT_IN: U5001.18 (BT_15.4_IN); also elsewhere on the board
/WL_SD_CLK: R5002.1; also elsewhere on the board
/WL_SD_CMD: R5001.1; also elsewhere on the board
/WL_SD_D0: R5003.1; also elsewhere on the board
/WL_SD_D1: R5004.1; also elsewhere on the board
/WL_SD_D2: R5005.1; also elsewhere on the board
/WL_SD_D3: R5006.1; also elsewhere on the board
/WL_WAKE_OUT: U5001.73 (WL_WAKE_OUT); also elsewhere on the board
/Wi-Fi and Bluetooth module/Radio: module/WL_SD_CLK_M: R5002.2, U5001.44 (SD_CLK)
/Wi-Fi and Bluetooth module/Radio: module/WL_SD_CMD_M: R5001.2, U5001.42 (SD_CMD)
/Wi-Fi and Bluetooth module/Radio: module/WL_SD_D0_M: R5003.2, U5001.48 (SD_DAT[0])
/Wi-Fi and Bluetooth module/Radio: module/WL_SD_D1_M: R5004.2, U5001.45 (SD_DAT[1])
/Wi-Fi and Bluetooth module/Radio: module/WL_SD_D2_M: R5005.2, U5001.47 (SD_DAT[2])
/Wi-Fi and Bluetooth module/Radio: module/WL_SD_D3_M: R5006.2, U5001.46 (SD_DAT[3])
/Wi-Fi and Bluetooth module/WL_PD_N: U5001.10 (PDn); also elsewhere on the board
GND: C5001.2, C5002.2, C5003.2, C5004.2, U5001.1 (GND), U5001.2 (GND), U5001.9 (GND), U5001.11 (GND), U5001.14 (GND), U5001.16 (GND), U5001.17 (GND), U5001.19 (GND), U5001.20 (GND), U5001.21 (GND), U5001.22 (GND), U5001.28 (GND), U5001.29 (GND), U5001.32 (GND), U5001.39 (GND), U5001.41 (GND), U5001.43 (GND), U5001.53 (GND), U5001.62 (GND), U5001.67 (GND), U5001.68 (GND), U5001.71 (GND), U5001.81 (GND), U5001.82 (GND), U5001.83 (GND), U5001.84 (GND), U5001.85 (GND), U5001.86 (GND), U5001.87 (GND), U5001.88 (GND), U5001.89 (GND), U5001.90 (GND), U5001.91 (GND), U5001.92 (GND), U5001.93 (GND), U5001.94 (GND), U5001.95 (GND), U5001.96 (GND), U5001.97 (GND), U5001.98 (GND), U5001.99 (GND), U5001.100 (GND), U5001.101 (GND), U5001.102 (GND), U5001.103 (GND), U5001.104 (GND), U5001.105 (GND), U5001.106 (GND), U5001.107 (GND); also elsewhere on the board
vcc1v8_wl: C5002.1, U5001.30 (AVDD18_2), U5001.31 (AVDD18_1); also elsewhere on the board
vcc3v3_wl: C5001.1, U5001.12 (AVDD33_1), U5001.13 (AVDD33_2); also elsewhere on the board
vcc_1v8: C5003.1, C5004.1, U5001.40 (SD_VIO), U5001.54 (VIO), U5001.55 (CONFIG_HOST[0]), U5001.56 (CONFIG_HOST[1]); also elsewhere on the board

Notes on the sheet:
Murata Type 2EL, LBES5PL2EL-923 (BOM v1 line 55)
Module decoupling (E2B-09-1413 Figure 5)
SDIO series positions (E2B-09-1413 Figure 5 note 3)
Notes 1. Function: Murata Type 2EL (NXP IW612): Wi-Fi 6 on SDIO 3.0, Bluetooth 5.4 on UART1 with flow control; nxpwifi and btnxpuart (DKMS until Linux 7.3). 802.15.4 SPI not wired (T1-077). 2. Absent state: rails off (blk.radio-power), wake lines pulled to no wake by the SoC. 3. CONFIG_HOST[1:0] = 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
Interface
Rails

Schematic: radio-power.kicad_sch, Radio: rails and PDn hold

Parts:
C5101, C5102: 100 nF; C_0201_0603Metric; MPN GRM033R61A104KE15D
C5103: 1 µF; C_0402_1005Metric; MPN GRM155C71A105KE11D
C5104: 10 µF; C_0603_1608Metric; MPN C1608X7R1A106K080AC
C5105: 22 µF; C_0603_1608Metric; MPN GRM188R60J226MEA0D
C5106: 120 pF; C_0402_1005Metric; MPN GRM1555C1H121JA01D
L5101: 470 nH; L_Coilcraft_XxL4020; MPN XGL4015-471MEC
R5101, R5102, R5103, R5108: 100 kΩ; R_0201_0603Metric; MPN RC0201FR-07100KL
R5104, R5111: 20 mΩ; R_Vishay_WSL1206_6m-200m; MPN WSL1206R0200FEA
R5105: 200 kΩ; R_0603_1608Metric; MPN RC0603FR-07200KL
R5106: 100 kΩ; R_0603_1608Metric; MPN RC0603FR-07100KL
R5107: 0 Ω; R_0402_1005Metric; MPN RC0402JR-070RL
R5109: 0 Ω; R_0402_1005Metric; MPN RC0402JR-070RL; not fitted
R5110: 1 kΩ; R_0603_1608Metric; MPN RC0603FR-071KL; not fitted
TP5101: WL_3V3_SRC; TestPoint_Pad_D1.0mm
TP5102: vcc3v3_wl; TestPoint_Pad_D1.0mm
TP5103: WL_1V8_SRC; TestPoint_Pad_D1.0mm
TP5104: vcc1v8_wl; TestPoint_Pad_D1.0mm
U5101: SN74AXC1T45DCKR; Texas_DCK0006A_SC-70-6_1.25x2mm_P0.65mm; MPN SN74AXC1T45DCKR
U5102: TPS22916CYFPR; Texas_YFP0004_DSBGA-4_0.78x0.78mm_Layout2x2_P0.4mm; MPN TPS22916CYFPR
U5103: TPS62826DMQR; Texas_DMQ0006A_VSON-HR-6_1.5x1.5mm_P0.5mm; MPN TPS62826DMQR

Connections:
/WL_PD_HOLD_N: R5102.1, U5101.3 (A); also elsewhere on the board
/WL_PWR_EN: R5103.1, U5102.B2 (ON); also elsewhere on the board
/Wi-Fi and Bluetooth module/Radio: rails and PDn hold/WL_1V8_EN: R5107.2, R5108.1, R5109.2, U5103.1 (EN)
/Wi-Fi and Bluetooth module/Radio: rails and PDn hold/WL_1V8_EN_GPIO: R5109.1
/Wi-Fi and Bluetooth module/Radio: rails and PDn hold/WL_1V8_FB: C5106.2, R5105.2, R5106.1, U5103.3 (FB)
/Wi-Fi and Bluetooth module/Radio: rails and PDn hold/WL_1V8_SRC: C5105.1, L5101.2, R5111.1, TP5103.1
/Wi-Fi and Bluetooth module/Radio: rails and PDn hold/WL_1V8_SW: L5101.1, U5103.5 (SW)
/Wi-Fi and Bluetooth module/Radio: rails and PDn hold/WL_3V3_SRC: R5104.1, TP5101.1, U5102.A1 (VOUT)
/Wi-Fi and Bluetooth module/WL_PD_N: R5101.1, U5101.4 (B); also elsewhere on the board
GND: C5101.2, C5102.2, C5103.2, C5104.2, C5105.2, R5101.2, R5102.2, R5103.2, R5106.2, R5108.2, R5110.2, U5101.2 (GND), U5102.B1 (GND), U5103.4 (GND); also elsewhere on the board
VSYS_LV: C5104.1, U5103.6 (VIN); also elsewhere on the board
vcc1v8_wl: C5102.1, C5106.1, R5105.1, R5111.2, TP5104.1, U5101.6 (VCCB); also elsewhere on the board
vcc3v3_sys: C5101.1, C5103.1, U5101.1 (VCCA), U5101.5 (DIR), U5102.A2 (VIN); also elsewhere on the board
vcc3v3_wl: R5104.2, R5107.1, R5110.1, TP5102.1; also elsewhere on the board

Notes on the sheet:
PDn hold translator: SN74AXC1T45 (line 148)
AVDD33 switch: TPS22916C (line 50)
Link #11
AVDD18 buck: TPS62826, 1.8 V (lines 129-131)
Inductor, EN option and discharge positions (lines 130, 131)
Link #12
Notes 1. Function: the module rails: vcc3v3_wl through a TPS22916C on WL_PWR_EN, vcc1v8_wl from a TPS62826 enabled by vcc3v3_wl, links #11 and #12 (power tree §4.12), and the PDn hold. 2. Absent state: WL_PWR_EN low: vcc3v3_wl off and the AVDD18 buck with it (EN from vcc3v3_wl); PDn low through the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
Interface
Rails

Schematic: rp2354-core.kicad_sch, Coprocessor: RP2354A

Parts:
C3501: 100 nF; C_0201_0603Metric; MPN GRM033R61A104KE15D
Q3501: DMG1012T; SOT-523; MPN DMG1012T-7
R3501: 4.7 kΩ; R_0201_0603Metric; MPN RC0201FR-074K7L
R3502, R3503: 27 Ω; R_0201_0603Metric; MPN RC0201FR-0727RL
R3504, R3505, R3506, R3507, R3508: 0 Ω; R_0402_1005Metric; MPN RC0402JR-070RL
R3509: 1 kΩ; R_0201_0603Metric; MPN RC0201FR-071KL
TP3501: RP_SWCLK; TestPoint_Pad_D0.8mm
TP3502: RP_SWDIO; TestPoint_Pad_D0.8mm
TP3503: RP_RUN; TestPoint_Pad_D0.8mm
TP3504: RP_QSPI_SS; TestPoint_Pad_D0.8mm
TP3505: RP_SPARE; TestPoint_Pad_D0.8mm
U3501: RP2354A; QFN-60-1EP_7x7mm_P0.4mm_EP3.4x3.4mm_ThermalVias; MPN RP2354A
Y3501: 12 MHz; Oscillator_SMD_ECS_ECS-2016MV-4Pin_2.0x1.6mm; MPN ECS-2016MV-120-BN-TR

Connections:
/Coprocessor/Coprocessor: RP2354A/RP_BOOTSEL_D: Q3501.3 (D), R3509.2
/Coprocessor/Coprocessor: RP2354A/RP_QSPI_SS: R3509.1, TP3504.1, U3501.60 (QSPI_SS)
/Coprocessor/Coprocessor: RP2354A/RP_SPARE: TP3505.1, U3501.5 (GPIO3)
/Coprocessor/Coprocessor: RP2354A/RP_TAP_BCLK: R3504.2, U3501.7 (GPIO4)
/Coprocessor/Coprocessor: RP2354A/RP_TAP_DSD_L: R3507.2, U3501.10 (GPIO7)
/Coprocessor/Coprocessor: RP2354A/RP_TAP_DSD_R: R3508.2, U3501.12 (GPIO8)
/Coprocessor/Coprocessor: RP2354A/RP_TAP_LRCK: R3505.2, U3501.8 (GPIO5)
/Coprocessor/Coprocessor: RP2354A/RP_TAP_SDO0: R3506.2, U3501.9 (GPIO6)
/Coprocessor/Coprocessor: RP2354A/RP_USB_DM_R: R3503.2, U3501.51 (USB_DM)
/Coprocessor/Coprocessor: RP2354A/RP_USB_DP_R: R3502.2, U3501.52 (USB_DP)
/Coprocessor/Coprocessor: RP2354A/RP_XIN: U3501.21 (XIN), Y3501.3 (OUTPUT)
/DSD_L: R3507.1; also elsewhere on the board
/DSD_R: R3508.1; also elsewhere on the board
/I2S_BCLK: R3504.1; also elsewhere on the board
/I2S_LRCK: R3505.1; also elsewhere on the board
/I2S_SDO0: R3506.1; also elsewhere on the board
/RP_BOOTSEL_DRV: Q3501.1 (G); also elsewhere on the board
/RP_IRQ: U3501.4 (GPIO2); also elsewhere on the board
/RP_RUN: R3501.2, TP3503.1, U3501.26 (RUN); also elsewhere on the board
/RP_SWCLK: TP3501.1, U3501.24 (SWCLK); also elsewhere on the board
/RP_SWDIO: TP3502.1, U3501.25 (SWDIO); also elsewhere on the board
/RP_UART_RX: U3501.3 (GPIO1); also elsewhere on the board
/RP_UART_TX: U3501.2 (GPIO0); also elsewhere on the board
/RP_USB_DM: R3503.1; also elsewhere on the board
/RP_USB_DP: R3502.1; also elsewhere on the board
GND: C3501.2, Q3501.2 (S), Y3501.2 (GND); also elsewhere on the board
RP_IOVDD_1V8: C3501.1, R3501.1, Y3501.4 (VDD); also elsewhere on the board

Notes on the sheet:
RP2354A system: RUN, SWD, clock, BOOTSEL, USB (BOM v1 line 12)
RP2354A GPIO (pinout v1 §3 allocation)
12 MHz oscillator on RP_IOVDD_1V8 (BOM v1 line 14)
Test pads (BOM v1 line 89; PCB-T-09)
Tap 0 Ω positions (BOM v1 line 134; PCB-A-12)
BOOTSEL: N-FET on QSPI_SS (BOM v1 line 35; pinout v1 C6)
Notes 1. Function: RP2354A system and GPIO units (BRD-014, should; BRD-015, BRD-041): UART0 and RP_IRQ to the SoC, SWD and RUN from it, BOOTSEL, USB to USB_HOST2, passive I2S/DSD taps. 2. Absent state: unfitted or unpowered: RP_IRQ and RP_BOOTSEL_DRV held low on the host side (blk.soc-vccio-b); UAR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
Interface
Rails

Schematic: rp2354-power.kicad_sch, Coprocessor: supplies

Parts:
C3502, C3503, C3504, C3505, C3506, C3507, C3509, C3510, C3511, C3513, C3514: 100 nF; C_0201_0603Metric; MPN GRM033R61A104KE15D
C3508, C3512, C3515: 4.7 µF; C_0402_1005Metric; MPN GRM155R60J475ME47D
C3516, C3517: 1 µF; C_0402_1005Metric; MPN GRM155C71A105KE11D
L3501: 3.3 µH; L_Abracon_AOTA-B201610; MPN AOTA-B201610S3R3-101-T
R3510: 33 Ω; R_0201_0603Metric; MPN RC0201FR-0733RL
R3511: 100 mΩ; R_0603_1608Metric; MPN RL0603FR-070R1L
R3512: 1 Ω; R_0603_1608Metric; MPN RC0603FR-071RL
TP3506: RP_3V3_SRC; TestPoint_Pad_D1.0mm
TP3507: RP_3V3; TestPoint_Pad_D1.0mm
TP3508: RP_IOVDD_1V8_SRC; TestPoint_Pad_D1.0mm
TP3509: RP_IOVDD_1V8; TestPoint_Pad_D1.0mm
U3501: RP2354A; QFN-60-1EP_7x7mm_P0.4mm_EP3.4x3.4mm_ThermalVias; MPN RP2354A
U3502, U3503: TPS22916CYFPR; Texas_YFP0004_DSBGA-4_0.78x0.78mm_Layout2x2_P0.4mm; MPN TPS22916CYFPR

Connections:
/Coprocessor/Coprocessor: supplies/RP_3V3_SRC: R3511.1, TP3506.1, U3502.A1 (VOUT)
/Coprocessor/Coprocessor: supplies/RP_DVDD: C3512.1, C3513.1, C3514.1, L3501.2, U3501.6 (DVDD), U3501.23 (DVDD), U3501.39 (DVDD), U3501.50 (VREG_FB)
/Coprocessor/Coprocessor: supplies/RP_IOVDD_1V8_SRC: R3512.1, TP3508.1, U3503.A1 (VOUT)
/Coprocessor/Coprocessor: supplies/RP_VREG_AVDD: C3515.1, R3510.2, U3501.46 (VREG_AVDD)
/Coprocessor/Coprocessor: supplies/RP_VREG_SW: L3501.1, U3501.48 (VREG_LX)
/RP_PWR_EN: U3502.B2 (ON), U3503.B2 (ON); also elsewhere on the board
GND: C3502.2, C3503.2, C3504.2, C3505.2, C3506.2, C3507.2, C3508.2, C3509.2, C3510.2, C3511.2, C3512.2, C3513.2, C3514.2, C3515.2, C3516.2, C3517.2, U3501.47 (VREG_PGND), U3501.EP (GND), U3502.B1 (GND), U3503.B1 (GND); also elsewhere on the board
RP_3V3: C3508.1, C3509.1, C3510.1, C3511.1, R3510.1, R3511.2, TP3507.1, U3501.44 (ADC_AVDD), U3501.49 (VREG_VIN), U3501.53 (USB_OTP_VDD), U3501.54 (QSPI_IOVDD)
RP_IOVDD_1V8: C3502.1, C3503.1, C3504.1, C3505.1, C3506.1, C3507.1, R3512.2, TP3509.1, U3501.1 (IOVDD), U3501.11 (IOVDD), U3501.20 (IOVDD), U3501.30 (IOVDD), U3501.38 (IOVDD), U3501.45 (IOVDD); also elsewhere on the board
vcc3v3_sys: C3516.1, U3502.A2 (VIN); also elsewhere on the board
vcc_1v8: C3517.1, U3503.A2 (VIN); also elsewhere on the board

Notes on the sheet:
RP2354A supplies, core regulator (DS §6.1, §6.3.8; HDG §2.2.1)
RP_3V3 switch (BOM v1 line 50)
RP_IOVDD_1V8 switch (BOM v1 line 50)
Link #21
Link #30
Notes 1. Function: the RP2354A supply unit with its core regulator (3.3 µH, DS §6.3.8) and the two switched rails RP_3V3 (VREG, QSPI, USB, ADC) and RP_IOVDD_1V8 (IOVDD at 1.8 V, BOM v1 line 12). 2. Absent state: RP_PWR_EN low: both switches off (QOD discharges), the part unpowered. 3. VREG_VIN and 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
Interface
Rails

Schematic: hpa-rails-pre.kicad_sch, Amplifier rails: +-7 V pre-rails

Parts:
C2801: 15 pF; C_0402_1005Metric; MPN GRM1555C1H150JA01D
C2802: 10 nF; C_0402_1005Metric; MPN GRM1555C1H103JA01D
C2803: 220 nF; C_0402_1005Metric; MPN GRM155R61A224KE19D
C2804, C2812: 100 nF; C_0402_1005Metric; MPN GRM155R71C104KA88D
C2805, C2806: 4.7 µF; C_0402_1005Metric; MPN GRM155R60J475ME47D
C2807, C2808, C2809, C2810, C2816: 4.7 µF; C_0805_2012Metric; MPN GRM21BR71E475KA73L
C2811: 22 pF; C_0402_1005Metric; MPN GRM1555C1H220JA01D
C2813: 1 µF; C_0402_1005Metric; MPN GRM155C71A105KE11D
C2814, C2815: 10 µF; C_0805_2012Metric; MPN GRM21BR61E106KA73L
C2817, C2818, C2819: 22 µF; C_1206_3216Metric; MPN GRM31CR71C226ME15L
D2801: PMEG2010AEH; D_SOD-123F; MPN PMEG2010AEH
L2801: 4.7 µH; L_Murata_DFE252012F; MPN DFE252012F-4R7M
L2802: 2.2 µH; L_Coilcraft_XxL4020; MPN XGL4020-222MEC
Q2801: DMG1012T; SOT-523; MPN DMG1012T-7
Q2802: DMP3099L; SOT-23; MPN DMP3099L-7
R2801: 100 Ω; R_0402_1005Metric; MPN RC0402FR-07100RL
R2802: 475 kΩ; R_0603_1608Metric; MPN RC0603FR-07475KL
R2803, R2805: 100 kΩ; R_0603_1608Metric; MPN RC0603FR-07100KL
R2804: 16.5 kΩ; R_0603_1608Metric; MPN RC0603FR-0716K5L
R2806, R2807, R2808: 100 kΩ; R_0402_1005Metric; MPN RC0402FR-07100KL
U2801: TPS65131RGER; Texas_RGE0024B_VQFN-24-1EP_4x4mm_P0.5mm_EP2.45x2.45mm_Therm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; MPN TPS65131RGER
U2802: LMR33630CRNXR; Texas_RNX0012B_VQFN-HR-12_2x3mm_P0.5mm; MPN LMR33630CRNXR

Connections:
/Audio/Audio: amplifier rails/Amplifier rails: +-7 V pre-rails/HPA_BOOST_CP: C2802.1, U2801.21 (CP)
/Audio/Audio: amplifier rails/Amplifier rails: +-7 V pre-rails/HPA_BOOST_FB: C2801.2, R2802.2, R2803.1, U2801.22 (FBP)
/Audio/Audio: amplifier rails/Amplifier rails: +-7 V pre-rails/HPA_BOOST_SW: D2801.2 (A), L2801.2, U2801.1 (INP), U2801.24 (INP)
/Audio/Audio: amplifier rails/Amplifier rails: +-7 V pre-rails/HPA_BOOST_VIN: C2804.1, R2801.2, U2801.4 (VIN), U2801.9 (PSP)
/Audio/Audio: amplifier rails/Amplifier rails: +-7 V pre-rails/HPA_BOOST_VREF: C2803.1, U2801.17 (VREF)
/Audio/Audio: amplifier rails/Amplifier rails: +-7 V pre-rails/HPA_N7_BOOT: C2812.1, U2802.4 (BOOT)
/Audio/Audio: amplifier rails/Amplifier rails: +-7 V pre-rails/HPA_N7_EN: R2807.2, R2808.1, U2802.9 (EN)
/Audio/Audio: amplifier rails/Amplifier rails: +-7 V pre-rails/HPA_N7_FB: C2811.1, R2804.2, R2805.1, U2802.7 (FB)
/Audio/Audio: amplifier rails/Amplifier rails: +-7 V pre-rails/HPA_N7_LS_D: Q2802.2 (S), R2807.1
/Audio/Audio: amplifier rails/Amplifier rails: +-7 V pre-rails/HPA_N7_LS_G: Q2801.3 (D), Q2802.1 (G), R2806.2
/Audio/Audio: amplifier rails/Amplifier rails: +-7 V pre-rails/HPA_N7_SW: C2812.2, L2802.1, U2802.12 (SW)
/Audio/Audio: amplifier rails/Amplifier rails: +-7 V pre-rails/HPA_N7_VCC: C2813.1, U2802.5 (VCC)
/HPA_RAIL_EN: Q2801.1 (G), U2801.8 (ENP); also elsewhere on the board
AUDIO_N7V0: C2813.2, C2814.2, C2815.2, C2817.1, C2818.1, C2819.1, R2804.1, R2808.2, U2802.1 (PGND), U2802.6 (AGND), U2802.11 (PGND); also elsewhere on the board
AUDIO_P7V0: C2801.1, C2807.1, C2808.1, C2809.1, C2810.1, D2801.1 (K), R2802.1, U2801.23 (VPOS); also elsewhere on the board
GND: C2802.2, C2803.2, C2804.2, C2805.2, C2806.2, C2807.2, C2808.2, C2809.2, C2810.2, C2811.2, C2816.2, C2817.2, C2818.2, C2819.2, L2802.2, Q2801.2 (S), R2803.2, R2805.2, U2801.2 (PGND), U2801.3 (PGND), U2801.10 (ENN), U2801.11 (PSN), U2801.15 (VNEG), U2801.16 (FBN), U2801.19 (AGND), U2801.25 (EP); also elsewhere on the board
VSYS_AUDIO: C2814.1, C2815.1, C2816.1, Q2802.3 (D), R2806.1, U2802.2 (VIN), U2802.10 (VIN); also elsewhere on the board
VSYS_LV_AUDIO: C2805.1, C2806.1, L2801.1, R2801.1, U2801.5 (INN), U2801.6 (INN); also elsewhere on the board

Notes on the sheet:
+7 V pre-rail: TPS65131 boost (ADR 0015 item 2)
-7 V pre-rail: LMR33630C inverting buck-boost (ADR 0015 item 1)
-7 V enable level shifter (SNVA856B Fig. 7-1)
Notes 1. Function: AUDIO_P7V0 (TPS65131 boost from VSYS_LV_AUDIO, 475 kΩ / 100 kΩ: 6.97 V), AUDIO_N7V0 (LMR33630C inverting buck-boost from VSYS_AUDIO, IC ground = -7 V, 100 kΩ / 16.5 kΩ: -7.06 V), then HPA_P6V0 / HPA_N6V0 from two LT3045 and two LT3094 in parallel (ADR 0015; BOM lines 22-26, 116-1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
Interface
Rails

Schematic: hpa-rails-ldo.kicad_sch, Amplifier rails: +-6 V LDOs

Parts:
C2901, C2905: 4.7 µF; C_0805_2012Metric; MPN GRM21BR71C475KA73L
C2902, C2903, C2904, C2906, C2907, C2908, C2911, C2912, C2913, C2914, C2915, C2916, C2917, C2918, C2919, C2920, C2921, C2922: 22 µF; C_0805_2012Metric; MPN GRM219R61C226ME15L
C2909, C2910, C2923, C2924: 470 nF; C_0603_1608Metric; MPN GRM188R71C474KA88D
NT2901, NT2902, NT2903, NT2904: 20 mΩ trace; NetTie-2_SMD_Pad0.5mm
R2901, R2902: 523 Ω; R_0603_1608Metric; MPN RC0603FR-07523RL
R2903, R2904, R2907, R2908: 60.4 kΩ; R_0603_1608Metric; MPN RT0603BRD0760K4L
R2905, R2906: 13 kΩ; R_0603_1608Metric; MPN RC0603FR-0713KL
U2901, U2902: LT3045EDD; Analog_DD_DFN-10-1EP_3x3mm_P0.5mm_EP1.65x2.38mm; MPN LT3045EDD#TRPBF
U2903, U2904: LT3094EDD; Analog_DD_DFN-12-1EP_3x3mm_P0.45mm_EP1.65x2.38mm; MPN LT3094EDD#TRPBF

Connections:
/Audio/Audio: amplifier rails/Amplifier rails: +-6 V LDOs/HPA_N6_A: C2914.1, C2915.1, C2916.1, NT2903.1, U2903.10 (OUTS), U2903.11 (OUT), U2903.12 (OUT)
/Audio/Audio: amplifier rails/Amplifier rails: +-6 V LDOs/HPA_N6_A_ILIM: R2905.1, U2903.6 (ILIM)
/Audio/Audio: amplifier rails/Amplifier rails: +-6 V LDOs/HPA_N6_B: C2920.1, C2921.1, C2922.1, NT2904.1, U2904.10 (OUTS), U2904.11 (OUT), U2904.12 (OUT)
/Audio/Audio: amplifier rails/Amplifier rails: +-6 V LDOs/HPA_N6_B_ILIM: R2906.1, U2904.6 (ILIM)
/Audio/Audio: amplifier rails/Amplifier rails: +-6 V LDOs/HPA_N6_SET: C2923.1, C2924.1, R2907.1, R2908.1, U2903.8 (SET), U2904.8 (SET)
/Audio/Audio: amplifier rails/Amplifier rails: +-6 V LDOs/HPA_P6_A: C2902.1, C2903.1, C2904.1, NT2901.1, U2901.9 (OUTS), U2901.10 (OUT)
/Audio/Audio: amplifier rails/Amplifier rails: +-6 V LDOs/HPA_P6_A_ILIM: R2901.1, U2901.5 (ILIM)
/Audio/Audio: amplifier rails/Amplifier rails: +-6 V LDOs/HPA_P6_B: C2906.1, C2907.1, C2908.1, NT2902.1, U2902.9 (OUTS), U2902.10 (OUT)
/Audio/Audio: amplifier rails/Amplifier rails: +-6 V LDOs/HPA_P6_B_ILIM: R2902.1, U2902.5 (ILIM)
/Audio/Audio: amplifier rails/Amplifier rails: +-6 V LDOs/HPA_P6_SET: C2909.1, C2910.1, R2903.1, R2904.1, U2901.7 (SET), U2902.7 (SET)
/HPA_LDO_EN: U2901.3 (EN/UV), U2902.3 (EN/UV), U2903.3 (EN/UV), U2904.3 (EN/UV); also elsewhere on the board
AUDIO_N7V0: C2911.1, C2912.1, C2913.1, C2917.1, C2918.1, C2919.1, U2903.1 (IN), U2903.2 (IN), U2903.5 (PGFB), U2903.13 (IN), U2904.1 (IN), U2904.2 (IN), U2904.5 (PGFB), U2904.13 (IN); also elsewhere on the board
AUDIO_P7V0: C2901.1, C2905.1, U2901.1 (IN), U2901.2 (IN), U2901.6 (PGFB), U2902.1 (IN), U2902.2 (IN), U2902.6 (PGFB); also elsewhere on the board
GND: C2901.2, C2902.2, C2903.2, C2904.2, C2905.2, C2906.2, C2907.2, C2908.2, C2909.2, C2910.2, C2911.2, C2912.2, C2913.2, C2914.2, C2915.2, C2916.2, C2917.2, C2918.2, C2919.2, C2920.2, C2921.2, C2922.2, C2923.2, C2924.2, R2901.2, R2902.2, R2903.2, R2904.2, R2905.2, R2906.2, R2907.2, R2908.2, U2901.8 (GND), U2901.11 (GND), U2902.8 (GND), U2902.11 (GND), U2903.9 (GND), U2904.9 (GND); also elsewhere on the board
HPA_N6V0: NT2903.2, NT2904.2; also elsewhere on the board
HPA_P6V0: NT2901.2, NT2902.2; also elsewhere on the board

Notes on the sheet:
+6 V: two LT3045 in parallel (ADR 0015 item 3)
-6 V: two LT3094 in parallel (ADR 0015 item 3)
Notes 1. Function: HPA_P6V0 from two LT3045 and HPA_N6V0 from two LT3094 in parallel, as both ADI datasheets describe (LT3045 p. 21 Fig. 7, LT3094 p. 25 Fig. 15; ADR 0015 item 3). 2. Absent state: HPA_LDO_EN pulled down: the four LDOs off; enabled >= 10 ms after HPA_RAIL_EN. 3. SET tied per rail, R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
Interface
Rails

Schematic: hpa-bal-l.kicad_sch, Balanced output stage: left channel

Parts:
C3201, C3202, C3203, C3204, C3207, C3208, C3209, C3210: 100 pF; C_0603_1608Metric; MPN GRM1885C1H101JA01D
C3205, C3206, C3211, C3212: 100 nF; C_0402_1005Metric; MPN GRM155R71C104KA88D
R3201, R3203, R3205, R3207, R3211, R3213, R3215, R3217: 1 kΩ; R_0603_1608Metric; MPN RT0603BRD071KL
R3202, R3204, R3206, R3208, R3212, R3214, R3216, R3218: 1.62 kΩ; R_0603_1608Metric; MPN RT0603BRD071K62L
R3209, R3210, R3219, R3220: 1 Ω; R_0603_1608Metric; MPN RC0603FR-071RL
U3201, U3202: OPA1622IDRCR; VSON-10-1EP_3x3mm_P0.5mm_EP1.65x2.4mm_ThermalVias; MPN OPA1622IDRCR

Connections:
/Audio/Audio: balanced output stage/Balanced output stage: left channel/HPB_LN_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: C3208.1, R3213.2, R3214.1, U3202.10 (-INA)
/Audio/Audio: balanced output stage/Balanced output stage: left channel/HPB_LN_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: C3210.1, R3217.2, R3218.1, U3202.6 (-INB)
/Audio/Audio: balanced output stage/Balanced output stage: left channel/HPB_LN_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: C3208.2, R3214.2, R3219.1, U3202.9 (OUTA)
/Audio/Audio: balanced output stage/Balanced output stage: left channel/HPB_LN_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: C3210.2, R3218.2, R3220.1, U3202.7 (OUTB)
/Audio/Audio: balanced output stage/Balanced output stage: left channel/HPB_LN_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: C3207.1, R3211.2, R3212.1, U3202.1 (+INA)
/Audio/Audio: balanced output stage/Balanced output stage: left channel/HPB_LN_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: C3209.1, R3215.2, R3216.1, U3202.5 (+INB)
/Audio/Audio: balanced output stage/Balanced output stage: left channel/HPB_LP_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: C3202.1, R3203.2, R3204.1, U3201.10 (-INA)
/Audio/Audio: balanced output stage/Balanced output stage: left channel/HPB_LP_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: C3204.1, R3207.2, R3208.1, U3201.6 (-INB)
/Audio/Audio: balanced output stage/Balanced output stage: left channel/HPB_LP_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: C3202.2, R3204.2, R3209.1, U3201.9 (OUTA)
/Audio/Audio: balanced output stage/Balanced output stage: left channel/HPB_LP_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: C3204.2, R3208.2, R3210.1, U3201.7 (OUTB)
/Audio/Audio: balanced output stage/Balanced output stage: left channel/HPB_LP_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: C3201.1, R3201.2, R3202.1, U3201.1 (+INA)
/Audio/Audio: balanced output stage/Balanced output stage: left channel/HPB_LP_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: C3203.1, R3205.2, R3206.1, U3201.5 (+INB)
/Audio/Audio: balanced output stage/HPA_N6V0_BAL: C3206.1, C3212.1, U3201.4 (V-), U3201.11 (EP), U3202.4 (V-), U3202.11 (EP); also elsewhere on the board
/Audio/Audio: balanced output stage/HPA_P6V0_BAL: C3205.1, C3211.1, U3201.2 (V+), U3202.2 (V+); also elsewhere on the board
/Audio/DACL_AOUT_N: R3203.1, R3207.1, R3211.1, R3215.1; also elsewhere on the board
/Audio/DACL_AOUT_P: R3201.1, R3205.1, R3213.1, R3217.1; also elsewhere on the board
/HPA_BAL_EN: U3201.8 (EN), U3202.8 (EN); also elsewhere on the board
/HPBAL_L_N: R3219.2, R3220.2; also elsewhere on the board
/HPBAL_L_P: R3209.2, R3210.2; also elsewhere on the board
GND: C3201.2, C3203.2, C3205.2, C3206.2, C3207.2, C3209.2, C3211.2, C3212.2, R3202.2, R3206.2, R3212.2, R3216.2, U3201.3 (GND), U3202.3 (GND); also elsewhere on the board

Notes on the sheet:
Leg L+ (OPA1622, halves in parallel)
Leg L- (OPA1622, halves in parallel)
Notes 1. Function: two OPA1622, one per leg of the right channel of the 4.4 mm output; each half its own difference amplifier (R1 = R3 1.00 kΩ, R2 = R4 1.62 kΩ, gain 1.62, 100 pF across R2 and R4), feedback at the half's pin, 1.0 Ω ballast to the leg (ADR 0012; BOM v1 lines 19, 37, 107, 108). 2. Ab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
Interface
Rails

Schematic: hpa-bal-r.kicad_sch, Balanced output stage: right channel

Parts:
C3301, C3302, C3303, C3304, C3307, C3308, C3309, C3310: 100 pF; C_0603_1608Metric; MPN GRM1885C1H101JA01D
C3305, C3306, C3311, C3312: 100 nF; C_0402_1005Metric; MPN GRM155R71C104KA88D
R3301, R3303, R3305, R3307, R3311, R3313, R3315, R3317: 1 kΩ; R_0603_1608Metric; MPN RT0603BRD071KL
R3302, R3304, R3306, R3308, R3312, R3314, R3316, R3318: 1.62 kΩ; R_0603_1608Metric; MPN RT0603BRD071K62L
R3309, R3310, R3319, R3320: 1 Ω; R_0603_1608Metric; MPN RC0603FR-071RL
U3301, U3302: OPA1622IDRCR; VSON-10-1EP_3x3mm_P0.5mm_EP1.65x2.4mm_ThermalVias; MPN OPA1622IDRCR

Connections:
/Audio/Audio: balanced output stage/Balanced output stage: right channel/HPB_RN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: C3308.1, R3313.2, R3314.1, U3302.10 (-INA)
/Audio/Audio: balanced output stage/Balanced output stage: right channel/HPB_RN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: C3310.1, R3317.2, R3318.1, U3302.6 (-INB)
/Audio/Audio: balanced output stage/Balanced output stage: right channel/HPB_RN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: C3308.2, R3314.2, R3319.1, U3302.9 (OUTA)
/Audio/Audio: balanced output stage/Balanced output stage: right channel/HPB_RN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: C3310.2, R3318.2, R3320.1, U3302.7 (OUTB)
/Audio/Audio: balanced output stage/Balanced output stage: right channel/HPB_RN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: C3307.1, R3311.2, R3312.1, U3302.1 (+INA)
/Audio/Audio: balanced output stage/Balanced output stage: right channel/HPB_RN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: C3309.1, R3315.2, R3316.1, U3302.5 (+INB)
/Audio/Audio: balanced output stage/Balanced output stage: right channel/HPB_RP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: C3302.1, R3303.2, R3304.1, U3301.10 (-INA)
/Audio/Audio: balanced output stage/Balanced output stage: right channel/HPB_RP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: C3304.1, R3307.2, R3308.1, U3301.6 (-INB)
/Audio/Audio: balanced output stage/Balanced output stage: right channel/HPB_RP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: C3302.2, R3304.2, R3309.1, U3301.9 (OUTA)
/Audio/Audio: balanced output stage/Balanced output stage: right channel/HPB_RP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: C3304.2, R3308.2, R3310.1, U3301.7 (OUTB)
/Audio/Audio: balanced output stage/Balanced output stage: right channel/HPB_RP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: C3301.1, R3301.2, R3302.1, U3301.1 (+INA)
/Audio/Audio: balanced output stage/Balanced output stage: right channel/HPB_RP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: C3303.1, R3305.2, R3306.1, U3301.5 (+INB)
/Audio/Audio: balanced output stage/HPA_N6V0_BAL: C3306.1, C3312.1, U3301.4 (V-), U3301.11 (EP), U3302.4 (V-), U3302.11 (EP); also elsewhere on the board
/Audio/Audio: balanced output stage/HPA_P6V0_BAL: C3305.1, C3311.1, U3301.2 (V+), U3302.2 (V+); also elsewhere on the board
/Audio/DACR_AOUT_N: R3303.1, R3307.1, R3311.1, R3315.1; also elsewhere on the board
/Audio/DACR_AOUT_P: R3301.1, R3305.1, R3313.1, R3317.1; also elsewhere on the board
/HPA_BAL_EN: U3301.8 (EN), U3302.8 (EN); also elsewhere on the board
/HPBAL_R_N: R3319.2, R3320.2; also elsewhere on the board
/HPBAL_R_P: R3309.2, R3310.2; also elsewhere on the board
GND: C3301.2, C3303.2, C3305.2, C3306.2, C3307.2, C3309.2, C3311.2, C3312.2, R3302.2, R3306.2, R3312.2, R3316.2, U3301.3 (GND), U3302.3 (GND); also elsewhere on the board

Notes on the sheet:
Leg R+ (OPA1622, halves in parallel)
Leg R- (OPA1622, halves in parallel)
Notes 1. Function: two OPA1622, one per leg of the right channel of the 4.4 mm output; each half its own difference amplifier (R1 = R3 1.00 kΩ, R2 = R4 1.62 kΩ, gain 1.62, 100 pF across R2 and R4), feedback at the half's pin, 1.0 Ω ballast to the leg (ADR 0012; BOM v1 lines 19, 37, 107, 108). 2. Ab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
Interface
Rails

Board: 6 copper layers, 1008 parts (279 on the bottom side), 600 nets, no tracks yet.

Other parts of the board:
FID1, FID2, FID3, FID4, FID5, FID6, FID7, FID8: Fiducial; Fiducial_1mm_Mask2mm
H1, H2, H3, H4: MountingHole_2.2mm
