opendap-project/t1/board/hardware/rules/test/t1-main-board-rules-test.kicad_pcb

## KiCad design board/hardware/rules/test/t1-main-board-rules-test.kicad_pcb (2026-10-29)

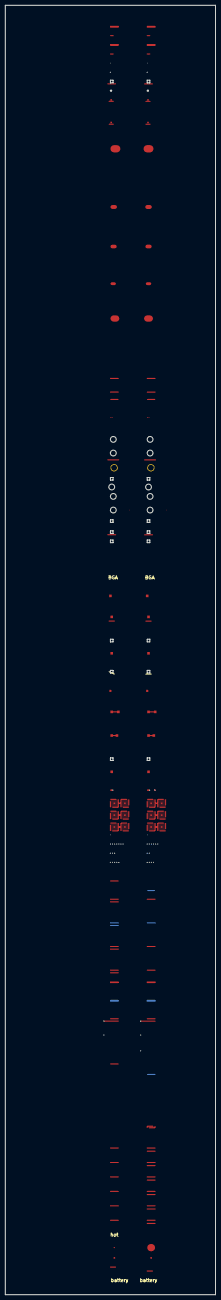
[picture p68: board t1-main-board-rules-test.kicad_pcb from above]

Board: 6 copper layers, 80.0 x 490.7 mm, 74 parts (0 on the bottom side), 10 nets.

Parts:
C1, C2, C3, C4, C5, C6: test
D1, D2: test
FID1, FID2: test
H1, H2, H3, H4, H5, H6, H7, H8, H9, H10, H11, H12, H13, H14: test
R1, R2, R3, R4, R5, R6, R7, R8, R9, R10, R11, R12, R13, R14, R15, R16, R17, R18, R19, R20, R21, R22, R23, R24, R25, R26, R27: test
TP1, TP2, TP3, TP4, TP5, TP6, TP7, TP8, TP9, TP10, TP11, TP12, TP13, TP14: test
U1, U2, U3, U4, U5, U6, U7, U8, U9: test

Connections:
DDR_50SE_1: R18.1, R19.1
DDR_50SE_2: R20.1, R21.1
N49: TP7.1, TP8.1
N50: TP9.1, TP10.1
N51: R9.1, TP11.1
N52: R10.1, TP12.1
N58: R14.1, R15.1
N59: R16.1, R17.1
N60: R22.1, R23.1
N61: R24.1, R25.1
