opendap-project/t1/board/hardware/t1-main-board/generator/blocks_power.py

"""Power blocks: blk.pwr-vsys-lv (TPS62136), blk.pwr-3v3-sys (TPS62827), blk.vdd-cpu (TPS62870Z4)
and blk.pmic (RK809-5)."""

from __future__ import annotations

import library
from draw import corner_notes, decouple, gnd, hpart, link, link_variants, tp, two_pin_h, two_pin_v, vpart
from parts import PARTS, fields


def _inductor(s, key, x, y, net_l, net_r):
    return two_pin_h(s, key, x, y, net_l, net_r, s.block, prefix="L")


def _ic(s, lib, name, x, y, extra=None):
    sym = library.load(lib, name)
    ref = s.next_ref("U")
    f = {"Block": s.block}
    f.update(extra or {})
    pl = s.place(sym, ref, x, y, fields=f)
    return pl


# ---------------------------------------------------------------------- 3.8 V pre-regulator

def sheet_vsys_lv(proj):
    return proj.sheet("pwr-vsys-lv.kicad_sch", "blk.pwr-vsys-lv", "3.8 V pre-regulator",
                      "VSYS (2S battery or charger, 6.0-8.8 V) to the always-on VSYS_LV 3.8 V rail, 4 A", "A4")


def draw_vsys_lv(s, variants):
    """Hand-wired: the VSYS rail across the top, ground symbols on one baseline (CRAFT-83)."""
    blk = s.block
    m0 = s.mark()
    yr, yg = 45.72, 101.6                      # VSYS rail, ground baseline
    X, Y = 101.6, 73.66
    pl = _ic(s, "texas-instruments", "TPS62136RGXR", X, Y,
             {"Second_Source": "Texas Instruments TPS62136RGXT (same part, 250-piece reel; BOM v1 line 113)",
              "Manufacturer_2": "Texas Instruments", "MPN_2": "TPS62136RGXT"})
    P = {k: pl.pos(pl.pin(k)) for k in ("8", "10", "11", "9", "2", "6", "5", "4", "7", "1", "3")}
    # input: VSYS, CIN, EN tied to VSYS
    s.group_box("Input", 22.86, 35.56, 50.8, 76.2)
    s.power("VSYS", 30.48, yr)
    s.wire((30.48, yr), (P["1"][0], yr))
    s.wire(P["1"], (P["1"][0], yr))
    ct, cb = vpart(s, "C_22u_0805_25V", 53.34, 63.5)
    s.wire((53.34, yr), ct)
    s.junction(53.34, yr)
    s.wire(cb, (53.34, yg))
    gnd(s, 53.34, yg)
    s.flag_at(53.34, yg - 7.62, "left", 7.62)   # GND: no output pin drives it
    s.wire(P["8"], (78.74, P["8"][1]), (78.74, yr))
    s.junction(78.74, yr)
    # converter: MODE and VSEL low, soft start, ground
    s.group_box("Converter (SLVSDV2)", 76.2, 35.56, 43.18, 76.2)
    s.wire(P["10"], (81.28, P["10"][1]), (81.28, yg))
    s.wire(P["11"], (81.28, P["11"][1]))
    s.junction(81.28, P["11"][1])
    gnd(s, 81.28, yg)
    st, sb = vpart(s, "C_3n3_0402", 86.36, 95.25, text="right")   # its text below the body
    s.wire(P["9"], (86.36, P["9"][1]), st)
    s.wire(sb, (86.36, yg))
    gnd(s, 86.36, yg)
    s.wire(P["3"], (P["3"][0], yg))
    gnd(s, P["3"][0], yg)
    s.nc(*P["4"])
    # PG: down inside the converter group, so its label never reaches the next group
    s.wire(P["7"], (116.84, P["7"][1]), (116.84, P["7"][1] + 2.54))
    s.point("VSYS_LV_PG", 116.84, P["7"][1] + 2.54, "down", "bi")
    # output: inductor, VOS, divider, output capacitors, PG pull-up
    s.group_box("Output and feedback", 121.92, 35.56, 83.82, 76.2)   # the PG pull-up text inside
    yo = P["2"][1]
    xl = 233.68                                  # measurement link
    ll, lr = hpart(s, "L_XGL4020_152", 129.54, yo, prefix="L")   # its rating inside the group
    s.wire(P["2"], ll)
    s.point("VSYS_LV_SW", round((P["2"][0] + ll[0]) / 2 / 1.27) * 1.27, yo, "up")   # switch node (SW_NODE)
    s.wire(lr, (xl - 11.43, yo))
    s.wire(P["6"], (134.62, P["6"][1]), (134.62, yo))
    s.junction(134.62, yo)
    rt, rb = vpart(s, "R_442k", 144.78, 76.2)
    s.wire((144.78, yo), rt)
    s.junction(144.78, yo)
    r2t, r2b = vpart(s, "R_100k", 144.78, 91.44)
    s.wire(rb, r2t)
    s.junction(144.78, 83.82)
    s.wire(P["5"], (139.7, P["5"][1]), (139.7, 83.82), (144.78, 83.82))
    s.wire(r2b, (144.78, yg))
    gnd(s, 144.78, yg)
    for cx in (157.48, 172.72):
        c1, c2 = vpart(s, "C_22u_0805_16V", cx, 78.74)
        s.wire((cx, yo), c1)
        s.junction(cx, yo)
        gnd(s, *c2)
    pt, pb = vpart(s, "R_470k", 190.5, 76.2)
    s.wire((190.5, yo), pt)
    s.junction(190.5, yo)
    s.wire(pb, (190.5, 95.25))
    s.junction(190.5, 93.98)
    s.wire((190.5, 93.98), (185.42, 93.98))
    tp(s, 185.42, 93.98, "VSYS_LV_PG", text="left")
    s.point("VSYS_LV_PG", 190.5, 95.25, "down", "pas")
    # measurement link #5 (H5, kept in every variant), then the rail
    link(s, "LINK_H5", xl, yo, None, "VSYS_LV", link_variants("LINK_H5", variants),
         tp_names=("VSYS_LV_SRC", "VSYS_LV"), title="Link #5")
    s.shift(m0, 0, 10.16)
    s.iface_rows = [
        ["VSYS", "Supply in", "Not applicable: the block is never omitted (BRD-049)"],
        ["VSYS_LV", "Supply out", "Not applicable: always on; feeds the PMIC, vdd_cpu and vcc3v3_sys"],
    ]
    s.rail_rows = [["VSYS", "22 µF 25 V 0805", "CIN 10 µF nominal (SLVSDV2 §10.1.4.2); 3 µF effective minimum (§7.3): 3.9 µF at 8.8 V (BOM v1.18 item 1)"],
                   ["VSYS_LV", "2 x 22 µF 16 V 0805", "COUT 47 µF nominal with 1.5 µH (SLVSDV2 Table 2)"]]
    corner_notes(s, [
        "1. Function: TI TPS62136RGXR, VSYS (6.0-8.8 V, 2S) to VSYS_LV 3.8 V, 4 A. Every part",
        "   on VSYS_LV is rated 5.5 V or less (ADR 0014; BOM v1 line 113).",
        "2. Absent state: not applicable. EN tied to VSYS: always on (feature blocks #10).",
        "3. Output: R1 442 kΩ / R2 100 kΩ with VFB 0.7 V: 3.794 V (SLVSDV2 Eq. 8).",
        "   L: XGL4020-152MEC 1.5 µH (BOM v1 line 114). CSS 3.3 nF, PG 470 kΩ (Table 1).",
        "4. MODE low (auto PFM/PWM), VSEL low (FB2 unused): capture choices, never floating.",
        "5. Link H5 5 mΩ in every variant (BOM line 137); feedback on its source side.",
        "6. PWR_FLAG: VSYS and GND here until blk.charger is drawn; VSYS_LV at the link.",
        "7. Constraints: PCB-P-02, -07, -08. Unless noted: resistors 1 % 0402.",
    ])


def _tp(s, x, y, net):
    tsym = library.load("Connector", "TestPoint")
    ref = s.next_ref("TP")
    pl = s.place(tsym, ref, x, y, fields=fields("TP", s.block), value=net, in_bom=False,
                 ref_at=(x + 1.27, y - 5.08), val_at=(x + 1.27, y - 2.54))
    s.connect(pl, "1", net, stub=2.54)
    return ref


# ---------------------------------------------------------------------- 3.3 V system rail

def sheet_3v3(proj):
    return proj.sheet("pwr-3v3-sys.kicad_sch", "blk.pwr-3v3-sys", "3.3 V system rail",
                      "VSYS_LV to the always-on vcc3v3_sys 3.3 V rail, 4 A", "A4")


def draw_3v3(s, variants):
    """Hand-wired as the pre-regulator: VSYS_LV across the top, ground on one baseline."""
    blk = s.block
    m0 = s.mark()
    yr, yg = 45.72, 101.6
    X, Y = 101.6, 73.66
    pl = _ic(s, "texas-instruments", "TPS62827DMQR", X, Y,
             {"Second_Source": "Texas Instruments TPS62826DMQR (3 A, same land, only while the peak stays <= 2.4 A; BOM v1 line 6)",
              "Manufacturer_2": "Texas Instruments", "MPN_2": "TPS62826DMQR"})
    P = {k: pl.pos(pl.pin(k)) for k in ("1", "5", "3", "2", "6", "4")}
    s.group_box("Input", 22.86, 35.56, 50.8, 76.2)
    s.power("VSYS_LV", 30.48, yr)
    s.wire((30.48, yr), (P["6"][0], yr))
    s.wire(P["6"], (P["6"][0], yr))
    ct, cb = vpart(s, "C_4u7_0603_X7R", 53.34, 63.5)
    s.wire((53.34, yr), ct)
    s.junction(53.34, yr)
    s.wire(cb, (53.34, yg))
    gnd(s, 53.34, yg)
    s.group_box("Converter (SLVSEF9I)", 76.2, 35.56, 43.18, 76.2)
    s.wire(P["1"], (86.36, P["1"][1]), (86.36, yr))
    s.junction(86.36, yr)
    s.wire(P["4"], (P["4"][0], yg))
    gnd(s, P["4"][0], yg)
    s.wire(P["2"], (116.84, P["2"][1]), (116.84, P["2"][1] + 2.54))
    s.point("VCC3V3_SYS_PG", 116.84, P["2"][1] + 2.54, "down", "bi")
    s.group_box("Output and feedback", 121.92, 35.56, 83.82, 76.2)   # the PG pull-up text inside
    yo = P["5"][1]
    xl = 233.68
    ll, lr = hpart(s, "L_XGL4015_471", 129.54, yo, prefix="L")   # its rating inside the group
    s.wire(P["5"], ll)
    s.point("VCC3V3_SYS_SW", round((P["5"][0] + ll[0]) / 2 / 1.27) * 1.27, yo, "up")   # switch node (SW_NODE)
    s.wire(lr, (xl - 11.43, yo))
    rt, rb = vpart(s, "R_453k", 142.24, 76.2)
    s.wire((142.24, yo), rt)
    s.junction(142.24, yo)
    r2t, r2b = vpart(s, "R_100k", 142.24, 91.44)
    s.wire(rb, r2t)
    s.junction(142.24, 82.55)
    s.wire(P["3"], (137.16, P["3"][1]), (137.16, 82.55), (142.24, 82.55))
    s.wire(r2b, (142.24, yg))
    gnd(s, 142.24, yg)
    ft, fb = vpart(s, "C_120p_0402", 154.94, 76.2)
    s.wire((154.94, yo), ft)
    s.junction(154.94, yo)
    s.wire(fb, (154.94, 83.82), (142.24, 83.82))
    s.junction(142.24, 83.82)
    for cx, key in ((170.18, "C_22u_0603_10V"), (182.88, "C_10u_0603")):   # clear of the 120 pF rating
        c1, c2 = vpart(s, key, cx, 78.74)
        s.wire((cx, yo), c1)
        s.junction(cx, yo)
        gnd(s, *c2)
    pt, pb = vpart(s, "R_100k", 195.58, 76.2)
    s.wire((195.58, yo), pt)
    s.junction(195.58, yo)
    s.wire(pb, (195.58, 95.25))
    s.junction(195.58, 93.98)
    s.wire((195.58, 93.98), (190.5, 93.98))
    tp(s, 190.5, 93.98, "VCC3V3_SYS_PG", text="left")
    s.point("VCC3V3_SYS_PG", 195.58, 95.25, "down", "pas")
    link(s, "LINK_H5", xl, yo, None, "vcc3v3_sys", link_variants("LINK_H5", variants),
         tp_names=("VCC3V3_SYS_SRC", "vcc3v3_sys"), title="Link #4")
    s.shift(m0, 0, 10.16)
    s.iface_rows = [
        ["VSYS_LV", "Supply in", "Not applicable: never omitted"],
        ["vcc3v3_sys", "Supply out", "Not applicable: always on (EN = VSYS_LV)"],
    ]
    s.rail_rows = [["VSYS_LV", "4.7 µF 6.3 V X7R 0603", "C1 4.7 µF (SLVSEF9I Fig. 8-2); >= 3 µF effective (p. 14)"],
                   ["vcc3v3_sys", "22 µF + 10 µF 0603", ">= 20 µF effective for the TPS62827 (p. 14; BOM D26); DC bias UNVERIFIED"]]
    corner_notes(s, [
        "1. Function: TI TPS62827DMQR, VSYS_LV to vcc3v3_sys 3.3 V, 4 A, always on (BOM v1",
        "   line 6): RK809 VCC5-9, eMMC, SoC IO banks, radio switch (power tree §3).",
        "2. Absent state: not applicable. EN tied to VSYS_LV (RK809 EXT_EN unused).",
        "3. Feedback: 453 kΩ / 100 kΩ with VFB 0.6 V: 3.318 V (SLVSEF9I Eq. 4; the 450 kΩ",
        "   of Eq. 4 is not an E96 value). C3 120 pF = 12 µs / R2 (Eq. 5).",
        "4. L: Coilcraft XGL4015-471MEC 0.47 µH, 1.5 mm (compaction study, 2026-10-27; was",
        "   Würth 744373240047 of BOM v1 line 106, 1.8 mm, kept as the other-land alternate).",
        "5. Link H5 5 mΩ in every variant (power tree §4.12 #4); feedback on its source side.",
        "6. Unless noted: resistors 1 % 0402; capacitors X5R/X7R, at least twice the rail.",
    ])


# ---------------------------------------------------------------------- vdd_cpu

def sheet_vdd_cpu(proj):
    return proj.sheet("vdd-cpu.kicad_sch", "blk.vdd-cpu", "CPU core supply",
                      "vdd_cpu 0.85-1.10 V (cap) for the RK3566 CPU cluster, I2C DVS on I2C0 at 0x42, 6 A", "A3")
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
