opendap-project/t1/board/hardware/t1-main-board/generator/blocks_charger.py

"""blk.charger (feature blocks #7) and blk.gauge (#8): the input mux, the 2S charger, the battery
path from the BQ25798 BAT node to the six battery contacts, and the fuel gauge.

Sources: board ADRs 0014, 0017, 0020; BOM v1 lines 39-48, 104, 115, 120, 142; power tree v0 §2,
§4.7, §4.7.1; pinout v1 (I2C1, CHG_INT_N, expander P02 and P03); feature blocks §3 records 7 and 8;
TI SLUSDV2C (BQ25798), SLVSEA3F (TPS2121), SLUSE07B Figure 9-1 (BQ28Z610-R1); the parts'
datasheets, as cited in the libs generator data."""

from __future__ import annotations

from blocks_audio import grp, ic_group, parts_group, tvs_group, two_pin_box
from draw import Flow, Group, corner_notes, ic, part, prow, tp
from sch import snap


KIDS = ["charger-input", "charger-core", "charger-battery"]


def sheets(proj):
    charger = proj.sheet("charger.kicad_sch", "blk.charger", "Charger and battery path",
                         "TPS2121 input mux, BQ25798 2S charger, ship FET, fuse and the six battery contacts", "A4")
    kids = {
        "charger-input": proj.sheet("charger-input.kicad_sch", "blk.charger-input", "Charger: input mux",
                                    "TPS2121 picks USB-C or the HAT port into VBUS_CHG; the OV interlocks", "A3"),
        "charger-core": proj.sheet("charger-core.kicad_sch", "blk.charger-core", "Charger: BQ25798",
                                   "2S buck-boost charger, its inductor and capacitors; VSYS out", "A3"),
        "charger-battery": proj.sheet("charger-battery.kicad_sch", "blk.charger-battery", "Charger: battery path",
                                      "Ship FET, 5 A fuse, BATP and the six battery contacts with their ESD", "A3"),
    }
    gauge = proj.sheet("gauge.kicad_sch", "blk.gauge", "Fuel gauge",
                       "BQ28Z610-R1 on the pack side, its 3 mΩ sense resistor and board NTC (ADR 0017)", "A3")
    return charger, kids, gauge
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
