opendap-project/t1/(commit log)

2026-10-27 Public release (re-rooted 2026-10-26)
    Claude-Session: https://claude.ai/code/session_01Ei262h3TpgY9vyfNLMi5Mn
    [antennas.kicad_sch, audio-supply.kicad_sch, audio.kicad_sch, board-id.kicad_sch, buttons.kicad_sch, charger-battery.kicad_sch, charger-core.kicad_sch, charger-input.kicad_sch]
2026-10-27 The HAT standard is named "OpenDAP HAT Standard"
    "HAT Case Standard" becomes "OpenDAP HAT Standard" (RFC 0017): from
    interface v2 it is an electrical USB interface between the T1 and its
    HATs, not a case. Accepted ADRs and RFC bodies keep the old name as
    history; requirement IDs are unchanged and requirements READMEs are
    re-rendered (odapkit req render).
    Claude-Session: https://claude.ai/code/session_01Y7juowmMqMvCBmwCR46YQX
2026-10-27 Docs: state current facts instead of working notes (WS-19 warnings)
    Claude-Session: https://claude.ai/code/session_01Y7juozJd5zKWPtPft82ZQP
2026-10-27 Docs: fix docs-gate findings and add the managed contributor block
    Open Source capitalised and the contributor block from the workspace templates in CLAUDE.md; ADR 0009 links BOM v1 instead of the removed draft; ADR 0003 and the HAT flat cable spec state current facts; the BOM v1 status starts with a vocabulary word.
    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
2026-10-27 pre-commit: toolkit-hooks v0.4.1, the one pin every repository uses
    v0.3.0, v0.4.0 and v0.4.1 are the same commit since the public re-root;
    one tag everywhere (restructure HL-08).
    Claude-Session: https://claude.ai/code/session_01Y6oxmtnX6CTJqADSrBZjZ4
2026-10-27 Board: capture blk.current-monitors
    Five INA236 on I2C1 (0x40-0x43, 0x48) with their shunts, per power tree
    §4.12 and BOM v1 lines 54 and 136. The measured branches are rails of
    their own (VSYS_SRC, VSYS_LV_AUDIO, VSYS_AUDIO, VSYS_LV_BL, VSYS_P5V1),
    fed through the shunts on this sheet; the charger, audio, backlight and
    5.1 V sheets take them. The root's layout may leave a stack level empty,
    so the block sits under the notes; IC bboxes hold turned rail values;
    passive rows hold a bottom rail's text.
    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
    [antennas.kicad_sch, audio-supply.kicad_sch, board-id.kicad_sch, buttons.kicad_sch, charger-core.kicad_sch, charger.kicad_sch, current-monitors.kicad_sch, fp-backlight.kicad_sch]
2026-10-27 Board: capture blk.status-led
    LP5521 at 0x32 on I2C2 (BOM v1 line 105) with its charge-pump
    capacitors, EN on vcca1v8_pmu, VDD from VSYS_LV through link #22;
    LED_R/G/B reach the faceplate connector as the LED bus alias. The
    faceplate row of the root is re-packed so five full columns sit left of
    the title block.
    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
    [board-id.kicad_sch, buttons.kicad_sch, fp-connector.kicad_sch, fp-controls.kicad_sch, fp-display.kicad_sch, gauge.kicad_sch, gpio-expander.kicad_sch, haptics.kicad_sch]
2026-10-27 OS support spec: what the T1 needs from the Blackbird OS image
    Moved from the Blackbird OS requirements' Context: DKMS modules, the BQ25798
    charger watchdog and OTG note, INA236 start-up, RP2354A I/O voltage.
    Claude-Session: https://claude.ai/code/session_01Y7juoviG2dckQ6xZSyuttg
2026-10-27 Board: capture blk.debug
    Debug UART2 (1.8 V) and I2S/DSD pads with ground pads, reset, PMIC and
    power-key pads (PCB-T-09), a pad on every spare SoC GPIO whose pinout v1
    row names one (the DEBUG bus, on the SoC's right edge), and a rail pad
    for each power-tree rail no other sheet probes (PCB-T-02). Each DAC
    sheet carries a pad on its MCLK. The spares pinout v1 leaves without a
    pad now carry no-connect flags. On the root, facing sheet pins are
    joined directly only where the route meets no other symbol.
    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
    [antennas.kicad_sch, board-id.kicad_sch, buttons.kicad_sch, dac-l.kicad_sch, dac-r.kicad_sch, debug.kicad_sch, fp-backlight.kicad_sch, fp-connector.kicad_sch]
2026-10-27 Board: capture blk.cover-detect
    COVER_DET_N on GPIO0_A6 (AJ38, PMUIO1, wake-capable), recorded in
    pinout v1 (closes feature blocks G22): board-edge input and ground pads
    for the case's actuator, 100 kΩ to vcc3v3_pmu, TPD1E10B06 at the pad
    (BOM v1 line 143, PCB-L-10). The line rides the KEYS bus with the
    buttons.
    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
    [buttons.kicad_sch, cover-detect.kicad_sch, debug.kicad_sch, fp-controls.kicad_sch, fp-display.kicad_sch, gpio-expander.kicad_sch, haptics.kicad_sch, imu.kicad_sch]
2026-10-27 Board: capture blk.mic-ambient and links #34, #35
    IM73D122 on PDM CLK1 and SDI1 (BOM v1 line 34, pinout v1 AK2 and 1P2),
    LR to ground, 22 Ω clock series, VDD from MIC_1V8 through link #35.
    Link #34 on blk.mic-main makes the faceplate branch the rail MIC_1V8_FP
    for contact 40 (power tree §4.12, G10). kicad-lib moves to e46bda4 for
    the IM73D122, TPS3808G01, SN74LVC1G58 and BAT54 parts.
    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
    [antennas.kicad_sch, board-id.kicad_sch, buttons.kicad_sch, cover-detect.kicad_sch, current-monitors.kicad_sch, debug.kicad_sch, fp-backlight.kicad_sch, fp-connector.kicad_sch]
2026-10-27 Board: capture blk.maskrom
    Power + Vol- at a cold power-on pull eMMC D0 low inside the TPS3808G01
    boot window (BOM v1 lines 35, 78, 97, 98; sim/maskrom): SENSE 280k/100k,
    CT 390 nF, WINDOW_N with its pad, SN74LVC1G57 and SN74LVC1G58 on
    vcca1v8_pmu, BAT54 from PWRON_N, DMG1012T through 1 kΩ to EMMC_D0.
    Every block in use now has its sheet; the README states the remaining
    single-pin nets.
    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
    [antennas.kicad_sch, board-id.kicad_sch, buttons.kicad_sch, cover-detect.kicad_sch, current-monitors.kicad_sch, debug.kicad_sch, fp-backlight.kicad_sch, fp-connector.kicad_sch]
2026-10-27 Generator: fiducial library and the placement stage's DRC severity
    The footprint library table lists KiCad's Fiducial library for the
    board's fiducials (PCB-M-09). The project reports unconnected items as
    warnings while the board is placed and not routed (placement v1 §4
    decision 11); routing sets them back to errors.
    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
    [project.py]
2026-10-27 Board: placement tool for the main board (pcb/)
    build.py writes t1-main-board.kicad_pcb from the schematic: netlist from
    kicad-cli, footprint geometry through KiCad's Python, part heights from
    the 3D models, a constructive placement on the floorplan's zones and
    height areas (0.05 mm occupancy grids, nearest free spot to the pads a
    part connects to, repair by moving nearby parts), checks DRC does not
    make (zones, heights, hole rings, through holes), the area budget and
    occupancy report, and the board with stackup v3, rule areas, holes and
    fiducials. plan.py holds the fixed parts and the decisions against
    floorplan v1. Tests: python3 -m unittest discover (pure parts).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
2026-10-27 Board: t1-main-board.kicad_pcb at its placement stage (placement v1)
    Six layers on stackup v3 (1.046 mm), outline and holes of floorplan v1,
    zone, corridor, battery, audio and BGA rule areas, eight fiducials, and
    all 1,012 parts placed (826 front, 186 back), not routed. Written by
    pcb/build.py; placement-result.json is its report. DRC with the composed
    rules: 0 errors, 499 unconnected items (not routed), schematic parity 0.
    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
    [t1-main-board.kicad_pcb]
2026-10-27 Docs: placement v1, floorplan v1 §7 and the project README
    Placement v1 records the board setup, what is placed and where, the
    area budget with the real footprints against floorplan v1's estimates,
    the occupancy of the placed board, the decisions taken against the
    floorplan (Accepted 2026-10-27, with their basis), the DRC and
    placement checks, and the open items. Floorplan v1 gains §7 with the
    facts placement added; the project README lists the board and pcb/.
    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
2026-10-27 Libraries from the libs root (v0.1.0), kicad/ inside it
    kicad-lib is now the kicad/ folder of the libs repository (RFC 0017). The
    submodule hardware/lib/opendap follows libs at v0.1.0, and every library path
    gains kicad/: library tables, drawing sheet, composed rules, generator and
    docs. Nicknames are unchanged, so no symbol or footprint reference moves; ERC
    and DRC with schematic parity give the same results as before. The board's
    3D model paths are regenerated in the next commit by the board generator.
    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
2026-10-27 Board on libs v0.1.1: 3D models through OPENDAP_KICAD_3DMODELS; generators read libs' kicad/ folder
    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
    [t1-main-board.kicad_pcb]
2026-10-27 Studies: find the footprints in libs' kicad/ folder
    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
2026-10-27 pre-commit: KiCad boards may grow to 40 MB; every other file keeps 5 MB
    The placed main board is 4.7 MB before routing; pours and tracks add to it.
    A second check-added-large-files instance covers *.kicad_pcb only, under
    GitHub's 50 MB push warning.
    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
2026-10-27 Rules: PCB-I-09 leaves a footprint's own pads out
    The master-clock spacing fired between the CS43198's MCLK pin and its
    neighbours and between the dividers' pins: the maker's pin pitch, not a
    routing choice. The rule now skips pad pairs of one footprint, as PCB-V-01
    does; a test row checks two footprints (fires) against one (does not).
    The test board script finds kicad-lib's tools in libs' kicad/ folder.
    Main board DRC: the six PCB-I-09 warnings are gone, 0 errors.
    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
    [t1-main-board-rules-test.kicad_pcb]
2026-10-27 Zone net classes and named switch nodes from the generator
    Every net but GND now carries the ZONE_<NAME> class of each zone whose
    blocks it touches (block zones from pcb/plan.py; the faceplate connector's
    sheet also the faceplate zone); a rail used in more than one zone carries
    ZONE_SHARED. Nets KiCad names from a pin take their part's sheet zone.
    1,080 nets: 911 in one zone, 104 in two, 36 in three, 28 shared rails.
    Switch nodes are named *_SW (VSYS_LV_SW, VCC3V3_SYS_SW, VDD_CPU_SW,
    RP_VREG_SW); the display switch output is FP_VCI_OUT, so SW_NODE holds
    the 18 switch nodes only. Board rebuilt: DRC 0 errors, 607 warnings
    (the six PCB-I-09 gone), ERC 0 errors, craft Q1 met, pcb tests pass.
    Cl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
    [fp-display.kicad_sch, pwr-3v3-sys.kicad_sch, pwr-vsys-lv.kicad_sch, rp2354-power.kicad_sch, t1-main-board.kicad_pcb, vdd-cpu.kicad_sch]
2026-10-27 Compaction: lower inductors, 0201 decoupling, 0.8 mm signal test pads
    A matrix tool (hardware/studies/compaction) checks each candidate against
    the design's stresses: same inductance, design peak <= 70 % and the
    converter's maximum limit <= 100 % of Isat (30 % drop), height zones,
    ratings at least twice the rail, PCB-D-06; sourcing outcome per part.
    Applied (placement v1 decision 12, BOM v1.15):
    - L601, L4401: XGL4015-102MEC (1.5 mm) for XAL/XGL4020-102MEC (2.1 mm);
    - L1001, L5101: XGL4015-471MEC (1.5 mm) for Wurth 744373240047, on the
    stock XxL4020 land (the Wurth land was never drawn);
    - L1201 is 1.2 mm (XGL4012, per-MPN heights): it moves next to the SoC;
    - 58 x 100 nF decoupling on ra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
    [board-id.kicad_sch, charger-core.kicad_sch, charger-input.kicad_sch, debug.kicad_sch, gpio-expander.kicad_sch, imu.kicad_sch, lpddr4x.kicad_sch, maskrom.kicad_sch]
2026-10-27 Compaction: XGL4015-102MEC sourcing is open, not conditional
    XGL4015-102MEC sourcing is open
    (T1-029). The study records it as
    "open" (ranks as conditional, closed before the BOM freeze); BOM v1.15
    and placement v1 decision 12 say so, with the 2.1 mm parts on the same
    land as the fallback.
    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
2026-10-27 Board on libs v0.2.0: lower-case kebab vendor keys (HL-13)
    The libs submodule moves to v0.2.0 (5f24483). Every library nickname in
    the generator, the placement tool and the floorplan study follows the
    key table (Texas_Instruments -> texas-instruments, OpenDAP_Device ->
    opendap-generic, Rockchip and Rockchip_PMIC -> rockchip, ...); the
    library tables are written from the files. Schematic and board
    regenerated.
    Checks: ERC 0 errors (warnings unchanged); DRC 0 errors, 605 warnings,
    the same counts by type, schematic parity 0; every placement identical;
    craft Q1 met; pcb tests pass; STEP export resolves every libs 3D model
    (the 27 parts without a model are KiCad stock lands that have none).
    Co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
    [antennas.kicad_sch, audio-supply.kicad_sch, board-id.kicad_sch, charger-battery.kicad_sch, charger-core.kicad_sch, charger-input.kicad_sch, current-monitors.kicad_sch, dac-l.kicad_sch]
2026-10-27 Know-how scan: cite the DFT guide by its source key; no distributor names
    PCB-D-06 and its rule cite the guide as [JD], the constraints' source key;
    the compaction candidates state lifecycles as the sourcing check's outcome,
    without naming a distributor; the constraints spec drops the v0.16 change
    note (current state only). Knowhow scan of board: 0 open.
    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
2026-10-27 Heights: lower-part matrix and case-interface rows for the pocket's edges
    The compaction study gains a heights family: the only lower part that
    passes is the BOM's microSD alternate, Molex 104031-0811 (1.42 mm,
    push-pull: a product choice); the push-push Molex 503182-1852 (1.45 mm)
    is obsolete; no catalog 4.4 mm jack fits PCB-Z-01 and no lower side
    switch has a verified height. The PCB design constraints carry each
    relief as a case-interface row (PCB-Z-06 jack, Z-07 microSD, Z-08 side
    buttons) with the courtyard extents from placement v1.
    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
2026-10-27 Specs: datasheet citations instead of the withdrawn parts-lib sheet links (P-50)
    libs v0.3.0 no longer publishes the parts spec sheets.
    - controls-and-status-led: the forced power-off cites the RK809
    datasheet Rev 1.01, p. 21, §4.1 (long PWRON press powers down).
    - faceplate-interface: the FH35C 30 V AC rms rating cites the Hirose
    catalog (edition 2013.11, p. 2, Ratings) only.
    - electronics-integration-verification: I0 names what libs provides
    (manifest entry, generator data citing datasheet pages, generated
    symbol, footprint and 3D model); lifecycle and second source live in
    the generator-data fields (PLIB-003) and the board BOM's Sourcing and
    Second source columns.
    Co-Author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
2026-10-27 Board on libs v0.3.0: parts-sheet links restated as datasheet facts; study outputs go private (P-50, P-51)
    libs v0.3.0 no longer publishes the parts spec sheets; a part's public
    form is its manifest entry and its generator data citing datasheet pages.
    - ADR 0023 supersedes ADR 0021 (vdd_cpu buck TPS62869) and ADR 0024
    supersedes ADR 0022 (LPDDR4X Micron MT53E1G32D2FW-046, CXMT second
    source): same decisions, restated without the sheet links (RK860-0: the
    manifest records no public datasheet; K4UBE3D4AB-MGCL discontinued per
    Samsung's product page, read 2026-10-24; library data as libs carries
    it). 0021 and 0022 marked superseded, otherwise unchanged.
    - BOM v1, pinout v1, HAT flat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
    [buttons.kicad_sch]
2026-10-28 Pre-commit: the shared hooks come from tools v0.1.0 (HL-31)
    toolkit-hooks joined the tools repository (RFC 0017); the hook ids are the
    same, served from its root. The old v0.4.1 pin keeps working until it is
    archived; this moves to the new home.
    Claude-Session: https://claude.ai/code/session_01Y7juovdKcKZxUfX4nFRs7e
2026-10-28 Body at the T1-031 maximum, 62.5 x 95.0 x 25.0 mm (ADR 0006)
    ADR 0006 supersedes ADR 0003: the main board with its real parts needed
    111 % of its area in the 59.5 x 94.3 mm body; at the maximum, with 1.2 mm
    walls, a speaker shelf and pocket reliefs, no should feature is dropped.
    The measurement gate carries over.
    - Requirements context: T1-031/032/033 unchanged; the card-size ideal is
    not met (proportion 1.52).
    - New case and main board interface spec (CB-01 to CB-10): walls, board
    clearance, pocket, speaker shelf, the 4.4 mm jack, microSD and side-button
    reliefs, bosses, height zones.
    - Faceplate interface: body outline row.
    - Verification row V2-A08: the audio output stage in 0402 a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
2026-10-28 Board in the 62.5 x 95.0 mm body: ADR 0025, outline 59.1 x 91.6, 0201 swaps
    ADR 0025 supersedes ADR 0016 for t1 ADR 0006's body: board outline from
    the body, 1.2 mm walls and 0.5 mm clearance; height zones and stack
    restated unchanged; the speaker on a case shelf (PCB-Z-09); pocket
    reliefs at the 4.4 mm jack, the microSD (DM3AT push-push kept) and the
    side buttons; the audio 0603 -> 0402 swap gated by t1 V2-A08; reserve
    (NFC reader, then TPM) recorded, not applied.
    - pcb/geometry.py derives the outline from BODY, WALL and CLEARANCE;
    the pocket, display and fixed parts keep their device-frame positions;
    holes keep their edge distance; the speaker shadow becomes a 1.5 mm
    shelf height ar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
    [buttons.kicad_sch, charger-battery.kicad_sch, charger-core.kicad_sch, cover-detect.kicad_sch, emmc.kicad_sch, fp-connector.kicad_sch, fp-controls.kicad_sch, fp-display.kicad_sch]
2026-10-28 BOM v1.17: DC-bias gate closed, 7 x 10 uF in 0603 and 2 x 1 uF in 0201
    The 1 uF and 10 uF swaps of v1.16 waited for DC-bias figures (DRV-107).
    Murata's DC-bias data at each node's highest voltage, -20 to 85 C,
    tolerance included, against each circuit's need: the BQ25798 VBUS and
    SYS capacitors and the two TPS22945 output capacitors pass and are
    swapped; the other 31 positions keep their part. The 10 uF 0603 is in
    production. Three findings go to section 7 (items 51-53): the VSYS
    converter inputs miss their 3 uF minimum with the present part.
    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
    [charger-core.kicad_sch, fp-connector.kicad_sch, mic-main.kicad_sch]
2026-10-28 Load switches in TPS22916C WCSP (BOM v1.17 item 3, libs v0.3.1)
    The six TPS22919DCKR become the TPS22916CYFPR, the BOM's named second
    source, now that kicad-lib v0.3.1 carries its land, symbol and model.
    Each position's rise time and output discharge checked against the
    data sheet (SLVSDO5F section 6.6): every sequencing rule holds; the
    fixed 150 Ohm discharge is slower and the driver's delays follow it.
    Power tree v0.9 restates the switch rows.
    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
    [audio-supply.kicad_sch, nfc-reader.kicad_sch, power.kicad_sch, radio-power.kicad_sch, rp2354-power.kicad_sch]
2026-10-28 BOM v1.17: X2SON LDO gate closed, TPS7A2018 stays SOT-23-5
    No alternative with the same function, height and land class passes
    the sourcing check: the X2SON orderables are short of one order, the
    non-P version has no output discharge the gating map relies on, and
    the onsemi NCP163 needs 2.2 V at its input. The present part's own
    availability is re-checked before the board freezes (item 54).
    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
2026-10-28 Requirements: body outline 62.5 x 95.0 (t1 ADR 0006), panel stands
    ADR 0001's consequences quoted a body of about 59.5 x 91.5 mm; t1 ADR
    0006 sets 62.5 x 95.0 x 25.0 mm. A context line records the new body,
    that the panel choice does not depend on it, and the fit facts: the
    display module leaves 2.82 mm per side across in the 60.1 x 92.6 mm
    cavity, FPT-020 still holds at 1.52, the gap, stack and tail are
    unchanged, and the ST7703 lens still exceeds the body in height.
    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
2026-10-28 Placement v1.2: rebuilt with the BOM v1.17 swaps, 97.8 % of both sides
    pcb/build.py on the schematic with seven 10 uF in 0603, two 1 uF in
    0201 and six TPS22916C WCSP: all 1,012 parts placed (852 front, 160
    back), 97.8 % by the floorplan's method (was 98.8 %), placed courtyard
    58.8 %, factor left 1.70; bands core 124 %, power 223 %, audio 99 %;
    DRC 0 errors, ERC 0 errors, 0 check findings, pcb tests 20/20. The
    95 % target waits for the hardware-gated swaps or the reserve.
    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
    [t1-main-board.kicad_pcb]
2026-10-28 BOM v1.18 item 1: 22 uF 25 V X5R 0805 at the TPS62136 and TPS62903 inputs
    C901 and C4402 keep 3.89 uF effective at 8.8 V (-20..85 C, tolerance
    included) against the 3 uF minimum; the 10 uF part kept 1.86 uF. Same
    land; sourcing pass. Closes BOM §7 item 51.
    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
    [pwr-5v1.kicad_sch, pwr-vsys-lv.kicad_sch]
2026-10-28 BOM v1.18 item 2: successors of the discontinued 1 uF 0402
    GRM155R61A105KE15D is to be discontinued. 44 positions take
    GRM155C71A105KE11D (1 uF 10 V X7S); the eight TPS7A20 positions take
    GRM155R61C225KE11D (2.2 uF 16 V X5R) to keep the 0.47 uF effective
    minimum with 10 % to spare at up to 3.8 V. Same land; sourcing pass.
    Closes BOM §7 item 52; new item 55 lists the other capture parts outside
    Murata's product data or near end of life.
    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
    [audio-supply.kicad_sch, dac-l.kicad_sch, dac-r.kicad_sch, fp-connector.kicad_sch, fp-display.kicad_sch, haptics.kicad_sch, hat-5v.kicad_sch, hpa-rails-pre.kicad_sch]
2026-10-28 BOM v1.18 item 3: 22 uF X7R 1210 at the LT3045 and LT3094
    GRM21BR71C106KE51L is not in Murata's product data. GRM32ER71C226KEA8L
    keeps 11.1 uF effective at 6.04 V (one per output) and 10.4 uF at
    7.06 V (two per LT3094 input) against the 10 uF stability minimum; no
    10 uF X7R 0805 or 1206 passes. Sourcing pass. Closes BOM §7 item 53.
    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
    [antennas.kicad_sch, board-id.kicad_sch, buttons.kicad_sch, cover-detect.kicad_sch, current-monitors.kicad_sch, debug.kicad_sch, fp-backlight.kicad_sch, fp-connector.kicad_sch]
2026-10-28 BOM v1.18 item 4: TPS7A2018PDBVR availability confirmed
    Sourcing check (T1-029) passes on TI's own channel, lifecycle Active;
    the X2SON orderables pass on the same read, so the v1.17 item 4 swap
    waits only for its land. Closes BOM §7 item 54.
    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
2026-10-28 Placement v1.3: capacitor proximity rule, checked and met
    pcb/proximity.py assigns every converter's input and output capacitors
    (from pin functions and types) and every IC's decoupling (block rule and
    the generator's new Decoupling field) and checks each within its bound
    of the pins it serves (input 3, output 5, decoupling 4, bulk 6 mm); the
    build fails otherwise. The placer places each IC's capacitors right
    after it, keeps room for them, reorders, swaps and repairs; a search
    radius bug (mm used as cells) that blocked rotations is fixed. RK809
    moved 1.2 mm right and 1.1 mm down off the radio zone edge.
    Fixes found: C901 was 29 mm from U901; 136 of 237 capacitors were beyond
    their bound. No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
    [antennas.kicad_sch, board-id.kicad_sch, buttons.kicad_sch, cover-detect.kicad_sch, current-monitors.kicad_sch, debug.kicad_sch, fp-backlight.kicad_sch, fp-connector.kicad_sch]
2026-10-28 Placement v1.3: pipeline checks recorded (ERC, craft, DRC, STEP, visual)
    Schematic regenerated, board rebuilt: 1,025 parts placed, 99.1 % board
    need, factor 1.68, 248 capacitors within their bound, DRC 0 errors,
    ERC 0 errors, schematic craft Q1 met, pcb tests pass, STEP exported.
    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
2026-10-28 NFC reader withdrawn from the board, every model (BRD-057)
    Maintainer decision 2026-10-27, reason: board area. blk.nfc-reader (#42)
    withdrawn: PN7160, front end, crystal, antenna contacts, NFC_VBAT switch
    and link #18 removed (35 parts). BRD-057 reworded: NFC as the dynamic tag
    only; blk.nfc-tag stays. Pinout v1: 1N20, A37, B38 become unconnected
    spares, expander P05 a spare. BOM v1.18 item 7 (line 50: 5 switches,
    lines 127-128 withdrawn), power tree v0.10, variant files, feature blocks.
    Sheets after the removed one move up a page; references renumbered in
    plan.py, parts.py and the specs (J6201 -> J6101 and others).
    Placement v1.4: 990 parts placed, board need 96.9 % (99.1 % before),
    facto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
    [board-id.kicad_sch, buttons.kicad_sch, cover-detect.kicad_sch, current-monitors.kicad_sch, debug.kicad_sch, fp-controls.kicad_sch, fp-display.kicad_sch, gauge.kicad_sch]
2026-10-28 T1-077: the NFC reader clause withdrawn; microSD reference J6101
    Maintainer decision 2026-10-27 (board area): the main board has no NFC
    reader in any model, so T1-077 no longer keeps the PN7160 unfitted; the
    NFC dynamic tag stays. The board's sheets moved up a page, so the microSD
    socket is J6101 (CB-07).
    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
2026-10-28 vdd_cpu on the TPS62870Z4 (ADR 0026, placement v1.5)
    ADR 0026 supersedes ADR 0023: TPS62870Z4WRXSR at I2C0 0x42 with the
    Coilcraft XEL4012-920NE, 3 MHz, MODE/SYNC to ground with forced PWM by
    register, differential sense from the 22 uF at the SoC. Output capacitance
    sized at the 1.1 V devicetree cap for the 4.8 A worst-case step (peak
    1.149 V, DC-bias effective values); 1800 MHz kept as a verification row.
    Submodule at libs v0.3.2 (the RXS0016A land). BOM v1.18 item 8, power
    tree v0.10, pinout v1 I2C0 note, feature blocks #13, placement v1.5.
    Schematic regenerated, board rebuilt: 991 parts placed, 97.0 % board need,
    factor 1.71, 244 capacitors within their bound, DRC 0 errors, ERC 0
    errors,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
    [antennas.kicad_sch, audio-supply.kicad_sch, board-id.kicad_sch, buttons.kicad_sch, cover-detect.kicad_sch, current-monitors.kicad_sch, dac-l.kicad_sch, dac-r.kicad_sch]
2026-10-28 Integration verification: V2-C06, the 1800 MHz check (board ADR 0026)
    The bring-up row that decides the RK3566's 1800 MHz operating point:
    measure the CPU cluster's release step and the peak at the SoC capacitor
    at 1150 mV; raise the vdd_cpu cap only if DC top + peak <= 1.170 V.
    Claude-Session: https://claude.ai/code/session_013P6pW9LdyEMFishwCcZGUr
2026-10-28 Docs: links to system, blackbird-os, blackbird-ui and virtual-devices point into blackbird (HL-84)
    The four repositories are one, opendap-project/blackbird (os/, system/, ui/,
    emulator/); the old repositories are archived.
    Claude-Session: https://claude.ai/code/session_013P6pWDD8PDQKyiDpdoNUHa
2026-10-28 Shield-can frames on the back (BOM v1.19, placement v1.6)
    blk.shields: three etched two-piece frames made to order under the
    amended T1-038, not fitted in either variant: SoC and LPDDR4X, the radio
    module, the DACs and the back of the headphone stage. shields.toml holds
    the geometry; pcb/shields.py derives land, keep-outs and courtyard ring;
    the generator draws the lands and the placer reserves them, with parts up
    to 1.3 mm inside (PCB-Z-01). The sheet takes page 59, so the sheets from
    fp-display on carry the next page (J6201, SW6901-SW6904).
    Placement v1.6: 994 parts placed, 99.5 % board need (97.0 % before the
    frames), factor 1.64, 244 capacitors within their bound, DRC 0 errors,
    ERC 0 er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
    [buttons.kicad_sch, debug.kicad_sch, fp-controls.kicad_sch, fp-display.kicad_sch, gpio-expander.kicad_sch, haptics.kicad_sch, imu.kicad_sch, mic-main.kicad_sch]
2026-10-28 Case-board interface: the microSD socket is J6201 (board placement v1.6)
    The board's shield-frame sheet takes page 59, so the microSD socket's
    reference carries the next page. No dimension changes.
    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
2026-10-28 Variants: devicetree nodes, host-side absent pulls, board variant data
    Feature blocks: every record with a devicetree node names it; Sub-blocks
    rows for the 16 sheet IDs. The RP2354 and HPA_RAIL_EN absent-state
    pull-downs move to blk.soc-vccio-b, so they stay when the block is not
    fitted; cover detect relies on the ball's own pull-down. pcb/variants.py
    copies the schematic's production data onto the board. odapkit variant
    check: full and production pass, reproducible.
    The PTS815 land drawn from the C&K data sheet (p. B-44); the side buttons
    respaced for it (PCB-Z-08 updated). Studies find repos.tsv by walking up
    and use libs' rockchip.pretty. DRC 0 errors, ERC 0 errors, craft Q1 met,
    pcb te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
    [antennas.kicad_sch, audio-supply.kicad_sch, board-id.kicad_sch, buttons.kicad_sch, cover-detect.kicad_sch, dac-l.kicad_sch, dac-r.kicad_sch, emmc.kicad_sch]
2026-10-28 Case-board interface: side strips for the drawn PTS815 land (board placement v1.6)
    CB-08: the left strip runs y 21.60 to 39.44 and the right 26.50 to 32.50;
    PTS815 2.7 mm high (2.5 +-0.2 mm, C&K data sheet p. B-44).
    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
2026-10-28 Schematic: side-pin grounds drop below their pin; shield frames in one group
    A ground on an IC's side pin whose next row is taken (U1201 MODE/SYNC on
    blk.vdd-cpu, U2801 VNEG/FBN on blk.hpa-rails-pre) leaves on a stub past
    its neighbours' text and drops to the first free row, its GND symbol
    pointing down below the pin instead of hanging among the neighbours'
    labels (CRAFT-85); a ground below it on the same side joins the drop.
    The shield-can frames share one group sized from its contents
    (CRAFT-174) instead of three groups as wide as their titles. Other
    sheets change only in #PWR numbering.
    Generated twice, identical. ERC 0 errors (9 warnings, as before), craft
    Q1 met (Q2 reached), overlaps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
    [antennas.kicad_sch, board-id.kicad_sch, buttons.kicad_sch, cover-detect.kicad_sch, current-monitors.kicad_sch, debug.kicad_sch, fp-backlight.kicad_sch, fp-connector.kicad_sch]
2026-10-28 Audio shield frame dropped for board area (BOM v1.20, placement v1.7)
    Maintainer decision 2026-10-28: most of the headphone stage stands on
    the front, where PCB-Z-03 allows no can, so the back frame A5903 covered
    little of it. PCB-T-06 asks for frames around the SoC/DDR and the radio,
    so A5901 and A5902 stay; the SoC frame already encloses only the RK3566
    and LPDDR4X with 0.5 mm, so it is not shrunk. PCB-EMC-03 withdraws its
    headphone-stage frame (constraints v0.19); placement decision 16.
    pcb/build.py --drc: 993 parts placed (716 front, 277 back), board need
    99.7 % -> 98.9 %, placed courtyard 61.0 % -> 60.2 %, factor 1.64 -> 1.66;
    DRC 0 errors (605 warnings, 499 unconnected, as before), ER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
    [debug.kicad_sch, shields.kicad_sch, t1-main-board.kicad_pcb]
2026-10-29 t1: references from the rename map
    201 link, URL and identifier rewrites and 0 generated files rendered again, in 42 files (odapkit rename apply t1).
    [shields.kicad_sch, t1-main-board.kicad_pcb]
2026-10-29 Board: faceplate DSI ESD captured, FP_GPIO1 on a single TPD1E10B06 (BOM v1.21)
    Line 72's three TPD4E05U06 stand on blk.fp-connector next to the FH35C
    contacts (U5306-U5308, one pair per two channels); the sixth low-speed
    array, one channel used, becomes one TPD1E10B06 (sourcing check passed).
    Catalog records 21 and 22 follow; placement rebuilt (need 99.2 %).
    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
    [board-id.kicad_sch, buttons.kicad_sch, cover-detect.kicad_sch, current-monitors.kicad_sch, debug.kicad_sch, fp-backlight.kicad_sch, fp-connector.kicad_sch, fp-controls.kicad_sch]
2026-10-29 Board: obsolete-audit safe fixes (BOM v1.21, power tree v0.11)
    BOM quantities and owners follow the schematic (lines 34, 35, 44, 110,
    121, 137); HAT input kept at 2.95 A with the DF40C-50 and the reason
    recorded; power-tree HAT rows on interface v2, the PN7160 budget term
    gone; SW_NODE and PCB-P-07 part lists; pinout notes; requirement,
    catalog and README text; J6201; craft symmetry tables on the current
    references; dead Wurth placeholder rows; stackup study inputs marked
    superseded; old repository names in text and comments.
    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
    [hat-5v.kicad_sch, hat-signals.kicad_sch, interconnect.kicad_sch, jack-bal.kicad_sch, lpddr4x.kicad_sch, pinout-v1.csv, power.kicad_sch]
2026-10-29 Board: hole-to-inner-copper at the fab's six-layer row (PCB-G-11)
    Every drill, via and hole rule checked against the fab's six-layer rows:
    only the hole-to-inner-conductor clearance depends on the layer count
    (8 mil for six layers; the composed fab rules carried the eight-layer
    9 mil). New product override PCB-G-11 with its test row (check_drc
    PASS, 87/87); the laser-drill basis noted as layer-independent. Rules
    recomposed; main board DRC 0 errors.
    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
    [t1-main-board-rules-test.kicad_pcb]
2026-10-29 Board: unused CSI receiver supplies tied straight to their rails
    1N9 and 1P9 already join vdda_0v9 and vcca_1v8 with no bead or capacitor
    of their own; the pinout notes still asked for the bead and decoupling
    that HDG 1.1 p. 84 gives for the receiver's performance. The receiver
    has no consumer (RFC 0014) and no Rockchip text lets the supply go
    unpowered (p. 33; p. 32 covers GPIO domains), so it stays on its rail.
    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
    [pinout-v1.csv]
2026-10-29 Board: +7 V pre-rail boost evaluated, TPS65131 kept (BOM v1.21 item 5)
    Single-output boosts compared on BRD-049 switch margin, fixed-frequency
    PWM, audio-rail evidence, area and sourcing; none passes every gate.
    The TPS61372 is recorded as the candidate to revisit with a simulation
    and a new sourcing check before the board freezes.
    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
2026-10-29 Board: headphone outputs as variant modules (feature blocks #51, #52)
    blk.hp-out-se (blk.hpa-se + blk.jack-se) and blk.hp-out-bal (blk.hpa-bal
    + blk.jack-bal) are parents a variant fits or leaves off whole; both
    fitted in full and production. The generator stops on a variant that
    splits a module. Absent states declared on the stage and jack sheets:
    DAC outputs loaded by the remaining stage, enables held by the SoC-side
    pull-downs, detect pull-ups on the expander sheet, REFA/REFB kept on
    ground by the net-tie copper. Checked with odapkit variant on scratch
    3.5 mm-only and 4.4 mm-only variants: 0 floating, 0 unexpected, BOM
    built. Also: the faceplate ESD grid clears its hierarchical labels.
    C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
    [fp-connector.kicad_sch, hpa-bal-l.kicad_sch, hpa-bal-r.kicad_sch, hpa-bal.kicad_sch, hpa-se.kicad_sch, jack-bal.kicad_sch, jack-se.kicad_sch]
2026-10-29 Rules: render the templates that name the libs folders (HL-101)
    Synced from the workspace templates: kicad-lib, freecad-lib and blender-lib
    become the kicad/, freecad/ and blender/ folders of libs, export.md links the
    component export contract, and the freecad rule's glob is **/freecad/**
    instead of **/parts/**, which also matched libs/parts.
    Claude-Session: https://claude.ai/code/session_013P6pWCf2LawZtK5YZk9G51
2026-10-29 Board: test pads on either side for flying-probe test (ADR 0027)
    Prototypes and first runs are tested by flying probe, so flat test pads
    may stand on the back where their net's zone allows (placement v1.8
    decision 9 revised, new PCB-D-11, plan.TEST_PAD_SIDES). 18 of 156 pads
    take the back; the placer refills the front cells with passives, so the
    front courtyard (about 2,800 mm2) and the board need (99.2 %) do not
    change. Placement v1.8 also places the DSI ESD of BOM v1.21.
    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
    [t1-main-board.kicad_pcb]
2026-10-29 Board: pre-PCB schematic items closed with datasheets (BOM v1.22)
    Display INA236 to 0x49 (INA236B, A0 = VS): no A0 = SDA strap, so the
    address no longer depends on the host's I2C hold time. The 18 WSL
    shunts and links on Vishay's doc 30100 lands. 24 MHz crystal NDK
    NX3225GA (CL 8 pF) with 2 x 10 pF. Backlight inductor Coilcraft
    XFL3012-223MEC on its published land (no placeholder left). Action
    button PTS815 G code on the side-button land. Cover-detect leakage,
    TPS3808 spread, RP2354A supply pins and the USB series scheme closed
    without change. Placement v1.9: 100.2 % need, factor 1.64, DRC 0
    errors; power tree v0.12; PCB-Z-08 and CB-08 strip values.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
    [buttons.kicad_sch, cover-detect.kicad_sch, current-monitors.kicad_sch, debug.kicad_sch, fp-backlight.kicad_sch, gauge.kicad_sch, hpa-bal.kicad_sch, hpa-se.kicad_sch]
2026-10-29 Board: every part with a body has a 3D model (libs v0.3.3)
    The libs submodule moves to v0.3.3, whose envelope models cover the
    project lands (Murata, Abracon, Coilcraft, C&K PTS815, Vishay WSL,
    the two shield-can frames) and the KiCad stock lands that ship no
    KiCad 10 model. The project lands carry their model; the placement
    tool gives the stock lands theirs (plan.model_for, the XxL4020 land
    by part height). STEP export: no missing file. Placement unchanged.
    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
    [t1-main-board.kicad_pcb]
2026-10-29 Board: core-rail PDN screened on stackup v3 with the placed decoupling
    The stackup v3 Q1 row (PCB constraints item 12) records the screening:
    with the placement v1.9 decoupling and the power tree steps, every core
    rail stays under Rockchip's ripple target from about 0.5 MHz to
    11.8-21.4 MHz, the package above it; vdd_cpu at its 4.8 A worst case,
    vdd_gpu, vdd_npu and vcc_ddr exceed it between 0.2 and 0.5 MHz, in the
    converters' control range. The row stays open until the layout's PDN
    simulation with the package.
    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
2026-10-29 Bus names: org.opendap.* to cc.opendap.Blackbird.* in the board and faceplate specs (HL-88)
    RFC 0017 §3 (bus and reverse-DNS names follow opendap.cc).
    Claude-Session: https://claude.ai/code/session_013P6pW8eqa6sDT9PmmbgKDx
2026-10-29 Board: second sources and the pinout check move from libs (libs v0.3.4, HL-15)
    libs v0.3.4 carries no product content, so the board keeps its own:
    - hardware/bom/second-sources.toml: the second source the BOM names
    per library part, written by the generator into the Second_Source
    field of each placed part (unless a block sets its own); the
    generator refuses an entry the board does not place.
    - pcb/tests/test_pinout.py: pinout v1 pad names against the libs
    RK3566 pin list (the check libs no longer runs against the board).
    - PCB constraints §0 item 3: the single-board decision (no interposer)
    that the craft standard carried.
    - BOM line 122: the TPM package confirmed from its data s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
    [antennas.kicad_sch, charger-core.kicad_sch, fp-connector.kicad_sch, gauge.kicad_sch, haptics.kicad_sch, hpa-rails-ldo.kicad_sch, hpa-rails-pre.kicad_sch, jack-se.kicad_sch]
2026-10-29 Board: Y1301 on the NX3225GA land; fab references inside their courtyards (libs v0.3.5, HL-15)
    Findings of the refutation pass on placement v1.9:
    - Y1301 (SoC 24 MHz crystal) moves from KiCad's stock 3225 land, which
    has no silk outline or pin-1 mark, to libs v0.3.5's NDK NX3225GA
    land (manufacturer land pattern, pin 1 top-left, outline and mark).
    - pcb/fabref.py: every ${REFERENCE} on the fabrication layer is centred
    in its part's courtyard, along its longer side, at the largest height
    up to 1 mm that fits; kicad_write.py measures the drawn text and stops
    the build when two fab references overlap (the old board had them
    outside their courtyards on test pads and passives, TP6403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
    [soc-pmuio.kicad_sch, t1-main-board.kicad_pcb]
2026-10-29 Board: courtyards cover the pin-1 marks (libs v0.3.6, placement v1.11)
    - libs v0.3.6: each libs footprint's courtyard covers its pin-1 mark,
    placed on the side that grows the courtyard least; one-land parts
    (battery spring contacts, pogo pins) carry none.
    - The placement search runs on the grown courtyards: 996 parts placed,
    722 front, 274 back; board need 102.0 % (was 100.2 %), factor 1.61.
    - U4401 fixed at its v1.10 position: the search had turned it and left
    its input capacitor C4402 5.0 mm from pin 6 (bound 3 mm).
    - DRC: 0 errors; the 9 silk overlaps from libs pin-1 triangles are
    gone. One remains: KiCad's stock WSON-6 land of U2102 draws its mark
    outside its courtyard, where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
    [t1-main-board.kicad_pcb]
2026-10-29 Board: committed visual outputs (RFC 0021)
    board/outputs.toml declares the main board's schematic and board;
    odw render update writes outputs/: the schematic as one PDF and 69
    per-sheet SVGs, one SVG per layer (six copper, silkscreen and fab
    sides) and 3D renders from four fixed views (top, bottom, iso-front,
    iso-back), with a source-hash stamp and a README index. 68 MB.
    - .gitattributes: outputs/ is linguist-generated (templates block).
    - REUSE: outputs/ under CERN-OHL-S-2.0, as the hardware it shows.
    - no-stray-files at tools v0.1.1 rejects every PDF: board/outputs/ is
    excluded until the v0.2.0 pin brings the stamped-PDF exception and
    the outputs-current and outputs-regenerate hooks.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
2026-10-29 Board: visual outputs' PNG and PDF in Git LFS (RFC 0021 §8)
    The templates' outputs fragment puts generated PNG, PDF and glTF under
    Git LFS; the board's schematic PDF and four renders are re-added as LFS
    pointers (earlier blobs stay in history). SVG, README and stamp stay in
    git: a one-sheet schematic edit rewrites that sheet's SVG, the PDF and
    the stamp, and nothing else.
    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
